meetsitaram/duck-droids/pi/README.md

# The duck's Pi code

Runs on the Raspberry Pi Zero 2 W in the head: reads 15 XL330 servos and the BNO085, runs a policy at 50 Hz, and writes the servos' targets.

**For the all-Dynamixel duck only.** The HD-1910 and all-Feetech ducks need Feetech's bus protocol, and the hybrid needs two buses.

**Status:** tested only against the simulator below. It has never run on a real Pi or real servos. There's no trained policy for this design yet, so `hold` and `wave` are stand-ins: `hold` sags and sits down, and neither walks.

## Try it in simulation

No Pi and no GPU needed. The simulator speaks the real Dynamixel bytes on a socket and answers as the IMU, so the Pi's code runs unchanged:

```bash
pip install -r pi/requirements.txt mujoco
```

```bash
cd pi && python sim/test_sim.py
```

To drive it yourself, run the simulator in one terminal:

```bash
cd pi && python sim/server.py --pinned
```

and the Pi's code in another:

```bash
cd pi && python run.py --port socket://127.0.0.1:9000 --imu 127.0.0.1:9001 --policy wave --no-fall
```

`--pinned` holds the body in the air. Leave it off to stand on the floor. A trained policy goes in the same way: `--policy models/walk.onnx --vx 0.2`.

**What this doesn't tell you:** the Pi Zero's own speed. On a PC a tick takes about 2 ms of the 20 ms budget, with a stand-in network that's far smaller than a real policy. Time a real policy on the Pi itself: `run.py` prints the ticks that ran late.

## Set up the Pi

Raspberry Pi OS Lite, 64-bit. Copy `pi/` to `/home/pi/duck`, then:

```bash
bash setup_pi.sh
```

## First run on the robot

Lift the duck on a stand, away from its joint limits, before any of this. Nothing has been tried on real servos.

1. **Set each servo's id and speed, one servo at a time:** with ROBOTIS's Dynamixel Wizard, ids as in the table below, baud rate 1 Mbps (a new XL330 comes at 57600), and the Waveshare board's jumpers at B.
2. **Measure the centres,** with the duck posed at zero by hand: legs straight, head level, beak shut:

```bash
python -m duck.calibrate --port /dev/serial0
```

3. **Check the directions on the stand.** Every joint starts at `direction: 1` in `config/dynamixel.json`, and some will be wrong. Flip those that move the wrong way:

```bash
python run.py --policy wave --no-fall --seconds 20
```

4. **Check the IMU.** Gravity should read about (0, 0, -1) with the body level. If it doesn't, fix `imu_to_robot` in the config.

| Servo ids | Joints |
|---|---|
| 1-5 | left hip yaw, hip roll, hip pitch, knee, ankle |
| 6-10 | right hip yaw, hip roll, hip pitch, knee, ankle |
| 11-15 | neck pitch, head pitch, head yaw, head roll, beak |

## What the policy sees

61 numbers at 50 Hz, in this order: angular velocity 3, gravity 3, joint positions minus home 14, joint velocities 14, last action 14, twist command 3, head command 4, body command 6. It returns 14 joint targets, as offsets from home. See `duck/policy.py`. A policy trained with foot switches has 63 inputs and is refused.

The loop stops the policy if the body tips past its limit, the battery falls under 6.6 V or a servo stops answering, and it turns the torque off on the way out.

Regenerate the config and the simulator's model after a design change:

```bash
MILLI_RECIPE=dynamixel python tools/make_pi_config.py
```
