meetsitaram/duck-droids/reports/dynamixel/mass.md

# Mass model

Bottom-up: every part from its material and shape (`tools/mass_model.py`, materials in `spec/robot.py`), a 3 % wiring allowance per link on its frames.

**Total 0.96 kg** (microduck: 0.8 kg).

| material | kg | share |
|---|---|---|
| pla | 0.42 | 43 % |
| actuator | 0.28 | 29 % |
| steel | 0.12 | 12 % |
| electronics | 0.07 | 7 % |
| tpu | 0.05 | 5 % |
| cells | 0.03 | 3 % |

| link | mass kg | budget kg (hand estimate) | CoM (m, world, zero pose) | principal inertia (kg m2) |
|---|---|---|---|---|
| trunk | 0.15 | 0.40 | -0.019 -0.001 +0.140 | 0.0001 0.0001 0.0001 |
| L_hip_yaw_link | 0.03 | 0.07 | +0.002 +0.015 +0.102 | 0.0000 0.0000 0.0000 |
| R_hip_yaw_link | 0.03 | 0.07 | +0.002 -0.015 +0.102 | 0.0000 0.0000 0.0000 |
| L_hip_roll_link | 0.02 | 0.07 | +0.002 +0.027 +0.100 | 0.0000 0.0000 0.0000 |
| R_hip_roll_link | 0.02 | 0.07 | +0.002 -0.027 +0.100 | 0.0000 0.0000 0.0000 |
| L_hip_pitch_link | 0.09 | 0.10 | -0.024 +0.055 +0.093 | 0.0000 0.0000 0.0000 |
| R_hip_pitch_link | 0.09 | 0.10 | -0.024 -0.055 +0.093 | 0.0000 0.0000 0.0000 |
| L_knee_link | 0.03 | 0.05 | -0.038 +0.043 +0.049 | 0.0000 0.0000 0.0000 |
| R_knee_link | 0.03 | 0.05 | -0.038 -0.043 +0.049 | 0.0000 0.0000 0.0000 |
| L_foot | 0.04 | 0.05 | -0.032 +0.045 +0.013 | 0.0000 0.0000 0.0000 |
| R_foot | 0.04 | 0.05 | -0.032 -0.045 +0.013 | 0.0000 0.0000 0.0000 |
| neck_link | 0.05 | 0.02 | +0.022 -0.001 +0.181 | 0.0000 0.0000 0.0000 |
| head_pitch_link | 0.04 | 0.03 | +0.017 -0.000 +0.231 | 0.0000 0.0000 0.0000 |
| head_yaw_link | 0.04 | 0.02 | +0.022 -0.007 +0.265 | 0.0000 0.0000 0.0000 |
| head | 0.24 | 0.12 | +0.046 +0.000 +0.268 | 0.0002 0.0004 0.0005 |
| beak_link | 0.03 | 0.03 | +0.063 +0.002 +0.245 | 0.0000 0.0000 0.0001 |
