meetsitaram/duck-droids/reports/hobby/mass.md

# Mass model

Bottom-up: every part from its material and shape (`tools/mass_model.py`, materials in `spec/robot.py`), a 3 % wiring allowance per link on its frames.

**Total 1.94 kg** (microduck: 0.8 kg).

| material | kg | share |
|---|---|---|
| pla | 0.78 | 40 % |
| actuator | 0.72 | 37 % |
| steel | 0.18 | 10 % |
| electronics | 0.09 | 5 % |
| tpu | 0.08 | 4 % |
| cells | 0.05 | 3 % |
| servo leads | 0.03 | 1 % |

| link | mass kg | budget kg (hand estimate) | CoM (m, world, zero pose) | principal inertia (kg m2) |
|---|---|---|---|---|
| trunk | 0.43 | 0.40 | -0.014 -0.001 +0.183 | 0.0003 0.0004 0.0005 |
| L_hip_yaw_link | 0.10 | 0.07 | +0.001 +0.019 +0.120 | 0.0000 0.0000 0.0000 |
| R_hip_yaw_link | 0.10 | 0.07 | +0.001 -0.019 +0.120 | 0.0000 0.0000 0.0000 |
| L_hip_roll_link | 0.02 | 0.07 | +0.014 +0.030 +0.124 | 0.0000 0.0000 0.0000 |
| R_hip_roll_link | 0.02 | 0.07 | +0.014 -0.030 +0.124 | 0.0000 0.0000 0.0000 |
| L_hip_pitch_link | 0.22 | 0.10 | -0.033 +0.067 +0.114 | 0.0001 0.0002 0.0002 |
| R_hip_pitch_link | 0.22 | 0.10 | -0.033 -0.067 +0.114 | 0.0001 0.0002 0.0002 |
| L_knee_link | 0.10 | 0.05 | -0.053 +0.053 +0.049 | 0.0000 0.0001 0.0001 |
| R_knee_link | 0.10 | 0.05 | -0.053 -0.053 +0.049 | 0.0000 0.0001 0.0001 |
| L_foot | 0.06 | 0.05 | -0.044 +0.063 +0.014 | 0.0000 0.0000 0.0000 |
| R_foot | 0.06 | 0.05 | -0.044 -0.063 +0.014 | 0.0000 0.0000 0.0000 |
| neck_link | 0.18 | 0.02 | +0.041 -0.001 +0.225 | 0.0000 0.0002 0.0002 |
| head_pitch_link | 0.05 | 0.03 | +0.041 +0.004 +0.285 | 0.0000 0.0000 0.0000 |
| head_yaw_link | 0.04 | 0.02 | +0.048 -0.006 +0.327 | 0.0000 0.0000 0.0000 |
| head | 0.22 | 0.12 | +0.072 +0.001 +0.332 | 0.0003 0.0005 0.0007 |
| beak_link | 0.04 | 0.03 | +0.093 +0.003 +0.307 | 0.0000 0.0001 0.0001 |
