meetsitaram/duck-droids/reports/hd1910/mass.md

# Mass model

Bottom-up: every part from its material and shape (`tools/mass_model.py`, materials in `spec/robot.py`), a 3 % wiring allowance per link on its frames.

**Total 1.03 kg** (microduck: 0.8 kg).

| material | kg | share |
|---|---|---|
| pla | 0.43 | 42 % |
| actuator | 0.32 | 32 % |
| steel | 0.12 | 11 % |
| electronics | 0.07 | 6 % |
| tpu | 0.05 | 5 % |
| cells | 0.03 | 3 % |

| link | mass kg | budget kg (hand estimate) | CoM (m, world, zero pose) | principal inertia (kg m2) |
|---|---|---|---|---|
| trunk | 0.16 | 0.40 | -0.012 -0.001 +0.139 | 0.0001 0.0001 0.0001 |
| L_hip_yaw_link | 0.04 | 0.07 | -0.000 +0.016 +0.098 | 0.0000 0.0000 0.0000 |
| R_hip_yaw_link | 0.04 | 0.07 | -0.000 -0.016 +0.098 | 0.0000 0.0000 0.0000 |
| L_hip_roll_link | 0.01 | 0.07 | +0.009 +0.027 +0.100 | 0.0000 0.0000 0.0000 |
| R_hip_roll_link | 0.01 | 0.07 | +0.009 -0.027 +0.100 | 0.0000 0.0000 0.0000 |
| L_hip_pitch_link | 0.09 | 0.10 | -0.024 +0.055 +0.093 | 0.0000 0.0000 0.0000 |
| R_hip_pitch_link | 0.09 | 0.10 | -0.024 -0.055 +0.093 | 0.0000 0.0000 0.0000 |
| L_knee_link | 0.04 | 0.05 | -0.038 +0.041 +0.046 | 0.0000 0.0000 0.0000 |
| R_knee_link | 0.04 | 0.05 | -0.038 -0.041 +0.046 | 0.0000 0.0000 0.0000 |
| L_foot | 0.04 | 0.05 | -0.032 +0.046 +0.013 | 0.0000 0.0000 0.0000 |
| R_foot | 0.04 | 0.05 | -0.032 -0.046 +0.013 | 0.0000 0.0000 0.0000 |
| neck_link | 0.06 | 0.02 | +0.027 -0.001 +0.172 | 0.0000 0.0000 0.0000 |
| head_pitch_link | 0.04 | 0.03 | +0.027 -0.000 +0.222 | 0.0000 0.0000 0.0000 |
| head_yaw_link | 0.04 | 0.02 | +0.035 -0.008 +0.256 | 0.0000 0.0000 0.0000 |
| head | 0.24 | 0.12 | +0.058 +0.000 +0.259 | 0.0002 0.0004 0.0005 |
| beak_link | 0.03 | 0.03 | +0.076 +0.002 +0.235 | 0.0000 0.0000 0.0001 |
