meetsitaram/duck-droids/reports/hd1910/real_fit.md

# The real HD-1910 against the printed parts, as exported

From `tools/real_fit.py`, at the zero pose, over 0.5 mm3. A case is checked against every part, its own pockets cut.

0 clashes.

| mm3 | Servo | Its piece | Printed part |
|---|---|---|---|
