meetsitaram/duck-droids/docs/big/CABLES.md

# Big duck: actuator cables

**NOT SAFE TO BUILD.** Generated by `tools/big_cables.py`: don't edit by hand.

Each harness is 310 mm to its XT30 and 40 more to its CAN plug. Each route below runs from where the cable leaves its actuator, past each joint it crosses near the joint's axis, to the nearest face of the computer and power board box on the deck, in straight lines, with slack at each joint for its range, wrapping at 73 mm (range x radius). It's a lower bound: a real route follows the plates and turns corners. Listed, not drawn: nothing here is in the model or checked for clashes.

Bend radius, assumed (RobStride's rating for its harness isn't read): 29 mm (4 x its 7.3 mm) where it's tied down, 73 mm (10 x) in a loop that moves.

| Actuator | Model | On | Crosses | Route, at least | Reaches with 350 mm? |
|---|---|---|---|---|---|
| beak actuator | RS00 | head | head_roll (0.76 rad), head_yaw (5.00 rad), head_pitch (3.20 rad), neck_pitch (1.75 rad) | 1821 mm | **no**: 1471 mm short |
| head_roll actuator | RS03 | head_yaw_link | head_yaw (5.00 rad), head_pitch (3.20 rad), neck_pitch (1.75 rad) | 1563 mm | **no**: 1213 mm short |
| L_ankle_pitch actuator | RS04 | L_knee_link | L_knee (1.22 rad), L_hip_pitch (2.00 rad), L_hip_roll (0.66 rad), L_hip_yaw (0.90 rad) | 1250 mm | **no**: 900 mm short |
| R_ankle_pitch actuator | RS04 | R_knee_link | R_knee (1.22 rad), R_hip_pitch (2.00 rad), R_hip_roll (0.66 rad), R_hip_yaw (0.90 rad) | 1250 mm | **no**: 900 mm short |
| head_yaw actuator | RS03 | head_pitch_link | head_pitch (3.20 rad), neck_pitch (1.75 rad) | 943 mm | **no**: 593 mm short |
| L_knee actuator O | RS04 | L_hip_pitch_link | L_hip_pitch (2.00 rad), L_hip_roll (0.66 rad), L_hip_yaw (0.90 rad) | 817 mm | **no**: 467 mm short |
| R_knee actuator O | RS04 | R_hip_pitch_link | R_hip_pitch (2.00 rad), R_hip_roll (0.66 rad), R_hip_yaw (0.90 rad) | 817 mm | **no**: 467 mm short |
| L_knee actuator I | RS04 | L_hip_pitch_link | L_hip_pitch (2.00 rad), L_hip_roll (0.66 rad), L_hip_yaw (0.90 rad) | 702 mm | **no**: 352 mm short |
| R_knee actuator I | RS04 | R_hip_pitch_link | R_hip_pitch (2.00 rad), R_hip_roll (0.66 rad), R_hip_yaw (0.90 rad) | 702 mm | **no**: 352 mm short |
| L_hip_pitch actuator O | RS04 | L_hip_roll_link | L_hip_roll (0.66 rad), L_hip_yaw (0.90 rad) | 568 mm | **no**: 218 mm short |
| R_hip_pitch actuator O | RS04 | R_hip_roll_link | R_hip_roll (0.66 rad), R_hip_yaw (0.90 rad) | 568 mm | **no**: 218 mm short |
| head_pitch actuator L | RS04 | neck_link | neck_pitch (1.75 rad) | 431 mm | **no**: 81 mm short |
| L_hip_pitch actuator I | RS04 | L_hip_roll_link | L_hip_roll (0.66 rad), L_hip_yaw (0.90 rad) | 420 mm | **no**: 70 mm short |
| R_hip_pitch actuator I | RS04 | R_hip_roll_link | R_hip_roll (0.66 rad), R_hip_yaw (0.90 rad) | 420 mm | **no**: 70 mm short |
| L_hip_roll actuator F | RS04 | L_hip_yaw_link | L_hip_yaw (0.90 rad) | 316 mm | yes |
| L_hip_roll actuator B | RS04 | L_hip_yaw_link | L_hip_yaw (0.90 rad) | 316 mm | yes |
| R_hip_roll actuator F | RS04 | R_hip_yaw_link | R_hip_yaw (0.90 rad) | 316 mm | yes |
| R_hip_roll actuator B | RS04 | R_hip_yaw_link | R_hip_yaw (0.90 rad) | 316 mm | yes |
| neck_pitch actuator L | RS04 | trunk | none: in the trunk | 97 mm | yes |
| neck_pitch actuator R | RS04 | trunk | none: in the trunk | 97 mm | yes |
| L_hip_yaw actuator | RS04 | trunk | none: in the trunk | 42 mm | yes |
| R_hip_yaw actuator | RS04 | trunk | none: in the trunk | 42 mm | yes |

**14 of 22 don't reach.** What that leaves to design: a CAN hub and a power distribution block on each leg (at the hip yaw's beam, say, where 8 cables meet), with one 12 AWG pair and one CAN pair across the yaw and up to the board; or extensions with their own connectors, which add a joint that can work loose in a robot that walks. Neither is in the model. The RS00's and RS03s' plug positions are from their files; the head's and neck's routes cross the neck pitch near its axis, inside the neck plates.

Not designed: strain relief at each actuator, cable guards past the cranks and rods, ties, and the slots and clips along the plates.
