meetsitaram/duck-droids/reports/big/mass.md

# Mass model

Bottom-up: every part from its material and shape (`tools/mass_model.py`, materials in `spec/robot.py`), a 3 % wiring allowance per link on its frames.

**Total 98.57 kg** (microduck: 0.8 kg).

| material | kg | share |
|---|---|---|
| al7075 | 30.56 | 31 % |
| actuator | 29.06 | 29 % |
| al6061 | 12.83 | 13 % |
| petg | 8.21 | 8 % |
| cells | 8.00 | 8 % |
| steel | 6.96 | 7 % |
| electronics | 1.82 | 2 % |
| tpu | 1.15 | 1 % |

| link | mass kg | budget kg (hand estimate) | CoM (m, world, zero pose) | principal inertia (kg m2) |
|---|---|---|---|---|
| trunk | 23.98 | 0.00 | -0.040 -0.000 +0.908 | 0.2869 0.4784 0.6043 |
| L_hip_yaw_link | 6.34 | 0.00 | +0.000 +0.110 +0.730 | 0.0352 0.0474 0.0677 |
| R_hip_yaw_link | 6.34 | 0.00 | +0.000 -0.110 +0.730 | 0.0352 0.0474 0.0677 |
| L_hip_roll_link | 4.79 | 0.00 | +0.003 +0.241 +0.678 | 0.0123 0.0340 0.0357 |
| R_hip_roll_link | 4.79 | 0.00 | +0.003 -0.241 +0.678 | 0.0123 0.0340 0.0357 |
| L_hip_pitch_link | 8.05 | 0.00 | -0.174 +0.273 +0.641 | 0.0401 0.0755 0.0824 |
| R_hip_pitch_link | 8.05 | 0.00 | -0.174 -0.273 +0.641 | 0.0401 0.0755 0.0824 |
| L_knee_link | 5.35 | 0.00 | -0.236 +0.264 +0.317 | 0.0096 0.1095 0.1118 |
| R_knee_link | 5.35 | 0.00 | -0.236 -0.264 +0.317 | 0.0096 0.1095 0.1118 |
| L_foot | 3.59 | 0.00 | -0.200 +0.265 +0.079 | 0.0211 0.0334 0.0363 |
| R_foot | 3.59 | 0.00 | -0.200 -0.265 +0.079 | 0.0211 0.0334 0.0363 |
| neck_link | 3.64 | 0.00 | +0.175 +0.037 +1.094 | 0.0075 0.0303 0.0322 |
| head_pitch_link | 3.20 | 0.00 | +0.175 +0.003 +1.334 | 0.0086 0.0129 0.0148 |
| head_yaw_link | 2.16 | 0.00 | +0.303 -0.000 +1.467 | 0.0041 0.0156 0.0161 |
| head | 7.43 | 0.00 | +0.503 +0.000 +1.571 | 0.2829 0.6846 0.8258 |
| beak_link | 1.94 | 0.00 | +0.659 +0.000 +1.391 | 0.0206 0.0574 0.0738 |
