meetsitaram/duck-droids/docs/images/dynamixel_switch_pc_port/back.png

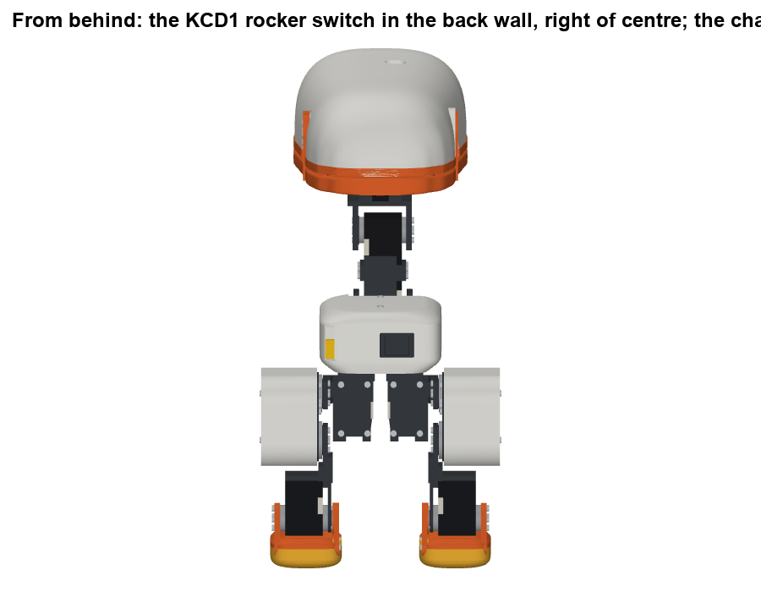
docs/images/dynamixel_switch_pc_port/back.png
