meetsitaram/duck-droids/docs/images/dynamixel_switch_pc_port/back_before_after.png

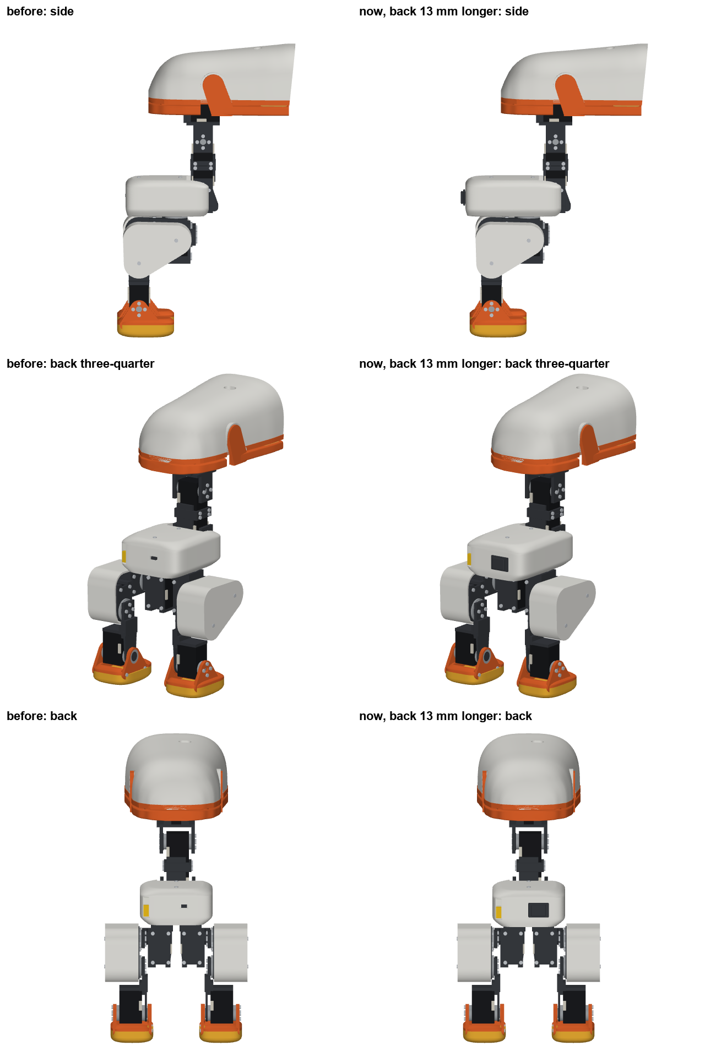
docs/images/dynamixel_switch_pc_port/back_before_after.png
