meetsitaram/duck-droids/docs/images/dynamixel_switch_pc_port/charge_port_inside.png

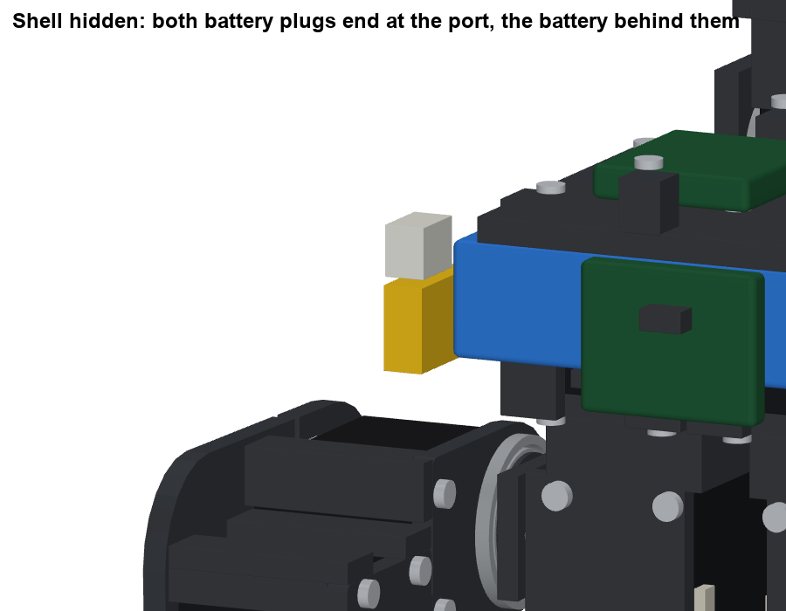
docs/images/dynamixel_switch_pc_port/charge_port_inside.png
