meetsitaram/duck-droids/docs/images/dynamixel_switch_pc_port/head_inside_34.png

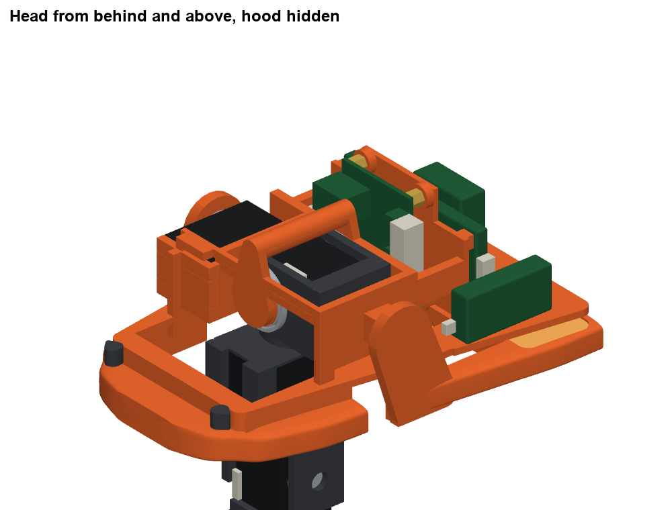
docs/images/dynamixel_switch_pc_port/head_inside_34.png
