meetsitaram/duck-droids/docs/images/dynamixel_switch_pc_port/head_inside_side.png

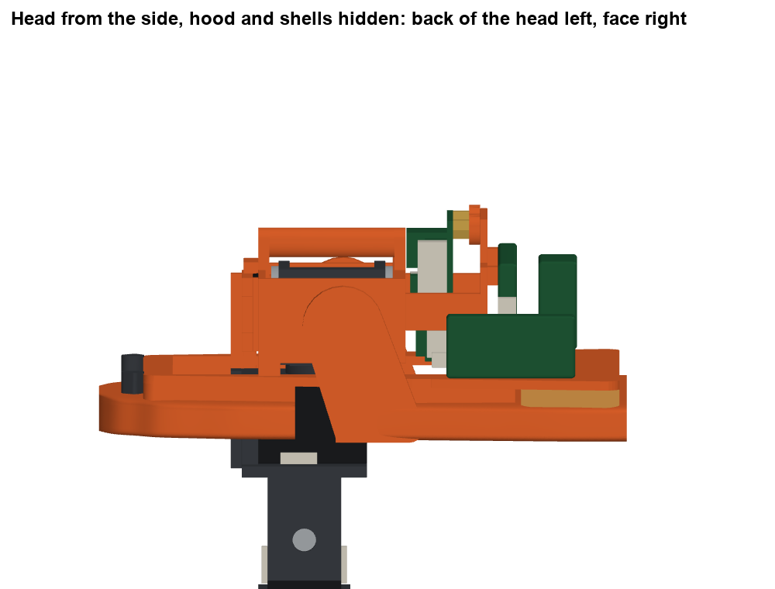
docs/images/dynamixel_switch_pc_port/head_inside_side.png
