meetsitaram/duck-droids/docs/images/dynamixel_switch_pc_port/pc_port_above.png

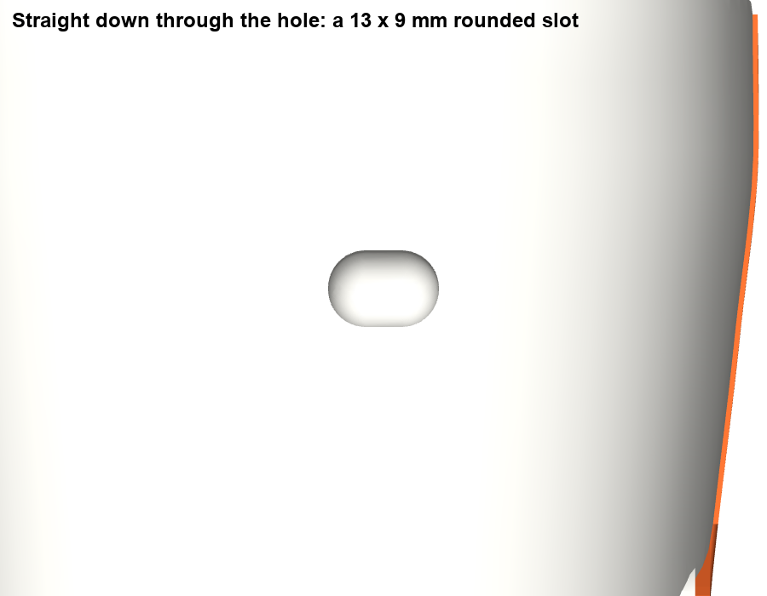
docs/images/dynamixel_switch_pc_port/pc_port_above.png
