meetsitaram/duck-droids/docs/images/dynamixel_switch_pc_port/pc_port_inside.png

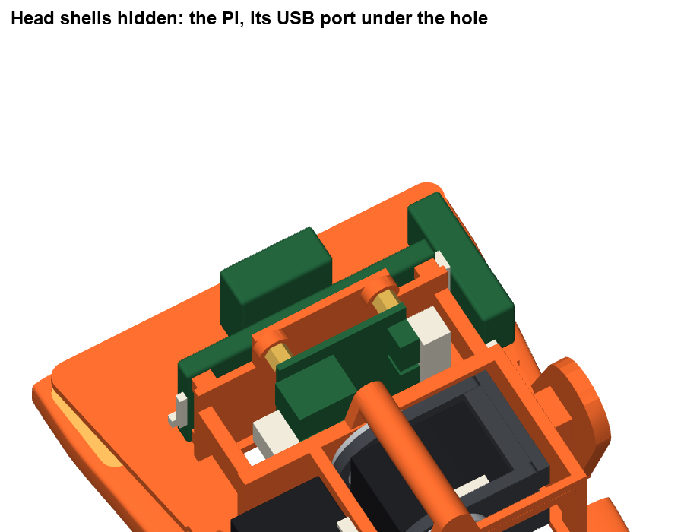
docs/images/dynamixel_switch_pc_port/pc_port_inside.png
