meetsitaram/duck-droids/docs/images/dynamixel_switch_pc_port/pc_port_top.png

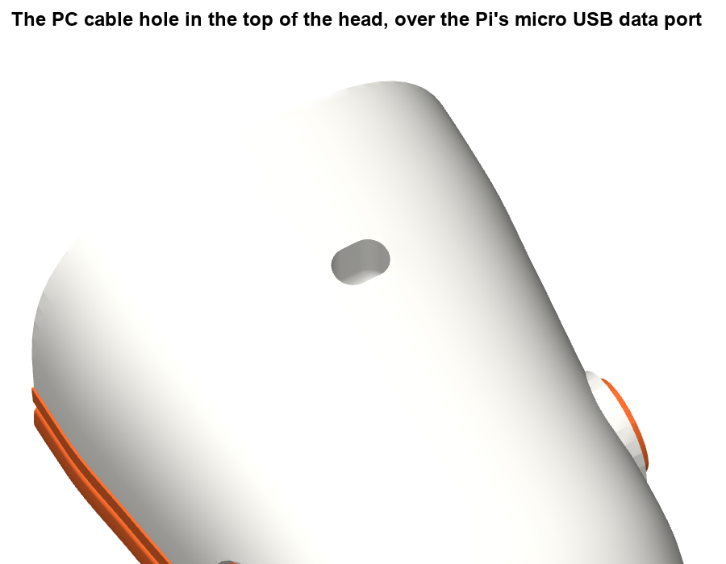
docs/images/dynamixel_switch_pc_port/pc_port_top.png
