meetsitaram/duck-droids/docs/images/dynamixel_switch_pc_port/switch_close.png

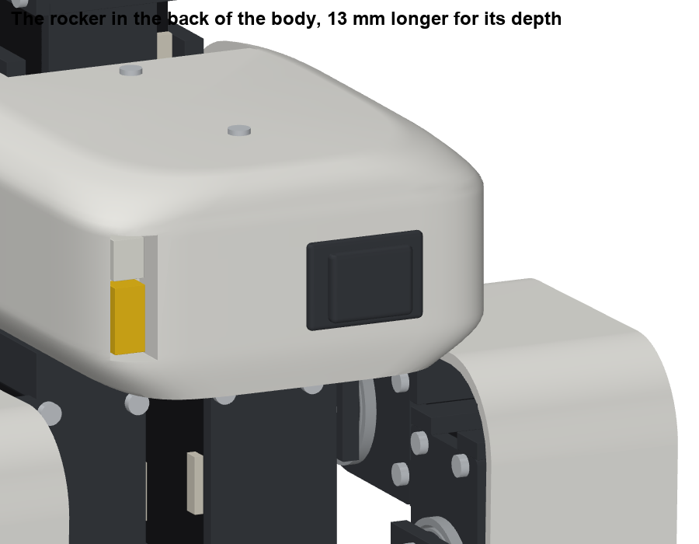
docs/images/dynamixel_switch_pc_port/switch_close.png
