meetsitaram/duck-droids/docs/images/dynamixel_switch_pc_port/switch_inside.png

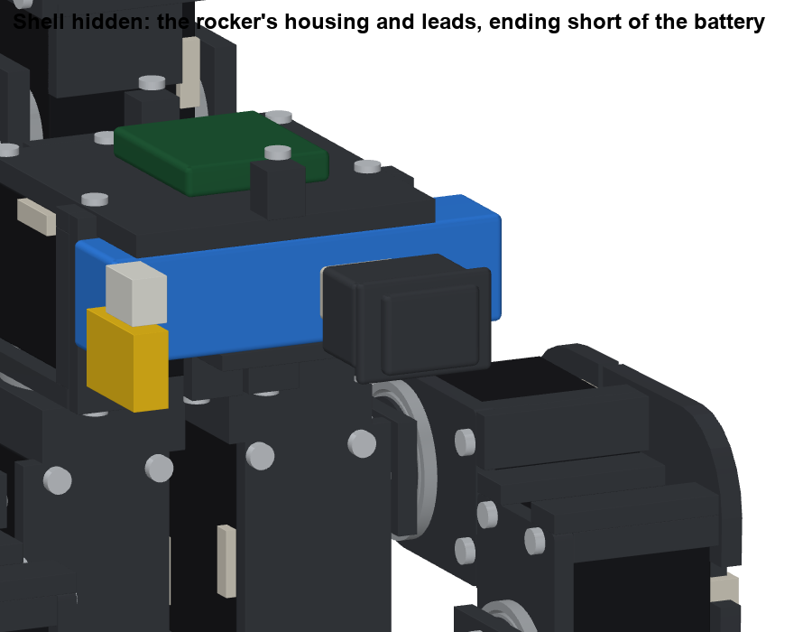
docs/images/dynamixel_switch_pc_port/switch_inside.png
