meetsitaram/duck-droids/docs/images/fusion/big/back.png

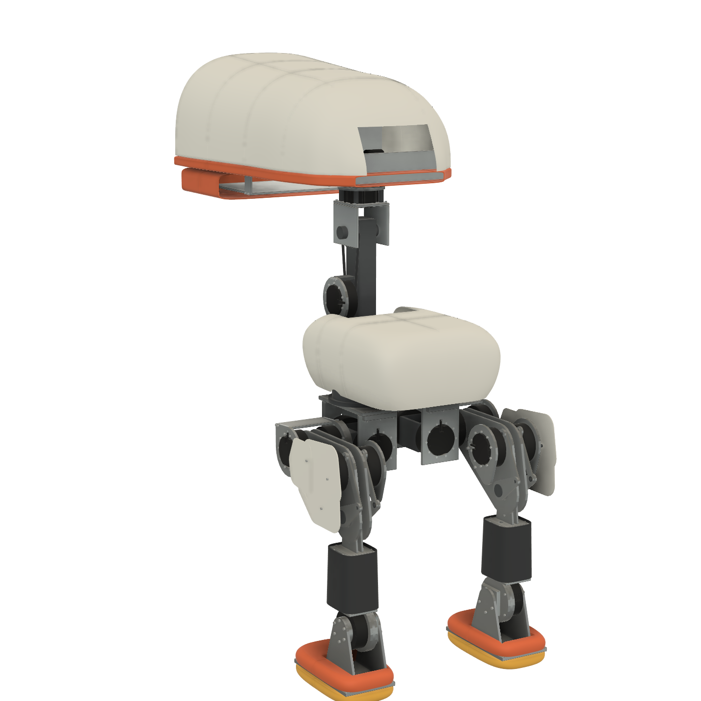
docs/images/fusion/big/back.png
