meetsitaram/duck-droids/docs/images/fusion/big/crops/ankle_back.png

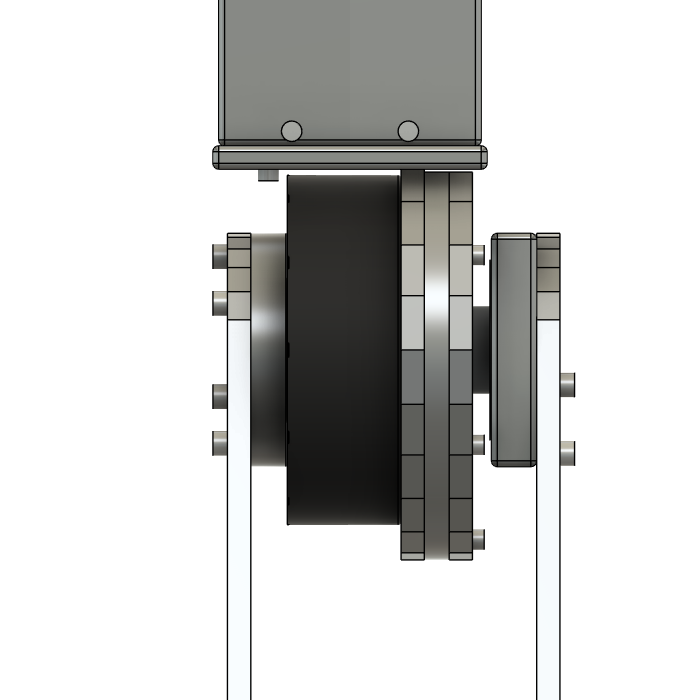
docs/images/fusion/big/crops/ankle_back.png
