meetsitaram/duck-droids/docs/images/fusion/big/crops/ankle_front.png

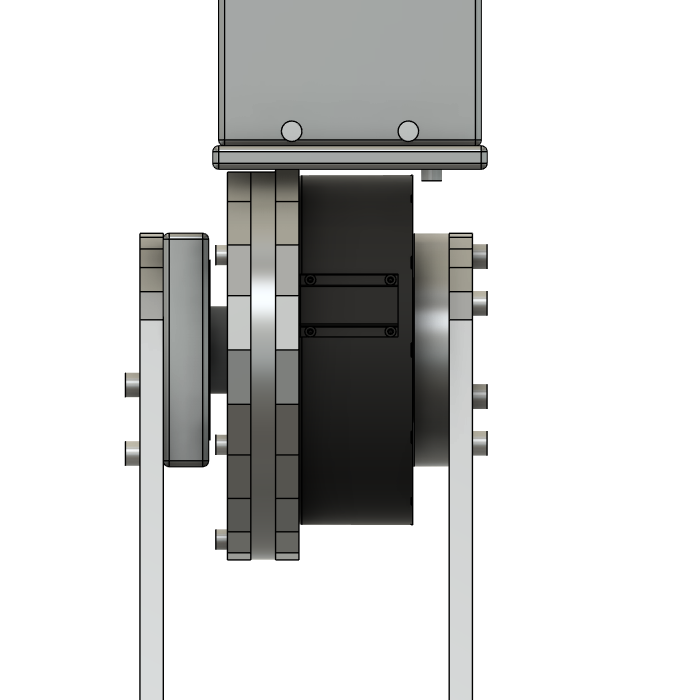
docs/images/fusion/big/crops/ankle_front.png
