meetsitaram/duck-droids/docs/images/fusion/big/crops/ankle_high.png

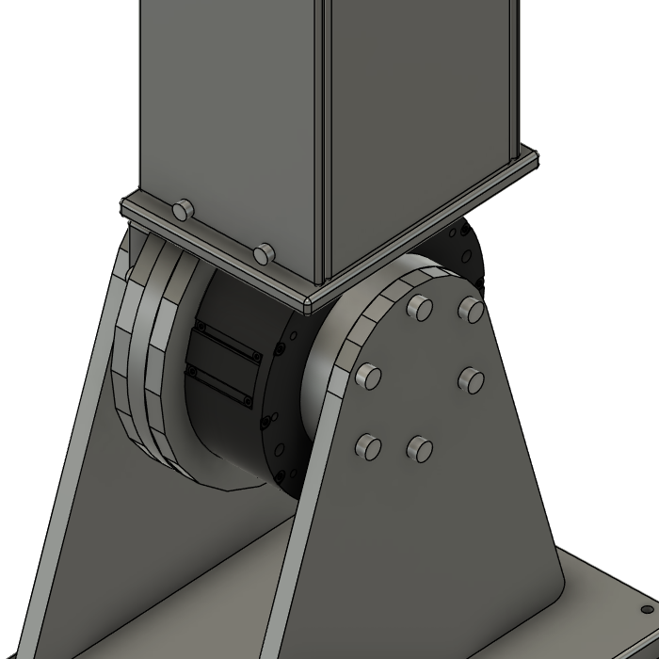
docs/images/fusion/big/crops/ankle_high.png
