meetsitaram/duck-droids/docs/images/fusion/big/crops/ankle_in.png

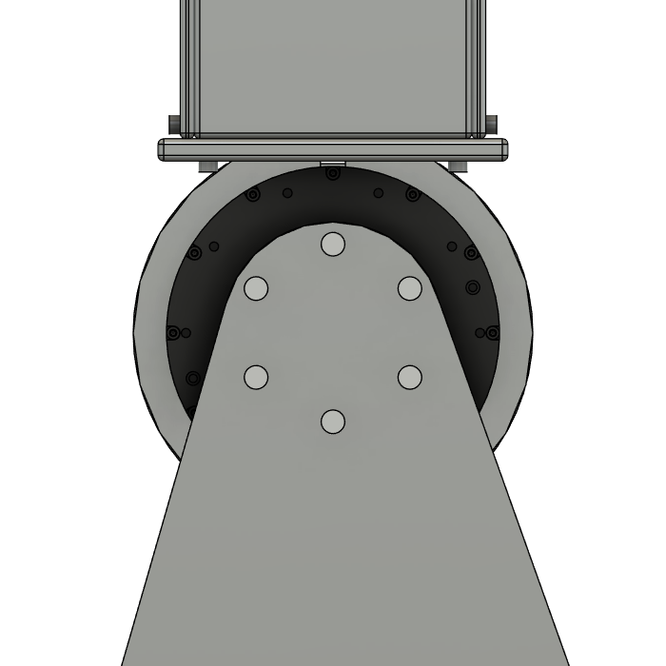
docs/images/fusion/big/crops/ankle_in.png
