meetsitaram/duck-droids/docs/images/fusion/big/crops/ankle_low.png

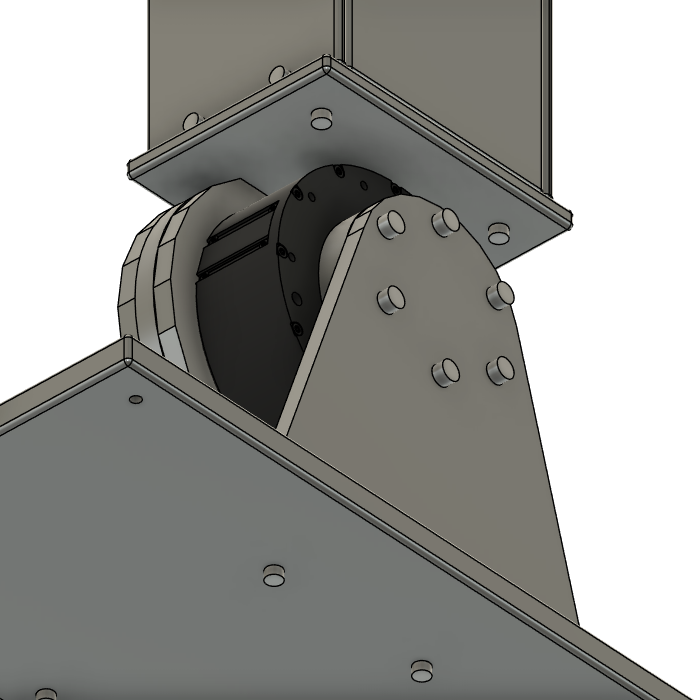
docs/images/fusion/big/crops/ankle_low.png
