meetsitaram/duck-droids/docs/images/fusion/big/crops/beak_back.png

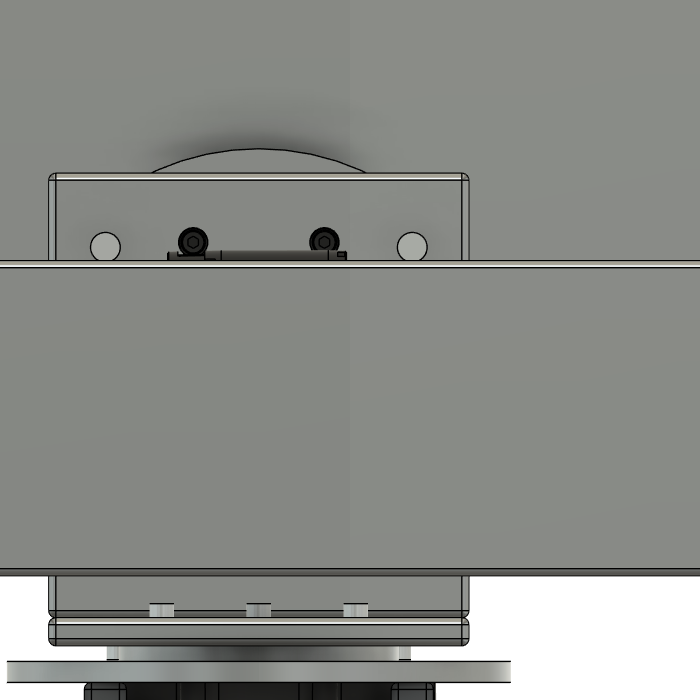
docs/images/fusion/big/crops/beak_back.png
