meetsitaram/duck-droids/docs/images/fusion/big/crops/beak_front.png

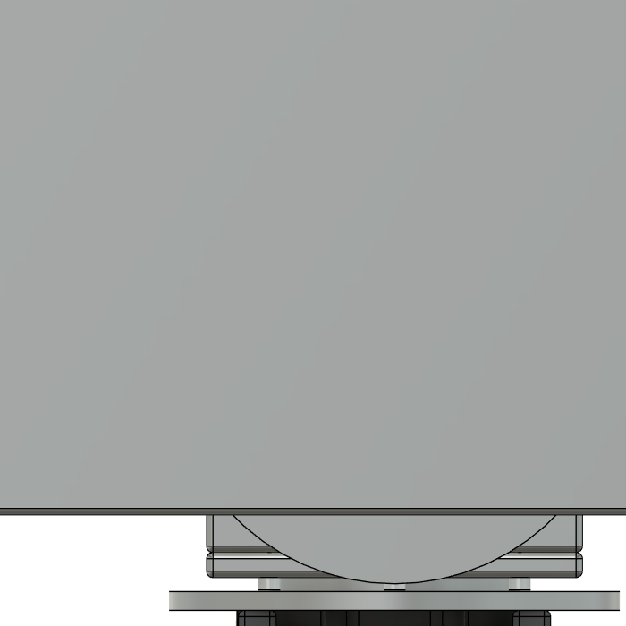
docs/images/fusion/big/crops/beak_front.png
