meetsitaram/duck-droids/docs/images/fusion/big/crops/beak_high.png

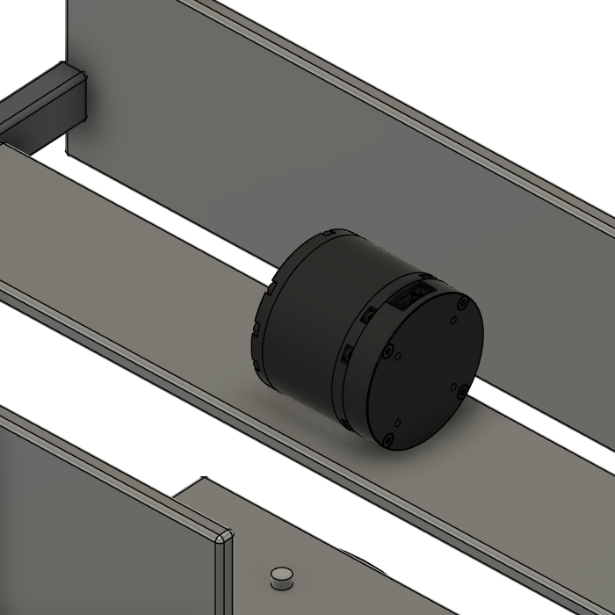
docs/images/fusion/big/crops/beak_high.png
