meetsitaram/duck-droids/docs/images/fusion/big/crops/beak_in.png

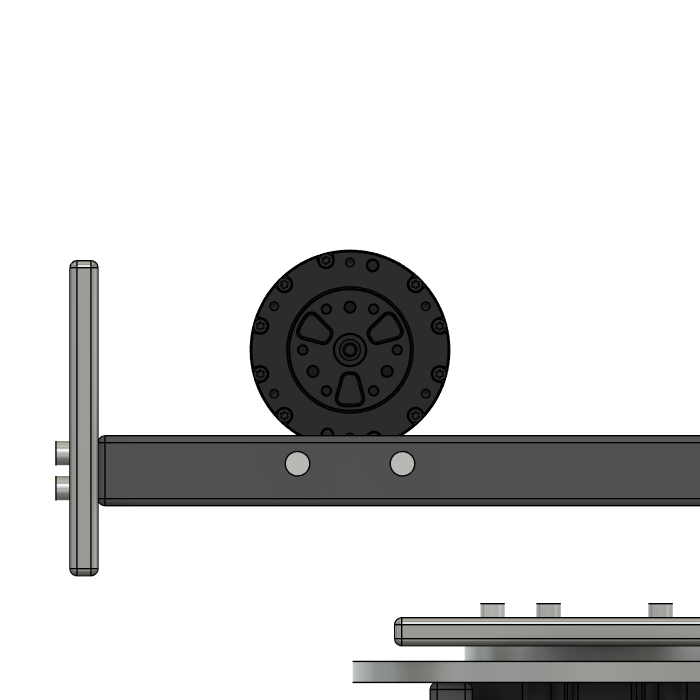
docs/images/fusion/big/crops/beak_in.png
