meetsitaram/duck-droids/docs/images/fusion/big/crops/beak_low.png

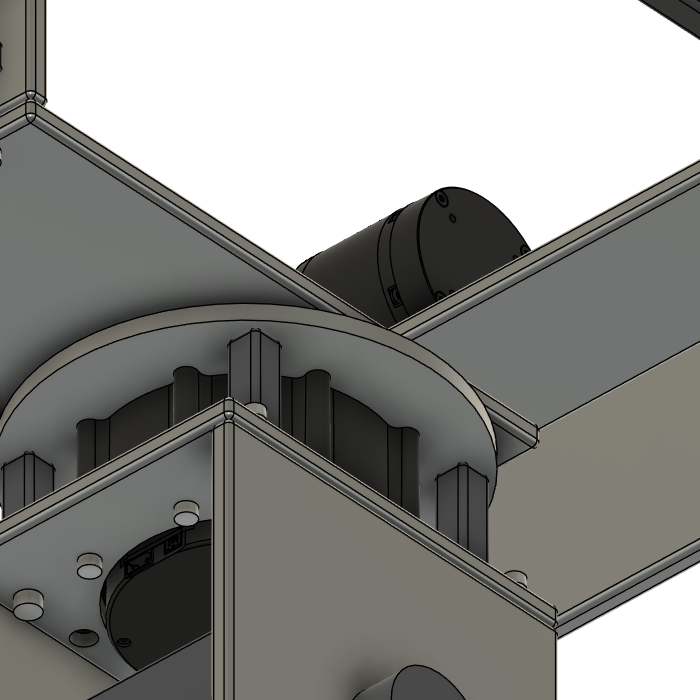
docs/images/fusion/big/crops/beak_low.png
