meetsitaram/duck-droids/docs/images/fusion/big/crops/beak_out.png

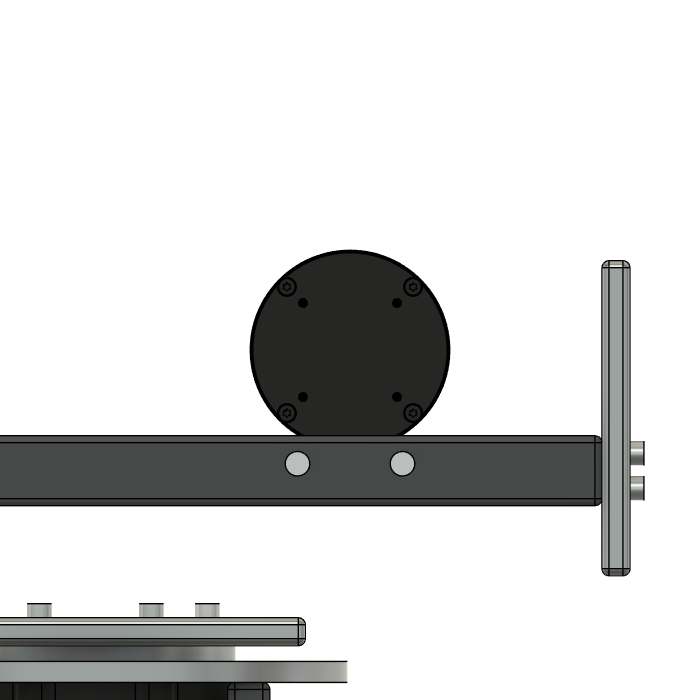
docs/images/fusion/big/crops/beak_out.png
