meetsitaram/duck-droids/docs/images/fusion/big/crops/head_pitch_back.png

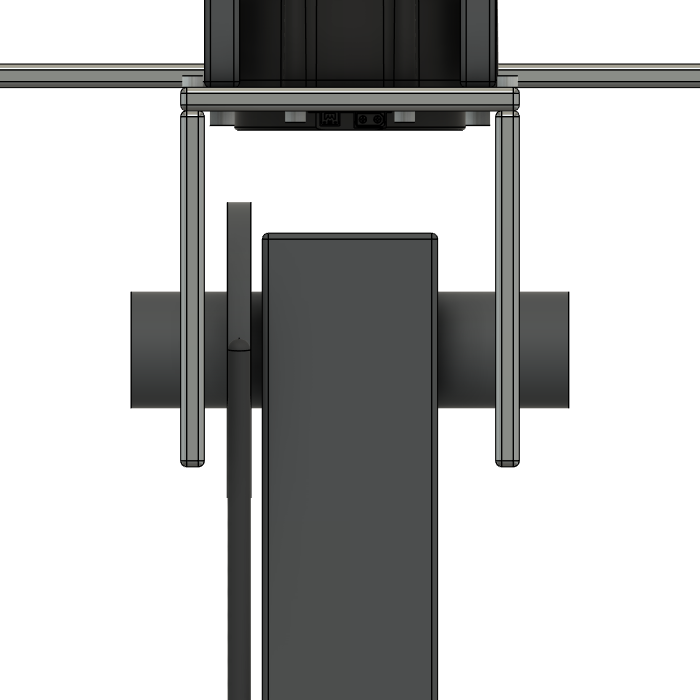
docs/images/fusion/big/crops/head_pitch_back.png
