meetsitaram/duck-droids/docs/images/fusion/big/crops/head_pitch_drive_back.png

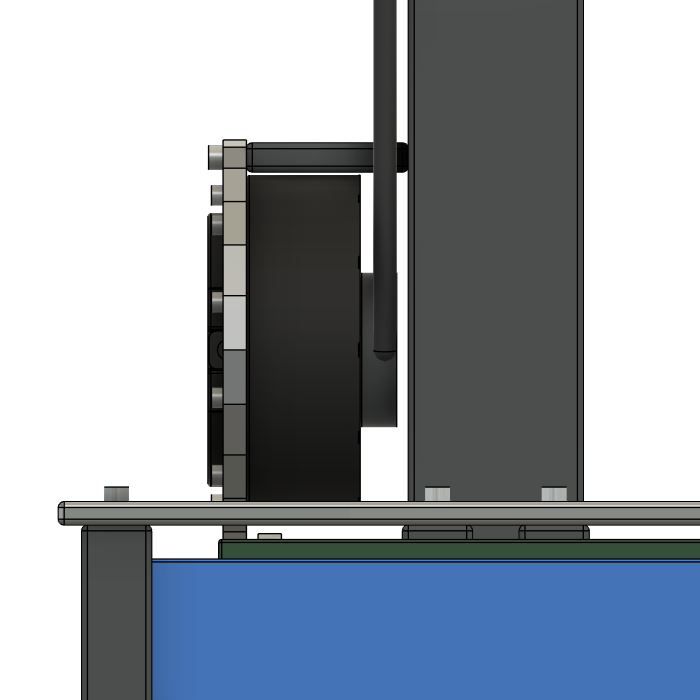
docs/images/fusion/big/crops/head_pitch_drive_back.png
