meetsitaram/duck-droids/docs/images/fusion/big/crops/head_pitch_drive_front.png

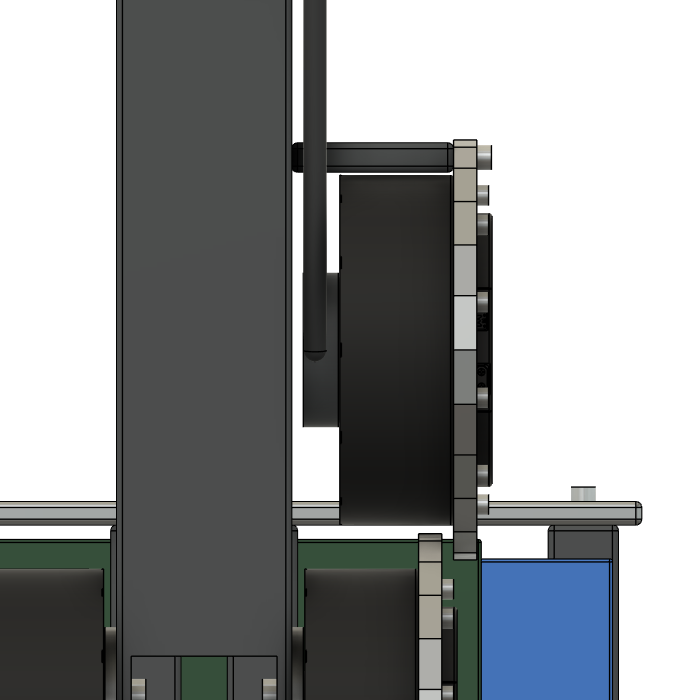
docs/images/fusion/big/crops/head_pitch_drive_front.png
