meetsitaram/duck-droids/docs/images/fusion/big/crops/head_pitch_drive_high.png

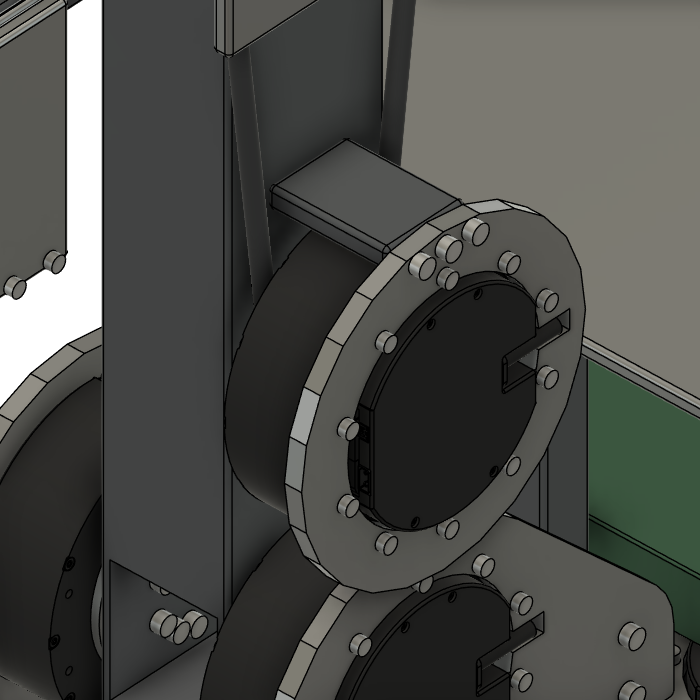
docs/images/fusion/big/crops/head_pitch_drive_high.png
