meetsitaram/duck-droids/docs/images/fusion/big/crops/head_pitch_drive_low.png

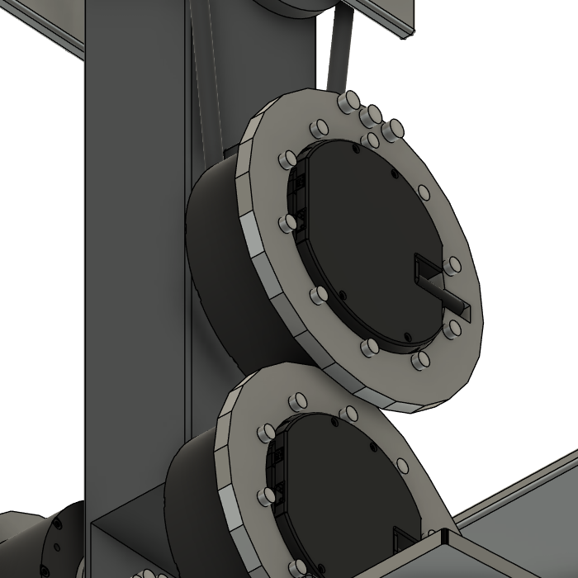
docs/images/fusion/big/crops/head_pitch_drive_low.png
