meetsitaram/duck-droids/docs/images/fusion/big/crops/head_pitch_high.png

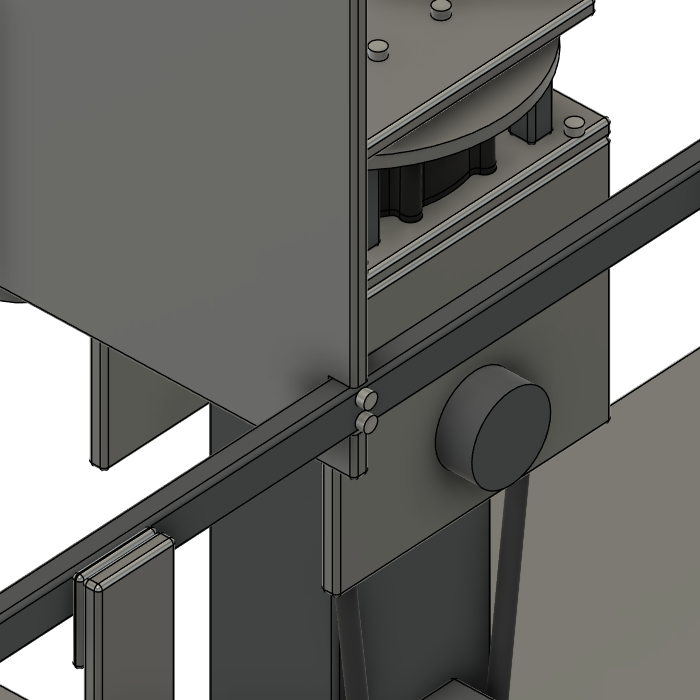
docs/images/fusion/big/crops/head_pitch_high.png
