meetsitaram/duck-droids/docs/images/fusion/big/crops/head_pitch_low.png

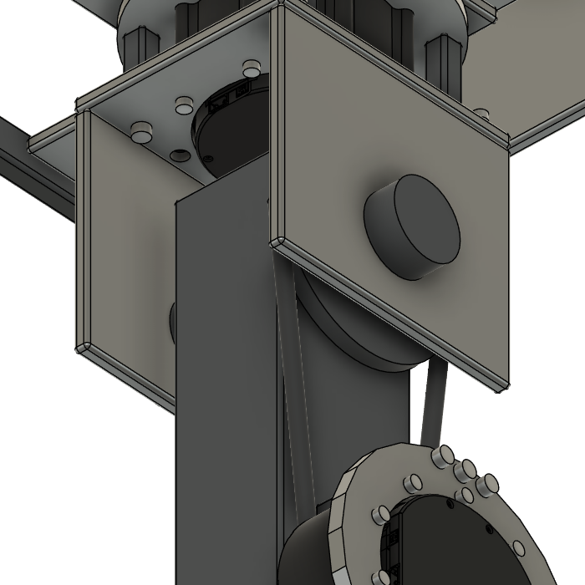
docs/images/fusion/big/crops/head_pitch_low.png
