meetsitaram/duck-droids/docs/images/fusion/big/crops/head_roll_back.png

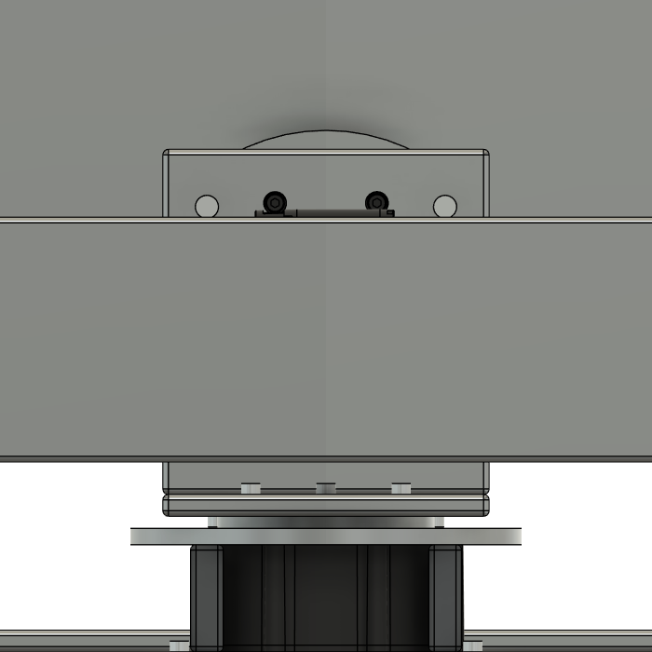
docs/images/fusion/big/crops/head_roll_back.png
