meetsitaram/duck-droids/docs/images/fusion/big/crops/head_roll_front.png

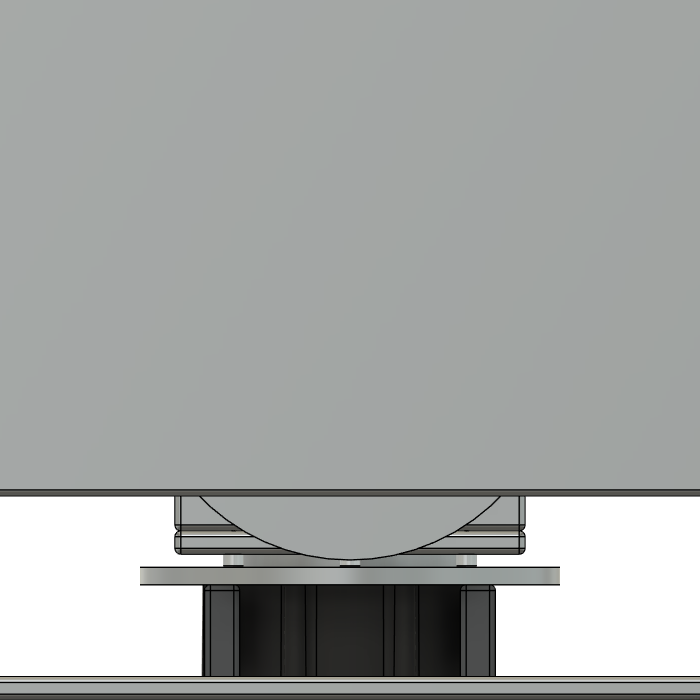
docs/images/fusion/big/crops/head_roll_front.png
