meetsitaram/duck-droids/docs/images/fusion/big/crops/head_roll_high.png

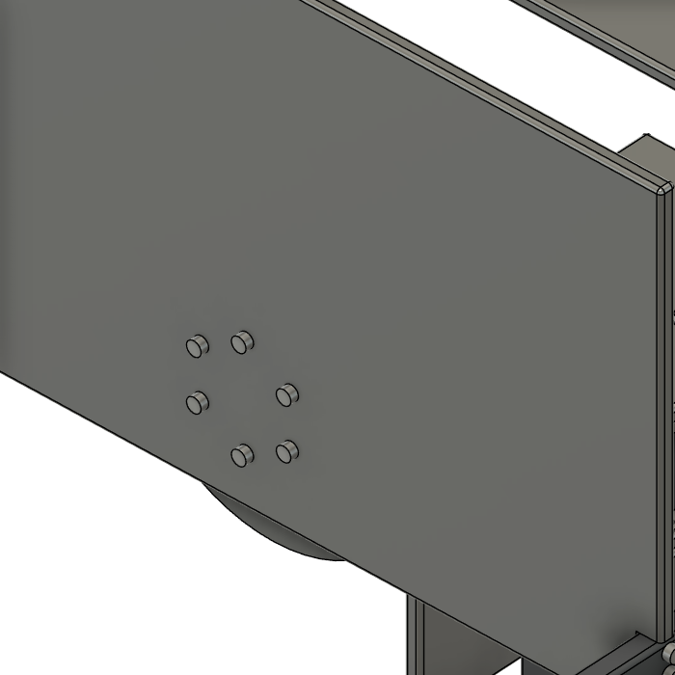
docs/images/fusion/big/crops/head_roll_high.png
