meetsitaram/duck-droids/docs/images/fusion/big/crops/head_roll_in.png

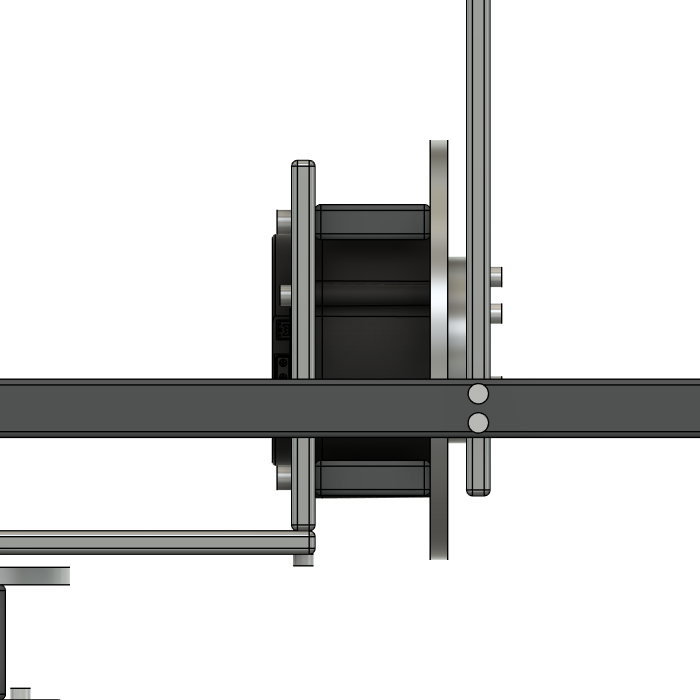
docs/images/fusion/big/crops/head_roll_in.png
