meetsitaram/duck-droids/docs/images/fusion/big/crops/head_roll_low.png

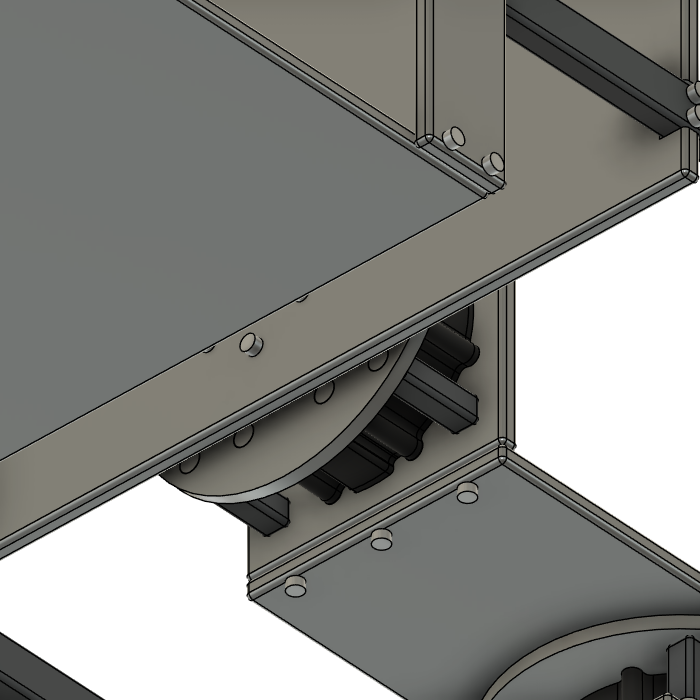
docs/images/fusion/big/crops/head_roll_low.png
