meetsitaram/duck-droids/docs/images/fusion/big/crops/head_roll_out.png

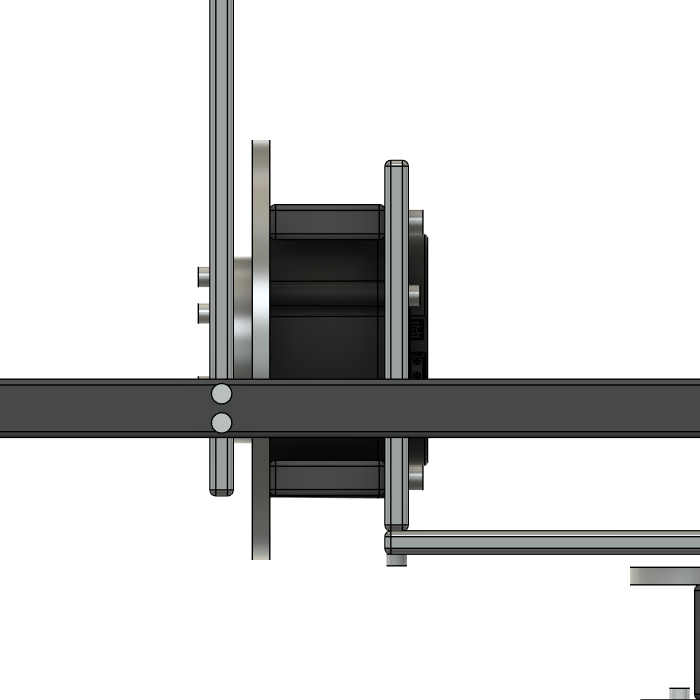
docs/images/fusion/big/crops/head_roll_out.png
