meetsitaram/duck-droids/docs/images/fusion/big/crops/head_yaw_back.png

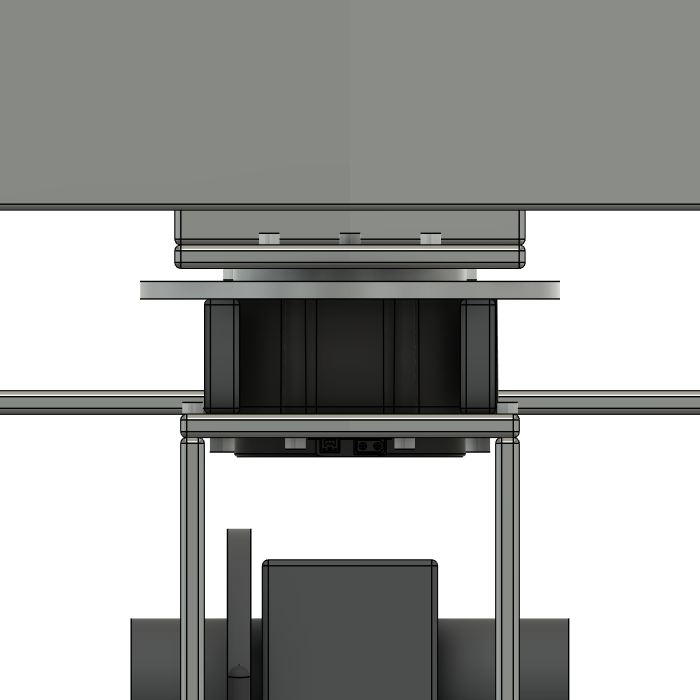
docs/images/fusion/big/crops/head_yaw_back.png
