meetsitaram/duck-droids/docs/images/fusion/big/crops/head_yaw_front.png

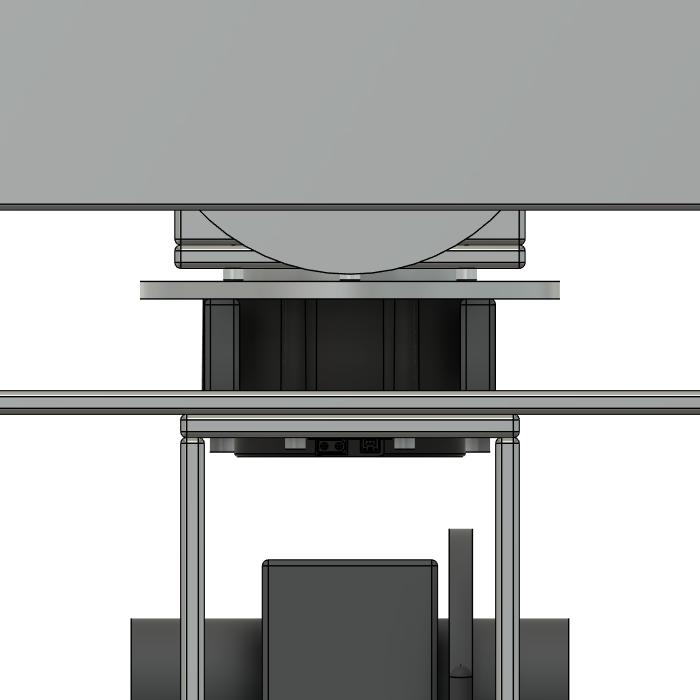
docs/images/fusion/big/crops/head_yaw_front.png
