meetsitaram/duck-droids/docs/images/fusion/big/crops/head_yaw_high.png

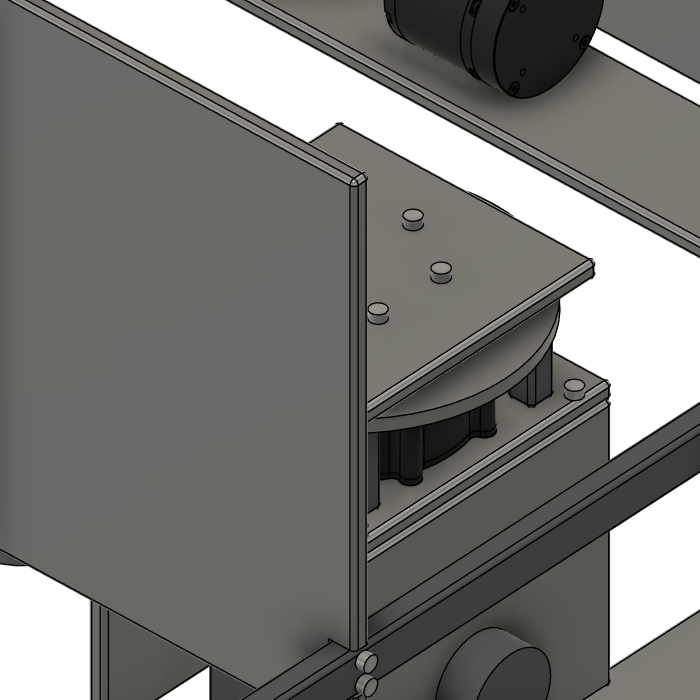
docs/images/fusion/big/crops/head_yaw_high.png
