meetsitaram/duck-droids/docs/images/fusion/big/crops/head_yaw_in.png

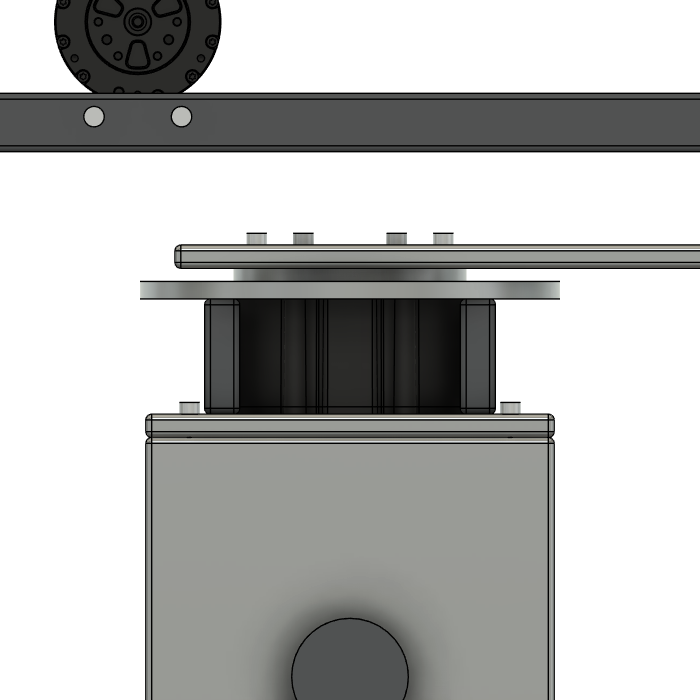
docs/images/fusion/big/crops/head_yaw_in.png
