meetsitaram/duck-droids/docs/images/fusion/big/crops/head_yaw_low.png

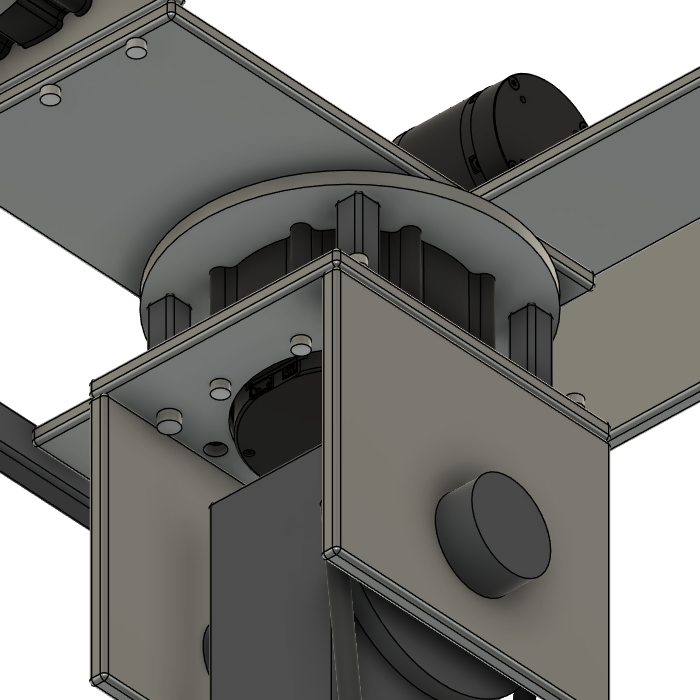
docs/images/fusion/big/crops/head_yaw_low.png
