meetsitaram/duck-droids/docs/images/fusion/big/crops/hip_pitch_back.png

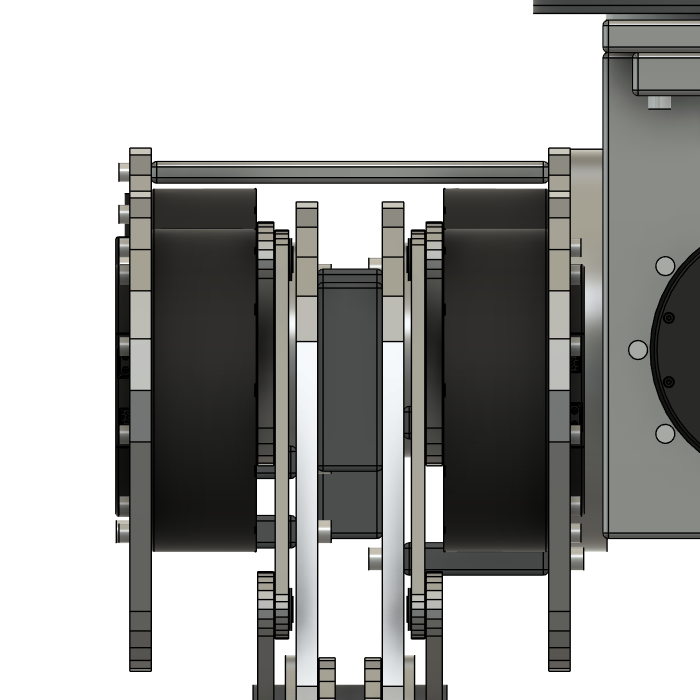
docs/images/fusion/big/crops/hip_pitch_back.png
