meetsitaram/duck-droids/docs/images/fusion/big/crops/hip_pitch_front.png

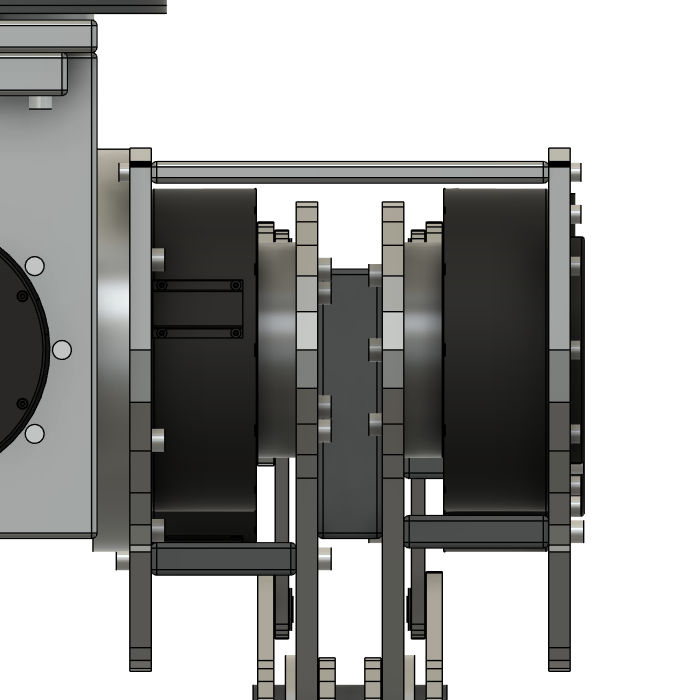
docs/images/fusion/big/crops/hip_pitch_front.png
