meetsitaram/duck-droids/docs/images/fusion/big/crops/hip_pitch_in.png

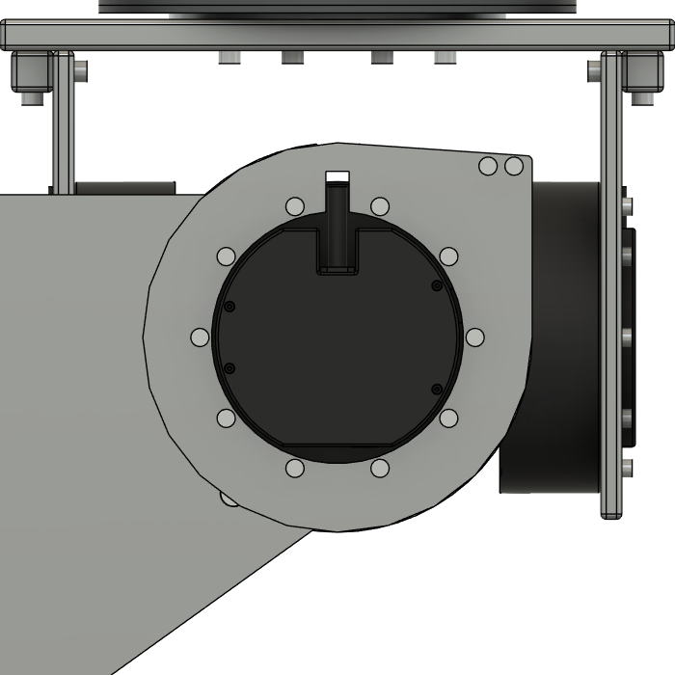
docs/images/fusion/big/crops/hip_pitch_in.png
