meetsitaram/duck-droids/docs/images/fusion/big/crops/hip_pitch_low.png

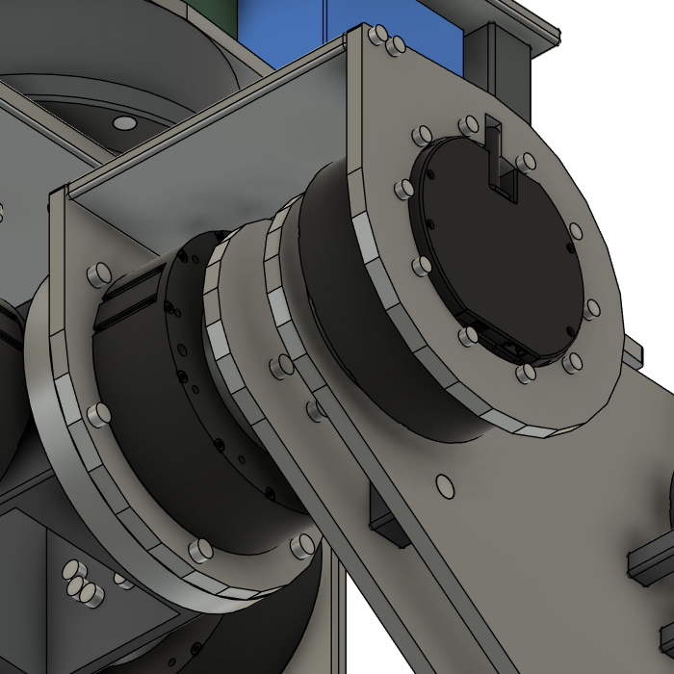
docs/images/fusion/big/crops/hip_pitch_low.png
