meetsitaram/duck-droids/docs/images/fusion/big/crops/hip_pitch_out.png

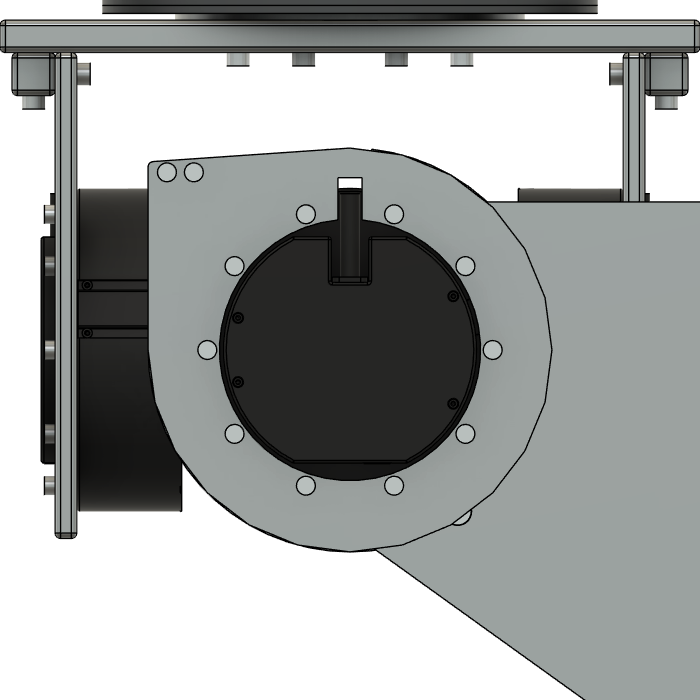
docs/images/fusion/big/crops/hip_pitch_out.png
