meetsitaram/duck-droids/docs/images/fusion/big/crops/hip_roll_front.png

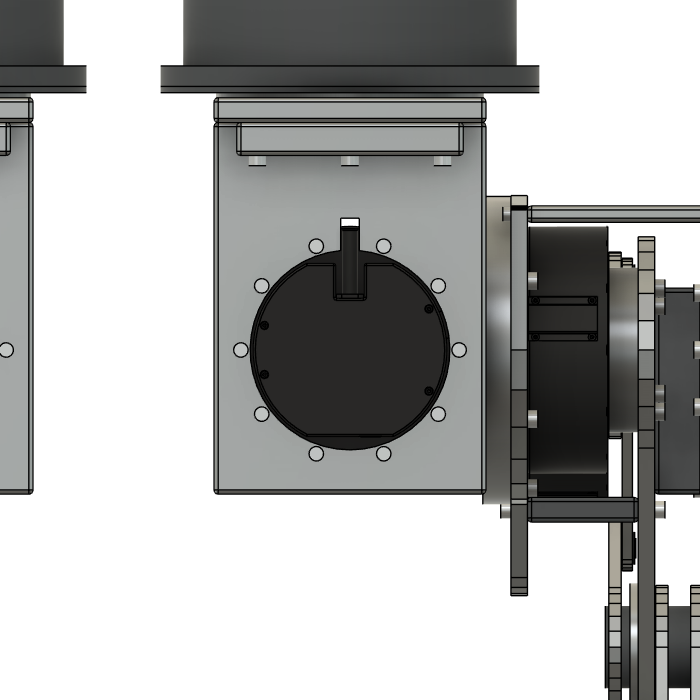
docs/images/fusion/big/crops/hip_roll_front.png
