meetsitaram/duck-droids/docs/images/fusion/big/crops/hip_roll_high.png

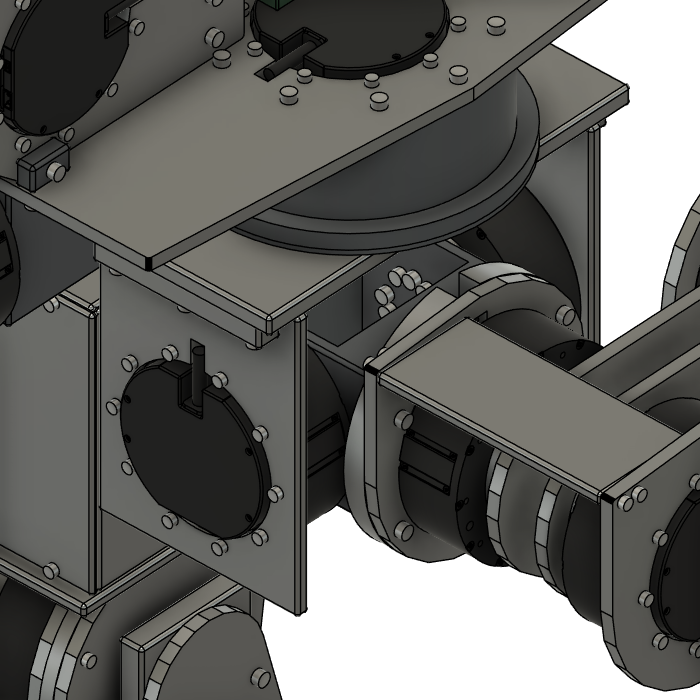
docs/images/fusion/big/crops/hip_roll_high.png
