meetsitaram/duck-droids/docs/images/fusion/big/crops/hip_roll_low.png

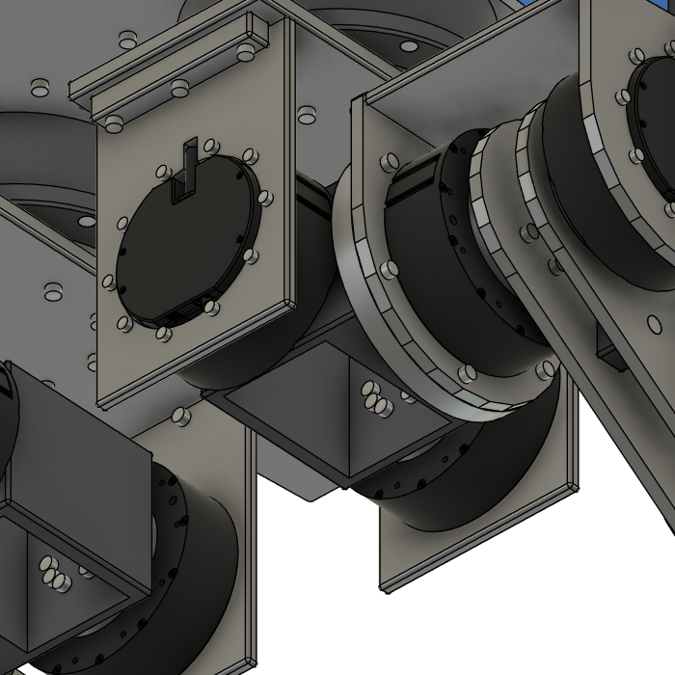
docs/images/fusion/big/crops/hip_roll_low.png
