meetsitaram/duck-droids/docs/images/fusion/big/crops/hip_yaw_back.png

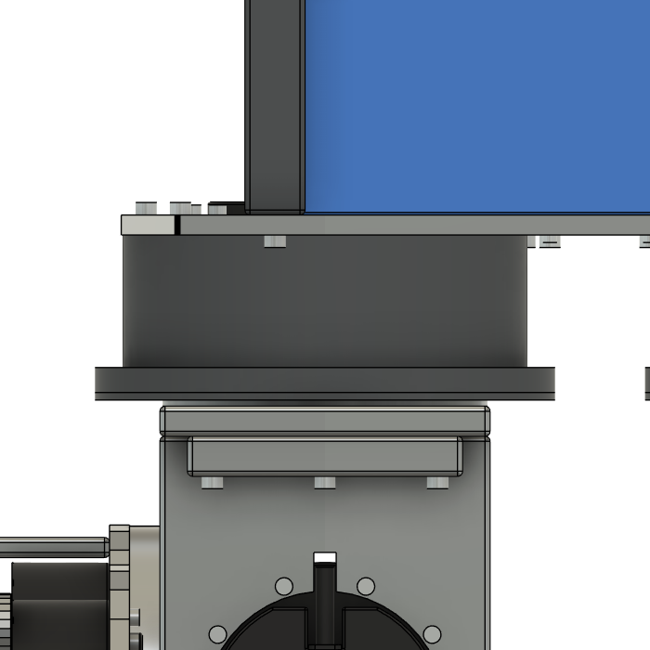
docs/images/fusion/big/crops/hip_yaw_back.png
