meetsitaram/duck-droids/docs/images/fusion/big/crops/hip_yaw_front.png

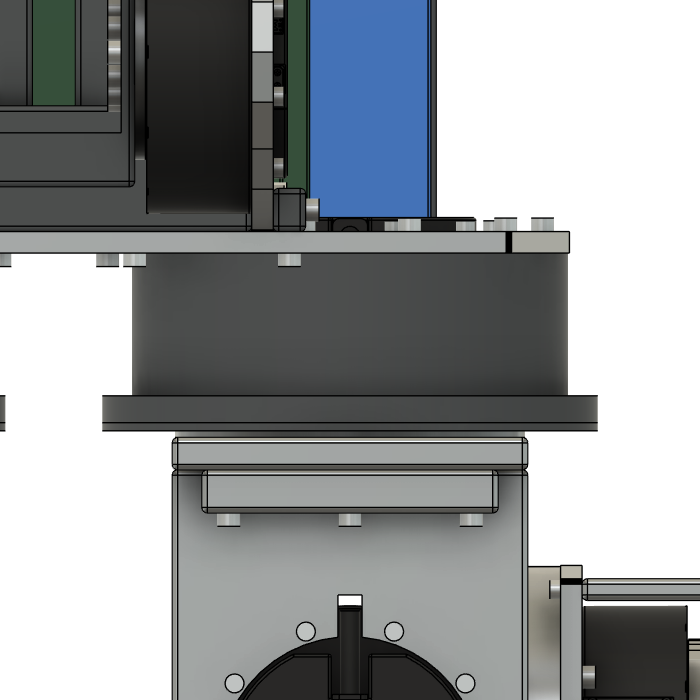
docs/images/fusion/big/crops/hip_yaw_front.png
