meetsitaram/duck-droids/docs/images/fusion/big/crops/hip_yaw_high.png

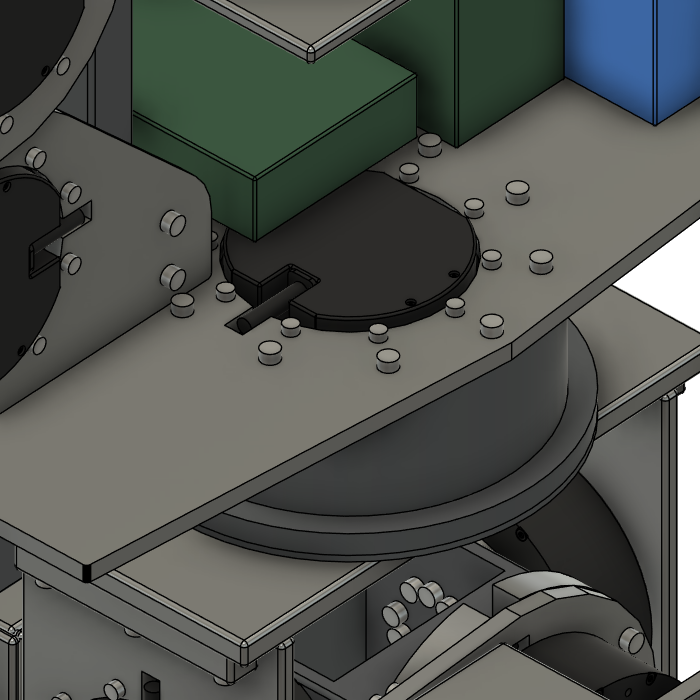
docs/images/fusion/big/crops/hip_yaw_high.png
