meetsitaram/duck-droids/docs/images/fusion/big/crops/hip_yaw_in.png

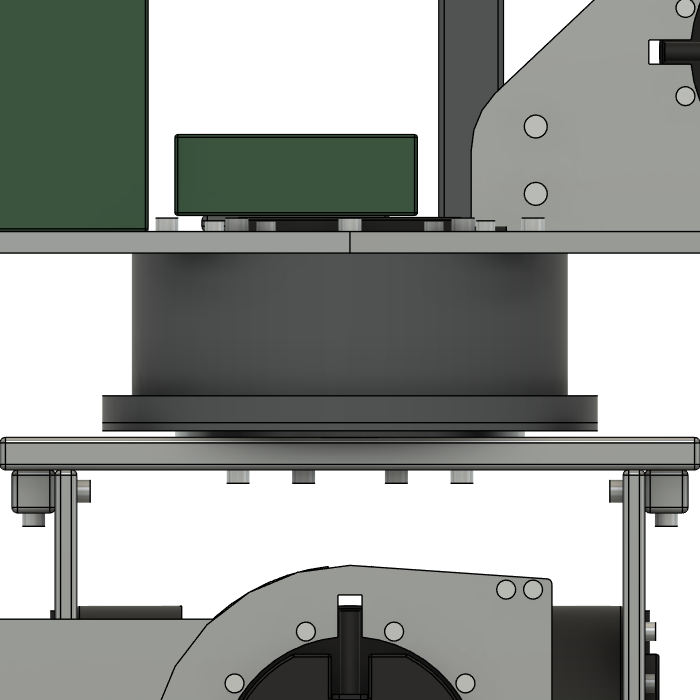
docs/images/fusion/big/crops/hip_yaw_in.png
