meetsitaram/duck-droids/docs/images/fusion/big/crops/hip_yaw_low.png

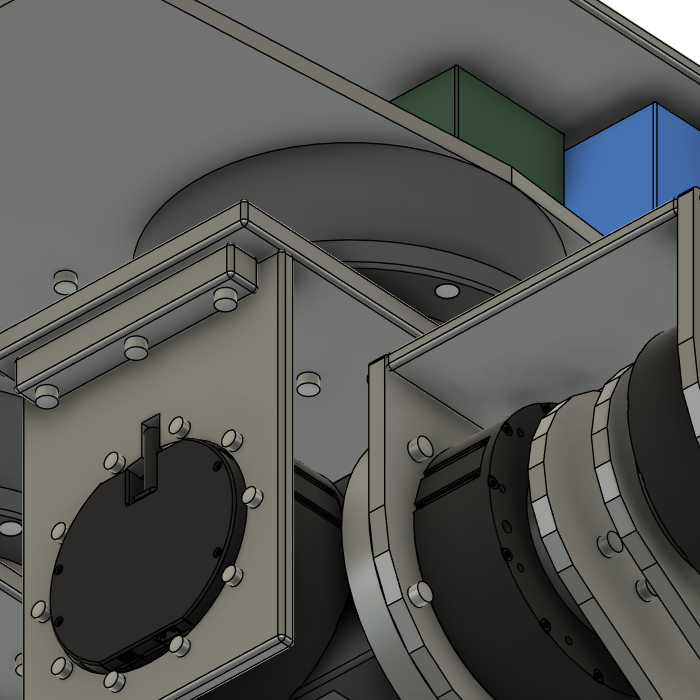
docs/images/fusion/big/crops/hip_yaw_low.png
