meetsitaram/duck-droids/docs/images/fusion/big/crops/hip_yaw_out.png

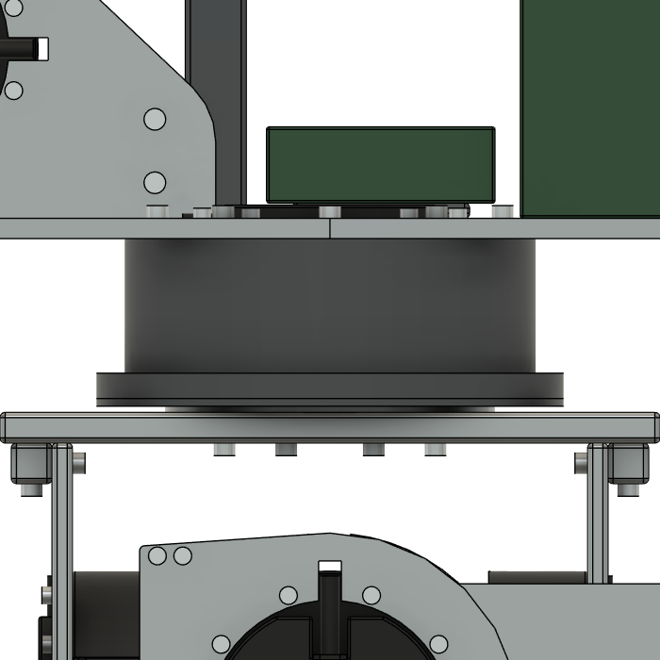
docs/images/fusion/big/crops/hip_yaw_out.png
