meetsitaram/duck-droids/docs/images/fusion/big/crops/knee_front.png

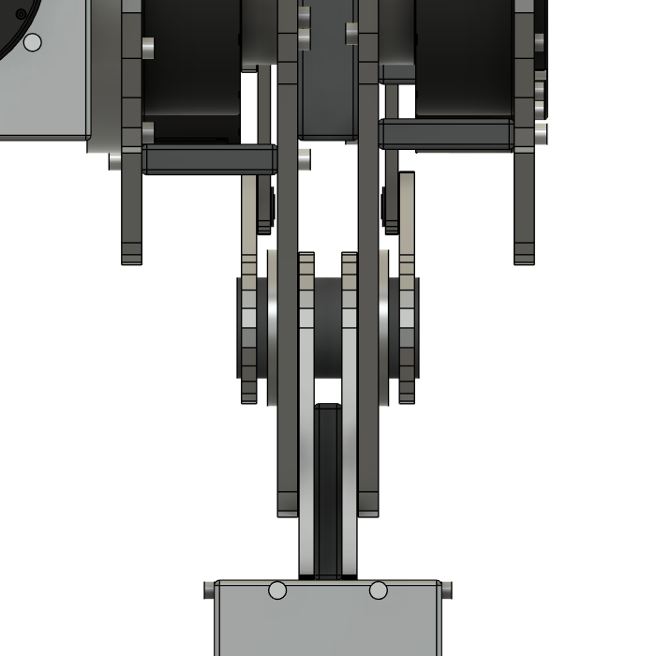
docs/images/fusion/big/crops/knee_front.png
