meetsitaram/duck-droids/docs/images/fusion/big/crops/knee_high.png

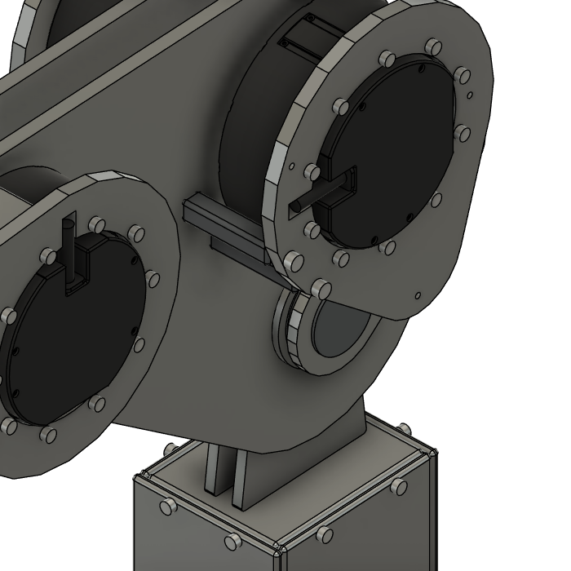
docs/images/fusion/big/crops/knee_high.png
