meetsitaram/duck-droids/docs/images/fusion/big/crops/knee_in.png

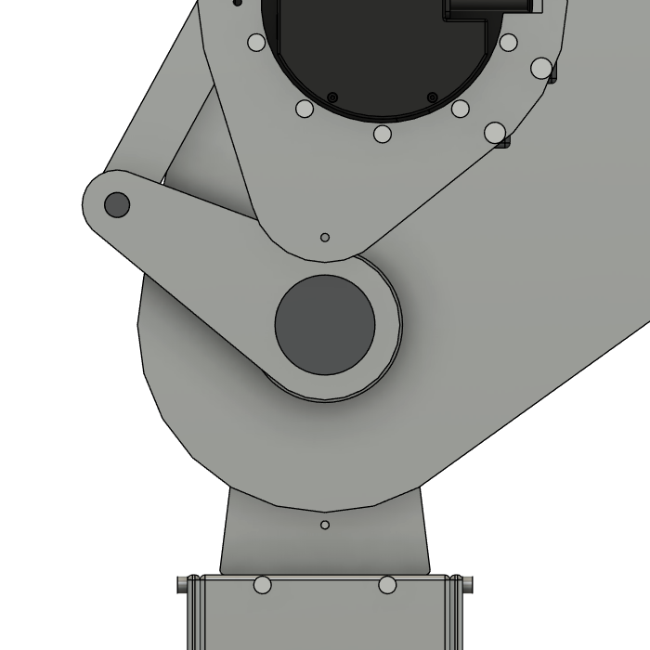
docs/images/fusion/big/crops/knee_in.png
