meetsitaram/duck-droids/docs/images/fusion/big/crops/knee_out.png

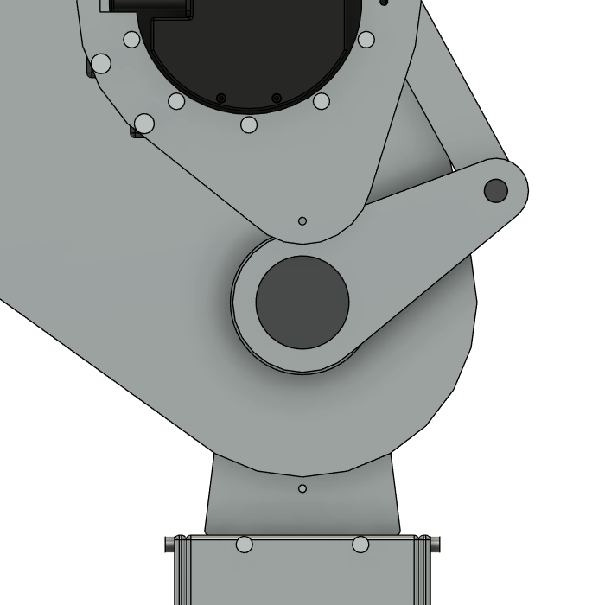
docs/images/fusion/big/crops/knee_out.png
