meetsitaram/duck-droids/docs/images/fusion/big/crops/knee_stators_back.png

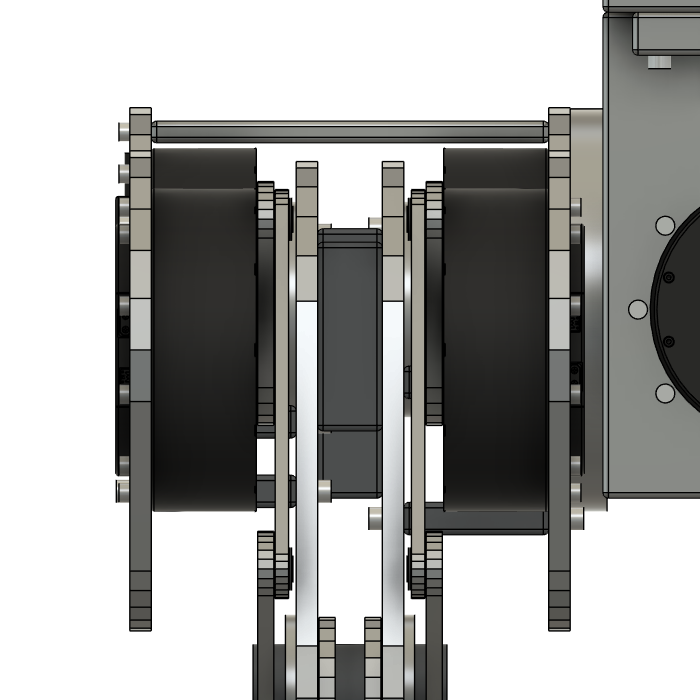
docs/images/fusion/big/crops/knee_stators_back.png
