meetsitaram/duck-droids/docs/images/fusion/big/crops/knee_stators_in.png

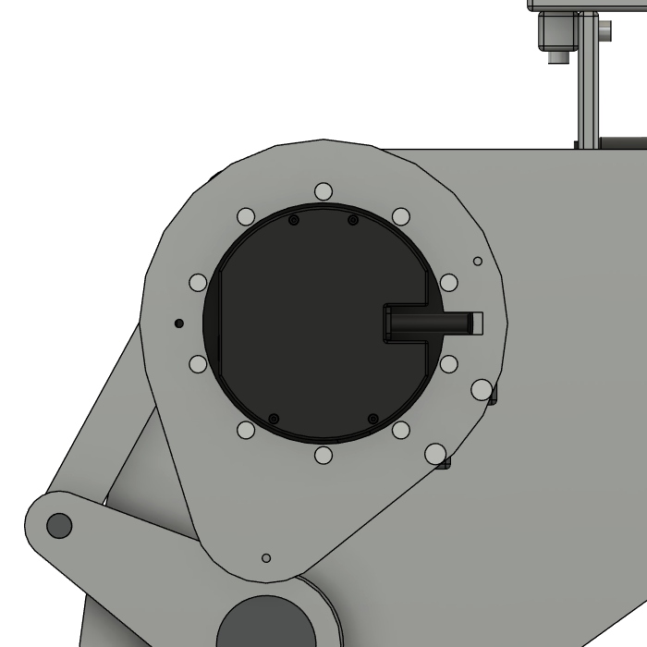
docs/images/fusion/big/crops/knee_stators_in.png
