meetsitaram/duck-droids/docs/images/fusion/big/crops/knee_stators_low.png

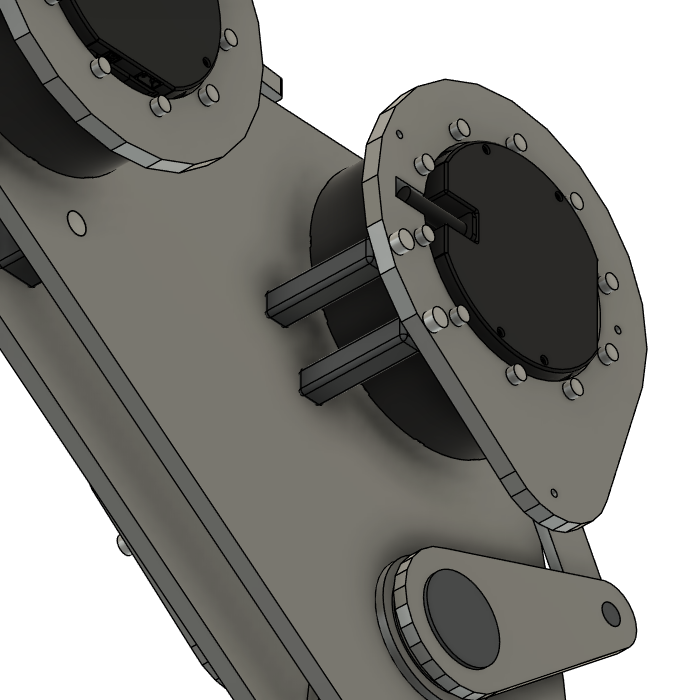
docs/images/fusion/big/crops/knee_stators_low.png
