meetsitaram/duck-droids/docs/images/fusion/big/crops/neck_back.png

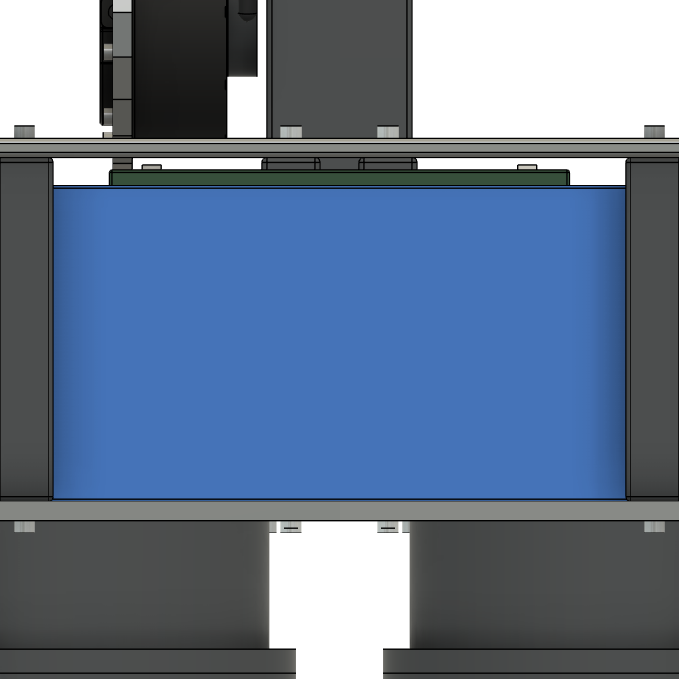
docs/images/fusion/big/crops/neck_back.png
