meetsitaram/duck-droids/docs/images/fusion/big/crops/neck_front.png

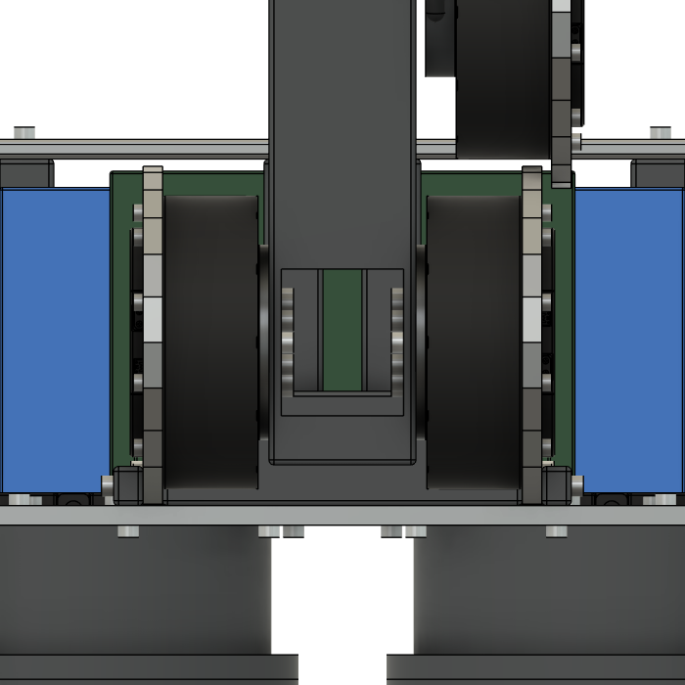
docs/images/fusion/big/crops/neck_front.png
