meetsitaram/duck-droids/docs/images/fusion/big/crops/neck_high.png

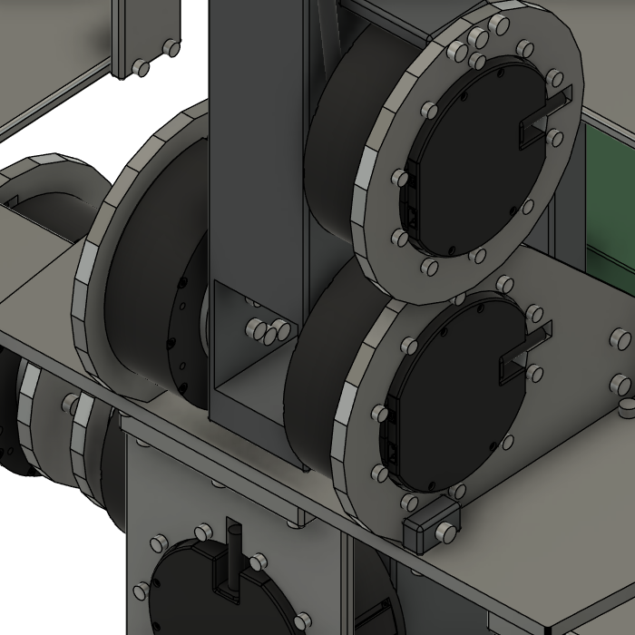
docs/images/fusion/big/crops/neck_high.png
