meetsitaram/duck-droids/docs/images/fusion/big/crops/neck_low.png

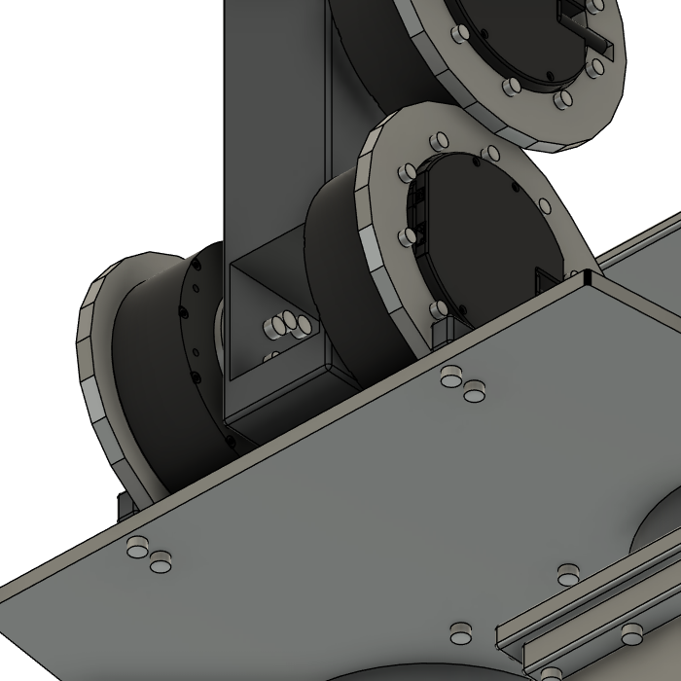
docs/images/fusion/big/crops/neck_low.png
