meetsitaram/duck-droids/docs/images/fusion/big/crops/neck_out.png

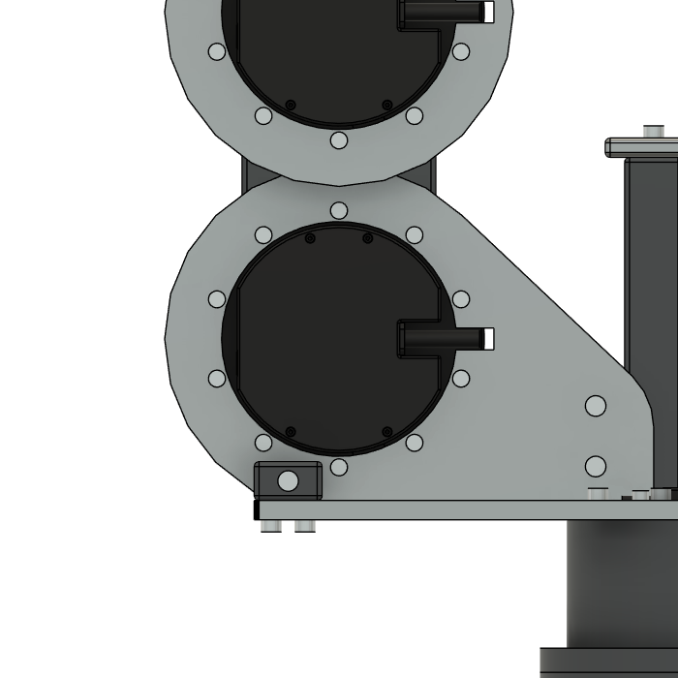
docs/images/fusion/big/crops/neck_out.png
