meetsitaram/duck-droids/docs/images/fusion/big/crops/r_ankle_back.png

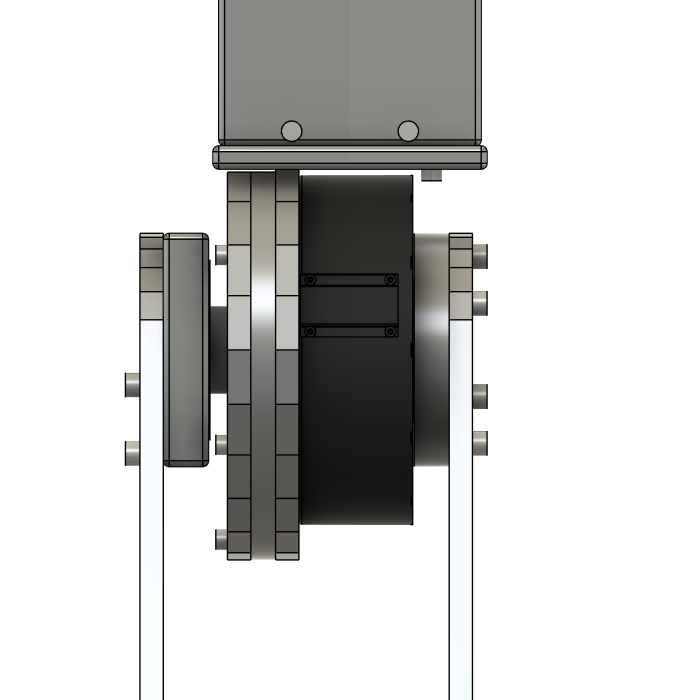
docs/images/fusion/big/crops/r_ankle_back.png
