meetsitaram/duck-droids/docs/images/fusion/big/crops/r_ankle_high.png

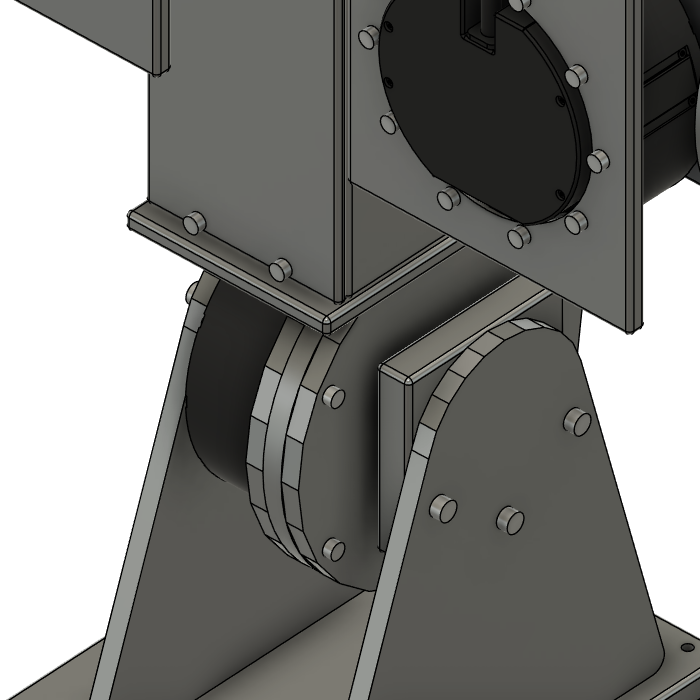
docs/images/fusion/big/crops/r_ankle_high.png
