meetsitaram/duck-droids/docs/images/fusion/big/crops/r_ankle_low.png

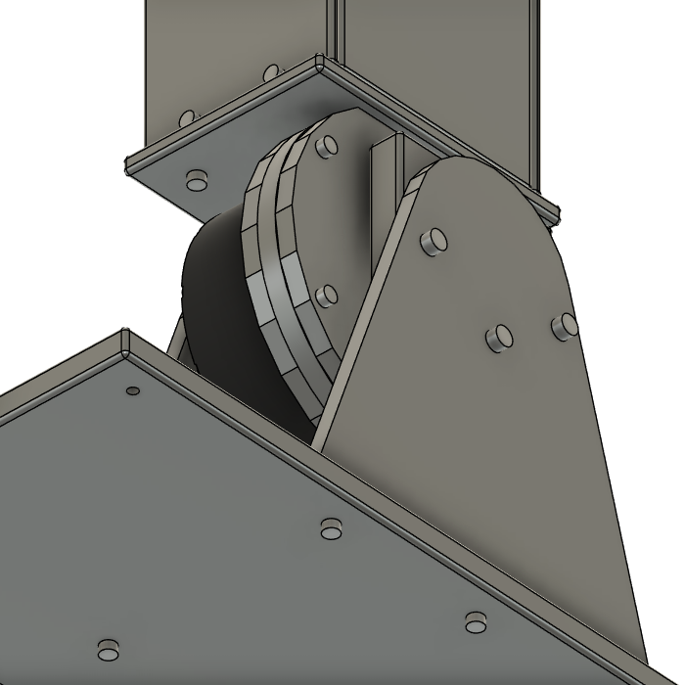
docs/images/fusion/big/crops/r_ankle_low.png
