meetsitaram/duck-droids/docs/images/fusion/big/crops/r_hip_pitch_front.png

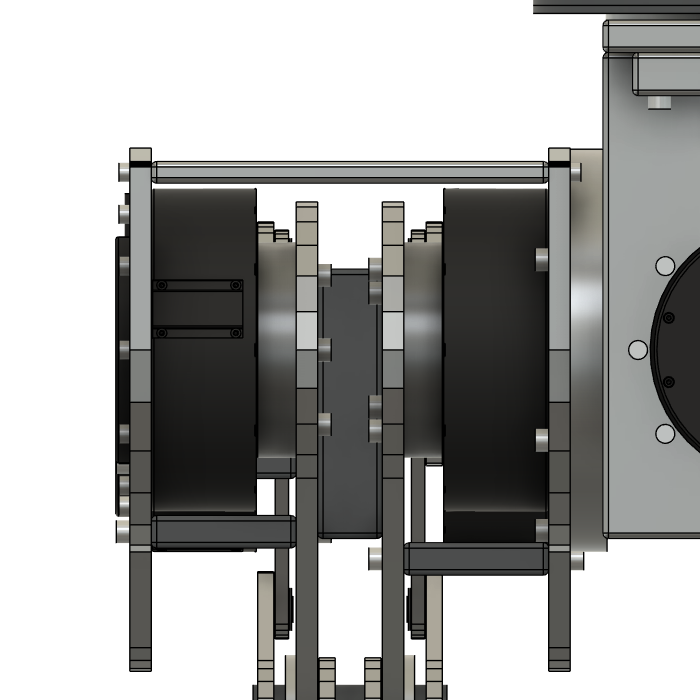
docs/images/fusion/big/crops/r_hip_pitch_front.png
