meetsitaram/duck-droids/docs/images/fusion/big/crops/r_hip_roll_back.png

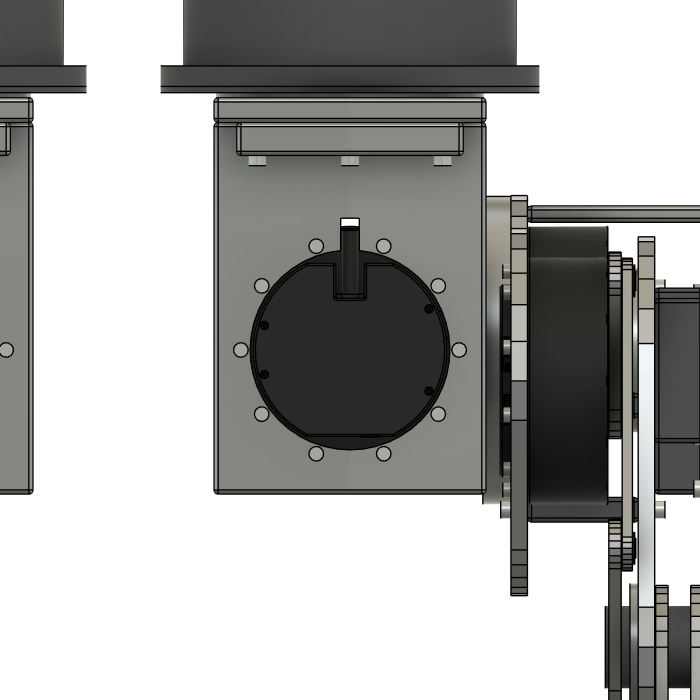
docs/images/fusion/big/crops/r_hip_roll_back.png
