meetsitaram/duck-droids/docs/images/fusion/big/crops/r_hip_roll_front.png

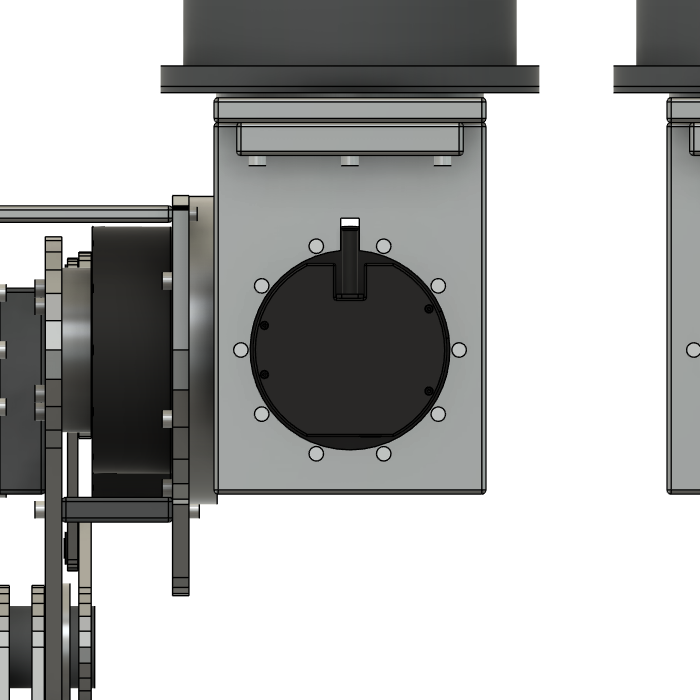
docs/images/fusion/big/crops/r_hip_roll_front.png
