meetsitaram/duck-droids/docs/images/fusion/big/crops/r_hip_roll_low.png

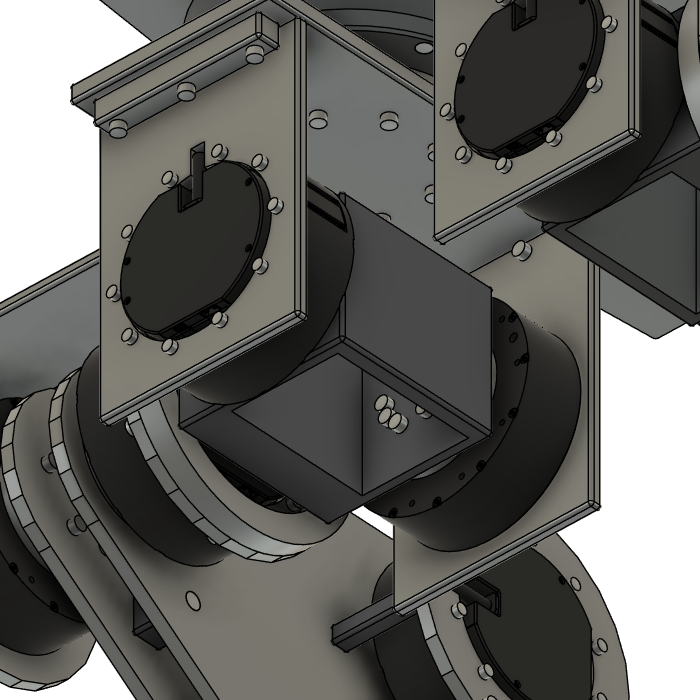
docs/images/fusion/big/crops/r_hip_roll_low.png
