meetsitaram/duck-droids/docs/images/fusion/big/crops/r_knee_high.png

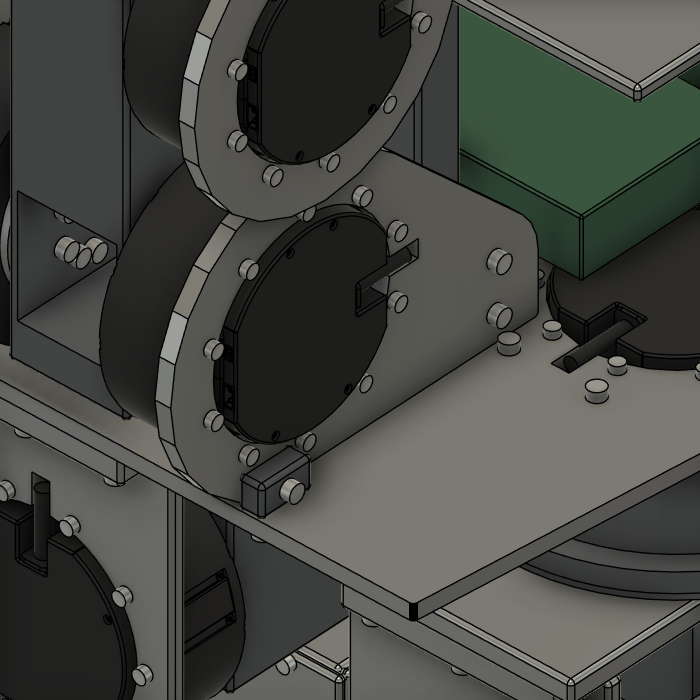
docs/images/fusion/big/crops/r_knee_high.png
