meetsitaram/duck-droids/docs/images/fusion/big/crops/r_knee_low.png

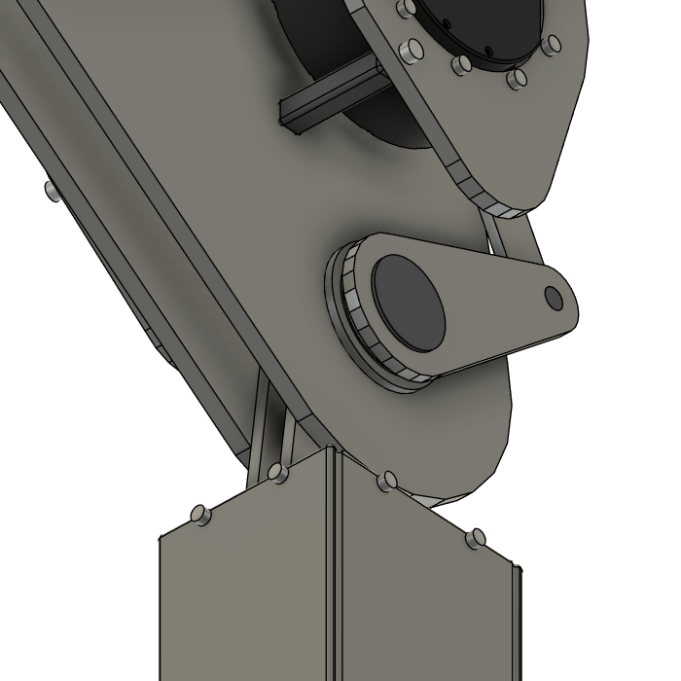
docs/images/fusion/big/crops/r_knee_low.png
