meetsitaram/duck-droids/docs/images/fusion/big/links/beak_link_a.png

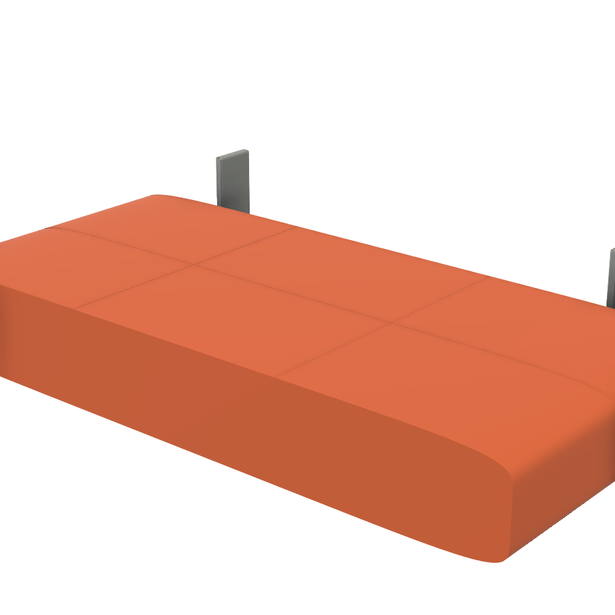
docs/images/fusion/big/links/beak_link_a.png
