meetsitaram/duck-droids/docs/images/fusion/big/links/beak_link_b.png

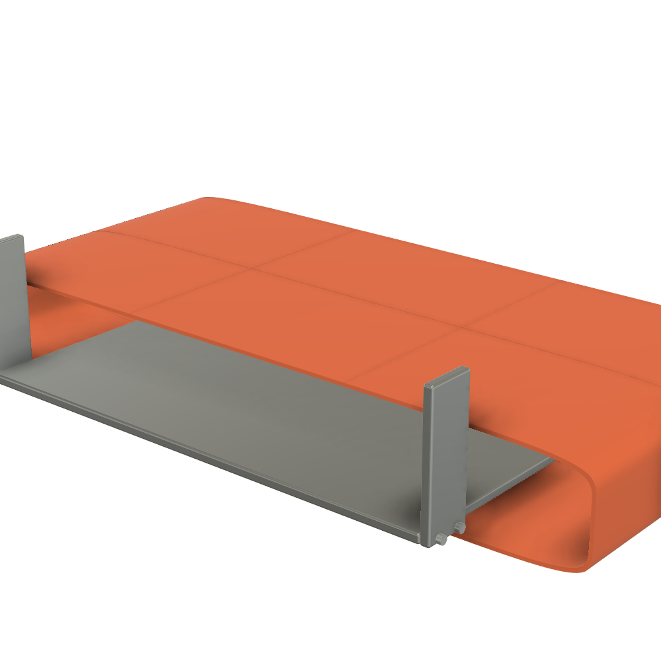
docs/images/fusion/big/links/beak_link_b.png
