meetsitaram/duck-droids/docs/images/fusion/big/links/beak_link_c.png

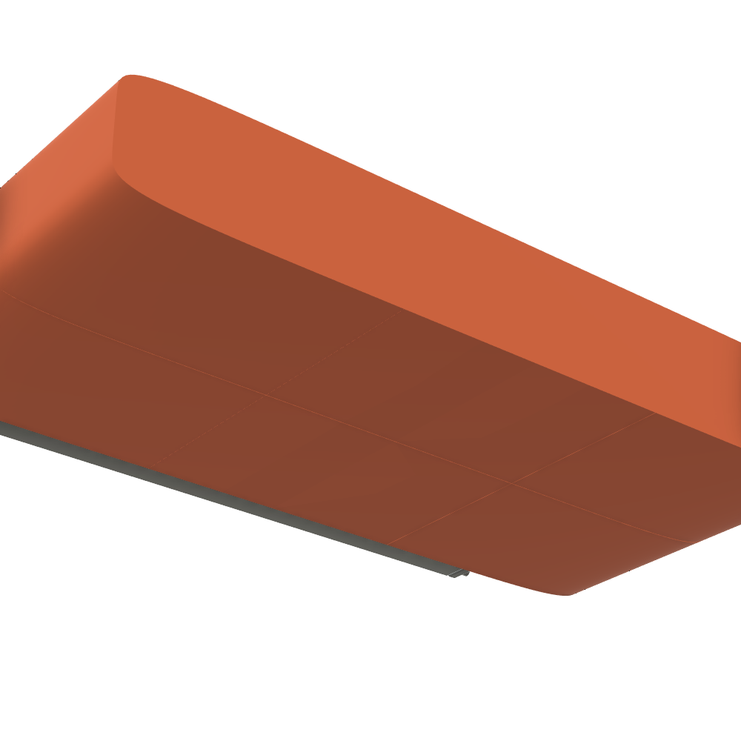
docs/images/fusion/big/links/beak_link_c.png
