meetsitaram/duck-droids/docs/images/fusion/big/links/head_a.png

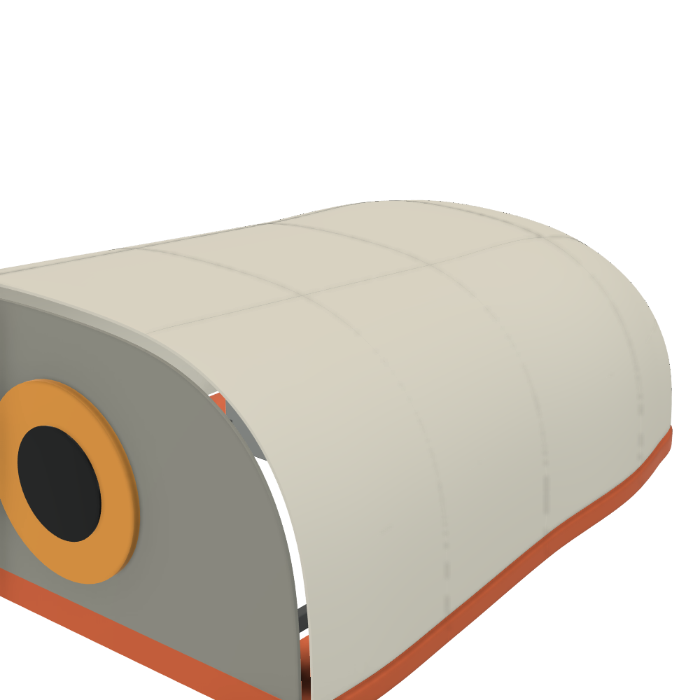
docs/images/fusion/big/links/head_a.png
