meetsitaram/duck-droids/docs/images/fusion/big/links/head_b.png

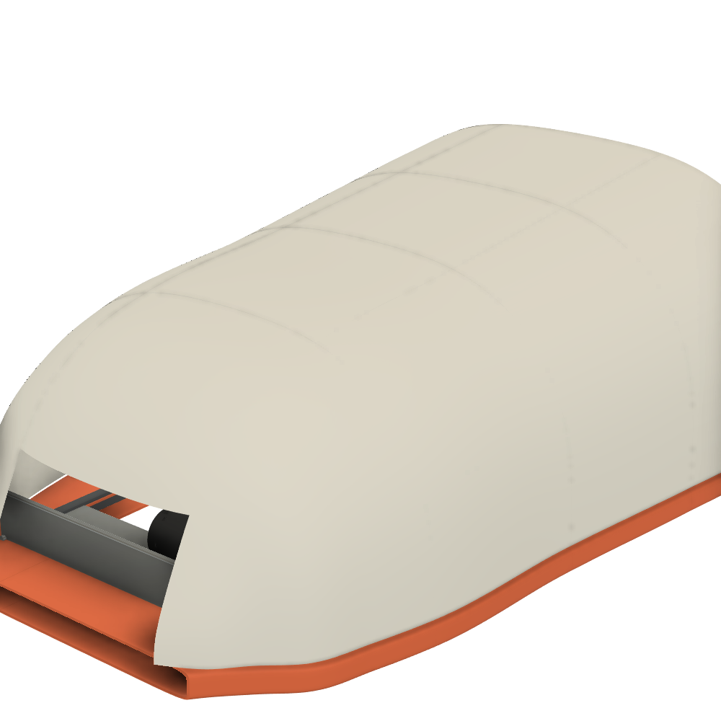
docs/images/fusion/big/links/head_b.png
