meetsitaram/duck-droids/docs/images/fusion/big/links/head_c.png

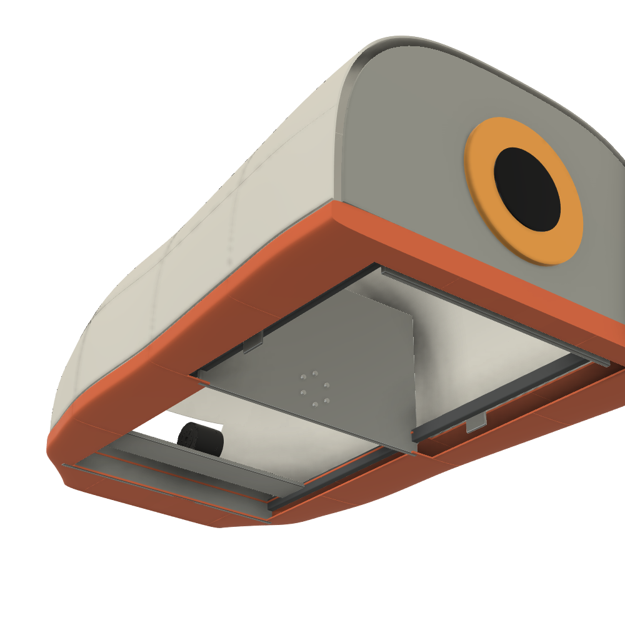
docs/images/fusion/big/links/head_c.png
