meetsitaram/duck-droids/docs/images/fusion/big/links/head_pitch_link_c.png

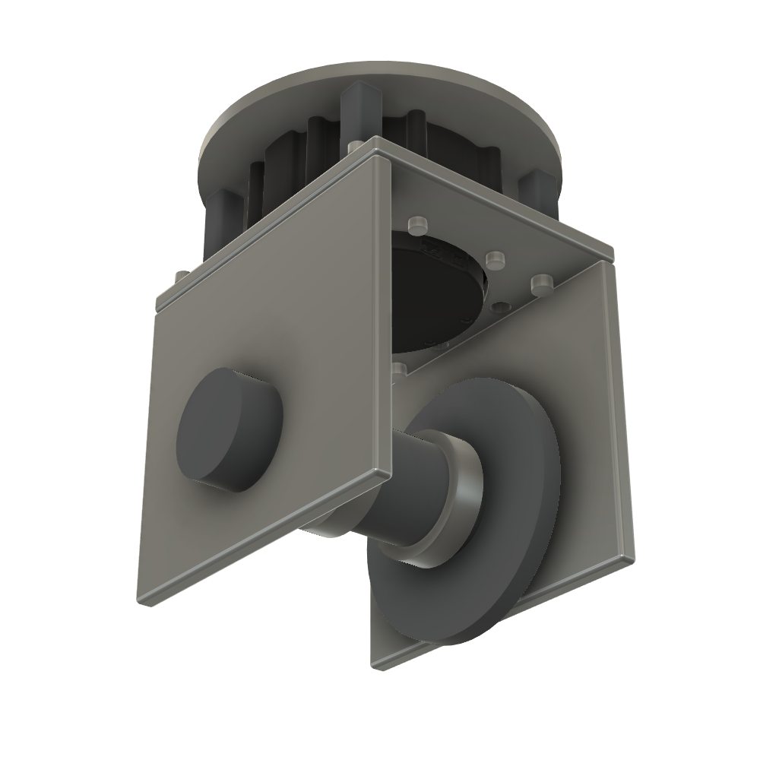
docs/images/fusion/big/links/head_pitch_link_c.png
