meetsitaram/duck-droids/docs/images/fusion/big/links/head_yaw_link_a.png

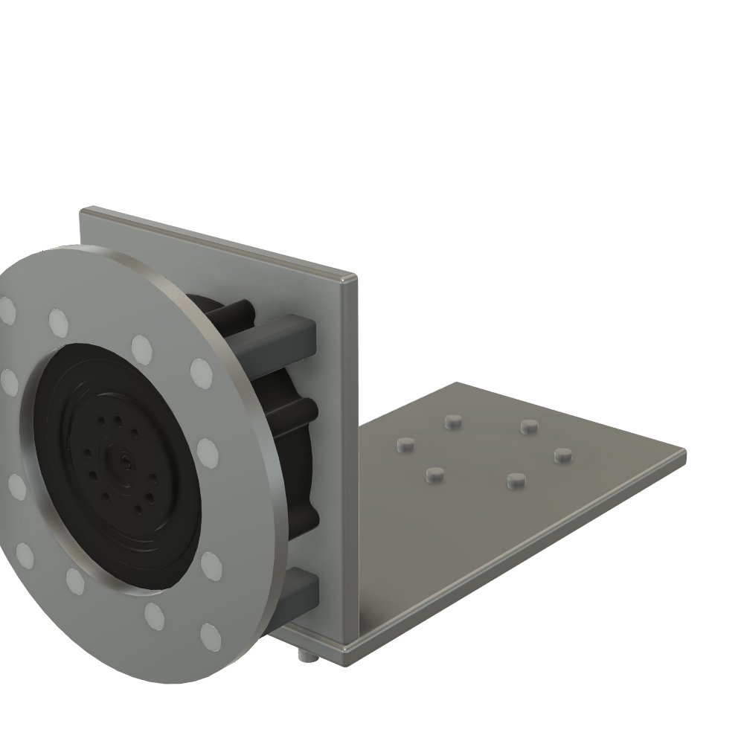
docs/images/fusion/big/links/head_yaw_link_a.png
