meetsitaram/duck-droids/docs/images/fusion/big/links/L_foot_a.png

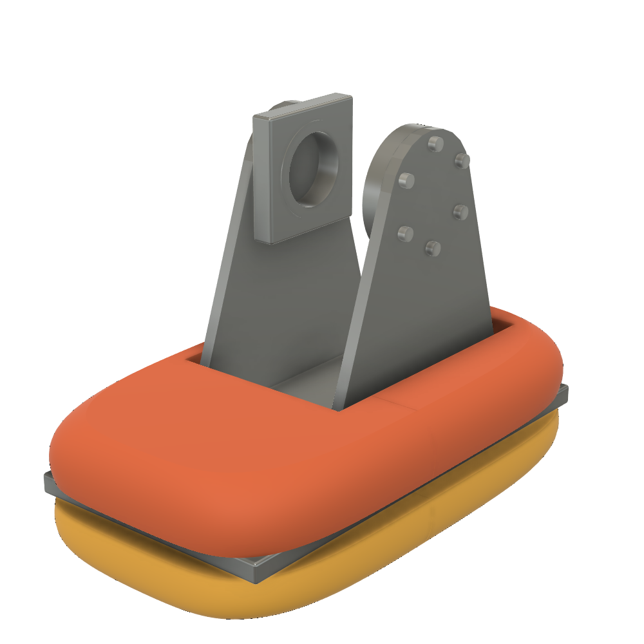
docs/images/fusion/big/links/L_foot_a.png
