meetsitaram/duck-droids/docs/images/fusion/big/links/L_foot_b.png

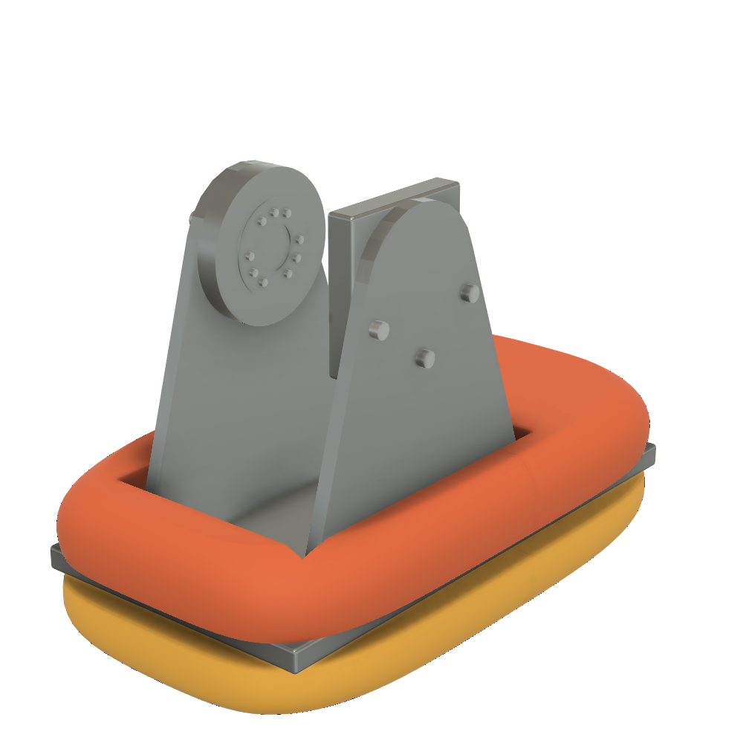
docs/images/fusion/big/links/L_foot_b.png
