meetsitaram/duck-droids/docs/images/fusion/big/links/L_foot_c.png

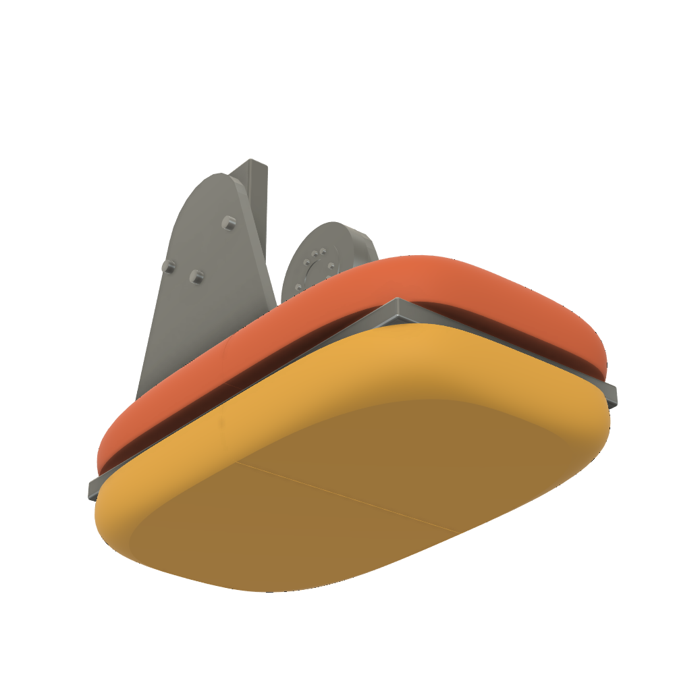
docs/images/fusion/big/links/L_foot_c.png
