meetsitaram/duck-droids/docs/images/fusion/big/links/L_hip_pitch_link_c.png

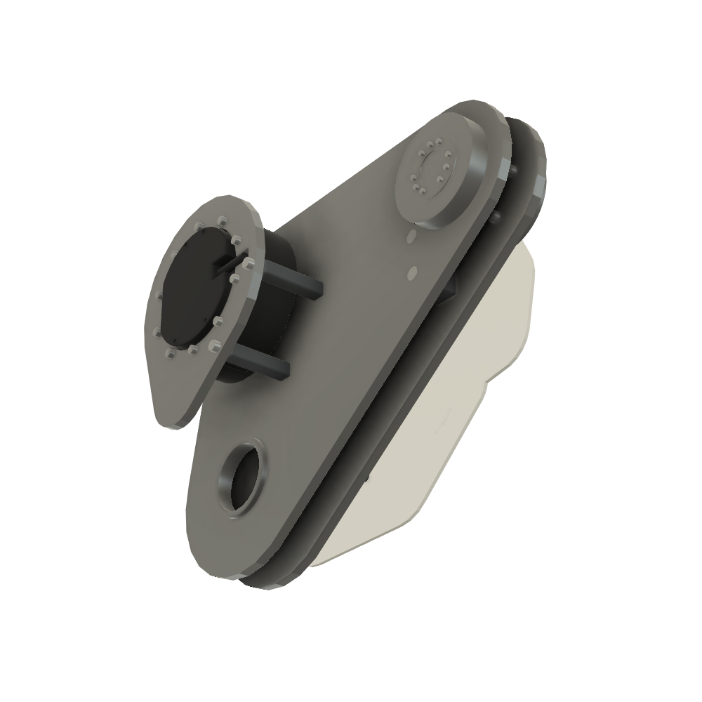
docs/images/fusion/big/links/L_hip_pitch_link_c.png
