meetsitaram/duck-droids/docs/images/fusion/big/links/L_hip_roll_link_a.png

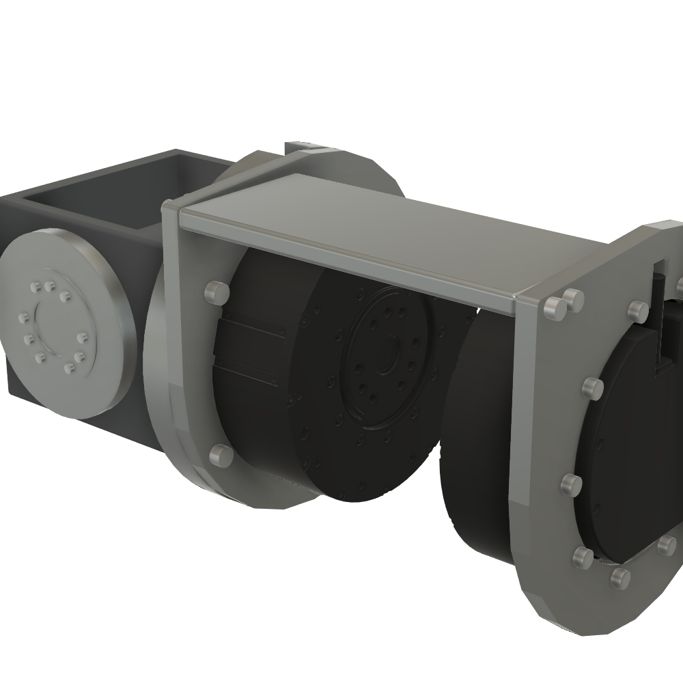
docs/images/fusion/big/links/L_hip_roll_link_a.png
