meetsitaram/duck-droids/docs/images/fusion/big/links/L_hip_yaw_link_c.png

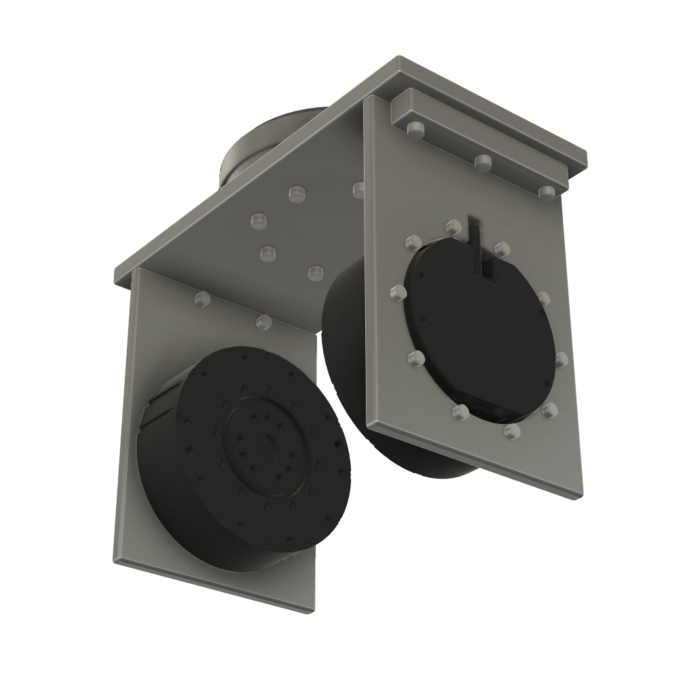
docs/images/fusion/big/links/L_hip_yaw_link_c.png
