meetsitaram/duck-droids/docs/images/fusion/big/links/L_knee_link_b.png

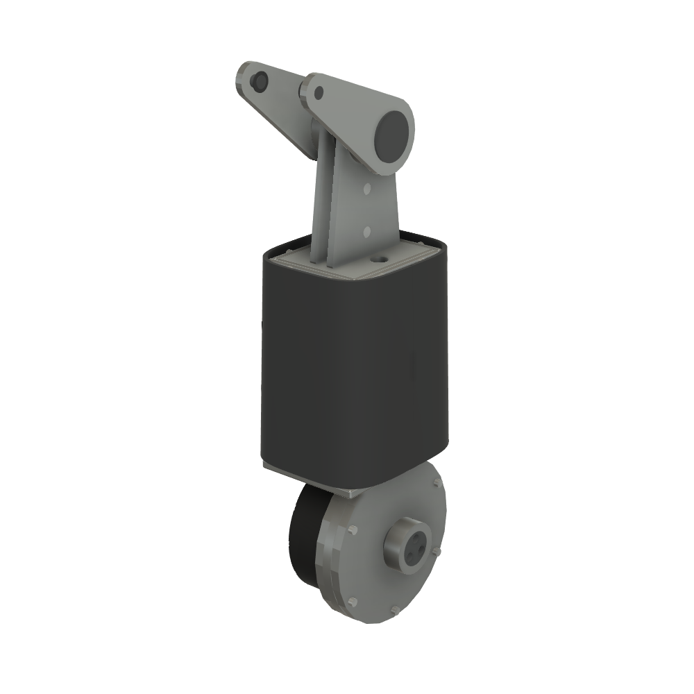
docs/images/fusion/big/links/L_knee_link_b.png
