meetsitaram/duck-droids/docs/images/fusion/big/links/neck_link_c.png

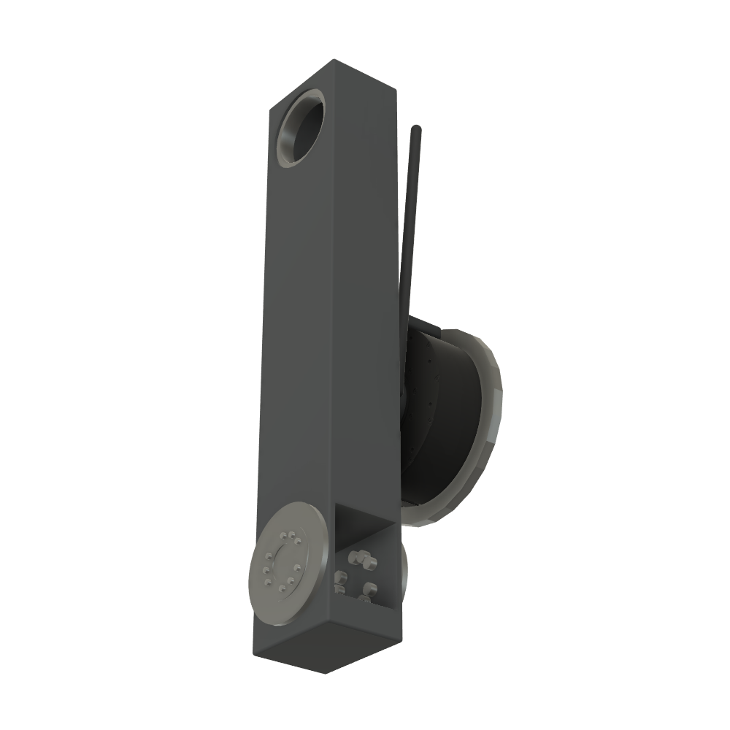
docs/images/fusion/big/links/neck_link_c.png
