meetsitaram/duck-droids/docs/images/fusion/big/links/trunk_a.png

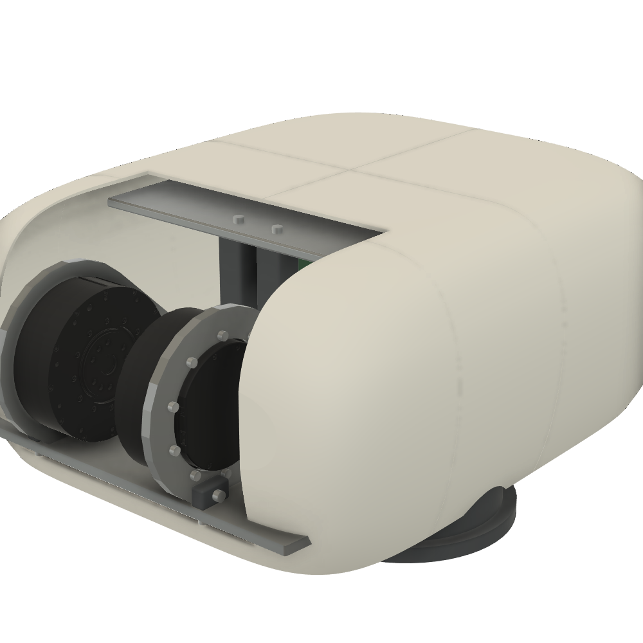
docs/images/fusion/big/links/trunk_a.png
