meetsitaram/duck-droids/docs/images/fusion/big/links/trunk_b.png

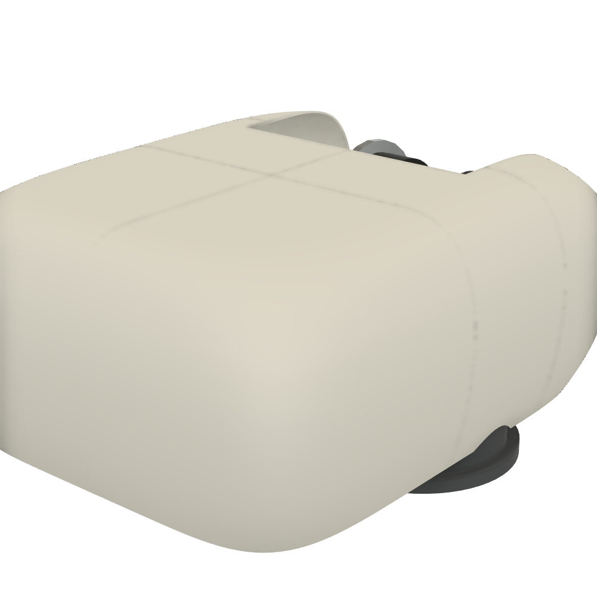
docs/images/fusion/big/links/trunk_b.png
