meetsitaram/duck-droids/docs/images/fusion/big/links/trunk_c.png

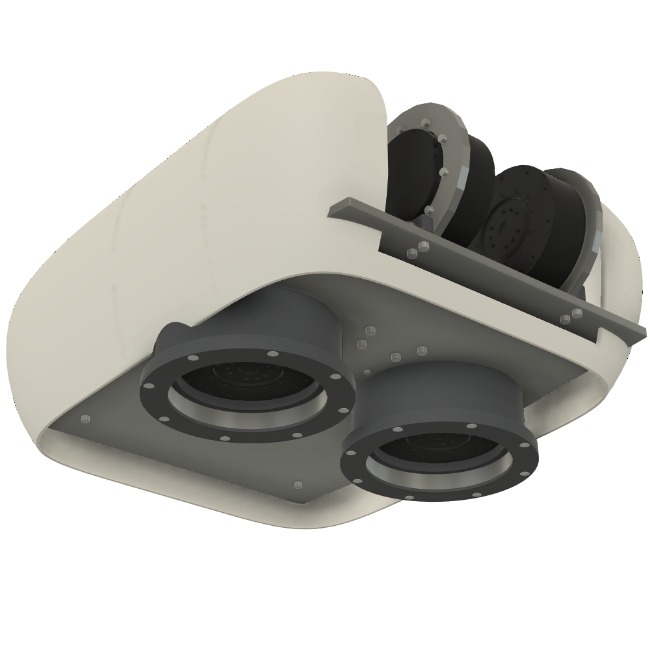
docs/images/fusion/big/links/trunk_c.png
