meetsitaram/duck-droids/docs/images/fusion/big/side.png

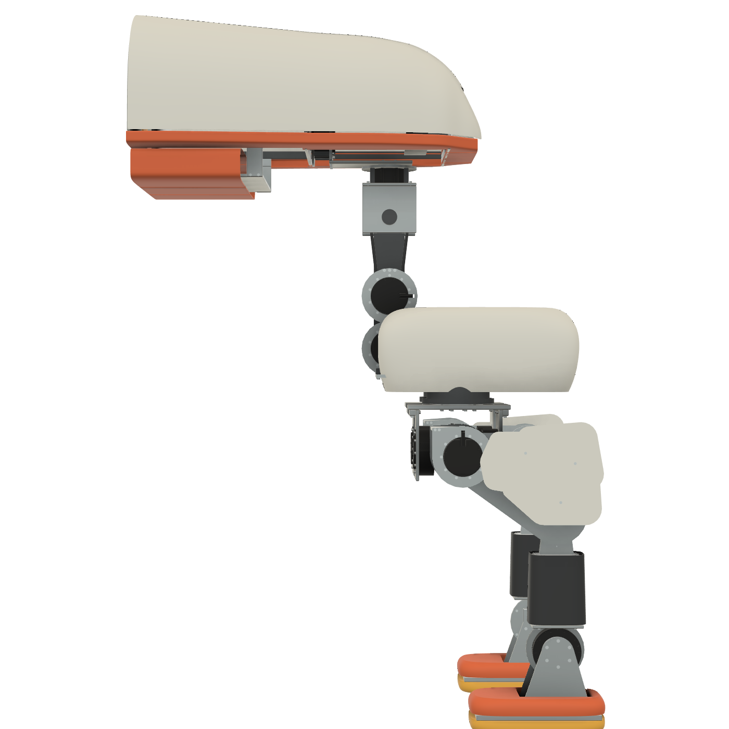
docs/images/fusion/big/side.png
