meetsitaram/duck-droids/docs/images/fusion/big/top.png

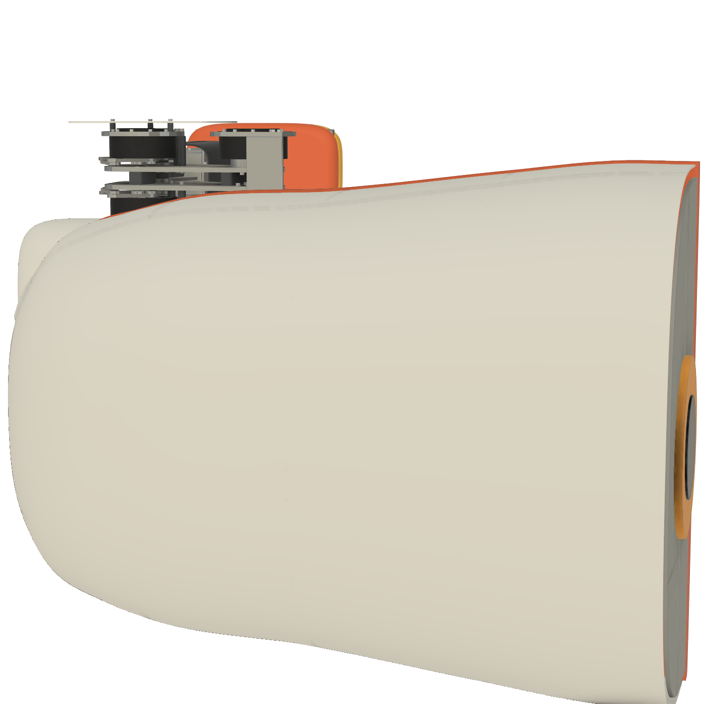
docs/images/fusion/big/top.png
