meetsitaram/duck-droids/docs/images/fusion/big/under.png

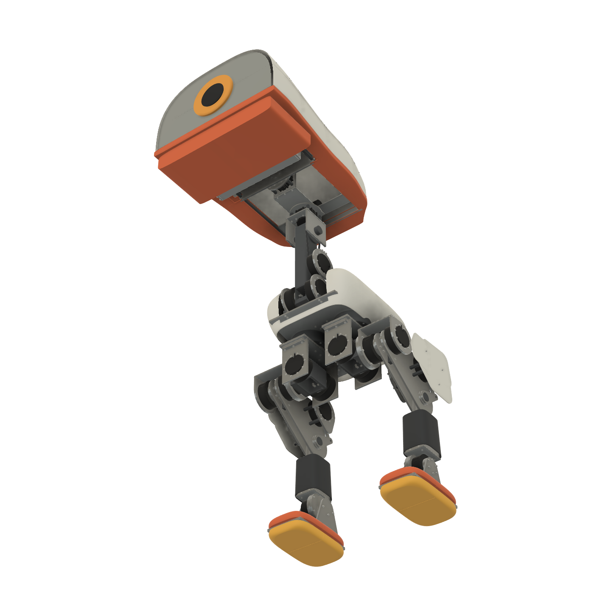
docs/images/fusion/big/under.png
