meetsitaram/duck-droids/docs/images/fusion/dynamixel/back.png

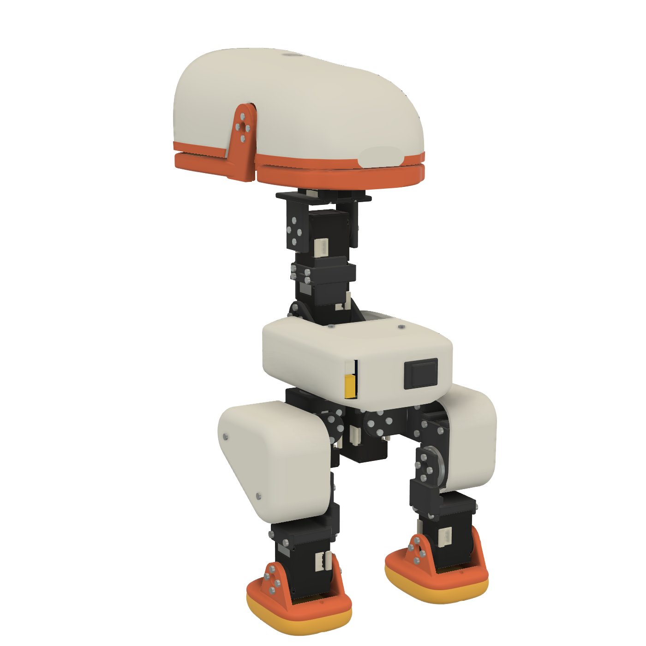
docs/images/fusion/dynamixel/back.png
