meetsitaram/duck-droids/docs/images/fusion/dynamixel/body_bat_back.png

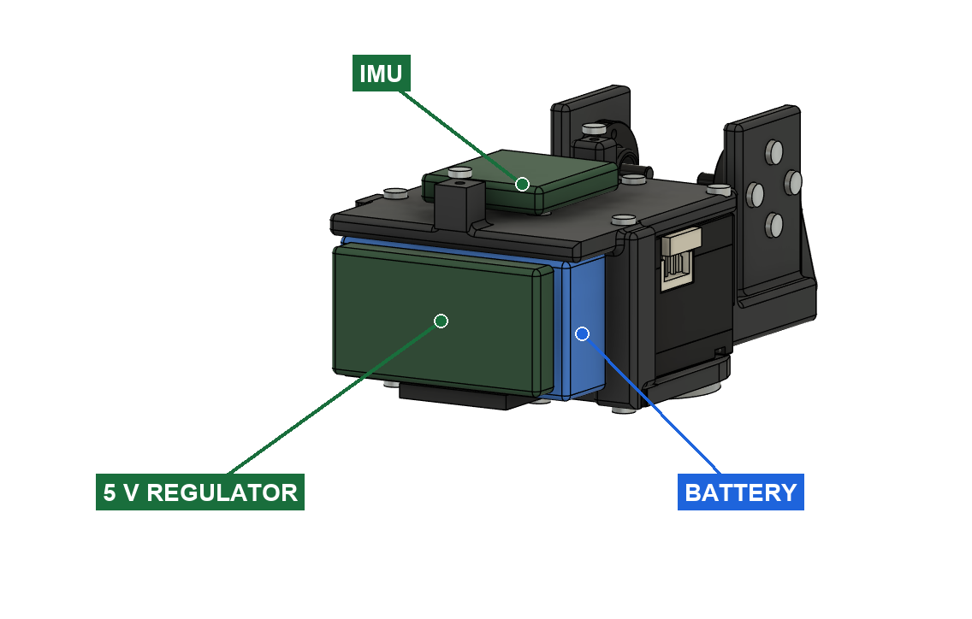
docs/images/fusion/dynamixel/body_bat_back.png
