meetsitaram/duck-droids/docs/images/fusion/dynamixel/body_bat_noreg.png

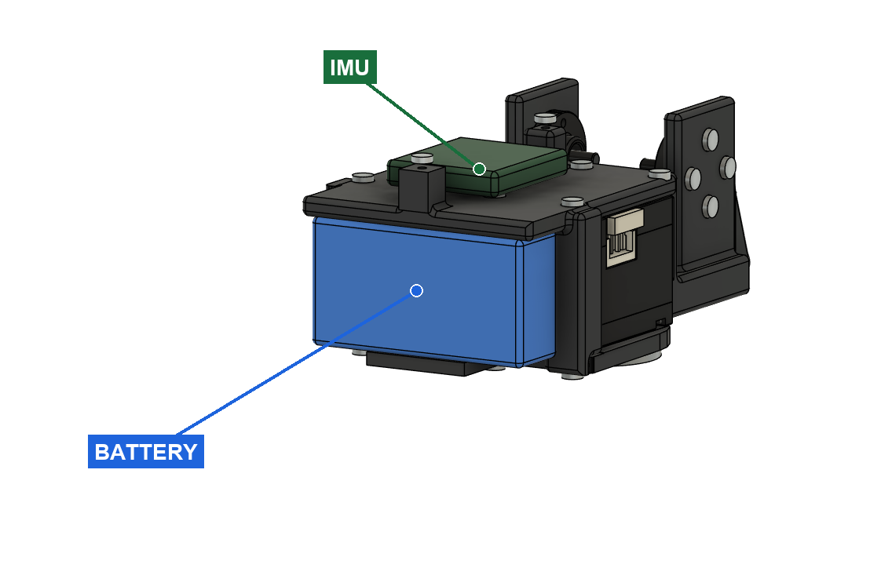
docs/images/fusion/dynamixel/body_bat_noreg.png
