meetsitaram/duck-droids/docs/images/fusion/dynamixel/body_bat_side.png

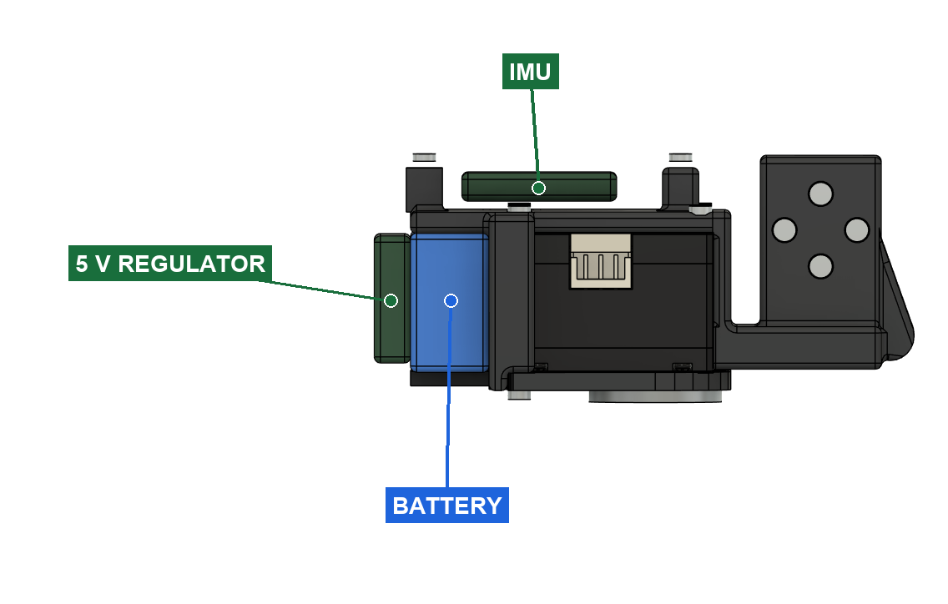
docs/images/fusion/dynamixel/body_bat_side.png
