meetsitaram/duck-droids/docs/images/fusion/dynamixel/close_body_electronics.png

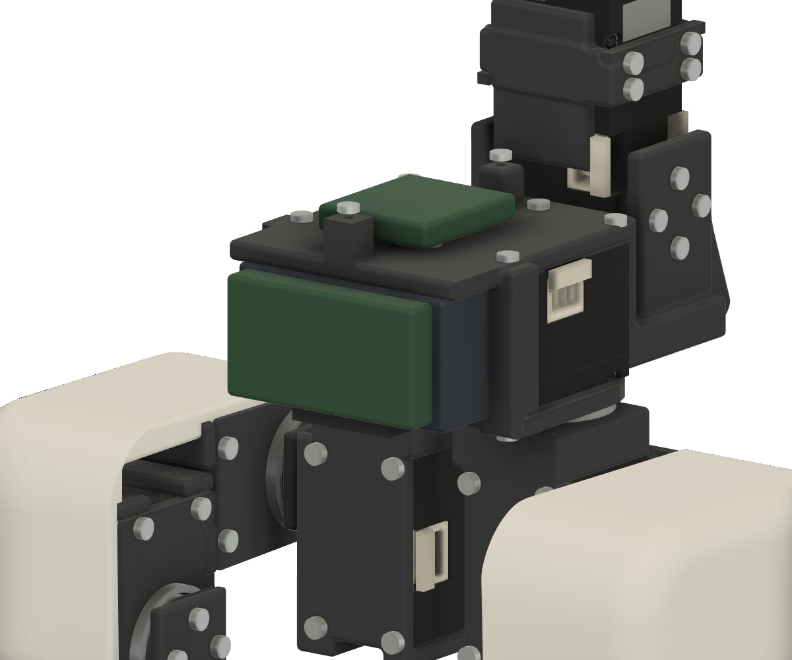
docs/images/fusion/dynamixel/close_body_electronics.png
