meetsitaram/duck-droids/docs/images/fusion/dynamixel/close_head_board.png

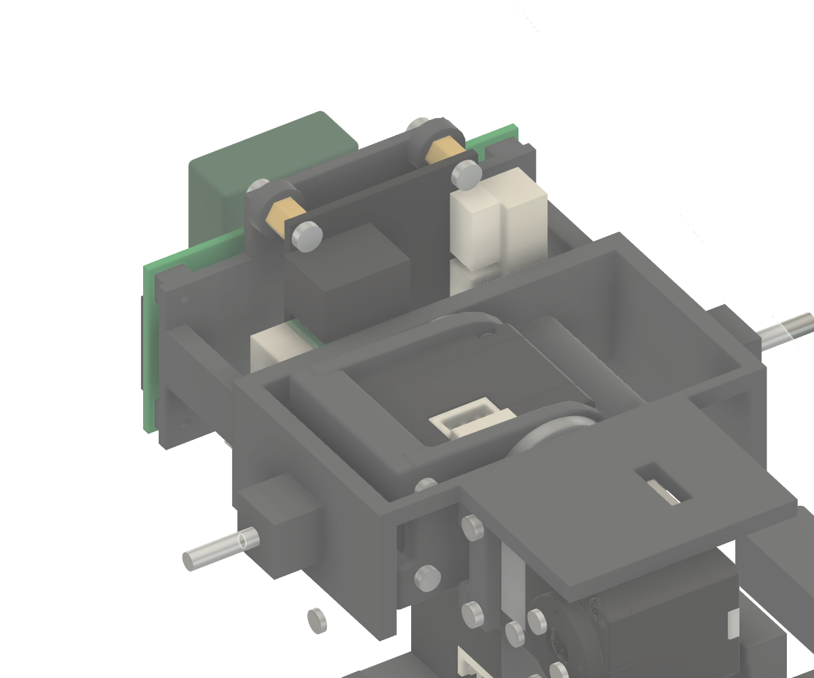
docs/images/fusion/dynamixel/close_head_board.png
