meetsitaram/duck-droids/docs/images/fusion/dynamixel/close_head_board_side.png

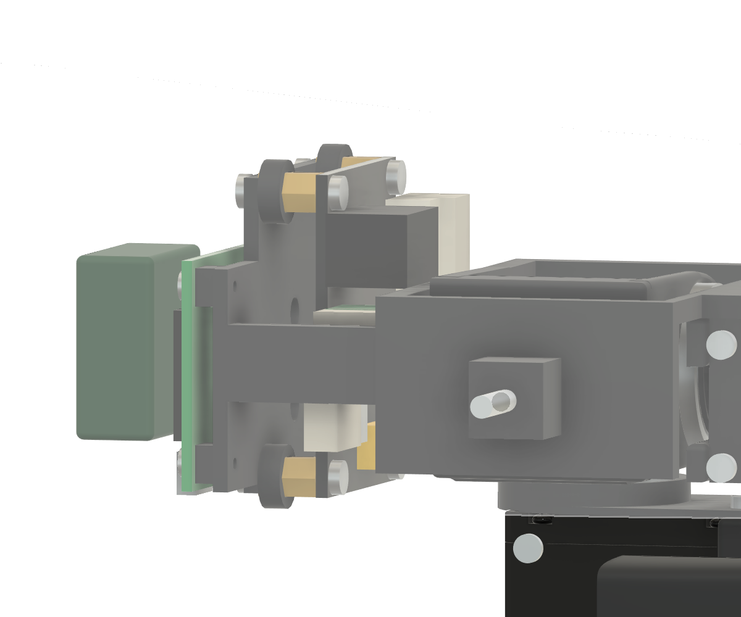
docs/images/fusion/dynamixel/close_head_board_side.png
