meetsitaram/duck-droids/docs/images/fusion/dynamixel/close_hip_joint.png

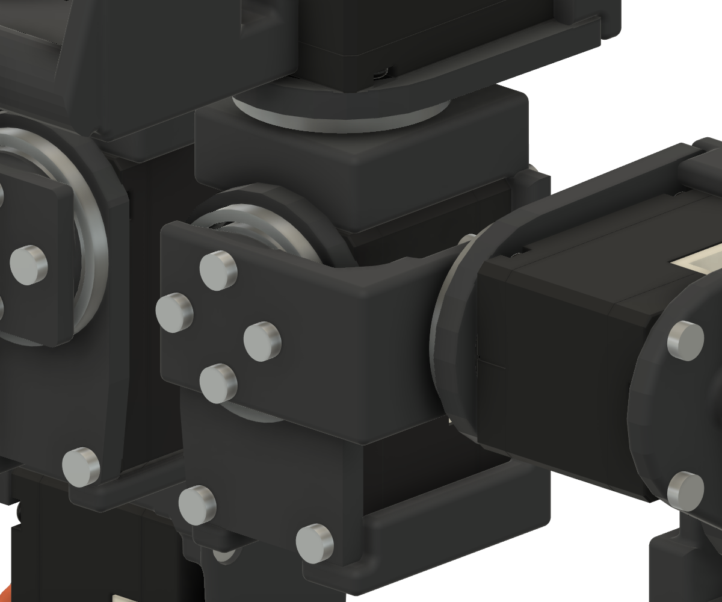
docs/images/fusion/dynamixel/close_hip_joint.png
