meetsitaram/duck-droids/docs/images/fusion/dynamixel/close_leg_covered.png

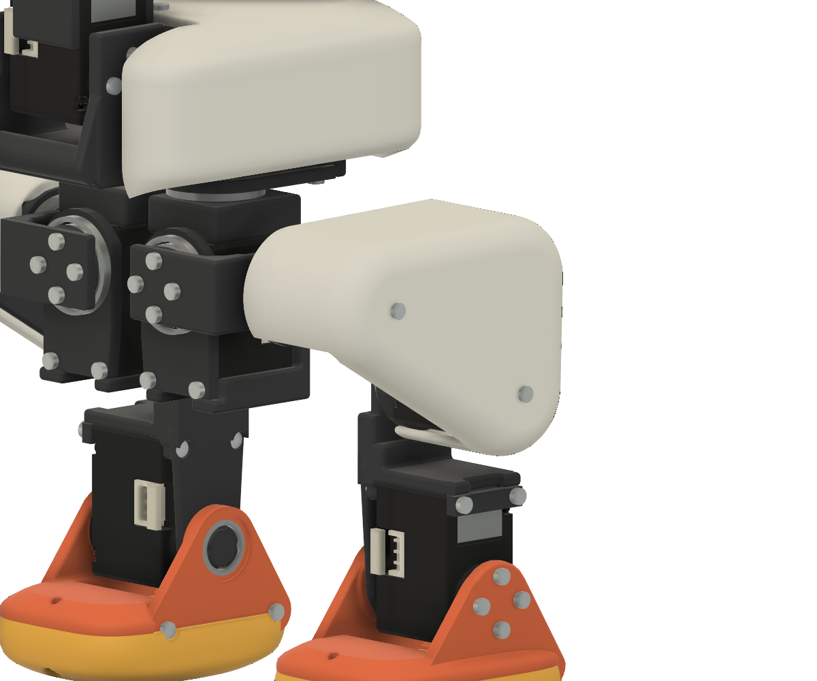
docs/images/fusion/dynamixel/close_leg_covered.png
