meetsitaram/duck-droids/docs/images/fusion/dynamixel/close_leg_open.png

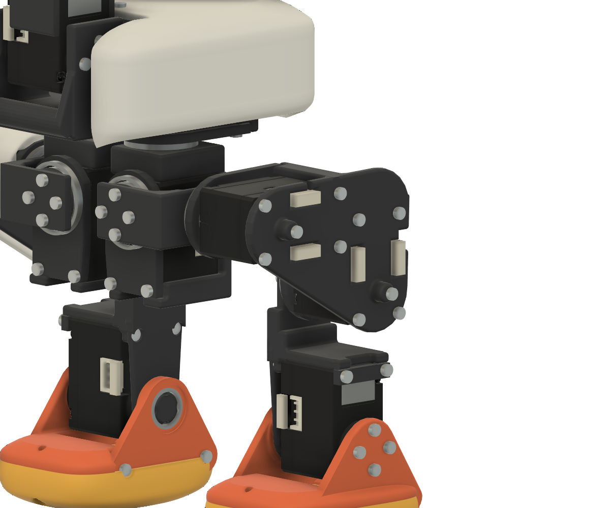
docs/images/fusion/dynamixel/close_leg_open.png
