meetsitaram/duck-droids/docs/images/fusion/dynamixel/close_thigh_outer_screws.png

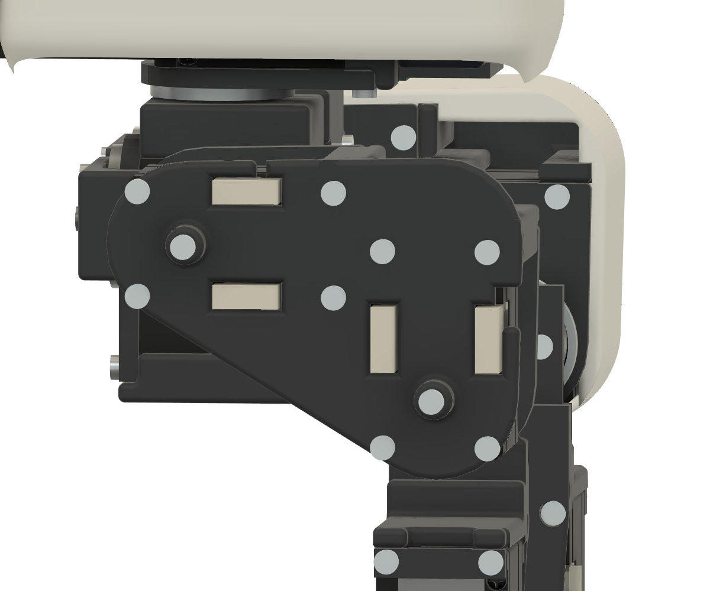
docs/images/fusion/dynamixel/close_thigh_outer_screws.png
