meetsitaram/duck-droids/docs/images/fusion/dynamixel/top.png

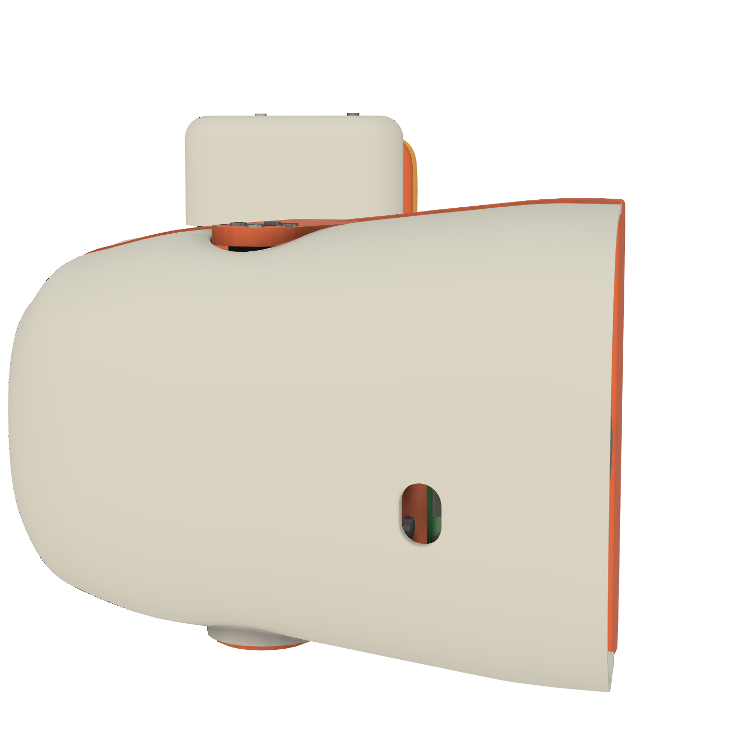
docs/images/fusion/dynamixel/top.png
