meetsitaram/duck-droids/docs/images/fusion/feetech/side.png

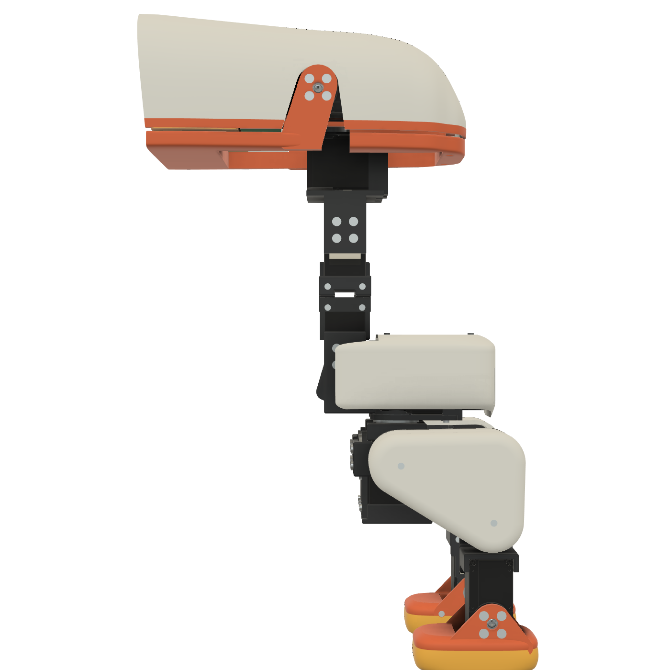
docs/images/fusion/feetech/side.png
