meetsitaram/duck-droids/docs/images/fusion/feetech/top.png

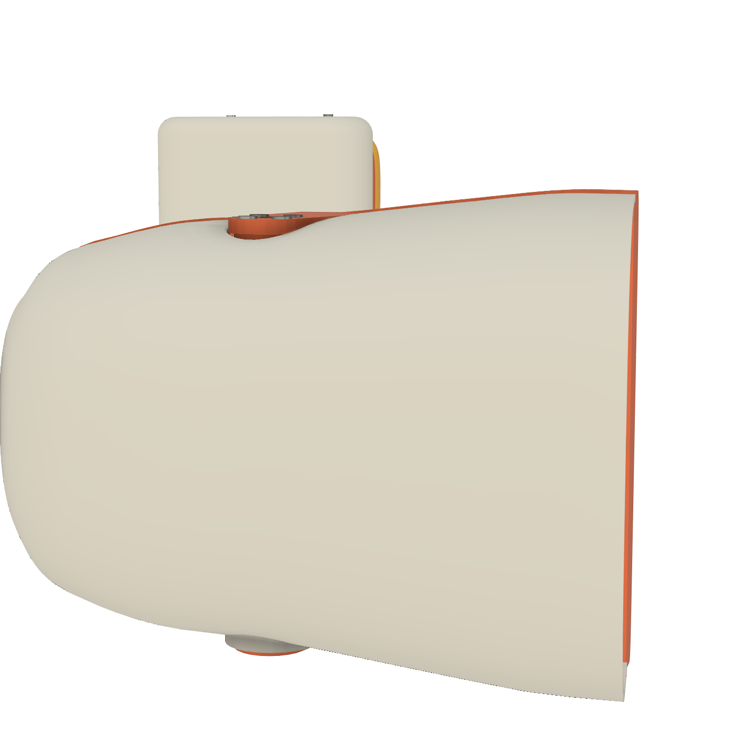
docs/images/fusion/feetech/top.png
