meetsitaram/duck-droids/docs/images/fusion/fusion_back.png

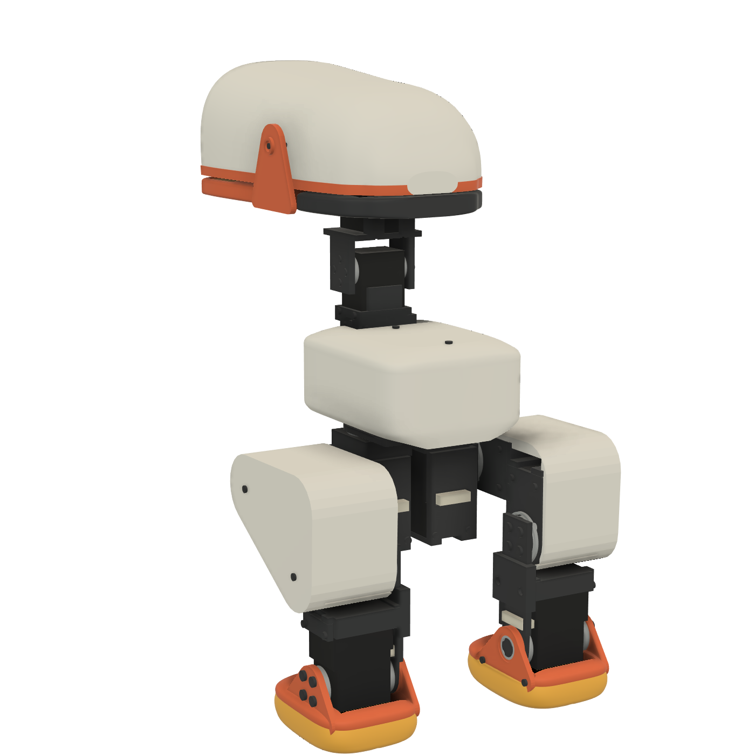
docs/images/fusion/fusion_back.png
