meetsitaram/duck-droids/docs/images/fusion/fusion_side.png

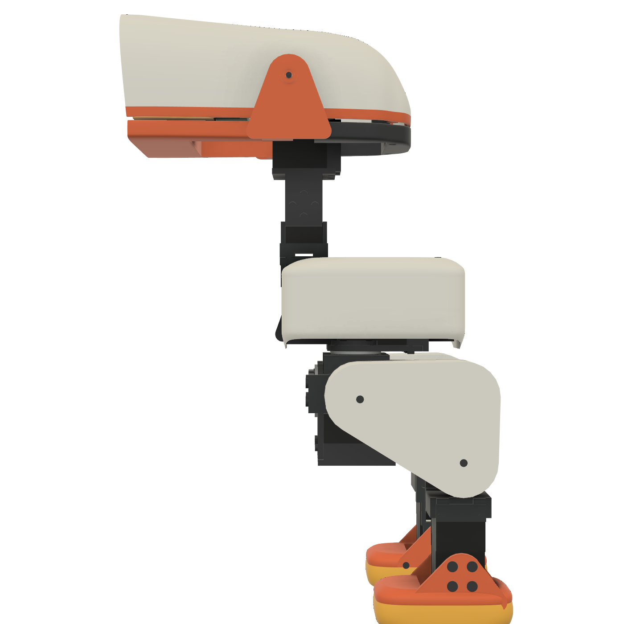
docs/images/fusion/fusion_side.png
