meetsitaram/duck-droids/docs/images/fusion/fusion_under.png

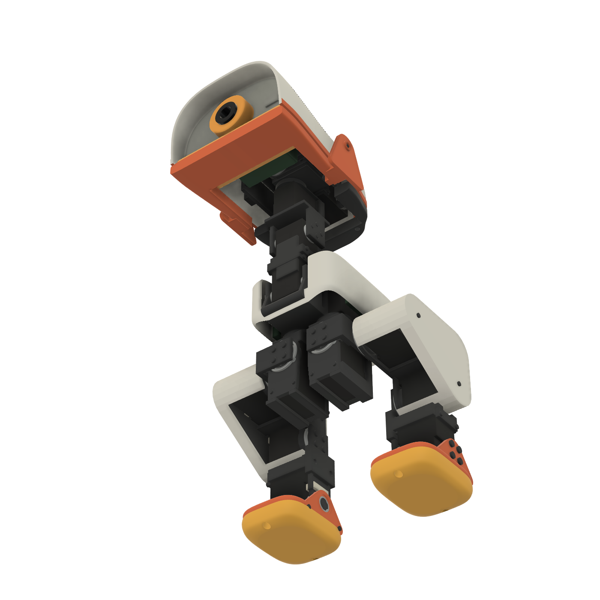
docs/images/fusion/fusion_under.png
