meetsitaram/duck-droids/docs/images/fusion/hd1910/close_ankle.png

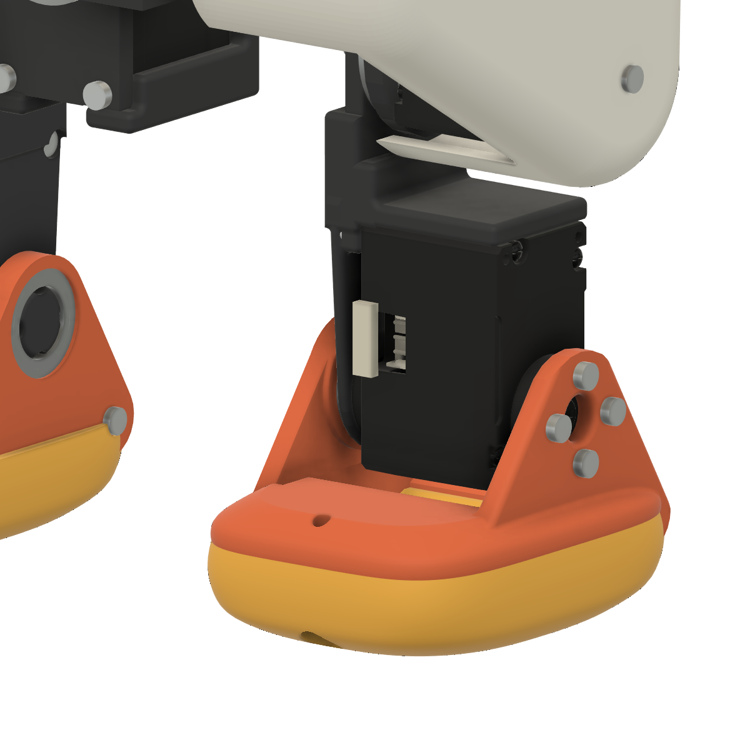
docs/images/fusion/hd1910/close_ankle.png
