meetsitaram/duck-droids/docs/images/fusion/hd1910/close_head_open.png

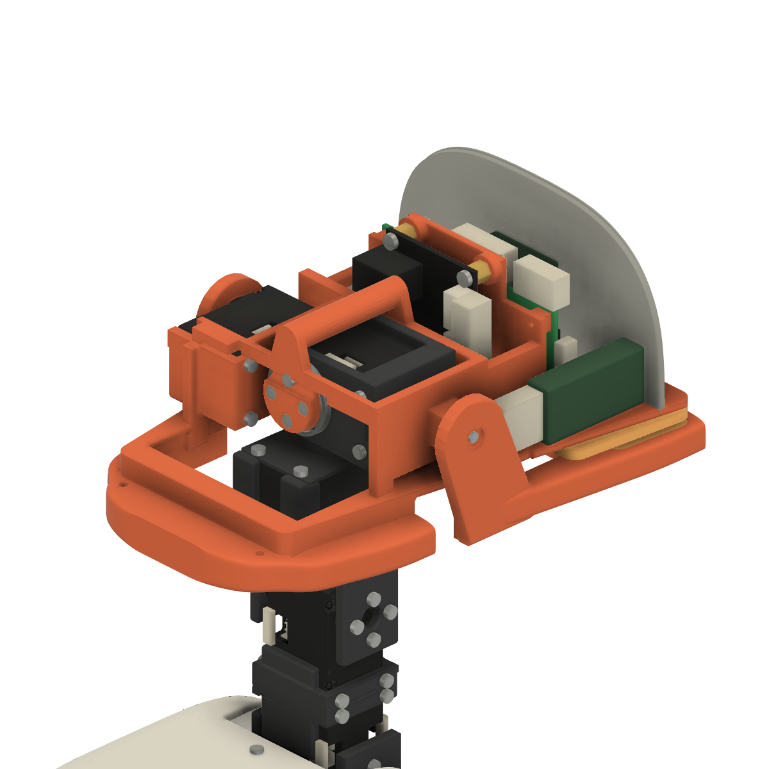
docs/images/fusion/hd1910/close_head_open.png
