meetsitaram/duck-droids/docs/images/fusion/hd1910/close_hip_under.png

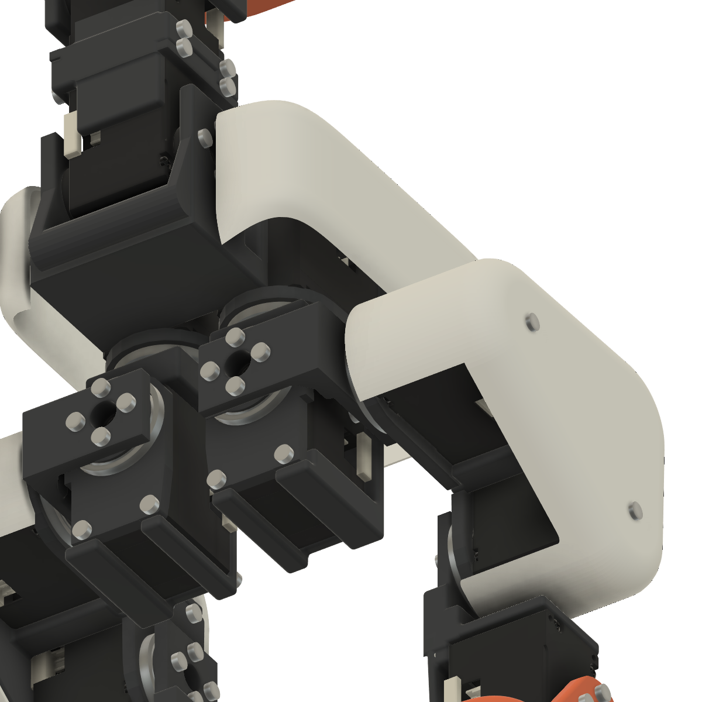
docs/images/fusion/hd1910/close_hip_under.png
