meetsitaram/duck-droids/docs/images/fusion/hd1910/close_leg_open.png

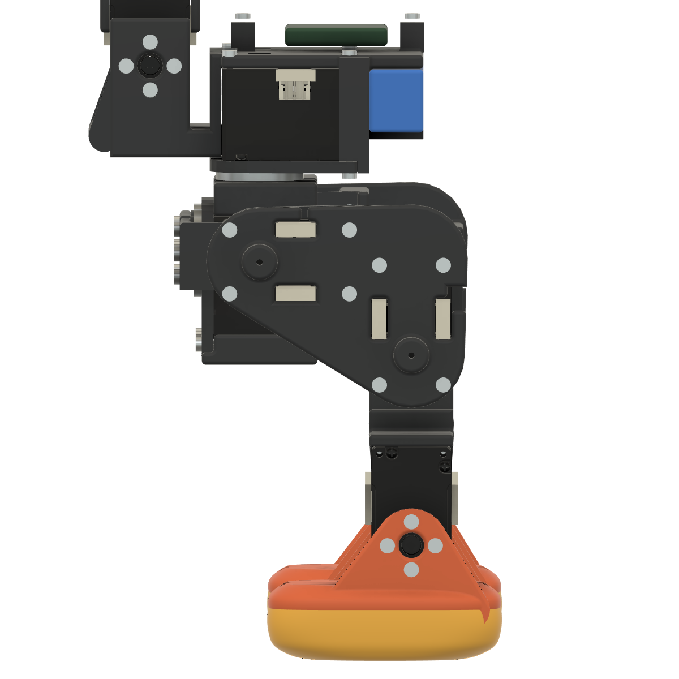
docs/images/fusion/hd1910/close_leg_open.png
