meetsitaram/duck-droids/docs/images/fusion/hd1910/close_neck.png

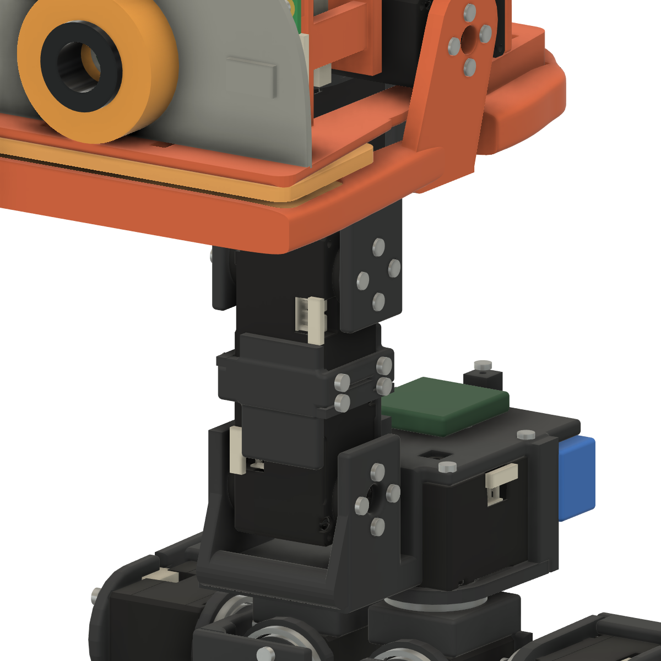
docs/images/fusion/hd1910/close_neck.png
