meetsitaram/duck-droids/docs/images/fusion/hd1910/close_neck_rear.png

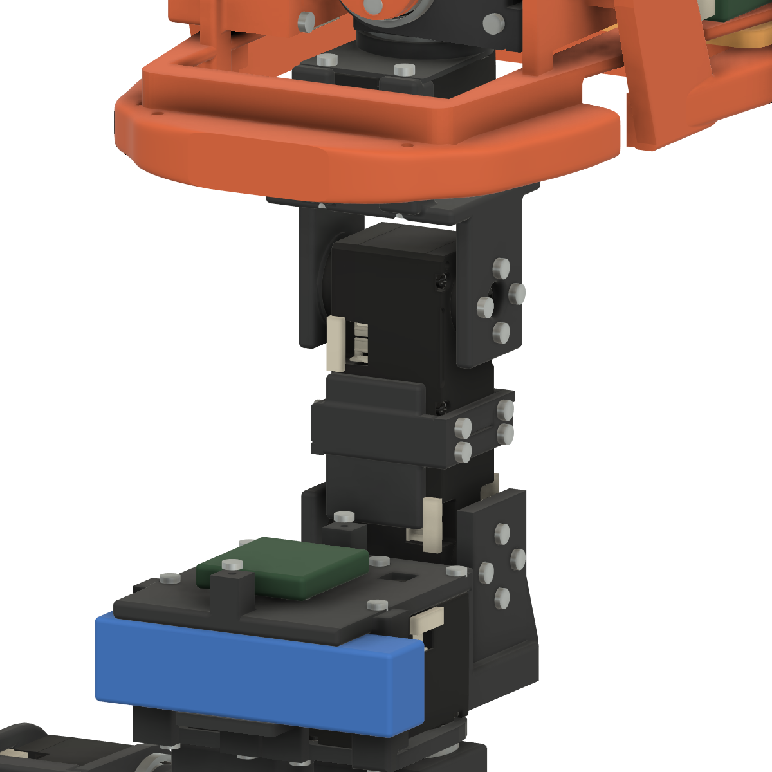
docs/images/fusion/hd1910/close_neck_rear.png
