meetsitaram/duck-droids/docs/images/fusion/hd1910/close_regulator.png

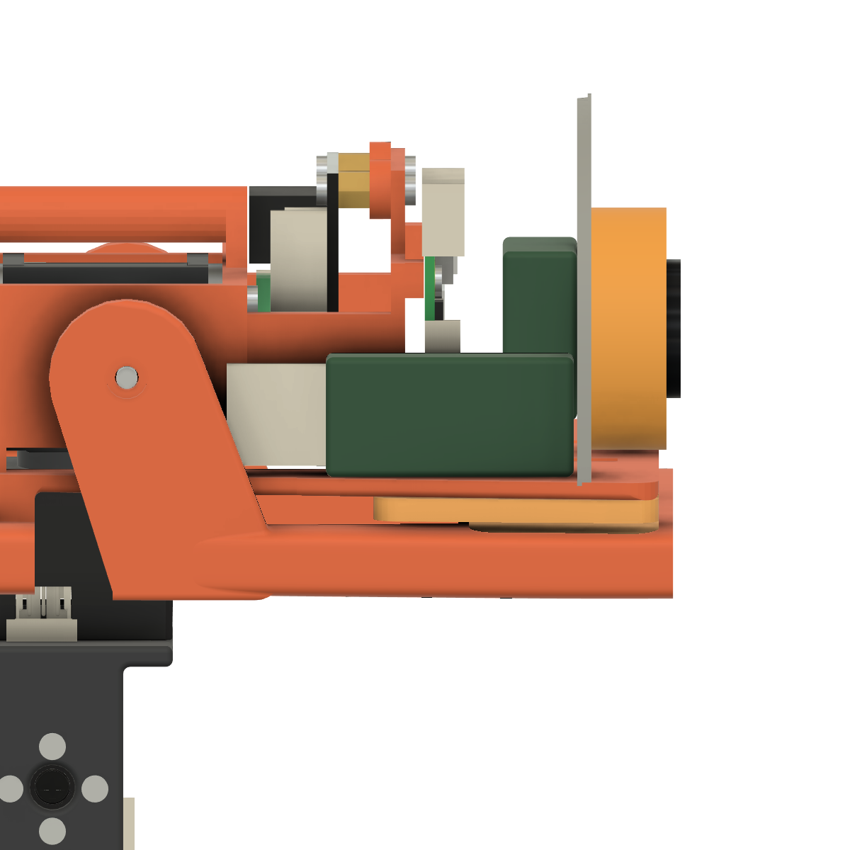
docs/images/fusion/hd1910/close_regulator.png
