meetsitaram/duck-droids/docs/images/fusion/hd1910/offline/ankle.png

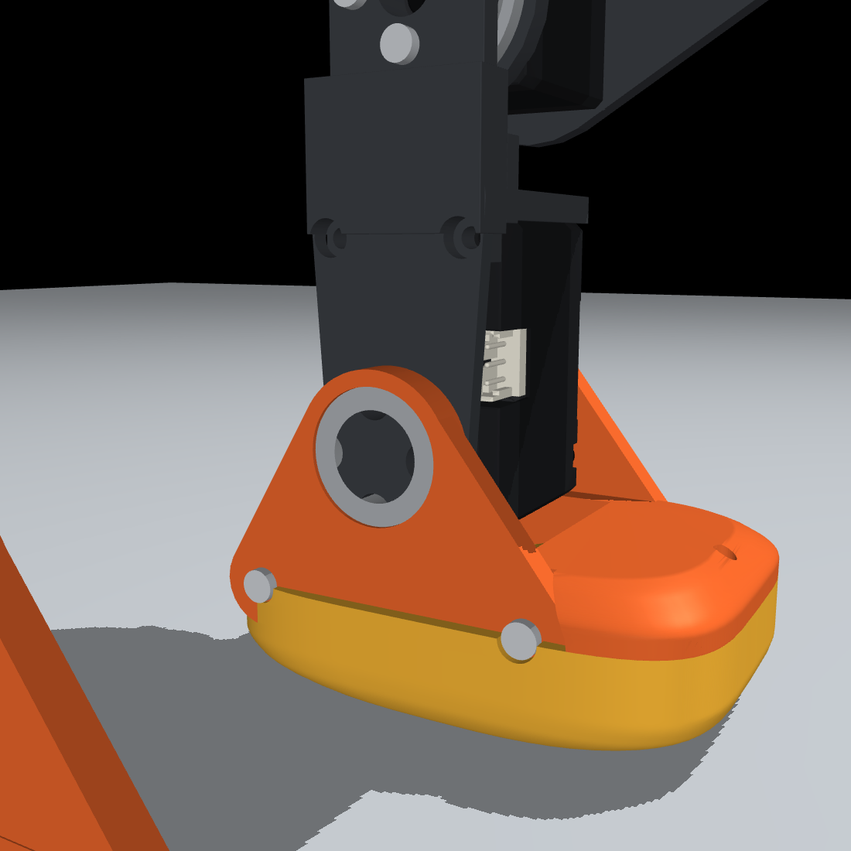
docs/images/fusion/hd1910/offline/ankle.png
