meetsitaram/duck-droids/docs/images/fusion/hd1910/offline/ankle_rear.png

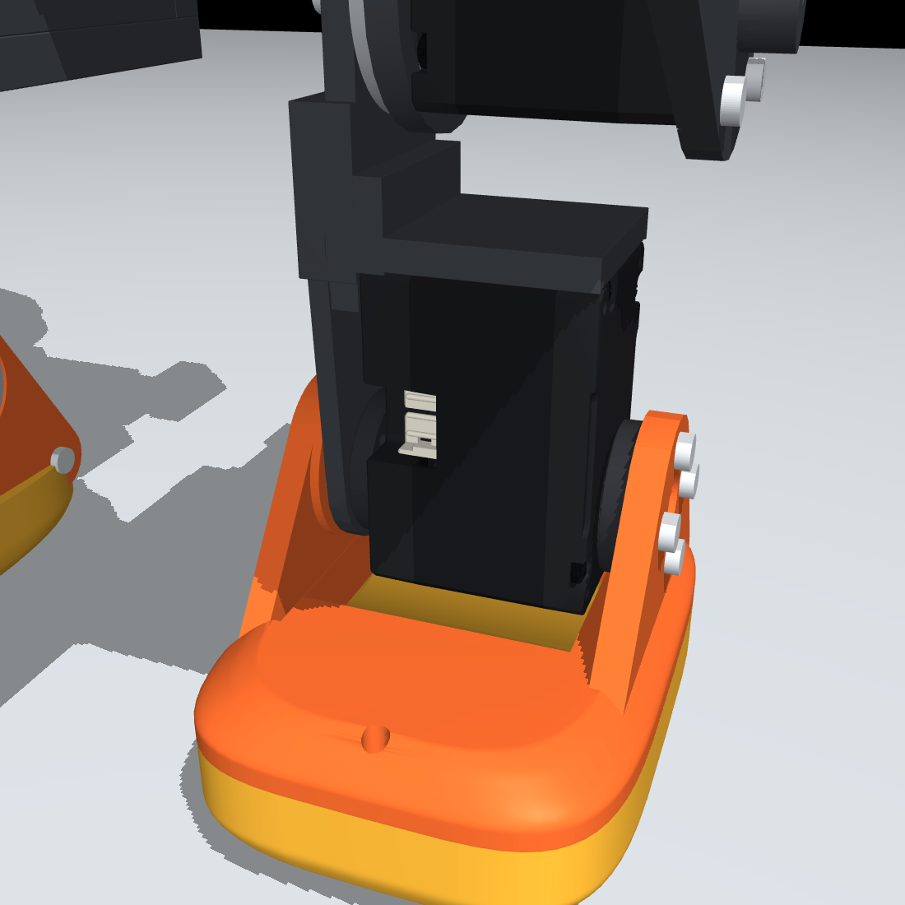
docs/images/fusion/hd1910/offline/ankle_rear.png
