meetsitaram/duck-droids/docs/images/fusion/hd1910/offline/back.png

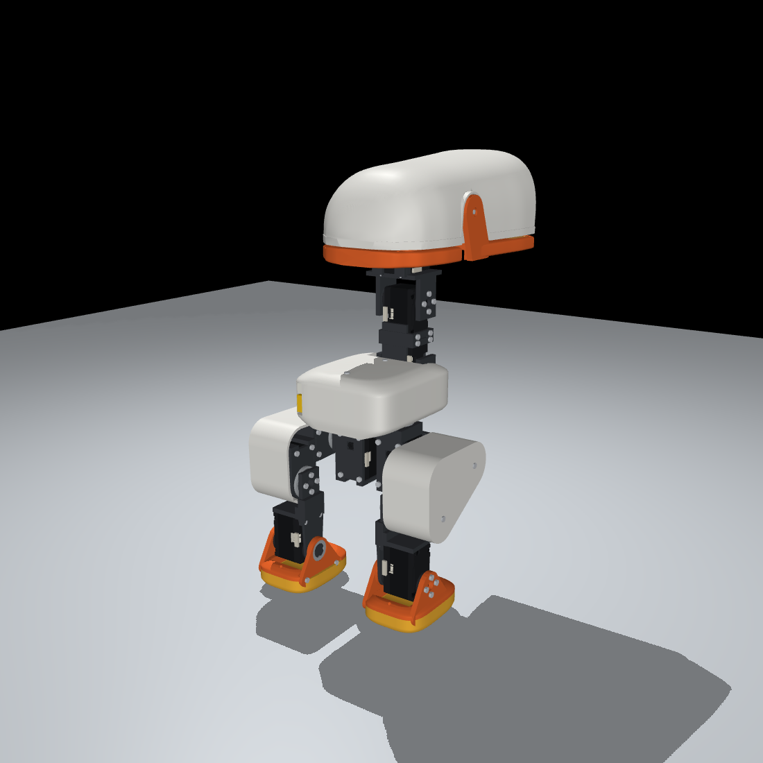
docs/images/fusion/hd1910/offline/back.png
