meetsitaram/duck-droids/docs/images/fusion/hd1910/offline/body_open.png

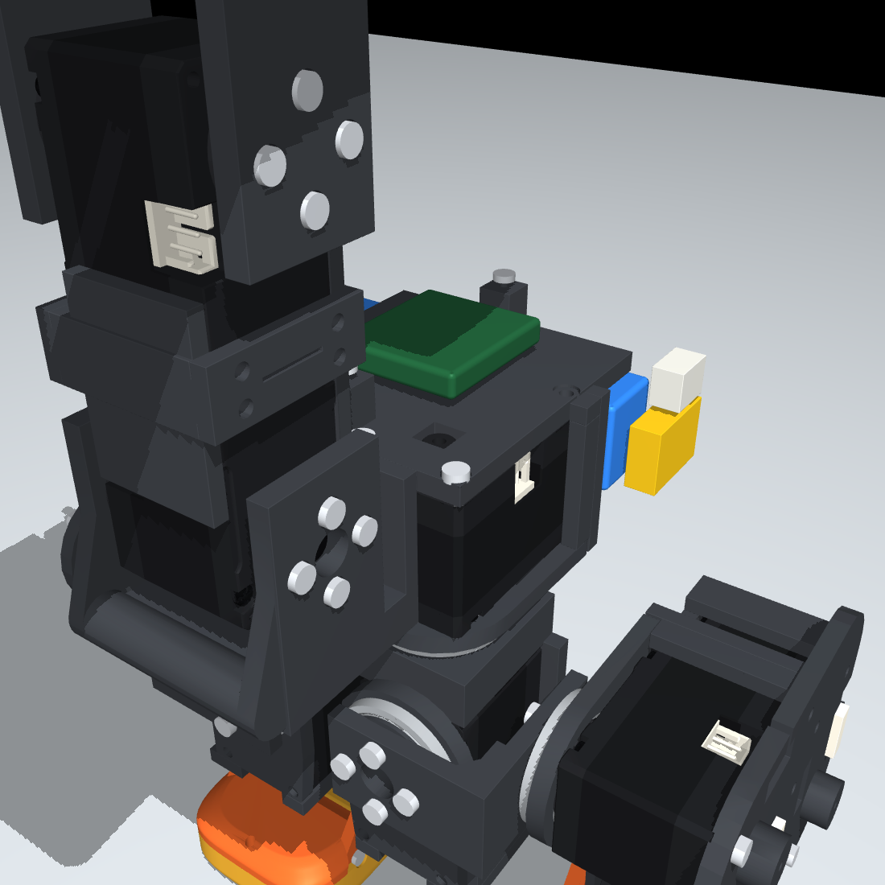
docs/images/fusion/hd1910/offline/body_open.png
