meetsitaram/duck-droids/docs/images/fusion/hd1910/offline/head_open_rear.png

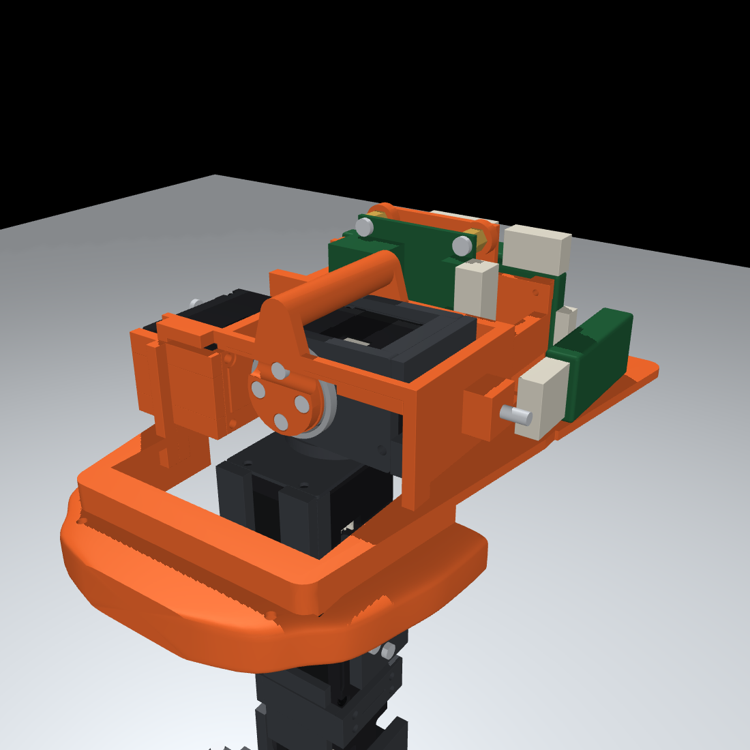
docs/images/fusion/hd1910/offline/head_open_rear.png
