meetsitaram/duck-droids/docs/images/fusion/hd1910/offline/head_open_top.png

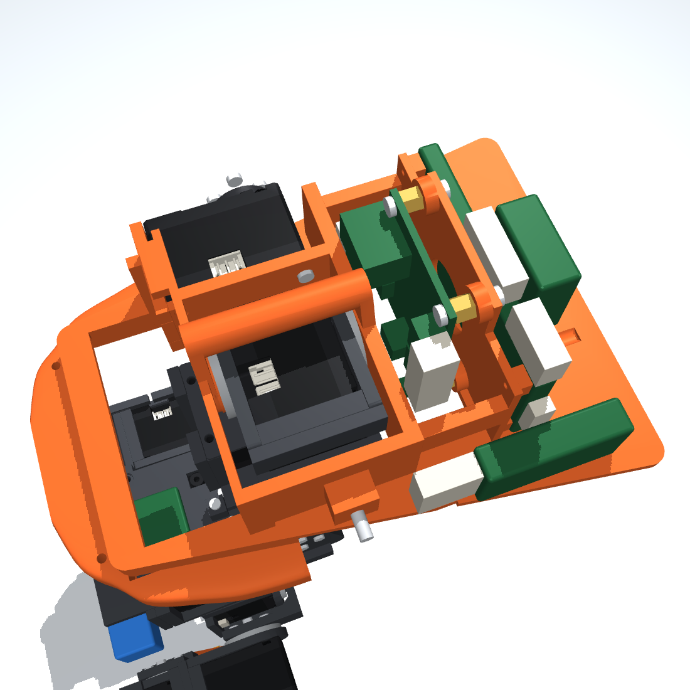
docs/images/fusion/hd1910/offline/head_open_top.png
