meetsitaram/duck-droids/docs/images/fusion/hd1910/offline/hip.png

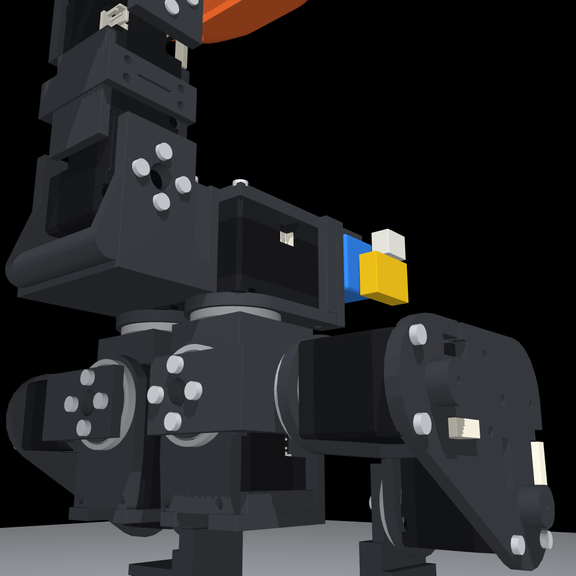
docs/images/fusion/hd1910/offline/hip.png
