meetsitaram/duck-droids/docs/images/fusion/hd1910/offline/leg_open_inner.png

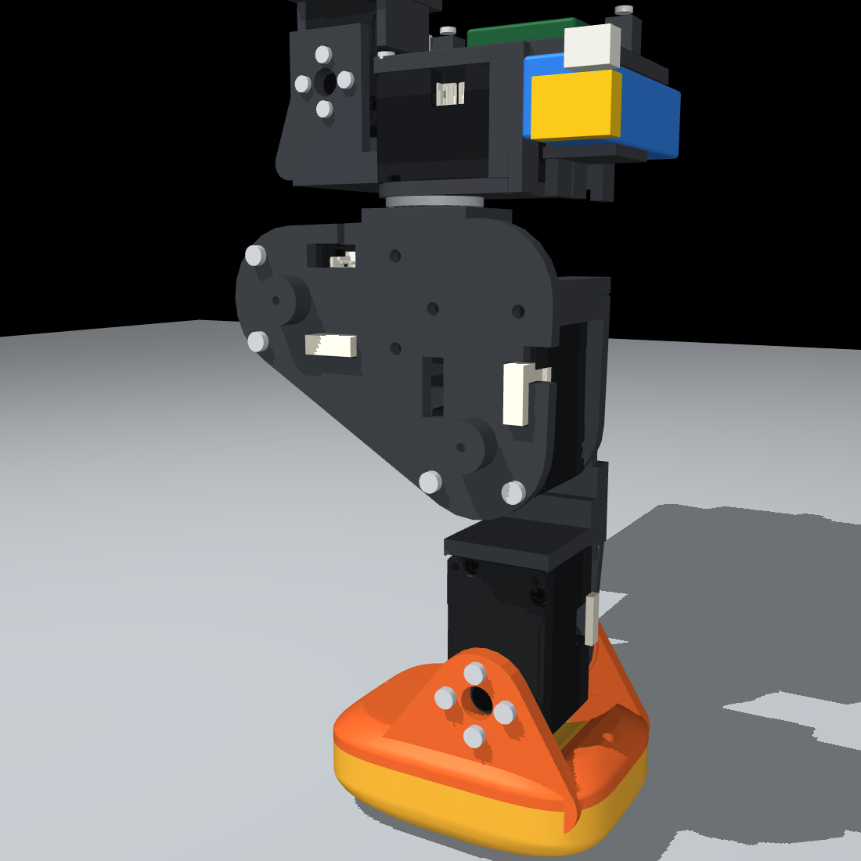
docs/images/fusion/hd1910/offline/leg_open_inner.png
