meetsitaram/duck-droids/docs/images/fusion/hd1910/offline/leg_outer.png

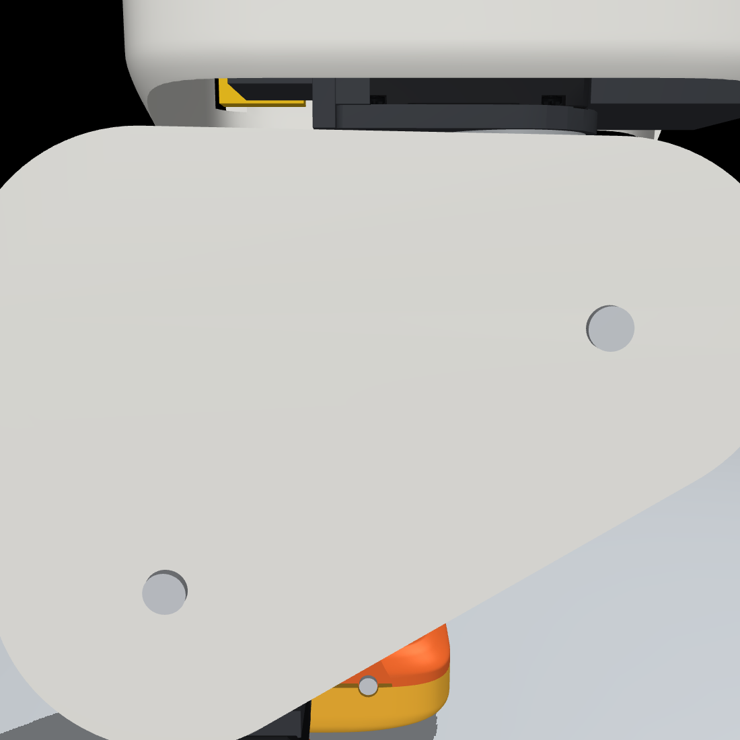
docs/images/fusion/hd1910/offline/leg_outer.png
