meetsitaram/duck-droids/docs/images/fusion/hd1910/offline/neck.png

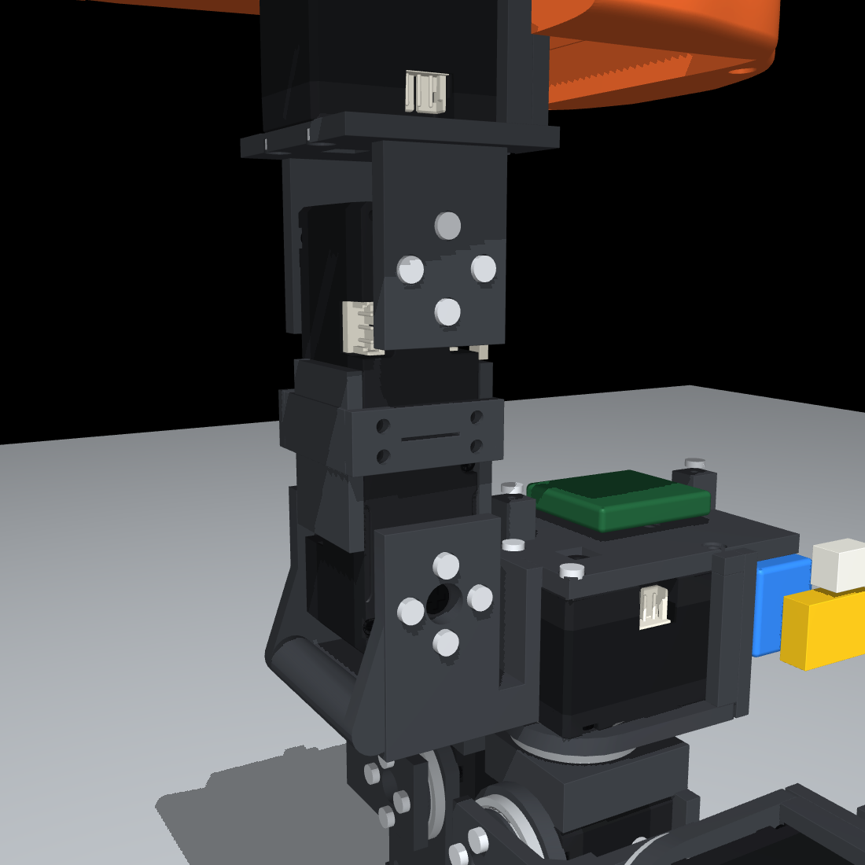
docs/images/fusion/hd1910/offline/neck.png
