meetsitaram/duck-droids/docs/images/fusion/hd1910/offline/neck_rear.png

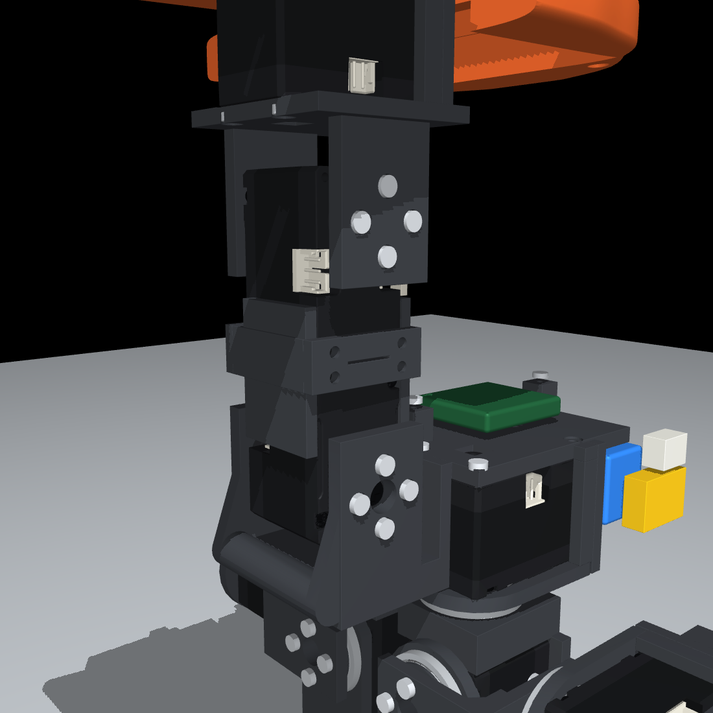
docs/images/fusion/hd1910/offline/neck_rear.png
