meetsitaram/duck-droids/docs/images/fusion/hd1910/offline/side.png

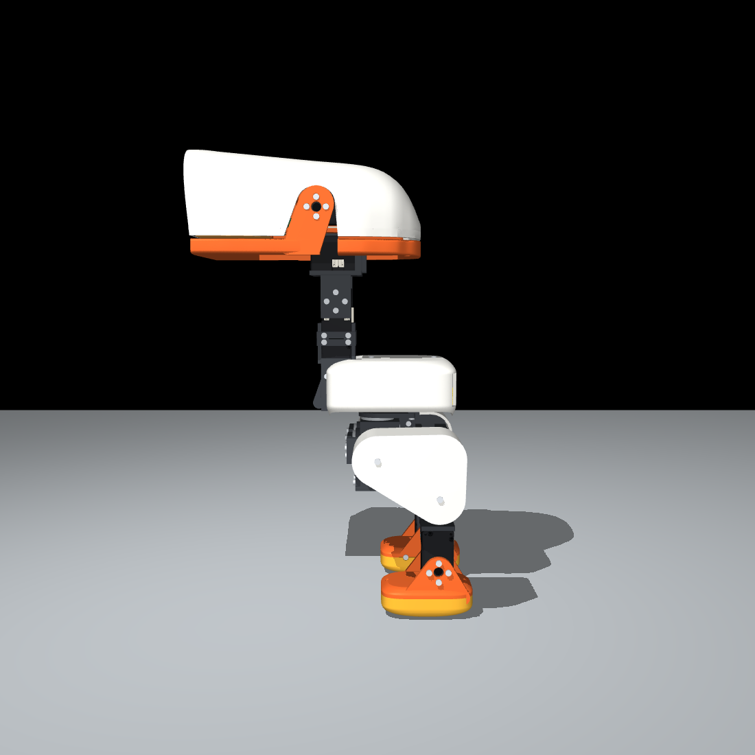
docs/images/fusion/hd1910/offline/side.png
