meetsitaram/duck-droids/docs/images/fusion/hd1910/offline/top.png

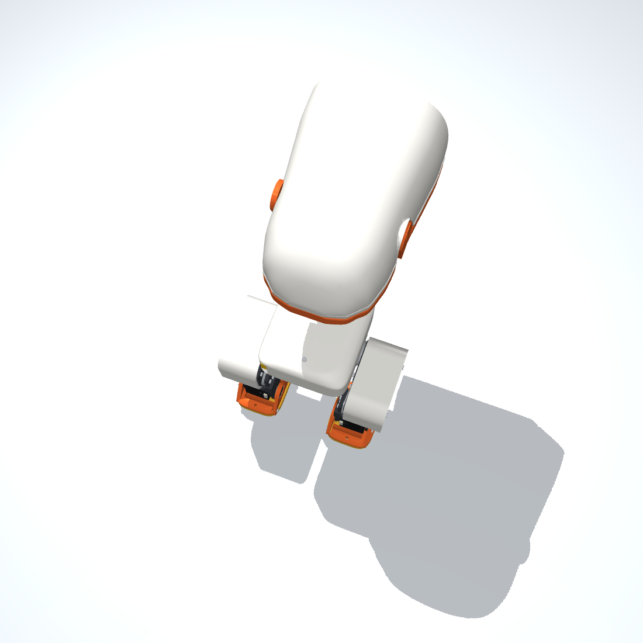
docs/images/fusion/hd1910/offline/top.png
