meetsitaram/duck-droids/docs/images/fusion/hd1910/offline/under.png

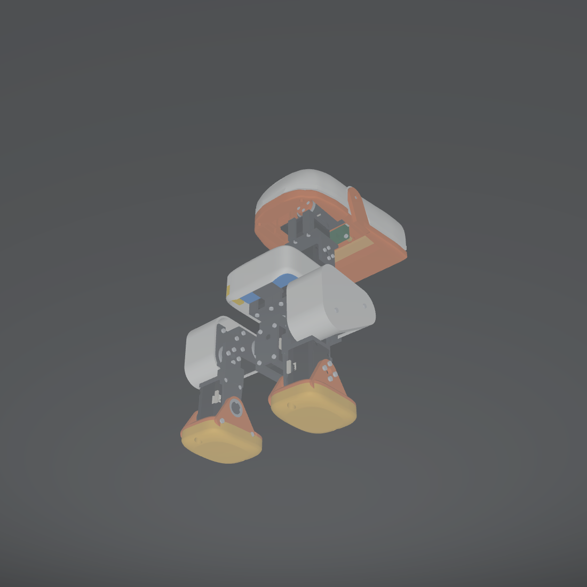
docs/images/fusion/hd1910/offline/under.png
