meetsitaram/duck-droids/docs/images/fusion/hd1910/top.png

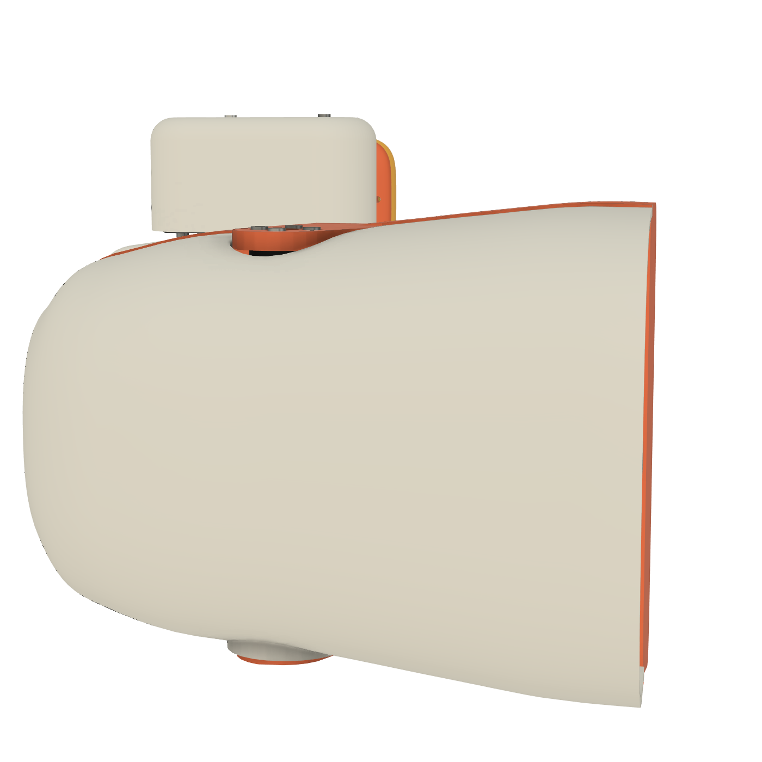
docs/images/fusion/hd1910/top.png
