meetsitaram/duck-droids/reports/dynamixel/pov_frames.png

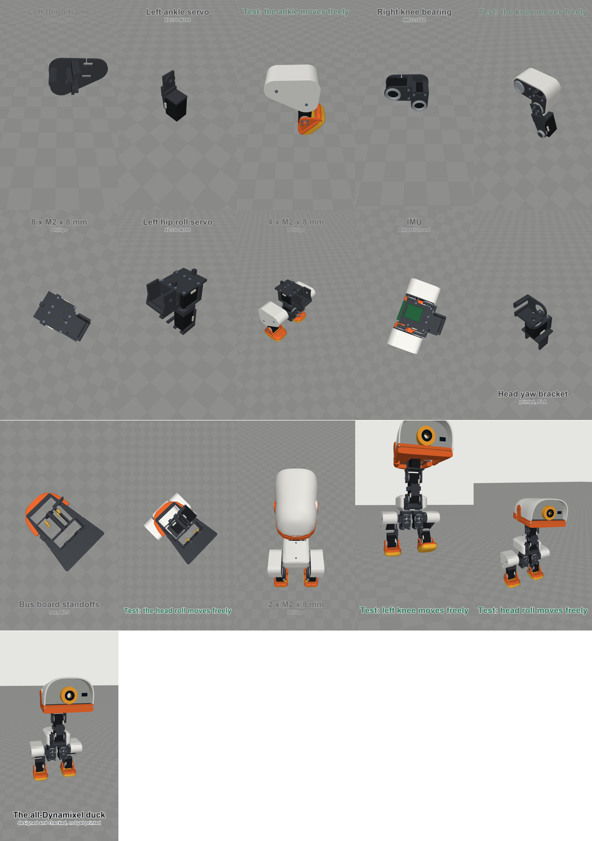
reports/dynamixel/pov_frames.png
