meetsitaram/duck-droids/reports/poses.png

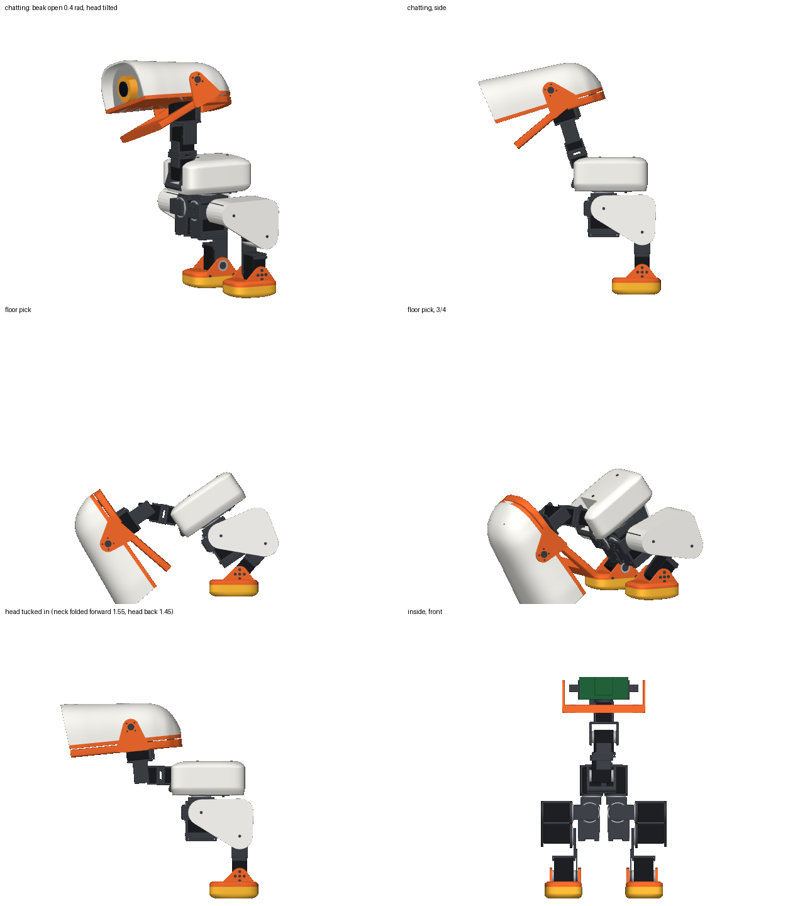
reports/poses.png
