meetsitaram/duck-droids/BOM.md

# Hybrid duck: bill of materials

| | |
|---|---|
| Product | Hybrid duck, biped, 15 servos: 10 Feetech STS3215 in the legs, 5 ROBOTIS Dynamixel at the neck and head |
| Height, mass | 0.318 m, 1.65 kg as modelled |
| Build quantity | Quantities are for 1 robot |
| Fabricated parts | 43 printed parts, 579 g PLA and 76 g TPU 95A |
| Status | Prototype: no unit built, no part test printed. Its walking policies were trained with foot switches, which this version doesn't have: it needs retraining before it walks |
| Prices | USD, as listed 2026-11-02 to 2026-11-06, before tax and shipping. Confirm before ordering |
| Related | [Print files](prints/README.md), [wiring](docs/WIRING.md), [assembly](docs/ASSEMBLY.md) |

Generated by `tools/make_docs.py` from the spec. Quantities match the model.

## Cost summary

| Group | Required parts, priced |
|---|---|
| Actuators | $421.33 |
| Bearings, horns and idlers | $83.77 |
| Fasteners | $47.23 |
| Electronics | $96.16 |
| Power and wiring | $54.87 |
| Consumables | $12.00 |
| Support equipment (not in the robot) | $9.49 |
| **Total of quoted lines** | **$724.85** |

5 required lines have no quote yet and are not in the total, nor is filament. Optional parts add $16.99 on the quoted lines.

## Purchased parts

Every line is required unless it starts with **OPTIONAL**. Optional lines show their quantities in brackets and are not in the total.

### Actuators

| Item | Part | Maker / part number | Specification | Qty per robot | Order unit | Order qty | Unit price | Line price | Source |
|---|---|---|---|---|---|---|---|---|---|
| 1 | Smart servo: hip roll, hip pitch, knee, ankle | Feetech STS3215-C044 (also sold as ST3215 C044) | 7.4 V, 1:191, TTL bus, 2 sockets. Listings give 16 and 27.4 kg.cm stall: see the notes | 8 | each | 8 | $20.00 | $160.00 | [Seeed](https://www.seeedstudio.com/Feetech-ST-3215-C044-Heavy-Duty-Servo-7-4V-1-191-Gear-Reduction-p-6460.html): in stock on 2026-11-05. Second sources [Amazon, MengJie](https://www.amazon.com/dp/B0H3THGR55), 7 left at $23.98 on 2026-11-02; [Amazon, RCmall, the 1-191 option](https://www.amazon.com/dp/B0G2L15ZG8), 6 left at $25.99<br>[Search Amazon](https://www.amazon.com/s?k=Feetech+STS3215+C044+1:191) |
| 2 | Smart servo: hip yaw | Feetech STS3215-C046 | 7.4 V, 1:147, TTL bus, 2 sockets. **Numbers scaled from the C001, not measured** | 2 | each | 2 | $23.99 | $47.98 | [OpenELAB](https://openelab.com/products/feetech-sts3215-c046-servo). Second source [Amazon, MengJie](https://www.amazon.com/dp/B0H3TNG1Z6), 6 left at $23.98 on 2026-11-02<br>[Search Amazon](https://www.amazon.com/s?k=Feetech+STS3215+C046+1:147) |
| 3 | Smart servo: neck | ROBOTIS XC330-M288-T | 0.93 N m stall at 5 V, 288.4:1, 23 g | 1 | each | 1 | $103.39 | $103.39 | [RobotShop](https://www.robotshop.com/products/robotis-dynamixel-xc330-m288-t-smart-servo-actuator): on backorder on 2026-11-05. [ROBOTIS US](https://robotis.us/products/dynamixel-xc330-m288-t): sold out, no date<br>[Search Amazon](https://www.amazon.com/s?k=Dynamixel+XC330-M288-T) |
| 4 | Smart servo: head pitch, yaw, roll, beak | ROBOTIS XL330-M288-T | 0.52 N m stall and 103 rev/min at 5 V, 288.4:1, 18 g | 4 | each | 4 | $27.49 | $109.96 | [ROBOTIS US](https://robotis.us/products/dynamixel-xl330-m288-t): sold out on 2026-11-05, lead time to end of November. Second source [Seeed](https://www.seeedstudio.com/Servo-Motor-1-5V-103RPM-Brush-mm-p-6783.html) at $31.40, limit 2 per account<br>[Search Amazon](https://www.amazon.com/s?k=Dynamixel+XL330-M288-T) |

### Bearings, horns and idlers

| Item | Part | Maker / part number | Specification | Qty per robot | Order unit | Order qty | Unit price | Line price | Source |
|---|---|---|---|---|---|---|---|---|---|
| 5 | Ball bearing, around each STS3215 horn | 6704ZZ | 20 x 27 x 4 mm | 8 | pack of 10 | 1 | $18.39 | $18.39 | [Amazon, uxcell](https://www.amazon.com/dp/B082PSB7NH)<br>[Search Amazon](https://www.amazon.com/s?k=6704ZZ+bearing+20x27x4mm) |
| 6 | Ball bearing, around the head yaw and roll horns | MR2216ZZ (ET2216ZZ) | 16 x 22 x 4 mm | 3 | pack of 10 | 1 | $42.72 | $42.72 | [Amazon](https://www.amazon.com/dp/B0C5ZCVGNP)<br>[Search Amazon](https://www.amazon.com/s?k=MR2216ZZ+bearing+16x22x4mm) |
| 7 | Ball bearing, shoe inner ear | 6700ZZ | 10 x 15 x 4 mm | 2 | pack of 10 | 1 | $6.79 | $6.79 | [Amazon](https://www.amazon.com/dp/B0FQ4VYXRP)<br>[Search Amazon](https://www.amazon.com/s?k=6700ZZ+bearing+10x15x4mm) |
| 8 | Horn, one on each Dynamixel | ROBOTIS HNX330-N102 | for XL330 and XC330 | 5 | pack of 5 | 1 | $4.60 | $4.60 | [ROBOTIS US](https://robotis.us/hnx330-n102-5pcs): sold out on 2026-11-05, lead time mid-November. ROBOTIS's box list for these servos names no horn<br>[Search Amazon](https://www.amazon.com/s?k=Dynamixel+HNX330-N102+horn) |
| 9 | Idler: neck, head pitch, head roll | ROBOTIS FPX330-H101 | set of 4 | 3 | set of 4 | 1 | $11.27 | $11.27 | [ROBOTIS US](https://robotis.us/fpx330-h101-4pcs-set/)<br>[Search Amazon](https://www.amazon.com/s?k=Dynamixel+FPX330-H101+idler) |

### Fasteners

| Item | Part | Maker / part number | Specification | Qty per robot | Order unit | Order qty | Unit price | Line price | Source |
|---|---|---|---|---|---|---|---|---|---|
| 10 | Screws, self-tapping pan head: M2 x 6, M2 x 8 | generic | 70 x M2 x 6, 52 x M2 x 8. Kit of 800, 100 of each | 122 | kit | 1 | $15.66 | $15.66 | [Amazon](https://www.amazon.com/dp/B0GV338JJK)<br>[Search Amazon](https://www.amazon.com/s?k=M2+self+tapping+pan+head+screw+kit) |
| 11 | Screw, the 2 bus boards, machine thread | generic | M2.5 x 5 mm, pan head, Phillips, black oxide 18-8 stainless, DIN 7985 | 12 | pack of 100 | 1 | $5.59 | $5.59 | [Zoro G816462679](https://www.zoro.com/zoro-select-m25x045-x-5-mm-phillips-pan-machine-screw-black-oxide-stainless-steel-100-pk-31-bpm-25-5/i/G816462679/): $5.59 by a search result; the page refuses automated reading, so confirm it<br>[Search Amazon](https://www.amazon.com/s?k=M2.5+x+5mm+pan+head+machine+screw+black+oxide) |
| 12 | **OPTIONAL:** Spare hex standoffs, bus board: 4 come with each Waveshare board | uxcell | brass, M2.5, female-female, 8 mm long, 5 mm across flats | - | pack of 50 | (1) | - | - | Amazon<br>[Search Amazon](https://www.amazon.com/s?k=uxcell+M2.5+x+8mm+female+female+hex+brass+standoff) |
| 13 | Screws, socket cap: 8 x M3 x 8, 33 x M3 x 10, 4 x M3 x 12 | generic | kit of 610 with nuts and washers. Its count per length is not listed: count them on arrival | 45 | kit | 1 | $19.99 | $19.99 | [Amazon](https://www.amazon.com/dp/B09NR8X2LV)<br>[Search Amazon](https://www.amazon.com/s?k=M3+socket+cap+screw+kit) |
| 14 | Screw, flat head socket: ankle rear horn, flush under the bearing | generic | M3 x 6 mm. Head 6 mm wide, 1.7 mm high | 8 | pack of 100 | 1 | $5.99 | $5.99 | [Amazon](https://www.amazon.com/dp/B01HBN0U76)<br>[Search Amazon](https://www.amazon.com/s?k=M3+x+6mm+flat+head+socket+screw) |
| 15 | Washer, far hinge tab to hood | uxcell | M3, 6 mm outside, 0.5 mm thick, stainless | 1 | pack of 100 | 1 | - | - | [Amazon](https://www.amazon.com/dp/B015A39NCC)<br>[Search Amazon](https://www.amazon.com/s?k=uxcell+M3+x+6mm+x+0.5mm+flat+washer) |

### Electronics

| Item | Part | Maker / part number | Specification | Qty per robot | Order unit | Order qty | Unit price | Line price | Source |
|---|---|---|---|---|---|---|---|---|---|
| 16 | Computer | Raspberry Pi Zero 2 W | without header | 1 | each | 1 | $17.25 | $17.25 | [PiShop](https://www.pishop.us/product/raspberry-pi-zero-2-w/): out of stock on 2026-11-03<br>[Search Amazon](https://www.amazon.com/s?k=Raspberry+Pi+Zero+2+W) |
| 17 | microSD card | SanDisk Ultra | 32 GB microSDHC, A1, Class 10, UHS-I | 1 | each | 1 | $21.49 | $21.49 | [Amazon](https://www.amazon.com/dp/B08L5HMJVW)<br>[Search Amazon](https://www.amazon.com/s?k=SanDisk+32GB+Ultra+microSDHC+A1) |
| 18 | Servo bus board, one per bus | Waveshare Bus Servo Adapter (A), SKU 25514 | USB-C and UART, 2 servo sockets, also sold as Serial Bus Servo Driver Board | 2 | each | 2 | $4.99 | $9.98 | [Waveshare](https://www.waveshare.com/bus-servo-adapter-a.htm), before its shipping. [Amazon](https://www.amazon.com/dp/B0CTMM4LWK). Second source [Abra](https://abra-electronics.com/electromechanical/motors/motor-controllers/wave-25514-serial-bus-servo-driver-board.html)<br>[Search Amazon](https://www.amazon.com/s?k=Waveshare+Serial+Bus+Servo+Driver+Board) |
| 19 | 5 V regulator, the Pi's | hiBCTR USB buck converter QC3.0 | 6-32 V in, 35 x 17 x 8.5 mm | 1 | pack of 2 | 1 | $7.97 | $7.97 | Amazon<br>[Search Amazon](https://www.amazon.com/s?k=hiBCTR+USB+buck+converter+QC3.0) |
| 20 | 5 V regulator, the Dynamixels' | FEICHAO UBEC | 8 A, 5 V or 6 V by jumper, 39 x 21 x 6 mm | 1 | each | 1 | $18.98 | $18.98 | [Amazon](https://www.amazon.com/dp/B07DD9L6P6)<br>[Search Amazon](https://www.amazon.com/s?k=FEICHAO+UBEC+5V+8A) |
| 21 | IMU | BNO085 module, EC Buying | modelled at 25.6 x 22.7 x 4.6 mm; I2C | 1 | each | 1 | $20.49 | $20.49 | [Amazon](https://www.amazon.com/dp/B0CDGZMLPP). Second source [Adafruit 4754](https://www.adafruit.com/product/4754) at $29.50, in stock on 2026-11-03<br>[Search Amazon](https://www.amazon.com/s?k=BNO085+IMU+module) |
| 22 | **OPTIONAL:** Camera | Arducam 8 MP IMX219 | board modelled at 24 x 24 mm | (1) | each | (1) | $16.99 | $16.99 | [Amazon](https://www.amazon.com/dp/B09V576TFN)<br>[Search Amazon](https://www.amazon.com/s?k=Arducam+8MP+IMX219+camera+module) |
| 23 | **OPTIONAL:** Camera ribbon, if the camera lacks one | GODIYMODULES | Pi Zero 22-pin to 15-pin, 15 cm | (1) | pack of 2 | (1) | - | - | [Amazon](https://www.amazon.com/dp/B0F9WJ62LV)<br>[Search Amazon](https://www.amazon.com/s?k=Raspberry+Pi+Zero+camera+cable+22+pin+to+15+pin+15cm) |

### Power and wiring

| Item | Part | Maker / part number | Specification | Qty per robot | Order unit | Order qty | Unit price | Line price | Source |
|---|---|---|---|---|---|---|---|---|---|
| 24 | Battery | Zeee 2S LiPo, 50C | 850 mAh, 54 x 30 x 15 mm, 52 g. Comes on a small JST plug, too small for 10 servos: its power lead is cut and an XT30 soldered on | 1 | pack of 2 | 1 | $23.39 | $23.39 | [Amazon, Zeee](https://www.amazon.com/dp/B0DGQ6DRLS)<br>[Search Amazon](https://www.amazon.com/s?k=Zeee+2S+850mAh+50C+LiPo) |
| 25 | Battery connector | Nuofany XT30 pigtail | 100 mm, 16 AWG | 1 | 5 pairs | 1 | $9.99 | $9.99 | [Amazon](https://www.amazon.com/dp/B0B4H4GKQL)<br>[Search Amazon](https://www.amazon.com/s?k=XT30+pigtail+16+AWG+100mm) |
| 26 | Power wire, red and black: 2S and 5 V up the neck | BNTECHGO silicone wire | 20 AWG, 2 pairs of about 400 mm | 1 | 10 ft each | 1 | - | - | [Amazon](https://www.amazon.com/dp/B01M12PSJM)<br>[Search Amazon](https://www.amazon.com/s?k=20+AWG+silicone+wire+red+black) |
| 27 | Signal wire: UART and IMU, the Pi's regulator | Fermerry silicone wire | 28 AWG stranded, 7 + 2 wires | 1 | 6 colours, 5 ft each | 1 | - | - | [Amazon](https://www.amazon.com/dp/B089CR4SDM)<br>[Search Amazon](https://www.amazon.com/s?k=28+AWG+silicone+stranded+wire) |
| 28 | Feetech lead: Feetech board to the legs' splice, up the neck | Waveshare 5264-3PIN Servo Cable | 300 mm, for ST, SC and CF servos. One plug is kept, its V wire taken out, and it is extended in item 27 to about 330 mm | 1 | pack of 6 | 1 | - | - | [Waveshare](https://www.waveshare.com/sr-cable-5264-3pin.htm): price not read. The 2 hip yaw leads to the splice are from the servos' own boxes<br>[Search Amazon](https://www.amazon.com/s?k=5264+3+pin+2.54mm+servo+cable+female+female+300mm) |
| 29 | Regulator to Pi power | LY tech flat ribbon USB | right-angle USB-A to right-angle micro USB, 10 cm | 1 | each | 1 | $13.50 | $13.50 | Amazon<br>[Search Amazon](https://www.amazon.com/s?k=LY+tech+flat+ribbon+micro+USB+90+degree) |
| 30 | Pi to Dynamixel board | Veeloon | right-angle micro USB OTG to right-angle USB-C, 0.6 ft | 1 | pack of 2 | 1 | $7.99 | $7.99 | [Amazon](https://www.amazon.com/dp/B0DKBQ7TD3)<br>[Search Amazon](https://www.amazon.com/s?k=micro+USB+to+USB+C+OTG+cable+90+degree) |

### Consumables

| Item | Part | Maker / part number | Specification | Qty per robot | Order unit | Order qty | Unit price | Line price | Source |
|---|---|---|---|---|---|---|---|---|---|
| 31 | Foam tape, hook-and-loop strap, small cable ties | generic |  | 1 | lot | 1 | $12.00 | $12.00 | any hardware shop; price estimated<br>[Search Amazon](https://www.amazon.com/s?k=foam+tape+hook+and+loop+strap+cable+ties) |
| 32 | Solder, heat-shrink tube, CA glue | generic |  | 1 | lot | 1 | - | - | any hardware shop<br>[Search Amazon](https://www.amazon.com/s?k=solder+heat+shrink+CA+glue) |

### Support equipment (not in the robot)

| Item | Part | Maker / part number | Specification | Qty per robot | Order unit | Order qty | Unit price | Line price | Source |
|---|---|---|---|---|---|---|---|---|---|
| 33 | Charger | as linked | 2S LiPo, to 8.4 V, must match the balance plug | 1 | each | 1 | $9.49 | $9.49 | [Amazon](https://www.amazon.com/dp/B0FDKX4V38)<br>[Search Amazon](https://www.amazon.com/s?k=2S+LiPo+balance+charger+JST-XH) |

## Fabricated parts

All 3D printed. Files are in [prints/](prints/README.md), already oriented for printing, in millimetres. Mass is each piece. The hood has an orange band, painted or split in the slicer.

| Item | Part | File | Material | Colour | Hex | Mass each | Qty per robot |
|---|---|---|---|---|---|---|---|
| P1 | Hip yaw lid, left and right | `L_hip_yaw_lid.stl`, `R_hip_yaw_lid.stl` | PLA | Dark grey | #3A3D42 | 3.6 g | 2 |
| P2 | Yaw bracket, left and right | `L_yaw_bracket.stl`, `R_yaw_bracket.stl` | PLA | Dark grey | #3A3D42 | 20.1 g | 2 |
| P3 | Hip roll lid, left and right | `L_hip_roll_lid.stl`, `R_hip_roll_lid.stl` | PLA | Dark grey | #3A3D42 | 3.0 g | 2 |
| P4 | Roll bracket, left and right | `L_roll_bracket.stl`, `R_roll_bracket.stl` | PLA | Dark grey | #3A3D42 | 6.9 g | 2 |
| P5 | Thigh frame, left and right | `L_thigh_frame.stl`, `R_thigh_frame.stl` | PLA | Dark grey | #3A3D42 | 22.3 g | 2 |
| P6 | Hip pitch lid, left and right | `L_hip_pitch_lid.stl`, `R_hip_pitch_lid.stl` | PLA | Dark grey | #3A3D42 | 3.6 g | 2 |
| P7 | Knee lid, left and right | `L_knee_lid.stl`, `R_knee_lid.stl` | PLA | Dark grey | #3A3D42 | 3.5 g | 2 |
| P8 | Thigh cover, left and right | `L_thigh_cover.stl`, `R_thigh_cover.stl` | PLA | White | #ECEBE6 | 31.4 g | 2 |
| P9 | Shin, left and right | `L_shin.stl`, `R_shin.stl` | PLA | Dark grey | #3A3D42 | 15.4 g | 2 |
| P10 | Shoe, left and right | `L_shoe.stl`, `R_shoe.stl` | PLA | Orange | #E8642A | 19.2 g | 2 |
| P11 | Sole, left and right | `L_sole.stl`, `R_sole.stl` | TPU 95A | Yellow | #F2B233 | 28.2 g | 2 |
| P12 | Inner ear, left and right | `L_inner_ear.stl`, `R_inner_ear.stl` | PLA | Orange | #E8642A | 3.1 g | 2 |
| P13 | Chassis | `chassis.stl` | PLA | Dark grey | #3A3D42 | 45.8 g | 1 |
| P14 | Body shell | `body_shell.stl` | PLA | White | #ECEBE6 | 39.2 g | 1 |
| P15 | Neck column | `neck_column.stl` | PLA | Dark grey | #3A3D42 | 5.3 g | 1 |
| P16 | Neck lid | `neck_lid.stl` | PLA | Dark grey | #3A3D42 | 0.3 g | 1 |
| P17 | Head pitch lid | `head_pitch_lid.stl` | PLA | Dark grey | #3A3D42 | 0.3 g | 1 |
| P18 | Head fork | `head_fork.stl` | PLA | Dark grey | #3A3D42 | 11.1 g | 1 |
| P19 | Head yaw sheet | `head_yaw_sheet.stl` | PLA | Dark grey | #3A3D42 | 1.0 g | 1 |
| P20 | Head yaw bracket | `head_yaw_bracket.stl` | PLA | Dark grey | #3A3D42 | 6.9 g | 1 |
| P21 | Head roll lid | `head_roll_lid.stl` | PLA | Dark grey | #3A3D42 | 1.8 g | 1 |
| P22 | Head roll spacer | `head_roll_spacer.stl` | PLA | Dark grey | #3A3D42 | 0.4 g | 1 |
| P23 | Head roll rear spacer | `head_roll_rear_spacer.stl` | PLA | Dark grey | #3A3D42 | 0.4 g | 1 |
| P24 | Head frame | `head_frame.stl` | PLA | Orange | #E8642A | 74.7 g | 1 |
| P25 | Hood | `hood.stl` | PLA | White | #ECEBE6 | 63.6 g | 1 |
| P26 | Jaw | `jaw.stl` | PLA | Orange | #E8642A | 40.1 g | 1 |
| P27 | Jaw soft insert | `jaw_soft_insert.stl` | TPU 95A | Pale orange | #F7AE55 | 9.9 g | 1 |
| P28 | Mouth roof | `mouth_roof.stl` | TPU 95A | Pale orange | #F7AE55 | 9.3 g | 1 |
| P29 | Face | `face.stl` | PLA | Mid grey | #9A9C98 | 10.9 g | 1 |
| P30 | Eye ring | `eye_ring.stl` | PLA | Amber | #F0A030 | 10.1 g | 1 |
| P31 | Eye iris | `eye_iris.stl` | PLA | Black | #0A1420 | 2.6 g | 1 |

### Filament

| Colour | Hex | Material | Model mass | With 15 % for supports and scrap |
|---|---|---|---|---|
| Dark grey | #3A3D42 | PLA | 231 g | 265 g |
| White | #ECEBE6 | PLA | 166 g | 190 g |
| Orange | #E8642A | PLA | 159 g | 183 g |
| Mid grey | #9A9C98 | PLA | 11 g | 13 g |
| Amber | #F0A030 | PLA | 10 g | 12 g |
| Black | #0A1420 | PLA | 3 g | 3 g |
| Yellow | #F2B233 | TPU 95A | 56 g | 65 g |
| Pale orange | #F7AE55 | TPU 95A | 19 g | 22 g |

Listings read on 2026-11-02: [ELEGOO PLA+](https://www.amazon.com/dp/B0D41ZDC47), $13.99 per kg, and [OVERTURE TPU 95A](https://www.amazon.com/dp/B0BGMP1MZ7), $23.99 per kg.

## Build notes that affect ordering

- **Items 1, 2, 24:** a full 2S pack is 8.4 V. Most sellers rate the 7.4 V STS3215 to 7.4 V; one gives 5-8.4 V. Try one servo on a charged pack first.
- **Item 1:** listings disagree on its torque: 16 kg.cm (1.57 N m) in one title, 27.4 (2.69 N m) on others, the number the walking training uses. Feetech publishes neither that we could find. Measure one before ordering 8.
- **Items 1, 2:** listings give each servo 2 horns, 18 screws and a lead, about 15 cm, on a 5264 plug. Sellers differ: check the first box. The ankle's rear horn is one of those 2.
- **Items 3, 4:** each comes with a 180 mm cable, 6 M2 x 6 and 10 M2 x 8 screws, per ROBOTIS. Seeed sells the XL330 as a numbered Reachy Mini part, with an arm and a preset ID: set each ID again.
- **Item 8:** ROBOTIS lists no horn in these servos' boxes, though it gives the screws for one. Check its size against the bore of item 6 before printing.
- **Item 18:** Feetech board: both jumpers at A, for UART. Dynamixel board: both at B, for USB. Silkscreen and shop page say DC 9-12.6 V; Waveshare's product page also says 5 V or 7.4 V can go in, and these boards get 7.4-8.4 V and 5 V: bench test one of each before fitting. The Dynamixel plugs may need its sockets eased.
- **Item 19:** feeds the Pi's PWR port only. It can output up to 12 V if a device asks for fast charging, so measure about 5 V before connecting.
- **Item 20:** set its jumper to 5 V **before** connecting anything: 6 V is at the Dynamixels' limit. Listing's price read as each on 2026-11-02.
- **Item 24:** a small plug on 10 servos that can pull 27 A between them won't do, hence item 25. Packs sold with an XT30 found: GNB 850 mAh 2S at 56 x 31 x 16 mm, CNHL 850 mAh 2S at 60 x 30 x 17 mm: neither fits the slot as modelled.
- **Item 29:** check the Pi's voltage under load, as the ribbon's wires are thin.
- **Item 28:** carries data and ground only, so the walking current stays out of the neck. Each STS3215's own lead covers every other link: [lengths](reports/wire_routes.md).

## Open before ordering

- **Servo supply:** items 3, 4, 8 are sold out at ROBOTIS US on 2026-11-05, and item 3 is on backorder at RobotShop. These decide when it can be built.
- **Item 28:** the listing doesn't say what its ends are: confirm they plug into both the servo and the board, and its price.
- **Measure on the first parts:** a horn in the bores of items 5, 6; the Waveshare board's standoffs against their printed hex sockets, 5 mm across flats (item 18); the camera board (item 22); servo lead lengths (item 28).
- **Walking:** the policies in this repo were trained with foot switches. This duck has none: retrain before trusting any walk.
- **Amazon listings** (items 1, 2, 5, 6, 7, 10, 13, 14, 15, 17, 18, 20, 21, 24, 25, 26, 27, 30, 22, 33, and those found by search) are as last read, or as read for the all-Dynamixel duck: confirm each page before ordering.
- **Not in this design:** power switch (the XT30 is the disconnect), speaker, microphone.
