meetsitaram/duck-droids/docs/dynamixel/BOM.md

# All-Dynamixel duck: bill of materials

> **This is the parts list for the all-Dynamixel duck only.** Each duck has its own parts, prints and BOM, and they don't mix. Other ducks: [HD-1910](../hd1910/BOM.md) · [all-Feetech](../feetech/BOM.md) · [hybrid](../hybrid/BOM.md) · [hobby-servo](../hobby/BOM.md) · [nano](../nano/BOM.md) · [big](../big/BOM.md). <!-- variant banner -->

| | |
|---|---|
| Product | All-Dynamixel duck, biped, 15 servos |
| Height, mass | 0.295 m, 0.96 kg as modelled |
| Build quantity | Quantities are for 1 robot |
| Fabricated parts | 39 printed parts, 418 g PLA and 52 g TPU 95A |
| Status | Prototype: no unit built, no part test printed |
| Prices | USD, as listed 2026-11-02 to 2026-11-06, before tax and shipping. Confirm before ordering |
| Related | [Print files](../../prints/dynamixel/README.md), [wiring](WIRING.md), [assembly](ASSEMBLY.md) |

Generated by `tools/make_docs.py` from the spec. Quantities match the model.

## Cost summary

| Group | Required parts, priced |
|---|---|
| Actuators | $412.35 |
| Bearings and idlers | $41.41 |
| Fasteners | $25.58 |
| Electronics | $63.42 |
| Power and wiring | $36.38 |
| Consumables | $12.00 |
| Support equipment (not in the robot) | - |
| **Total of quoted lines** | **$591.14** |

10 required lines have no quote yet and are not in the total, nor is filament. Optional parts add $16.99 on the quoted lines.

## Purchased parts

Every line is required unless it starts with **OPTIONAL**. Optional lines show their quantities in brackets and are not in the total.

### Actuators

| Item | Part | Maker / part number | Specification | Qty per robot | Order unit | Order qty | Unit price | Line price | Source |
|---|---|---|---|---|---|---|---|---|---|
| 1 | Smart servo | ROBOTIS XL330-M288-T | 0.52 N m stall and 103 rev/min at 5 V, 288.4:1, 18 g, model number 1200 | 15 | each | 15 | $27.49 | $412.35 | [ROBOTIS US](https://robotis.us/products/dynamixel-xl330-m288-t): sold out, lead time to end of November. Second source [Seeed](https://www.seeedstudio.com/Servo-Motor-1-5V-103RPM-Brush-mm-p-6783.html) at $31.40, limit 2 per account<br>[Search Amazon](https://www.amazon.com/s?k=Dynamixel+XL330-M288-T) |
| 2 | **OPTIONAL:** Jaw servo, softer alternate | ROBOTIS XL330-M077-T | 0.215 N m stall and 383 rev/min at 5 V, 77.5:1, 18 g, model number 1190. Same pocket, horn and screws. Replaces 1 of the M288s | (1) | each | (1) | - | - | ROBOTIS<br>[Search Amazon](https://www.amazon.com/s?k=Dynamixel+XL330-M077-T) |

### Bearings and idlers

| Item | Part | Maker / part number | Specification | Qty per robot | Order unit | Order qty | Unit price | Line price | Source |
|---|---|---|---|---|---|---|---|---|---|
| 3 | Ball bearing, around each horn | uxcell 6703ZZ | 17 x 23 x 4 mm, chrome steel, double shielded. Replaces the 16 x 22 x 4 mm MR2216ZZ, out of stock until the end of the month. Its bore is 1 mm over the horn, so its inner race sits on the printed boss alone: check the fit on the first joint | 9 | pack of 5 | 3 | $6.29 | $18.87 | [Amazon](https://www.amazon.com/dp/B082PSB4DZ)<br>[Search Amazon](https://www.amazon.com/s?k=6703ZZ+bearing+17x23x4mm) |
| 4 | Idler: neck, head pitch, head roll, both ankles | ROBOTIS FPX330-H101 | set of 4 | 5 | set of 4 | 2 | $11.27 | $22.54 | [ROBOTIS US](https://robotis.us/fpx330-h101-4pcs-set/)<br>[Search Amazon](https://www.amazon.com/s?k=Dynamixel+FPX330-H101+idler) |

### Fasteners

| Item | Part | Maker / part number | Specification | Qty per robot | Order unit | Order qty | Unit price | Line price | Source |
|---|---|---|---|---|---|---|---|---|---|
| 5 | Screw, servo mounting | generic | M2 x 6 mm | 70 | in the servo box | - | - | - | 90 come with the servos<br>[Search Amazon](https://www.amazon.com/s?k=M2+x+6mm+self+tapping+pan+head+screw) |
| 6 | Screw, servo mounting | generic | M2 x 8 mm | 104 | in the servo box | - | - | - | 150 come with the servos<br>[Search Amazon](https://www.amazon.com/s?k=M2+x+8mm+self+tapping+pan+head+screw) |
| 7 | Screw, bus board, machine thread | generic | M2.5 x 5 mm, pan head, Phillips, black oxide 18-8 stainless, DIN 7985 | 8 | pack of 100 | 1 | $5.59 | $5.59 | [Zoro G816462679](https://www.zoro.com/zoro-select-m25x045-x-5-mm-phillips-pan-machine-screw-black-oxide-stainless-steel-100-pk-31-bpm-25-5/i/G816462679/): $5.59 by a search result; the page refuses automated reading, so confirm it<br>[Search Amazon](https://www.amazon.com/s?k=M2.5+x+5mm+pan+head+machine+screw+black+oxide) |
| 8 | **OPTIONAL:** Spare hex standoffs, bus board: 4 come with the Waveshare board | uxcell | brass, M2.5, female-female, 8 mm long, 5 mm across flats | - | pack of 50 | (1) | - | - | Amazon<br>[Search Amazon](https://www.amazon.com/s?k=uxcell+M2.5+x+8mm+female+female+hex+brass+standoff) |
| 9 | Screws, socket cap: 1 x M3 x 10, 4 x M3 x 12 | generic | kit of 610 with nuts and washers | 5 | kit | 1 | $19.99 | $19.99 | [Amazon](https://www.amazon.com/dp/B09NR8X2LV)<br>[Search Amazon](https://www.amazon.com/s?k=M3+socket+cap+screw+kit) |
| 10 | Washer, far hinge tab to hood | uxcell | M3, 6 mm outside, 0.5 mm thick, stainless | 1 | pack of 100 | 1 | - | - | [Amazon](https://www.amazon.com/dp/B015A39NCC)<br>[Search Amazon](https://www.amazon.com/s?k=uxcell+M3+x+6mm+x+0.5mm+flat+washer) |
| 11 | **OPTIONAL:** Spare M2 screws | HELIFOUNER | M2 pan head Phillips machine screws, 304 stainless: 4, 6, 8, 10, 12, 16 and 20 mm, 20 of each, with nuts and washers (560 pieces). Machine thread, not self-tapping: the servo box screws go in the horns and cases | - | kit | (1) | - | - | [Amazon](https://www.amazon.com/dp/B0B6HVS3SJ)<br>[Search Amazon](https://www.amazon.com/s?k=HELIFOUNER+M2+pan+head+machine+screw+kit+560) |

### Electronics

| Item | Part | Maker / part number | Specification | Qty per robot | Order unit | Order qty | Unit price | Line price | Source |
|---|---|---|---|---|---|---|---|---|---|
| 12 | Computer | Raspberry Pi Zero 2 W | without header | 1 | each | 1 | - | - | [PiShop](https://www.pishop.us/product/raspberry-pi-zero-2-w/): out of stock on 2026-11-03<br>[Search Amazon](https://www.amazon.com/s?k=Raspberry+Pi+Zero+2+W) |
| 13 | microSD card | SanDisk Ultra | 32 GB microSDHC, A1, Class 10, UHS-I | 1 | each | 1 | $22.49 | $22.49 | [Amazon](https://www.amazon.com/dp/B08L5HMJVW)<br>[Search Amazon](https://www.amazon.com/s?k=SanDisk+32GB+Ultra+microSDHC+A1) |
| 14 | Servo bus board | Waveshare Bus Servo Adapter (A), SKU 25514 | USB-C, 2 servo sockets, also sold as Serial Bus Servo Driver Board | 1 | each | 1 | $12.47 | $12.47 | [Amazon](https://www.amazon.com/dp/B0CTMM4LWK). Second source [Abra](https://abra-electronics.com/electromechanical/motors/motor-controllers/wave-25514-serial-bus-servo-driver-board.html) at $9.05<br>[Search Amazon](https://www.amazon.com/s?k=Waveshare+Serial+Bus+Servo+Driver+Board) |
| 15 | 5 V regulator | hiBCTR USB buck converter QC3.0 | 6-32 V in, 35 x 17 x 8.5 mm | 1 | pack of 2 | 1 | $7.97 | $7.97 | Amazon<br>[Search Amazon](https://www.amazon.com/s?k=hiBCTR+USB+buck+converter+QC3.0) |
| 16 | IMU | BNO085 module, EC Buying | modelled at 25.6 x 22.7 x 4.6 mm; I2C | 1 | each | 1 | $20.49 | $20.49 | [Amazon](https://www.amazon.com/dp/B0CDGZMLPP). Second source [Adafruit 4754](https://www.adafruit.com/product/4754) at $29.50, in stock on 2026-11-03<br>[Search Amazon](https://www.amazon.com/s?k=BNO085+IMU+module) |
| 17 | **OPTIONAL:** Camera | Arducam 8 MP IMX219 | board modelled at 24 x 24 mm | (1) | each | (1) | $16.99 | $16.99 | [Amazon](https://www.amazon.com/dp/B09V576TFN)<br>[Search Amazon](https://www.amazon.com/s?k=Arducam+8MP+IMX219+camera+module) |
| 18 | **OPTIONAL:** Camera ribbon, if the camera lacks one | GODIYMODULES | Pi Zero 22-pin to 15-pin, 15 cm | (1) | pack of 2 | (1) | - | - | [Amazon](https://www.amazon.com/dp/B0F9WJ62LV)<br>[Search Amazon](https://www.amazon.com/s?k=Raspberry+Pi+Zero+camera+cable+22+pin+to+15+pin+15cm) |

### Power and wiring

| Item | Part | Maker / part number | Specification | Qty per robot | Order unit | Order qty | Unit price | Line price | Source |
|---|---|---|---|---|---|---|---|---|---|
| 19 | Battery | OVONIC 2S LiPo, 100C | 450 mAh, XT30, 61.5 x 15.8 x 13.5 mm, 31 g | 1 | pack of 4 | 1 | $26.39 | $26.39 | [Amazon](https://www.amazon.com/dp/B0D2KT723L)<br>[Search Amazon](https://www.amazon.com/s?k=OVONIC+2S+450mAh+100C+XT30) |
| 20 | Battery connector | Nuofany XT30 pigtail | 100 mm, 16 AWG | 1 | 5 pairs | 1 | $9.99 | $9.99 | [Amazon](https://www.amazon.com/dp/B0B4H4GKQL)<br>[Search Amazon](https://www.amazon.com/s?k=XT30+pigtail+16+AWG+100mm) |
| 21 | Power wire, red and black | BNTECHGO silicone wire | 20 AWG | 1 | 10 ft each | 1 | - | - | [Amazon](https://www.amazon.com/dp/B01M12PSJM)<br>[Search Amazon](https://www.amazon.com/s?k=20+AWG+silicone+wire+red+black) |
| 22 | Signal wire: IMU | Fermerry silicone wire | 28 AWG stranded, 4 wires, about 1 m in all | 1 | 6 colours, 5 ft each | 1 | - | - | [Amazon](https://www.amazon.com/dp/B089CR4SDM)<br>[Search Amazon](https://www.amazon.com/s?k=28+AWG+silicone+stranded+wire) |
| 23 | Servo cable: socket 2 to right leg, neck servo to left leg | made up: JST ASEHSEH22K305 leads in JST EHR-3 housings | JST EH 3-pin both ends, 305 mm: 3 leads, pre-crimped with SEH contacts at both ends, and 2 housings for each cable. No crimping, just push the contacts in, matching pin 1 to pin 1. ROBOTIS only sells X3P cables 180 mm long | 2 | set of 3 leads and 2 housings | 2 | - | - | [Digi-Key ASEHSEH22K305](https://www.digikey.com/en/products/detail/jst-sales-america-inc/ASEHSEH22K305/6009480) (about $0.70 a lead; price not confirmed) and [Digi-Key EHR-3](https://www.digikey.com/en/products/detail/jst-sales-america-inc/EHR-3/527225) (stock varies by region; Adam Tech 25CH-C-03 is its listed substitute)<br>[Search Amazon](https://www.amazon.com/s?k=JST+EH+2.5mm+3+pin+cable+double+ended+300mm) |
| 24 | Regulator to Pi power | from the 20 AWG wire above | soldered from the regulator's 5 V output to the Pi's 5 V and GND pins (2 and 6), about 10 cm. Replaces the right-angle USB ribbon, hard to find. Solder it to the 5 V and ground pins of the converter's USB socket | 1 | in the wire above | 1 | - | - | in the wire above<br>[Search Amazon](https://www.amazon.com/s?k=20+AWG+silicone+wire+red+black) |
| 25 | Pi to bus board, UART | female-female jumper wires | 3 wires, 10 cm, soldered: the Pi's GPIO 14 (pin 8) to the board's RX, GPIO 15 (pin 10) to its TX, pin 14 to its GND, both jumpers at A. Replaces the right-angle USB OTG cable, hard to find | 1 | pack | 1 | - | - | any electronics shop<br>[Search Amazon](https://www.amazon.com/s?k=female+female+dupont+jumper+wires+10cm) |
| 26 | Power switch | DaierTek KCD1 mini rocker, SPST, pre-wired | ON-OFF, 2 pins: snap-in, mounting hole 19.2 x 13.2 mm, bezel 21 x 15 mm, 13.2 mm of housing and 8.2 mm of #187 (4.8 x 0.5 mm) quick-connect terminals behind it, with leads fitted. Rated 20 A at 12 V DC as listed (6 A 250 V AC / 10 A 125 V AC on the part). In the battery's red lead, its 2 leads spliced in; the XT30 stays plugged. Feel it after a long walk | 1 | pack of 10 | 1 | - | - | [Amazon](https://www.amazon.com/dp/B07S2QJKTX)<br>[Search Amazon](https://www.amazon.com/s?k=KCD1+mini+rocker+switch+SPST+pre-wired+12V+20A) |

### Consumables

| Item | Part | Maker / part number | Specification | Qty per robot | Order unit | Order qty | Unit price | Line price | Source |
|---|---|---|---|---|---|---|---|---|---|
| 27 | Foam tape, hook-and-loop strap, small cable ties | generic |  | 1 | lot | 1 | $12.00 | $12.00 | any hardware shop; price estimated<br>[Search Amazon](https://www.amazon.com/s?k=foam+tape+hook+and+loop+strap+cable+ties) |
| 28 | Solder, heat-shrink tube, CA glue | generic |  | 1 | lot | 1 | - | - | any hardware shop<br>[Search Amazon](https://www.amazon.com/s?k=solder+heat+shrink+CA+glue) |

### Support equipment (not in the robot)

| Item | Part | Maker / part number | Specification | Qty per robot | Order unit | Order qty | Unit price | Line price | Source |
|---|---|---|---|---|---|---|---|---|---|
| 29 | Charger | as linked | 2S LiPo, to 8.4 V, must match the balance plug | 1 | each | 1 | - | - | [Amazon](https://www.amazon.com/dp/B0FDKX4V38)<br>[Search Amazon](https://www.amazon.com/s?k=2S+LiPo+balance+charger+JST-XH) |

## Fabricated parts

All 3D printed. Files are in [prints/dynamixel/](../../prints/dynamixel/README.md), already oriented for printing, in millimetres. Mass is each piece. The hood has an orange band, painted or split in the slicer.

| Item | Part | File | Material | Colour | Hex | Mass each | Qty per robot |
|---|---|---|---|---|---|---|---|
| P1 | Hip yaw lid, left and right | `L_hip_yaw_lid.stl`, `R_hip_yaw_lid.stl` | PLA | Dark grey | #3A3D42 | 1.8 g | 2 |
| P2 | Yaw bracket, left and right | `L_yaw_bracket.stl`, `R_yaw_bracket.stl` | PLA | Dark grey | #3A3D42 | 7.0 g | 2 |
| P3 | Roll bracket, left and right | `L_roll_bracket.stl`, `R_roll_bracket.stl` | PLA | Dark grey | #3A3D42 | 6.1 g | 2 |
| P4 | Thigh frame, left and right | `L_thigh_frame.stl`, `R_thigh_frame.stl` | PLA | Dark grey | #3A3D42 | 13.3 g | 2 |
| P5 | Hip pitch lid, left and right | `L_hip_pitch_lid.stl`, `R_hip_pitch_lid.stl` | PLA | Dark grey | #3A3D42 | 1.8 g | 2 |
| P6 | Knee lid, left and right | `L_knee_lid.stl`, `R_knee_lid.stl` | PLA | Dark grey | #3A3D42 | 1.8 g | 2 |
| P7 | Thigh cover, left and right | `L_thigh_cover.stl`, `R_thigh_cover.stl` | PLA | White | #ECEBE6 | 20.2 g | 2 |
| P8 | Shin, left and right | `L_shin.stl`, `R_shin.stl` | PLA | Dark grey | #3A3D42 | 7.5 g | 2 |
| P9 | Shoe, left and right | `L_shoe.stl`, `R_shoe.stl` | PLA | Orange | #E8642A | 16.6 g | 2 |
| P10 | Sole, left and right | `L_sole.stl`, `R_sole.stl` | TPU 95A | Yellow | #F2B233 | 17.1 g | 2 |
| P11 | Chassis | `chassis.stl` | PLA | Dark grey | #3A3D42 | 19.1 g | 1 |
| P12 | Body shell | `body_shell.stl` | PLA | White | #ECEBE6 | 28.3 g | 1 |
| P13 | Neck column | `neck_column.stl` | PLA | Dark grey | #3A3D42 | 4.5 g | 1 |
| P14 | Neck lid | `neck_lid.stl` | PLA | Dark grey | #3A3D42 | 0.2 g | 1 |
| P15 | Head pitch lid | `head_pitch_lid.stl` | PLA | Dark grey | #3A3D42 | 0.2 g | 1 |
| P16 | Head fork | `head_fork.stl` | PLA | Dark grey | #3A3D42 | 12.6 g | 1 |
| P17 | Head yaw sheet | `head_yaw_sheet.stl` | PLA | Dark grey | #3A3D42 | 0.9 g | 1 |
| P18 | Head yaw bracket | `head_yaw_bracket.stl` | PLA | Dark grey | #3A3D42 | 7.2 g | 1 |
| P19 | Head roll lid | `head_roll_lid.stl` | PLA | Dark grey | #3A3D42 | 1.8 g | 1 |
| P20 | Head roll spacer | `head_roll_spacer.stl` | PLA | Dark grey | #3A3D42 | 0.4 g | 1 |
| P21 | Head roll rear spacer | `head_roll_rear_spacer.stl` | PLA | Dark grey | #3A3D42 | 0.5 g | 1 |
| P22 | Head frame | `head_frame.stl` | PLA | Orange | #E8642A | 68.5 g | 1 |
| P23 | Hood | `hood.stl` | PLA | White | #ECEBE6 | 61.1 g | 1 |
| P24 | Jaw | `jaw.stl` | PLA | Orange | #E8642A | 37.4 g | 1 |
| P25 | Jaw soft insert | `jaw_soft_insert.stl` | TPU 95A | Pale orange | #F7AE55 | 8.9 g | 1 |
| P26 | Mouth roof | `mouth_roof.stl` | TPU 95A | Pale orange | #F7AE55 | 8.4 g | 1 |
| P27 | Face | `face.stl` | PLA | Mid grey | #9A9C98 | 10.5 g | 1 |
| P28 | Eye ring | `eye_ring.stl` | PLA | Amber | #F0A030 | 9.4 g | 1 |
| P29 | Eye iris | `eye_iris.stl` | PLA | Black | #0A1420 | 2.4 g | 1 |

### Filament

| Colour | Hex | Material | Model mass | With 15 % for supports and scrap |
|---|---|---|---|---|
| Orange | #E8642A | PLA | 139 g | 160 g |
| White | #ECEBE6 | PLA | 130 g | 149 g |
| Dark grey | #3A3D42 | PLA | 127 g | 145 g |
| Mid grey | #9A9C98 | PLA | 11 g | 12 g |
| Amber | #F0A030 | PLA | 9 g | 11 g |
| Black | #0A1420 | PLA | 2 g | 3 g |
| Yellow | #F2B233 | TPU 95A | 34 g | 39 g |
| Pale orange | #F7AE55 | TPU 95A | 17 g | 20 g |

Optional alternate to item 4: printed idlers, 5 wheels and 5 bushings in PETG or nylon, each held by an M2.5 x 8 mm self-tapping screw, from [prints/dynamixel/optional/](../../prints/dynamixel/optional/README.md). Untested.

## Build notes that affect ordering

- **Items 1, 19:** the servos run directly from 2S, 7.4-8.4 V, above ROBOTIS's 6 V maximum. Expect a shorter life than ROBOTIS rates. The walking policies were trained at this voltage.
- **Item 2:** with it, order 14 of item 1. It moves nearly 4 times faster, so limit its speed in software. Its gearing is lower, so check that the jaw holds when unpowered. The simulations use the M288.
- **Item 14:** set both jumpers to A, for UART. Its silkscreen says DC 9-12.6 V and the battery is 7.4-8.4 V: bench test before ordering in quantity. Before wiring it to the Pi, measure its TX pin against GND with the board powered: the Pi's pins take 3.3 V, not 5 V.
- **Item 25:** the Pi's full UART must drive GPIO 14 and 15: Bluetooth moved to the mini UART (`dtoverlay=miniuart-bt`, `core_freq=250`), so a gamepad still pairs, and the serial console off (`pi/setup_pi.sh` does both). If no servo answers, swap TX and RX: Waveshare's wiki couldn't be read to confirm which way its header is labelled.
- **Item 16:** its listing names both BNO080 and BNO085: confirm which chip arrives, its size, and that it starts in I2C mode. The model and fit come from Adafruit's board.
- **Item 15:** feeds the Pi's PWR port only. It can output up to 12 V if a device asks for fast charging, so measure about 5 V before connecting.
- **Item 19:** marked HV. Charge as a normal 2S, to 8.4 V.
- **Item 24:** check the Pi's voltage under load, at its 5 V pin.
- **Horns:** ROBOTIS's own photos and model show the horn on the servo, though its box list names only the servo, a cable and screws. If one comes without, it's the HNX330-N102. Check the first servo before ordering the rest.
- **Items 5, 6:** come in ROBOTIS's servo box. Seeed sells the servo as a numbered Reachy Mini part, with an arm and a preset ID: check it comes with M2 x 6 and M2 x 8 self-tapping pan head screws, and set each ID again if buying there.
- Each servo includes a 180 mm cable, which covers every link in the chains except the 2 long ones.

## Open before ordering

- **Servo supply:** item 1 is sold out at ROBOTIS US and limited at Seeed. 15 units is the longest lead time here.
- **Item 23:** made up from JST's pre-crimped leads, as ROBOTIS only sells 180 mm cables. Check the first one fits a servo socket before making the second.
- **Measure on the first parts:** a horn in the bore of item 3; the Waveshare board's standoffs against their printed hex sockets, 5 mm across flats (item 14); the camera board (item 17); servo cable lengths (item 23).
- **Amazon listings** (items 3, 10, 14, 16, 25, 19, 20, 21, 22, 17, and those found by search) are as last read: confirm each page before ordering.
- **Not in this design:** power switch (the XT30 is the disconnect), speaker, microphone.
