meetsitaram/duck-droids/docs/big/BOM.md

# Big duck: bill of materials

> **This is the parts list for the big duck only.** Each duck has its own parts, prints and BOM, and they don't mix. Other ducks: [all-Dynamixel](../dynamixel/BOM.md) · [HD-1910](../hd1910/BOM.md) · [all-Feetech](../feetech/BOM.md) · [hybrid](../hybrid/BOM.md) · [hobby-servo](../hobby/BOM.md) · [nano](../nano/BOM.md). <!-- variant banner -->

**NOT SAFE TO BUILD.** This is a design study. It would stand 1.8 m and weigh about 100 kg, with no stress analysis, metal frames nobody has checked, no real actuator measured, and no brakes: its joints let go when the power does. A failure could seriously hurt someone. Don't order parts for it, or build any of it, until everything under [Open before ordering](#open-before-ordering) is closed, by someone able to sign off a machine of this size.

| | |
|---|---|
| Product | Big duck, biped, 22 actuators on 15 joints |
| Height, mass | 1.797 m, 98.6 kg as modelled, leaning on pocketing nobody has drawn |
| Build quantity | Quantities are for 1 robot |
| Fabricated parts | 912 metal, 68 printed: 27.2 kg 7075, 10.2 kg 6061, 3.2 kg steel, 8.0 kg PETG, 1.1 kg TPU. No drawing or print file exists for any of them |
| Status | Design study: no part made, no actuator tested, not safe to build |
| Prices | USD, as listed or found 2026-11-05, before tax and shipping. Confirm before ordering |
| Related | [Wiring](WIRING.md), [its spec](../../spec/big_duck.py), [Fusion trial](FUSION.md) |

Generated by `tools/big_docs.py` from the spec. Quantities of actuators, bearings and fabricated parts match the model. Screws follow the holes in the actuators, as the model only shows some of them.

## Cost summary

| Group | Required parts, priced |
|---|---|
| Actuators | $6,280.00 |
| Bearings | - |
| Head pitch chain | $35.42 |
| Fasteners | - |
| Electronics | $91.25 |
| Power and wiring | $114.99 |
| Consumables | - |
| Support equipment (not in the robot) | - |
| **Total of quoted lines** | **$6,521.66** |

That is a floor, not a price: 33 required lines have no quote and are not in it, including the battery, its BMS, the metal, the machining and the hoist. Shipping isn't in it either. The optional line adds $295.00.

## Purchased parts

Every line is required unless it starts with **OPTIONAL**. Optional lines show their quantities in brackets and are not in the total. The Search Amazon links are searches only: nobody has checked what they find.

### Actuators

| Item | Part | Maker / part number | Specification | Qty per robot | Order unit | Order qty | Unit price | Line price | Source |
|---|---|---|---|---|---|---|---|---|---|
| 1 | Joint actuator | RobStride RS04, CAN 2.0 | 48 V (24-60 V), 40 N m rated on a 345 x 345 mm heat sink, 35 on 220 x 200, 120 N m peak for 3 s, 1.42 kg, 9:1. Hips, knees, ankles, neck, head pitch | 19 | each | 19 | $295.00 | $5,605.00 | [Robotics Center](https://www.roboticscenter.ai/store/product/robstride-04): backorder, 4-6 weeks. Shipping about $67 each by its estimate<br>[Search Amazon](https://www.amazon.com/s?k=RobStride+RS04+actuator) |
| 2 | Joint actuator | RobStride RS03, CAN 2.0 | 48 V (24-60 V), 20 N m rated, 60 peak, 0.88 kg, 9:1. Head yaw, head roll | 2 | each | 2 | $245.00 | $490.00 | [Robotics Center](https://www.roboticscenter.ai/store/product/robstride-03): backorder, 4-6 weeks. [OpenELAB](https://openelab.io/products/robstride03-qdd-60n-m-integrated-joint-motor-module) lists it at 226.75 EUR, sold out<br>[Search Amazon](https://www.amazon.com/s?k=RobStride+RS03+actuator) |
| 3 | Joint actuator | RobStride RS00, CAN 2.0 | 48 V (24-60 V), 5 N m rated, 14 peak, 0.31 kg, 10:1. Beak | 1 | each | 1 | $185.00 | $185.00 | [Robotics Center](https://www.roboticscenter.ai/store/product/robstride-00): backorder, 4-6 weeks<br>[Search Amazon](https://www.amazon.com/s?k=RobStride+RS00+actuator) |
| 4 | **OPTIONAL:** Spare RS04 | RobStride RS04, CAN 2.0 | one actuator to test on a bench first, and to measure | (1) | each | (1) | $295.00 | $295.00 | [Robotics Center](https://www.roboticscenter.ai/store/product/robstride-04)<br>[Search Amazon](https://www.amazon.com/s?k=RobStride+RS04+actuator) |

### Bearings

| Item | Part | Maker / part number | Specification | Qty per robot | Order unit | Order qty | Unit price | Line price | Source |
|---|---|---|---|---|---|---|---|---|---|
| 5 | Thin-section bearing, hip yaw | 61824 | 120 x 150 x 16 mm | 2 | each | 2 | - | - | [Quality Bearings Online](https://www.qualitybearingsonline.ca/61824-2rsr-fag-thin-section-120x150x16mm/) lists the sealed 2RSR, no price read. The only price found, $218.82, is a different grease version<br>[Search Amazon](https://www.amazon.com/s?k=61824+bearing+120x150x16mm) |
| 6 | Bearing, knee and head pitch | 6908 | 40 x 62 x 12 mm | 6 | each | 6 | - | - | [Quality Bearings Online](https://www.qualitybearingsonline.ca/6908-2rs-fbj-thin-section-bearing-40x62x12mm/): 6908-2RS at $22.17, Canadian shop, currency not confirmed<br>[Search Amazon](https://www.amazon.com/s?k=6908+2RS+bearing+40x62x12mm) |
| 7 | Bearing, ankle far side | 6206 | 30 x 62 x 16 mm | 2 | each | 2 | - | - | any bearing shop; no price read<br>[Search Amazon](https://www.amazon.com/s?k=6206+2RS+bearing+30x62x16mm) |

### Head pitch chain

| Item | Part | Maker / part number | Specification | Qty per robot | Order unit | Order qty | Unit price | Line price | Source |
|---|---|---|---|---|---|---|---|---|---|
| 8 | Sprocket, drive | B&B 40B13, or plain-bore equivalent | #40 chain, 13 teeth, 53.1 mm pitch circle. Needs a hub machined to the RS04 output: not designed | 1 | each | 1 | $13.99 | $13.99 | [Zoro](https://www.zoro.com/bb-manufacturing-40b13-roller-chain-sprocket-steel-40b13/i/G905366475/)<br>[Search Amazon](https://www.amazon.com/s?k=40B13+sprocket+13+tooth) |
| 9 | Sprocket, joint | B&B 40A25, or plate equivalent | #40 chain, 25 teeth, 101.3 mm pitch circle. Needs boring to the 40 mm shaft and a key or clamp: not designed | 1 | each | 1 | $21.43 | $21.43 | [Texas Belting](https://texasbelting.com/products/bb-40a25)<br>[Search Amazon](https://www.amazon.com/s?k=40A25+sprocket+25+tooth) |
| 10 | Roller chain | ANSI #40, single strand | 12.7 mm pitch, about 52 links for these centres, 205 mm. 52 links does not land exactly on 205, so it needs the tensioner that is still not designed | 1 | length | 1 | - | - | any power transmission shop<br>[Search Amazon](https://www.amazon.com/s?k=ANSI+40+roller+chain) |
| 11 | Connecting link | ANSI #40 |  | 1 | each | 1 | - | - | with the chain<br>[Search Amazon](https://www.amazon.com/s?k=ANSI+40+connecting+link) |

### Fasteners

| Item | Part | Maker / part number | Specification | Qty per robot | Order unit | Order qty | Unit price | Line price | Source |
|---|---|---|---|---|---|---|---|---|---|
| 12 | Socket cap and countersunk screws, M4: actuator mounts, RS03 outputs and front rings, frame joints | class 12.9 into actuators; 8.8 or A4-70 in the frame, to be decided | M4, 395 in the model. Lengths by joint: [the assembly's screw table](ASSEMBLY.md#screws) | 395 | box of 100 | 4 | - | - | any fastener shop<br>[Search Amazon](https://www.amazon.com/s?k=M4+socket+cap+screw+12.9) |
| 13 | Socket cap and countersunk screws, M5: RS04 outputs, frame joints | class 12.9 | M5, 344 in the model. RS04 outputs: 3 mm into a thread 3.5 deep in RobStride's file, 6.5 in its manual: see Open before ordering. Lengths: [the screw table](ASSEMBLY.md#screws) | 344 | box of 100 | 4 | - | - | any fastener shop<br>[Search Amazon](https://www.amazon.com/s?k=M5+socket+cap+screw+12.9) |
| 14 | Socket cap screw, M3: computer standoffs, and the RS00 (not modelled) | generic | M3, 4 in the model and 12 for the RS00's mount and output | 16 | box of 100 | 1 | - | - | any fastener shop<br>[Search Amazon](https://www.amazon.com/s?k=M3+socket+cap+screw) |
| 15 | E-clip, DIN 6799 size 8 | spring steel | holds each knee rod on its 10 mm pin, in an 8 mm groove: 2 per rod | 8 | pack of 50 | 1 | - | - | any fastener shop<br>[Search Amazon](https://www.amazon.com/s?k=DIN+6799+E-clip+8mm) |
| 16 | Circlip, DIN 471 for a 40 mm shaft | spring steel | each end of the knee shafts and the head pitch shaft | 6 | pack of 10 | 1 | - | - | any fastener shop<br>[Search Amazon](https://www.amazon.com/s?k=DIN+471+40mm+external+circlip) |
| 17 | Parallel key, DIN 6885 A 12 x 8 | steel | knee levers and hubs on the knee shaft (4 per knee), head pitch yokes and sprocket (3). Keyways not drawn | 11 | each | 11 | - | - | any fastener shop<br>[Search Amazon](https://www.amazon.com/s?k=DIN+6885+key+12x8) |
| 18 | Heat-set insert, M4 | brass | the shoes: 2 per piece | 8 | pack of 50 | 1 | - | - | any fastener shop<br>[Search Amazon](https://www.amazon.com/s?k=M4+heat+set+insert) |
| 19 | Panel screws and inserts | not chosen | 59 printed panels have no screws or bosses designed | - | - | - | - | - | not designed<br>[Search Amazon](https://www.amazon.com/s?k=M3+heat+set+insert) |

### Electronics

| Item | Part | Maker / part number | Specification | Qty per robot | Order unit | Order qty | Unit price | Line price | Source |
|---|---|---|---|---|---|---|---|---|---|
| 20 | Computer | Raspberry Pi 5, 4 GB | chosen for its 2 USB 3 ports and for running a walking policy on its CPU: not tested with this one. Fits the model's box beside the power board, 56 + 110 mm in its 170 | 1 | each | 1 | - | - | any Raspberry Pi reseller<br>[Search Amazon](https://www.amazon.com/s?k=Raspberry+Pi+5+4GB) |
| 21 | microSD card | SanDisk Ultra | 32 GB microSDHC, A1, Class 10, UHS-I | 1 | each | 1 | - | - | [Amazon](https://www.amazon.com/dp/B08L5HMJVW)<br>[Search Amazon](https://www.amazon.com/s?k=SanDisk+32GB+Ultra+microSDHC+A1) |
| 22 | USB to CAN adapter, 3 buses | RobStride USB-CAN HUB module | USB-C to 5 CAN channels, by its listing. Whether Linux sees it as SocketCAN is not known | 1 | each | 1 | $91.25 | $91.25 | [RCDrone](https://rcdrone.top/products/robstride-usb-can-hub-module), from a search result: the page would not open. [AiFitLab](https://aifitlab.com/products/robstride-usb-can-hub-module) $75, backorder, the same<br>[Search Amazon](https://www.amazon.com/s?k=USB+to+CAN+adapter+1Mbps) |
| 23 | USB to CAN adapter, for setting IDs and firmware | RobStride USB-CAN module (CH340) | the one RobStride's own tool needs. DIP 2 on is its 120 ohm terminator. DIP 1 stays off | 1 | each | 1 | - | - | RobStride resellers, e.g. Pakronics; OpenELAB sells it as "Debug Board" at 20.53 EUR<br>[Search Amazon](https://www.amazon.com/s?k=RobStride+USB+CAN+debug) |
| 24 | IMU | BNO085 module, EC Buying | as the small ducks, on I2C. Must sit near the pelvis, not on the power board | 1 | each | 1 | - | - | [Amazon](https://www.amazon.com/dp/B0CDGZMLPP). Second source [Adafruit 4754](https://www.adafruit.com/product/4754) at $29.50<br>[Search Amazon](https://www.amazon.com/s?k=BNO085+IMU+module) |
| 25 | 24 V to 5 V regulator for the Pi | not chosen | 5 V, 5 A for a Pi 5, from the board's 24 V rail. The board's own 5 V rail is 2 A rated, not enough | 1 | each | 1 | - | - | not chosen<br>[Search Amazon](https://www.amazon.com/s?k=24V+to+5V+5A+buck+converter+USB-C) |
| 26 | **OPTIONAL:** USB camera | not chosen | the head's far from the computer, about 1.2 m through 4 joints: a ribbon won't reach | (1) | each | (1) | - | - | not chosen<br>[Search Amazon](https://www.amazon.com/s?k=USB+camera+module) |

### Power and wiring

| Item | Part | Maker / part number | Specification | Qty per robot | Order unit | Order qty | Unit price | Line price | Source |
|---|---|---|---|---|---|---|---|---|---|
| 27 | Battery: **candidate to bench-test, not a choice** | Dan-Tech Li-ion soft pack 13S5P 48V 25Ah 100A | 13S5P Samsung INR21700-50S, 54.6 V full, 1200 Wh, 100 A continuous, 180 A peak, 50 A charge, 280 x 80 x 130 mm, 5.2 kg. **No BMS, no case, no connector** | 1 | each | 1 | - | - | [Dan-Tech](https://shop.danenergy.com/en-il/products/li-ion-battery-softpack-13s5p-48v-25ah-100a): out of stock when found. A snippet gives 814 EUR, not tied to this model. See Battery options<br>[Search Amazon](https://www.amazon.com/s?k=13S+48V+25Ah+lithium+battery+pack) |
| 28 | Battery BMS, for the pack above | not chosen | 13S, at least 100 A continuous, taking back up to 50 A of braking current, and able to warn before it cuts off. **The pack must not be connected without one.** The model allows 60 x 190 x 137 mm and 2.8 kg for it, the fuse and a case | 1 | each | 1 | - | - | not chosen<br>[Search Amazon](https://www.amazon.com/s?k=13S+BMS+100A) |
| 29 | Power board | RobStride Power Supply Board (POWER V1.3 manual), SKU ROBSTRIDE-Power | 20-65 V in. 4 XT30 branches, 20 A rated, 40 A peak each. 24 V 4 A, 12 V 2 A, 5 V 2 A. 90 x 110 x 16.5 mm, 4 x M3. Precharge, emergency stop input, CAN | 1 | each | 1 | $114.99 | $114.99 | [OpenELAB](https://openelab.io/products/robstride-power-supply-board): $114.99 by a search result, 103.95 EUR on its page; pre-order. RCDrone $177.50<br>[Search Amazon](https://www.amazon.com/s?k=RobStride+power+board) |
| 30 | Precharge and discharge resistor | aluminium-clad, not chosen | 10 ohm, 200 W: the board asks for 3-10 ohm and 50 W or more and won't start without one, and it also burns what braking returns. RobStride's discharge module manual gives 10 ohm, 200 W for a humanoid's limbs. Needs a metal plate to cool it, which the model doesn't have | 1 | each | 1 | - | - | not chosen<br>[Search Amazon](https://www.amazon.com/s?k=10+ohm+200W+aluminum+resistor) |
| 31 | Main fuse and disconnect | not chosen | 60 V DC or more, sized from measured current. The board has an internal one-time fuse too | 1 | each | 1 | - | - | not chosen<br>[Search Amazon](https://www.amazon.com/s?k=100A+DC+circuit+breaker+60V) |
| 32 | Emergency stop | not chosen | normally-open contact, as the board's EM_NO terminal wants. **It cuts the motor branches and the robot then falls**: use it with the hoist below. A normally-open stop doesn't trip on a broken wire | 1 | each | 1 | - | - | not chosen<br>[Search Amazon](https://www.amazon.com/s?k=emergency+stop+button+normally+open) |
| 33 | Actuator power plugs and sockets | AMASS XT30U-M and XT30UW-F | each RS04 and RS03's line end is an XT30UW-F by the manual; the RS00 has AMASS XT30PB(2+2)-M.G.B on the case and XT30(2+2)-F.G.B on the line, power and CAN together. 21 to mate with the actuators, 3 at the board | 24 | each | 24 | - | - | not chosen<br>[Search Amazon](https://www.amazon.com/s?k=AMASS+XT30+connector) |
| 34 | CAN plugs | JST GH 1.25 mm, 2-pin, and "Tany" per the manual | GH1.25-2PWT on the board, GH1.25 on the line. 21 to mate with the actuators, 3 at the adapter | 24 | each | 24 | - | - | not chosen<br>[Search Amazon](https://www.amazon.com/s?k=GH1.25+2+pin+connector) |
| 35 | Power distribution: one branch to 8 actuators, in each leg | custom, not designed | see [wiring](WIRING.md). Rated at 40 A at 60 V | 3 | each | 3 | - | - | not designed<br>[Search Amazon](https://www.amazon.com/s?k=XT30+parallel+harness) |
| 36 | Power wire | silicone, 8 AWG and 12 AWG | 8 AWG battery to board, 12 AWG for branches. Lengths in [wiring](WIRING.md). Gauge to be checked against measured current | 1 | lot | 1 | - | - | any hobby shop<br>[Search Amazon](https://www.amazon.com/s?k=12+AWG+silicone+wire) |
| 37 | CAN wire | twisted pair, 120 ohm | about 4 m in all | 1 | lot | 1 | - | - | not chosen<br>[Search Amazon](https://www.amazon.com/s?k=120+ohm+twisted+pair+CAN+cable) |
| 38 | CAN terminator | 120 ohm, 1/4 W | 1 per bus at the far end. The hub's own end to be measured | 3 | each | 3 | - | - | any<br>[Search Amazon](https://www.amazon.com/s?k=120+ohm+resistor+1/4W) |

### Consumables

| Item | Part | Maker / part number | Specification | Qty per robot | Order unit | Order qty | Unit price | Line price | Source |
|---|---|---|---|---|---|---|---|---|---|
| 39 | Thread locker | medium strength | every screw into an actuator, with care: confirm with RobStride it is allowed in its threads | 1 | bottle | 1 | - | - | any hardware shop<br>[Search Amazon](https://www.amazon.com/s?k=medium+strength+thread+locker) |
| 40 | Cable ties, spiral wrap, heat-shrink, solder | generic |  | 1 | lot | 1 | - | - | any hardware shop<br>[Search Amazon](https://www.amazon.com/s?k=cable+ties+spiral+wrap+heat+shrink) |

### Support equipment (not in the robot)

| Item | Part | Maker / part number | Specification | Qty per robot | Order unit | Order qty | Unit price | Line price | Source |
|---|---|---|---|---|---|---|---|---|---|
| 41 | Overhead hoist or gantry, and harness | not chosen | for every power-on. Rated for several times 100 kg, by someone qualified to say how many | 1 | each | 1 | - | - | not chosen<br>[Search Amazon](https://www.amazon.com/s?k=overhead+gantry+hoist) |
| 42 | Charger | not chosen | 13S, 54.6 V, matched to the pack and BMS | 1 | each | 1 | - | - | with the pack<br>[Search Amazon](https://www.amazon.com/s?k=54.6V+13S+lithium+charger) |

## Battery options

Read 2026-11-05. A candidate to test on a bench, with nothing bought. All are 13S, 54.6 V full, under the RS04's 60 V. The need: the power board trips at 80 A for 30 ms, and its 3 branches peak at 40 A each. Real current is unmeasured.

| Pack | Nominal | Wh | Continuous, peak | Mass | Size, mm | Price | What would rule it out |
|---|---|---|---|---|---|---|---|
| [Unitree G1 pack](https://www.roboticscenter.ai/store/product/unitree-g1-battery) | 46.8 V, 9 Ah | 421 | not published | 2.55 kg | 120 x 80 x 182, by resellers | $750-$1,150, backorder; charger about $165-$195 | no discharge rating, and a BMS interface nobody outside publishes. A third of the energy: 80 A would be about 9C. Its BMS may refuse to run without a Unitree robot |
| **[Dan-Tech 13S5P soft pack](https://shop.danenergy.com/en-il/products/li-ion-battery-softpack-13s5p-48v-25ah-100a): the candidate** | 48 V, 25 Ah | 1200 | 100 A, 180 A; ratings stated without a BMS | 5.2 kg | 280 x 80 x 130 | 814 EUR by a snippet, unconfirmed; out of stock | no BMS or case, so one has to be found that keeps up. Out of stock. Soft pack: no impact protection at all |
| [LiTech 13S5P](https://litechpower.com/?p=5177) | 48 V, 25 Ah | about 1200 | 50 A, 100 A for 3 s | about 6 kg | 300 x 125 x 95 | not read; page wouldn't open, from a search result | has a BMS, the fallback. But 50 A continuous is under the board's 80 A, so its BMS could cut out first and drop the robot |
| [CM Batteries 13S7P](https://cmbatteries.com/?p=23091) | 48.1 V, 21 Ah | about 1010 | 31.5 A, 63 A for 5 s | 4.4 kg | 259 x 70 x 149 | not listed | under one leg's 40 A peak twice over. Made for small inspection robots |
| [EM3ev King Shark 13S4P](https://em3ev.com/batteries-48v/), e-bike | 48 V, 19.6 Ah | about 917 | not listed | not listed | not listed | $379 | no rating, size or mass published. An e-bike pack's BMS isn't built to take back braking current from 19 actuators |

Why Dan-Tech to test: it is the only one here with a published rating above the board's 80 A limit, so the board should trip before the pack, and it fits the body across the posts with room for a BMS. It costs safety: without a BMS it has no protection at all, and a soft pack in a falling robot could catch fire. The LiTech is simpler if measured current stays well under 50 A. Measure one RS04 on a current-limited lab supply before any pack goes near one.

## Fabricated parts

No file for any of these exists yet: the sizes below are the spec's envelopes, not drawings. Left and right legs are the same parts mirrored.

### Metal

Sheet stock to cut, as outlines only, before nesting or scrap: 6061-T6 3 mm, 0.07 m2; 6061-T6 4 mm, 0.01 m2; 6061-T6 4.5 mm, 0.00 m2; 6061-T6 6 mm, 0.03 m2; 6061-T6 7.5 mm, 0.03 m2; 6061-T6 8 mm, 0.47 m2; 7075-T6 5 mm, 0.06 m2; 7075-T6 6 mm, 0.16 m2; 7075-T6 8 mm, 1.31 m2. The first idea in the spec, every metal part from one sheet thickness, does not hold: sheet thicknesses are 3, 4, 4.5, 5, 6, 7.5, 8 mm, and 19 parts are blocks standing in for machined parts.

| Item | Part | Material | Envelope | How | Pocketing | Mass each | Qty per robot |
|---|---|---|---|---|---|---|---|
| F1 | deck plate | 7075-T6 | 495 x 383 x 8.0 mm | cut from 8 mm sheet | 45 % of solid, assumed | 1646 g | 1 |
| F2 | upper plate | 6061-T6 | 325 x 300 x 8.0 mm | cut from 8 mm sheet | 40 % of solid, assumed | 839 g | 1 |
| F3 | body post 0 | 6061-T6 | 142 x 24 x 24.0 mm | milled from solid; pockets not designed | - | 218 g | 1 |
| F4 | body post 0 screw low 0 shank | steel | 16 x 4 x 4.1 mm | turned | - | 2 g | 1 |
| F5 | body post 0 screw high 0 shank | steel | 16 x 4 x 4.1 mm | turned | - | 2 g | 1 |
| F6 | body post 1 | 6061-T6 | 142 x 24 x 24.0 mm | milled from solid; pockets not designed | - | 218 g | 1 |
| F7 | body post 1 screw low 0 shank | steel | 16 x 4 x 4.1 mm | turned | - | 2 g | 1 |
| F8 | body post 1 screw high 0 shank | steel | 16 x 4 x 4.1 mm | turned | - | 2 g | 1 |
| F9 | body post 2 | 6061-T6 | 142 x 24 x 24.0 mm | milled from solid; pockets not designed | - | 218 g | 1 |
| F10 | body post 2 screw low 0 shank | steel | 16 x 4 x 4.1 mm | turned | - | 2 g | 1 |
| F11 | body post 2 screw high 0 shank | steel | 16 x 4 x 4.1 mm | turned | - | 2 g | 1 |
| F12 | body post 3 | 6061-T6 | 142 x 24 x 24.0 mm | milled from solid; pockets not designed | - | 218 g | 1 |
| F13 | body post 3 screw low 0 shank | steel | 16 x 4 x 4.1 mm | turned | - | 2 g | 1 |
| F14 | body post 3 screw high 0 shank | steel | 16 x 4 x 4.1 mm | turned | - | 2 g | 1 |
| F15 | neck tie | 6061-T6 | 147 x 47 x 12.0 mm | turned or milled | - | 218 g | 1 |
| F16 | neck tie deck screw 0 shank | steel | 16 x 4 x 4.1 mm | turned | - | 2 g | 1 |
| F17 | neck tie deck screw 1 shank | steel | 16 x 4 x 4.1 mm | turned | - | 2 g | 1 |
| F18 | neck plate L | 7075-T6 | 202 x 139 x 8.0 mm | cut from 8 mm sheet | 60 % of solid, assumed | 179 g | 1 |
| F19 | neck tie screw L 0 shank | steel | 16 x 4 x 4.1 mm | turned | - | 2 g | 1 |
| F20 | neck tie screw L 1 shank | steel | 16 x 4 x 4.1 mm | turned | - | 2 g | 1 |
| F21 | neck cleat L | 6061-T6 | 28 x 16 x 12.0 mm | turned or milled | - | 13 g | 1 |
| F22 | neck cleat screw L 0 shank | steel | 18 x 4 x 4.1 mm | turned | - | 2 g | 1 |
| F23 | neck cleat deck screw L 0 shank | steel | 16 x 4 x 4.1 mm | turned | - | 2 g | 1 |
| F24 | neck cleat deck screw L 1 shank | steel | 16 x 4 x 4.1 mm | turned | - | 2 g | 1 |
| F25 | neck plate R | 7075-T6 | 202 x 139 x 8.0 mm | cut from 8 mm sheet | 60 % of solid, assumed | 179 g | 1 |
| F26 | neck tie screw R 0 shank | steel | 16 x 4 x 4.1 mm | turned | - | 2 g | 1 |
| F27 | neck tie screw R 1 shank | steel | 16 x 4 x 4.1 mm | turned | - | 2 g | 1 |
| F28 | neck cleat R | 6061-T6 | 28 x 16 x 12.0 mm | turned or milled | - | 13 g | 1 |
| F29 | neck cleat screw R 0 shank | steel | 18 x 4 x 4.1 mm | turned | - | 2 g | 1 |
| F30 | neck cleat deck screw R 0 shank | steel | 16 x 4 x 4.1 mm | turned | - | 2 g | 1 |
| F31 | neck cleat deck screw R 1 shank | steel | 16 x 4 x 4.1 mm | turned | - | 2 g | 1 |
| F32 | computer standoff 0 | 6061-T6 | 70 x 10 x 6.0 mm | cut from 6 mm sheet | - | 10 g | 1 |
| F33 | computer standoff 0 screw 0 shank | steel | 12 x 2 x 2.4 mm | turned | - | 0 g | 1 |
| F34 | computer standoff 0 screw 1 shank | steel | 12 x 2 x 2.4 mm | turned | - | 0 g | 1 |
| F35 | computer standoff 1 | 6061-T6 | 70 x 10 x 6.0 mm | cut from 6 mm sheet | - | 10 g | 1 |
| F36 | computer standoff 1 screw 0 shank | steel | 12 x 2 x 2.4 mm | turned | - | 0 g | 1 |
| F37 | computer standoff 1 screw 1 shank | steel | 12 x 2 x 2.4 mm | turned | - | 0 g | 1 |
| F38 | L hip yaw housing | 6061-T6 | 162 x 162 x 63.0 mm | milled from solid; pockets not designed | - | 1205 g | 1 |
| F39 | L hip yaw retainer | 6061-T6 | 184 x 184 x 3.0 mm | cut from 3 mm sheet | - | 94 g | 1 |
| F40 | L hip yaw retainer screw 0 shank | steel | 7 x 3 x 3.2 mm | turned | - | 0 g | 1 |
| F41 | L hip yaw retainer screw 1 shank | steel | 7 x 3 x 3.2 mm | turned | - | 0 g | 1 |
| F42 | L hip yaw retainer screw 2 shank | steel | 7 x 3 x 3.2 mm | turned | - | 0 g | 1 |
| F43 | L hip yaw retainer screw 3 shank | steel | 7 x 3 x 3.2 mm | turned | - | 0 g | 1 |
| F44 | L hip yaw retainer screw 4 shank | steel | 7 x 3 x 3.2 mm | turned | - | 0 g | 1 |
| F45 | L hip yaw retainer screw 5 shank | steel | 7 x 3 x 3.2 mm | turned | - | 0 g | 1 |
| F46 | L hip yaw retainer screw 6 shank | steel | 7 x 3 x 3.2 mm | turned | - | 0 g | 1 |
| F47 | L hip yaw retainer screw 7 shank | steel | 7 x 3 x 3.2 mm | turned | - | 0 g | 1 |
| F48 | L hip yaw mount screw 0 shank | steel | 12 x 3 x 3.2 mm | turned | - | 1 g | 1 |
| F49 | L hip yaw mount screw 1 shank | steel | 12 x 3 x 3.2 mm | turned | - | 1 g | 1 |
| F50 | L hip yaw mount screw 2 shank | steel | 12 x 3 x 3.2 mm | turned | - | 1 g | 1 |
| F51 | L hip yaw mount screw 3 shank | steel | 12 x 3 x 3.2 mm | turned | - | 1 g | 1 |
| F52 | L hip yaw mount screw 4 shank | steel | 12 x 3 x 3.2 mm | turned | - | 1 g | 1 |
| F53 | L hip yaw mount screw 5 shank | steel | 12 x 3 x 3.2 mm | turned | - | 1 g | 1 |
| F54 | L hip yaw mount screw 6 shank | steel | 12 x 3 x 3.2 mm | turned | - | 1 g | 1 |
| F55 | L hip yaw mount screw 7 shank | steel | 12 x 3 x 3.2 mm | turned | - | 1 g | 1 |
| F56 | L hip yaw mount screw 8 shank | steel | 12 x 3 x 3.2 mm | turned | - | 1 g | 1 |
| F57 | L hip yaw mount screw 9 shank | steel | 12 x 3 x 3.2 mm | turned | - | 1 g | 1 |
| F58 | L hip yaw housing screw 0 shank | steel | 16 x 4 x 4.1 mm | turned | - | 2 g | 1 |
| F59 | L hip yaw housing screw 1 shank | steel | 16 x 4 x 4.1 mm | turned | - | 2 g | 1 |
| F60 | L hip yaw housing screw 2 shank | steel | 16 x 4 x 4.1 mm | turned | - | 2 g | 1 |
| F61 | L hip yaw housing screw 3 shank | steel | 16 x 4 x 4.1 mm | turned | - | 2 g | 1 |
| F62 | L hip yaw housing screw 4 shank | steel | 16 x 4 x 4.1 mm | turned | - | 2 g | 1 |
| F63 | L hip yaw housing screw 5 shank | steel | 16 x 4 x 4.1 mm | turned | - | 2 g | 1 |
| F64 | L hip yaw housing screw 6 shank | steel | 16 x 4 x 4.1 mm | turned | - | 2 g | 1 |
| F65 | L hip yaw housing screw 7 shank | steel | 16 x 4 x 4.1 mm | turned | - | 2 g | 1 |
| F66 | L hip yaw housing screw 8 shank | steel | 16 x 4 x 4.1 mm | turned | - | 2 g | 1 |
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
| F177 | hip roll B mount screw 7 shank | steel | 12 x 3 x 3.2 mm | turned | - | 1 g | 2 |
| F178 | hip roll B mount screw 8 shank | steel | 12 x 3 x 3.2 mm | turned | - | 1 g | 2 |
| F179 | hip roll B mount screw 9 shank | steel | 12 x 3 x 3.2 mm | turned | - | 1 g | 2 |
| F180 | hip roll output F | 6061-T6 | 80 x 80 x 7.5 mm | cut from 8 mm sheet | - | 96 g | 2 |
| F181 | hip roll output B | 6061-T6 | 80 x 80 x 7.5 mm | cut from 8 mm sheet | - | 96 g | 2 |
| F182 | hip roll yoke | 7075-T6 | 110 x 109 x 90.0 mm | milled from solid; pockets not designed | 35 % of solid, assumed | 470 g | 2 |
| F183 | hip roll F screw 0 shank | steel | 18 x 4 x 4.1 mm | turned | - | 2 g | 2 |
| F184 | hip roll F screw 1 shank | steel | 18 x 4 x 4.1 mm | turned | - | 2 g | 2 |
| F185 | hip roll F screw 2 shank | steel | 18 x 4 x 4.1 mm | turned | - | 2 g | 2 |
| F186 | hip roll F screw 3 shank | steel | 18 x 4 x 4.1 mm | turned | - | 2 g | 2 |
| F187 | hip roll F screw 4 shank | steel | 18 x 4 x 4.1 mm | turned | - | 2 g | 2 |
| F188 | hip roll F screw 5 shank | steel | 18 x 4 x 4.1 mm | turned | - | 2 g | 2 |
| F189 | hip roll F screw 6 shank | steel | 18 x 4 x 4.1 mm | turned | - | 2 g | 2 |
| F190 | hip roll F screw 7 shank | steel | 18 x 4 x 4.1 mm | turned | - | 2 g | 2 |
| F191 | hip roll F screw 8 shank | steel | 18 x 4 x 4.1 mm | turned | - | 2 g | 2 |
| F192 | hip roll B screw 0 shank | steel | 18 x 4 x 4.1 mm | turned | - | 2 g | 2 |
| F193 | hip roll B screw 1 shank | steel | 18 x 4 x 4.1 mm | turned | - | 2 g | 2 |
| F194 | hip roll B screw 2 shank | steel | 18 x 4 x 4.1 mm | turned | - | 2 g | 2 |
| F195 | hip roll B screw 3 shank | steel | 18 x 4 x 4.1 mm | turned | - | 2 g | 2 |
| F196 | hip roll B screw 4 shank | steel | 18 x 4 x 4.1 mm | turned | - | 2 g | 2 |
| F197 | hip roll B screw 5 shank | steel | 18 x 4 x 4.1 mm | turned | - | 2 g | 2 |
| F198 | hip roll B screw 6 shank | steel | 18 x 4 x 4.1 mm | turned | - | 2 g | 2 |
| F199 | hip roll B screw 7 shank | steel | 18 x 4 x 4.1 mm | turned | - | 2 g | 2 |
| F200 | hip roll B screw 8 shank | steel | 18 x 4 x 4.1 mm | turned | - | 2 g | 2 |
| F201 | hip pitch upright in | 7075-T6 | 150 x 150 x 8.0 mm | cut from 8 mm sheet | - | 241 g | 2 |
| F202 | hip pitch upright out | 7075-T6 | 150 x 150 x 8.0 mm | cut from 8 mm sheet | - | 243 g | 2 |
| F203 | hip pitch upright screw 0 shank | steel | 20 x 4 x 4.1 mm | turned | - | 2 g | 2 |
| F204 | hip pitch upright screw 1 shank | steel | 20 x 4 x 4.1 mm | turned | - | 2 g | 2 |
| F205 | hip pitch upright screw 2 shank | steel | 20 x 4 x 4.1 mm | turned | - | 2 g | 2 |
| F206 | hip pitch upright screw 3 shank | steel | 20 x 4 x 4.1 mm | turned | - | 2 g | 2 |
| F207 | hip pitch upright screw 4 shank | steel | 20 x 4 x 4.1 mm | turned | - | 2 g | 2 |
| F208 | hip pitch bridge | 7075-T6 | 148 x 65 x 8.0 mm | cut from 8 mm sheet | - | 213 g | 2 |
| F209 | hip pitch bridge screw in 0 shank | steel | 16 x 3 x 3.2 mm | turned | - | 1 g | 2 |
| F210 | hip pitch bridge screw in 1 shank | steel | 16 x 3 x 3.2 mm | turned | - | 1 g | 2 |
| F211 | hip pitch bridge screw out 0 shank | steel | 16 x 3 x 3.2 mm | turned | - | 1 g | 2 |
| F212 | hip pitch bridge screw out 1 shank | steel | 16 x 3 x 3.2 mm | turned | - | 1 g | 2 |
| F213 | hip pitch I mount screw 0 shank | steel | 12 x 3 x 3.2 mm | turned | - | 1 g | 2 |
| F214 | hip pitch I mount screw 1 shank | steel | 12 x 3 x 3.2 mm | turned | - | 1 g | 2 |
| F215 | hip pitch I mount screw 2 shank | steel | 12 x 3 x 3.2 mm | turned | - | 1 g | 2 |
| F216 | hip pitch I mount screw 3 shank | steel | 12 x 3 x 3.2 mm | turned | - | 1 g | 2 |
| F217 | hip pitch I mount screw 4 shank | steel | 12 x 3 x 3.2 mm | turned | - | 1 g | 2 |
| F218 | hip pitch I mount screw 5 shank | steel | 12 x 3 x 3.2 mm | turned | - | 1 g | 2 |
| F219 | hip pitch I mount screw 6 shank | steel | 12 x 3 x 3.2 mm | turned | - | 1 g | 2 |
| F220 | hip pitch I mount screw 7 shank | steel | 12 x 3 x 3.2 mm | turned | - | 1 g | 2 |
| F221 | hip pitch I mount screw 8 shank | steel | 12 x 3 x 3.2 mm | turned | - | 1 g | 2 |
| F222 | hip pitch I mount screw 9 shank | steel | 12 x 3 x 3.2 mm | turned | - | 1 g | 2 |
| F223 | hip pitch O mount screw 0 shank | steel | 12 x 3 x 3.2 mm | turned | - | 1 g | 2 |
| F224 | hip pitch O mount screw 1 shank | steel | 12 x 3 x 3.2 mm | turned | - | 1 g | 2 |
| F225 | hip pitch O mount screw 2 shank | steel | 12 x 3 x 3.2 mm | turned | - | 1 g | 2 |
| F226 | hip pitch O mount screw 3 shank | steel | 12 x 3 x 3.2 mm | turned | - | 1 g | 2 |
| F227 | hip pitch O mount screw 4 shank | steel | 12 x 3 x 3.2 mm | turned | - | 1 g | 2 |
| F228 | hip pitch O mount screw 5 shank | steel | 12 x 3 x 3.2 mm | turned | - | 1 g | 2 |
| F229 | hip pitch O mount screw 6 shank | steel | 12 x 3 x 3.2 mm | turned | - | 1 g | 2 |
| F230 | hip pitch O mount screw 7 shank | steel | 12 x 3 x 3.2 mm | turned | - | 1 g | 2 |
| F231 | hip pitch O mount screw 8 shank | steel | 12 x 3 x 3.2 mm | turned | - | 1 g | 2 |
| F232 | hip pitch O mount screw 9 shank | steel | 12 x 3 x 3.2 mm | turned | - | 1 g | 2 |
| F233 | thigh plate in | 7075-T6 | 365 x 274 x 8.0 mm | cut from 8 mm sheet | - | 1449 g | 2 |
| F234 | thigh plate out | 7075-T6 | 365 x 274 x 8.0 mm | cut from 8 mm sheet | - | 1449 g | 2 |
| F235 | thigh spacer hip | 6061-T6 | 100 x 24 x 20.0 mm | milled from solid; pockets not designed | - | 127 g | 2 |
| F236 | thigh spacer mid | 6061-T6 | 70 x 24 x 24.0 mm | milled from solid; pockets not designed | - | 106 g | 2 |
| F237 | thigh spacer hip screw in 0 shank | steel | 13 x 4 x 4.1 mm | turned | - | 1 g | 2 |
| F238 | thigh spacer hip screw in 1 shank | steel | 13 x 4 x 4.1 mm | turned | - | 1 g | 2 |
| F239 | thigh spacer hip screw out 0 shank | steel | 13 x 4 x 4.1 mm | turned | - | 1 g | 2 |
| F240 | thigh spacer hip screw out 1 shank | steel | 13 x 4 x 4.1 mm | turned | - | 1 g | 2 |
| F241 | thigh spacer mid screw in 0 shank | steel | 13 x 4 x 4.1 mm | turned | - | 1 g | 2 |
| F242 | thigh spacer mid screw in 1 shank | steel | 13 x 4 x 4.1 mm | turned | - | 1 g | 2 |
| F243 | thigh spacer mid screw out 0 shank | steel | 13 x 4 x 4.1 mm | turned | - | 1 g | 2 |
| F244 | thigh spacer mid screw out 1 shank | steel | 13 x 4 x 4.1 mm | turned | - | 1 g | 2 |
| F245 | hip pitch output I | 6061-T6 | 80 x 80 x 14.3 mm | milled from solid; pockets not designed | - | 174 g | 2 |
| F246 | hip pitch output O | 6061-T6 | 80 x 80 x 14.3 mm | milled from solid; pockets not designed | - | 175 g | 2 |
| F247 | hip pitch I screw 0 shank | steel | 10 x 4 x 4.1 mm | turned | - | 1 g | 2 |
| F248 | hip pitch I screw 1 shank | steel | 10 x 4 x 4.1 mm | turned | - | 1 g | 2 |
| F249 | hip pitch I screw 2 shank | steel | 10 x 4 x 4.1 mm | turned | - | 1 g | 2 |
| F250 | hip pitch I screw 3 shank | steel | 10 x 4 x 4.1 mm | turned | - | 1 g | 2 |
| F251 | hip pitch I screw 4 shank | steel | 10 x 4 x 4.1 mm | turned | - | 1 g | 2 |
| F252 | hip pitch I screw 5 shank | steel | 10 x 4 x 4.1 mm | turned | - | 1 g | 2 |
| F253 | hip pitch I screw 6 shank | steel | 10 x 4 x 4.1 mm | turned | - | 1 g | 2 |
| F254 | hip pitch I screw 7 shank | steel | 10 x 4 x 4.1 mm | turned | - | 1 g | 2 |
| F255 | hip pitch I screw 8 shank | steel | 10 x 4 x 4.1 mm | turned | - | 1 g | 2 |
| F256 | hip pitch O screw 0 shank | steel | 10 x 4 x 4.1 mm | turned | - | 1 g | 2 |
| F257 | hip pitch O screw 1 shank | steel | 10 x 4 x 4.1 mm | turned | - | 1 g | 2 |
| F258 | hip pitch O screw 2 shank | steel | 10 x 4 x 4.1 mm | turned | - | 1 g | 2 |
| F259 | hip pitch O screw 3 shank | steel | 10 x 4 x 4.1 mm | turned | - | 1 g | 2 |
| F260 | hip pitch O screw 4 shank | steel | 10 x 4 x 4.1 mm | turned | - | 1 g | 2 |
| F261 | hip pitch O screw 5 shank | steel | 10 x 4 x 4.1 mm | turned | - | 1 g | 2 |
| F262 | hip pitch O screw 6 shank | steel | 10 x 4 x 4.1 mm | turned | - | 1 g | 2 |
| F263 | hip pitch O screw 7 shank | steel | 10 x 4 x 4.1 mm | turned | - | 1 g | 2 |
| F264 | hip pitch O screw 8 shank | steel | 10 x 4 x 4.1 mm | turned | - | 1 g | 2 |
| F265 | thigh screw I 0 shank | steel | 16 x 4 x 4.1 mm | turned | - | 2 g | 2 |
| F266 | thigh screw I 1 shank | steel | 16 x 4 x 4.1 mm | turned | - | 2 g | 2 |
| F267 | thigh screw I 2 shank | steel | 16 x 4 x 4.1 mm | turned | - | 2 g | 2 |
| F268 | thigh screw I 3 shank | steel | 16 x 4 x 4.1 mm | turned | - | 2 g | 2 |
| F269 | thigh screw I 4 shank | steel | 16 x 4 x 4.1 mm | turned | - | 2 g | 2 |
| F270 | thigh screw I 5 shank | steel | 16 x 4 x 4.1 mm | turned | - | 2 g | 2 |
| F271 | thigh screw O 0 shank | steel | 16 x 4 x 4.1 mm | turned | - | 2 g | 2 |
| F272 | thigh screw O 1 shank | steel | 16 x 4 x 4.1 mm | turned | - | 2 g | 2 |
| F273 | thigh screw O 2 shank | steel | 16 x 4 x 4.1 mm | turned | - | 2 g | 2 |
| F274 | thigh screw O 3 shank | steel | 16 x 4 x 4.1 mm | turned | - | 2 g | 2 |
| F275 | thigh screw O 4 shank | steel | 16 x 4 x 4.1 mm | turned | - | 2 g | 2 |
| F276 | thigh rear plate in | 7075-T6 | 178 x 148 x 8.0 mm | cut from 8 mm sheet | - | 260 g | 2 |
| F277 | thigh rear plate out | 7075-T6 | 178 x 148 x 8.0 mm | cut from 8 mm sheet | - | 259 g | 2 |
| F278 | thigh tie 0i | 6061-T6 | 54 x 12 x 12.0 mm | turned or milled | - | 20 g | 2 |
| F279 | thigh tie 0i screw rear 0 shank | steel | 16 x 4 x 4.1 mm | turned | - | 2 g | 2 |
| F280 | thigh tie 0i screw front 0 shank | steel | 16 x 4 x 4.1 mm | turned | - | 2 g | 2 |
| F281 | thigh tie 1i | 6061-T6 | 54 x 12 x 12.0 mm | turned or milled | - | 20 g | 2 |
| F282 | thigh tie 1i screw rear 0 shank | steel | 16 x 4 x 4.1 mm | turned | - | 2 g | 2 |
| F283 | thigh tie 1i screw front 0 shank | steel | 16 x 4 x 4.1 mm | turned | - | 2 g | 2 |
| F284 | thigh tie 0o | 6061-T6 | 54 x 12 x 12.0 mm | turned or milled | - | 20 g | 2 |
| F285 | thigh tie 0o screw rear 0 shank | steel | 16 x 4 x 4.1 mm | turned | - | 2 g | 2 |
| F286 | thigh tie 0o screw front 0 shank | steel | 16 x 4 x 4.1 mm | turned | - | 2 g | 2 |
| F287 | thigh tie 1o | 6061-T6 | 54 x 12 x 12.0 mm | turned or milled | - | 20 g | 2 |
| F288 | thigh tie 1o screw rear 0 shank | steel | 16 x 4 x 4.1 mm | turned | - | 2 g | 2 |
| F289 | thigh tie 1o screw front 0 shank | steel | 16 x 4 x 4.1 mm | turned | - | 2 g | 2 |
| F290 | knee I mount screw 0 shank | steel | 12 x 3 x 3.2 mm | turned | - | 1 g | 2 |
| F291 | knee I mount screw 1 shank | steel | 12 x 3 x 3.2 mm | turned | - | 1 g | 2 |
| F292 | knee I mount screw 2 shank | steel | 12 x 3 x 3.2 mm | turned | - | 1 g | 2 |
| F293 | knee I mount screw 3 shank | steel | 12 x 3 x 3.2 mm | turned | - | 1 g | 2 |
| F294 | knee I mount screw 4 shank | steel | 12 x 3 x 3.2 mm | turned | - | 1 g | 2 |
| F295 | knee I mount screw 5 shank | steel | 12 x 3 x 3.2 mm | turned | - | 1 g | 2 |
| F296 | knee I mount screw 6 shank | steel | 12 x 3 x 3.2 mm | turned | - | 1 g | 2 |
| F297 | knee I mount screw 7 shank | steel | 12 x 3 x 3.2 mm | turned | - | 1 g | 2 |
| F298 | knee I mount screw 8 shank | steel | 12 x 3 x 3.2 mm | turned | - | 1 g | 2 |
| F299 | knee I mount screw 9 shank | steel | 12 x 3 x 3.2 mm | turned | - | 1 g | 2 |
| F300 | knee O mount screw 0 shank | steel | 12 x 3 x 3.2 mm | turned | - | 1 g | 2 |
| F301 | knee O mount screw 1 shank | steel | 12 x 3 x 3.2 mm | turned | - | 1 g | 2 |
| F302 | knee O mount screw 2 shank | steel | 12 x 3 x 3.2 mm | turned | - | 1 g | 2 |
| F303 | knee O mount screw 3 shank | steel | 12 x 3 x 3.2 mm | turned | - | 1 g | 2 |
| F304 | knee O mount screw 4 shank | steel | 12 x 3 x 3.2 mm | turned | - | 1 g | 2 |
| F305 | knee O mount screw 5 shank | steel | 12 x 3 x 3.2 mm | turned | - | 1 g | 2 |
| F306 | knee O mount screw 6 shank | steel | 12 x 3 x 3.2 mm | turned | - | 1 g | 2 |
| F307 | knee O mount screw 7 shank | steel | 12 x 3 x 3.2 mm | turned | - | 1 g | 2 |
| F308 | knee O mount screw 8 shank | steel | 12 x 3 x 3.2 mm | turned | - | 1 g | 2 |
| F309 | knee O mount screw 9 shank | steel | 12 x 3 x 3.2 mm | turned | - | 1 g | 2 |
| F310 | knee crank I | 7075-T6 | 91 x 77 x 6.0 mm | cut from 6 mm sheet | - | 61 g | 2 |
| F311 | knee crank O | 7075-T6 | 91 x 77 x 6.0 mm | cut from 6 mm sheet | - | 61 g | 2 |
| F312 | knee crank pin I | steel | 13 x 10 x 10.0 mm | turned | - | 8 g | 2 |
| F313 | knee crank pin O | steel | 13 x 10 x 10.0 mm | turned | - | 8 g | 2 |
| F314 | knee I screw 0 shank | steel | 8 x 4 x 4.1 mm | turned | - | 1 g | 2 |
| F315 | knee I screw 1 shank | steel | 8 x 4 x 4.1 mm | turned | - | 1 g | 2 |
| F316 | knee I screw 2 shank | steel | 8 x 4 x 4.1 mm | turned | - | 1 g | 2 |
| F317 | knee I screw 3 shank | steel | 8 x 4 x 4.1 mm | turned | - | 1 g | 2 |
| F318 | knee I screw 4 shank | steel | 8 x 4 x 4.1 mm | turned | - | 1 g | 2 |
| F319 | knee I screw 5 shank | steel | 8 x 4 x 4.1 mm | turned | - | 1 g | 2 |
| F320 | knee I screw 6 shank | steel | 8 x 4 x 4.1 mm | turned | - | 1 g | 2 |
| F321 | knee I screw 7 shank | steel | 8 x 4 x 4.1 mm | turned | - | 1 g | 2 |
| F322 | knee I screw 8 shank | steel | 8 x 4 x 4.1 mm | turned | - | 1 g | 2 |
| F323 | knee O screw 0 shank | steel | 8 x 4 x 4.1 mm | turned | - | 1 g | 2 |
| F324 | knee O screw 1 shank | steel | 8 x 4 x 4.1 mm | turned | - | 1 g | 2 |
| F325 | knee O screw 2 shank | steel | 8 x 4 x 4.1 mm | turned | - | 1 g | 2 |
| F326 | knee O screw 3 shank | steel | 8 x 4 x 4.1 mm | turned | - | 1 g | 2 |
| F327 | knee O screw 4 shank | steel | 8 x 4 x 4.1 mm | turned | - | 1 g | 2 |
| F328 | knee O screw 5 shank | steel | 8 x 4 x 4.1 mm | turned | - | 1 g | 2 |
| F329 | knee O screw 6 shank | steel | 8 x 4 x 4.1 mm | turned | - | 1 g | 2 |
| F330 | knee O screw 7 shank | steel | 8 x 4 x 4.1 mm | turned | - | 1 g | 2 |
| F331 | knee O screw 8 shank | steel | 8 x 4 x 4.1 mm | turned | - | 1 g | 2 |
| F332 | knee rod I | 7075-T6 | 152 x 93 x 5.0 mm | cut from 5 mm sheet | - | 47 g | 2 |
| F333 | knee rod I bush A | steel | 14 x 14 x 5.0 mm | turned | - | 3 g | 2 |
| F334 | knee rod I bush B | steel | 14 x 14 x 5.0 mm | turned | - | 3 g | 2 |
| F335 | knee rod O | 7075-T6 | 152 x 93 x 5.0 mm | cut from 5 mm sheet | - | 47 g | 2 |
| F336 | knee rod O bush A | steel | 14 x 14 x 5.0 mm | turned | - | 3 g | 2 |
| F337 | knee rod O bush B | steel | 14 x 14 x 5.0 mm | turned | - | 3 g | 2 |
| F338 | thigh cover post out hip | 6061-T6 | 15 x 10 x 10.0 mm | turned or milled | - | 3 g | 2 |
| F339 | thigh cover screw hip 0 shank | steel | 25 x 3 x 3.2 mm | turned | - | 2 g | 2 |
| F340 | thigh cover post out rear | 6061-T6 | 15 x 10 x 10.0 mm | turned or milled | - | 3 g | 2 |
| F341 | thigh cover screw rear 0 shank | steel | 25 x 3 x 3.2 mm | turned | - | 2 g | 2 |
| F342 | thigh cover post out knee | 6061-T6 | 15 x 10 x 10.0 mm | turned or milled | - | 3 g | 2 |
| F343 | thigh cover screw knee 0 shank | steel | 25 x 3 x 3.2 mm | turned | - | 2 g | 2 |
| F344 | knee shaft | steel | 72 x 40 x 40.0 mm | turned | - | 705 g | 2 |
| F345 | knee lever I | 7075-T6 | 127 x 92 x 6.0 mm | cut from 6 mm sheet | - | 78 g | 2 |
| F346 | knee lever O | 7075-T6 | 127 x 92 x 6.0 mm | cut from 6 mm sheet | - | 78 g | 2 |
| F347 | knee lever pin I | steel | 13 x 10 x 10.0 mm | turned | - | 8 g | 2 |
| F348 | knee lever pin O | steel | 13 x 10 x 10.0 mm | turned | - | 8 g | 2 |
| F349 | shin hub in | 7075-T6 | 130 x 84 x 6.0 mm | cut from 6 mm sheet | - | 123 g | 2 |
| F350 | shin hub out | 7075-T6 | 130 x 84 x 6.0 mm | cut from 6 mm sheet | - | 124 g | 2 |
| F351 | shin spacer | 6061-T6 | 70 x 30 x 11.0 mm | turned or milled | - | 59 g | 2 |
| F352 | shin hub screw 0 shank | steel | 19 x 3 x 3.2 mm | turned | - | 1 g | 2 |
| F353 | shin hub screw 1 shank | steel | 19 x 3 x 3.2 mm | turned | - | 1 g | 2 |
| F354 | shin spacer screw 0 shank | steel | 20 x 4 x 4.1 mm | turned | - | 2 g | 2 |
| F355 | shin spacer screw 1 shank | steel | 20 x 4 x 4.1 mm | turned | - | 2 g | 2 |
| F356 | shin top | 7075-T6 | 100 x 80 x 8.0 mm | cut from 8 mm sheet | - | 171 g | 2 |
| F357 | shin cap | 7075-T6 | 126 x 94 x 8.0 mm | cut from 8 mm sheet | - | 259 g | 2 |
| F358 | shin top screw front 0 shank | steel | 12 x 3 x 3.2 mm | turned | - | 1 g | 2 |
| F359 | shin top screw front 1 shank | steel | 12 x 3 x 3.2 mm | turned | - | 1 g | 2 |
| F360 | shin cleat front | 6061-T6 | 70 x 10 x 10.0 mm | turned or milled | - | 18 g | 2 |
| F361 | shin cleat front wall screw 0 shank | steel | 12 x 3 x 3.2 mm | turned | - | 1 g | 2 |
| F362 | shin cleat front wall screw 1 shank | steel | 12 x 3 x 3.2 mm | turned | - | 1 g | 2 |
| F363 | shin cleat front cap screw 0 shank | steel | 16 x 3 x 3.2 mm | turned | - | 1 g | 2 |
| F364 | shin top screw back 0 shank | steel | 12 x 3 x 3.2 mm | turned | - | 1 g | 2 |
| F365 | shin top screw back 1 shank | steel | 12 x 3 x 3.2 mm | turned | - | 1 g | 2 |
| F366 | shin cleat back | 6061-T6 | 70 x 10 x 10.0 mm | turned or milled | - | 18 g | 2 |
| F367 | shin cleat back wall screw 0 shank | steel | 12 x 3 x 3.2 mm | turned | - | 1 g | 2 |
| F368 | shin cleat back wall screw 1 shank | steel | 12 x 3 x 3.2 mm | turned | - | 1 g | 2 |
| F369 | shin cleat back cap screw 0 shank | steel | 16 x 3 x 3.2 mm | turned | - | 1 g | 2 |
| F370 | shin top screw in 0 shank | steel | 12 x 3 x 3.2 mm | turned | - | 1 g | 2 |
| F371 | shin top screw in 1 shank | steel | 12 x 3 x 3.2 mm | turned | - | 1 g | 2 |
| F372 | shin top screw out 0 shank | steel | 12 x 3 x 3.2 mm | turned | - | 1 g | 2 |
| F373 | shin top screw out 1 shank | steel | 12 x 3 x 3.2 mm | turned | - | 1 g | 2 |
| F374 | ankle plate in | 7075-T6 | 144 x 133 x 8.0 mm | cut from 8 mm sheet | - | 348 g | 2 |
| F375 | ankle spacer | 7075-T6 | 144 x 133 x 8.5 mm | milled from solid; pockets not designed | - | 117 g | 2 |
| F376 | ankle mount plate | 7075-T6 | 144 x 134 x 8.0 mm | cut from 8 mm sheet | - | 178 g | 2 |
| F377 | ankle stack screw 0 shank | steel | 22 x 3 x 3.2 mm | turned | - | 1 g | 2 |
| F378 | ankle stack screw 1 shank | steel | 22 x 3 x 3.2 mm | turned | - | 1 g | 2 |
| F379 | ankle stack screw 2 shank | steel | 22 x 3 x 3.2 mm | turned | - | 1 g | 2 |
| F380 | ankle stack screw 3 shank | steel | 22 x 3 x 3.2 mm | turned | - | 1 g | 2 |
| F381 | ankle stack screw 4 shank | steel | 22 x 3 x 3.2 mm | turned | - | 1 g | 2 |
| F382 | ankle cap screw 0 shank | steel | 16 x 3 x 3.2 mm | turned | - | 1 g | 2 |
| F383 | ankle cap screw 1 shank | steel | 16 x 3 x 3.2 mm | turned | - | 1 g | 2 |
| F384 | ankle mount screw 0 shank | steel | 12 x 3 x 3.2 mm | turned | - | 1 g | 2 |
| F385 | ankle mount screw 1 shank | steel | 12 x 3 x 3.2 mm | turned | - | 1 g | 2 |
| F386 | ankle mount screw 2 shank | steel | 12 x 3 x 3.2 mm | turned | - | 1 g | 2 |
| F387 | ankle mount screw 3 shank | steel | 12 x 3 x 3.2 mm | turned | - | 1 g | 2 |
| F388 | ankle mount screw 4 shank | steel | 12 x 3 x 3.2 mm | turned | - | 1 g | 2 |
| F389 | ankle mount screw 5 shank | steel | 12 x 3 x 3.2 mm | turned | - | 1 g | 2 |
| F390 | ankle mount screw 6 shank | steel | 12 x 3 x 3.2 mm | turned | - | 1 g | 2 |
| F391 | ankle mount screw 7 shank | steel | 12 x 3 x 3.2 mm | turned | - | 1 g | 2 |
| F392 | ankle mount screw 8 shank | steel | 12 x 3 x 3.2 mm | turned | - | 1 g | 2 |
| F393 | ankle mount screw 9 shank | steel | 12 x 3 x 3.2 mm | turned | - | 1 g | 2 |
| F394 | ankle stub | steel | 30 x 30 x 22.0 mm | turned | - | 101 g | 2 |
| F395 | ankle stub screw 0 shank | steel | 12 x 3 x 3.2 mm | turned | - | 1 g | 2 |
| F396 | ankle stub screw 1 shank | steel | 12 x 3 x 3.2 mm | turned | - | 1 g | 2 |
| F397 | ankle stub screw 2 shank | steel | 12 x 3 x 3.2 mm | turned | - | 1 g | 2 |
| F398 | foot plate | 7075-T6 | 306 x 166 x 13.0 mm | milled from solid; pockets not designed | 60 % of solid, assumed | 1107 g | 2 |
| F399 | ankle ear out | 7075-T6 | 184 x 172 x 8.0 mm | cut from 8 mm sheet | - | 472 g | 2 |
| F400 | ankle ear in | 7075-T6 | 184 x 172 x 8.0 mm | cut from 8 mm sheet | - | 473 g | 2 |
| F401 | ankle ear out foot screw 0 shank | steel | 20 x 3 x 3.2 mm | turned | - | 1 g | 2 |
| F402 | ankle ear out foot screw 1 shank | steel | 20 x 3 x 3.2 mm | turned | - | 1 g | 2 |
| F403 | ankle ear out foot screw 2 shank | steel | 20 x 3 x 3.2 mm | turned | - | 1 g | 2 |
| F404 | ankle ear in foot screw 0 shank | steel | 20 x 3 x 3.2 mm | turned | - | 1 g | 2 |
| F405 | ankle ear in foot screw 1 shank | steel | 20 x 3 x 3.2 mm | turned | - | 1 g | 2 |
| F406 | ankle ear in foot screw 2 shank | steel | 20 x 3 x 3.2 mm | turned | - | 1 g | 2 |
| F407 | ankle output | 6061-T6 | 80 x 80 x 12.0 mm | turned or milled | - | 147 g | 2 |
| F408 | ankle screw 0 shank | steel | 10 x 4 x 4.1 mm | turned | - | 1 g | 2 |
| F409 | ankle screw 1 shank | steel | 10 x 4 x 4.1 mm | turned | - | 1 g | 2 |
| F410 | ankle screw 2 shank | steel | 10 x 4 x 4.1 mm | turned | - | 1 g | 2 |
| F411 | ankle screw 3 shank | steel | 10 x 4 x 4.1 mm | turned | - | 1 g | 2 |
| F412 | ankle screw 4 shank | steel | 10 x 4 x 4.1 mm | turned | - | 1 g | 2 |
| F413 | ankle screw 5 shank | steel | 10 x 4 x 4.1 mm | turned | - | 1 g | 2 |
| F414 | ankle screw 6 shank | steel | 10 x 4 x 4.1 mm | turned | - | 1 g | 2 |
| F415 | ankle screw 7 shank | steel | 10 x 4 x 4.1 mm | turned | - | 1 g | 2 |
| F416 | ankle screw 8 shank | steel | 10 x 4 x 4.1 mm | turned | - | 1 g | 2 |
| F417 | ankle ear screw 0 shank | steel | 16 x 4 x 4.1 mm | turned | - | 2 g | 2 |
| F418 | ankle ear screw 1 shank | steel | 16 x 4 x 4.1 mm | turned | - | 2 g | 2 |
| F419 | ankle ear screw 2 shank | steel | 16 x 4 x 4.1 mm | turned | - | 2 g | 2 |
| F420 | ankle ear screw 3 shank | steel | 16 x 4 x 4.1 mm | turned | - | 2 g | 2 |
| F421 | ankle ear screw 4 shank | steel | 16 x 4 x 4.1 mm | turned | - | 2 g | 2 |
| F422 | ankle ear screw 5 shank | steel | 16 x 4 x 4.1 mm | turned | - | 2 g | 2 |
| F423 | ankle bearing housing | 7075-T6 | 80 x 80 x 15.5 mm | milled from solid; pockets not designed | 60 % of solid, assumed | 87 g | 2 |
| F424 | ankle housing screw 0 shank | steel | 16 x 4 x 4.1 mm | turned | - | 2 g | 2 |
| F425 | ankle housing screw 1 shank | steel | 16 x 4 x 4.1 mm | turned | - | 2 g | 2 |
| F426 | ankle housing screw 2 shank | steel | 16 x 4 x 4.1 mm | turned | - | 2 g | 2 |
| F427 | shoe rear screw 0 shank | steel | 20 x 3 x 3.2 mm | turned | - | 1 g | 2 |
| F428 | shoe rear screw 1 shank | steel | 20 x 3 x 3.2 mm | turned | - | 1 g | 2 |
| F429 | shoe front screw 0 shank | steel | 20 x 3 x 3.2 mm | turned | - | 1 g | 2 |
| F430 | shoe front screw 1 shank | steel | 20 x 3 x 3.2 mm | turned | - | 1 g | 2 |
| F431 | neck output L | 6061-T6 | 80 x 80 x 4.0 mm | cut from 4 mm sheet | - | 51 g | 1 |
| F432 | neck output R | 6061-T6 | 80 x 80 x 4.0 mm | cut from 4 mm sheet | - | 51 g | 1 |
| F433 | neck spine | 7075-T6 | 430 x 80 x 60.0 mm | milled from solid; pockets not designed | 25 % of solid, assumed | 1151 g | 1 |
| F434 | neck L screw 0 shank | steel | 12 x 4 x 4.1 mm | turned | - | 1 g | 1 |
| F435 | neck L screw 1 shank | steel | 12 x 4 x 4.1 mm | turned | - | 1 g | 1 |
| F436 | neck L screw 2 shank | steel | 12 x 4 x 4.1 mm | turned | - | 1 g | 1 |
| F437 | neck L screw 3 shank | steel | 12 x 4 x 4.1 mm | turned | - | 1 g | 1 |
| F438 | neck L screw 4 shank | steel | 12 x 4 x 4.1 mm | turned | - | 1 g | 1 |
| F439 | neck L screw 5 shank | steel | 12 x 4 x 4.1 mm | turned | - | 1 g | 1 |
| F440 | neck L screw 6 shank | steel | 12 x 4 x 4.1 mm | turned | - | 1 g | 1 |
| F441 | neck L screw 7 shank | steel | 12 x 4 x 4.1 mm | turned | - | 1 g | 1 |
| F442 | neck L screw 8 shank | steel | 12 x 4 x 4.1 mm | turned | - | 1 g | 1 |
| F443 | neck R screw 0 shank | steel | 12 x 4 x 4.1 mm | turned | - | 1 g | 1 |
| F444 | neck R screw 1 shank | steel | 12 x 4 x 4.1 mm | turned | - | 1 g | 1 |
| F445 | neck R screw 2 shank | steel | 12 x 4 x 4.1 mm | turned | - | 1 g | 1 |
| F446 | neck R screw 3 shank | steel | 12 x 4 x 4.1 mm | turned | - | 1 g | 1 |
| F447 | neck R screw 4 shank | steel | 12 x 4 x 4.1 mm | turned | - | 1 g | 1 |
| F448 | neck R screw 5 shank | steel | 12 x 4 x 4.1 mm | turned | - | 1 g | 1 |
| F449 | neck R screw 6 shank | steel | 12 x 4 x 4.1 mm | turned | - | 1 g | 1 |
| F450 | neck R screw 7 shank | steel | 12 x 4 x 4.1 mm | turned | - | 1 g | 1 |
| F451 | neck R screw 8 shank | steel | 12 x 4 x 4.1 mm | turned | - | 1 g | 1 |
| F452 | head pitch stator plate L | 7075-T6 | 144 x 144 x 8.0 mm | cut from 8 mm sheet | - | 188 g | 1 |
| F453 | head pitch L mount screw 0 shank | steel | 12 x 3 x 3.2 mm | turned | - | 1 g | 1 |
| F454 | head pitch L mount screw 1 shank | steel | 12 x 3 x 3.2 mm | turned | - | 1 g | 1 |
| F455 | head pitch L mount screw 2 shank | steel | 12 x 3 x 3.2 mm | turned | - | 1 g | 1 |
| F456 | head pitch L mount screw 3 shank | steel | 12 x 3 x 3.2 mm | turned | - | 1 g | 1 |
| F457 | head pitch L mount screw 4 shank | steel | 12 x 3 x 3.2 mm | turned | - | 1 g | 1 |
| F458 | head pitch L mount screw 5 shank | steel | 12 x 3 x 3.2 mm | turned | - | 1 g | 1 |
| F459 | head pitch L mount screw 6 shank | steel | 12 x 3 x 3.2 mm | turned | - | 1 g | 1 |
| F460 | head pitch L mount screw 7 shank | steel | 12 x 3 x 3.2 mm | turned | - | 1 g | 1 |
| F461 | head pitch L mount screw 8 shank | steel | 12 x 3 x 3.2 mm | turned | - | 1 g | 1 |
| F462 | head pitch L mount screw 9 shank | steel | 12 x 3 x 3.2 mm | turned | - | 1 g | 1 |
| F463 | head pitch screw 0 shank | steel | 10 x 4 x 4.1 mm | turned | - | 1 g | 1 |
| F464 | head pitch screw 1 shank | steel | 10 x 4 x 4.1 mm | turned | - | 1 g | 1 |
| F465 | head pitch screw 2 shank | steel | 10 x 4 x 4.1 mm | turned | - | 1 g | 1 |
| F466 | head pitch screw 3 shank | steel | 10 x 4 x 4.1 mm | turned | - | 1 g | 1 |
| F467 | head pitch screw 4 shank | steel | 10 x 4 x 4.1 mm | turned | - | 1 g | 1 |
| F468 | head pitch screw 5 shank | steel | 10 x 4 x 4.1 mm | turned | - | 1 g | 1 |
| F469 | head pitch screw 6 shank | steel | 10 x 4 x 4.1 mm | turned | - | 1 g | 1 |
| F470 | head pitch screw 7 shank | steel | 10 x 4 x 4.1 mm | turned | - | 1 g | 1 |
| F471 | head pitch screw 8 shank | steel | 10 x 4 x 4.1 mm | turned | - | 1 g | 1 |
| F472 | head pitch stator tie L | 6061-T6 | 56 x 40 x 10.0 mm | turned or milled | - | 48 g | 1 |
| F473 | head pitch stator tie L screw 0 shank | steel | 80 x 4 x 4.1 mm | turned | - | 8 g | 1 |
| F474 | head pitch stator tie L screw 1 shank | steel | 80 x 4 x 4.1 mm | turned | - | 8 g | 1 |
| F475 | head pitch stator tie L screw 2 shank | steel | 80 x 4 x 4.1 mm | turned | - | 8 g | 1 |
| F476 | head pitch shaft | steel | 150 x 40 x 40.0 mm | turned | 45 % of solid, assumed | 661 g | 1 |
| F477 | head pitch yoke | 7075-T6 | 140 x 122 x 8.0 mm | cut from 8 mm sheet | - | 353 g | 1 |
| F478 | head pitch yoke R | 7075-T6 | 140 x 122 x 8.0 mm | cut from 8 mm sheet | - | 353 g | 1 |
| F479 | head pitch bridge | 7075-T6 | 140 x 116 x 8.0 mm | cut from 8 mm sheet | - | 231 g | 1 |
| F480 | head pitch yoke screw 0 shank | steel | 16 x 3 x 3.2 mm | turned | - | 1 g | 1 |
| F481 | head pitch yoke screw 1 shank | steel | 16 x 3 x 3.2 mm | turned | - | 1 g | 1 |
| F482 | head pitch yoke R screw 0 shank | steel | 16 x 3 x 3.2 mm | turned | - | 1 g | 1 |
| F483 | head pitch yoke R screw 1 shank | steel | 16 x 3 x 3.2 mm | turned | - | 1 g | 1 |
| F484 | head yaw front ring | 7075-T6 | 144 x 144 x 6.0 mm | cut from 6 mm sheet | - | 173 g | 1 |
| F485 | head yaw front ring screw 0 shank | steel | 12 x 3 x 3.2 mm | turned | - | 1 g | 1 |
| F486 | head yaw front ring screw 1 shank | steel | 12 x 3 x 3.2 mm | turned | - | 1 g | 1 |
| F487 | head yaw front ring screw 2 shank | steel | 12 x 3 x 3.2 mm | turned | - | 1 g | 1 |
| F488 | head yaw front ring screw 3 shank | steel | 12 x 3 x 3.2 mm | turned | - | 1 g | 1 |
| F489 | head yaw front ring screw 4 shank | steel | 12 x 3 x 3.2 mm | turned | - | 1 g | 1 |
| F490 | head yaw front ring screw 5 shank | steel | 12 x 3 x 3.2 mm | turned | - | 1 g | 1 |
| F491 | head yaw front ring screw 6 shank | steel | 12 x 3 x 3.2 mm | turned | - | 1 g | 1 |
| F492 | head yaw front ring screw 7 shank | steel | 12 x 3 x 3.2 mm | turned | - | 1 g | 1 |
| F493 | head yaw front post 0 | 6061-T6 | 39 x 12 x 12.0 mm | turned or milled | - | 14 g | 1 |
| F494 | head yaw front post 0 screw top 0 shank | steel | 12 x 3 x 3.2 mm | turned | - | 1 g | 1 |
| F495 | head yaw front post 0 screw base 0 shank | steel | 20 x 4 x 4.1 mm | turned | - | 2 g | 1 |
| F496 | head yaw front post 1 | 6061-T6 | 39 x 12 x 12.0 mm | turned or milled | - | 14 g | 1 |
| F497 | head yaw front post 1 screw top 0 shank | steel | 12 x 3 x 3.2 mm | turned | - | 1 g | 1 |
| F498 | head yaw front post 1 screw base 0 shank | steel | 20 x 4 x 4.1 mm | turned | - | 2 g | 1 |
| F499 | head yaw front post 2 | 6061-T6 | 39 x 12 x 12.0 mm | turned or milled | - | 14 g | 1 |
| F500 | head yaw front post 2 screw top 0 shank | steel | 12 x 3 x 3.2 mm | turned | - | 1 g | 1 |
| F501 | head yaw front post 2 screw base 0 shank | steel | 20 x 4 x 4.1 mm | turned | - | 2 g | 1 |
| F502 | head yaw front post 3 | 6061-T6 | 39 x 12 x 12.0 mm | turned or milled | - | 14 g | 1 |
| F503 | head yaw front post 3 screw top 0 shank | steel | 12 x 3 x 3.2 mm | turned | - | 1 g | 1 |
| F504 | head yaw front post 3 screw base 0 shank | steel | 20 x 4 x 4.1 mm | turned | - | 2 g | 1 |
| F505 | head yaw mount screw 0 shank | steel | 16 x 3 x 3.2 mm | turned | - | 1 g | 1 |
| F506 | head yaw mount screw 1 shank | steel | 16 x 3 x 3.2 mm | turned | - | 1 g | 1 |
| F507 | head yaw mount screw 2 shank | steel | 16 x 3 x 3.2 mm | turned | - | 1 g | 1 |
| F508 | head yaw mount screw 3 shank | steel | 16 x 3 x 3.2 mm | turned | - | 1 g | 1 |
| F509 | head yaw output | 6061-T6 | 80 x 80 x 8.0 mm | cut from 8 mm sheet | - | 103 g | 1 |
| F510 | head yaw plate | 7075-T6 | 216 x 120 x 8.0 mm | cut from 8 mm sheet | - | 576 g | 1 |
| F511 | head yaw screw 0 shank | steel | 8 x 3 x 3.2 mm | turned | - | 1 g | 1 |
| F512 | head yaw screw 1 shank | steel | 8 x 3 x 3.2 mm | turned | - | 1 g | 1 |
| F513 | head yaw screw 2 shank | steel | 8 x 3 x 3.2 mm | turned | - | 1 g | 1 |
| F514 | head yaw screw 3 shank | steel | 8 x 3 x 3.2 mm | turned | - | 1 g | 1 |
| F515 | head yaw screw 4 shank | steel | 8 x 3 x 3.2 mm | turned | - | 1 g | 1 |
| F516 | head yaw screw 5 shank | steel | 8 x 3 x 3.2 mm | turned | - | 1 g | 1 |
| F517 | head yaw plate screw 0 shank | steel | 14 x 3 x 3.2 mm | turned | - | 1 g | 1 |
| F518 | head yaw plate screw 1 shank | steel | 14 x 3 x 3.2 mm | turned | - | 1 g | 1 |
| F519 | head yaw plate screw 2 shank | steel | 14 x 3 x 3.2 mm | turned | - | 1 g | 1 |
| F520 | head yaw plate screw 3 shank | steel | 14 x 3 x 3.2 mm | turned | - | 1 g | 1 |
| F521 | head yaw plate screw 4 shank | steel | 14 x 3 x 3.2 mm | turned | - | 1 g | 1 |
| F522 | head yaw plate screw 5 shank | steel | 14 x 3 x 3.2 mm | turned | - | 1 g | 1 |
| F523 | head roll cradle | 7075-T6 | 127 x 120 x 8.0 mm | cut from 8 mm sheet | - | 210 g | 1 |
| F524 | head roll cradle screw 0 shank | steel | 16 x 3 x 3.2 mm | turned | - | 1 g | 1 |
| F525 | head roll cradle screw 1 shank | steel | 16 x 3 x 3.2 mm | turned | - | 1 g | 1 |
| F526 | head roll cradle screw 2 shank | steel | 16 x 3 x 3.2 mm | turned | - | 1 g | 1 |
| F527 | head roll front ring | 7075-T6 | 144 x 144 x 6.0 mm | cut from 6 mm sheet | - | 173 g | 1 |
| F528 | head roll front ring screw 0 shank | steel | 12 x 3 x 3.2 mm | turned | - | 1 g | 1 |
| F529 | head roll front ring screw 1 shank | steel | 12 x 3 x 3.2 mm | turned | - | 1 g | 1 |
| F530 | head roll front ring screw 2 shank | steel | 12 x 3 x 3.2 mm | turned | - | 1 g | 1 |
| F531 | head roll front ring screw 3 shank | steel | 12 x 3 x 3.2 mm | turned | - | 1 g | 1 |
| F532 | head roll front ring screw 4 shank | steel | 12 x 3 x 3.2 mm | turned | - | 1 g | 1 |
| F533 | head roll front ring screw 5 shank | steel | 12 x 3 x 3.2 mm | turned | - | 1 g | 1 |
| F534 | head roll front ring screw 6 shank | steel | 12 x 3 x 3.2 mm | turned | - | 1 g | 1 |
| F535 | head roll front ring screw 7 shank | steel | 12 x 3 x 3.2 mm | turned | - | 1 g | 1 |
| F536 | head roll front post 0 | 6061-T6 | 39 x 12 x 12.0 mm | turned or milled | - | 14 g | 1 |
| F537 | head roll front post 0 screw top 0 shank | steel | 12 x 3 x 3.2 mm | turned | - | 1 g | 1 |
| F538 | head roll front post 0 screw base 0 shank | steel | 20 x 4 x 4.1 mm | turned | - | 2 g | 1 |
| F539 | head roll front post 1 | 6061-T6 | 39 x 12 x 12.0 mm | turned or milled | - | 14 g | 1 |
| F540 | head roll front post 1 screw top 0 shank | steel | 12 x 3 x 3.2 mm | turned | - | 1 g | 1 |
| F541 | head roll front post 1 screw base 0 shank | steel | 20 x 4 x 4.1 mm | turned | - | 2 g | 1 |
| F542 | head roll front post 2 | 6061-T6 | 39 x 12 x 12.0 mm | turned or milled | - | 14 g | 1 |
| F543 | head roll front post 2 screw top 0 shank | steel | 12 x 3 x 3.2 mm | turned | - | 1 g | 1 |
| F544 | head roll front post 2 screw base 0 shank | steel | 20 x 4 x 4.1 mm | turned | - | 2 g | 1 |
| F545 | head roll front post 3 | 6061-T6 | 39 x 12 x 12.0 mm | turned or milled | - | 14 g | 1 |
| F546 | head roll front post 3 screw top 0 shank | steel | 12 x 3 x 3.2 mm | turned | - | 1 g | 1 |
| F547 | head roll front post 3 screw base 0 shank | steel | 20 x 4 x 4.1 mm | turned | - | 2 g | 1 |
| F548 | head roll mount screw 0 shank | steel | 16 x 3 x 3.2 mm | turned | - | 1 g | 1 |
| F549 | head roll mount screw 1 shank | steel | 16 x 3 x 3.2 mm | turned | - | 1 g | 1 |
| F550 | head roll mount screw 2 shank | steel | 16 x 3 x 3.2 mm | turned | - | 1 g | 1 |
| F551 | head roll mount screw 3 shank | steel | 16 x 3 x 3.2 mm | turned | - | 1 g | 1 |
| F552 | head roll output | 6061-T6 | 64 x 64 x 10.0 mm | turned or milled | - | 79 g | 1 |
| F553 | head roll screw 0 shank | steel | 8 x 3 x 3.2 mm | turned | - | 1 g | 1 |
| F554 | head roll screw 1 shank | steel | 8 x 3 x 3.2 mm | turned | - | 1 g | 1 |
| F555 | head roll screw 2 shank | steel | 8 x 3 x 3.2 mm | turned | - | 1 g | 1 |
| F556 | head roll screw 3 shank | steel | 8 x 3 x 3.2 mm | turned | - | 1 g | 1 |
| F557 | head roll screw 4 shank | steel | 8 x 3 x 3.2 mm | turned | - | 1 g | 1 |
| F558 | head roll screw 5 shank | steel | 8 x 3 x 3.2 mm | turned | - | 1 g | 1 |
| F559 | head main frame | 6061-T6 | 400 x 240 x 8.0 mm | cut from 8 mm sheet | 25 % of solid, assumed | 514 g | 1 |
| F560 | head main frame screw 0 shank | steel | 16 x 3 x 3.2 mm | turned | - | 1 g | 1 |
| F561 | head main frame screw 1 shank | steel | 16 x 3 x 3.2 mm | turned | - | 1 g | 1 |
| F562 | head main frame screw 2 shank | steel | 16 x 3 x 3.2 mm | turned | - | 1 g | 1 |
| F563 | head main frame screw 3 shank | steel | 16 x 3 x 3.2 mm | turned | - | 1 g | 1 |
| F564 | head main frame screw 4 shank | steel | 16 x 3 x 3.2 mm | turned | - | 1 g | 1 |
| F565 | head main frame screw 5 shank | steel | 16 x 3 x 3.2 mm | turned | - | 1 g | 1 |
| F566 | head rail L | 6061-T6 | 737 x 20 x 12.0 mm | turned or milled | 30 % of solid, assumed | 140 g | 1 |
| F567 | head rail L screw main 0 shank | steel | 20 x 3 x 3.2 mm | turned | - | 1 g | 1 |
| F568 | head rail L screw main 1 shank | steel | 20 x 3 x 3.2 mm | turned | - | 1 g | 1 |
| F569 | head rail L screw rear 0 shank | steel | 16 x 3 x 3.2 mm | turned | - | 1 g | 1 |
| F570 | head rail L screw rear 1 shank | steel | 16 x 3 x 3.2 mm | turned | - | 1 g | 1 |
| F571 | head rail L screw front 0 shank | steel | 16 x 3 x 3.2 mm | turned | - | 1 g | 1 |
| F572 | head rail L screw front 1 shank | steel | 16 x 3 x 3.2 mm | turned | - | 1 g | 1 |
| F573 | head beak lug L | 6061-T6 | 40 x 40 x 4.5 mm | cut from 5 mm sheet | - | 18 g | 1 |
| F574 | head beak lug L screw 0 shank | steel | 10 x 3 x 3.2 mm | turned | - | 1 g | 1 |
| F575 | head beak lug L screw 1 shank | steel | 10 x 3 x 3.2 mm | turned | - | 1 g | 1 |
| F576 | head beak mount screw L 0 shank | steel | 20 x 3 x 3.2 mm | turned | - | 1 g | 1 |
| F577 | head beak mount screw L 1 shank | steel | 20 x 3 x 3.2 mm | turned | - | 1 g | 1 |
| F578 | head rail R | 6061-T6 | 737 x 20 x 12.0 mm | turned or milled | 30 % of solid, assumed | 140 g | 1 |
| F579 | head rail R screw main 0 shank | steel | 20 x 3 x 3.2 mm | turned | - | 1 g | 1 |
| F580 | head rail R screw main 1 shank | steel | 20 x 3 x 3.2 mm | turned | - | 1 g | 1 |
| F581 | head rail R screw rear 0 shank | steel | 16 x 3 x 3.2 mm | turned | - | 1 g | 1 |
| F582 | head rail R screw rear 1 shank | steel | 16 x 3 x 3.2 mm | turned | - | 1 g | 1 |
| F583 | head rail R screw front 0 shank | steel | 16 x 3 x 3.2 mm | turned | - | 1 g | 1 |
| F584 | head rail R screw front 1 shank | steel | 16 x 3 x 3.2 mm | turned | - | 1 g | 1 |
| F585 | head beak lug R | 6061-T6 | 40 x 40 x 4.5 mm | cut from 5 mm sheet | - | 18 g | 1 |
| F586 | head beak lug R screw 0 shank | steel | 10 x 3 x 3.2 mm | turned | - | 1 g | 1 |
| F587 | head beak lug R screw 1 shank | steel | 10 x 3 x 3.2 mm | turned | - | 1 g | 1 |
| F588 | head beak mount screw R 0 shank | steel | 20 x 3 x 3.2 mm | turned | - | 1 g | 1 |
| F589 | head beak mount screw R 1 shank | steel | 20 x 3 x 3.2 mm | turned | - | 1 g | 1 |
| F590 | head rear frame | 6061-T6 | 400 x 90 x 8.0 mm | cut from 8 mm sheet | 30 % of solid, assumed | 231 g | 1 |
| F591 | head front frame | 6061-T6 | 400 x 200 x 8.0 mm | cut from 8 mm sheet | 30 % of solid, assumed | 516 g | 1 |
| F592 | head beak mount | 6061-T6 | 376 x 60 x 8.0 mm | cut from 8 mm sheet | 45 % of solid, assumed | 217 g | 1 |
| F593 | beak hinge L | 6061-T6 | 110 x 40 x 8.0 mm | cut from 8 mm sheet | - | 93 g | 1 |
| F594 | beak hinge R | 6061-T6 | 110 x 40 x 8.0 mm | cut from 8 mm sheet | - | 93 g | 1 |
| F595 | beak tray frame | 6061-T6 | 410 x 300 x 8.0 mm | cut from 8 mm sheet | 25 % of solid, assumed | 662 g | 1 |
| F596 | beak hinge L screw 0 shank | steel | 16 x 3 x 3.2 mm | turned | - | 1 g | 1 |
| F597 | beak hinge L screw 1 shank | steel | 16 x 3 x 3.2 mm | turned | - | 1 g | 1 |
| F598 | beak hinge R screw 0 shank | steel | 16 x 3 x 3.2 mm | turned | - | 1 g | 1 |
| F599 | beak hinge R screw 1 shank | steel | 16 x 3 x 3.2 mm | turned | - | 1 g | 1 |

### Printed

Panels within a 256 mm bed by `tools/checks.py`. Masses are 3 mm walls in the shape; the panels carry no load, and have no bosses or fixings.

| Item | Part | Material | Envelope | Mass each | Qty per robot |
|---|---|---|---|---|---|
| P1 | body panel RR | PETG | 232 x 216 x 205 mm | 261 g | 1 |
| P2 | body panel RL | PETG | 232 x 216 x 205 mm | 261 g | 1 |
| P3 | body panel MR | PETG | 216 x 205 x 138 mm | 110 g | 1 |
| P4 | body panel ML | PETG | 216 x 205 x 138 mm | 110 g | 1 |
| P5 | body panel FR | PETG | 216 x 205 x 129 mm | 88 g | 1 |
| P6 | body panel FL | PETG | 216 x 205 x 129 mm | 88 g | 1 |
| P7 | thigh cover out hip | PETG | 154 x 132 x 3 mm | 67 g | 2 |
| P8 | thigh cover out rear | PETG | 206 x 190 x 3 mm | 106 g | 2 |
| P9 | thigh cover out knee | PETG | 240 x 100 x 3 mm | 54 g | 2 |
| P10 | shin cover front | PETG | 170 x 122 x 71 mm | 101 g | 2 |
| P11 | shin cover back | PETG | 170 x 122 x 71 mm | 101 g | 2 |
| P12 | sole rear | TPU | 190 x 180 x 34 mm | 315 g | 2 |
| P13 | sole front | TPU | 190 x 150 x 34 mm | 258 g | 2 |
| P14 | shoe rear | PETG | 190 x 180 x 40 mm | 162 g | 2 |
| P15 | shoe front | PETG | 190 x 150 x 40 mm | 276 g | 2 |
| P16 | hood panel 0Ru | PETG | 180 x 132 x 118 mm | 62 g | 1 |
| P17 | hood panel 0Rl | PETG | 233 x 150 x 135 mm | 80 g | 1 |
| P18 | hood panel 0c | PETG | 240 x 194 x 130 mm | 118 g | 1 |
| P19 | hood panel 0Lu | PETG | 180 x 132 x 118 mm | 62 g | 1 |
| P20 | hood panel 0Ll | PETG | 233 x 150 x 135 mm | 80 g | 1 |
| P21 | hood panel 1Ru | PETG | 220 x 150 x 140 mm | 121 g | 1 |
| P22 | hood panel 1Rl | PETG | 220 x 164 x 135 mm | 77 g | 1 |
| P23 | hood panel 1c | PETG | 240 x 220 x 150 mm | 136 g | 1 |
| P24 | hood panel 1Lu | PETG | 220 x 150 x 140 mm | 121 g | 1 |
| P25 | hood panel 1Ll | PETG | 220 x 164 x 135 mm | 77 g | 1 |
| P26 | hood panel 2Ru | PETG | 210 x 176 x 161 mm | 134 g | 1 |
| P27 | hood panel 2Rl | PETG | 210 x 187 x 135 mm | 73 g | 1 |
| P28 | hood panel 2c | PETG | 240 x 210 x 169 mm | 130 g | 1 |
| P29 | hood panel 2Lu | PETG | 210 x 176 x 161 mm | 134 g | 1 |
| P30 | hood panel 2Ll | PETG | 210 x 187 x 135 mm | 73 g | 1 |
| P31 | hood panel 3Ru | PETG | 215 x 190 x 181 mm | 160 g | 1 |
| P32 | hood panel 3Rl | PETG | 215 x 199 x 135 mm | 75 g | 1 |
| P33 | hood panel 3c | PETG | 240 x 215 x 187 mm | 132 g | 1 |
| P34 | hood panel 3Lu | PETG | 215 x 190 x 181 mm | 160 g | 1 |
| P35 | hood panel 3Ll | PETG | 215 x 199 x 135 mm | 75 g | 1 |
| P36 | face panel 0u | PETG | 174 x 166 x 4 mm | 107 g | 1 |
| P37 | face panel 0l | PETG | 183 x 135 x 4 mm | 124 g | 1 |
| P38 | face panel 1u | PETG | 240 x 172 x 4 mm | 208 g | 1 |
| P39 | face panel 1l | PETG | 240 x 135 x 4 mm | 165 g | 1 |
| P40 | face panel 2u | PETG | 174 x 166 x 4 mm | 107 g | 1 |
| P41 | face panel 2l | PETG | 183 x 135 x 4 mm | 124 g | 1 |
| P42 | bill panel 00 | PETG | 223 x 153 x 35 mm | 91 g | 1 |
| P43 | bill panel 01 | PETG | 240 x 80 x 35 mm | 97 g | 1 |
| P44 | bill panel 02 | PETG | 223 x 153 x 35 mm | 91 g | 1 |
| P45 | bill panel 10 | PETG | 220 x 101 x 35 mm | 115 g | 1 |
| P46 | bill panel 12 | PETG | 220 x 101 x 35 mm | 115 g | 1 |
| P47 | bill panel 20 | PETG | 210 x 86 x 35 mm | 88 g | 1 |
| P48 | bill panel 22 | PETG | 210 x 86 x 35 mm | 88 g | 1 |
| P49 | bill panel 30 | PETG | 218 x 202 x 35 mm | 149 g | 1 |
| P50 | bill panel 31 | PETG | 240 x 38 x 35 mm | 65 g | 1 |
| P51 | bill panel 32 | PETG | 218 x 202 x 35 mm | 149 g | 1 |
| P52 | eye ring | PETG | 210 x 210 x 16 mm | 300 g | 1 |
| P53 | eye lens | PETG | 120 x 120 x 12 mm | 100 g | 1 |
| P54 | beak panel 0 | PETG | 197 x 135 x 84 mm | 157 g | 1 |
| P55 | beak panel 1 | PETG | 207 x 135 x 84 mm | 142 g | 1 |
| P56 | beak panel 2 | PETG | 197 x 135 x 84 mm | 157 g | 1 |
| P57 | beak panel 3 | PETG | 197 x 135 x 84 mm | 195 g | 1 |
| P58 | beak panel 4 | PETG | 207 x 135 x 84 mm | 184 g | 1 |
| P59 | beak panel 5 | PETG | 197 x 135 x 84 mm | 195 g | 1 |

## Open before ordering

All of these stay open. Nothing here has been settled by a test or by anyone qualified to sign it off.

### Could hurt someone

- **No stress analysis.** Plates, shafts, pins, rods and screws have a hand estimate at most. Rods carry about 2 kN mid stroke and 3-4 kN at the ends on 10 mm pins, in 5 mm plate, on 14 x 10 bronze bushes held on by E-clips: none of it sized. The hip yaw beam, hip yoke and shin take the whole robot.
- **Metal frames unchecked.** No FEA, fatigue check, weld or joint design. Many frames are solid blocks with an assumed fill, so their real strength and mass are both unknown: pocketing them may take away what they need, and leaving them solid adds mass.
- **No real actuator has been measured.** RobStride's STEP files have now been read in Fusion (see below), and the hole circles and steps in the spec come from them. A file isn't a part: measure a real one before cutting metal.
- **No brakes.** RobStride's manual describes damping when back-driven with the power off, not a brake. Power loss, a tripped branch, the emergency stop or a BMS cut-off all drop 100 kg. A fault in a branch is one the board can't recover from without restarting. So a hoist for every power-on, and nobody under or beside it.
- **How it falls.** Not studied. Nothing protects the frames, the head, the battery or people nearby. A 1.2 kWh lithium pack in a falling robot needs its own case and impact design.
- **Battery.** A candidate only, and not tested. It has no BMS: one has to take back braking current and allow the peaks, and if it cuts out, the robot drops. Fire safety for 1.2 kWh of bare soft pack in a machine that falls isn't designed.
- **Pinch points.** Cranks, rods, the chain, and paired actuators can take a hand off. No guards are designed.
- **Paired actuators.** Hips and knees share one axis between two actuators. If one faults, or their zeros differ, they fight each other through the frame. No startup check or fault response is written.
- **Chain.** The tensioner, guards, fatigue and what happens if it breaks: the head and its yaw and roll, about 14 kg, drop. Not designed.

### The real actuators against the model

- **Shape: read from the STEP files, 2026-11-05.** The RS04 is 120 across for 39 mm and 94 across for its rear 13.2, as the manual's figure says; 55.7 long pin tip to tail, 52.7 from output face to tail; the output face stands 0.5 past the stator's. The RS03 isn't a cylinder: 92.8 across with 8 lobes to 106.6, a rear step 79.5 across and 14.6 long, 56.6 long. The RS00 is 57 x 52.1. So every stator now hangs by its shoulder, through a plate bored for the step. The plates on rear faces were an error: there's no flat rear face to bolt to. No file holds a mass, so the 1.42 kg stays the retailer's.
- **Cable.** Each RS04's leaves in a 7.3 mm sleeve, radially, 6.3 mm behind the shoulder, ending at r 58.1: each plate has a 9 mm window for it, closed at r 64, between two screws. The cable then lies on the plate's far side. Routes are sketched in [wiring](WIRING.md), not drawn: nobody has shown the 310 mm reaches, and the cable's real bend radius is unread. The RS03's plugs are on the sides of its rear step, past its plate. Not designed: strain relief, guards, and the moving loops across each joint.
- **Pins.** 3 x 6 mm on 35.86, standing 3.0 mm in the file, not the manual's 3.3. Every flange now has holes for them, 3.5 deep. The RS03 has 3 x 4 mm holes, 7 deep, not pins: its flanges want bought dowels, modelled as holes only. They may be what carries the torque: ask RobStride what the screws and pins are each rated for.
- **Screws: the thread is the problem.** The file's RS04 output holes are blind at 3.5 mm, where the manual says 6.5 (6.5 is the file's distance from that floor to the pin tips, so the figure may be read wrongly). Every output screw is now sized to engage 3 mm, so none bottoms. That's under 4 turns of M5, on 9 screws. **Measure a real one**: if 3.5 is right, the screws may hold little, and the pins everything. Lengths by joint are in the spec and [the Fusion notes](FUSION.md).
- **Frame joints: designed for fit, not strength (2026-11-05).** Every pair of metal parts that touch now shares a screw, or a named fit, key or strap (`HELD` in `spec/big_duck.py`), and an assembly order exists that `tools/big_assembly.py` checks: each part's way in, each screw's straight path and key, thread engagement at least 1.25 x the diameter, metal round every hole. See [ASSEMBLY.md](ASSEMBLY.md). What that leaves: many joints are M4 tapped into the edge of 8 mm plate (2.4 mm of wall each side), the head pitch stator plate hangs from one tie, the head roll cradle from 3 M4 into its edge, and the hip roll cheeks from 5 M5 each. Nobody has checked any of them carries its load. Fits (H7, N7, k6, r6) and keys are named, not drawn. The tools for printed parts still don't run on this duck: `buildable`, `export_prints`, `printable`, `beak_linkage`.
- **Panels have no fixings.** The body, hood, face, bill, beak and shin panels touch the frame, and some cut into it, with nothing designed to hold them: the assembly check lists them as warnings. Only the thigh covers and the shoes are screwed on.
- **Torque and heat.** The 40 N m rating needs the RS04 on a 345 x 345 mm aluminium plate; 35 on 220 x 200. These frames are neither, so true ratings are lower and unknown. The manual's overload table, on that large plate: 120 N m for 3 s, 100 for 15 s, 80 for 38 s, 60 for 108 s, 50 for 324 s. So the "240 N m" pair is a 3-second number. A crouch asks each knee RS04 for about 34 N m, and the first walk for about 55, RMS: minutes at best. The manual's winding limit is 145 C.
- **Numbers disagree.** RobStride's selection table says the RS04 runs on 15-60 V, its manual 24-60. The retailer gives 1.5 kg and 1420 g on one page.
- **The beak.** Its rod and crank aren't designed. Nor is the head's contents: 0.6 kg of "head boards and camera" is a placeholder. The RS00's real connector is on its side.

### Power and control

- **Current has never been measured or simulated.** Each leg gets one 20 A rated, 40 A peak branch, 1.9 kW at 48 V peak, for 8 RS04s of 700 W rated each. It may need more branches or a second board. Exceeding it stops the leg until a restart, and the robot falls.
- **Regenerated power.** Set the board's discharge point (parameter 0x8003) with care. Its manual has discharge start at this value plus 6 V, and the actuators' maximum is 60 V, so with a 54.6 V pack it should read 54, not its default 58. Nothing has tested this.
- **Layout.** The model's single box, 90 x 170 x 30 mm, stands for the computer and board and shows no connectors. On the real board the battery, resistor and rail connectors face one edge and the branches the opposite, and the gap to the battery is 10 mm. The boards have to be modelled, and it probably won't fit as it is.
- **CAN.** Stubs are 350 mm by the harness, over the 300 mm usually allowed at 1 Mbps: test for errors or cut them. Whether each actuator has its own terminator is unclear: RobStride's firmware notes mention one on an older RS03. Measure each bus between H and L with the power off.
- **Sources.** All actuators are on backorder at the shop read, and no second US source was confirmed. Items with "not chosen" have no source. The CAN hub's page wouldn't open.
- **Software.** The Pi code is for the small ducks' serial servos. RobStride has its own CAN protocol, unwritten here.
- **Amazon links.** Only the 2 parts shared with the all-Dynamixel duck have product links, as last read for it. Every other is a search nobody has followed. Confirm before ordering.
- **Not in this design:** the walk's own limits (it overloads its knee at 0.33 m/s; see [the notes](../DETAILS.md#a-big-duck)), speaker, microphone.
