meetsitaram/duck-droids/docs/feetech/BOM.md

# All-Feetech duck: bill of materials

> **This is the parts list for the all-Feetech duck only.** Each duck has its own parts, prints and BOM, and they don't mix. Other ducks: [all-Dynamixel](../dynamixel/BOM.md) · [HD-1910](../hd1910/BOM.md) · [hybrid](../hybrid/BOM.md) · [hobby-servo](../hobby/BOM.md) · [nano](../nano/BOM.md) · [big](../big/BOM.md). <!-- variant banner -->

| | |
|---|---|
| Product | All-Feetech duck, biped, 15 servos |
| Height, mass | 0.379 m, 1.94 kg as modelled |
| Build quantity | Quantities are for 1 robot |
| Fabricated parts | 42 printed parts, 688 g PLA and 86 g TPU 95A |
| Status | Prototype: no unit built, no part test printed |
| Prices | USD, as listed 2026-11-02 to 2026-11-06, before tax and shipping. Confirm before ordering |
| Related | [Print files](../../prints/feetech/README.md), [wiring](WIRING.md), [assembly](ASSEMBLY.md) |

Generated by `tools/make_docs.py` from the spec. Quantities match the model.

## Cost summary

| Group | Required parts, priced |
|---|---|
| Actuators | $264.95 |
| Bearings | $25.18 |
| Fasteners | $47.23 |
| Electronics | $80.67 |
| Power and wiring | $54.87 |
| Consumables | $12.00 |
| Support equipment (not in the robot) | $9.49 |
| **Total of quoted lines** | **$494.39** |

5 required lines have no quote yet and are not in the total, nor is filament. Optional parts add $16.99 on the quoted lines.

## Purchased parts

Every line is required unless it starts with **OPTIONAL**. Optional lines show their quantities in brackets and are not in the total.

### Actuators

| Item | Part | Maker / part number | Specification | Qty per robot | Order unit | Order qty | Unit price | Line price | Source |
|---|---|---|---|---|---|---|---|---|---|
| 1 | Smart servo: hip roll, hip pitch, knee, ankle, neck, head pitch | Feetech STS3215-C044 (also sold as ST3215 C044) | 7.4 V, 1:191. Sellers list 3.8 A stall, 1.2 A rated, and 16 to 27.4 kg cm of stall torque | 10 | each | 10 | $19.00 | $190.00 | [Seeed](https://www.seeedstudio.com/Feetech-ST-3215-C044-Heavy-Duty-Servo-7-4V-1-191-Gear-Reduction-p-6460.html): $20, $19 for 10 or more, in stock on 2026-11-05. Second source [Amazon, MengJie](https://www.amazon.com/dp/B0H3THGR55), 7 left on 2026-11-02<br>[Search Amazon](https://www.amazon.com/s?k=Feetech+STS3215+C044+7.4V+1%3A191) |
| 2 | Smart servo: hip yaw, head yaw, head roll, beak | Feetech STS3215-C046 | 7.4 V, 1:147, 14.4 kg cm listed. **Numbers scaled from the C001, not measured** | 5 | each | 5 | $14.99 | $74.95 | [WowRobo](https://shop.wowrobo.com/products/feetech-sts3215-c046-servo-7-4v-14-4kg-1-147-servo-for-so-arm101): $14.99 each for 5, from a search's copy of the page. Second source [OpenELAB](https://openelab.com/products/feetech-sts3215-c046-servo) at $23.99; [Amazon, MengJie](https://www.amazon.com/dp/B0H3TNG1Z6), 6 left on 2026-11-02<br>[Search Amazon](https://www.amazon.com/s?k=Feetech+STS3215+C046+7.4V+1%3A147) |

### Bearings

| Item | Part | Maker / part number | Specification | Qty per robot | Order unit | Order qty | Unit price | Line price | Source |
|---|---|---|---|---|---|---|---|---|---|
| 3 | Ball bearing, around each horn | 6704ZZ | 20 x 27 x 4 mm | 10 | pack of 10 | 1 | $18.39 | $18.39 | [Amazon, uxcell](https://www.amazon.com/dp/B082PSB7NH)<br>[Search Amazon](https://www.amazon.com/s?k=6704ZZ+bearing+20x27x4mm) |
| 4 | Ball bearing, shoe inner ear | 6700ZZ | 10 x 15 x 4 mm | 2 | pack of 10 | 1 | $6.79 | $6.79 | [Amazon](https://www.amazon.com/dp/B0FQ4VYXRP)<br>[Search Amazon](https://www.amazon.com/s?k=6700ZZ+bearing+10x15x4mm) |

### Fasteners

| Item | Part | Maker / part number | Specification | Qty per robot | Order unit | Order qty | Unit price | Line price | Source |
|---|---|---|---|---|---|---|---|---|---|
| 5 | Screws, self-tapping pan head: 54 x M2 x 6, 38 x M2 x 8 | generic | kit of 800, 100 of each of these lengths as listed | 92 | kit | 1 | $15.66 | $15.66 | [Amazon](https://www.amazon.com/dp/B0GV338JJK)<br>[Search Amazon](https://www.amazon.com/s?k=M2+self+tapping+pan+head+screw+kit) |
| 6 | Screws, socket cap: 20 x M3 x 8, 41 x M3 x 10, 16 x M3 x 12 | generic | kit of 610 with nuts and washers | 77 | kit | 1 | $19.99 | $19.99 | [Amazon](https://www.amazon.com/dp/B09NR8X2LV)<br>[Search Amazon](https://www.amazon.com/s?k=M3+socket+cap+screw+kit) |
| 7 | Screw, flat head socket, ankle rear horn | generic | M3 x 6 mm | 8 | pack of 100 | 1 | $5.99 | $5.99 | [Amazon](https://www.amazon.com/dp/B01HBN0U76)<br>[Search Amazon](https://www.amazon.com/s?k=M3+x+6mm+flat+head+socket+screw) |
| 8 | Screw, bus board, machine thread | generic | M2.5 x 5 mm, pan head, Phillips, black oxide 18-8 stainless, DIN 7985 | 8 | pack of 100 | 1 | $5.59 | $5.59 | [Zoro G816462679](https://www.zoro.com/zoro-select-m25x045-x-5-mm-phillips-pan-machine-screw-black-oxide-stainless-steel-100-pk-31-bpm-25-5/i/G816462679/): $5.59 by a search result; the page refuses automated reading, so confirm it<br>[Search Amazon](https://www.amazon.com/s?k=M2.5+x+5mm+pan+head+machine+screw+black+oxide) |
| 9 | **OPTIONAL:** Spare hex standoffs, bus board: 4 come with the Waveshare board | uxcell | brass, M2.5, female-female, 8 mm long, 5 mm across flats | - | pack of 50 | (1) | - | - | Amazon<br>[Search Amazon](https://www.amazon.com/s?k=uxcell+M2.5+x+8mm+female+female+hex+brass+standoff) |
| 10 | Washer, far hinge tab to hood | uxcell | M3, 6 mm outside, 0.5 mm thick, stainless | 1 | pack of 100 | 1 | - | - | [Amazon](https://www.amazon.com/dp/B015A39NCC)<br>[Search Amazon](https://www.amazon.com/s?k=uxcell+M3+x+6mm+x+0.5mm+flat+washer) |

### Electronics

| Item | Part | Maker / part number | Specification | Qty per robot | Order unit | Order qty | Unit price | Line price | Source |
|---|---|---|---|---|---|---|---|---|---|
| 11 | Computer | Raspberry Pi Zero 2 W | without header | 1 | each | 1 | $17.25 | $17.25 | [PiShop](https://www.pishop.us/product/raspberry-pi-zero-2-w/): out of stock on 2026-11-03<br>[Search Amazon](https://www.amazon.com/s?k=Raspberry+Pi+Zero+2+W) |
| 12 | microSD card | SanDisk Ultra | 32 GB microSDHC, A1, Class 10, UHS-I | 1 | each | 1 | $22.49 | $22.49 | [Amazon](https://www.amazon.com/dp/B08L5HMJVW)<br>[Search Amazon](https://www.amazon.com/s?k=SanDisk+32GB+Ultra+microSDHC+A1) |
| 13 | Servo bus board | Waveshare Bus Servo Adapter (A), SKU 25514 | USB-C, 2 servo sockets, 5264 compatible, also sold as Serial Bus Servo Driver Board | 1 | each | 1 | $12.47 | $12.47 | [Amazon](https://www.amazon.com/dp/B0CTMM4LWK). Second source [Abra](https://abra-electronics.com/electromechanical/motors/motor-controllers/wave-25514-serial-bus-servo-driver-board.html) at $9.05<br>[Search Amazon](https://www.amazon.com/s?k=Waveshare+Serial+Bus+Servo+Driver+Board) |
| 14 | 5 V regulator | hiBCTR USB buck converter QC3.0 | 6-32 V in, 35 x 17 x 8.5 mm | 1 | pack of 2 | 1 | $7.97 | $7.97 | Amazon<br>[Search Amazon](https://www.amazon.com/s?k=hiBCTR+USB+buck+converter+QC3.0) |
| 15 | IMU | BNO085 module, EC Buying | modelled at 25.6 x 22.7 x 4.6 mm; I2C | 1 | each | 1 | $20.49 | $20.49 | [Amazon](https://www.amazon.com/dp/B0CDGZMLPP). Second source [Adafruit 4754](https://www.adafruit.com/product/4754) at $29.50, in stock on 2026-11-03<br>[Search Amazon](https://www.amazon.com/s?k=BNO085+IMU+module) |
| 16 | **OPTIONAL:** Camera | Arducam 8 MP IMX219 | board modelled at 24 x 24 mm | (1) | each | (1) | $16.99 | $16.99 | [Amazon](https://www.amazon.com/dp/B09V576TFN)<br>[Search Amazon](https://www.amazon.com/s?k=Arducam+8MP+IMX219+camera+module) |
| 17 | **OPTIONAL:** Camera ribbon, if the camera lacks one | GODIYMODULES | Pi Zero 22-pin to 15-pin, 15 cm | (1) | pack of 2 | (1) | - | - | [Amazon](https://www.amazon.com/dp/B0F9WJ62LV)<br>[Search Amazon](https://www.amazon.com/s?k=Raspberry+Pi+Zero+camera+cable+22+pin+to+15+pin+15cm) |

### Power and wiring

| Item | Part | Maker / part number | Specification | Qty per robot | Order unit | Order qty | Unit price | Line price | Source |
|---|---|---|---|---|---|---|---|---|---|
| 18 | Battery | Zeee 2S LiPo, 50C | 850 mAh, 54 x 30 x 15 mm. Comes on a small JST plug: solder on item 19 | 1 | pack of 2 | 1 | $23.39 | $23.39 | [Amazon, Zeee](https://www.amazon.com/dp/B0DGQ6DRLS)<br>[Search Amazon](https://www.amazon.com/s?k=Zeee+2S+850mAh+50C+LiPo) |
| 19 | Battery connector | Nuofany XT30 pigtail | 100 mm, 16 AWG | 1 | 5 pairs | 1 | $9.99 | $9.99 | [Amazon](https://www.amazon.com/dp/B0B4H4GKQL)<br>[Search Amazon](https://www.amazon.com/s?k=XT30+pigtail+16+AWG+100mm) |
| 20 | Power wire: battery pair up the neck, leg hub | BNTECHGO silicone wire | 20 AWG | 1 | 10 ft each | 1 | - | - | [Amazon](https://www.amazon.com/dp/B01M12PSJM)<br>[Search Amazon](https://www.amazon.com/s?k=20+AWG+silicone+wire+red+black) |
| 21 | Signal wire: IMU | Fermerry silicone wire | 28 AWG stranded, 4 wires, about 1 m in all | 1 | 6 colours, 5 ft each | 1 | - | - | [Amazon](https://www.amazon.com/dp/B089CR4SDM)<br>[Search Amazon](https://www.amazon.com/s?k=28+AWG+silicone+stranded+wire) |
| 22 | Servo cable: socket 2 to the hub, hub to each leg, and spares | Waveshare 5264-3PIN Servo Cable | 300 mm, for ST, SC and CF servos | 3 | pack of 6 | 1 | - | - | [Waveshare](https://www.waveshare.com/sr-cable-5264-3pin.htm): price not read<br>[Search Amazon](https://www.amazon.com/s?k=5264+3+pin+servo+cable+300mm) |
| 23 | Regulator to Pi power | LY tech flat ribbon USB | right-angle USB-A to right-angle micro USB, 10 cm | 1 | each | 1 | $13.50 | $13.50 | Amazon<br>[Search Amazon](https://www.amazon.com/s?k=LY+tech+flat+ribbon+micro+USB+90+degree) |
| 24 | Pi to bus board | Veeloon | right-angle micro USB OTG to right-angle USB-C, 0.6 ft | 1 | pack of 2 | 1 | $7.99 | $7.99 | [Amazon](https://www.amazon.com/dp/B0DKBQ7TD3)<br>[Search Amazon](https://www.amazon.com/s?k=micro+USB+to+USB+C+OTG+cable+90+degree) |

### Consumables

| Item | Part | Maker / part number | Specification | Qty per robot | Order unit | Order qty | Unit price | Line price | Source |
|---|---|---|---|---|---|---|---|---|---|
| 25 | Foam tape, hook-and-loop strap, small cable ties | generic |  | 1 | lot | 1 | $12.00 | $12.00 | any hardware shop; price estimated<br>[Search Amazon](https://www.amazon.com/s?k=foam+tape+hook+and+loop+strap+cable+ties) |
| 26 | Solder, heat-shrink tube, CA glue | generic |  | 1 | lot | 1 | - | - | any hardware shop<br>[Search Amazon](https://www.amazon.com/s?k=solder+heat+shrink+CA+glue) |

### Support equipment (not in the robot)

| Item | Part | Maker / part number | Specification | Qty per robot | Order unit | Order qty | Unit price | Line price | Source |
|---|---|---|---|---|---|---|---|---|---|
| 27 | Charger | as linked | 2S LiPo, to 8.4 V, must match the balance plug | 1 | each | 1 | $9.49 | $9.49 | [Amazon](https://www.amazon.com/dp/B0FDKX4V38)<br>[Search Amazon](https://www.amazon.com/s?k=2S+LiPo+balance+charger+JST-XH) |

## Fabricated parts

All 3D printed. Files are in [prints/feetech/](../../prints/feetech/README.md), already oriented for printing, in millimetres. Mass is each piece. The hood has an orange band, painted or split in the slicer.

| Item | Part | File | Material | Colour | Hex | Mass each | Qty per robot |
|---|---|---|---|---|---|---|---|
| P1 | Hip yaw lid, left and right | `L_hip_yaw_lid.stl`, `R_hip_yaw_lid.stl` | PLA | Dark grey | #3A3D42 | 3.4 g | 2 |
| P2 | Yaw bracket, left and right | `L_yaw_bracket.stl`, `R_yaw_bracket.stl` | PLA | Dark grey | #3A3D42 | 19.4 g | 2 |
| P3 | Hip roll lid, left and right | `L_hip_roll_lid.stl`, `R_hip_roll_lid.stl` | PLA | Dark grey | #3A3D42 | 2.9 g | 2 |
| P4 | Roll bracket, left and right | `L_roll_bracket.stl`, `R_roll_bracket.stl` | PLA | Dark grey | #3A3D42 | 6.7 g | 2 |
| P5 | Thigh frame, left and right | `L_thigh_frame.stl`, `R_thigh_frame.stl` | PLA | Dark grey | #3A3D42 | 21.5 g | 2 |
| P6 | Hip pitch lid, left and right | `L_hip_pitch_lid.stl`, `R_hip_pitch_lid.stl` | PLA | Dark grey | #3A3D42 | 3.5 g | 2 |
| P7 | Knee lid, left and right | `L_knee_lid.stl`, `R_knee_lid.stl` | PLA | Dark grey | #3A3D42 | 3.4 g | 2 |
| P8 | Thigh cover, left and right | `L_thigh_cover.stl`, `R_thigh_cover.stl` | PLA | White | #ECEBE6 | 30.3 g | 2 |
| P9 | Shin, left and right | `L_shin.stl`, `R_shin.stl` | PLA | Dark grey | #3A3D42 | 15.1 g | 2 |
| P10 | Shoe, left and right | `L_shoe.stl`, `R_shoe.stl` | PLA | Orange | #E8642A | 18.5 g | 2 |
| P11 | Sole, left and right | `L_sole.stl`, `R_sole.stl` | TPU 95A | Yellow | #F2B233 | 28.3 g | 2 |
| P12 | Inner ear, left and right | `L_inner_ear.stl`, `R_inner_ear.stl` | PLA | Orange | #E8642A | 3.0 g | 2 |
| P13 | Chassis | `chassis.stl` | PLA | Dark grey | #3A3D42 | 65.3 g | 1 |
| P14 | Body shell | `body_shell.stl` | PLA | White | #ECEBE6 | 33.2 g | 1 |
| P15 | Neck column | `neck_column.stl` | PLA | Dark grey | #3A3D42 | 13.3 g | 1 |
| P16 | Neck lid | `neck_lid.stl` | PLA | Dark grey | #3A3D42 | 0.8 g | 1 |
| P17 | Head pitch lid | `head_pitch_lid.stl` | PLA | Dark grey | #3A3D42 | 0.9 g | 1 |
| P18 | Head fork | `head_fork.stl` | PLA | Dark grey | #3A3D42 | 22.1 g | 1 |
| P19 | Head yaw sheet | `head_yaw_sheet.stl` | PLA | Dark grey | #3A3D42 | 1.5 g | 1 |
| P20 | Head yaw bracket | `head_yaw_bracket.stl` | PLA | Dark grey | #3A3D42 | 16.1 g | 1 |
| P21 | Head roll lid | `head_roll_lid.stl` | PLA | Dark grey | #3A3D42 | 3.5 g | 1 |
| P22 | Head roll spacer | `head_roll_spacer.stl` | PLA | Dark grey | #3A3D42 | 0.9 g | 1 |
| P23 | Head frame | `head_frame.stl` | PLA | Orange | #E8642A | 99.5 g | 1 |
| P24 | Hood | `hood.stl` | PLA | White | #ECEBE6 | 93.3 g | 1 |
| P25 | Jaw | `jaw.stl` | PLA | Orange | #E8642A | 55.6 g | 1 |
| P26 | Jaw soft insert | `jaw_soft_insert.stl` | TPU 95A | Pale orange | #F7AE55 | 15.7 g | 1 |
| P27 | Mouth roof | `mouth_roof.stl` | TPU 95A | Pale orange | #F7AE55 | 13.8 g | 1 |
| P28 | Face | `face.stl` | PLA | Mid grey | #9A9C98 | 16.8 g | 1 |
| P29 | Eye ring | `eye_ring.stl` | PLA | Amber | #F0A030 | 7.7 g | 1 |
| P30 | Eye iris | `eye_iris.stl` | PLA | Black | #0A1420 | 2.6 g | 1 |

### Filament

| Colour | Hex | Material | Model mass | With 15 % for supports and scrap |
|---|---|---|---|---|
| Dark grey | #3A3D42 | PLA | 276 g | 318 g |
| Orange | #E8642A | PLA | 198 g | 228 g |
| White | #ECEBE6 | PLA | 187 g | 215 g |
| Mid grey | #9A9C98 | PLA | 17 g | 19 g |
| Amber | #F0A030 | PLA | 8 g | 9 g |
| Black | #0A1420 | PLA | 3 g | 3 g |
| Yellow | #F2B233 | TPU 95A | 57 g | 65 g |
| Pale orange | #F7AE55 | TPU 95A | 30 g | 34 g |

## Build notes that affect ordering

- **Items 1, 2:** order the 7.4 V models. The 12 V STS3215s look the same and aren't interchangeable on this pack.
- **Item 13:** set both jumpers to B. Waveshare's page says 5-8.4 V can also be input, against a 9-12.6 V silkscreen. Another shop lists a 7 V minimum.
- **Item 18:** solder on item 19: the JST it comes with is too small. The leg hub is soldered from items 19, 20 and 22: see [WIRING.md](WIRING.md).
- **Item 14:** feeds the Pi's PWR port only. It can output up to 12 V if a device asks for fast charging, so measure about 5 V before connecting.
- **Item 15:** its listing names both BNO080 and BNO085: confirm which chip arrives, its size, and that it starts in I2C mode.
- **Item 23:** check the Pi's voltage under load, as the ribbon's wires are thin.

## Open before ordering

- **What comes in a servo's box:** no listing read says. This design needs a horn on all 15 and a rear horn on 5, and the SO-101's guide fits both horns from its servo's kit. Buy one servo and look. Each servo's lead is listed at about 150 mm on other STS3215 listings: confirm, as the chains assume it.
- **Servo torque:** sellers list the C044 at 16 to 27.4 kg cm, and the training uses 27.4. The C046's numbers are scaled from the C001. Measure one of each.
- **Voltage:** a full pack is 8.4 V. OpenELAB lists the C044 to 8.4 V; others rate the 7.4 V STS3215 to 7.4 V.
- **Item 6:** its count per length isn't listed, and 41 of the 10 mm are needed.
- **Item 3:** a pack is exactly the 10 needed, with no spare. Check a horn fits the bore before printing.
- **Item 22:** the listing doesn't say what its ends are: confirm they plug into both the servo and the board, and its price.
- **Measure on the first parts:** the Waveshare board's standoffs against their printed hex sockets (item 13); the camera board (item 16); servo cable lengths.
- **Amazon listings** are as last read by a person, for the hybrid or all-Dynamixel duck: confirm each page before ordering. Item 18 was chosen for the hybrid's slot.
- **Not in this design:** power switch (the XT30 is the disconnect), fuse, speaker, microphone.
