meetsitaram/duck-droids/docs/hd1910/BOM.md

# Feetech HD-1910 duck: bill of materials

> **This is the parts list for the Feetech HD-1910 duck only.** Each duck has its own parts, prints and BOM, and they don't mix. Other ducks: [all-Dynamixel](../dynamixel/BOM.md) · [all-Feetech](../feetech/BOM.md) · [hybrid](../hybrid/BOM.md) · [hobby-servo](../hobby/BOM.md) · [nano](../nano/BOM.md) · [big](../big/BOM.md). <!-- variant banner -->

| | |
|---|---|
| Product | Feetech HD-1910 duck, biped, 15 servos |
| Height, mass | 0.295 m, 1.03 kg as modelled |
| Build quantity | Quantities are for 1 robot |
| Fabricated parts | 43 printed parts, 435 g PLA and 54 g TPU 95A |
| Status | Prototype: no unit built, no part test printed |
| Prices | USD, as listed 2026-11-02 to 2026-11-06, before tax and shipping. Confirm before ordering |
| Related | [Print files](../../prints/hd1910/README.md), [wiring](WIRING.md), [assembly](ASSEMBLY.md) |

Generated by `tools/make_docs.py` from the spec. Quantities match the model.

## Cost summary

| Group | Required parts, priced |
|---|---|
| Actuators | $510.00 |
| Bearings | $92.23 |
| Fasteners | $35.65 |
| Electronics | $55.94 |
| Power and wiring | $57.87 |
| Consumables | $12.00 |
| Support equipment (not in the robot) | - |
| **Total of quoted lines** | **$763.69** |

13 required lines have no quote yet and are not in the total, nor is filament. Optional parts add $16.99 on the quoted lines.

## Purchased parts

Every line is required unless it starts with **OPTIONAL**. Optional lines show their quantities in brackets and are not in the total.

### Actuators

| Item | Part | Maker / part number | Specification | Qty per robot | Order unit | Order qty | Unit price | Line price | Source |
|---|---|---|---|---|---|---|---|---|---|
| 1 | Smart servo, serial bus | Feetech HD-1910-C001 | 15 kg cm stall (+/- 10 %), 2 A and 113 rev/min at 7.4 V; 3.7 kg cm rated; 4-8.4 V; 1:320; 21 g; 34 x 20 x 23 mm, 29 mm across its 2 horns; 12-bit magnetic encoder; AMP2.0-3P sockets; 15 cm lead | 15 | each | 15 | $34.00 | $510.00 | [AiFitLab](https://aifitlab.com/products/feetech-hd1910-servo-motor): backordered on 2026-11-05. Second source [OpenELAB](https://openelab.io/products/feetech-hd1910-microduck-coreless-servo) at EUR 33.55, sold out on 2026-11-05<br>[Search Amazon](https://www.amazon.com/s?k=Feetech+HD-1910-C001+servo) |

### Bearings

| Item | Part | Maker / part number | Specification | Qty per robot | Order unit | Order qty | Unit price | Line price | Source |
|---|---|---|---|---|---|---|---|---|---|
| 2 | Ball bearing, around each horn | MR2216ZZ (ET2216ZZ) | 16 x 22 x 4 mm | 11 | pack of 10 | 2 | $42.72 | $85.44 | [Amazon](https://www.amazon.com/dp/B0C5ZCVGNP)<br>[Search Amazon](https://www.amazon.com/s?k=MR2216ZZ+bearing+16x22x4mm) |
| 3 | Ball bearing, shoe inner ear | 6700ZZ | 10 x 15 x 4 mm | 2 | pack of 10 | 1 | $6.79 | $6.79 | [Amazon](https://www.amazon.com/dp/B0FQ4VYXRP)<br>[Search Amazon](https://www.amazon.com/s?k=6700ZZ+bearing+10x15x4mm) |

### Fasteners

| Item | Part | Maker / part number | Specification | Qty per robot | Order unit | Order qty | Unit price | Line price | Source |
|---|---|---|---|---|---|---|---|---|---|
| 4 | Screw, into a horn, machine thread | generic | M2 x 5 mm, pan head, Phillips | 20 | pack of 50 | 1 | - | - | search<br>[Search Amazon](https://www.amazon.com/s?k=M2+x+5mm+pan+head+phillips+machine+screw) |
| 5 | Screw, into a horn, machine thread | generic | M2 x 6 mm, pan head, Phillips | 16 | pack of 50 | 1 | - | - | search<br>[Search Amazon](https://www.amazon.com/s?k=M2+x+6mm+pan+head+phillips+machine+screw) |
| 6 | Screw, into a horn, machine thread | generic | M2 x 8 mm, pan head, Phillips | 36 | pack of 50 | 1 | - | - | search<br>[Search Amazon](https://www.amazon.com/s?k=M2+x+8mm+pan+head+phillips+machine+screw) |
| 7 | Screw, into printed parts, self-tapping | generic | M2 x 6 mm, pan head | 10 | in item below | - | - | - | from the M2 kit below<br>[Search Amazon](https://www.amazon.com/s?k=M2+x+6mm+self+tapping+pan+head+screw) |
| 8 | Screw, servo frame holes and printed parts, self-tapping | generic | M2 x 8 mm, pan head | 80 | in item below | - | - | - | from the M2 kit below<br>[Search Amazon](https://www.amazon.com/s?k=M2+x+8mm+self+tapping+pan+head+screw) |
| 9 | Self-tapping M2 screws | generic | pan head kit, 800 pieces | 90 | kit | 1 | $15.66 | $15.66 | [Amazon](https://www.amazon.com/dp/B0GV338JJK)<br>[Search Amazon](https://www.amazon.com/s?k=M2+self+tapping+pan+head+screw+kit) |
| 10 | Screw, flat head, machine thread: ankle rear horns | generic | M2 x 4 mm, Phillips | 8 | pack of 50 | 1 | - | - | search<br>[Search Amazon](https://www.amazon.com/s?k=M2+x+4mm+flat+head+phillips+machine+screw) |
| 11 | Screw, bus board, machine thread | generic | M2.5 x 5 mm, pan head, Phillips, black oxide 304 stainless | 8 | pack of 50 | 1 | - | - | Amazon<br>[Search Amazon](https://www.amazon.com/s?k=M2.5+x+5mm+pan+head+machine+screw+black+oxide) |
| 12 | **OPTIONAL:** Spare hex standoffs, bus board: 4 come with the Waveshare board | uxcell | brass, M2.5, female-female, 8 mm long, 5 mm across flats | - | pack of 50 | (1) | - | - | Amazon<br>[Search Amazon](https://www.amazon.com/s?k=uxcell+M2.5+x+8mm+female+female+hex+brass+standoff) |
| 13 | Screws, socket cap: 1 x M3 x 10, 4 x M3 x 12 | generic | kit of 610 with nuts and washers | 5 | kit | 1 | $19.99 | $19.99 | [Amazon](https://www.amazon.com/dp/B09NR8X2LV)<br>[Search Amazon](https://www.amazon.com/s?k=M3+socket+cap+screw+kit) |
| 14 | Washer, far hinge tab to hood | uxcell | M3, 6 mm outside, 0.5 mm thick, stainless | 1 | pack of 100 | 1 | - | - | [Amazon](https://www.amazon.com/dp/B015A39NCC)<br>[Search Amazon](https://www.amazon.com/s?k=uxcell+M3+x+6mm+x+0.5mm+flat+washer) |

### Electronics

| Item | Part | Maker / part number | Specification | Qty per robot | Order unit | Order qty | Unit price | Line price | Source |
|---|---|---|---|---|---|---|---|---|---|
| 15 | Computer | Raspberry Pi Zero 2 W | without header | 1 | each | 1 | - | - | [PiShop](https://www.pishop.us/product/raspberry-pi-zero-2-w/): out of stock on 2026-11-03<br>[Search Amazon](https://www.amazon.com/s?k=Raspberry+Pi+Zero+2+W) |
| 16 | microSD card | SanDisk Ultra | 32 GB microSDHC, A1, Class 10, UHS-I | 1 | each | 1 | $22.49 | $22.49 | [Amazon](https://www.amazon.com/dp/B08L5HMJVW)<br>[Search Amazon](https://www.amazon.com/s?k=SanDisk+32GB+Ultra+microSDHC+A1) |
| 17 | Servo bus board | Waveshare Bus Servo Adapter (A), SKU 25514 | USB-C, 2 servo sockets at 2.5 mm pitch, 42 x 33 mm, also sold as Serial Bus Servo Driver Board | 1 | each | 1 | $4.99 | $4.99 | [Waveshare](https://www.waveshare.com/bus-servo-adapter-a.htm); [Amazon](https://www.amazon.com/dp/B0CTMM4LWK). Second source [Abra](https://abra-electronics.com/electromechanical/motors/motor-controllers/wave-25514-serial-bus-servo-driver-board.html) at $9.05<br>[Search Amazon](https://www.amazon.com/s?k=Waveshare+Serial+Bus+Servo+Driver+Board) |
| 18 | 5 V regulator | hiBCTR USB buck converter QC3.0 | 6-32 V in, 35 x 17 x 8.5 mm | 1 | pack of 2 | 1 | $7.97 | $7.97 | Amazon<br>[Search Amazon](https://www.amazon.com/s?k=hiBCTR+USB+buck+converter+QC3.0) |
| 19 | IMU | BNO085 module, EC Buying | modelled at 25.6 x 22.7 x 4.6 mm; I2C | 1 | each | 1 | $20.49 | $20.49 | [Amazon](https://www.amazon.com/dp/B0CDGZMLPP). Second source [Adafruit 4754](https://www.adafruit.com/product/4754) at $29.50, in stock on 2026-11-03<br>[Search Amazon](https://www.amazon.com/s?k=BNO085+IMU+module) |
| 20 | **OPTIONAL:** Camera | Arducam 8 MP IMX219 | board modelled at 24 x 24 mm | (1) | each | (1) | $16.99 | $16.99 | [Amazon](https://www.amazon.com/dp/B09V576TFN)<br>[Search Amazon](https://www.amazon.com/s?k=Arducam+8MP+IMX219+camera+module) |
| 21 | **OPTIONAL:** Camera ribbon, if the camera lacks one | GODIYMODULES | Pi Zero 22-pin to 15-pin, 15 cm | (1) | pack of 2 | (1) | - | - | [Amazon](https://www.amazon.com/dp/B0F9WJ62LV)<br>[Search Amazon](https://www.amazon.com/s?k=Raspberry+Pi+Zero+camera+cable+22+pin+to+15+pin+15cm) |

### Power and wiring

| Item | Part | Maker / part number | Specification | Qty per robot | Order unit | Order qty | Unit price | Line price | Source |
|---|---|---|---|---|---|---|---|---|---|
| 22 | Battery | OVONIC 2S LiPo, 100C | 450 mAh, XT30, 61.5 x 15.8 x 13.5 mm, 31 g | 1 | pack of 4 | 1 | $26.39 | $26.39 | [Amazon](https://www.amazon.com/dp/B0D2KT723L)<br>[Search Amazon](https://www.amazon.com/s?k=OVONIC+2S+450mAh+100C+XT30) |
| 23 | Battery connector | Nuofany XT30 pigtail | 100 mm, 16 AWG | 1 | 5 pairs | 1 | $9.99 | $9.99 | [Amazon](https://www.amazon.com/dp/B0B4H4GKQL)<br>[Search Amazon](https://www.amazon.com/s?k=XT30+pigtail+16+AWG+100mm) |
| 24 | Power wire, red and black | BNTECHGO silicone wire | 20 AWG | 1 | 10 ft each | 1 | - | - | [Amazon](https://www.amazon.com/dp/B01M12PSJM)<br>[Search Amazon](https://www.amazon.com/s?k=20+AWG+silicone+wire+red+black) |
| 25 | Signal wire: IMU | Fermerry silicone wire | 28 AWG stranded, 4 wires, about 1 m in all | 1 | 6 colours, 5 ft each | 1 | - | - | [Amazon](https://www.amazon.com/dp/B089CR4SDM)<br>[Search Amazon](https://www.amazon.com/s?k=28+AWG+silicone+stranded+wire) |
| 26 | Bus wire: 2 long servo leads, spliced | silicone wire | 22 AWG, 3 colours, about 1 m in all | 1 | lot | 1 | - | - | search<br>[Search Amazon](https://www.amazon.com/s?k=22+AWG+silicone+wire+3+colours) |
| 27 | Board plug, on a lead: into the bus board's 2 sockets | generic, as an STS3215 lead | 3-pin plug, 2.5 mm pitch, type 5264, one end cut off | 2 | each | 2 | - | - | search<br>[Search Amazon](https://www.amazon.com/s?k=5264+3+pin+connector+cable+2.5mm+pitch) |
| 28 | Regulator to Pi power | LY tech flat ribbon USB | right-angle USB-A to right-angle micro USB, 10 cm | 1 | each | 1 | $13.50 | $13.50 | Amazon<br>[Search Amazon](https://www.amazon.com/s?k=LY+tech+flat+ribbon+micro+USB+90+degree) |
| 29 | Pi to bus board | Veeloon | right-angle micro USB OTG to right-angle USB-C, 0.6 ft | 1 | pack of 2 | 1 | $7.99 | $7.99 | [Amazon](https://www.amazon.com/dp/B0DKBQ7TD3)<br>[Search Amazon](https://www.amazon.com/s?k=micro+USB+to+USB+C+OTG+cable+90+degree) |

### Consumables

| Item | Part | Maker / part number | Specification | Qty per robot | Order unit | Order qty | Unit price | Line price | Source |
|---|---|---|---|---|---|---|---|---|---|
| 30 | Foam tape, hook-and-loop strap, small cable ties | generic |  | 1 | lot | 1 | $12.00 | $12.00 | any hardware shop; price estimated<br>[Search Amazon](https://www.amazon.com/s?k=foam+tape+hook+and+loop+strap+cable+ties) |
| 31 | Solder, heat-shrink tube, CA glue | generic |  | 1 | lot | 1 | - | - | any hardware shop<br>[Search Amazon](https://www.amazon.com/s?k=solder+heat+shrink+CA+glue) |

### Support equipment (not in the robot)

| Item | Part | Maker / part number | Specification | Qty per robot | Order unit | Order qty | Unit price | Line price | Source |
|---|---|---|---|---|---|---|---|---|---|
| 32 | Charger | as linked | 2S LiPo, to 8.4 V, must match the balance plug | 1 | each | 1 | - | - | [Amazon](https://www.amazon.com/dp/B0FDKX4V38)<br>[Search Amazon](https://www.amazon.com/s?k=2S+LiPo+balance+charger+JST-XH) |

## Fabricated parts

All 3D printed. Files are in [prints/hd1910/](../../prints/hd1910/README.md), already oriented for printing, in millimetres. Mass is each piece. The hood has an orange band, painted or split in the slicer.

| Item | Part | File | Material | Colour | Hex | Mass each | Qty per robot |
|---|---|---|---|---|---|---|---|
| P1 | Hip yaw lid, left and right | `L_hip_yaw_lid.stl`, `R_hip_yaw_lid.stl` | PLA | Dark grey | #3A3D42 | 1.8 g | 2 |
| P2 | Yaw bracket, left and right | `L_yaw_bracket.stl`, `R_yaw_bracket.stl` | PLA | Dark grey | #3A3D42 | 10.1 g | 2 |
| P3 | Hip roll lid, left and right | `L_hip_roll_lid.stl`, `R_hip_roll_lid.stl` | PLA | Dark grey | #3A3D42 | 1.5 g | 2 |
| P4 | Roll bracket, left and right | `L_roll_bracket.stl`, `R_roll_bracket.stl` | PLA | Dark grey | #3A3D42 | 4.4 g | 2 |
| P5 | Thigh frame, left and right | `L_thigh_frame.stl`, `R_thigh_frame.stl` | PLA | Dark grey | #3A3D42 | 13.3 g | 2 |
| P6 | Hip pitch lid, left and right | `L_hip_pitch_lid.stl`, `R_hip_pitch_lid.stl` | PLA | Dark grey | #3A3D42 | 1.8 g | 2 |
| P7 | Knee lid, left and right | `L_knee_lid.stl`, `R_knee_lid.stl` | PLA | Dark grey | #3A3D42 | 1.8 g | 2 |
| P8 | Thigh cover, left and right | `L_thigh_cover.stl`, `R_thigh_cover.stl` | PLA | White | #ECEBE6 | 19.9 g | 2 |
| P9 | Shin, left and right | `L_shin.stl`, `R_shin.stl` | PLA | Dark grey | #3A3D42 | 8.1 g | 2 |
| P10 | Shoe, left and right | `L_shoe.stl`, `R_shoe.stl` | PLA | Orange | #E8642A | 14.3 g | 2 |
| P11 | Sole, left and right | `L_sole.stl`, `R_sole.stl` | TPU 95A | Yellow | #F2B233 | 17.7 g | 2 |
| P12 | Inner ear, left and right | `L_inner_ear.stl`, `R_inner_ear.stl` | PLA | Orange | #E8642A | 2.7 g | 2 |
| P13 | Chassis | `chassis.stl` | PLA | Dark grey | #3A3D42 | 34.3 g | 1 |
| P14 | Body shell | `body_shell.stl` | PLA | White | #ECEBE6 | 27.5 g | 1 |
| P15 | Neck column | `neck_column.stl` | PLA | Dark grey | #3A3D42 | 4.5 g | 1 |
| P16 | Neck lid | `neck_lid.stl` | PLA | Dark grey | #3A3D42 | 0.2 g | 1 |
| P17 | Head pitch lid | `head_pitch_lid.stl` | PLA | Dark grey | #3A3D42 | 0.2 g | 1 |
| P18 | Head fork | `head_fork.stl` | PLA | Dark grey | #3A3D42 | 11.2 g | 1 |
| P19 | Head yaw sheet | `head_yaw_sheet.stl` | PLA | Dark grey | #3A3D42 | 1.0 g | 1 |
| P20 | Head yaw bracket | `head_yaw_bracket.stl` | PLA | Dark grey | #3A3D42 | 7.1 g | 1 |
| P21 | Head roll lid | `head_roll_lid.stl` | PLA | Dark grey | #3A3D42 | 1.8 g | 1 |
| P22 | Head roll spacer | `head_roll_spacer.stl` | PLA | Dark grey | #3A3D42 | 0.4 g | 1 |
| P23 | Head roll rear spacer | `head_roll_rear_spacer.stl` | PLA | Dark grey | #3A3D42 | 0.4 g | 1 |
| P24 | Head frame | `head_frame.stl` | PLA | Orange | #E8642A | 67.4 g | 1 |
| P25 | Hood | `hood.stl` | PLA | White | #ECEBE6 | 60.5 g | 1 |
| P26 | Jaw | `jaw.stl` | PLA | Orange | #E8642A | 36.9 g | 1 |
| P27 | Jaw soft insert | `jaw_soft_insert.stl` | TPU 95A | Pale orange | #F7AE55 | 9.5 g | 1 |
| P28 | Mouth roof | `mouth_roof.stl` | TPU 95A | Pale orange | #F7AE55 | 9.0 g | 1 |
| P29 | Face | `face.stl` | PLA | Mid grey | #9A9C98 | 10.4 g | 1 |
| P30 | Eye ring | `eye_ring.stl` | PLA | Amber | #F0A030 | 9.3 g | 1 |
| P31 | Eye iris | `eye_iris.stl` | PLA | Black | #0A1420 | 2.3 g | 1 |

### Filament

| Colour | Hex | Material | Model mass | With 15 % for supports and scrap |
|---|---|---|---|---|
| Dark grey | #3A3D42 | PLA | 147 g | 169 g |
| Orange | #E8642A | PLA | 138 g | 159 g |
| White | #ECEBE6 | PLA | 128 g | 147 g |
| Mid grey | #9A9C98 | PLA | 10 g | 12 g |
| Amber | #F0A030 | PLA | 9 g | 11 g |
| Black | #0A1420 | PLA | 2 g | 3 g |
| Yellow | #F2B233 | TPU 95A | 35 g | 41 g |
| Pale orange | #F7AE55 | TPU 95A | 19 g | 21 g |

## Build notes that affect ordering

- **Item 1:** rated to 8.4 V, so a full 2S pack is inside Feetech's limits. Its factory settings: ID 1, 1 Mbps, position PD mode; over-current protection off. No idlers to buy: each servo has its own rear horn.
- **Items 4-6:** Feetech draws the horn's holes as 8-M2.0, so these are machine screws. They go right through the horn: a longer one than listed drags on the case.
- **Item 9:** check that it holds 10 M2 x 6 and 80 M2 x 8.
- **Item 17:** set both jumpers to B. Its silkscreen says DC 9-12.6 V and the battery is 7.4-8.4 V: bench test before ordering in quantity.
- **Items 27, 26:** the servos' plugs are 2.0 mm pitch and the board's sockets 2.5 mm, so no servo lead fits the board. Each servo's own lead covers its link in the chain. 2 of them are cut to make the 3 special ones: [WIRING.md](WIRING.md).
- **Item 19:** its listing names both BNO080 and BNO085: confirm which chip arrives, its size, and that it starts in I2C mode. The model and fit come from Adafruit's board.
- **Item 18:** feeds the Pi's PWR port only. It can output up to 12 V if a device asks for fast charging, so measure about 5 V before connecting.
- **Item 22:** marked HV. Charge as a normal 2S, to 8.4 V.
- **Item 28:** check the Pi's voltage under load, as the ribbon's wires are thin.

## Open before ordering

- **Servo supply:** item 1 is backordered at AiFitLab and sold out at OpenELAB on 2026-11-05, and neither gives a date. 15 units is the longest lead time here. Order 1 first.
- **What's in the servo's box:** Feetech's sheet says "No Accessories", and its packing photo shows a lead and 8 small screws. This list assumes the lead and buys every screw: read the first box. If there's no lead, you need 15 more, and a source.
- **Sources to choose:** items 4, 5, 6, 10, 26, 27: no listing has been read for them.
- **Measure on the first servo:** the plug's pitch and family against FEETECH spec sheet A/0, 2026-09-07's AMP2.0-3P; a horn in the bore of item 2; an M2 machine screw in a horn hole, as the threads are from the drawing; the rear horn coming off cleanly. Also the Waveshare board's socket pitch (2.5 mm is measured from Waveshare's photo) and its standoffs against their printed hex sockets, 5 mm across flats (item 17); the camera board (item 20).
- **Protocol:** Feetech's pages don't say which of its protocols the HD-1910 speaks, and the Waveshare board is sold for its ST and SC servos. Test one servo on the board before ordering 15.
- **Amazon listings** (items 2, 3, 9, 14, 17, 19, 29, 22, 23, 24, 25, 20, and those found by search) are as read for the all-Dynamixel duck, or not read at all: confirm each page before ordering.
- **Not in this design:** power switch (the XT30 is the disconnect), speaker, microphone.
