meetsitaram/duck-droids/docs/hobby/BOM.md

# Hobby-servo duck: bill of materials

> **This is the parts list for the hobby-servo duck only.** Each duck has its own parts, prints and BOM, and they don't mix. Other ducks: [all-Dynamixel](../dynamixel/BOM.md) · [HD-1910](../hd1910/BOM.md) · [all-Feetech](../feetech/BOM.md) · [hybrid](../hybrid/BOM.md) · [nano](../nano/BOM.md) · [big](../big/BOM.md). <!-- variant banner -->

| | |
|---|---|
| Product | Hobby-servo duck, biped, 15 one-way PWM servos on a PCA9685 |
| Height, mass | 0.373 m, 1.94 kg as modelled, of which servo leads 28 g |
| Servos | 9 x MG996R, 3 x DS3218, 3 x MG90S |
| Fabricated parts | 44 printed parts, 784 g PLA and 82 g TPU 95A |
| Status | A design: no unit built, no part test printed, no servo measured |
| Related | [Print files](../../prints/hobby/README.md), [wiring](WIRING.md), [assembly](ASSEMBLY.md) |

Generated by `tools/make_docs.py` from the spec. Quantities match the model. Prices are USD before tax and shipping: only Adafruit's was read for this list; the others are copied from the all-Feetech list for the same part, not re-read.

**Quoted lines: $108.28.** 24 required lines have no price yet, among them every servo, and are not in it.

### Actuators

| Item | Part | Maker / part | Specification | Qty | Unit price | Source |
|---|---|---|---|---|---|---|
| 1 | Servo, standard size, metal gear: ankle pitch, head pitch, hip pitch, hip roll, hip yaw | TowerPro MG996R | 6 V: 11 kg cm stall, 0.15 s/60 deg, 55 g ([TowerPro](https://www.towerpro.com.tw/product/mg996r/)) | 9 | - | [search](https://www.amazon.com/s?k=TowerPro+MG996R) |
| 2 | Servo, high torque: knee, neck pitch | DSSERVO DS3218 (MG) | 20.4 kg cm at 6 V, interpolated from 19 at 5 V and 21.5 at 6.8 V ([servodatabase](https://servodatabase.com/servo/dsservo/ds3218-mg), third party), 60 g | 3 | - | [search](https://www.amazon.com/s?k=DSSERVO+DS3218+20kg+servo) |
| 3 | Servo, micro, metal gear: head yaw, head roll, beak | TowerPro MG90S | 2.07 kg cm at 6 V, interpolated; 13.4 g ([TowerPro](https://www.towerpro.com.tw/product/mg90s-3/)) | 3 | - | [search](https://www.amazon.com/s?k=TowerPro+MG90S) |
| 4 | Horn, 25T aluminium disc | generic | 20 mm across or less, 4 M3 holes on a 13.9 mm circle (the model's): check against the bearing bore | 12 | - | [search](https://www.amazon.com/s?k=25T+aluminum+servo+disc+horn) |

### Bearings

| Item | Part | Maker / part | Specification | Qty | Unit price | Source |
|---|---|---|---|---|---|---|
| 5 | Ball bearing 6700ZZ | 6700ZZ | 10 x 15 x 4 mm, the shoe's inner ear | 2 | $6.79 | pack of 10, price from docs/feetech/BOM.md, not re-read |
| 6 | Ball bearing 6704ZZ | 6704ZZ | 20 x 27 x 4 mm, round each standard servo's horn and fork hub | 10 | $18.39 | pack of 10, price from docs/feetech/BOM.md, not re-read |
| 7 | Ball bearing MR2216ZZ | MR2216ZZ | 16 x 22 x 4 mm, round the micro servos' horns and the head roll's hub | 3 | - | [search](https://www.amazon.com/s?k=MR2216ZZ+bearing) |

### Fasteners

| Item | Part | Maker / part | Specification | Qty | Unit price | Source |
|---|---|---|---|---|---|---|
| 8 | Screw M2 x 4 mm | generic | self-tapping into printed parts, except the horn screws (machine, into the aluminium horns) | 10 | - | [search](https://www.amazon.com/s?k=M2+x+4mm+screw) |
| 9 | Screw M2 x 5 mm | generic | self-tapping into printed parts, except the horn screws (machine, into the aluminium horns) | 4 | - | [search](https://www.amazon.com/s?k=M2+x+5mm+screw) |
| 10 | Screw M2 x 6 mm | generic | self-tapping into printed parts, except the horn screws (machine, into the aluminium horns) | 14 | - | [search](https://www.amazon.com/s?k=M2+x+6mm+screw) |
| 11 | Screw M2 x 8 mm | generic | self-tapping into printed parts, except the horn screws (machine, into the aluminium horns) | 6 | - | [search](https://www.amazon.com/s?k=M2+x+8mm+screw) |
| 12 | Screw M2 x 10 mm | generic | self-tapping into printed parts, except the horn screws (machine, into the aluminium horns) | 2 | - | [search](https://www.amazon.com/s?k=M2+x+10mm+screw) |
| 13 | Screw M2 x 12 mm | generic | self-tapping into printed parts, except the horn screws (machine, into the aluminium horns) | 2 | - | [search](https://www.amazon.com/s?k=M2+x+12mm+screw) |
| 14 | Screw M2.5 x 6 mm | generic | self-tapping into printed parts, except the horn screws (machine, into the aluminium horns) | 4 | - | [search](https://www.amazon.com/s?k=M2.5+x+6mm+screw) |
| 15 | Screw M3 x 6 mm | generic | self-tapping into printed parts, except the horn screws (machine, into the aluminium horns) | 76 | - | [search](https://www.amazon.com/s?k=M3+x+6mm+screw) |
| 16 | Screw M3 x 10 mm | generic | self-tapping into printed parts, except the horn screws (machine, into the aluminium horns) | 1 | - | [search](https://www.amazon.com/s?k=M3+x+10mm+screw) |
| 17 | Screw M3 x 12 mm | generic | self-tapping into printed parts, except the horn screws (machine, into the aluminium horns) | 4 | - | [search](https://www.amazon.com/s?k=M3+x+12mm+screw) |
| 18 | Screw M3 x 16 mm | generic | self-tapping into printed parts, except the horn screws (machine, into the aluminium horns) | 20 | - | [search](https://www.amazon.com/s?k=M3+x+16mm+screw) |

### Electronics

| Item | Part | Maker / part | Specification | Qty | Unit price | Source |
|---|---|---|---|---|---|---|
| 19 | Computer | Raspberry Pi Zero 2 W | with a 2 x 20 header soldered (or the WH) | 1 | $17.25 | PiShop, price from docs/feetech/BOM.md |
| 20 | microSD card | 32 GB A1 |  | 1 | - | [search](https://www.amazon.com/s?k=SanDisk+32GB+Ultra+microSDHC+A1) |
| 21 | PWM board | Adafruit 16-Channel PWM / Servo Bonnet, product 3416 | PCA9685, 65 x 30.4 mm, on the Pi's GPIO header; solder its servo headers right-angle | 1 | $12.50 | [Adafruit](https://www.adafruit.com/product/3416), 2026-11-06 |
| 22 | Pi header | 2 x 20 male, 2.54 mm | for the bonnet to sit on, if the Pi came without one; modelled as an 8.5 mm stack | 1 | - | [search](https://www.amazon.com/s?k=2x20+male+header+raspberry+pi+zero) |
| 23 | IMU | BNO085 module | modelled at 25.6 x 22.7 x 4.6 mm, I2C | 1 | - | as docs/feetech/BOM.md |
| 24 | Pi 5 V converter | USB buck converter, 6-32 V in | 35 x 17 x 8.5 mm, as the other ducks'; its USB-A out to the Pi's GPIO 5 V and GND through a USB-A pigtail | 1 | $7.97 | price from docs/feetech/BOM.md (pack of 2) |
| 25 | Servo BEC, one a side | 6.0 V switching UBEC, 2S in | 15 A peak, 8 A continuous or more: see WIRING.md | 2 | - | [search](https://www.amazon.com/s?k=6V+UBEC+15A+2S) |
| 26 | **OPTIONAL:** Camera | Arducam 8 MP IMX219 | on the back of the face | 1 | $16.99 | price from docs/feetech/BOM.md |
| 27 | **OPTIONAL:** Camera ribbon | Pi Zero 22-pin to 15-pin, 500 mm or longer | down the neck, 4 joints | 1 | - | [search](https://www.amazon.com/s?k=raspberry+pi+zero+camera+cable+22+pin+15+pin+40cm) |

### Power and wiring

| Item | Part | Maker / part | Specification | Qty | Unit price | Source |
|---|---|---|---|---|---|---|
| 28 | Battery | Zeee 2S LiPo 50C, 850 mAh | 54 x 30 x 15 mm, an XT30 soldered on | 1 | $23.39 | pack of 2, price from docs/feetech/BOM.md |
| 29 | Battery connector | XT30 pigtail, 16 AWG |  | 1 | $9.99 | price from docs/feetech/BOM.md |
| 30 | Wire | silicone, 18 AWG and 28 AWG | BEC and converter feeds; IMU | 1 | - | [search](https://www.amazon.com/s?k=18+AWG+silicone+wire) |
| 31 | Servo extension leads, JR | 150 and 300 mm | 2 x 150 mm | 2 | - | [search](https://www.amazon.com/s?k=JR+servo+extension+lead+300mm) |
| 32 | Housings and crimp pins | 2.54 mm Dupont, 1-pin and 2-pin | signal to the bonnet; V+ and GND to the bus | 30 | - | [search](https://www.amazon.com/s?k=dupont+1+pin+2+pin+housing+crimp+kit) |
| 33 | Header strip | 2.54 mm, 2 rows | the two 6 V buses | 2 | - | [search](https://www.amazon.com/s?k=2.54mm+double+row+male+header) |

### Consumables

| Item | Part | Maker / part | Specification | Qty | Unit price | Source |
|---|---|---|---|---|---|---|
| 34 | Foam tape, hook-and-loop strap, small cable ties, heat-shrink, solder | generic |  | 1 | $12.00 | price estimated in docs/feetech/BOM.md |

### Support equipment (not in the robot)

| Item | Part | Maker / part | Specification | Qty | Unit price | Source |
|---|---|---|---|---|---|---|
| 35 | Charger, 2S LiPo balance | as docs/feetech/BOM.md |  | 1 | $9.49 | price from docs/feetech/BOM.md |

## Printed parts

Files in [prints/hobby/](../../prints/hobby/README.md), turned for printing, in millimetres.

| Part | File | Material | Volume |
|---|---|---|---|
| L hip yaw lid | `L_hip_yaw_lid.stl` | PLA | 3.9 cm3 |
| L yaw bracket | `L_yaw_bracket.stl` | PLA | 18.3 cm3 |
| L hip roll lid | `L_hip_roll_lid.stl` | PLA | 3.5 cm3 |
| L roll bracket | `L_roll_bracket.stl` | PLA | 4.7 cm3 |
| L thigh frame | `L_thigh_frame.stl` | PLA | 38.5 cm3 |
| L hip pitch lid | `L_hip_pitch_lid.stl` | PLA | 3.9 cm3 |
| L knee lid | `L_knee_lid.stl` | PLA | 4.0 cm3 |
| L thigh cover | `L_thigh_cover.stl` | PLA | 23.9 cm3 |
| L shin | `L_shin.stl` | PLA | 20.9 cm3 |
| L shoe | `L_shoe.stl` | PLA | 17.0 cm3 |
| L sole | `L_sole.stl` | TPU 95A | 44.7 cm3 |
| L inner ear | `L_inner_ear.stl` | PLA | 2.5 cm3 |
| R hip yaw lid | `R_hip_yaw_lid.stl` | PLA | 3.9 cm3 |
| R yaw bracket | `R_yaw_bracket.stl` | PLA | 18.3 cm3 |
| R hip roll lid | `R_hip_roll_lid.stl` | PLA | 3.5 cm3 |
| R roll bracket | `R_roll_bracket.stl` | PLA | 4.7 cm3 |
| R thigh frame | `R_thigh_frame.stl` | PLA | 38.5 cm3 |
| R hip pitch lid | `R_hip_pitch_lid.stl` | PLA | 3.9 cm3 |
| R knee lid | `R_knee_lid.stl` | PLA | 4.0 cm3 |
| R thigh cover | `R_thigh_cover.stl` | PLA | 23.9 cm3 |
| R shin | `R_shin.stl` | PLA | 20.9 cm3 |
| R shoe | `R_shoe.stl` | PLA | 17.0 cm3 |
| R sole | `R_sole.stl` | TPU 95A | 44.7 cm3 |
| R inner ear | `R_inner_ear.stl` | PLA | 2.5 cm3 |
| chassis | `chassis.stl` | PLA | 67.4 cm3 |
| body shell | `body_shell.stl` | PLA | 40.2 cm3 |
| neck column | `neck_column.stl` | PLA | 29.5 cm3 |
| neck lid | `neck_lid.stl` | PLA | 2.9 cm3 |
| neck pitch rear hub | `neck_pitch_rear_hub.stl` | PLA | 3.9 cm3 |
| head pitch rear hub | `head_pitch_rear_hub.stl` | PLA | 3.9 cm3 |
| head roll rear hub | `head_roll_rear_hub.stl` | PLA | 2.7 cm3 |
| head pitch lid | `head_pitch_lid.stl` | PLA | 2.7 cm3 |
| head fork | `head_fork.stl` | PLA | 15.6 cm3 |
| head yaw sheet | `head_yaw_sheet.stl` | PLA | 1.5 cm3 |
| head yaw bracket | `head_yaw_bracket.stl` | PLA | 8.6 cm3 |
| head roll lid | `head_roll_lid.stl` | PLA | 1.8 cm3 |
| head frame | `head_frame.stl` | PLA | 64.5 cm3 |
| hood | `hood.stl` | PLA | 58.5 cm3 |
| jaw | `jaw.stl` | PLA | 38.9 cm3 |
| jaw soft insert | `jaw_soft_insert.stl` | TPU 95A | 16.3 cm3 |
| mouth roof | `mouth_roof.stl` | TPU 95A | 15.0 cm3 |
| face | `face.stl` | PLA | 10.2 cm3 |
| eye ring | `eye_ring.stl` | PLA | 9.9 cm3 |
| eye iris | `eye_iris.stl` | PLA | 2.7 cm3 |

## Open before ordering

- **The servos' drawings.** The ears (span, thickness, hole spacing and height), the shaft offset and the case height under the spline are read from the usual drawing of these cases, not the makers': TowerPro's MG996R page gives the drawing's numbers without saying which is which, and the MG90S and DS3218 pages none. Measure one of each before printing.
- **Torque.** No hobby servo has a rated torque; the checks hold it to a third of stall. The DS3218's figures are a third party's, and at 6 V interpolated.
- **The horn.** A 25T aluminium disc horn of 20 mm or less, with 4 M3 holes on 13.9 mm, to fit inside the 6704ZZ: check one, or change `horn_r`, `horn_hole_r` and `horn_top`.
- **The BECs** are a specification, not a part: no listing was read. Measure the one you buy against the pocket.
- **Amazon:** no page was opened; each search link needs a person to choose and confirm a listing.
