meetsitaram/duck-droids/docs/nano/BOM.md

# The nano duck: parts

> **This is the parts list for the nano duck only.** Each duck has its own parts, prints and BOM, and they don't mix. Other ducks: [all-Dynamixel](../dynamixel/BOM.md) · [HD-1910](../hd1910/BOM.md) · [all-Feetech](../feetech/BOM.md) · [hybrid](../hybrid/BOM.md) · [hobby-servo](../hobby/BOM.md) · [big](../big/BOM.md). <!-- variant banner -->

Generated by `tools/nano_docs.py` (`MILLI_RECIPE=nano python -I tools/make_docs.py`) from `spec/nano_duck.py`: don't edit by hand. Wiring: [WIRING.md](WIRING.md). Build order: [ASSEMBLY.md](ASSEMBLY.md).

**13 joints, 370 g** from every part's material (`tools/mass_model.py`), pla 158 g, actuator 135 g, electronics 43 g, steel 17 g, tpu 6 g, and 3 % of each link for wires and tape. Nothing has been printed or weighed.

## Servos

| Qty | Servo | Joints | Stall at about 5 V (design figure) | Mass | Source |
|---|---|---|---|---|---|
| 9 | SG90 | L_ankle_pitch, R_ankle_pitch, L_hip_pitch, R_hip_pitch, L_hip_yaw, R_hip_yaw, neck_pitch, head_pitch, beak | 0.157 N m | 9.0 g | towerpro.com.tw/product/sg90-7/ (1.8 kg.cm at 4.8 V) and docs.m5stack.com/en/accessory/SG90_Servo (1.6 at 4.8 V): the lower |
| 4 | MG90S | L_knee, R_knee, L_hip_roll, R_hip_roll | 0.177 N m | 13.4 g | towerpro.com.tw/product/mg90s-3/ (1.8 kg.cm at 4.8 V, 2.2 at 6.6 V) |

The MG90S, metal geared, where a joint carries the duck in a step: knees and hip roll (`tools/nano_sweep.py`). At 4.8 V it is no stronger than an SG90 by TowerPro's own figures; it is less likely to strip a gear. Stall current: an SG90 360 mA measured (protosupplies.com/product/servo-motor-micro-sg90/), up to about 650 mA listed (pcboard.ca/sg90-servo); an MG90S 700 mA measured (protosupplies.com/product/servo-motor-micro-mg90s/).

## Electronics

| Qty | Part | Source | What for |
|---|---|---|---|
| 1 | Raspberry Pi Zero 2 W, with a microSD card | raspberrypi.com/products/raspberry-pi-zero-2-w/ (65 x 30 mm; no mass given there: 11 g is the repo's figure) | its 13 servo signals from its GPIO (docs/nano/WIRING.md) |
| 1 | 2S LiPo, 300 mAh, Tattu 75C (7.6 V, a high-voltage pack) | genstattu.com/ta-75c-300-2s1p-jst.html: 45 x 16 x 12 mm, 16 g, 75C, JST-PHR plug, JST-XHR balance lead | cut the PH plug off and fit an XT30: it carries up to 7.5 A |
| 2 | Pololu D24V50F5, 5 V 5 A step-down | pololu.com/product/2851: 6-38 V in, 17.8 x 20.3 x 8.8 mm, 3.0 g; at 5 A it wants 6.2 V in | one per side: the left leg, the neck servo and the Pi; the right leg, head pitch and beak |
| 1 | Adafruit MPU-6050 6-DoF, STEMMA QT (product 3886) | adafruit.com/product/3886: 26.0 x 17.8 x 4.6 mm, 1.8 g, I2C | on the Pi's I2C (GPIO 2, 3) |
| 1 | a 2.54 mm perfboard, 13 x 3-pin male headers, the + and - rows cut in two groups | none: 34 x 16 mm, 4 g estimated | each servo's own lead plugs in; 13 signal wires to the Pi |
| 1 | XT30 plug pair, 20 AWG silicone wire for the 5 V buses, 28-30 AWG for the 13 signals | not sourced | counted in the wiring allowance |

## Screws

| Qty | Screw |
|---|---|
| 26 | the servo's own ear screw (in its bag) |
| 13 | the servo's own horn screw (in its bag) |
| 20 | M2 x 8 pan head, self-tapping into PLA |
| 4 | M2 x 6 pan head, self-tapping into PLA |

The 2 ear screws and the horn screw of each servo come in its bag. Their sizes are not on the makers' pages: about M2 is an estimate. Check them against your servos.

## Printed parts

52 STLs in [prints/nano/](../../prints/nano/README.md), left and right, from the spec's shapes (no Fusion model: their corners are sharp). PLA unless marked; the soles TPU 95A.

| Part | Volume (cm3) | Material |
|---|---|---|
| L ankle pitch bushing | 0.2 | PLA |
| L ankle pitch ear clamp | 0.3 | PLA |
| L ankle pitch rear arm | 0.9 | PLA |
| L foot | 8.5 | PLA |
| L hip pitch bushing | 0.2 | PLA |
| L hip pitch ear clamp | 0.3 | PLA |
| L hip pitch rear arm | 0.4 | PLA |
| L hip roll bushing | 0.2 | PLA |
| L hip roll ear clamp | 0.3 | PLA |
| L hip roll rear arm | 0.4 | PLA |
| L hip yaw bushing | 0.2 | PLA |
| L hip yaw ear clamp | 0.3 | PLA |
| L hip yaw rear arm | 0.5 | PLA |
| L knee bushing | 0.2 | PLA |
| L knee ear clamp | 0.3 | PLA |
| L knee rear arm | 0.5 | PLA |
| L roll bracket | 4.3 | PLA |
| L shin | 5.9 | PLA |
| L sole | 2.6 | TPU 95A |
| L thigh | 5.7 | PLA |
| L yaw link | 4.9 | PLA |
| R ankle pitch bushing | 0.2 | PLA |
| R ankle pitch ear clamp | 0.3 | PLA |
| R ankle pitch rear arm | 0.9 | PLA |
| R foot | 8.5 | PLA |
| R hip pitch bushing | 0.2 | PLA |
| R hip pitch ear clamp | 0.3 | PLA |
| R hip pitch rear arm | 0.4 | PLA |
| R hip roll bushing | 0.2 | PLA |
| R hip roll ear clamp | 0.3 | PLA |
| R hip roll rear arm | 0.4 | PLA |
| R hip yaw bushing | 0.2 | PLA |
| R hip yaw ear clamp | 0.3 | PLA |
| R hip yaw rear arm | 0.5 | PLA |
| R knee bushing | 0.2 | PLA |
| R knee ear clamp | 0.3 | PLA |
| R knee rear arm | 0.5 | PLA |
| R roll bracket | 4.3 | PLA |
| R shin | 5.9 | PLA |
| R sole | 2.6 | TPU 95A |
| R thigh | 5.7 | PLA |
| R yaw link | 4.9 | PLA |
| beak ear clamp | 0.3 | PLA |
| body shell | 31.4 | PLA |
| chassis | 17.6 | PLA |
| head frame | 8.6 | PLA |
| head pitch ear clamp | 0.3 | PLA |
| hood | 24.7 | PLA |
| jaw | 3.4 | PLA |
| neck pitch ear clamp | 0.3 | PLA |
| neck plate | 1.7 | PLA |
| upper bill | 4.8 | PLA |

The body shell and hood print with 1.2 mm walls (3 lines of a 0.4 mm nozzle): their masses are from that wall; the collision checks give every shell 2 mm.

## Not verified

- **The SG90's shape:** case length, width, height to the tower and spline, across the ears and to their underside are TowerPro's; the case's top (22.5 mm), the ears' thickness, the ear holes (2.0 mm at +/-14.4 mm) and the shaft's offset (5.6 mm) are read off a drawing that is not to scale. The MG90S is taken as the same shape. Measure one before printing.
- **Torque:** the stall figures are the makers', at about 5 V. A real micro servo sags well before it stalls, and these are static estimates (`tools/checks.py`, `tools/nano_sweep.py`).
- **The 21T spline:** the teeth aren't modelled; see prints/nano/README.md.
- **Masses:** every printed part from its volume; the Pi's 11 g is the repo's figure, the header board 4 g a guess.
- **Strength:** LOAD in `tools/buildable.py` is a beam estimate, not FEA. Nothing has been printed, built or walked.
