meetsitaram/duck-droids/docs/dynamixel/parts/imu.png

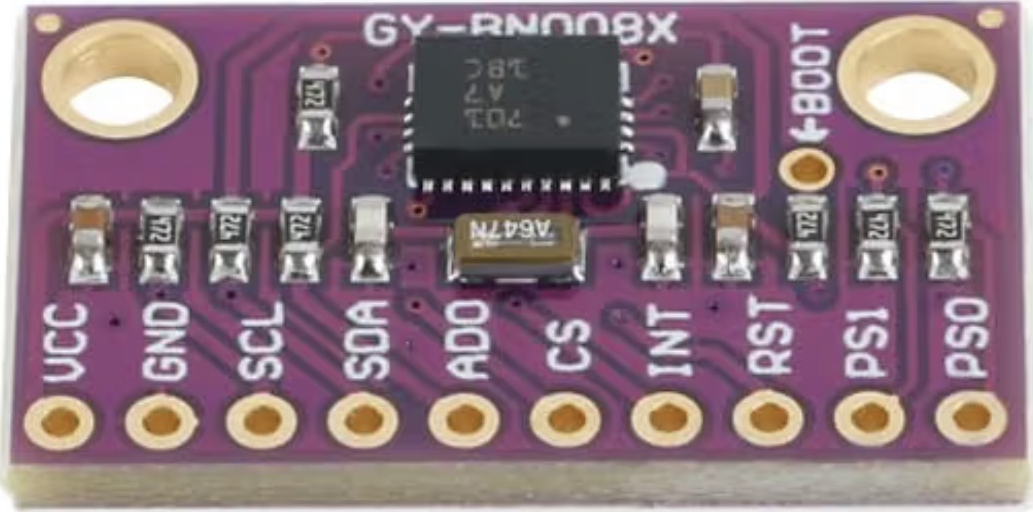
docs/dynamixel/parts/imu.png
