meetsitaram/duck-droids/docs/dynamixel/parts/switch.png

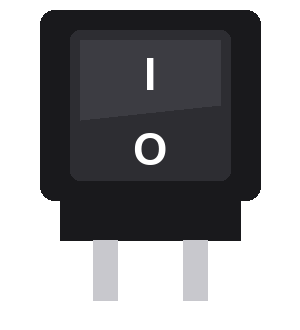
docs/dynamixel/parts/switch.png
