meetsitaram/duck-droids/docs/hd1910/parts/battery.png

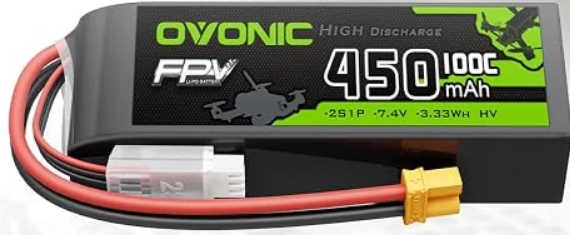
docs/hd1910/parts/battery.png
