meetsitaram/duck-droids/docs/hd1910/parts/pi_photo.png

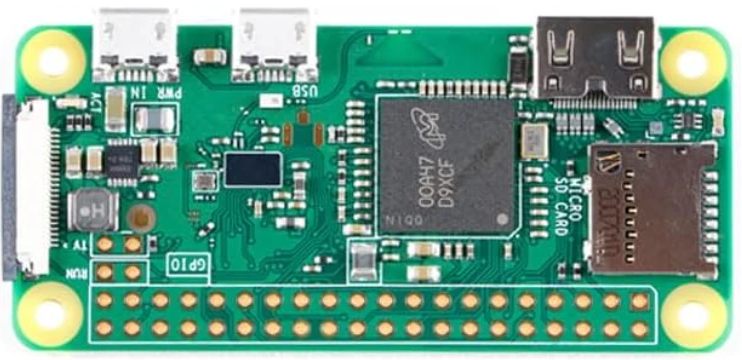
docs/hd1910/parts/pi_photo.png
