meetsitaram/duck-droids/docs/hd1910/parts/servo.png

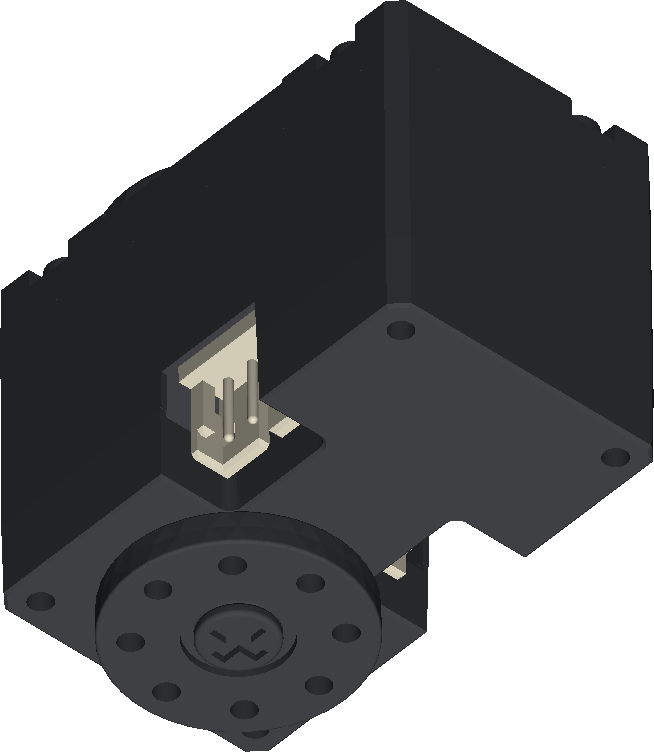
docs/hd1910/parts/servo.png
