meetsitaram/duck-droids/docs/hd1910/parts/usb_buck_r.png

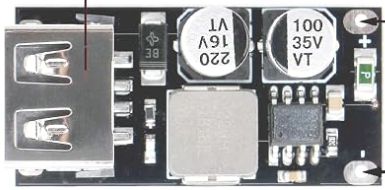
docs/hd1910/parts/usb_buck_r.png
