meetsitaram/duck-droids/docs/hd1910/parts/waveshare_r.png

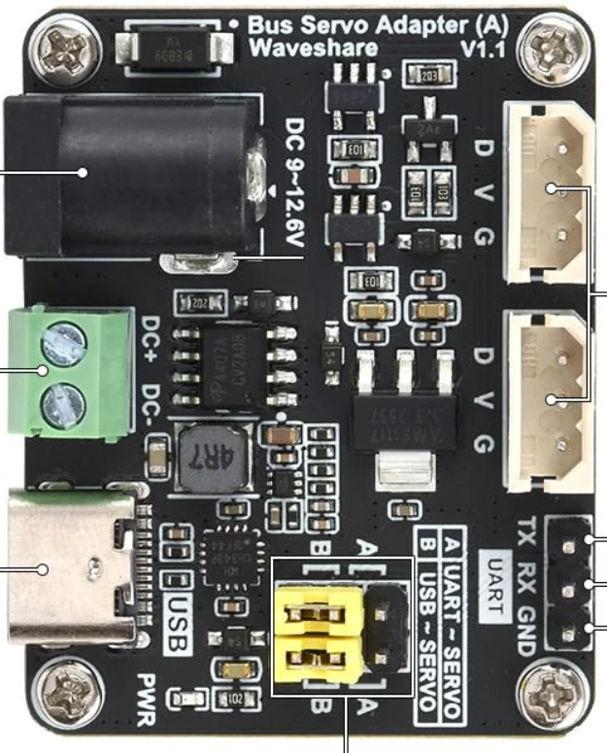
docs/hd1910/parts/waveshare_r.png
