meetsitaram/duck-droids/cad/duck-droids-dynamixel.step

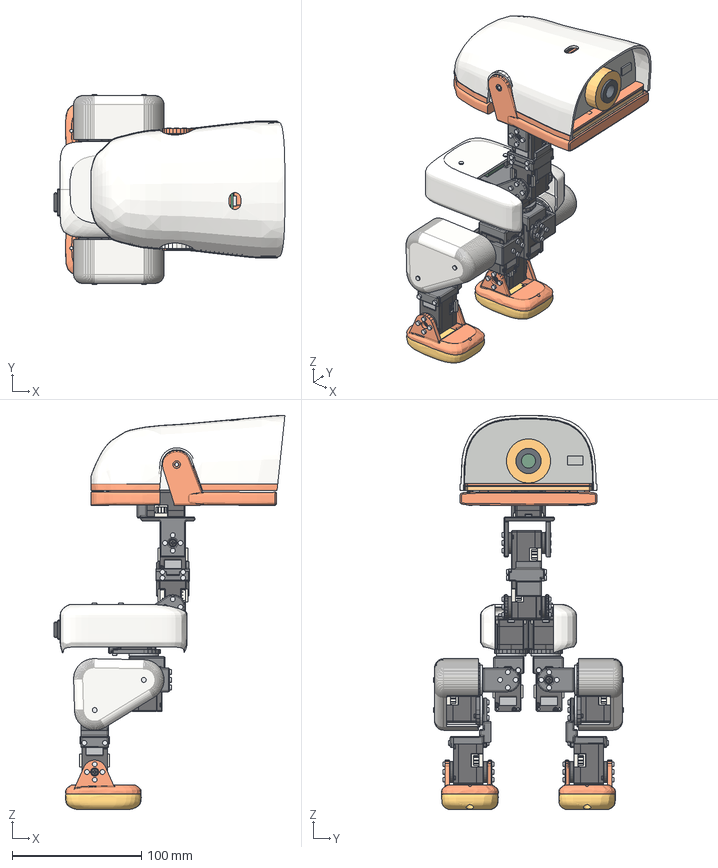
[picture p179: CAD file, 2026-11-10]
cad/duck-droids-dynamixel.step
178.5 x 147.1 x 304.7 mm
