meetsitaram/duck-droids/prints/dynamixel/jaw.stl

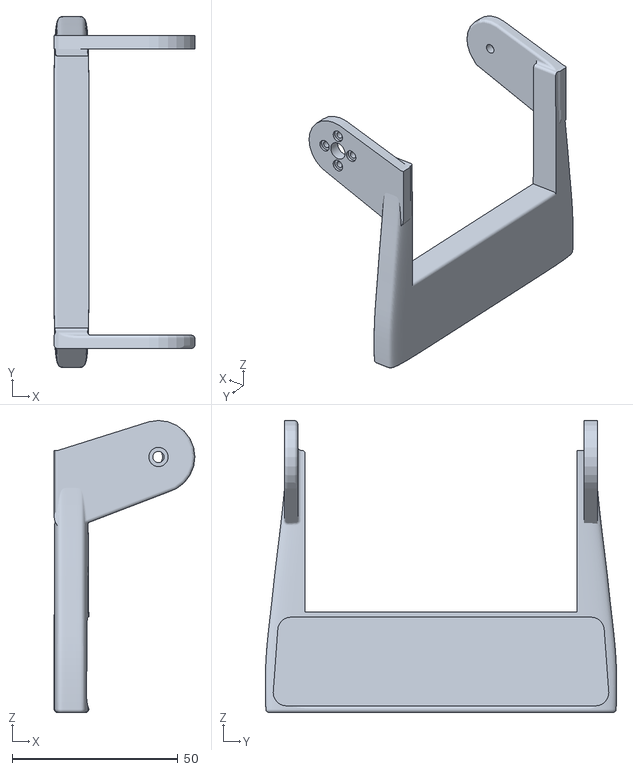
[picture p181: CAD file, 2026-11-10]
prints/dynamixel/jaw.stl
42.5 x 106.0 x 88.1
