meetsitaram/duck-droids/prints/dynamixel/optional/idler_wheel.stl

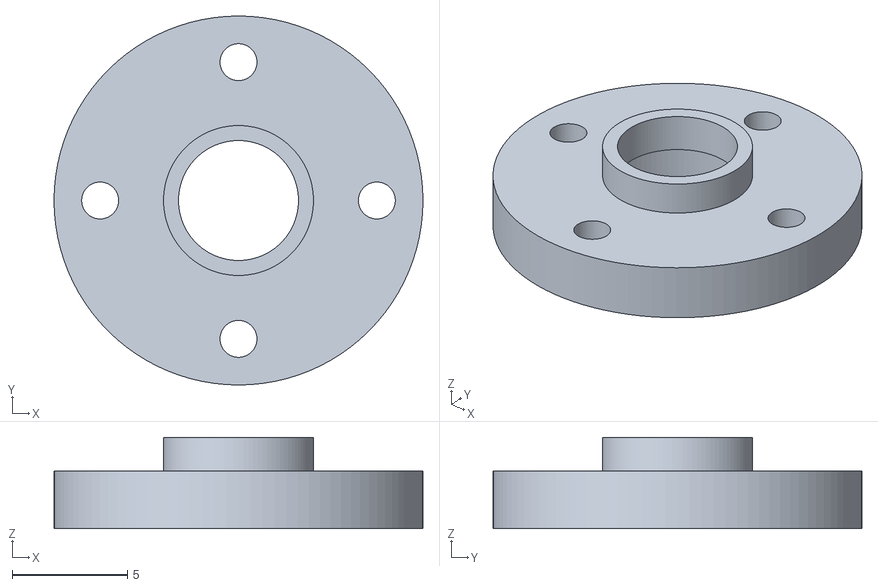
[picture p182: CAD file, 2026-11-05]
prints/dynamixel/optional/idler_wheel.stl
16.0 x 16.0 x 3.95
