meetsitaram/duck-droids/prints/hobby/R_sole.stl

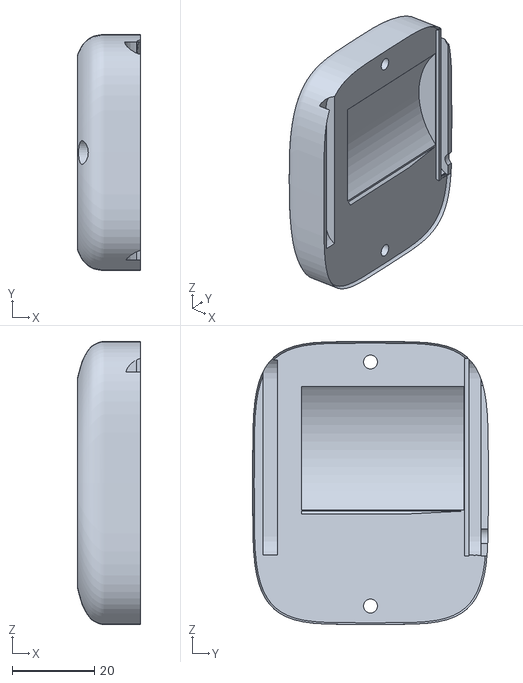
[picture p183: CAD file, 2026-11-06]
prints/hobby/R_sole.stl
15.4 x 57.5 x 69.0
