meetsitaram/duck-droids/prints/nano/L_hip_pitch_bushing.stl

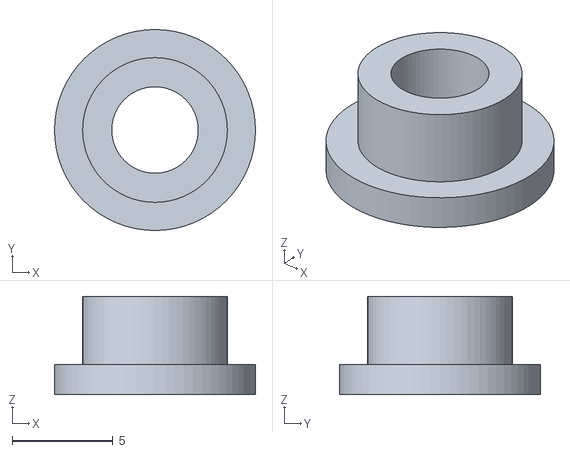
[picture p184: CAD file, 2026-11-06]
prints/nano/L_hip_pitch_bushing.stl
10.00 x 10.0 x 4.90
