meetsitaram/duck-droids/urdf/meshes/L_hip_pitch_link.stl

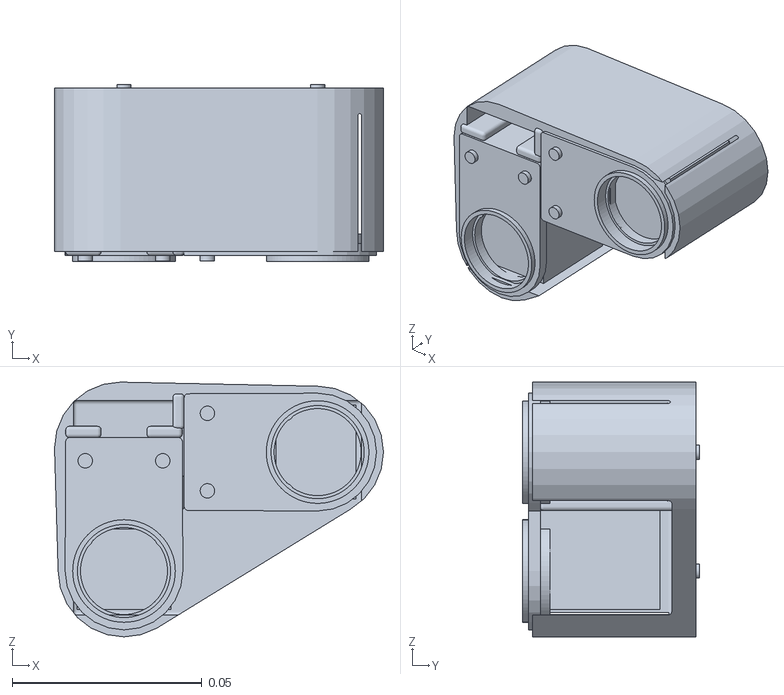
[picture p185: CAD file, 2026-11-04]
urdf/meshes/L_hip_pitch_link.stl
0.0866 x 0.0466 x 0.067
