meetsitaram/duck-droids/cad/duck-droids-hybrid.step

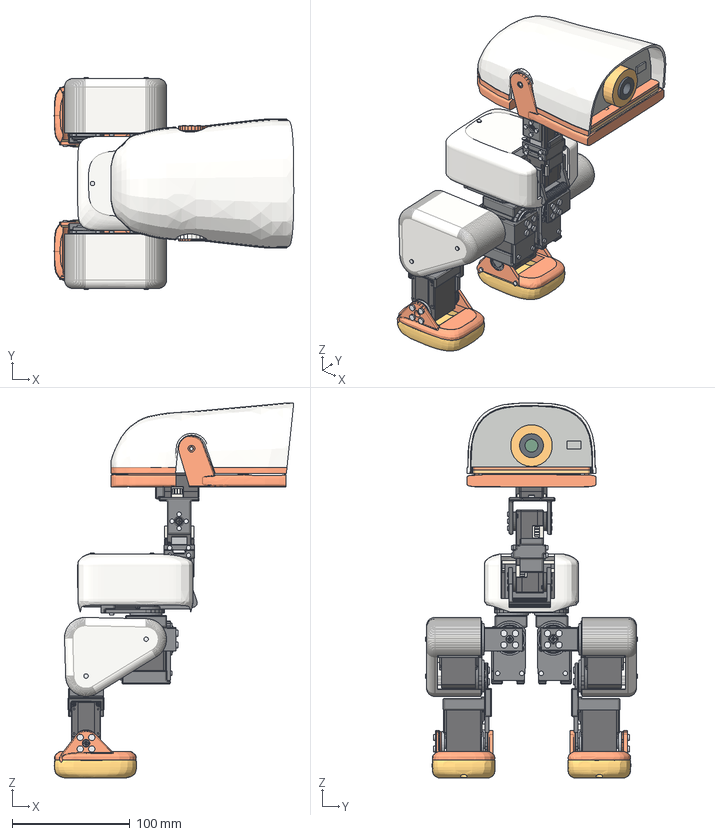
[picture p186: CAD file, 2026-11-06]
cad/duck-droids-hybrid.step
203.2 x 179.9 x 318.2 mm
