meetsitaram/duck-droids/pi/sim/model/meshes/trunk_base.stl

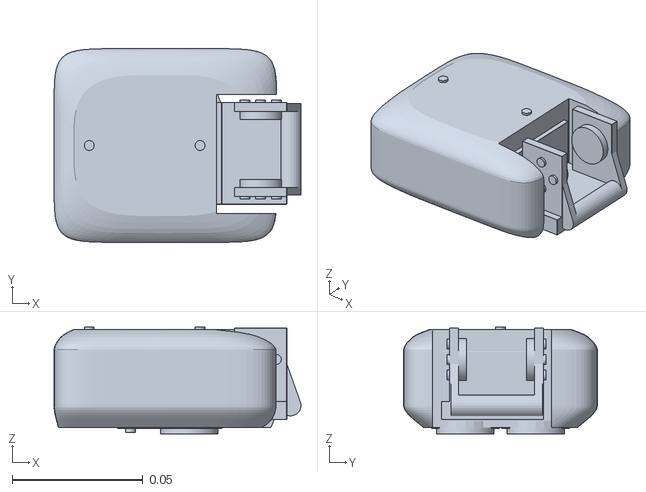
[picture p187: CAD file, 2026-11-05]
pi/sim/model/meshes/trunk_base.stl
0.0946 x 0.0742 x 0.0409
