meetsitaram/duck-droids/prints/dynamixel/head_yaw_sheet.stl

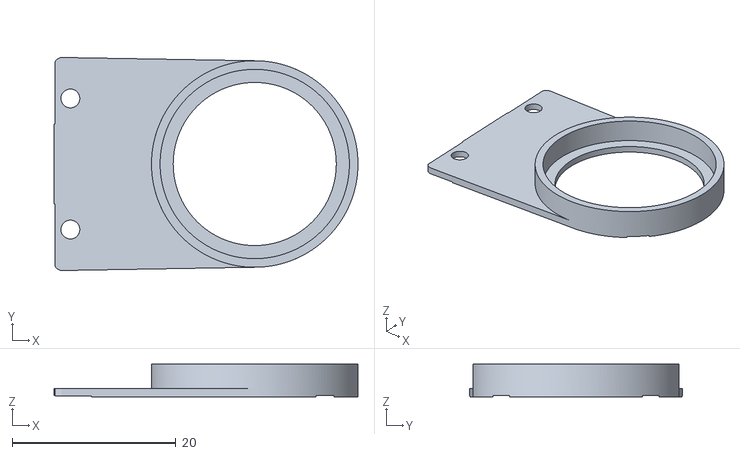
[picture p188: CAD file, 2026-11-10]
prints/dynamixel/head_yaw_sheet.stl
37.1 x 26.0 x 4.00
