meetsitaram/duck-droids/prints/dynamixel/optional/idler_bushing.stl

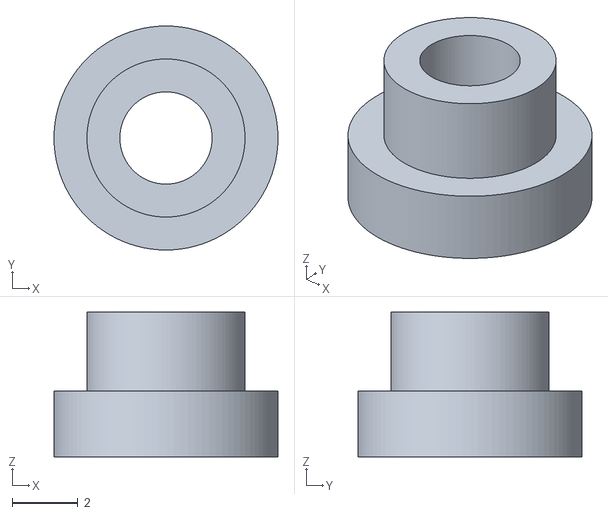
[picture p189: CAD file, 2026-11-05]
prints/dynamixel/optional/idler_bushing.stl
6.80 x 6.80 x 4.40
