meetsitaram/duck-droids/prints/hobby/jaw.stl

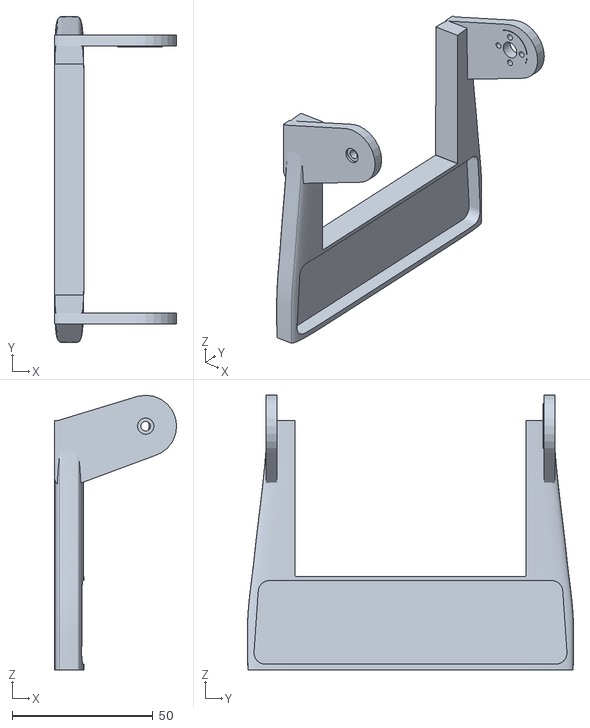
[picture p190: CAD file, 2026-11-06]
prints/hobby/jaw.stl
43.5 x 115.9 x 97.6
