meetsitaram/duck-droids/prints/nano/L_foot.stl

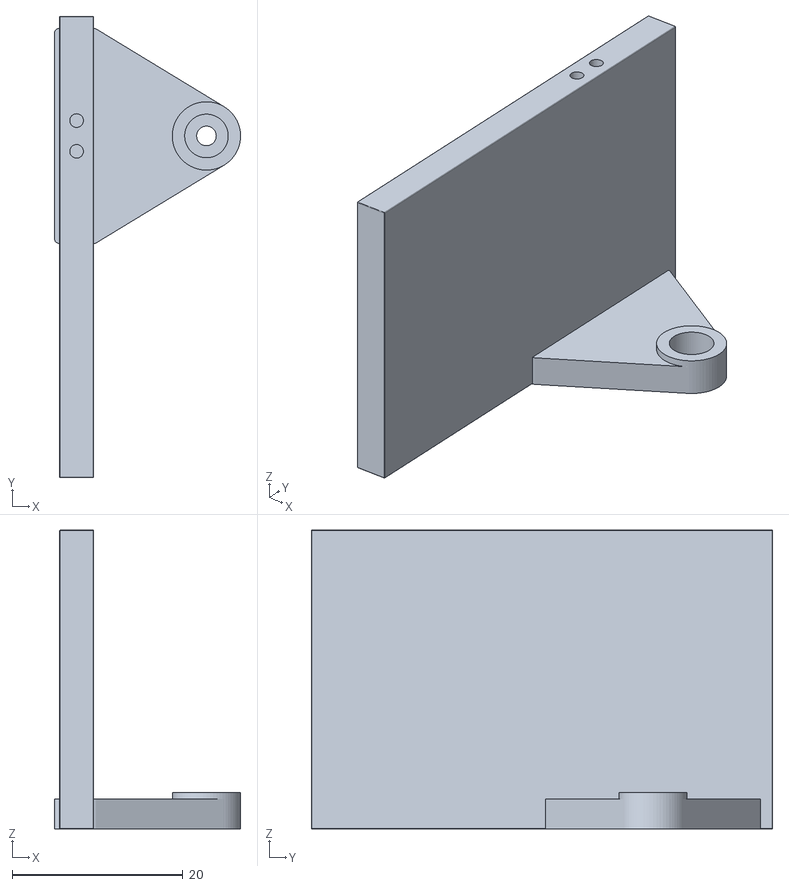
[picture p191: CAD file, 2026-11-06]
prints/nano/L_foot.stl
21.8 x 54.0 x 35.0
