meetsitaram/duck-droids/urdf/meshes/L_hip_roll_link.stl

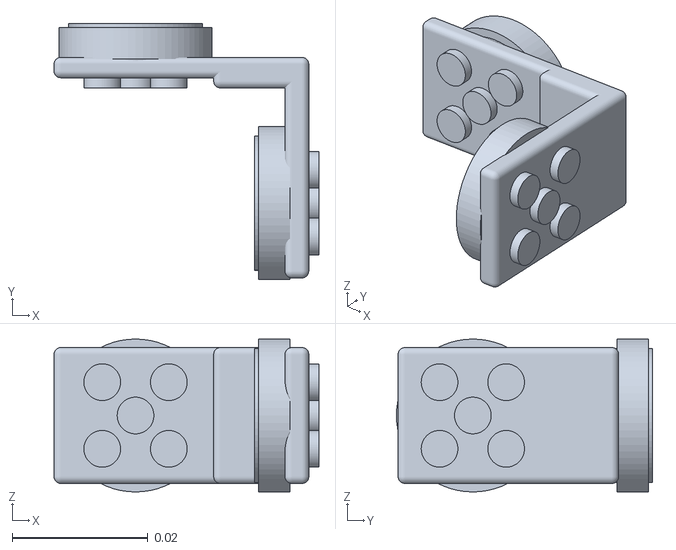
[picture p192: CAD file, 2026-11-04]
urdf/meshes/L_hip_roll_link.stl
0.039 x 0.0377 x 0.0225
