meetsitaram/duck-droids/cad/duck-droids-feetech.step

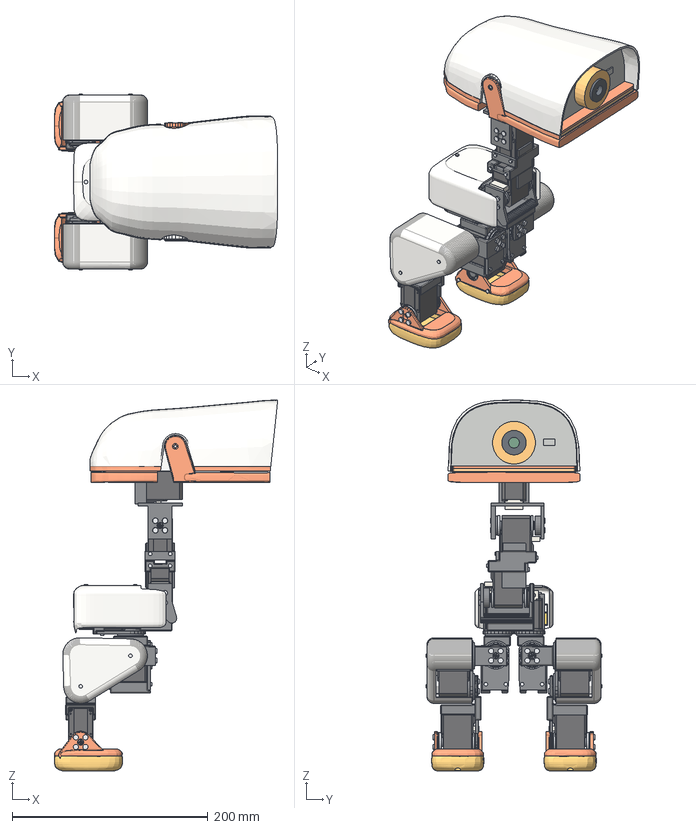
[picture p193: CAD file, 2026-11-06]
cad/duck-droids-feetech.step
228.5 x 179.9 x 379.3 mm
