meetsitaram/duck-droids/pi/sim/model/meshes/leg.stl

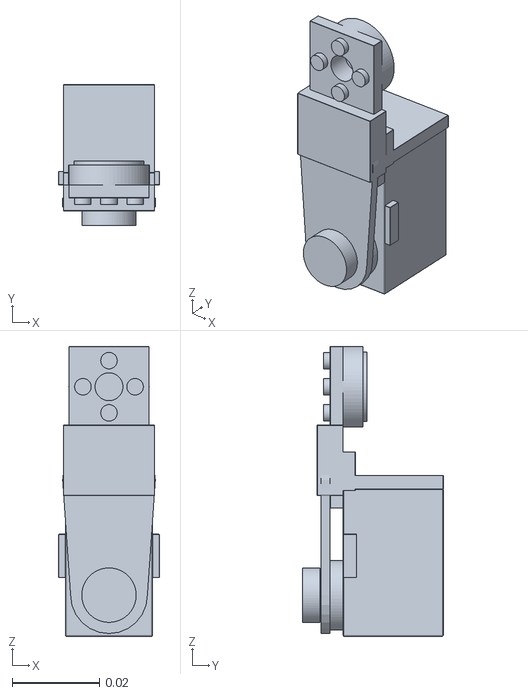
[picture p194: CAD file, 2026-11-05]
pi/sim/model/meshes/leg.stl
0.0232 x 0.0323 x 0.0666
