meetsitaram/duck-droids/prints/dynamixel/R_shin.stl

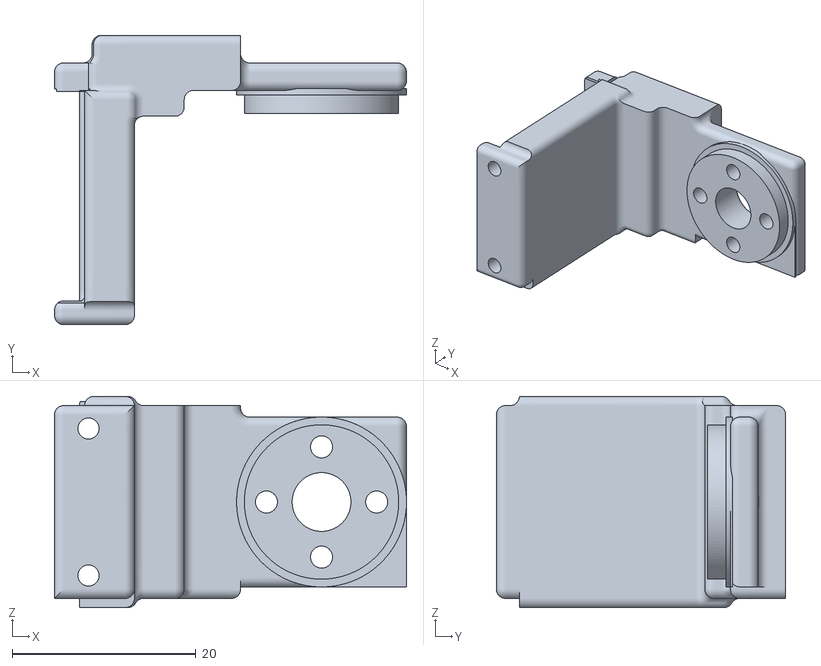
[picture p195: CAD file, 2026-11-10]
prints/dynamixel/R_shin.stl
38.3 x 31.5 x 23.0
