meetsitaram/duck-droids/prints/hobby/L_hip_yaw_lid.stl

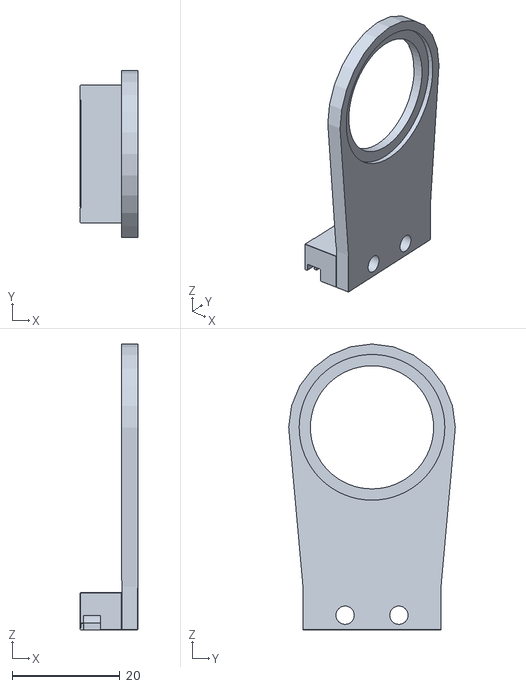
[picture p196: CAD file, 2026-11-06]
prints/hobby/L_hip_yaw_lid.stl
10.7 x 31.0 x 53.2
