meetsitaram/duck-droids/prints/nano/R_hip_yaw_ear_clamp.stl

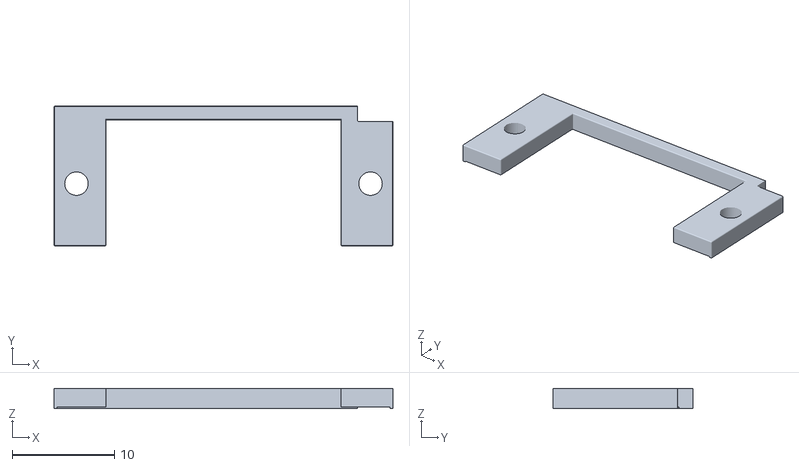
[picture p197: CAD file, 2026-11-06]
prints/nano/R_hip_yaw_ear_clamp.stl
33.2 x 13.7 x 2.00
