meetsitaram/duck-droids/urdf/meshes/L_foot.stl

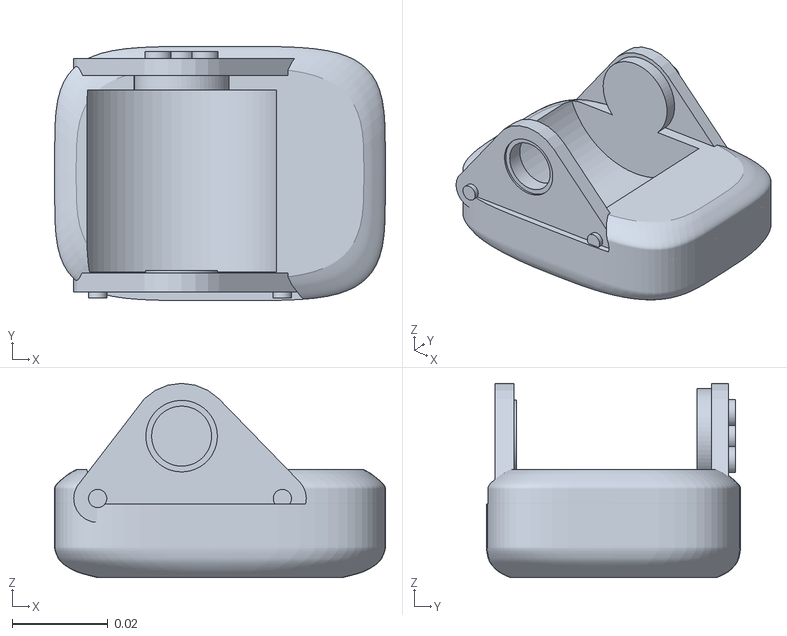
[picture p198: CAD file, 2026-11-04]
urdf/meshes/L_foot.stl
0.069 x 0.053 x 0.0405
