meetsitaram/duck-droids/prints/dynamixel/head_yaw_bracket.stl

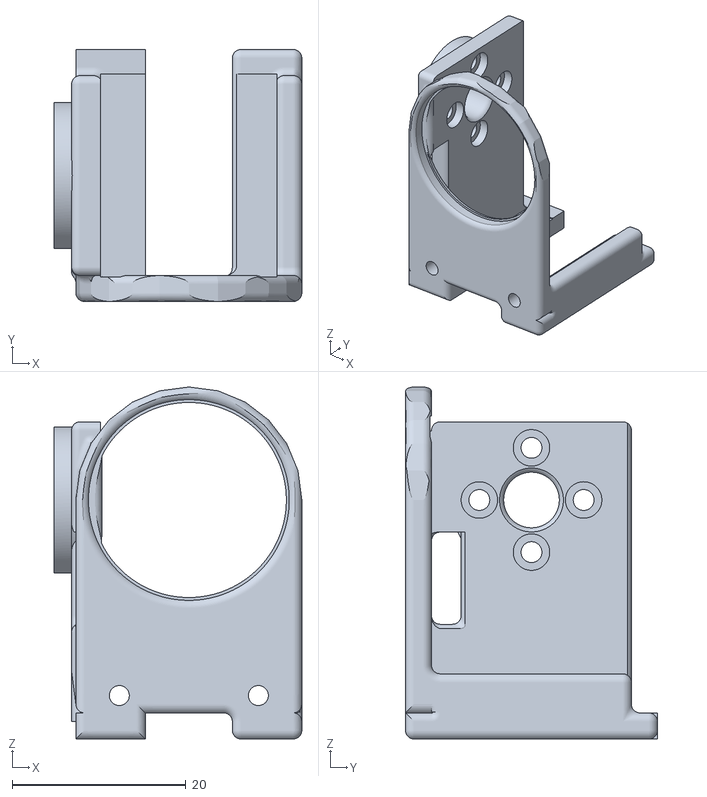
[picture p200: CAD file, 2026-11-10]
prints/dynamixel/head_yaw_bracket.stl
28.5 x 29.0 x 40.5
