meetsitaram/duck-droids/prints/hobby/body_shell.stl

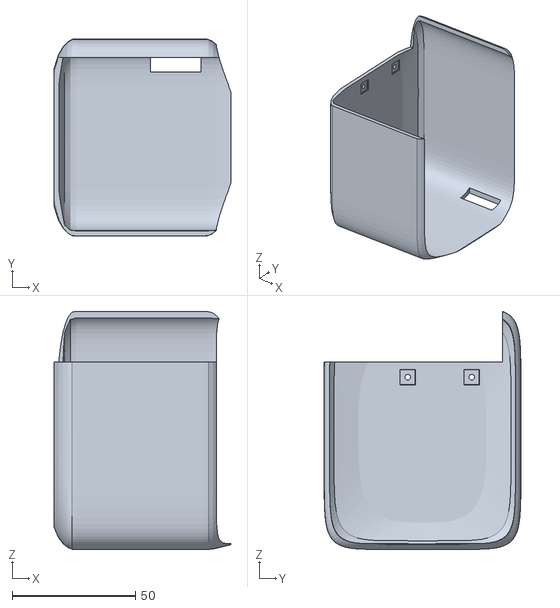
[picture p201: CAD file, 2026-11-06]
prints/hobby/body_shell.stl
71.9 x 80.0 x 96.7
