meetsitaram/duck-droids/prints/nano/L_hip_yaw_rear_arm.stl

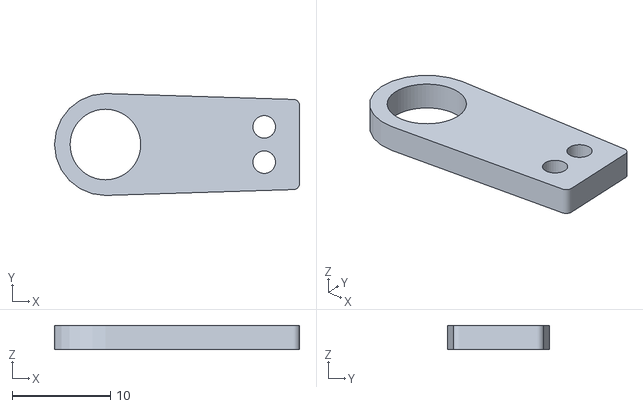
[picture p202: CAD file, 2026-11-06]
prints/nano/L_hip_yaw_rear_arm.stl
25.0 x 10.4 x 2.50
