meetsitaram/duck-droids/urdf/meshes/L_knee_link.stl

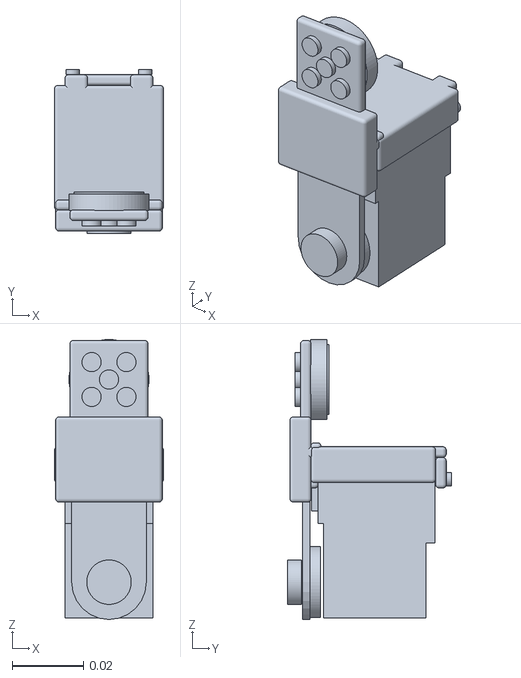
[picture p203: CAD file, 2026-11-04]
urdf/meshes/L_knee_link.stl
0.0307 x 0.0462 x 0.0788
