meetsitaram/duck-droids/prints/dynamixel/L_knee_lid.stl

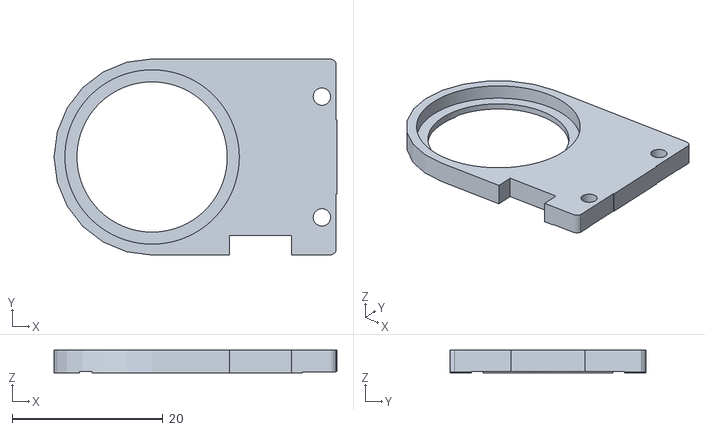
[picture p205: CAD file, 2026-11-10]
prints/dynamixel/L_knee_lid.stl
37.5 x 26.0 x 3.00
