meetsitaram/duck-droids/prints/hobby/head_yaw_bracket.stl

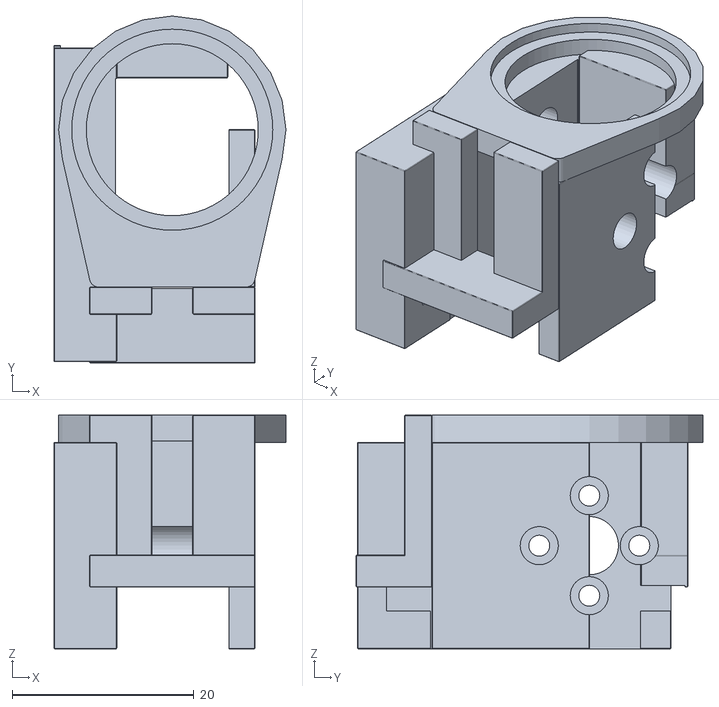
[picture p206: CAD file, 2026-11-06]
prints/hobby/head_yaw_bracket.stl
25.5 x 38.2 x 25.7
