meetsitaram/duck-droids/pi/sim/model/meshes/yaw2roll.stl

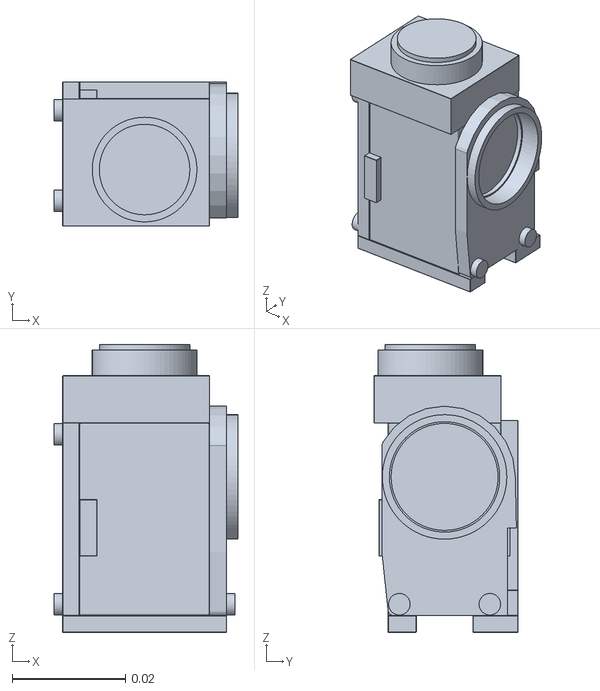
[picture p207: CAD file, 2026-11-05]
pi/sim/model/meshes/yaw2roll.stl
0.0325 x 0.0255 x 0.0509
