meetsitaram/duck-droids/prints/dynamixel/face.stl

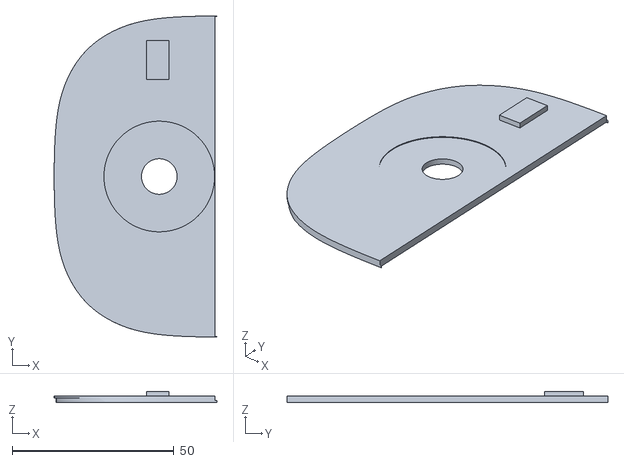
[picture p208: CAD file, 2026-11-10]
prints/dynamixel/face.stl
50.3 x 99.2 x 3.50
