meetsitaram/duck-droids/prints/hobby/eye_iris.stl

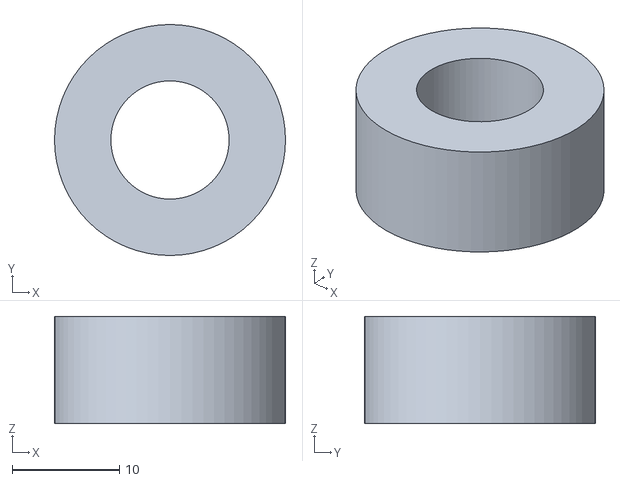
[picture p209: CAD file, 2026-11-06]
prints/hobby/eye_iris.stl
21.5 x 21.5 x 10.00
