meetsitaram/duck-droids/prints/nano/L_shin.stl

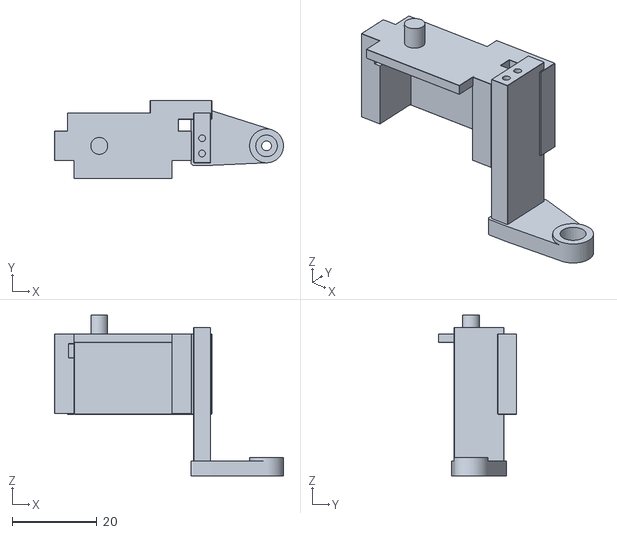
[picture p210: CAD file, 2026-11-06]
prints/nano/L_shin.stl
54.0 x 18.5 x 37.9
