meetsitaram/duck-droids/urdf/meshes/neck_link.stl

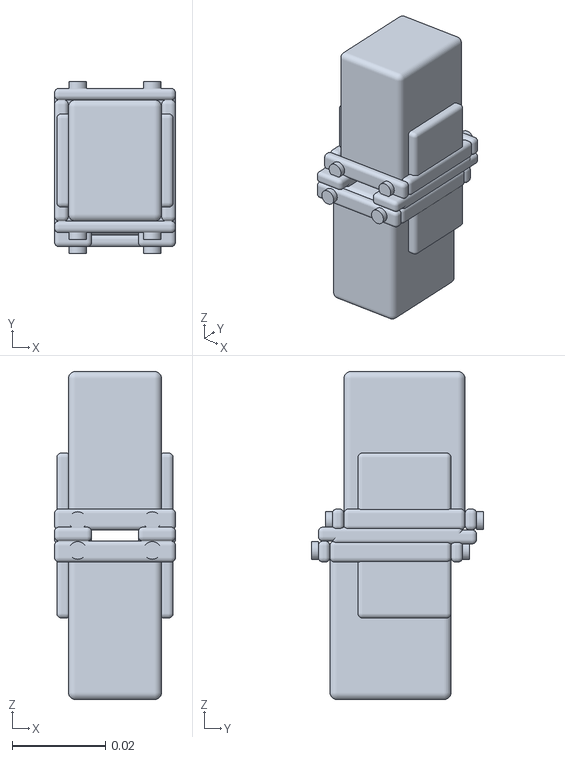
[picture p211: CAD file, 2026-11-04]
urdf/meshes/neck_link.stl
0.026 x 0.037 x 0.0704
