meetsitaram/duck-droids/pi/sim/model/meshes/jaw_hull.stl

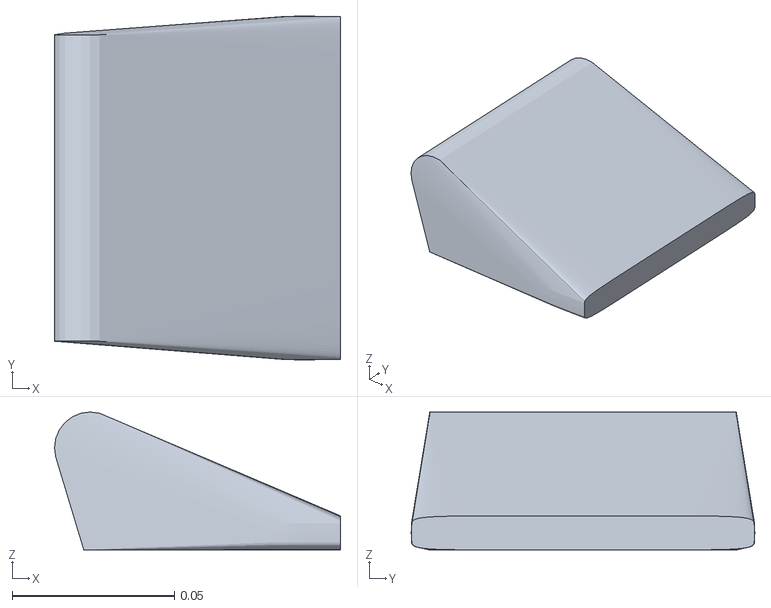
[picture p212: CAD file, 2026-11-05]
pi/sim/model/meshes/jaw_hull.stl
0.0881 x 0.106 x 0.0425
