meetsitaram/duck-droids/prints/dynamixel/L_thigh_cover.stl

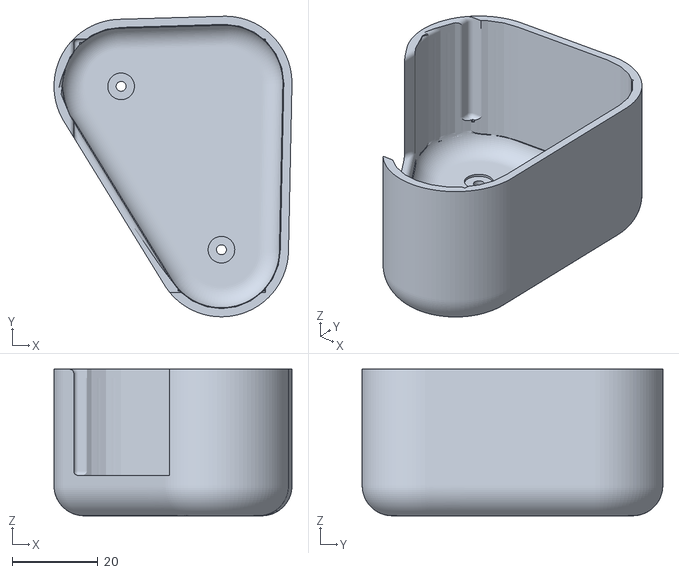
[picture p213: CAD file, 2026-11-10]
prints/dynamixel/L_thigh_cover.stl
55.4 x 69.9 x 34.1
