meetsitaram/duck-droids/prints/hobby/head_pitch_lid.stl

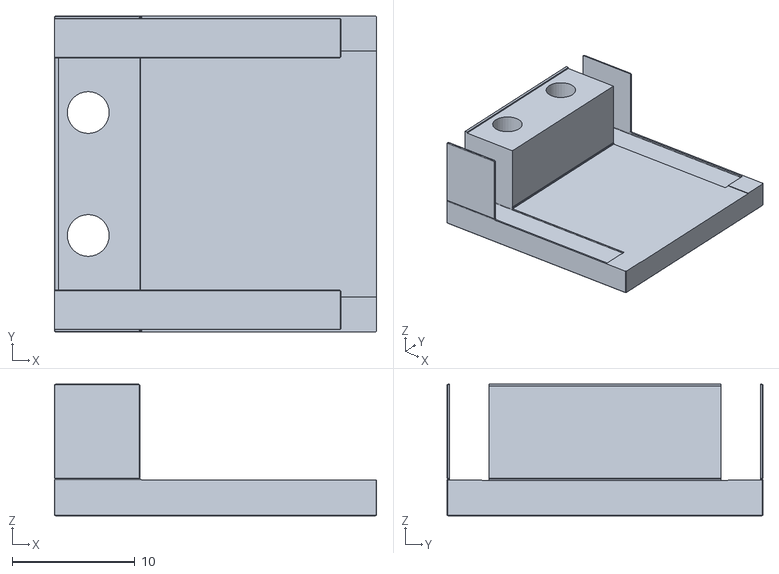
[picture p214: CAD file, 2026-11-06]
prints/hobby/head_pitch_lid.stl
26.2 x 25.7 x 10.7
