meetsitaram/duck-droids/prints/nano/hood.stl

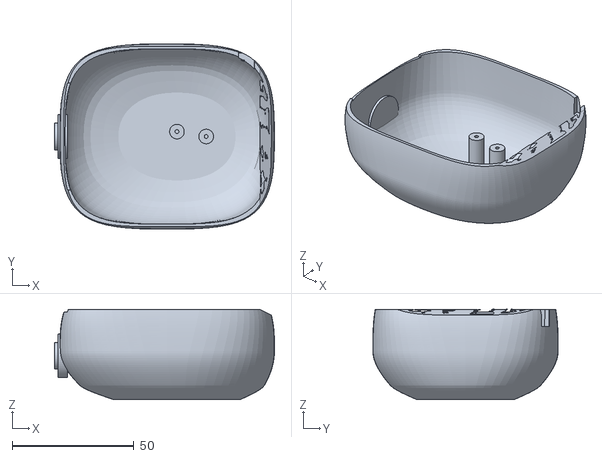
[picture p215: CAD file, 2026-11-06]
prints/nano/hood.stl
90.2 x 76.0 x 37.0
