meetsitaram/duck-droids/pi/sim/model/meshes/hip_l_2.stl

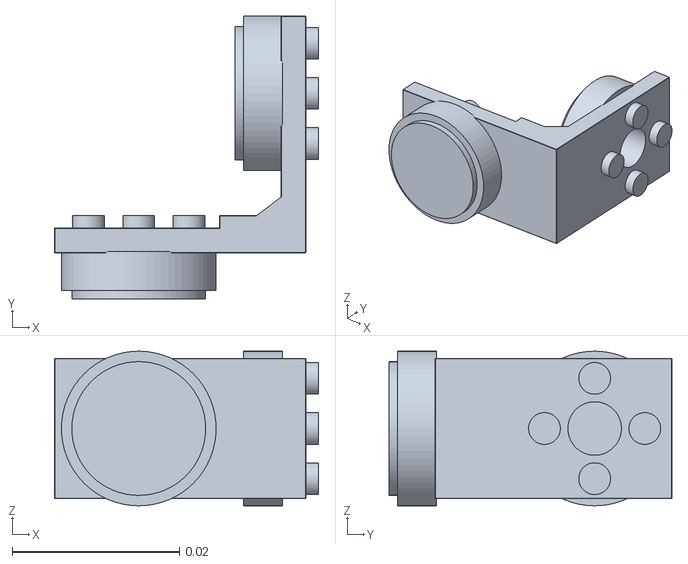
[picture p216: CAD file, 2026-11-05]
pi/sim/model/meshes/hip_l_2.stl
0.0316 x 0.0338 x 0.0185
