meetsitaram/duck-droids/prints/dynamixel/L_shoe.stl

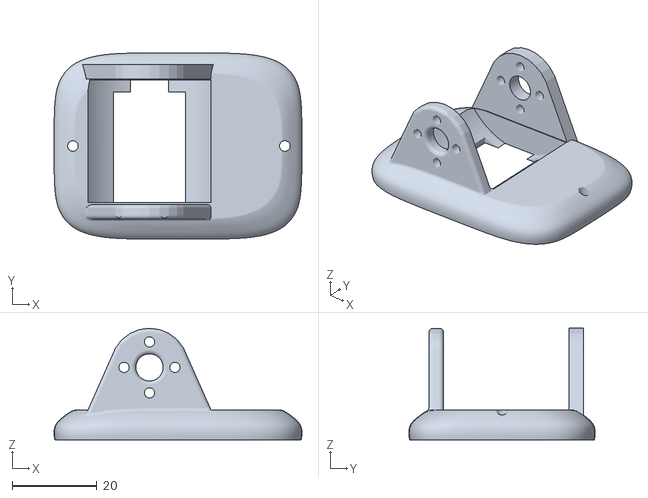
[picture p217: CAD file, 2026-11-10]
prints/dynamixel/L_shoe.stl
58.5 x 44.0 x 26.3
