meetsitaram/duck-droids/prints/hobby/head_roll_rear_hub.stl

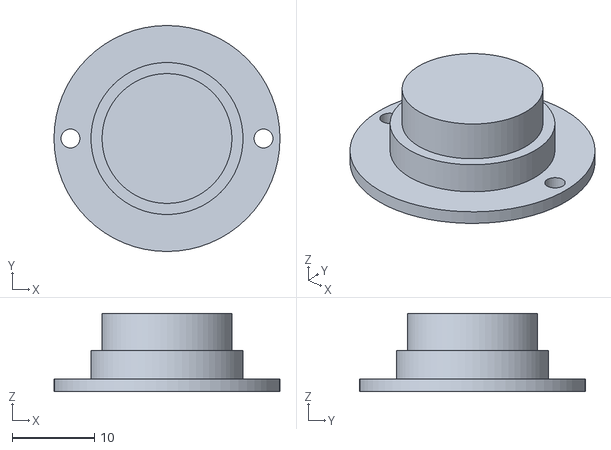
[picture p218: CAD file, 2026-11-06]
prints/hobby/head_roll_rear_hub.stl
27.5 x 27.5 x 9.50
