meetsitaram/duck-droids/prints/nano/L_hip_roll_rear_arm.stl

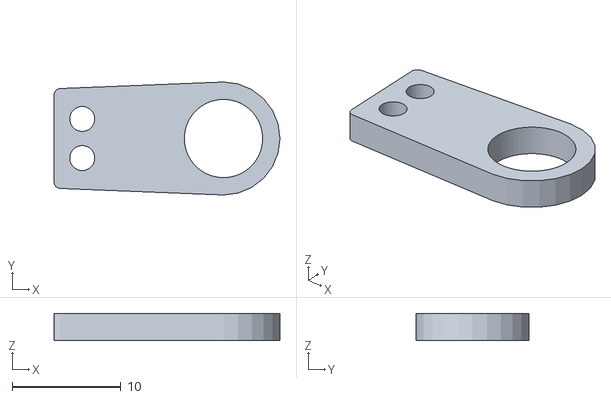
[picture p219: CAD file, 2026-11-06]
prints/nano/L_hip_roll_rear_arm.stl
20.8 x 10.4 x 2.50
