meetsitaram/duck-droids/urdf/meshes/head_pitch_link.stl

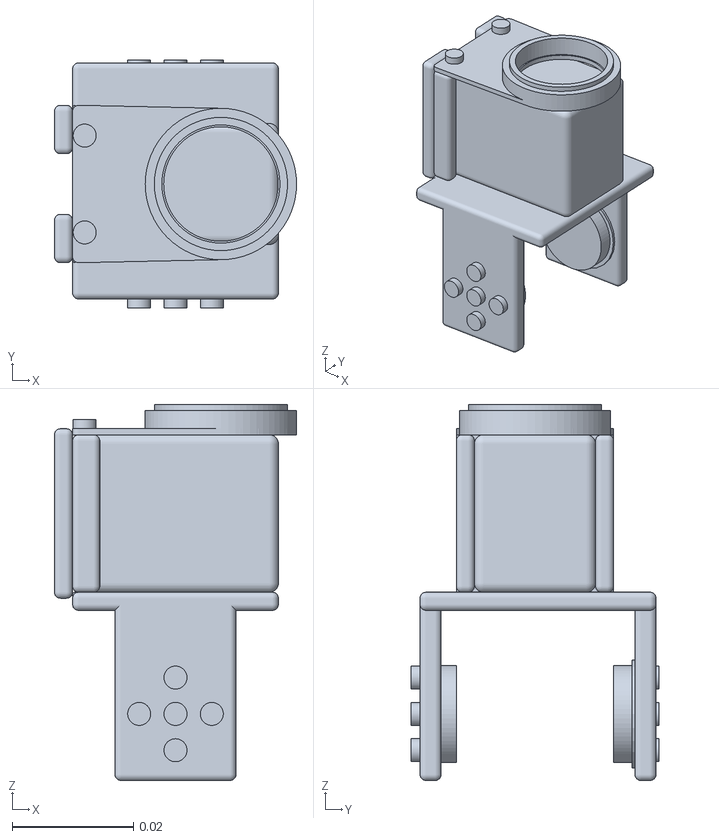
[picture p220: CAD file, 2026-11-04]
urdf/meshes/head_pitch_link.stl
0.04 x 0.041 x 0.0621
