meetsitaram/duck-droids/pi/sim/model/meshes/upper_leg_left.stl

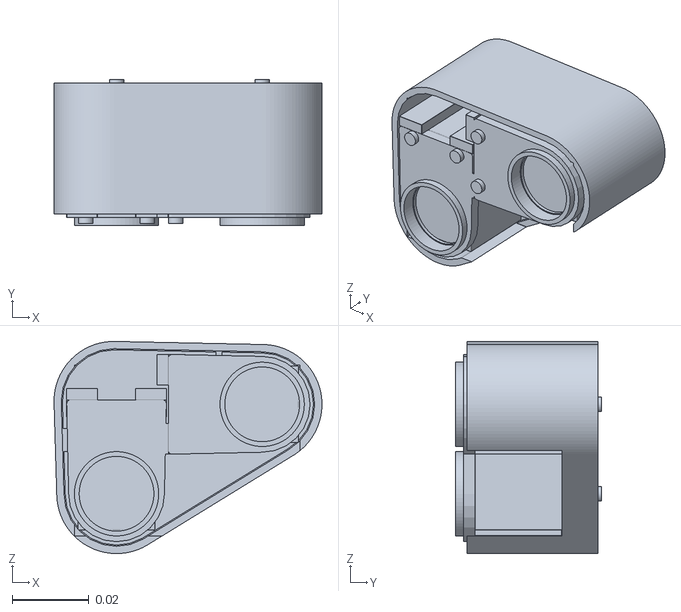
[picture p221: CAD file, 2026-11-05]
pi/sim/model/meshes/upper_leg_left.stl
0.0699 x 0.038 x 0.0554
