meetsitaram/duck-droids/prints/dynamixel/R_hip_pitch_lid.stl

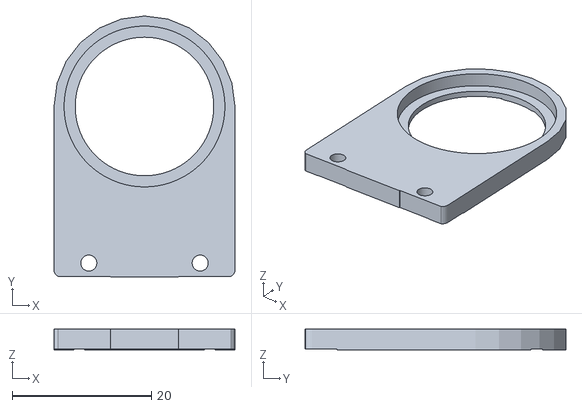
[picture p222: CAD file, 2026-11-10]
prints/dynamixel/R_hip_pitch_lid.stl
26.0 x 37.5 x 3.00
