meetsitaram/duck-droids/prints/hobby/head_roll_lid.stl

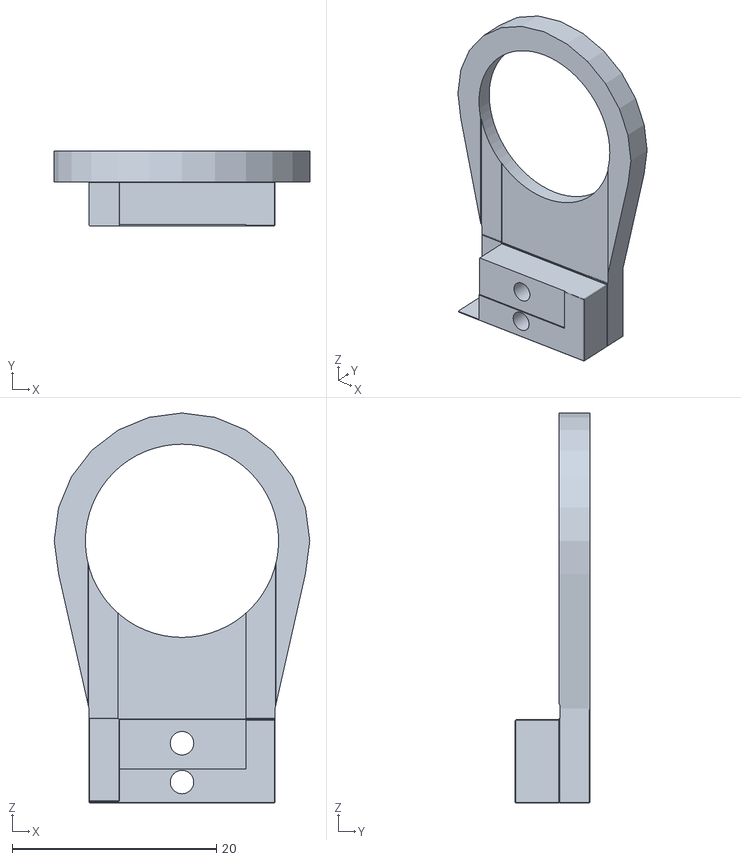
[picture p223: CAD file, 2026-11-06]
prints/hobby/head_roll_lid.stl
25.0 x 7.30 x 38.2
