meetsitaram/duck-droids/pi/sim/model/meshes/jaw_soft.stl

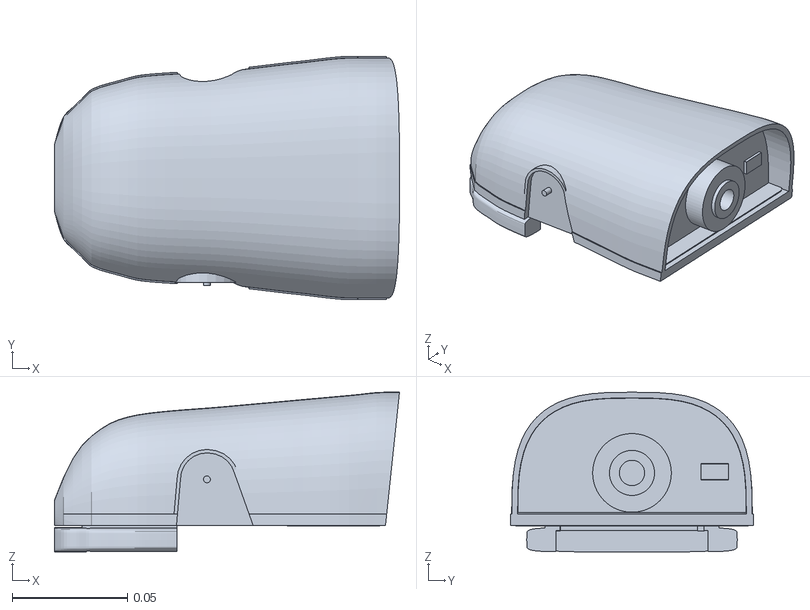
[picture p224: CAD file, 2026-11-05]
pi/sim/model/meshes/jaw_soft.stl
0.15 x 0.106 x 0.0694
