meetsitaram/duck-droids/prints/dynamixel/head_roll_rear_spacer.stl

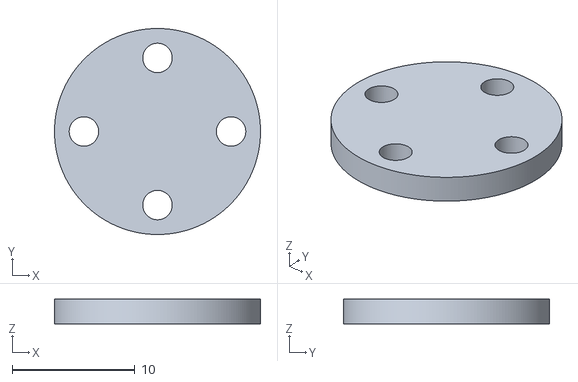
[picture p225: CAD file, 2026-11-10]
prints/dynamixel/head_roll_rear_spacer.stl
16.8 x 16.8 x 2.00
