meetsitaram/duck-droids/prints/hobby/neck_pitch_rear_hub.stl

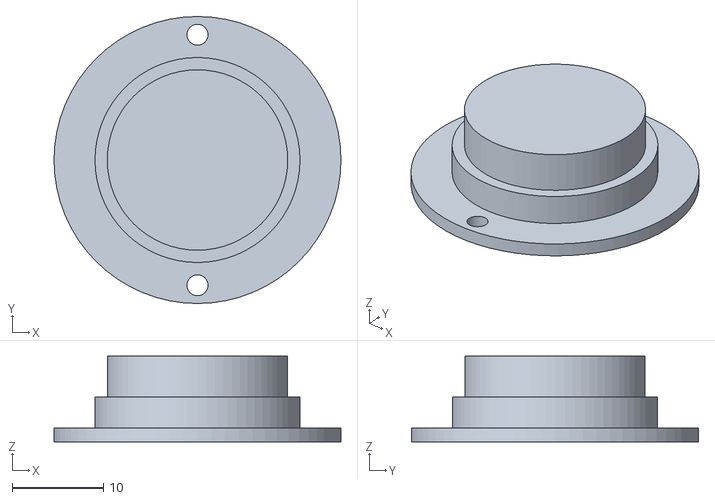
[picture p226: CAD file, 2026-11-06]
prints/hobby/neck_pitch_rear_hub.stl
31.5 x 31.5 x 9.40
