meetsitaram/duck-droids/urdf/meshes/trunk.stl

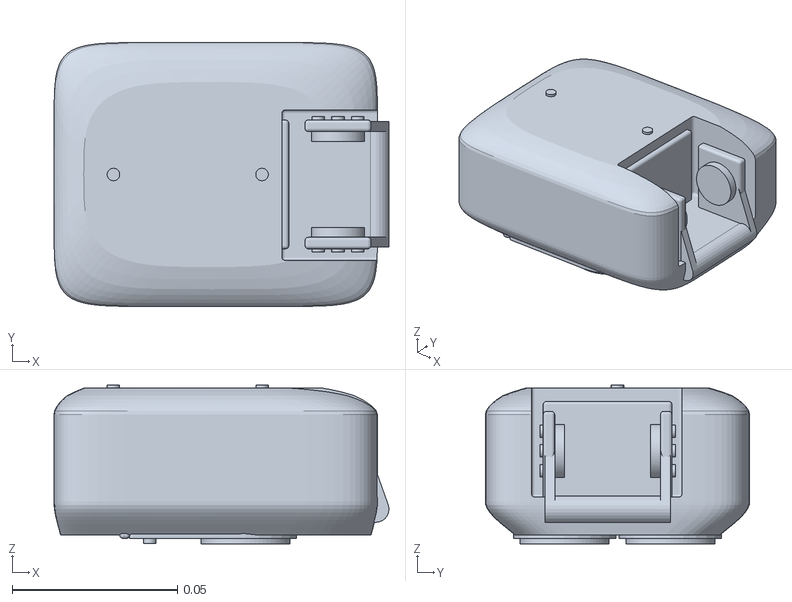
[picture p227: CAD file, 2026-11-04]
urdf/meshes/trunk.stl
0.101 x 0.08 x 0.048
