meetsitaram/duck-droids/prints/dynamixel/R_yaw_bracket.stl

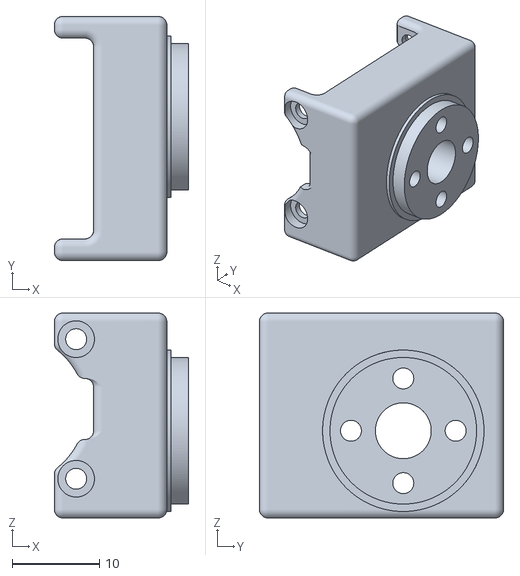
[picture p228: CAD file, 2026-11-10]
prints/dynamixel/R_yaw_bracket.stl
15.4 x 28.0 x 23.5
