meetsitaram/duck-droids/prints/nano/chassis.stl

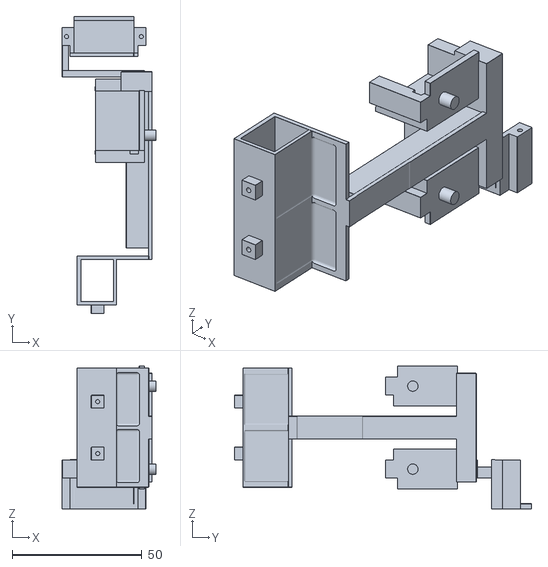
[picture p229: CAD file, 2026-11-06]
prints/nano/chassis.stl
36.2 x 114.5 x 55.1
