meetsitaram/duck-droids/urdf/meshes/L_hip_yaw_link.stl

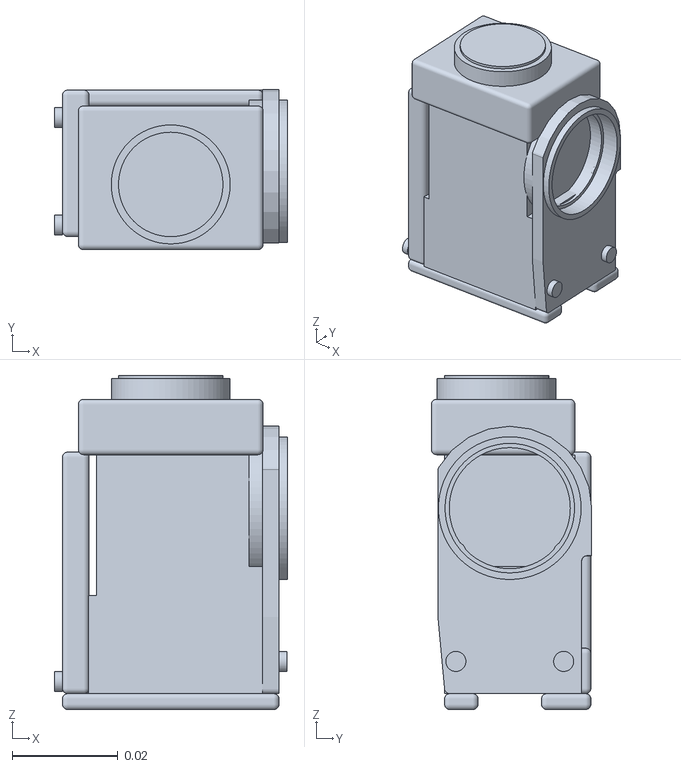
[picture p230: CAD file, 2026-11-04]
urdf/meshes/L_hip_yaw_link.stl
0.0441 x 0.0304 x 0.0632
