meetsitaram/duck-droids/pi/sim/model/meshes/neck_pitch_hull.stl

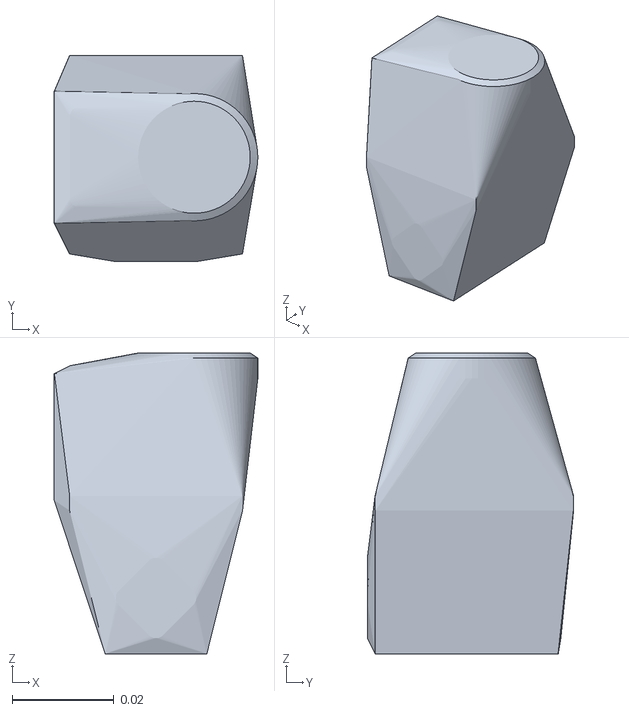
[picture p231: CAD file, 2026-11-05]
pi/sim/model/meshes/neck_pitch_hull.stl
0.04 x 0.0405 x 0.0591
