meetsitaram/duck-droids/prints/dynamixel/body_shell.stl

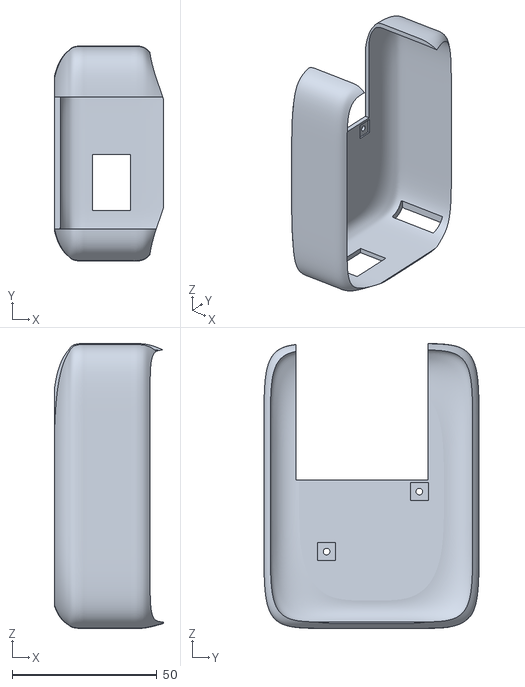
[picture p232: CAD file, 2026-11-10]
prints/dynamixel/body_shell.stl
37.5 x 74.3 x 98.3
