meetsitaram/duck-droids/prints/hobby/R_shoe.stl

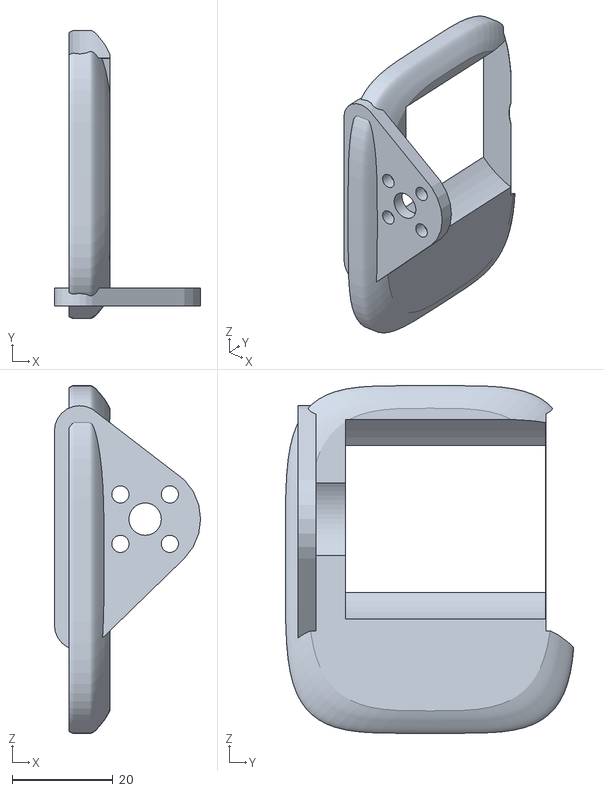
[picture p233: CAD file, 2026-11-06]
prints/hobby/R_shoe.stl
29.0 x 57.2 x 69.0
