meetsitaram/duck-droids/urdf/meshes/head.stl

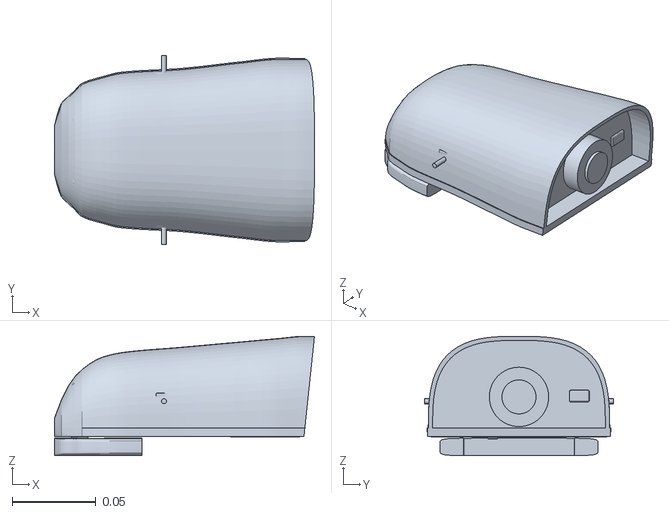
[picture p234: CAD file, 2026-11-04]
urdf/meshes/head.stl
0.155 x 0.113 x 0.0713
