meetsitaram/duck-droids/prints/dynamixel/L_roll_bracket.stl

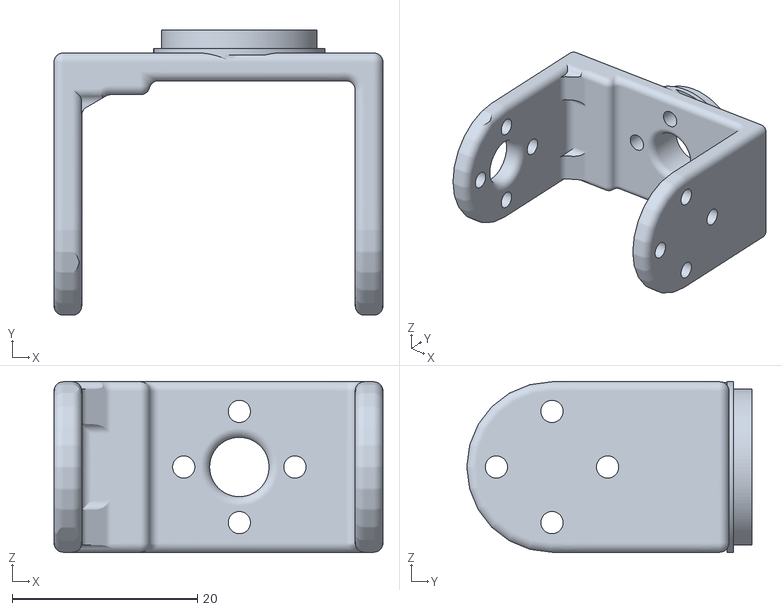
[picture p235: CAD file, 2026-11-10]
prints/dynamixel/L_roll_bracket.stl
35.5 x 30.8 x 18.5
