meetsitaram/duck-droids/urdf/meshes/beak_link.stl

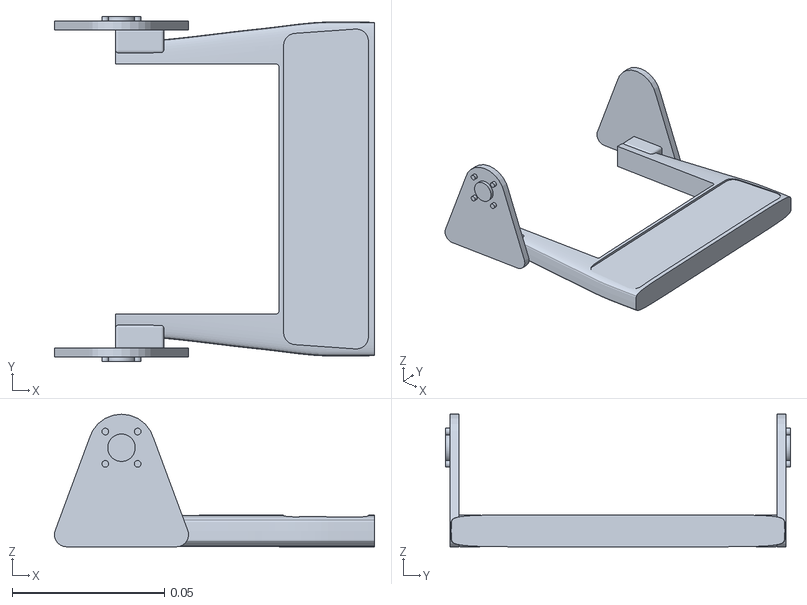
[picture p236: CAD file, 2026-11-04]
urdf/meshes/beak_link.stl
0.105 x 0.113 x 0.0435
