meetsitaram/duck-droids/pi/sim/model/meshes/yaw_roll_motion_hull.stl

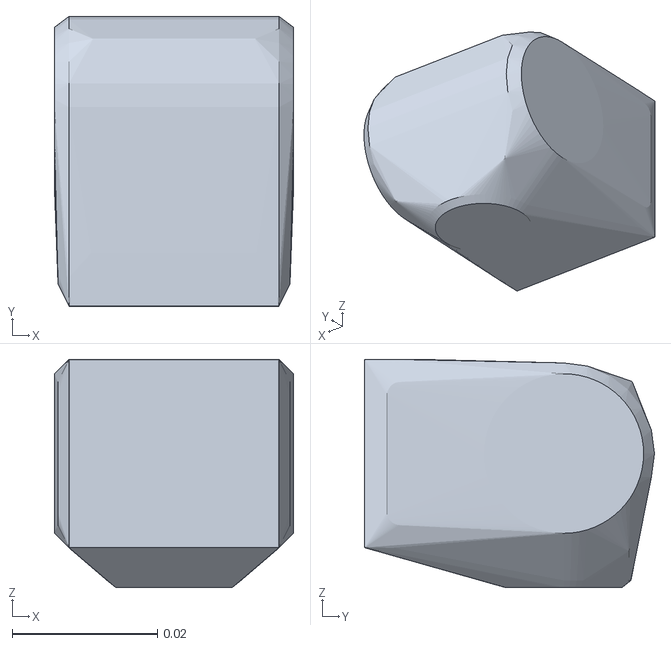
[picture p237: CAD file, 2026-11-05]
pi/sim/model/meshes/yaw_roll_motion_hull.stl
0.033 x 0.04 x 0.0315
