meetsitaram/duck-droids/prints/hobby/L_inner_ear.stl

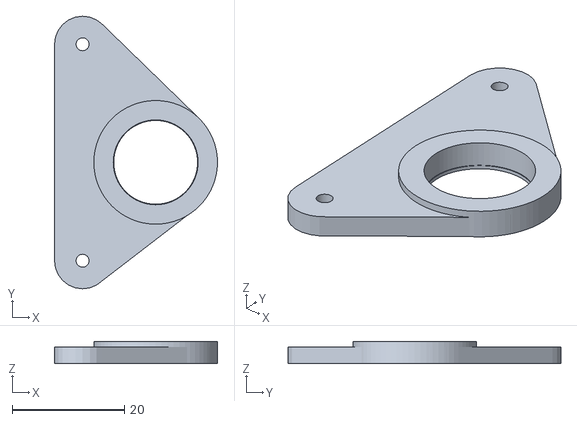
[picture p238: CAD file, 2026-11-06]
prints/hobby/L_inner_ear.stl
29.0 x 48.5 x 4.00
