meetsitaram/duck-droids/prints/nano/L_roll_bracket.stl

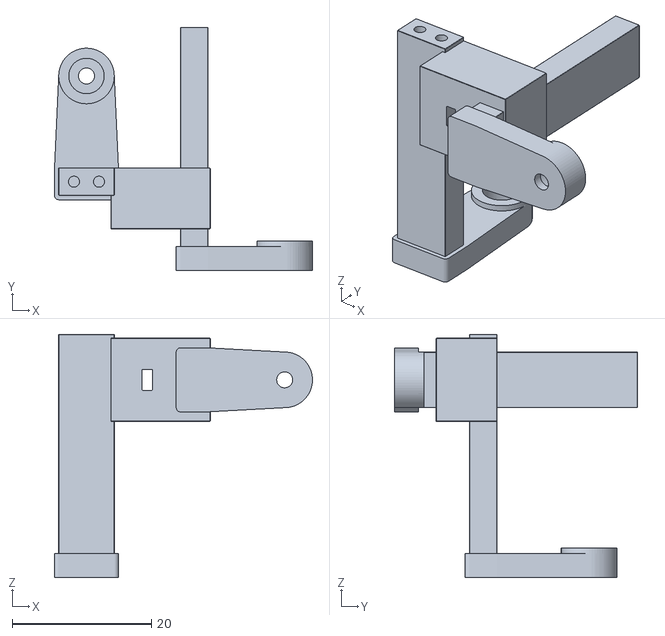
[picture p239: CAD file, 2026-11-06]
prints/nano/L_roll_bracket.stl
37.1 x 35.0 x 35.0
