meetsitaram/duck-droids/prints/dynamixel/eye_iris.stl

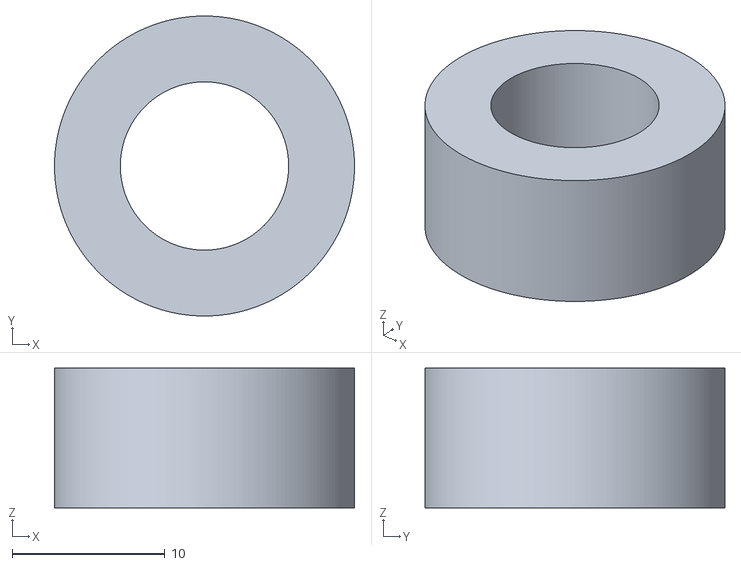
[picture p241: CAD file, 2026-11-10]
prints/dynamixel/eye_iris.stl
19.6 x 19.6 x 9.12
