meetsitaram/duck-droids/prints/hobby/R_thigh_cover.stl

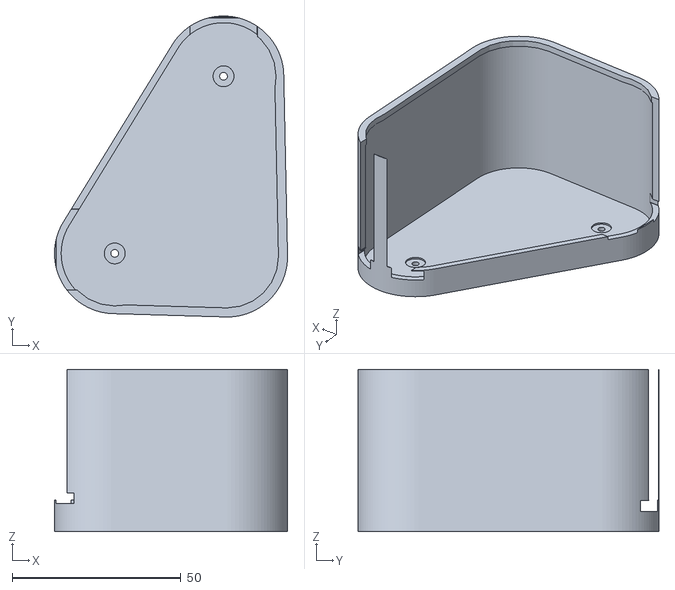
[picture p242: CAD file, 2026-11-06]
prints/hobby/R_thigh_cover.stl
69.2 x 89.3 x 48.1
