meetsitaram/duck-droids/prints/nano/L_knee_rear_arm.stl

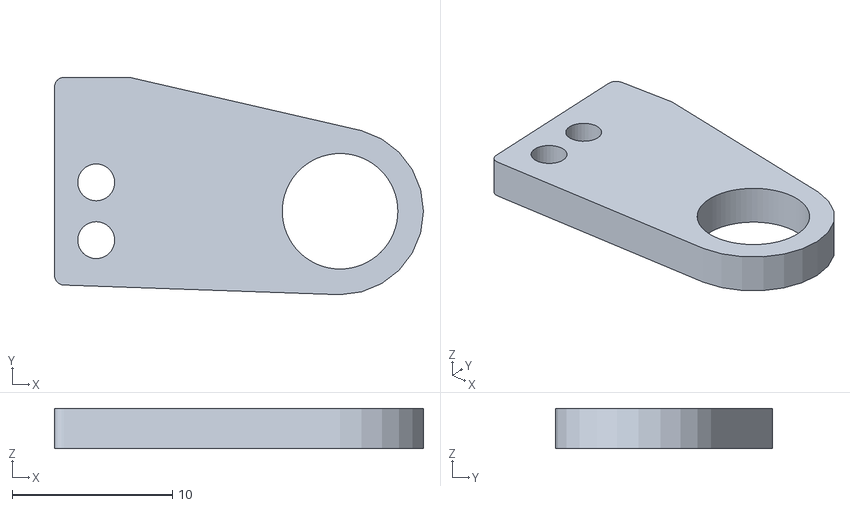
[picture p243: CAD file, 2026-11-06]
prints/nano/L_knee_rear_arm.stl
23.0 x 13.6 x 2.50
