meetsitaram/duck-droids/prints/hobby/R_thigh_frame.stl

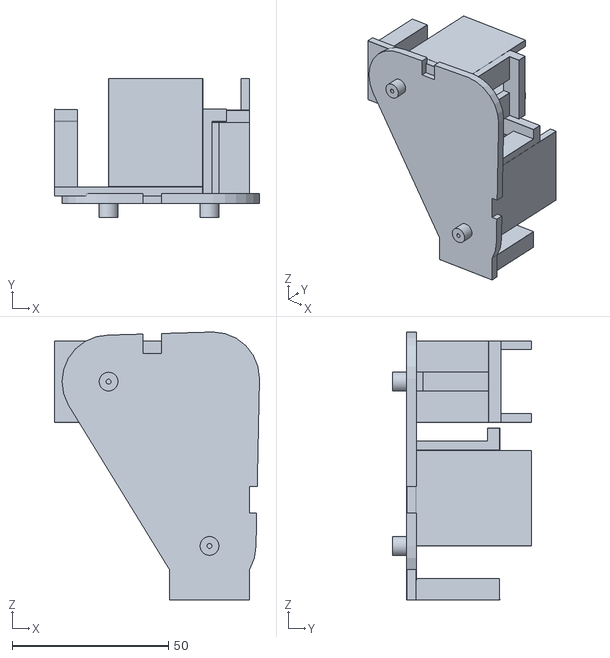
[picture p245: CAD file, 2026-11-06]
prints/hobby/R_thigh_frame.stl
65.6 x 44.6 x 85.7
