meetsitaram/duck-droids/prints/nano/L_hip_pitch_rear_arm.stl

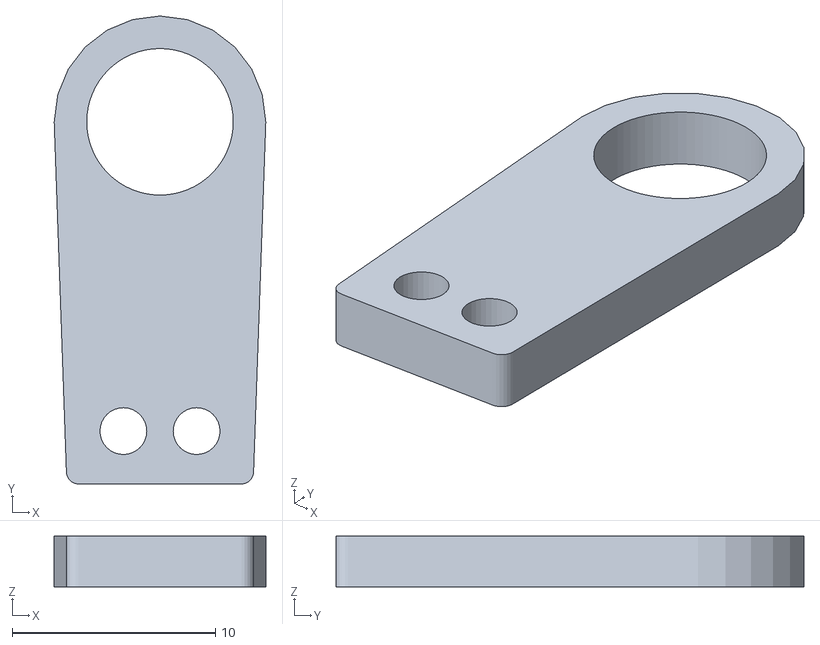
[picture p246: CAD file, 2026-11-06]
prints/nano/L_hip_pitch_rear_arm.stl
10.4 x 23.0 x 2.50
