meetsitaram/duck-droids/urdf/meshes/head_yaw_link.stl

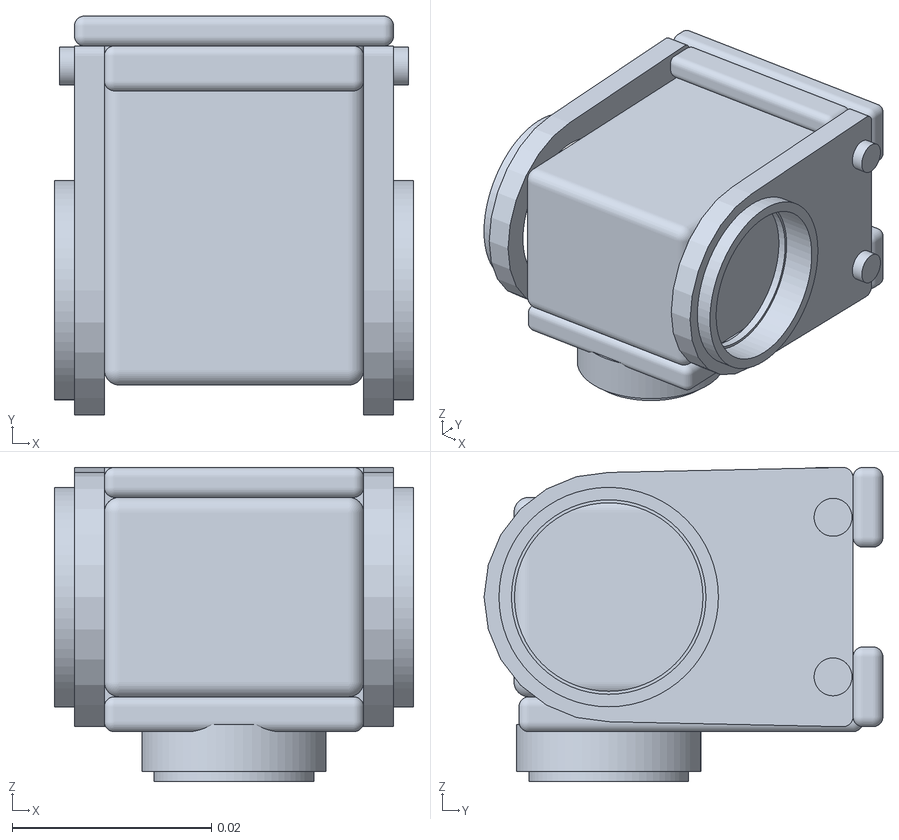
[picture p247: CAD file, 2026-11-04]
urdf/meshes/head_yaw_link.stl
0.036 x 0.04 x 0.0315
