meetsitaram/duck-droids/prints/nano/L_ankle_pitch_rear_arm.stl

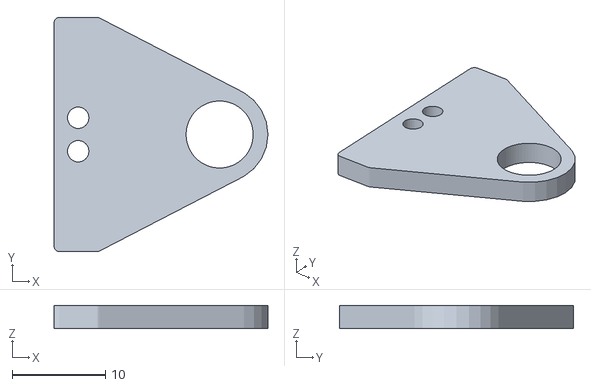
[picture p248: CAD file, 2026-11-06]
prints/nano/L_ankle_pitch_rear_arm.stl
23.0 x 25.2 x 2.50
