meetsitaram/duck-droids/prints/dynamixel/head_frame.stl

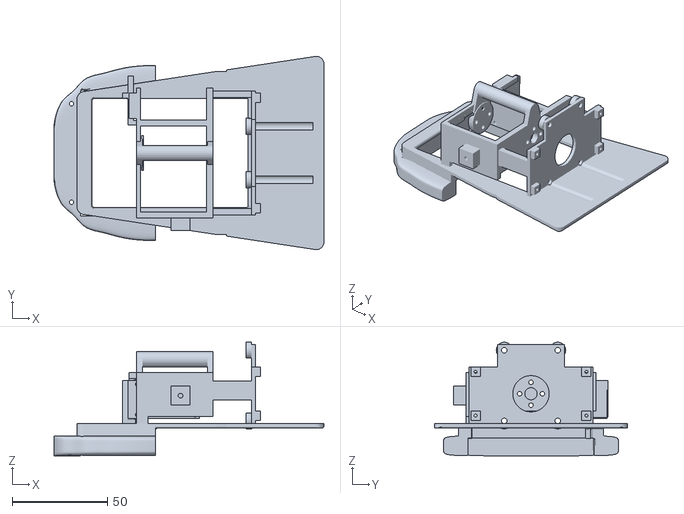
[picture p249: CAD file, 2026-11-10]
prints/dynamixel/head_frame.stl
141.4 x 101.3 x 59.5
