meetsitaram/duck-droids/prints/hobby/hood.stl

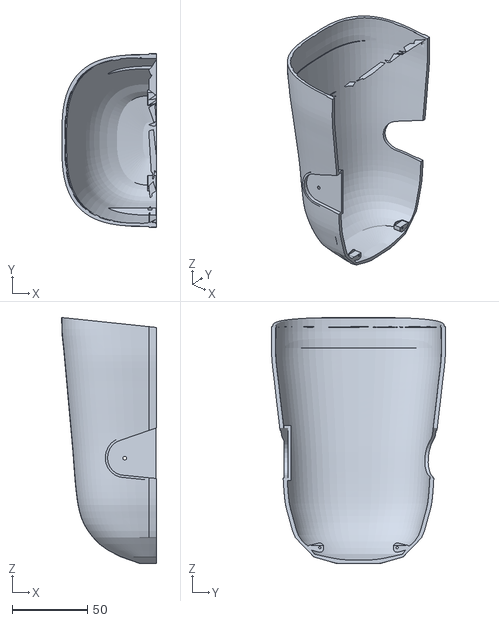
[picture p250: CAD file, 2026-11-06]
prints/hobby/hood.stl
63.0 x 115.9 x 164.0
