meetsitaram/duck-droids/prints/dynamixel/head_fork.stl

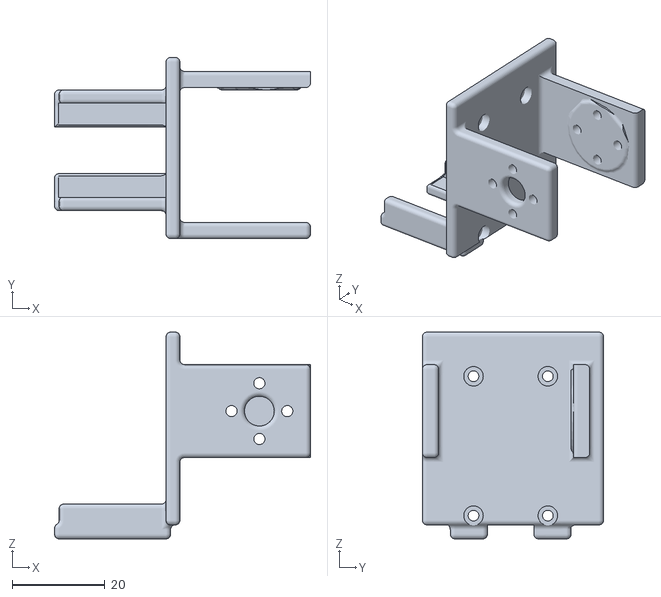
[picture p251: CAD file, 2026-11-10]
prints/dynamixel/head_fork.stl
55.1 x 39.0 x 44.5
