meetsitaram/duck-droids/prints/hobby/face.stl

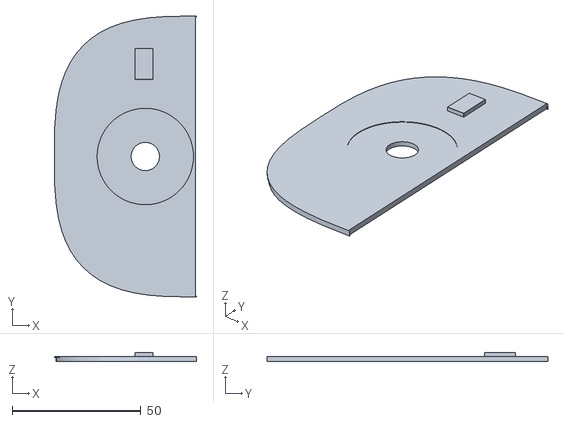
[picture p252: CAD file, 2026-11-06]
prints/hobby/face.stl
55.4 x 109.3 x 3.50
