meetsitaram/duck-droids/prints/hobby/L_knee_lid.stl

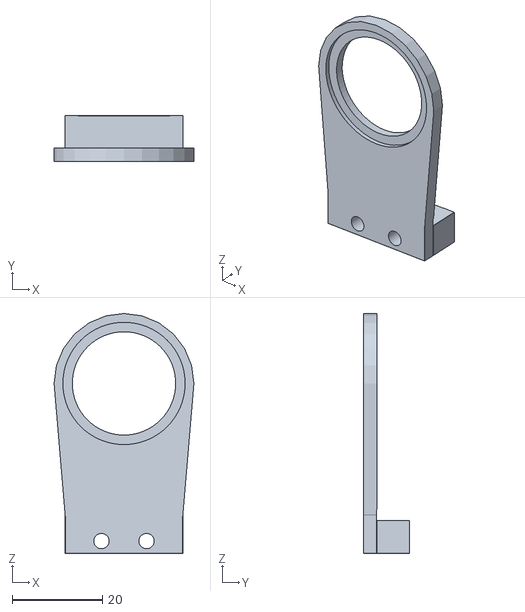
[picture p253: CAD file, 2026-11-06]
prints/hobby/L_knee_lid.stl
31.0 x 10.3 x 53.2
