meetsitaram/duck-droids/pi/sim/model/meshes/trunk_base_hull.stl

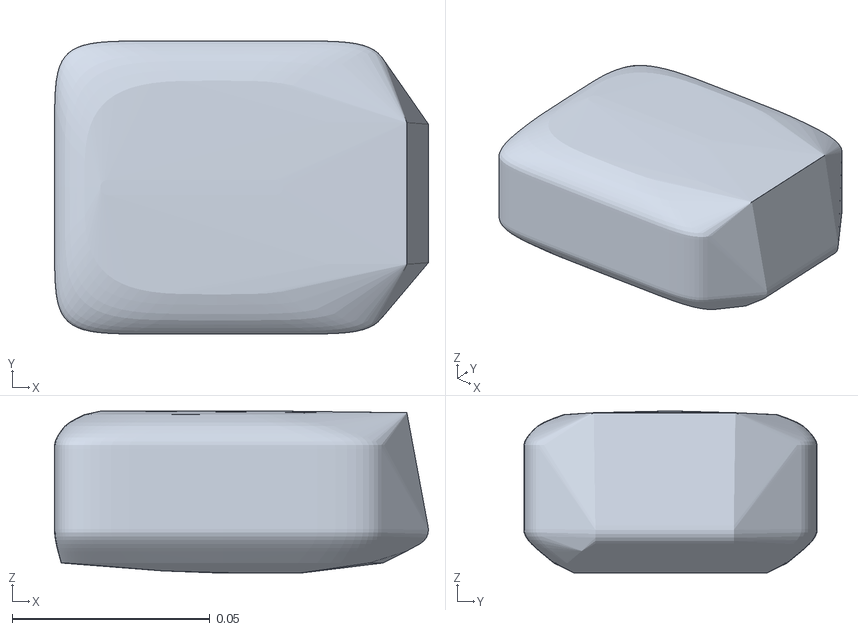
[picture p254: CAD file, 2026-11-05]
pi/sim/model/meshes/trunk_base_hull.stl
0.0946 x 0.0742 x 0.0409
