meetsitaram/duck-droids/prints/hobby/L_shin.stl

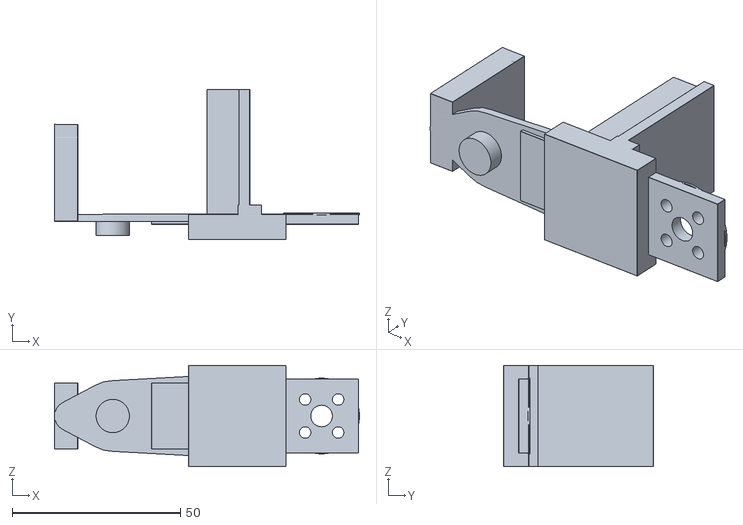
[picture p255: CAD file, 2026-11-06]
prints/hobby/L_shin.stl
90.6 x 44.5 x 30.0
