meetsitaram/duck-droids/prints/dynamixel/eye_ring.stl

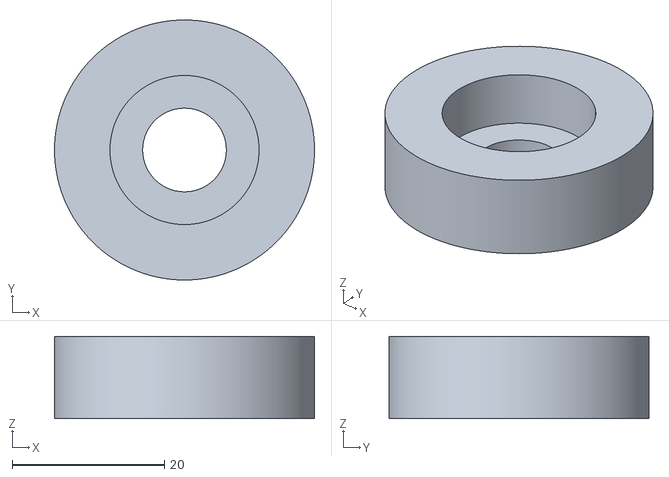
[picture p257: CAD file, 2026-11-10]
prints/dynamixel/eye_ring.stl
34.2 x 34.2 x 10.8
