meetsitaram/duck-droids/prints/hobby/L_hip_roll_lid.stl

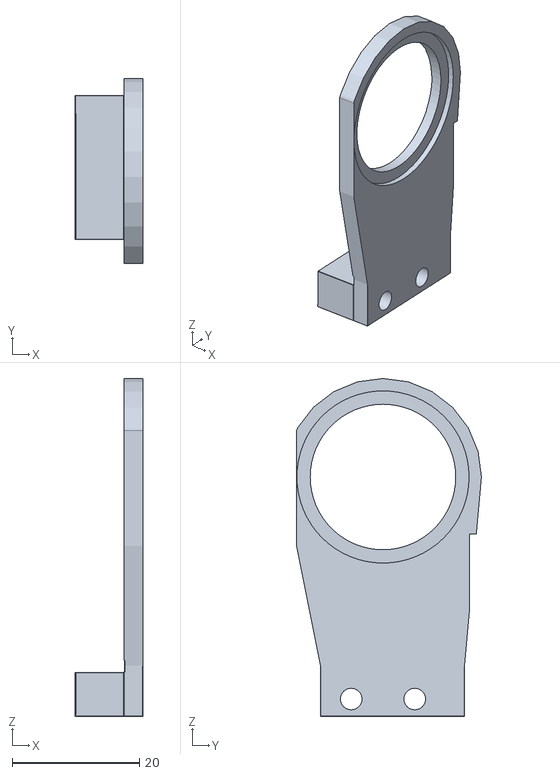
[picture p258: CAD file, 2026-11-06]
prints/hobby/L_hip_roll_lid.stl
10.7 x 29.1 x 53.2
