meetsitaram/duck-droids/prints/nano/body_shell.stl

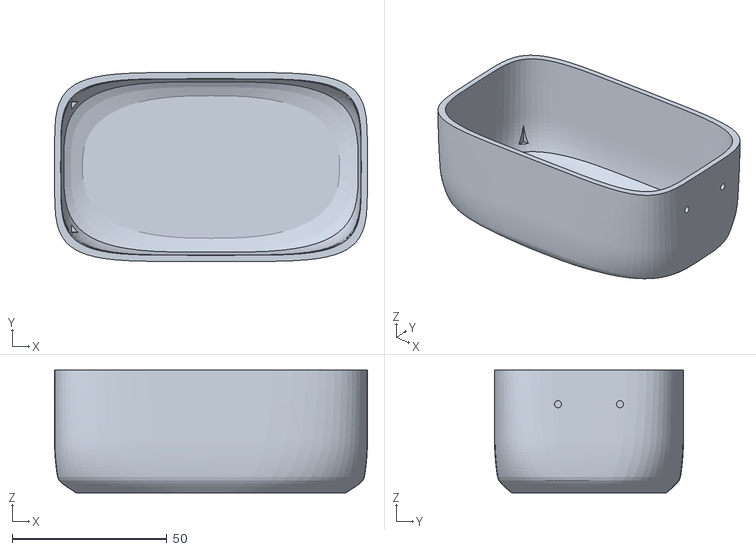
[picture p259: CAD file, 2026-11-06]
prints/nano/body_shell.stl
101.0 x 61.0 x 39.6
