meetsitaram/duck-droids/pi/sim/model/meshes/neck.stl

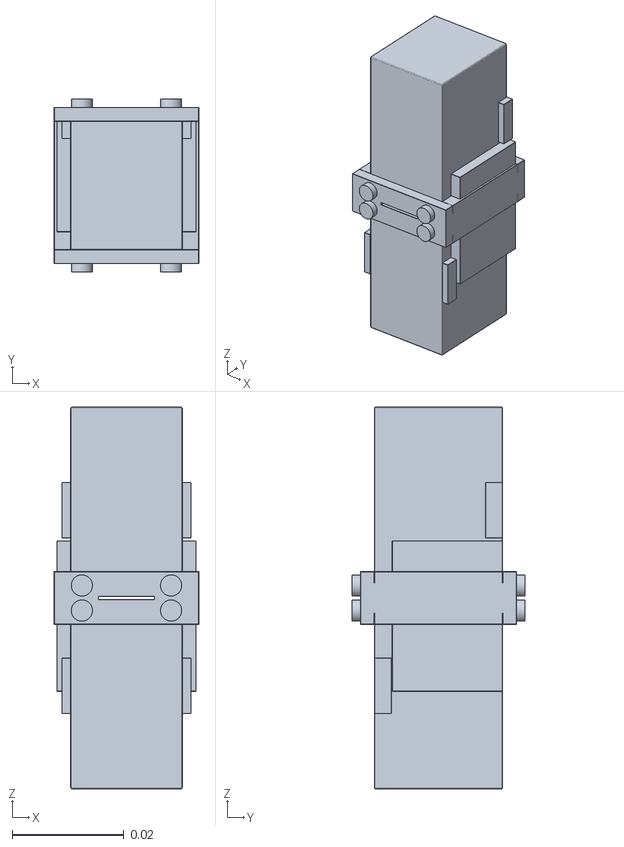
[picture p260: CAD file, 2026-11-05]
pi/sim/model/meshes/neck.stl
0.026 x 0.031 x 0.0685
