meetsitaram/duck-droids/prints/hobby/mouth_roof.stl

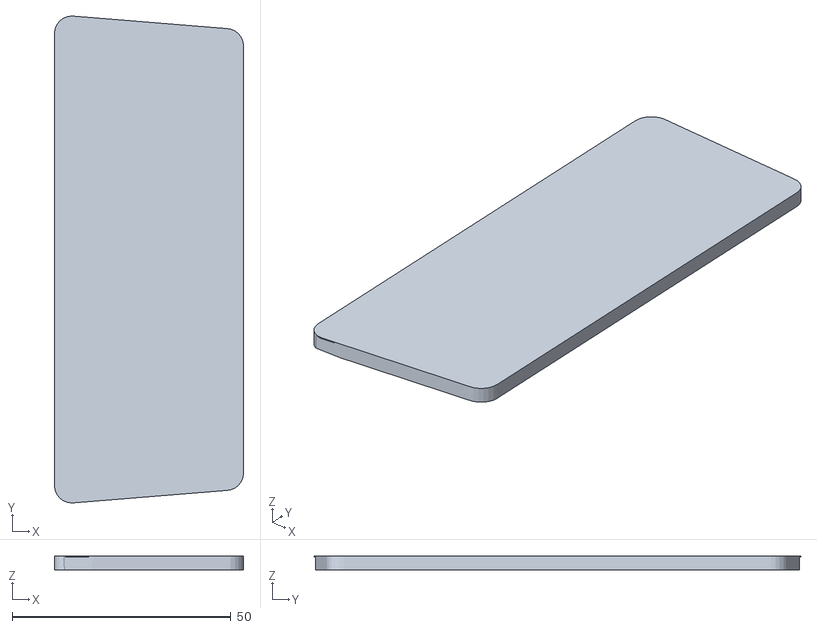
[picture p261: CAD file, 2026-11-06]
prints/hobby/mouth_roof.stl
43.3 x 111.3 x 3.20
