meetsitaram/duck-droids/pi/sim/model/meshes/leg_hull.stl

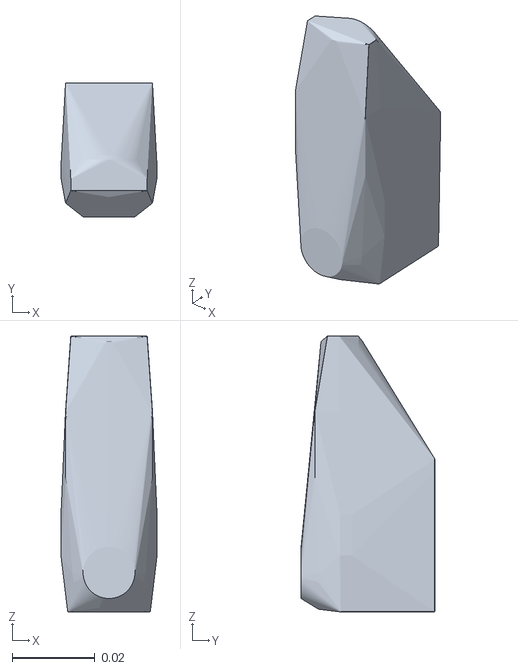
[picture p262: CAD file, 2026-11-05]
pi/sim/model/meshes/leg_hull.stl
0.0232 x 0.0323 x 0.0666
