meetsitaram/duck-droids/prints/hobby/L_roll_bracket.stl

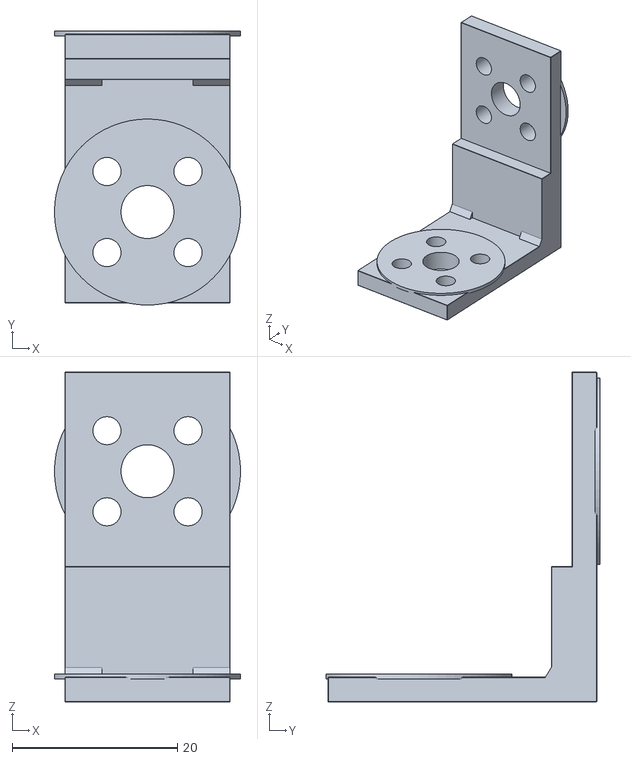
[picture p263: CAD file, 2026-11-06]
prints/hobby/L_roll_bracket.stl
22.5 x 33.1 x 39.9
