meetsitaram/duck-droids/prints/nano/jaw.stl

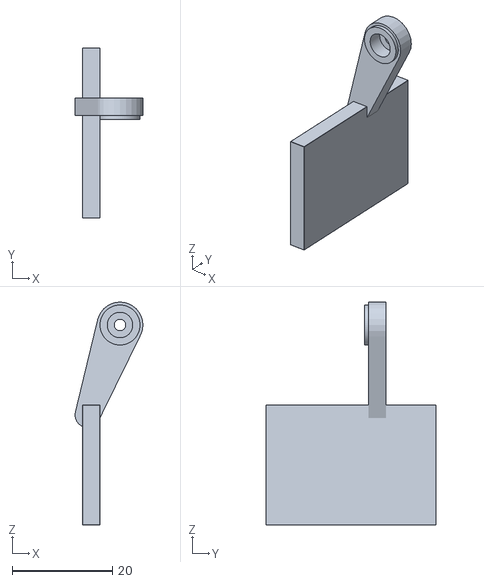
[picture p264: CAD file, 2026-11-06]
prints/nano/jaw.stl
13.6 x 34.0 x 44.6
