meetsitaram/duck-droids/prints/dynamixel/R_shoe.stl

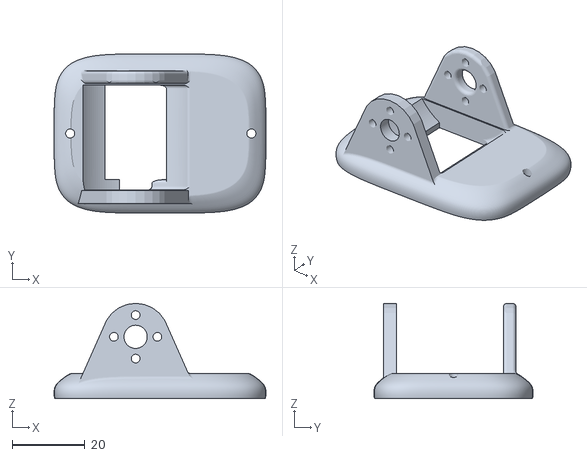
[picture p265: CAD file, 2026-11-10]
prints/dynamixel/R_shoe.stl
58.5 x 44.0 x 26.3
