meetsitaram/duck-droids/prints/hobby/neck_lid.stl

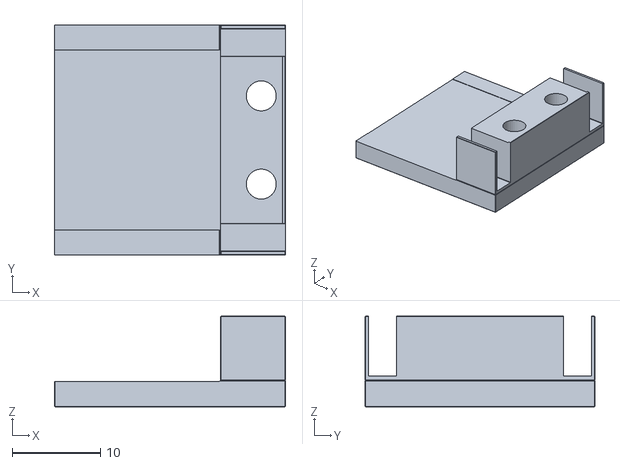
[picture p266: CAD file, 2026-11-06]
prints/hobby/neck_lid.stl
26.2 x 26.1 x 10.3
