meetsitaram/duck-droids/pi/sim/model/meshes/jaw.stl

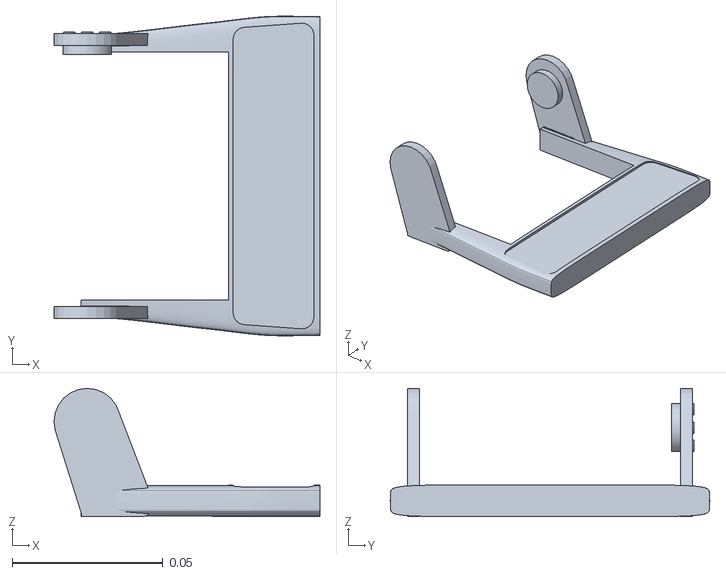
[picture p267: CAD file, 2026-11-05]
pi/sim/model/meshes/jaw.stl
0.0881 x 0.106 x 0.0425
