meetsitaram/duck-droids/prints/dynamixel/R_sole.stl

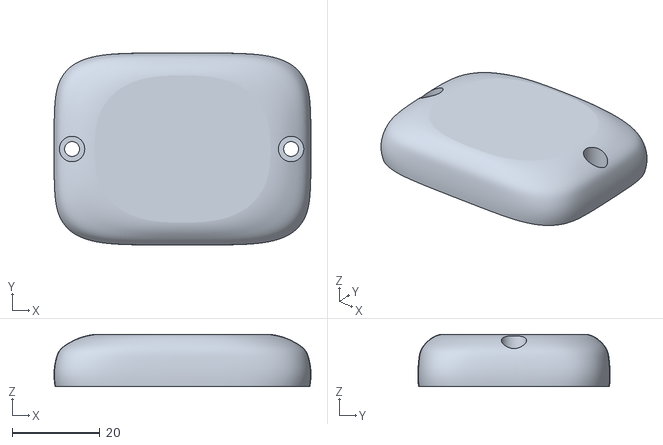
[picture p268: CAD file, 2026-11-10]
prints/dynamixel/R_sole.stl
58.6 x 43.9 x 11.9
