meetsitaram/duck-droids/prints/hobby/eye_ring.stl

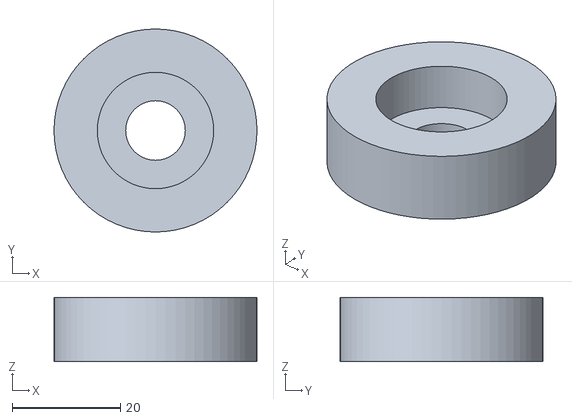
[picture p269: CAD file, 2026-11-06]
prints/hobby/eye_ring.stl
37.5 x 37.5 x 11.9
