meetsitaram/duck-droids/pi/sim/model/meshes/ankle_right_hull.stl

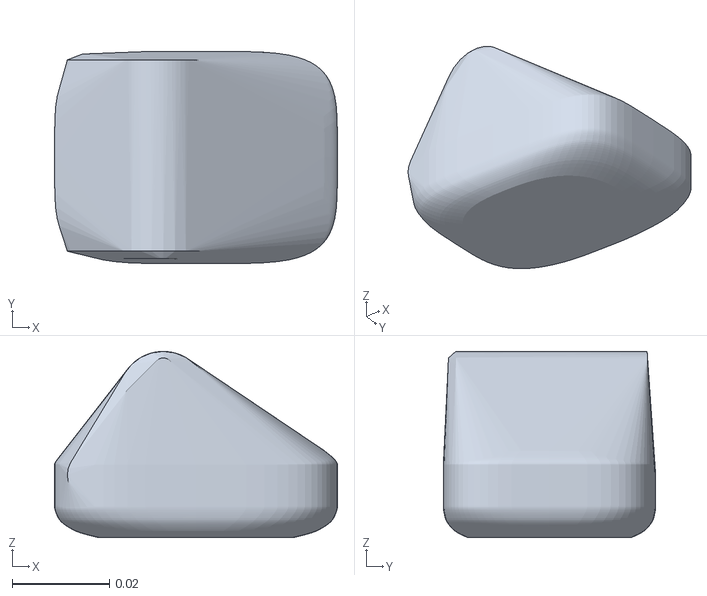
[picture p270: CAD file, 2026-11-05]
pi/sim/model/meshes/ankle_right_hull.stl
0.0581 x 0.0436 x 0.0382
