meetsitaram/duck-droids/pi/sim/model/meshes/yaw_roll_motion.stl

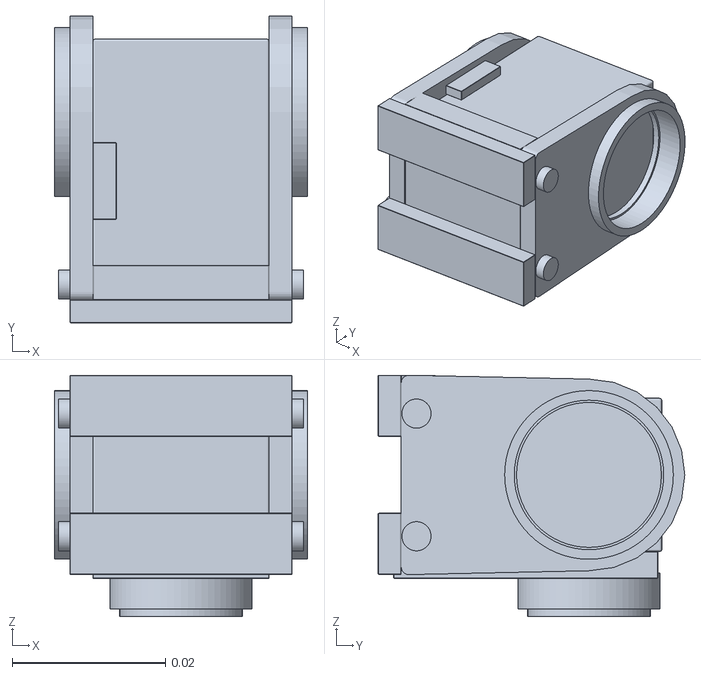
[picture p271: CAD file, 2026-11-05]
pi/sim/model/meshes/yaw_roll_motion.stl
0.033 x 0.04 x 0.0315
