meetsitaram/duck-droids/prints/dynamixel/neck_column.stl

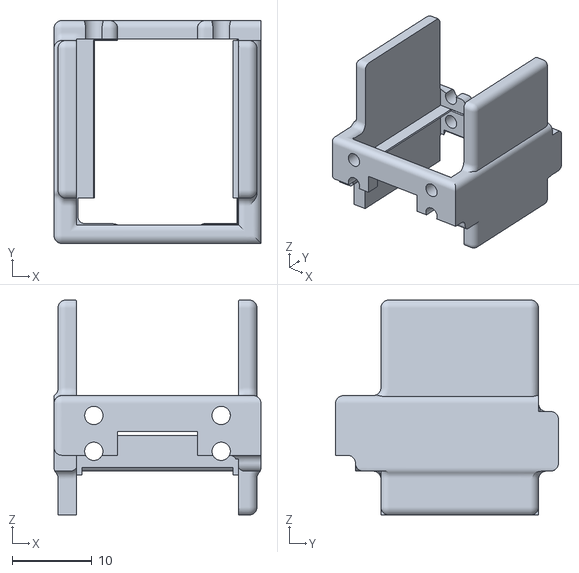
[picture p272: CAD file, 2026-11-10]
prints/dynamixel/neck_column.stl
26.0 x 28.0 x 27.0
