meetsitaram/duck-droids/prints/hobby/neck_column.stl

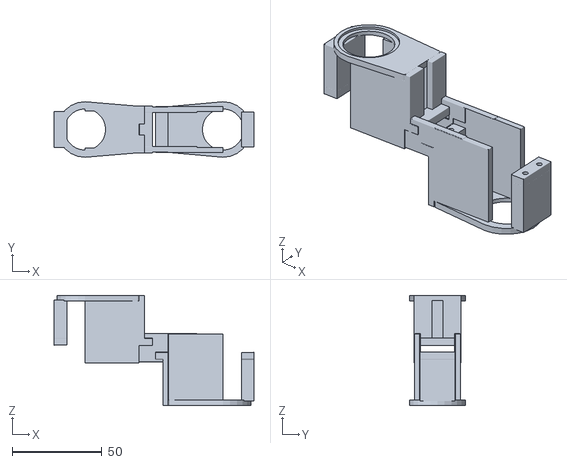
[picture p273: CAD file, 2026-11-06]
prints/hobby/neck_column.stl
111.6 x 31.0 x 61.5
