meetsitaram/duck-droids/prints/hybrid/head_roll_rear_spacer.stl

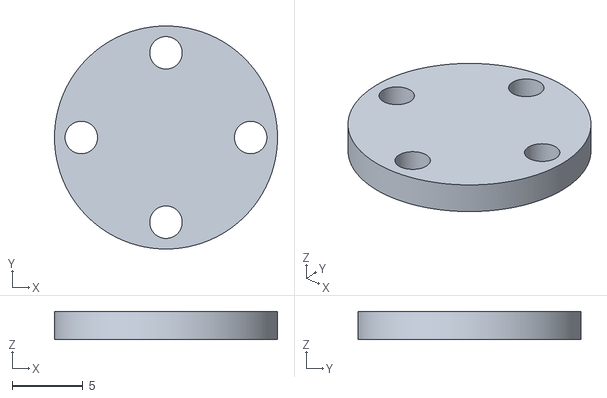
[picture p274: CAD file, 2026-11-05]
prints/hybrid/head_roll_rear_spacer.stl
15.8 x 15.8 x 2.00
