meetsitaram/duck-droids/prints/nano/L_thigh.stl

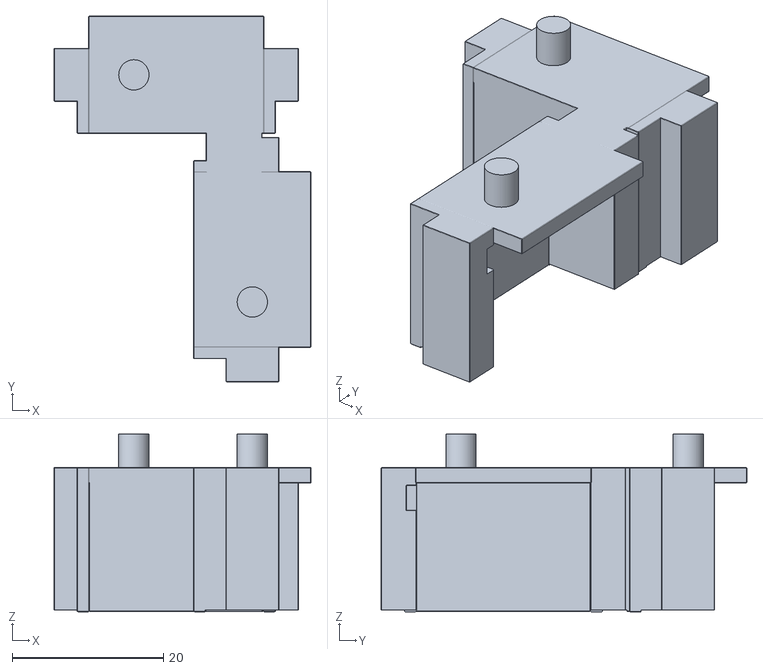
[picture p275: CAD file, 2026-11-06]
prints/nano/L_thigh.stl
34.0 x 48.3 x 23.4
