meetsitaram/duck-droids/prints/dynamixel/neck_lid.stl

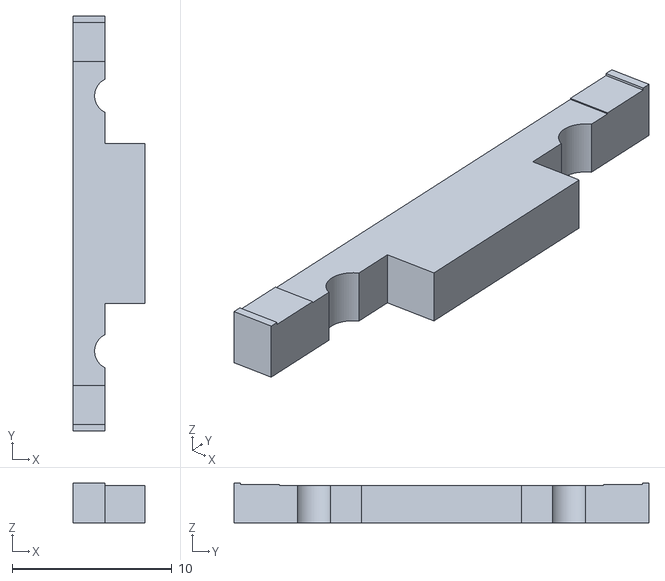
[picture p277: CAD file, 2026-11-10]
prints/dynamixel/neck_lid.stl
4.50 x 26.0 x 2.50
