meetsitaram/duck-droids/prints/nano/L_yaw_link.stl

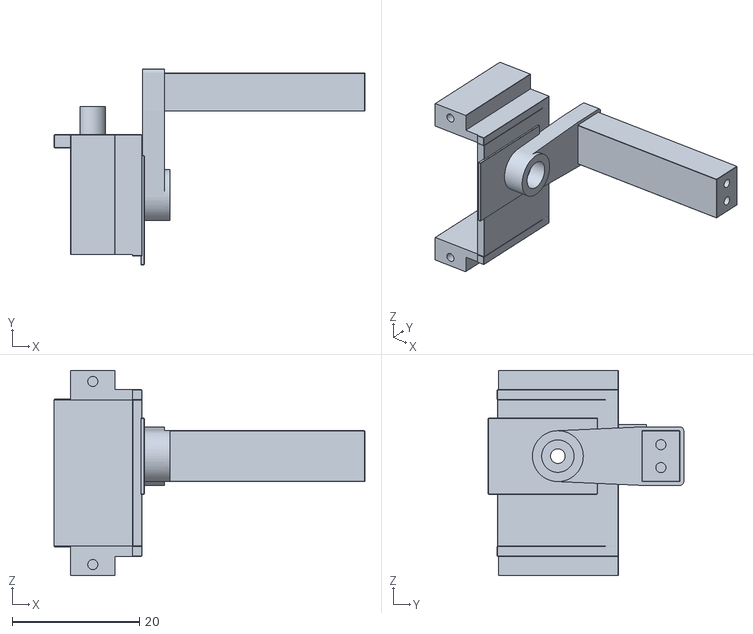
[picture p278: CAD file, 2026-11-06]
prints/nano/L_yaw_link.stl
48.9 x 30.7 x 32.3
