meetsitaram/duck-droids/prints/dynamixel/chassis.stl

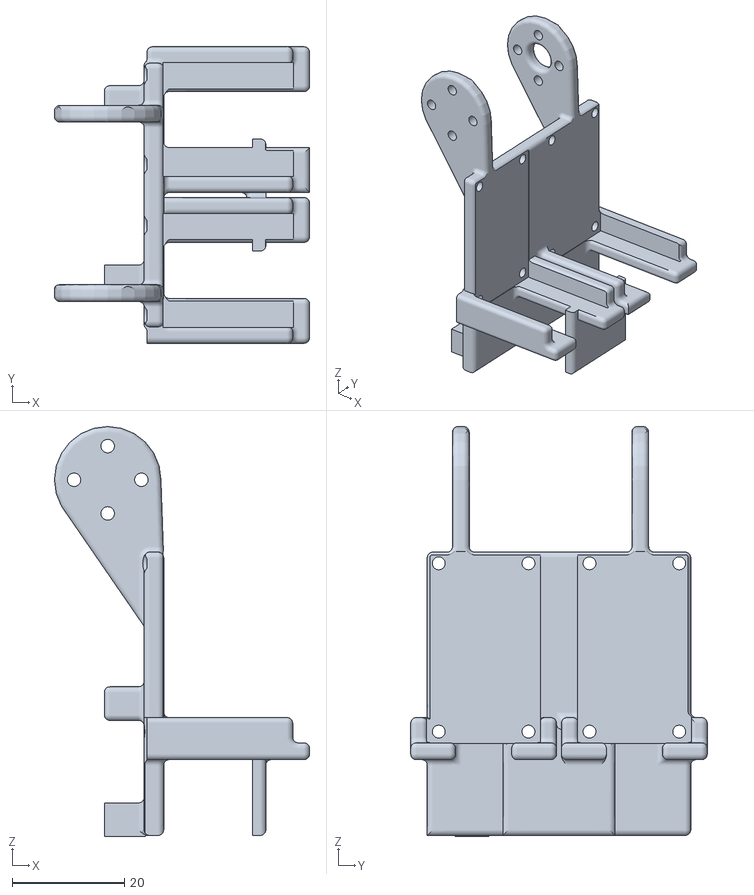
[picture p279: CAD file, 2026-11-10]
prints/dynamixel/chassis.stl
45.5 x 52.9 x 73.1
