meetsitaram/duck-droids/prints/hobby/head_fork.stl

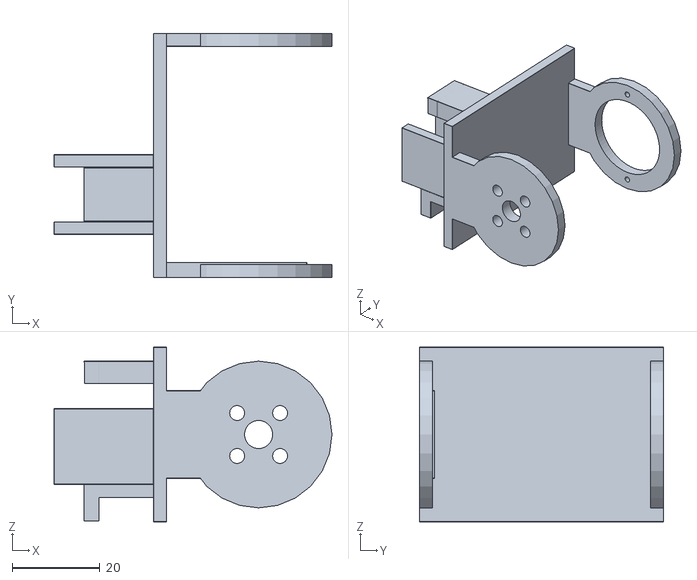
[picture p280: CAD file, 2026-11-06]
prints/hobby/head_fork.stl
63.5 x 55.8 x 39.9
