meetsitaram/duck-droids/prints/hobby/chassis.stl

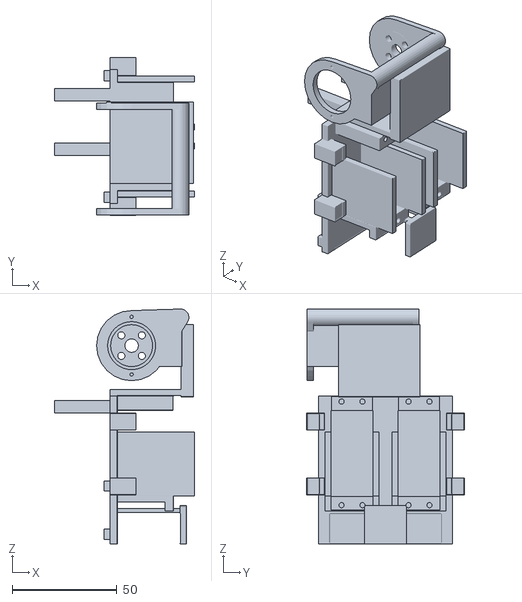
[picture p281: CAD file, 2026-11-06]
prints/hobby/chassis.stl
67.1 x 75.6 x 112.2
