meetsitaram/duck-droids/(list of files, cad)

Other CAD files:
cad/duck-droids-hd1910.step
prints/nano/L_knee_ear_clamp.stl
urdf/meshes/R_knee_link.stl
urdf/meshes/R_foot.stl
prints/nano/L_knee_bushing.stl
urdf/meshes/R_hip_pitch_link.stl
prints/nano/R_hip_yaw_rear_arm.stl
pi/sim/model/meshes/ankle_left.stl
prints/hobby/head_pitch_rear_hub.stl
prints/nano/R_foot.stl
pi/sim/model/meshes/upper_leg_right.stl
prints/hobby/R_hip_pitch_lid.stl
prints/nano/R_knee_bushing.stl
prints/dynamixel/R_hip_yaw_lid.stl
urdf/meshes/R_hip_roll_link.stl
urdf/meshes/R_hip_yaw_link.stl
prints/dynamixel/R_knee_lid.stl
pi/sim/model/meshes/leg_2.stl
prints/dynamixel/R_roll_bracket.stl
prints/hobby/R_inner_ear.stl
pi/sim/model/meshes/hip_l_2_hull.stl
prints/nano/R_ankle_pitch_ear_clamp.stl
pi/sim/model/meshes/bearing_roll.stl
prints/nano/L_hip_pitch_ear_clamp.stl
pi/sim/model/meshes/upper_leg_right_hull.stl
prints/dynamixel/head_roll_lid.stl
prints/nano/R_ankle_pitch_rear_arm.stl
prints/dynamixel/R_thigh_cover.stl
prints/nano/beak_ear_clamp.stl
prints/dynamixel/L_hip_pitch_lid.stl
prints/nano/L_hip_roll_ear_clamp.stl
prints/dynamixel/L_shin.stl
pi/sim/model/meshes/bearing_roll_hull.stl
prints/nano/R_hip_pitch_rear_arm.stl
prints/nano/R_hip_yaw_bushing.stl
prints/dynamixel/L_sole.stl
prints/hobby/L_thigh_frame.stl
prints/nano/neck_pitch_ear_clamp.stl
pi/sim/model/meshes/ankle_left_hull.stl
prints/dynamixel/L_yaw_bracket.stl
prints/hobby/L_sole.stl
prints/nano/R_hip_roll_ear_clamp.stl
prints/hobby/R_hip_roll_lid.stl
pi/sim/model/meshes/hip_l.stl
prints/nano/R_hip_pitch_ear_clamp.stl
pi/sim/model/meshes/leg_2_hull.stl
prints/dynamixel/head_pitch_lid.stl
cad/duck-droids-dynamixel.f3d
cad/duck-droids-feetech.f3d
cad/duck-droids-hd1910.f3d
cad/duck-droids-hybrid.f3d
prints/dynamixel/L_hip_yaw_lid.stl
prints/dynamixel/L_thigh_frame.stl
prints/dynamixel/R_thigh_frame.stl
prints/dynamixel/head_roll_spacer.stl
prints/dynamixel/hood.stl
prints/dynamixel/jaw_soft_insert.stl
prints/dynamixel/mouth_roof.stl
prints/feetech/L_hip_yaw_lid.stl
prints/feetech/L_roll_bracket.stl
prints/feetech/L_shin.stl
prints/feetech/L_shoe.stl
prints/feetech/L_thigh_frame.stl
prints/feetech/L_yaw_bracket.stl
prints/feetech/R_hip_yaw_lid.stl
prints/feetech/R_roll_bracket.stl
prints/feetech/R_shin.stl
prints/feetech/R_shoe.stl
prints/feetech/R_thigh_cover.stl
prints/feetech/R_thigh_frame.stl
prints/feetech/R_yaw_bracket.stl
prints/feetech/body_shell.stl
prints/feetech/chassis.stl
prints/feetech/eye_iris.stl
prints/feetech/eye_ring.stl
prints/feetech/face.stl
prints/feetech/head_fork.stl
prints/feetech/head_frame.stl
prints/feetech/head_pitch_lid.stl
prints/feetech/head_roll_lid.stl
prints/feetech/head_roll_spacer.stl
prints/feetech/head_yaw_bracket.stl
prints/feetech/head_yaw_sheet.stl
prints/feetech/hood.stl
prints/feetech/jaw.stl
prints/feetech/jaw_soft_insert.stl
prints/feetech/mouth_roof.stl
prints/feetech/neck_column.stl
prints/feetech/neck_lid.stl
prints/hd1910/L_hip_pitch_lid.stl
prints/hd1910/L_hip_roll_lid.stl
prints/hd1910/L_hip_yaw_lid.stl
prints/hd1910/L_inner_ear.stl
prints/hd1910/L_knee_lid.stl
prints/hd1910/L_roll_bracket.stl
prints/hd1910/L_shin.stl
prints/hd1910/L_shoe.stl
prints/hd1910/L_sole.stl
prints/hd1910/L_thigh_cover.stl
prints/hd1910/L_thigh_frame.stl
prints/hd1910/L_yaw_bracket.stl
prints/hd1910/R_hip_pitch_lid.stl
prints/hd1910/R_hip_roll_lid.stl
prints/hd1910/R_hip_yaw_lid.stl
prints/hd1910/R_inner_ear.stl
prints/hd1910/R_knee_lid.stl
prints/hd1910/R_roll_bracket.stl
prints/hd1910/R_shin.stl
prints/hd1910/R_shoe.stl
prints/hd1910/R_sole.stl
prints/hd1910/R_thigh_cover.stl
prints/hd1910/R_thigh_frame.stl
prints/hd1910/R_yaw_bracket.stl
prints/hd1910/body_shell.stl
prints/hd1910/chassis.stl
prints/hd1910/eye_iris.stl
prints/hd1910/eye_ring.stl
prints/hd1910/face.stl
prints/hd1910/head_fork.stl
prints/hd1910/head_frame.stl
prints/hd1910/head_pitch_lid.stl
prints/hd1910/head_roll_lid.stl
prints/hd1910/head_roll_rear_spacer.stl
prints/hd1910/head_roll_spacer.stl
prints/hd1910/head_yaw_bracket.stl
prints/hd1910/head_yaw_sheet.stl
prints/hd1910/hood.stl
prints/hd1910/jaw.stl
prints/hd1910/jaw_soft_insert.stl
prints/hd1910/mouth_roof.stl
prints/hd1910/neck_column.stl
prints/hd1910/neck_lid.stl
prints/hobby/L_hip_pitch_lid.stl
prints/hobby/L_shoe.stl
prints/hobby/L_thigh_cover.stl
prints/hobby/L_yaw_bracket.stl
prints/hobby/R_hip_yaw_lid.stl
prints/hobby/R_knee_lid.stl
prints/hobby/R_roll_bracket.stl
prints/hobby/R_shin.stl
prints/hobby/R_yaw_bracket.stl
prints/hobby/head_frame.stl
prints/hobby/head_yaw_sheet.stl
prints/hobby/jaw_soft_insert.stl
prints/hybrid/L_hip_pitch_lid.stl
prints/hybrid/L_hip_roll_lid.stl
prints/hybrid/L_hip_yaw_lid.stl
prints/hybrid/L_inner_ear.stl
prints/hybrid/L_knee_lid.stl
prints/hybrid/L_roll_bracket.stl
prints/hybrid/L_shin.stl
prints/hybrid/L_shoe.stl
prints/hybrid/L_sole.stl
prints/hybrid/L_thigh_cover.stl
prints/hybrid/L_thigh_frame.stl
prints/hybrid/L_yaw_bracket.stl
prints/hybrid/R_hip_pitch_lid.stl
prints/hybrid/R_hip_roll_lid.stl
prints/hybrid/R_hip_yaw_lid.stl
prints/hybrid/R_inner_ear.stl
prints/hybrid/R_knee_lid.stl
prints/hybrid/R_roll_bracket.stl
prints/hybrid/R_shin.stl
prints/hybrid/R_shoe.stl
prints/hybrid/R_sole.stl
prints/hybrid/R_thigh_cover.stl
prints/hybrid/R_thigh_frame.stl
prints/hybrid/R_yaw_bracket.stl
prints/hybrid/body_shell.stl
prints/hybrid/chassis.stl
prints/hybrid/eye_iris.stl
prints/hybrid/eye_ring.stl
prints/hybrid/face.stl
prints/hybrid/head_fork.stl
prints/hybrid/head_frame.stl
prints/hybrid/head_pitch_lid.stl
prints/hybrid/head_roll_lid.stl
prints/hybrid/head_roll_spacer.stl
prints/hybrid/head_yaw_bracket.stl
prints/hybrid/head_yaw_sheet.stl
prints/hybrid/hood.stl
prints/hybrid/jaw.stl
prints/hybrid/jaw_soft_insert.stl
prints/hybrid/mouth_roof.stl
prints/hybrid/neck_column.stl
prints/hybrid/neck_lid.stl
prints/nano/L_ankle_pitch_bushing.stl
prints/nano/L_ankle_pitch_ear_clamp.stl
prints/nano/L_hip_roll_bushing.stl
prints/nano/L_hip_yaw_bushing.stl
prints/nano/L_hip_yaw_ear_clamp.stl
prints/nano/L_sole.stl
prints/nano/R_ankle_pitch_bushing.stl
prints/nano/R_hip_pitch_bushing.stl
prints/nano/R_hip_roll_bushing.stl
prints/nano/R_hip_roll_rear_arm.stl
prints/nano/R_knee_ear_clamp.stl
prints/nano/R_knee_rear_arm.stl
prints/nano/R_roll_bracket.stl
prints/nano/R_shin.stl
prints/nano/R_sole.stl
prints/nano/R_thigh.stl
prints/nano/R_yaw_link.stl
prints/nano/head_frame.stl
prints/nano/head_pitch_ear_clamp.stl
prints/nano/neck_plate.stl
prints/nano/upper_bill.stl
