meetsitaram/duck-droids/prints/nano/README.md

# Printed parts

> **These are the print files for the nano duck only.** Each duck has its own parts, prints and BOM, and they don't mix. Other ducks: [all-Dynamixel](../dynamixel/README.md) · [HD-1910](../hd1910/README.md) · [all-Feetech](../feetech/README.md) · [hybrid](../hybrid/README.md) · [hobby-servo](../hobby/README.md). <!-- variant banner -->

From `python -I tools/export_prints.py`, in millimetres: every part, left and right, already turned the way it should print, its long overhangs down
(tools/printable.py chooses). Pockets are cut 0.3 mm over each bought part and bearing seats 0.1 mm over. None has been test printed: print one joint first.

| Part | File | Size on the bed (mm) | Volume (cm3) | Material | Overhang to support (mm2) |
|---|---|---|---|---|---|
| L ankle pitch ear clamp | L_ankle_pitch_ear_clamp.stl | 33 x 14 x 2 | 0.3 | PLA | 0 (none) |
| R ankle pitch ear clamp | R_ankle_pitch_ear_clamp.stl | 33 x 14 x 2 | 0.3 | PLA | 0 (none) |
| L shin | L_shin.stl | 54 x 19 x 38 | 5.9 | PLA | 495 |
| R shin | R_shin.stl | 54 x 19 x 38 | 5.9 | PLA | 495 |
| L foot | L_foot.stl | 22 x 54 x 35 | 8.5 | PLA | 0 (none) |
| R foot | R_foot.stl | 22 x 54 x 35 | 8.5 | PLA | 0 (none) |
| L ankle pitch rear arm | L_ankle_pitch_rear_arm.stl | 23 x 25 x 2 | 0.9 | PLA | 0 (none) |
| R ankle pitch rear arm | R_ankle_pitch_rear_arm.stl | 23 x 25 x 2 | 0.9 | PLA | 0 (none) |
| L ankle pitch bushing | L_ankle_pitch_bushing.stl | 10 x 10 x 5 | 0.2 | PLA | 0 (none) |
| R ankle pitch bushing | R_ankle_pitch_bushing.stl | 10 x 10 x 5 | 0.2 | PLA | 0 (none) |
| L knee ear clamp | L_knee_ear_clamp.stl | 33 x 14 x 2 | 0.3 | PLA | 0 (none) |
| R knee ear clamp | R_knee_ear_clamp.stl | 33 x 14 x 2 | 0.3 | PLA | 0 (none) |
| L thigh | L_thigh.stl | 34 x 48 x 23 | 5.7 | PLA | 672 |
| R thigh | R_thigh.stl | 34 x 48 x 23 | 5.7 | PLA | 672 |
| L knee rear arm | L_knee_rear_arm.stl | 23 x 14 x 2 | 0.5 | PLA | 0 (none) |
| R knee rear arm | R_knee_rear_arm.stl | 23 x 14 x 2 | 0.5 | PLA | 0 (none) |
| L knee bushing | L_knee_bushing.stl | 10 x 10 x 5 | 0.2 | PLA | 0 (none) |
| R knee bushing | R_knee_bushing.stl | 10 x 10 x 5 | 0.2 | PLA | 0 (none) |
| L hip pitch ear clamp | L_hip_pitch_ear_clamp.stl | 14 x 33 x 2 | 0.3 | PLA | 0 (none) |
| R hip pitch ear clamp | R_hip_pitch_ear_clamp.stl | 14 x 33 x 2 | 0.3 | PLA | 0 (none) |
| L roll bracket | L_roll_bracket.stl | 37 x 35 x 35 | 4.3 | PLA | 325 |
| R roll bracket | R_roll_bracket.stl | 37 x 35 x 35 | 4.3 | PLA | 325 |
| L hip pitch rear arm | L_hip_pitch_rear_arm.stl | 10 x 23 x 2 | 0.4 | PLA | 0 (none) |
| R hip pitch rear arm | R_hip_pitch_rear_arm.stl | 10 x 23 x 2 | 0.4 | PLA | 0 (none) |
| L hip pitch bushing | L_hip_pitch_bushing.stl | 10 x 10 x 5 | 0.2 | PLA | 0 (none) |
| R hip pitch bushing | R_hip_pitch_bushing.stl | 10 x 10 x 5 | 0.2 | PLA | 0 (none) |
| L hip roll ear clamp | L_hip_roll_ear_clamp.stl | 14 x 33 x 2 | 0.3 | PLA | 0 (none) |
| R hip roll ear clamp | R_hip_roll_ear_clamp.stl | 14 x 33 x 2 | 0.3 | PLA | 0 (none) |
| L yaw link | L_yaw_link.stl | 49 x 31 x 32 | 4.9 | PLA | 590 |
| R yaw link | R_yaw_link.stl | 49 x 31 x 32 | 4.9 | PLA | 591 |
| L hip roll rear arm | L_hip_roll_rear_arm.stl | 21 x 10 x 2 | 0.4 | PLA | 0 (none) |
| R hip roll rear arm | R_hip_roll_rear_arm.stl | 21 x 10 x 2 | 0.4 | PLA | 0 (none) |
| L hip roll bushing | L_hip_roll_bushing.stl | 10 x 10 x 5 | 0.2 | PLA | 0 (none) |
| R hip roll bushing | R_hip_roll_bushing.stl | 10 x 10 x 5 | 0.2 | PLA | 0 (none) |
| L hip yaw ear clamp | L_hip_yaw_ear_clamp.stl | 33 x 14 x 2 | 0.3 | PLA | 0 (none) |
| R hip yaw ear clamp | R_hip_yaw_ear_clamp.stl | 33 x 14 x 2 | 0.3 | PLA | 0 (none) |
| chassis | chassis.stl | 36 x 115 x 55 | 17.6 | PLA | 2208 |
| L hip yaw rear arm | L_hip_yaw_rear_arm.stl | 25 x 10 x 2 | 0.5 | PLA | 0 (none) |
| R hip yaw rear arm | R_hip_yaw_rear_arm.stl | 25 x 10 x 2 | 0.5 | PLA | 0 (none) |
| L hip yaw bushing | L_hip_yaw_bushing.stl | 10 x 10 x 5 | 0.2 | PLA | 0 (none) |
| R hip yaw bushing | R_hip_yaw_bushing.stl | 10 x 10 x 5 | 0.2 | PLA | 0 (none) |
| L sole | L_sole.stl | 54 x 35 x 1 | 2.6 | TPU 95A | 0 (none) |
| R sole | R_sole.stl | 54 x 35 x 1 | 2.6 | TPU 95A | 0 (none) |
| neck pitch ear clamp | neck_pitch_ear_clamp.stl | 33 x 14 x 2 | 0.3 | PLA | 0 (none) |
| neck plate | neck_plate.stl | 47 x 15 x 4 | 1.7 | PLA | 16 |
| head pitch ear clamp | head_pitch_ear_clamp.stl | 14 x 33 x 2 | 0.3 | PLA | 0 (none) |
| head frame | head_frame.stl | 58 x 49 x 27 | 8.6 | PLA | 493 |
| beak ear clamp | beak_ear_clamp.stl | 14 x 33 x 2 | 0.3 | PLA | 0 (none) |
| jaw | jaw.stl | 14 x 34 x 45 | 3.4 | PLA | 23 |
| upper bill | upper_bill.stl | 11 x 44 x 26 | 4.8 | PLA | 0 (none) |
| body shell | body_shell.stl | 101 x 61 x 40 | 31.4 | PLA | 1633 |
| hood | hood.stl | 90 x 76 x 37 | 24.7 | PLA | 2925 |

A part with an overhang figure needs support or a bridge there; tools/printable.py counts faces, not a slicer, so it overstates short bridges. Check each in your slicer.

## Splines and bushings

Each hub is drawn with a plain 4.9 mm bore over the SG90's 21-tooth, 4.8 mm spline (spec/actuators.json): the teeth aren't in the STL. Either print the bore 0.1 mm under the spline and press the shaft in warm,
so it cuts its own teeth in the PLA, or glue the hub of the servo's own plastic horn into the bore. Test which holds on one joint first. The bushings print upright, 0.15 mm over their stubs: ream them if tight.

## Print one joint first

Before buying the rest, print `L_thigh`, `L_knee_ear_clamp`, `L_shin`, `L_knee_rear_arm` and `L_knee_bushing`, with 1 MG90S and its own ear and horn screws and 2 M2 x 8. It tests: does the servo slide into its cradle and its ears onto their blocks
(the ear holes are read off a drawing that is not to scale); does the hub grip the spline; does the bushing turn freely on its stub; how much the shin flexes with about 350 g hung from the foot. Change the spec, not the STL.
