meetsitaram/duck-droids/docs/images/assembly/dynamixel/README.md

# All-Dynamixel videos

- `reveal_30s.mp4` and `build_5min.mp4` are the current ones.
- `first_person_30s.mp4` and `first_person_5min.mp4` show the same build through a pair of hands. They were rendered on 2026-11-04, so they show the duck as it was then, before later changes such as the turned regulator.
- `first_person_5min.mp4` is re-encoded at about 1,150 kb/s to fit under GitHub's limits. The picture is the same size, 1280 x 720.
