meetsitaram/duck-droids/reports/printable.md

# Physical checks

From tools/printable.py. Overhang from faces, not a slicer: none of this has been printed.

381 checks: 365 pass, 16 warn, **0 fail**

## ORIENT

| status | item | detail |
|---|---|---|
| PASS | L hip yaw lid | 122 mm2 overhang, 88 mm2 on the bed, 51 mm tall |
| PASS | L yaw bracket | 579 mm2 overhang, 1165 mm2 on the bed, 41 mm tall |
| PASS | L hip roll lid | 113 mm2 overhang, 75 mm2 on the bed, 51 mm tall |
| PASS | L roll bracket | 174 mm2 overhang, 572 mm2 on the bed, 37 mm tall |
| PASS | L thigh frame | 1375 mm2 overhang, 478 mm2 on the bed, 61 mm tall |
| PASS | L hip pitch lid | 167 mm2 overhang, 858 mm2 on the bed, 6 mm tall |
| PASS | L knee lid | 167 mm2 overhang, 833 mm2 on the bed, 6 mm tall |
| PASS | L thigh cover | 44 mm2 overhang, 4273 mm2 on the bed, 46 mm tall |
| PASS | L shin | 823 mm2 overhang, 347 mm2 on the bed, 31 mm tall |
| PASS | L shoe | 708 mm2 overhang, 84 mm2 on the bed, 69 mm tall |
| PASS | L sole | 478 mm2 overhang, 238 mm2 on the bed, 69 mm tall |
| PASS | L inner ear | 0 mm2 overhang, 779 mm2 on the bed, 4 mm tall |
| PASS | R hip yaw lid | 108 mm2 overhang, 88 mm2 on the bed, 51 mm tall |
| PASS | R yaw bracket | 579 mm2 overhang, 1165 mm2 on the bed, 41 mm tall |
| PASS | R hip roll lid | 113 mm2 overhang, 75 mm2 on the bed, 51 mm tall |
| PASS | R roll bracket | 174 mm2 overhang, 572 mm2 on the bed, 37 mm tall |
| PASS | R thigh frame | 1375 mm2 overhang, 478 mm2 on the bed, 61 mm tall |
| PASS | R hip pitch lid | 167 mm2 overhang, 858 mm2 on the bed, 6 mm tall |
| PASS | R knee lid | 167 mm2 overhang, 833 mm2 on the bed, 6 mm tall |
| PASS | R thigh cover | 44 mm2 overhang, 4273 mm2 on the bed, 46 mm tall |
| PASS | R shin | 823 mm2 overhang, 347 mm2 on the bed, 31 mm tall |
| PASS | R shoe | 708 mm2 overhang, 84 mm2 on the bed, 69 mm tall |
| PASS | R sole | 477 mm2 overhang, 238 mm2 on the bed, 69 mm tall |
| PASS | R inner ear | 0 mm2 overhang, 779 mm2 on the bed, 4 mm tall |
| PASS | chassis | 3076 mm2 overhang, 434 mm2 on the bed, 69 mm tall |
| PASS | body shell | 2399 mm2 overhang, 1795 mm2 on the bed, 98 mm tall |
| PASS | neck column | 198 mm2 overhang, 150 mm2 on the bed, 28 mm tall |
| PASS | neck lid | 0 mm2 overhang, 94 mm2 on the bed, 2 mm tall |
| PASS | head pitch lid | 0 mm2 overhang, 95 mm2 on the bed, 2 mm tall |
| PASS | head fork | 408 mm2 overhang, 389 mm2 on the bed, 37 mm tall |
| PASS | head yaw sheet | 0 mm2 overhang, 562 mm2 on the bed, 4 mm tall |
| PASS | head yaw bracket | 218 mm2 overhang, 451 mm2 on the bed, 40 mm tall |
| PASS | head roll lid | 0 mm2 overhang, 560 mm2 on the bed, 3 mm tall |
| PASS | head roll spacer | 0 mm2 overhang, 147 mm2 on the bed, 2 mm tall |
| PASS | head roll rear spacer | 0 mm2 overhang, 179 mm2 on the bed, 2 mm tall |
| PASS | head frame | 6605 mm2 overhang, 300 mm2 on the bed, 146 mm tall |
| PASS | hood | 3176 mm2 overhang, 276 mm2 on the bed, 155 mm tall |
| PASS | jaw | 928 mm2 overhang, 1122 mm2 on the bed, 91 mm tall |
| PASS | jaw soft insert | 0 mm2 overhang, 2870 mm2 on the bed, 5 mm tall |
| PASS | mouth roof | 14 mm2 overhang, 4193 mm2 on the bed, 3 mm tall |
| PASS | face | 45 mm2 overhang, 4491 mm2 on the bed, 3 mm tall |
| PASS | eye ring | 0 mm2 overhang, 888 mm2 on the bed, 11 mm tall |
| PASS | eye iris | 0 mm2 overhang, 228 mm2 on the bed, 9 mm tall |

## PIECES

| status | item | detail |
|---|---|---|
| PASS | L hip yaw lid |  |
| PASS | L yaw bracket |  |
| PASS | L hip roll lid |  |
| PASS | L roll bracket |  |
| PASS | L thigh frame |  |
| PASS | L hip pitch lid |  |
| PASS | L knee lid |  |
| PASS | L thigh cover |  |
| PASS | L shin |  |
| PASS | L shoe |  |
| PASS | L sole |  |
| PASS | L inner ear |  |
| PASS | R hip yaw lid |  |
| PASS | R yaw bracket |  |
| PASS | R hip roll lid |  |
| PASS | R roll bracket |  |
| PASS | R thigh frame |  |
| PASS | R hip pitch lid |  |
| PASS | R knee lid |  |
| PASS | R thigh cover |  |
| PASS | R shin |  |
| PASS | R shoe |  |
| PASS | R sole |  |
| PASS | R inner ear |  |
| PASS | chassis |  |
| PASS | body shell |  |
| PASS | neck column |  |
| PASS | neck lid |  |
| PASS | head pitch lid |  |
| PASS | head fork |  |
| PASS | head yaw sheet |  |
| PASS | head yaw bracket |  |
| PASS | head roll lid |  |
| PASS | head roll spacer |  |
| PASS | head roll rear spacer |  |
| PASS | head frame |  |
| PASS | hood |  |
| PASS | jaw |  |
| PASS | jaw soft insert |  |
| PASS | mouth roof |  |
| PASS | face |  |
| PASS | eye ring |  |
| PASS | eye iris |  |

## BED

| status | item | detail |
|---|---|---|
| PASS | L hip yaw lid | 6 x 31 x 51 mm, 88 mm2 on the bed |
| PASS | L yaw bracket | 62 x 30 x 41 mm, 1165 mm2 on the bed |
| PASS | L hip roll lid | 6 x 29 x 51 mm, 75 mm2 on the bed |
| PASS | L roll bracket | 23 x 36 x 37 mm, 572 mm2 on the bed |
| PASS | L thigh frame | 81 x 46 x 61 mm, 478 mm2 on the bed |
| PASS | L hip pitch lid | 31 x 51 x 6 mm, 858 mm2 on the bed |
| PASS | L knee lid | 51 x 31 x 6 mm, 833 mm2 on the bed |
| PASS | L thigh cover | 67 x 87 x 46 mm, 4273 mm2 on the bed |
| PASS | L shin | 79 x 42 x 31 mm, 347 mm2 on the bed |
| PASS | L shoe | 29 x 53 x 69 mm, 84 mm2 on the bed |
| PASS | L sole | 15 x 53 x 69 mm, 238 mm2 on the bed |
| PASS | L inner ear | 29 x 48 x 4 mm, 779 mm2 on the bed |
| PASS | R hip yaw lid | 6 x 31 x 51 mm, 88 mm2 on the bed |
| PASS | R yaw bracket | 62 x 30 x 41 mm, 1165 mm2 on the bed |
| PASS | R hip roll lid | 6 x 29 x 51 mm, 75 mm2 on the bed |
| PASS | R roll bracket | 23 x 36 x 37 mm, 572 mm2 on the bed |
| PASS | R thigh frame | 81 x 46 x 61 mm, 478 mm2 on the bed |
| PASS | R hip pitch lid | 31 x 51 x 6 mm, 858 mm2 on the bed |
| PASS | R knee lid | 51 x 31 x 6 mm, 833 mm2 on the bed |
| PASS | R thigh cover | 67 x 87 x 46 mm, 4273 mm2 on the bed |
| PASS | R shin | 79 x 42 x 31 mm, 347 mm2 on the bed |
| PASS | R shoe | 29 x 53 x 69 mm, 84 mm2 on the bed |
| PASS | R sole | 15 x 53 x 69 mm, 238 mm2 on the bed |
| PASS | R inner ear | 29 x 48 x 4 mm, 779 mm2 on the bed |
| PASS | chassis | 49 x 97 x 69 mm, 434 mm2 on the bed |
| PASS | body shell | 49 x 80 x 98 mm, 1795 mm2 on the bed |
| PASS | neck column | 29 x 26 x 28 mm, 150 mm2 on the bed |
| PASS | neck lid | 5 x 26 x 2 mm, 94 mm2 on the bed |
| PASS | head pitch lid | 5 x 26 x 2 mm, 95 mm2 on the bed |
| PASS | head fork | 55 x 39 x 37 mm, 389 mm2 on the bed |
| PASS | head yaw sheet | 37 x 26 x 4 mm, 562 mm2 on the bed |
| PASS | head yaw bracket | 28 x 29 x 40 mm, 451 mm2 on the bed |
| PASS | head roll lid | 26 x 37 x 3 mm, 560 mm2 on the bed |
| PASS | head roll spacer | 16 x 16 x 2 mm, 147 mm2 on the bed |
| PASS | head roll rear spacer | 16 x 16 x 2 mm, 179 mm2 on the bed |
| PASS | head frame | 60 x 105 x 146 mm, 300 mm2 on the bed |
| PASS | hood | 60 x 110 x 155 mm, 276 mm2 on the bed |
| PASS | jaw | 44 x 110 x 91 mm, 1122 mm2 on the bed |
| PASS | jaw soft insert | 28 x 105 x 5 mm, 2870 mm2 on the bed |
| PASS | mouth roof | 41 x 105 x 3 mm, 4193 mm2 on the bed |
| PASS | face | 52 x 103 x 3 mm, 4491 mm2 on the bed |
| PASS | eye ring | 35 x 35 x 11 mm, 888 mm2 on the bed |
| PASS | eye iris | 20 x 20 x 9 mm, 228 mm2 on the bed |

## HOLES

| status | item | detail |
|---|---|---|
| PASS | L hip yaw lid |  |
| PASS | L yaw bracket |  |
| PASS | L hip roll lid |  |
| PASS | L roll bracket |  |
| PASS | L thigh frame |  |
| PASS | L hip pitch lid |  |
| PASS | L knee lid |  |
| PASS | L thigh cover |  |
| PASS | L shin |  |
| PASS | L shoe |  |
| PASS | L sole |  |
| PASS | L inner ear |  |
| PASS | R hip yaw lid |  |
| PASS | R yaw bracket |  |
| PASS | R hip roll lid |  |
| PASS | R roll bracket |  |
| PASS | R thigh frame |  |
| PASS | R hip pitch lid |  |
| PASS | R knee lid |  |
| PASS | R thigh cover |  |
| PASS | R shin |  |
| PASS | R shoe |  |
| PASS | R sole |  |
| PASS | R inner ear |  |
| PASS | chassis |  |
| PASS | body shell |  |
| PASS | neck column |  |
| PASS | neck lid |  |
| PASS | head pitch lid |  |
| PASS | head fork |  |
| PASS | head yaw sheet |  |
| PASS | head yaw bracket |  |
| PASS | head roll lid |  |
| PASS | head roll spacer |  |
| PASS | head roll rear spacer |  |
| PASS | head frame |  |
| PASS | hood |  |
| PASS | jaw |  |
| PASS | jaw soft insert |  |
| PASS | mouth roof |  |
| PASS | face |  |
| PASS | eye ring |  |
| PASS | eye iris |  |

## SUPPORT

| status | item | detail |
|---|---|---|
| WARN | L yaw bracket | 579 mm2 needs support or a bridge: check it in the slicer |
| WARN | L thigh frame | 1375 mm2 needs support or a bridge: check it in the slicer |
| WARN | L shin | 823 mm2 needs support or a bridge: check it in the slicer |
| WARN | L shoe | 708 mm2 needs support or a bridge: check it in the slicer |
| WARN | L sole | 478 mm2 needs support or a bridge: check it in the slicer |
| WARN | R yaw bracket | 579 mm2 needs support or a bridge: check it in the slicer |
| WARN | R thigh frame | 1375 mm2 needs support or a bridge: check it in the slicer |
| WARN | R shin | 823 mm2 needs support or a bridge: check it in the slicer |
| WARN | R shoe | 708 mm2 needs support or a bridge: check it in the slicer |
| WARN | R sole | 477 mm2 needs support or a bridge: check it in the slicer |
| WARN | chassis | 3076 mm2 needs support or a bridge: check it in the slicer |
| WARN | body shell | 2399 mm2 needs support or a bridge: check it in the slicer |
| WARN | head fork | 408 mm2 needs support or a bridge: check it in the slicer |
| WARN | head frame | 6605 mm2 needs support or a bridge: check it in the slicer |
| WARN | hood | 3176 mm2 needs support or a bridge: check it in the slicer |
| WARN | jaw | 928 mm2 needs support or a bridge: check it in the slicer |

## SKIN

| status | item | detail |
|---|---|---|
| PASS | L thigh cover | 2 screws drill it: ['L thigh cover screw hip', 'L thigh cover screw knee'] |
| PASS | R thigh cover | 2 screws drill it: ['R thigh cover screw hip', 'R thigh cover screw knee'] |
| PASS | body shell | 2 screws drill it: ['body screw 0', 'body screw 1'] |
| PASS | hood | 3 screws drill it: ['R hinge screw', 'hood rear screw 0', 'hood rear screw 1'] |
| PASS | mouth roof | 0 screws drill it: [] |

## MATE

| status | item | detail |
|---|---|---|
| PASS | parts that share a link | 43 parts: 0 clashes |

## HEADS

| status | item | detail |
|---|---|---|
| PASS | body screw 0 |  |
| PASS | body screw 1 |  |
| PASS | L hip yaw cradle screw near 0 |  |
| PASS | L hip yaw cradle screw near 1 |  |
| PASS | L hip yaw cradle screw horn face 0 |  |
| PASS | L hip yaw cradle screw horn face 1 |  |
| PASS | L hip yaw cradle screw rear face 0 |  |
| PASS | L hip yaw cradle screw rear face 1 |  |
| PASS | R hip yaw cradle screw near 0 |  |
| PASS | R hip yaw cradle screw near 1 |  |
| PASS | R hip yaw cradle screw horn face 0 |  |
| PASS | R hip yaw cradle screw horn face 1 |  |
| PASS | R hip yaw cradle screw rear face 0 |  |
| PASS | R hip yaw cradle screw rear face 1 |  |
| PASS | neck pitch fork screw horn 0 |  |
| PASS | neck pitch fork screw horn 1 |  |
| PASS | neck pitch fork screw horn 2 |  |
| PASS | neck pitch fork screw horn 3 |  |
| PASS | neck pitch fork screw rear 0 |  |
| PASS | neck pitch fork screw rear 1 |  |
| PASS | neck pitch fork screw rear 2 |  |
| PASS | neck pitch fork screw rear 3 |  |
| PASS | L hip yaw fork screw horn 0 |  |
| PASS | L hip yaw fork screw horn 1 |  |
| PASS | L hip yaw fork screw horn 2 |  |
| PASS | L hip yaw fork screw horn 3 |  |
| PASS | L hip roll cradle screw near 0 |  |
| PASS | L hip roll cradle screw near 1 |  |
| PASS | L hip roll cradle screw horn face 0 |  |
| PASS | L hip roll cradle screw horn face 1 |  |
| PASS | L hip roll cradle screw rear face 0 |  |
| PASS | L hip roll cradle screw rear face 1 |  |
| PASS | R hip yaw fork screw horn 0 |  |
| PASS | R hip yaw fork screw horn 1 |  |
| PASS | R hip yaw fork screw horn 2 |  |
| PASS | R hip yaw fork screw horn 3 |  |
| PASS | R hip roll cradle screw near 0 |  |
| PASS | R hip roll cradle screw near 1 |  |
| PASS | R hip roll cradle screw horn face 0 |  |
| PASS | R hip roll cradle screw horn face 1 |  |
| PASS | R hip roll cradle screw rear face 0 |  |
| PASS | R hip roll cradle screw rear face 1 |  |
| PASS | L hip roll fork screw horn 0 |  |
| PASS | L hip roll fork screw horn 1 |  |
| PASS | L hip roll fork screw horn 2 |  |
| PASS | L hip roll fork screw horn 3 |  |
| PASS | L hip pitch fork screw horn 0 |  |
| PASS | L hip pitch fork screw horn 1 |  |
| PASS | L hip pitch fork screw horn 2 |  |
| PASS | L hip pitch fork screw horn 3 |  |
| PASS | R hip roll fork screw horn 0 |  |
| PASS | R hip roll fork screw horn 1 |  |
| PASS | R hip roll fork screw horn 2 |  |
| PASS | R hip roll fork screw horn 3 |  |
| PASS | R hip pitch fork screw horn 0 |  |
| PASS | R hip pitch fork screw horn 1 |  |
| PASS | R hip pitch fork screw horn 2 |  |
| PASS | R hip pitch fork screw horn 3 |  |
| PASS | L thigh cover screw hip |  |
| PASS | L thigh cover screw knee |  |
| PASS | L hip pitch cradle screw near 0 |  |
| PASS | L hip pitch cradle screw near 1 |  |
| PASS | L hip pitch cradle screw horn face 0 |  |
| PASS | L hip pitch cradle screw horn face 1 |  |
| PASS | L hip pitch cradle screw rear face 0 |  |
| PASS | L hip pitch cradle screw rear face 1 |  |
| PASS | L knee cradle screw near 0 |  |
| PASS | L knee cradle screw near 1 |  |
| PASS | L knee cradle screw horn face 0 |  |
| PASS | L knee cradle screw horn face 1 |  |
| PASS | L knee cradle screw rear face 0 |  |
| PASS | L knee cradle screw rear face 1 |  |
| PASS | R thigh cover screw hip |  |
| PASS | R thigh cover screw knee |  |
| PASS | R hip pitch cradle screw near 0 |  |
| PASS | R hip pitch cradle screw near 1 |  |
| PASS | R hip pitch cradle screw horn face 0 |  |
| PASS | R hip pitch cradle screw horn face 1 |  |
| PASS | R hip pitch cradle screw rear face 0 |  |
| PASS | R hip pitch cradle screw rear face 1 |  |
| PASS | R knee cradle screw near 0 |  |
| PASS | R knee cradle screw near 1 |  |
| PASS | R knee cradle screw horn face 0 |  |
| PASS | R knee cradle screw horn face 1 |  |
| PASS | R knee cradle screw rear face 0 |  |
| PASS | R knee cradle screw rear face 1 |  |
| PASS | L ankle boss screw 0 |  |
| PASS | L ankle boss screw 1 |  |
| PASS | L ankle boss screw 2 |  |
| PASS | L ankle boss screw 3 |  |
| PASS | L knee fork screw horn 0 |  |
| PASS | L knee fork screw horn 1 |  |
| PASS | L knee fork screw horn 2 |  |
| PASS | L knee fork screw horn 3 |  |
| PASS | L ankle pitch cradle screw rear face 0 |  |
| PASS | L ankle pitch cradle screw rear face 1 |  |
| PASS | R ankle boss screw 0 |  |
| PASS | R ankle boss screw 1 |  |
| PASS | R ankle boss screw 2 |  |
| PASS | R ankle boss screw 3 |  |
| PASS | R knee fork screw horn 0 |  |
| PASS | R knee fork screw horn 1 |  |
| PASS | R knee fork screw horn 2 |  |
| PASS | R knee fork screw horn 3 |  |
| PASS | R ankle pitch cradle screw rear face 0 |  |
| PASS | R ankle pitch cradle screw rear face 1 |  |
| PASS | L ankle ear screw 0 |  |
| PASS | L ankle ear screw 1 |  |
| PASS | L shoe bottom screw 0 |  |
| PASS | L shoe bottom screw 1 |  |
| PASS | L ankle pitch fork screw horn 0 |  |
| PASS | L ankle pitch fork screw horn 1 |  |
| PASS | L ankle pitch fork screw horn 2 |  |
| PASS | L ankle pitch fork screw horn 3 |  |
| PASS | R ankle ear screw 0 |  |
| PASS | R ankle ear screw 1 |  |
| PASS | R shoe bottom screw 0 |  |
| PASS | R shoe bottom screw 1 |  |
| PASS | R ankle pitch fork screw horn 0 |  |
| PASS | R ankle pitch fork screw horn 1 |  |
| PASS | R ankle pitch fork screw horn 2 |  |
| PASS | R ankle pitch fork screw horn 3 |  |
| PASS | neck pitch cradle screw horn face 0 |  |
| PASS | neck pitch cradle screw horn face 1 |  |
| PASS | neck pitch cradle screw rear face 0 |  |
| PASS | neck pitch cradle screw rear face 1 |  |
| PASS | head pitch cradle screw horn face 0 |  |
| PASS | head pitch cradle screw horn face 1 |  |
| PASS | head pitch cradle screw rear face 0 |  |
| PASS | head pitch cradle screw rear face 1 |  |
| PASS | head pitch fork screw horn 0 |  |
| PASS | head pitch fork screw horn 1 |  |
| PASS | head pitch fork screw horn 2 |  |
| PASS | head pitch fork screw horn 3 |  |
| PASS | head pitch fork screw rear 0 |  |
| PASS | head pitch fork screw rear 1 |  |
| PASS | head pitch fork screw rear 2 |  |
| PASS | head pitch fork screw rear 3 |  |
| PASS | head yaw cradle screw horn face 0 |  |
| PASS | head yaw cradle screw horn face 1 |  |
| PASS | head yaw cradle screw rear face 0 |  |
| PASS | head yaw cradle screw rear face 1 |  |
| PASS | head yaw cradle screw rear near 0 |  |
| PASS | head yaw cradle screw rear near 1 |  |
| PASS | head yaw fork screw horn 0 |  |
| PASS | head yaw fork screw horn 1 |  |
| PASS | head yaw fork screw horn 2 |  |
| PASS | head yaw fork screw horn 3 |  |
| PASS | head roll cradle screw horn face 0 |  |
| PASS | head roll cradle screw horn face 1 |  |
| PASS | head roll cradle screw rear face 0 |  |
| PASS | head roll cradle screw rear face 1 |  |
| PASS | R hinge screw |  |
| PASS | Pi screw 0 |  |
| PASS | Pi screw 1 |  |
| PASS | Pi screw 2 |  |
| PASS | Pi screw 3 |  |
| PASS | bus board top screw 0 |  |
| PASS | bus board rear screw 0 |  |
| PASS | bus board top screw 1 |  |
| PASS | bus board rear screw 1 |  |
| PASS | bus board top screw 2 |  |
| PASS | bus board rear screw 2 |  |
| PASS | bus board top screw 3 |  |
| PASS | bus board rear screw 3 |  |
| PASS | leg bus board screw 0 |  |
| PASS | leg bus board screw 1 |  |
| PASS | leg bus board screw 2 |  |
| PASS | leg bus board screw 3 |  |
| PASS | hood rear screw 0 |  |
| PASS | hood rear screw 1 |  |
| PASS | head roll fork screw horn 0 |  |
| PASS | head roll fork screw horn 1 |  |
| PASS | head roll fork screw horn 2 |  |
| PASS | head roll fork screw horn 3 |  |
| PASS | head roll fork screw rear 0 |  |
| PASS | head roll fork screw rear 1 |  |
| PASS | head roll fork screw rear 2 |  |
| PASS | head roll fork screw rear 3 |  |
| PASS | beak cradle screw rear face 0 |  |
| PASS | beak cradle screw rear face 1 |  |
| PASS | beak cradle screw rear near 0 |  |
| PASS | beak cradle screw rear near 1 |  |
| PASS | beak fork screw horn 0 |  |
| PASS | beak fork screw horn 1 |  |
| PASS | beak fork screw horn 2 |  |
| PASS | beak fork screw horn 3 |  |
