meetsitaram/duck-droids/reports/assembly.md

# Physical checks

From tools/assembly.py

1102 checks: 1102 pass, 0 warn, **0 fail**

## PATH

| status | item | detail |
|---|---|---|
| PASS | thigh_L: L hip pitch servo |  |
| PASS | thigh_L: L knee servo |  |
| PASS | thigh_L: L hip pitch lid |  |
| PASS | thigh_L: L knee lid |  |
| PASS | thigh_L: L hip pitch bearing |  |
| PASS | thigh_L: L knee bearing |  |
| PASS | thigh_L: L hip pitch horn |  |
| PASS | thigh_L: L knee horn |  |
| PASS | thigh_L: L thigh cover |  |
| PASS | shin_L: L ankle servo |  |
| PASS | shin_L: L ankle bearing inner |  |
| PASS | shin_L: L ankle horn |  |
| PASS | shoe_L: L sole |  |
| PASS | leg_L: @shin_L |  |
| PASS | leg_L: @shoe_L |  |
| PASS | leg_L: L inner ear |  |
| PASS | leg_L: L roll bracket |  |
| PASS | thigh_R: R hip pitch servo |  |
| PASS | thigh_R: R knee servo |  |
| PASS | thigh_R: R hip pitch lid |  |
| PASS | thigh_R: R knee lid |  |
| PASS | thigh_R: R hip pitch bearing |  |
| PASS | thigh_R: R knee bearing |  |
| PASS | thigh_R: R hip pitch horn |  |
| PASS | thigh_R: R knee horn |  |
| PASS | thigh_R: R thigh cover |  |
| PASS | shin_R: R ankle servo |  |
| PASS | shin_R: R ankle bearing inner |  |
| PASS | shin_R: R ankle horn |  |
| PASS | shoe_R: R sole |  |
| PASS | leg_R: @shin_R |  |
| PASS | leg_R: @shoe_R |  |
| PASS | leg_R: R inner ear |  |
| PASS | leg_R: R roll bracket |  |
| PASS | body: L hip yaw servo |  |
| PASS | body: R hip yaw servo |  |
| PASS | body: L hip yaw lid |  |
| PASS | body: R hip yaw lid |  |
| PASS | body: L hip yaw bearing |  |
| PASS | body: R hip yaw bearing |  |
| PASS | body: L hip yaw horn |  |
| PASS | body: R hip yaw horn |  |
| PASS | body: L yaw bracket |  |
| PASS | body: R yaw bracket |  |
| PASS | body: L hip roll servo |  |
| PASS | body: R hip roll servo |  |
| PASS | body: L hip roll lid |  |
| PASS | body: R hip roll lid |  |
| PASS | body: L hip roll bearing |  |
| PASS | body: R hip roll bearing |  |
| PASS | body: L hip roll horn |  |
| PASS | body: R hip roll horn |  |
| PASS | legs: @leg_L |  |
| PASS | legs: @leg_R |  |
| PASS | column: neck servo |  |
| PASS | column: neck lid |  |
| PASS | column: head pitch servo |  |
| PASS | column: head pitch lid |  |
| PASS | torso: battery |  |
| PASS | torso: L 5 V regulator |  |
| PASS | torso: leg bus splice |  |
| PASS | torso: IMU |  |
| PASS | torso: @column |  |
| PASS | torso: body shell |  |
| PASS | headbench: head yaw servo |  |
| PASS | headbench: head yaw sheet |  |
| PASS | headbench: head yaw bearing |  |
| PASS | headbench: head yaw horn |  |
| PASS | headbench: head yaw bracket |  |
| PASS | headbench: head roll servo |  |
| PASS | headbench: head roll rear bearing |  |
| PASS | headbench: head roll rear horn |  |
| PASS | headbench: head roll rear spacer |  |
| PASS | headbench: head roll lid |  |
| PASS | headbench: head roll bearing |  |
| PASS | headbench: head roll horn |  |
| PASS | headbench: head roll spacer |  |
| PASS | framebench: bus board standoffs |  |
| PASS | framebench: beak servo |  |
| PASS | jawbench: jaw soft insert |  |
| PASS | head: @headbench |  |
| PASS | head: @framebench |  |
| PASS | head: Waveshare bus board |  |
| PASS | head: Pi Zero 2 W |  |
| PASS | head: head 5 V regulator |  |
| PASS | head: leg bus board |  |
| PASS | head: @jawbench |  |
| PASS | head: hood |  |
| PASS | head: mouth roof |  |
| PASS | head: camera |  |
| PASS | head: face |  |
| PASS | head: eye ring |  |
| PASS | head: eye iris |  |

## HELD

| status | item | detail |
|---|---|---|
| PASS | L hip pitch cradle screw rear face 0 |  |
| PASS | L hip pitch cradle screw rear face 1 |  |
| PASS | L knee cradle screw rear face 0 |  |
| PASS | L knee cradle screw rear face 1 |  |
| PASS | L hip pitch cradle screw near 0 |  |
| PASS | L hip pitch cradle screw near 1 |  |
| PASS | L hip pitch cradle screw horn face 0 |  |
| PASS | L hip pitch cradle screw horn face 1 |  |
| PASS | L knee cradle screw near 0 |  |
| PASS | L knee cradle screw near 1 |  |
| PASS | L knee cradle screw horn face 0 |  |
| PASS | L knee cradle screw horn face 1 |  |
| PASS | L thigh cover screw hip |  |
| PASS | L thigh cover screw knee |  |
| PASS | L ankle boss screw 0 |  |
| PASS | L ankle boss screw 1 |  |
| PASS | L ankle boss screw 2 |  |
| PASS | L ankle boss screw 3 |  |
| PASS | L ankle pitch cradle screw rear face 0 |  |
| PASS | L ankle pitch cradle screw rear face 1 |  |
| PASS | L shoe bottom screw 0 |  |
| PASS | L shoe bottom screw 1 |  |
| PASS | L knee fork screw horn 0 |  |
| PASS | L knee fork screw horn 1 |  |
| PASS | L knee fork screw horn 2 |  |
| PASS | L knee fork screw horn 3 |  |
| PASS | L ankle pitch fork screw horn 0 |  |
| PASS | L ankle pitch fork screw horn 1 |  |
| PASS | L ankle pitch fork screw horn 2 |  |
| PASS | L ankle pitch fork screw horn 3 |  |
| PASS | L ankle ear screw 0 |  |
| PASS | L ankle ear screw 1 |  |
| PASS | L hip pitch fork screw horn 0 |  |
| PASS | L hip pitch fork screw horn 1 |  |
| PASS | L hip pitch fork screw horn 2 |  |
| PASS | L hip pitch fork screw horn 3 |  |
| PASS | R hip pitch cradle screw rear face 0 |  |
| PASS | R hip pitch cradle screw rear face 1 |  |
| PASS | R knee cradle screw rear face 0 |  |
| PASS | R knee cradle screw rear face 1 |  |
| PASS | R hip pitch cradle screw near 0 |  |
| PASS | R hip pitch cradle screw near 1 |  |
| PASS | R hip pitch cradle screw horn face 0 |  |
| PASS | R hip pitch cradle screw horn face 1 |  |
| PASS | R knee cradle screw near 0 |  |
| PASS | R knee cradle screw near 1 |  |
| PASS | R knee cradle screw horn face 0 |  |
| PASS | R knee cradle screw horn face 1 |  |
| PASS | R thigh cover screw hip |  |
| PASS | R thigh cover screw knee |  |
| PASS | R ankle boss screw 0 |  |
| PASS | R ankle boss screw 1 |  |
| PASS | R ankle boss screw 2 |  |
| PASS | R ankle boss screw 3 |  |
| PASS | R ankle pitch cradle screw rear face 0 |  |
| PASS | R ankle pitch cradle screw rear face 1 |  |
| PASS | R shoe bottom screw 0 |  |
| PASS | R shoe bottom screw 1 |  |
| PASS | R knee fork screw horn 0 |  |
| PASS | R knee fork screw horn 1 |  |
| PASS | R knee fork screw horn 2 |  |
| PASS | R knee fork screw horn 3 |  |
| PASS | R ankle pitch fork screw horn 0 |  |
| PASS | R ankle pitch fork screw horn 1 |  |
| PASS | R ankle pitch fork screw horn 2 |  |
| PASS | R ankle pitch fork screw horn 3 |  |
| PASS | R ankle ear screw 0 |  |
| PASS | R ankle ear screw 1 |  |
| PASS | R hip pitch fork screw horn 0 |  |
| PASS | R hip pitch fork screw horn 1 |  |
| PASS | R hip pitch fork screw horn 2 |  |
| PASS | R hip pitch fork screw horn 3 |  |
| PASS | L hip yaw cradle screw rear face 0 |  |
| PASS | L hip yaw cradle screw rear face 1 |  |
| PASS | R hip yaw cradle screw rear face 0 |  |
| PASS | R hip yaw cradle screw rear face 1 |  |
| PASS | L hip yaw cradle screw near 0 |  |
| PASS | L hip yaw cradle screw near 1 |  |
| PASS | L hip yaw cradle screw horn face 0 |  |
| PASS | L hip yaw cradle screw horn face 1 |  |
| PASS | R hip yaw cradle screw near 0 |  |
| PASS | R hip yaw cradle screw near 1 |  |
| PASS | R hip yaw cradle screw horn face 0 |  |
| PASS | R hip yaw cradle screw horn face 1 |  |
| PASS | L hip yaw fork screw horn 0 |  |
| PASS | L hip yaw fork screw horn 1 |  |
| PASS | L hip yaw fork screw horn 2 |  |
| PASS | L hip yaw fork screw horn 3 |  |
| PASS | R hip yaw fork screw horn 0 |  |
| PASS | R hip yaw fork screw horn 1 |  |
| PASS | R hip yaw fork screw horn 2 |  |
| PASS | R hip yaw fork screw horn 3 |  |
| PASS | L hip roll cradle screw rear face 0 |  |
| PASS | L hip roll cradle screw rear face 1 |  |
| PASS | R hip roll cradle screw rear face 0 |  |
| PASS | R hip roll cradle screw rear face 1 |  |
| PASS | L hip roll cradle screw near 0 |  |
| PASS | L hip roll cradle screw near 1 |  |
| PASS | L hip roll cradle screw horn face 0 |  |
| PASS | L hip roll cradle screw horn face 1 |  |
| PASS | R hip roll cradle screw near 0 |  |
| PASS | R hip roll cradle screw near 1 |  |
| PASS | R hip roll cradle screw horn face 0 |  |
| PASS | R hip roll cradle screw horn face 1 |  |
| PASS | L hip roll fork screw horn 0 |  |
| PASS | L hip roll fork screw horn 1 |  |
| PASS | L hip roll fork screw horn 2 |  |
| PASS | L hip roll fork screw horn 3 |  |
| PASS | R hip roll fork screw horn 0 |  |
| PASS | R hip roll fork screw horn 1 |  |
| PASS | R hip roll fork screw horn 2 |  |
| PASS | R hip roll fork screw horn 3 |  |
| PASS | neck pitch cradle screw rear face 0 |  |
| PASS | neck pitch cradle screw rear face 1 |  |
| PASS | neck pitch cradle screw horn face 0 |  |
| PASS | neck pitch cradle screw horn face 1 |  |
| PASS | head pitch cradle screw rear face 0 |  |
| PASS | head pitch cradle screw rear face 1 |  |
| PASS | head pitch cradle screw horn face 0 |  |
| PASS | head pitch cradle screw horn face 1 |  |
| PASS | neck pitch fork screw horn 0 |  |
| PASS | neck pitch fork screw horn 1 |  |
| PASS | neck pitch fork screw horn 2 |  |
| PASS | neck pitch fork screw horn 3 |  |
| PASS | neck pitch fork screw rear 0 |  |
| PASS | neck pitch fork screw rear 1 |  |
| PASS | neck pitch fork screw rear 2 |  |
| PASS | neck pitch fork screw rear 3 |  |
| PASS | body screw 0 |  |
| PASS | body screw 1 |  |
| PASS | head yaw cradle screw rear face 0 |  |
| PASS | head yaw cradle screw rear face 1 |  |
| PASS | head yaw cradle screw rear near 0 |  |
| PASS | head yaw cradle screw rear near 1 |  |
| PASS | head yaw cradle screw horn face 0 |  |
| PASS | head yaw cradle screw horn face 1 |  |
| PASS | head yaw fork screw horn 0 |  |
| PASS | head yaw fork screw horn 1 |  |
| PASS | head yaw fork screw horn 2 |  |
| PASS | head yaw fork screw horn 3 |  |
| PASS | head roll cradle screw rear face 0 |  |
| PASS | head roll cradle screw rear face 1 |  |
| PASS | head roll cradle screw horn face 0 |  |
| PASS | head roll cradle screw horn face 1 |  |
| PASS | bus board rear screw 0 |  |
| PASS | bus board rear screw 1 |  |
| PASS | bus board rear screw 2 |  |
| PASS | bus board rear screw 3 |  |
| PASS | beak cradle screw rear face 0 |  |
| PASS | beak cradle screw rear face 1 |  |
| PASS | beak cradle screw rear near 0 |  |
| PASS | beak cradle screw rear near 1 |  |
| PASS | head pitch fork screw horn 0 |  |
| PASS | head pitch fork screw horn 1 |  |
| PASS | head pitch fork screw horn 2 |  |
| PASS | head pitch fork screw horn 3 |  |
| PASS | head pitch fork screw rear 0 |  |
| PASS | head pitch fork screw rear 1 |  |
| PASS | head pitch fork screw rear 2 |  |
| PASS | head pitch fork screw rear 3 |  |
| PASS | head roll fork screw horn 0 |  |
| PASS | head roll fork screw horn 1 |  |
| PASS | head roll fork screw horn 2 |  |
| PASS | head roll fork screw horn 3 |  |
| PASS | head roll fork screw rear 0 |  |
| PASS | head roll fork screw rear 1 |  |
| PASS | head roll fork screw rear 2 |  |
| PASS | head roll fork screw rear 3 |  |
| PASS | bus board top screw 0 |  |
| PASS | bus board top screw 1 |  |
| PASS | bus board top screw 2 |  |
| PASS | bus board top screw 3 |  |
| PASS | Pi screw 0 |  |
| PASS | Pi screw 1 |  |
| PASS | Pi screw 2 |  |
| PASS | Pi screw 3 |  |
| PASS | leg bus board screw 0 |  |
| PASS | leg bus board screw 1 |  |
| PASS | leg bus board screw 2 |  |
| PASS | leg bus board screw 3 |  |
| PASS | beak fork screw horn 0 |  |
| PASS | beak fork screw horn 1 |  |
| PASS | beak fork screw horn 2 |  |
| PASS | beak fork screw horn 3 |  |
| PASS | hood rear screw 0 |  |
| PASS | hood rear screw 1 |  |

## THREAD

| status | item | detail |
|---|---|---|
| PASS | L hip pitch cradle screw rear face 0 | M2 x 8: bites 3.0 mm |
| PASS | L hip pitch cradle screw rear face 1 | M2 x 8: bites 3.0 mm |
| PASS | L knee cradle screw rear face 0 | M2 x 8: bites 3.0 mm |
| PASS | L knee cradle screw rear face 1 | M2 x 8: bites 3.0 mm |
| PASS | L hip pitch cradle screw near 0 | M2 x 6: bites 3.0 mm |
| PASS | L hip pitch cradle screw near 1 | M2 x 6: bites 3.0 mm |
| PASS | L hip pitch cradle screw horn face 0 | M2 x 6: bites 2.9 mm |
| PASS | L hip pitch cradle screw horn face 1 | M2 x 6: bites 2.9 mm |
| PASS | L knee cradle screw near 0 | M2 x 6: bites 3.0 mm |
| PASS | L knee cradle screw near 1 | M2 x 6: bites 3.0 mm |
| PASS | L knee cradle screw horn face 0 | M2 x 6: bites 2.9 mm |
| PASS | L knee cradle screw horn face 1 | M2 x 6: bites 2.9 mm |
| PASS | L thigh cover screw hip | M2 x 6: bites 3.0 mm |
| PASS | L thigh cover screw knee | M2 x 6: bites 3.0 mm |
| PASS | L ankle boss screw 0 | M3 flat x 6: bites 2.3 mm |
| PASS | L ankle boss screw 1 | M3 flat x 6: bites 2.3 mm |
| PASS | L ankle boss screw 2 | M3 flat x 6: bites 2.3 mm |
| PASS | L ankle boss screw 3 | M3 flat x 6: bites 2.3 mm |
| PASS | L ankle pitch cradle screw rear face 0 | M2 x 8: bites 3.0 mm |
| PASS | L ankle pitch cradle screw rear face 1 | M2 x 8: bites 3.0 mm |
| PASS | L shoe bottom screw 0 | M3 x 12: bites 5.4 mm |
| PASS | L shoe bottom screw 1 | M3 x 12: bites 5.4 mm |
| PASS | L knee fork screw horn 0 | M3 x 10: bites 3.6 mm |
| PASS | L knee fork screw horn 1 | M3 x 10: bites 3.6 mm |
| PASS | L knee fork screw horn 2 | M3 x 10: bites 3.6 mm |
| PASS | L knee fork screw horn 3 | M3 x 10: bites 3.6 mm |
| PASS | L ankle pitch fork screw horn 0 | M3 x 8: bites 3.0 mm |
| PASS | L ankle pitch fork screw horn 1 | M3 x 8: bites 3.0 mm |
| PASS | L ankle pitch fork screw horn 2 | M3 x 8: bites 3.0 mm |
| PASS | L ankle pitch fork screw horn 3 | M3 x 8: bites 3.0 mm |
| PASS | L ankle ear screw 0 | M2 x 8: bites 3.8 mm |
| PASS | L ankle ear screw 1 | M2 x 8: bites 3.8 mm |
| PASS | L hip pitch fork screw horn 0 | M3 x 10: bites 3.6 mm |
| PASS | L hip pitch fork screw horn 1 | M3 x 10: bites 3.6 mm |
| PASS | L hip pitch fork screw horn 2 | M3 x 10: bites 3.6 mm |
| PASS | L hip pitch fork screw horn 3 | M3 x 10: bites 3.6 mm |
| PASS | R hip pitch cradle screw rear face 0 | M2 x 8: bites 3.0 mm |
| PASS | R hip pitch cradle screw rear face 1 | M2 x 8: bites 3.0 mm |
| PASS | R knee cradle screw rear face 0 | M2 x 8: bites 3.0 mm |
| PASS | R knee cradle screw rear face 1 | M2 x 8: bites 3.0 mm |
| PASS | R hip pitch cradle screw near 0 | M2 x 6: bites 3.0 mm |
| PASS | R hip pitch cradle screw near 1 | M2 x 6: bites 3.0 mm |
| PASS | R hip pitch cradle screw horn face 0 | M2 x 6: bites 2.9 mm |
| PASS | R hip pitch cradle screw horn face 1 | M2 x 6: bites 2.9 mm |
| PASS | R knee cradle screw near 0 | M2 x 6: bites 3.0 mm |
| PASS | R knee cradle screw near 1 | M2 x 6: bites 3.0 mm |
| PASS | R knee cradle screw horn face 0 | M2 x 6: bites 2.9 mm |
| PASS | R knee cradle screw horn face 1 | M2 x 6: bites 2.9 mm |
| PASS | R thigh cover screw hip | M2 x 6: bites 3.0 mm |
| PASS | R thigh cover screw knee | M2 x 6: bites 3.0 mm |
| PASS | R ankle boss screw 0 | M3 flat x 6: bites 2.3 mm |
| PASS | R ankle boss screw 1 | M3 flat x 6: bites 2.3 mm |
| PASS | R ankle boss screw 2 | M3 flat x 6: bites 2.3 mm |
| PASS | R ankle boss screw 3 | M3 flat x 6: bites 2.3 mm |
| PASS | R ankle pitch cradle screw rear face 0 | M2 x 8: bites 3.0 mm |
| PASS | R ankle pitch cradle screw rear face 1 | M2 x 8: bites 3.0 mm |
| PASS | R shoe bottom screw 0 | M3 x 12: bites 5.4 mm |
| PASS | R shoe bottom screw 1 | M3 x 12: bites 5.4 mm |
| PASS | R knee fork screw horn 0 | M3 x 10: bites 3.6 mm |
| PASS | R knee fork screw horn 1 | M3 x 10: bites 3.6 mm |
| PASS | R knee fork screw horn 2 | M3 x 10: bites 3.6 mm |
| PASS | R knee fork screw horn 3 | M3 x 10: bites 3.6 mm |
| PASS | R ankle pitch fork screw horn 0 | M3 x 8: bites 3.0 mm |
| PASS | R ankle pitch fork screw horn 1 | M3 x 8: bites 3.0 mm |
| PASS | R ankle pitch fork screw horn 2 | M3 x 8: bites 3.0 mm |
| PASS | R ankle pitch fork screw horn 3 | M3 x 8: bites 3.0 mm |
| PASS | R ankle ear screw 0 | M2 x 8: bites 3.8 mm |
| PASS | R ankle ear screw 1 | M2 x 8: bites 3.8 mm |
| PASS | R hip pitch fork screw horn 0 | M3 x 10: bites 3.6 mm |
| PASS | R hip pitch fork screw horn 1 | M3 x 10: bites 3.6 mm |
| PASS | R hip pitch fork screw horn 2 | M3 x 10: bites 3.6 mm |
| PASS | R hip pitch fork screw horn 3 | M3 x 10: bites 3.6 mm |
| PASS | L hip yaw cradle screw rear face 0 | M2 x 8: bites 3.0 mm |
| PASS | L hip yaw cradle screw rear face 1 | M2 x 8: bites 3.0 mm |
| PASS | R hip yaw cradle screw rear face 0 | M2 x 8: bites 3.0 mm |
| PASS | R hip yaw cradle screw rear face 1 | M2 x 8: bites 3.0 mm |
| PASS | L hip yaw cradle screw near 0 | M2 x 6: bites 3.0 mm |
| PASS | L hip yaw cradle screw near 1 | M2 x 6: bites 3.0 mm |
| PASS | L hip yaw cradle screw horn face 0 | M2 x 6: bites 2.9 mm |
| PASS | L hip yaw cradle screw horn face 1 | M2 x 6: bites 2.9 mm |
| PASS | R hip yaw cradle screw near 0 | M2 x 6: bites 3.0 mm |
| PASS | R hip yaw cradle screw near 1 | M2 x 6: bites 3.0 mm |
| PASS | R hip yaw cradle screw horn face 0 | M2 x 6: bites 2.9 mm |
| PASS | R hip yaw cradle screw horn face 1 | M2 x 6: bites 2.9 mm |
| PASS | L hip yaw fork screw horn 0 | M3 x 10: bites 3.6 mm |
| PASS | L hip yaw fork screw horn 1 | M3 x 10: bites 3.6 mm |
| PASS | L hip yaw fork screw horn 2 | M3 x 10: bites 3.6 mm |
| PASS | L hip yaw fork screw horn 3 | M3 x 10: bites 3.6 mm |
| PASS | R hip yaw fork screw horn 0 | M3 x 10: bites 3.6 mm |
| PASS | R hip yaw fork screw horn 1 | M3 x 10: bites 3.6 mm |
| PASS | R hip yaw fork screw horn 2 | M3 x 10: bites 3.6 mm |
| PASS | R hip yaw fork screw horn 3 | M3 x 10: bites 3.6 mm |
| PASS | L hip roll cradle screw rear face 0 | M2 x 8: bites 3.0 mm |
| PASS | L hip roll cradle screw rear face 1 | M2 x 8: bites 3.0 mm |
| PASS | R hip roll cradle screw rear face 0 | M2 x 8: bites 3.0 mm |
| PASS | R hip roll cradle screw rear face 1 | M2 x 8: bites 3.0 mm |
| PASS | L hip roll cradle screw near 0 | M2 x 6: bites 3.0 mm |
| PASS | L hip roll cradle screw near 1 | M2 x 6: bites 3.0 mm |
| PASS | L hip roll cradle screw horn face 0 | M2 x 6: bites 2.9 mm |
| PASS | L hip roll cradle screw horn face 1 | M2 x 6: bites 2.9 mm |
| PASS | R hip roll cradle screw near 0 | M2 x 6: bites 3.0 mm |
| PASS | R hip roll cradle screw near 1 | M2 x 6: bites 3.0 mm |
| PASS | R hip roll cradle screw horn face 0 | M2 x 6: bites 2.9 mm |
| PASS | R hip roll cradle screw horn face 1 | M2 x 6: bites 2.9 mm |
| PASS | L hip roll fork screw horn 0 | M3 x 10: bites 3.6 mm |
| PASS | L hip roll fork screw horn 1 | M3 x 10: bites 3.6 mm |
| PASS | L hip roll fork screw horn 2 | M3 x 10: bites 3.6 mm |
| PASS | L hip roll fork screw horn 3 | M3 x 10: bites 3.6 mm |
| PASS | R hip roll fork screw horn 0 | M3 x 10: bites 3.6 mm |
| PASS | R hip roll fork screw horn 1 | M3 x 10: bites 3.6 mm |
| PASS | R hip roll fork screw horn 2 | M3 x 10: bites 3.6 mm |
| PASS | R hip roll fork screw horn 3 | M3 x 10: bites 3.6 mm |
| PASS | neck pitch cradle screw rear face 0 | M2 x 8: bites 4.0 mm |
| PASS | neck pitch cradle screw rear face 1 | M2 x 8: bites 4.0 mm |
| PASS | neck pitch cradle screw horn face 0 | M2 x 8: bites 4.0 mm |
| PASS | neck pitch cradle screw horn face 1 | M2 x 8: bites 4.0 mm |
| PASS | head pitch cradle screw rear face 0 | M2 x 8: bites 4.0 mm |
| PASS | head pitch cradle screw rear face 1 | M2 x 8: bites 4.0 mm |
| PASS | head pitch cradle screw horn face 0 | M2 x 8: bites 4.0 mm |
| PASS | head pitch cradle screw horn face 1 | M2 x 8: bites 4.0 mm |
| PASS | neck pitch fork screw horn 0 | M2 x 6: bites 2.9 mm |
| PASS | neck pitch fork screw horn 1 | M2 x 6: bites 2.9 mm |
| PASS | neck pitch fork screw horn 2 | M2 x 6: bites 2.9 mm |
| PASS | neck pitch fork screw horn 3 | M2 x 6: bites 2.9 mm |
| PASS | neck pitch fork screw rear 0 | M2 x 6: bites 2.9 mm |
| PASS | neck pitch fork screw rear 1 | M2 x 6: bites 2.9 mm |
| PASS | neck pitch fork screw rear 2 | M2 x 6: bites 2.9 mm |
| PASS | neck pitch fork screw rear 3 | M2 x 6: bites 2.9 mm |
| PASS | body screw 0 | M2 x 6: bites 3.0 mm |
| PASS | body screw 1 | M2 x 6: bites 3.0 mm |
| PASS | head yaw cradle screw rear face 0 | M2 x 8: bites 4.0 mm |
| PASS | head yaw cradle screw rear face 1 | M2 x 8: bites 4.0 mm |
| PASS | head yaw cradle screw rear near 0 | M2 x 8: bites 4.0 mm |
| PASS | head yaw cradle screw rear near 1 | M2 x 8: bites 4.0 mm |
| PASS | head yaw cradle screw horn face 0 | M2 x 8: bites 4.0 mm |
| PASS | head yaw cradle screw horn face 1 | M2 x 8: bites 4.0 mm |
| PASS | head yaw fork screw horn 0 | M2 x 6: bites 2.1 mm |
| PASS | head yaw fork screw horn 1 | M2 x 6: bites 2.1 mm |
| PASS | head yaw fork screw horn 2 | M2 x 6: bites 2.1 mm |
| PASS | head yaw fork screw horn 3 | M2 x 6: bites 2.1 mm |
| PASS | head roll cradle screw rear face 0 | M2 x 8: bites 4.0 mm |
| PASS | head roll cradle screw rear face 1 | M2 x 8: bites 4.0 mm |
| PASS | head roll cradle screw horn face 0 | M2 x 8: bites 4.0 mm |
| PASS | head roll cradle screw horn face 1 | M2 x 8: bites 4.0 mm |
| PASS | bus board rear screw 0 | M2.5 x 5: bites 2.5 mm |
| PASS | bus board rear screw 1 | M2.5 x 5: bites 2.5 mm |
| PASS | bus board rear screw 2 | M2.5 x 5: bites 2.5 mm |
| PASS | bus board rear screw 3 | M2.5 x 5: bites 2.5 mm |
| PASS | beak cradle screw rear face 0 | M2 x 8: bites 4.0 mm |
| PASS | beak cradle screw rear face 1 | M2 x 8: bites 4.0 mm |
| PASS | beak cradle screw rear near 0 | M2 x 8: bites 4.0 mm |
| PASS | beak cradle screw rear near 1 | M2 x 8: bites 4.0 mm |
| PASS | head pitch fork screw horn 0 | M2 x 6: bites 2.9 mm |
| PASS | head pitch fork screw horn 1 | M2 x 6: bites 2.9 mm |
| PASS | head pitch fork screw horn 2 | M2 x 6: bites 2.9 mm |
| PASS | head pitch fork screw horn 3 | M2 x 6: bites 2.9 mm |
| PASS | head pitch fork screw rear 0 | M2 x 6: bites 2.9 mm |
| PASS | head pitch fork screw rear 1 | M2 x 6: bites 2.9 mm |
| PASS | head pitch fork screw rear 2 | M2 x 6: bites 2.9 mm |
| PASS | head pitch fork screw rear 3 | M2 x 6: bites 2.9 mm |
| PASS | head roll fork screw horn 0 | M2 x 8: bites 4.0 mm |
| PASS | head roll fork screw horn 1 | M2 x 8: bites 4.0 mm |
| PASS | head roll fork screw horn 2 | M2 x 8: bites 4.0 mm |
| PASS | head roll fork screw horn 3 | M2 x 8: bites 4.0 mm |
| PASS | head roll fork screw rear 0 | M2 x 6: bites 3.0 mm |
| PASS | head roll fork screw rear 1 | M2 x 6: bites 3.0 mm |
| PASS | head roll fork screw rear 2 | M2 x 6: bites 3.0 mm |
| PASS | head roll fork screw rear 3 | M2 x 6: bites 3.0 mm |
| PASS | bus board top screw 0 | M2.5 x 5: bites 2.5 mm |
| PASS | bus board top screw 1 | M2.5 x 5: bites 2.5 mm |
| PASS | bus board top screw 2 | M2.5 x 5: bites 2.5 mm |
| PASS | bus board top screw 3 | M2.5 x 5: bites 2.5 mm |
| PASS | Pi screw 0 | M2 x 6: bites 3.0 mm |
| PASS | Pi screw 1 | M2 x 6: bites 3.0 mm |
| PASS | Pi screw 2 | M2 x 6: bites 3.0 mm |
| PASS | Pi screw 3 | M2 x 6: bites 3.0 mm |
| PASS | leg bus board screw 0 | M2.5 x 5: bites 2.5 mm |
| PASS | leg bus board screw 1 | M2.5 x 5: bites 2.5 mm |
| PASS | leg bus board screw 2 | M2.5 x 5: bites 2.5 mm |
| PASS | leg bus board screw 3 | M2.5 x 5: bites 2.5 mm |
| PASS | beak fork screw horn 0 | M2 x 6: bites 3.0 mm |
| PASS | beak fork screw horn 1 | M2 x 6: bites 3.0 mm |
| PASS | beak fork screw horn 2 | M2 x 6: bites 3.0 mm |
| PASS | beak fork screw horn 3 | M2 x 6: bites 3.0 mm |
| PASS | hood rear screw 0 | M2 x 8: bites 4.0 mm |
| PASS | hood rear screw 1 | M2 x 8: bites 4.0 mm |
| PASS | R hinge screw | M3 x 10: bites 4.3 mm |

## ACCESS

| status | item | detail |
|---|---|---|
| PASS | L hip pitch cradle screw rear face 0 |  |
| PASS | L hip pitch cradle screw rear face 1 |  |
| PASS | L knee cradle screw rear face 0 |  |
| PASS | L knee cradle screw rear face 1 |  |
| PASS | L hip pitch cradle screw near 0 |  |
| PASS | L hip pitch cradle screw near 1 |  |
| PASS | L hip pitch cradle screw horn face 0 |  |
| PASS | L hip pitch cradle screw horn face 1 |  |
| PASS | L knee cradle screw near 0 |  |
| PASS | L knee cradle screw near 1 |  |
| PASS | L knee cradle screw horn face 0 |  |
| PASS | L knee cradle screw horn face 1 |  |
| PASS | L thigh cover screw hip |  |
| PASS | L thigh cover screw knee |  |
| PASS | L ankle boss screw 0 |  |
| PASS | L ankle boss screw 1 |  |
| PASS | L ankle boss screw 2 |  |
| PASS | L ankle boss screw 3 |  |
| PASS | L ankle pitch cradle screw rear face 0 |  |
| PASS | L ankle pitch cradle screw rear face 1 |  |
| PASS | L shoe bottom screw 0 |  |
| PASS | L shoe bottom screw 1 |  |
| PASS | L knee fork screw horn 0 |  |
| PASS | L knee fork screw horn 1 |  |
| PASS | L knee fork screw horn 2 |  |
| PASS | L knee fork screw horn 3 |  |
| PASS | L ankle pitch fork screw horn 0 |  |
| PASS | L ankle pitch fork screw horn 1 |  |
| PASS | L ankle pitch fork screw horn 2 |  |
| PASS | L ankle pitch fork screw horn 3 |  |
| PASS | L ankle ear screw 0 |  |
| PASS | L ankle ear screw 1 |  |
| PASS | L hip pitch fork screw horn 0 |  |
| PASS | L hip pitch fork screw horn 1 |  |
| PASS | L hip pitch fork screw horn 2 |  |
| PASS | L hip pitch fork screw horn 3 |  |
| PASS | R hip pitch cradle screw rear face 0 |  |
| PASS | R hip pitch cradle screw rear face 1 |  |
| PASS | R knee cradle screw rear face 0 |  |
| PASS | R knee cradle screw rear face 1 |  |
| PASS | R hip pitch cradle screw near 0 |  |
| PASS | R hip pitch cradle screw near 1 |  |
| PASS | R hip pitch cradle screw horn face 0 |  |
| PASS | R hip pitch cradle screw horn face 1 |  |
| PASS | R knee cradle screw near 0 |  |
| PASS | R knee cradle screw near 1 |  |
| PASS | R knee cradle screw horn face 0 |  |
| PASS | R knee cradle screw horn face 1 |  |
| PASS | R thigh cover screw hip |  |
| PASS | R thigh cover screw knee |  |
| PASS | R ankle boss screw 0 |  |
| PASS | R ankle boss screw 1 |  |
| PASS | R ankle boss screw 2 |  |
| PASS | R ankle boss screw 3 |  |
| PASS | R ankle pitch cradle screw rear face 0 |  |
| PASS | R ankle pitch cradle screw rear face 1 |  |
| PASS | R shoe bottom screw 0 |  |
| PASS | R shoe bottom screw 1 |  |
| PASS | R knee fork screw horn 0 |  |
| PASS | R knee fork screw horn 1 |  |
| PASS | R knee fork screw horn 2 |  |
| PASS | R knee fork screw horn 3 |  |
| PASS | R ankle pitch fork screw horn 0 |  |
| PASS | R ankle pitch fork screw horn 1 |  |
| PASS | R ankle pitch fork screw horn 2 |  |
| PASS | R ankle pitch fork screw horn 3 |  |
| PASS | R ankle ear screw 0 |  |
| PASS | R ankle ear screw 1 |  |
| PASS | R hip pitch fork screw horn 0 |  |
| PASS | R hip pitch fork screw horn 1 |  |
| PASS | R hip pitch fork screw horn 2 |  |
| PASS | R hip pitch fork screw horn 3 |  |
| PASS | L hip yaw cradle screw rear face 0 |  |
| PASS | L hip yaw cradle screw rear face 1 |  |
| PASS | R hip yaw cradle screw rear face 0 |  |
| PASS | R hip yaw cradle screw rear face 1 |  |
| PASS | L hip yaw cradle screw near 0 |  |
| PASS | L hip yaw cradle screw near 1 |  |
| PASS | L hip yaw cradle screw horn face 0 |  |
| PASS | L hip yaw cradle screw horn face 1 |  |
| PASS | R hip yaw cradle screw near 0 |  |
| PASS | R hip yaw cradle screw near 1 |  |
| PASS | R hip yaw cradle screw horn face 0 |  |
| PASS | R hip yaw cradle screw horn face 1 |  |
| PASS | L hip yaw fork screw horn 0 |  |
| PASS | L hip yaw fork screw horn 1 |  |
| PASS | L hip yaw fork screw horn 2 |  |
| PASS | L hip yaw fork screw horn 3 |  |
| PASS | R hip yaw fork screw horn 0 |  |
| PASS | R hip yaw fork screw horn 1 |  |
| PASS | R hip yaw fork screw horn 2 |  |
| PASS | R hip yaw fork screw horn 3 |  |
| PASS | L hip roll cradle screw rear face 0 |  |
| PASS | L hip roll cradle screw rear face 1 |  |
| PASS | R hip roll cradle screw rear face 0 |  |
| PASS | R hip roll cradle screw rear face 1 |  |
| PASS | L hip roll cradle screw near 0 |  |
| PASS | L hip roll cradle screw near 1 |  |
| PASS | L hip roll cradle screw horn face 0 |  |
| PASS | L hip roll cradle screw horn face 1 |  |
| PASS | R hip roll cradle screw near 0 |  |
| PASS | R hip roll cradle screw near 1 |  |
| PASS | R hip roll cradle screw horn face 0 |  |
| PASS | R hip roll cradle screw horn face 1 |  |
| PASS | L hip roll fork screw horn 0 |  |
| PASS | L hip roll fork screw horn 1 |  |
| PASS | L hip roll fork screw horn 2 |  |
| PASS | L hip roll fork screw horn 3 |  |
| PASS | R hip roll fork screw horn 0 |  |
| PASS | R hip roll fork screw horn 1 |  |
| PASS | R hip roll fork screw horn 2 |  |
| PASS | R hip roll fork screw horn 3 |  |
| PASS | neck pitch cradle screw rear face 0 |  |
| PASS | neck pitch cradle screw rear face 1 |  |
| PASS | neck pitch cradle screw horn face 0 |  |
| PASS | neck pitch cradle screw horn face 1 |  |
| PASS | head pitch cradle screw rear face 0 |  |
| PASS | head pitch cradle screw rear face 1 |  |
| PASS | head pitch cradle screw horn face 0 |  |
| PASS | head pitch cradle screw horn face 1 |  |
| PASS | neck pitch fork screw horn 0 |  |
| PASS | neck pitch fork screw horn 1 |  |
| PASS | neck pitch fork screw horn 2 |  |
| PASS | neck pitch fork screw horn 3 |  |
| PASS | neck pitch fork screw rear 0 |  |
| PASS | neck pitch fork screw rear 1 |  |
| PASS | neck pitch fork screw rear 2 |  |
| PASS | neck pitch fork screw rear 3 |  |
| PASS | body screw 0 |  |
| PASS | body screw 1 |  |
| PASS | head yaw cradle screw rear face 0 |  |
| PASS | head yaw cradle screw rear face 1 |  |
| PASS | head yaw cradle screw rear near 0 |  |
| PASS | head yaw cradle screw rear near 1 |  |
| PASS | head yaw cradle screw horn face 0 |  |
| PASS | head yaw cradle screw horn face 1 |  |
| PASS | head yaw fork screw horn 0 |  |
| PASS | head yaw fork screw horn 1 |  |
| PASS | head yaw fork screw horn 2 |  |
| PASS | head yaw fork screw horn 3 |  |
| PASS | head roll cradle screw rear face 0 |  |
| PASS | head roll cradle screw rear face 1 |  |
| PASS | head roll cradle screw horn face 0 |  |
| PASS | head roll cradle screw horn face 1 |  |
| PASS | bus board rear screw 0 |  |
| PASS | bus board rear screw 1 |  |
| PASS | bus board rear screw 2 |  |
| PASS | bus board rear screw 3 |  |
| PASS | beak cradle screw rear face 0 |  |
| PASS | beak cradle screw rear face 1 |  |
| PASS | beak cradle screw rear near 0 |  |
| PASS | beak cradle screw rear near 1 |  |
| PASS | head pitch fork screw horn 0 |  |
| PASS | head pitch fork screw horn 1 |  |
| PASS | head pitch fork screw horn 2 |  |
| PASS | head pitch fork screw horn 3 |  |
| PASS | head pitch fork screw rear 0 |  |
| PASS | head pitch fork screw rear 1 |  |
| PASS | head pitch fork screw rear 2 |  |
| PASS | head pitch fork screw rear 3 |  |
| PASS | head roll fork screw horn 0 |  |
| PASS | head roll fork screw horn 1 |  |
| PASS | head roll fork screw horn 2 |  |
| PASS | head roll fork screw horn 3 |  |
| PASS | head roll fork screw rear 0 |  |
| PASS | head roll fork screw rear 1 |  |
| PASS | head roll fork screw rear 2 |  |
| PASS | head roll fork screw rear 3 |  |
| PASS | bus board top screw 0 |  |
| PASS | bus board top screw 1 |  |
| PASS | bus board top screw 2 |  |
| PASS | bus board top screw 3 |  |
| PASS | Pi screw 0 |  |
| PASS | Pi screw 1 |  |
| PASS | Pi screw 2 |  |
| PASS | Pi screw 3 |  |
| PASS | leg bus board screw 0 |  |
| PASS | leg bus board screw 1 |  |
| PASS | leg bus board screw 2 |  |
| PASS | leg bus board screw 3 |  |
| PASS | beak fork screw horn 0 |  |
| PASS | beak fork screw horn 1 |  |
| PASS | beak fork screw horn 2 |  |
| PASS | beak fork screw horn 3 |  |
| PASS | hood rear screw 0 |  |
| PASS | hood rear screw 1 |  |
| PASS | R hinge screw |  |

## HOLD

| status | item | detail |
|---|---|---|
| PASS | L hip yaw lid | 4 screws |
| PASS | L yaw bracket | 6 screws |
| PASS | L hip roll lid | 4 screws |
| PASS | L roll bracket | 8 screws |
| PASS | L thigh frame | 6 screws |
| PASS | L hip pitch lid | 4 screws |
| PASS | L knee lid | 4 screws |
| PASS | L thigh cover | 2 screws |
| PASS | L shin | 10 screws |
| PASS | L shoe | 8 screws |
| PASS | L sole | 2 screws |
| PASS | L inner ear | 2 screws |
| PASS | R hip yaw lid | 4 screws |
| PASS | R yaw bracket | 6 screws |
| PASS | R hip roll lid | 4 screws |
| PASS | R roll bracket | 8 screws |
| PASS | R thigh frame | 6 screws |
| PASS | R hip pitch lid | 4 screws |
| PASS | R knee lid | 4 screws |
| PASS | R thigh cover | 2 screws |
| PASS | R shin | 10 screws |
| PASS | R shoe | 8 screws |
| PASS | R sole | 2 screws |
| PASS | R inner ear | 2 screws |
| PASS | chassis | 14 screws |
| PASS | body shell | 2 screws |
| PASS | neck column | 4 screws |
| PASS | neck lid | 2 screws |
| PASS | head pitch lid | 2 screws |
| PASS | head fork | 12 screws |
| PASS | head yaw sheet | 2 screws |
| PASS | head yaw bracket | 6 screws |
| PASS | head roll lid | 2 screws |
| PASS | head roll spacer | 4 screws |
| PASS | head roll rear spacer | 4 screws |
| PASS | head frame | 27 screws |
| PASS | hood | 3 screws |
| PASS | jaw | turns on its screws |
| PASS | jaw soft insert | glued |
| PASS | mouth roof | glued |
| PASS | face | glued |
| PASS | eye ring | glued |
| PASS | eye iris | glued |

## APART

| status | item | detail |
|---|---|---|
| PASS | bought parts |  |
| PASS | L hip yaw cable plugs |  |
| PASS | R hip yaw cable plugs |  |
| PASS | L hip roll cable plugs |  |
| PASS | R hip roll cable plugs |  |
| PASS | L hip pitch cable plugs |  |
| PASS | L knee cable plugs |  |
| PASS | R hip pitch cable plugs |  |
| PASS | R knee cable plugs |  |
| PASS | L ankle pitch cable plugs |  |
| PASS | R ankle pitch cable plugs |  |
| PASS | neck pitch cable plugs + |  |
| PASS | neck pitch cable plugs - |  |
| PASS | head pitch cable plugs + |  |
| PASS | head pitch cable plugs - |  |
| PASS | head yaw cable plugs + |  |
| PASS | head yaw cable plugs - |  |
| PASS | head roll cable plugs + |  |
| PASS | head roll cable plugs - |  |
| PASS | bus board cable plugs servo |  |
| PASS | bus board cable plugs power |  |
| PASS | bus board cable plugs usb |  |
| PASS | beak cable plugs + |  |
| PASS | beak cable plugs - |  |

## ENDS

| status | item | detail |
|---|---|---|
| PASS | L hip yaw | 2 of 6 screws at the near end |
| PASS | R hip yaw | 2 of 6 screws at the near end |
| PASS | L hip roll | 2 of 6 screws at the near end |
| PASS | R hip roll | 2 of 6 screws at the near end |
| PASS | L hip pitch | 2 of 6 screws at the near end |
| PASS | R hip pitch | 2 of 6 screws at the near end |
| PASS | L knee | 2 of 6 screws at the near end |
| PASS | R knee | 2 of 6 screws at the near end |
| PASS | L ankle pitch | far end only: the rear idler is screwed to the same plate, so that end is held by it |
| PASS | R ankle pitch | far end only: the rear idler is screwed to the same plate, so that end is held by it |
| PASS | neck pitch | far end only: the fork turns over the near end, both faces |
| PASS | head pitch | far end only: the fork turns over the near end, both faces |
| PASS | head yaw | 2 of 6 screws at the near end |
| PASS | head roll | far end only: a bearing on both faces, and the fork round them |
| PASS | beak | 2 of 4 screws at the near end |

## BOUGHT

| status | item | detail |
|---|---|---|
| PASS | L hip yaw lid |  |
| PASS | L yaw bracket |  |
| PASS | L hip roll lid |  |
| PASS | L roll bracket |  |
| PASS | L thigh frame |  |
| PASS | L hip pitch lid |  |
| PASS | L knee lid |  |
| PASS | L thigh cover |  |
| PASS | L shin |  |
| PASS | L shoe |  |
| PASS | L sole |  |
| PASS | L inner ear |  |
| PASS | R hip yaw lid |  |
| PASS | R yaw bracket |  |
| PASS | R hip roll lid |  |
| PASS | R roll bracket |  |
| PASS | R thigh frame |  |
| PASS | R hip pitch lid |  |
| PASS | R knee lid |  |
| PASS | R thigh cover |  |
| PASS | R shin |  |
| PASS | R shoe |  |
| PASS | R sole |  |
| PASS | R inner ear |  |
| PASS | chassis |  |
| PASS | body shell |  |
| PASS | neck column |  |
| PASS | neck lid |  |
| PASS | head pitch lid |  |
| PASS | head fork |  |
| PASS | head yaw sheet |  |
| PASS | head yaw bracket |  |
| PASS | head roll lid |  |
| PASS | head roll spacer |  |
| PASS | head roll rear spacer |  |
| PASS | head frame |  |
| PASS | hood |  |
| PASS | jaw |  |
| PASS | jaw soft insert |  |
| PASS | mouth roof |  |
| PASS | face |  |
| PASS | eye ring |  |
| PASS | eye iris |  |

## COLOUR

| status | item | detail |
|---|---|---|
| PASS | L hip yaw lid |  |
| PASS | L yaw bracket |  |
| PASS | L hip roll lid |  |
| PASS | L roll bracket |  |
| PASS | L thigh frame |  |
| PASS | L hip pitch lid |  |
| PASS | L knee lid |  |
| PASS | L thigh cover |  |
| PASS | L shin |  |
| PASS | L shoe |  |
| PASS | L sole |  |
| PASS | L inner ear |  |
| PASS | R hip yaw lid |  |
| PASS | R yaw bracket |  |
| PASS | R hip roll lid |  |
| PASS | R roll bracket |  |
| PASS | R thigh frame |  |
| PASS | R hip pitch lid |  |
| PASS | R knee lid |  |
| PASS | R thigh cover |  |
| PASS | R shin |  |
| PASS | R shoe |  |
| PASS | R sole |  |
| PASS | R inner ear |  |
| PASS | chassis |  |
| PASS | body shell |  |
| PASS | neck column |  |
| PASS | neck lid |  |
| PASS | head pitch lid |  |
| PASS | head fork |  |
| PASS | head yaw sheet |  |
| PASS | head yaw bracket |  |
| PASS | head roll lid |  |
| PASS | head roll spacer |  |
| PASS | head roll rear spacer |  |
| PASS | head frame |  |
| PASS | hood |  |
| PASS | jaw |  |
| PASS | jaw soft insert |  |
| PASS | mouth roof |  |
| PASS | face |  |
| PASS | eye ring |  |
| PASS | eye iris |  |

## EDGE

| status | item | detail |
|---|---|---|
| PASS | body screw 0 |  |
| PASS | body screw 1 |  |
| PASS | L hip yaw cradle screw near 0 | 17 % of the ring runs into the bearing bore: under the race, watch it on the first print |
| PASS | L hip yaw cradle screw near 1 | 17 % of the ring runs into the bearing bore: under the race, watch it on the first print |
| PASS | L hip yaw cradle screw horn face 0 |  |
| PASS | L hip yaw cradle screw horn face 1 |  |
| PASS | L hip yaw cradle screw rear face 0 |  |
| PASS | L hip yaw cradle screw rear face 1 |  |
| PASS | R hip yaw cradle screw near 0 | 17 % of the ring runs into the bearing bore: under the race, watch it on the first print |
| PASS | R hip yaw cradle screw near 1 | 17 % of the ring runs into the bearing bore: under the race, watch it on the first print |
| PASS | R hip yaw cradle screw horn face 0 |  |
| PASS | R hip yaw cradle screw horn face 1 |  |
| PASS | R hip yaw cradle screw rear face 0 |  |
| PASS | R hip yaw cradle screw rear face 1 |  |
| PASS | neck pitch fork screw horn 0 |  |
| PASS | neck pitch fork screw horn 1 |  |
| PASS | neck pitch fork screw horn 2 |  |
| PASS | neck pitch fork screw horn 3 |  |
| PASS | neck pitch fork screw rear 0 |  |
| PASS | neck pitch fork screw rear 1 |  |
| PASS | neck pitch fork screw rear 2 |  |
| PASS | neck pitch fork screw rear 3 |  |
| PASS | L hip yaw fork screw horn 0 |  |
| PASS | L hip yaw fork screw horn 1 |  |
| PASS | L hip yaw fork screw horn 2 |  |
| PASS | L hip yaw fork screw horn 3 |  |
| PASS | L hip roll cradle screw near 0 | 17 % of the ring runs into the bearing bore: under the race, watch it on the first print |
| PASS | L hip roll cradle screw near 1 | 17 % of the ring runs into the bearing bore: under the race, watch it on the first print |
| PASS | L hip roll cradle screw horn face 0 |  |
| PASS | L hip roll cradle screw horn face 1 |  |
| PASS | L hip roll cradle screw rear face 0 |  |
| PASS | L hip roll cradle screw rear face 1 |  |
| PASS | R hip yaw fork screw horn 0 |  |
| PASS | R hip yaw fork screw horn 1 |  |
| PASS | R hip yaw fork screw horn 2 |  |
| PASS | R hip yaw fork screw horn 3 |  |
| PASS | R hip roll cradle screw near 0 | 17 % of the ring runs into the bearing bore: under the race, watch it on the first print |
| PASS | R hip roll cradle screw near 1 | 17 % of the ring runs into the bearing bore: under the race, watch it on the first print |
| PASS | R hip roll cradle screw horn face 0 |  |
| PASS | R hip roll cradle screw horn face 1 |  |
| PASS | R hip roll cradle screw rear face 0 |  |
| PASS | R hip roll cradle screw rear face 1 |  |
| PASS | L hip roll fork screw horn 0 |  |
| PASS | L hip roll fork screw horn 1 |  |
| PASS | L hip roll fork screw horn 2 |  |
| PASS | L hip roll fork screw horn 3 |  |
| PASS | L hip pitch fork screw horn 0 |  |
| PASS | L hip pitch fork screw horn 1 |  |
| PASS | L hip pitch fork screw horn 2 |  |
| PASS | L hip pitch fork screw horn 3 |  |
| PASS | R hip roll fork screw horn 0 |  |
| PASS | R hip roll fork screw horn 1 |  |
| PASS | R hip roll fork screw horn 2 |  |
| PASS | R hip roll fork screw horn 3 |  |
| PASS | R hip pitch fork screw horn 0 |  |
| PASS | R hip pitch fork screw horn 1 |  |
| PASS | R hip pitch fork screw horn 2 |  |
| PASS | R hip pitch fork screw horn 3 |  |
| PASS | L thigh cover screw hip |  |
| PASS | L thigh cover screw knee |  |
| PASS | L hip pitch cradle screw near 0 | 17 % of the ring runs into the bearing bore: under the race, watch it on the first print |
| PASS | L hip pitch cradle screw near 1 | 17 % of the ring runs into the bearing bore: under the race, watch it on the first print |
| PASS | L hip pitch cradle screw horn face 0 |  |
| PASS | L hip pitch cradle screw horn face 1 |  |
| PASS | L hip pitch cradle screw rear face 0 |  |
| PASS | L hip pitch cradle screw rear face 1 |  |
| PASS | L knee cradle screw near 0 | 17 % of the ring runs into the bearing bore: under the race, watch it on the first print |
| PASS | L knee cradle screw near 1 | 17 % of the ring runs into the bearing bore: under the race, watch it on the first print |
| PASS | L knee cradle screw horn face 0 |  |
| PASS | L knee cradle screw horn face 1 |  |
| PASS | L knee cradle screw rear face 0 |  |
| PASS | L knee cradle screw rear face 1 |  |
| PASS | R thigh cover screw hip |  |
| PASS | R thigh cover screw knee |  |
| PASS | R hip pitch cradle screw near 0 | 17 % of the ring runs into the bearing bore: under the race, watch it on the first print |
| PASS | R hip pitch cradle screw near 1 | 17 % of the ring runs into the bearing bore: under the race, watch it on the first print |
| PASS | R hip pitch cradle screw horn face 0 |  |
| PASS | R hip pitch cradle screw horn face 1 |  |
| PASS | R hip pitch cradle screw rear face 0 |  |
| PASS | R hip pitch cradle screw rear face 1 |  |
| PASS | R knee cradle screw near 0 | 17 % of the ring runs into the bearing bore: under the race, watch it on the first print |
| PASS | R knee cradle screw near 1 | 17 % of the ring runs into the bearing bore: under the race, watch it on the first print |
| PASS | R knee cradle screw horn face 0 |  |
| PASS | R knee cradle screw horn face 1 |  |
| PASS | R knee cradle screw rear face 0 |  |
| PASS | R knee cradle screw rear face 1 |  |
| PASS | L ankle boss screw 0 |  |
| PASS | L ankle boss screw 1 |  |
| PASS | L ankle boss screw 2 |  |
| PASS | L ankle boss screw 3 |  |
| PASS | L knee fork screw horn 0 |  |
| PASS | L knee fork screw horn 1 |  |
| PASS | L knee fork screw horn 2 |  |
| PASS | L knee fork screw horn 3 |  |
| PASS | L ankle pitch cradle screw rear face 0 |  |
| PASS | L ankle pitch cradle screw rear face 1 |  |
| PASS | R ankle boss screw 0 |  |
| PASS | R ankle boss screw 1 |  |
| PASS | R ankle boss screw 2 |  |
| PASS | R ankle boss screw 3 |  |
| PASS | R knee fork screw horn 0 |  |
| PASS | R knee fork screw horn 1 |  |
| PASS | R knee fork screw horn 2 |  |
| PASS | R knee fork screw horn 3 |  |
| PASS | R ankle pitch cradle screw rear face 0 |  |
| PASS | R ankle pitch cradle screw rear face 1 |  |
| PASS | L ankle ear screw 0 |  |
| PASS | L ankle ear screw 1 |  |
| PASS | L shoe bottom screw 0 |  |
| PASS | L shoe bottom screw 1 |  |
| PASS | L ankle pitch fork screw horn 0 |  |
| PASS | L ankle pitch fork screw horn 1 |  |
| PASS | L ankle pitch fork screw horn 2 |  |
| PASS | L ankle pitch fork screw horn 3 |  |
| PASS | R ankle ear screw 0 |  |
| PASS | R ankle ear screw 1 |  |
| PASS | R shoe bottom screw 0 |  |
| PASS | R shoe bottom screw 1 |  |
| PASS | R ankle pitch fork screw horn 0 |  |
| PASS | R ankle pitch fork screw horn 1 |  |
| PASS | R ankle pitch fork screw horn 2 |  |
| PASS | R ankle pitch fork screw horn 3 |  |
| PASS | neck pitch cradle screw horn face 0 |  |
| PASS | neck pitch cradle screw horn face 1 |  |
| PASS | neck pitch cradle screw rear face 0 |  |
| PASS | neck pitch cradle screw rear face 1 |  |
| PASS | head pitch cradle screw horn face 0 |  |
| PASS | head pitch cradle screw horn face 1 |  |
| PASS | head pitch cradle screw rear face 0 |  |
| PASS | head pitch cradle screw rear face 1 |  |
| PASS | head pitch fork screw horn 0 |  |
| PASS | head pitch fork screw horn 1 |  |
| PASS | head pitch fork screw horn 2 |  |
| PASS | head pitch fork screw horn 3 |  |
| PASS | head pitch fork screw rear 0 |  |
| PASS | head pitch fork screw rear 1 |  |
| PASS | head pitch fork screw rear 2 |  |
| PASS | head pitch fork screw rear 3 |  |
| PASS | head yaw cradle screw horn face 0 |  |
| PASS | head yaw cradle screw horn face 1 |  |
| PASS | head yaw cradle screw rear face 0 |  |
| PASS | head yaw cradle screw rear face 1 |  |
| PASS | head yaw cradle screw rear near 0 |  |
| PASS | head yaw cradle screw rear near 1 |  |
| PASS | head yaw fork screw horn 0 |  |
| PASS | head yaw fork screw horn 1 |  |
| PASS | head yaw fork screw horn 2 |  |
| PASS | head yaw fork screw horn 3 |  |
| PASS | head roll cradle screw horn face 0 |  |
| PASS | head roll cradle screw horn face 1 |  |
| PASS | head roll cradle screw rear face 0 |  |
| PASS | head roll cradle screw rear face 1 |  |
| PASS | bus board rear screw 0 |  |
| PASS | bus board rear screw 1 |  |
| PASS | bus board rear screw 2 |  |
| PASS | bus board rear screw 3 |  |
| PASS | hood rear screw 0 |  |
| PASS | hood rear screw 1 |  |
| PASS | head roll fork screw horn 0 |  |
| PASS | head roll fork screw horn 1 |  |
| PASS | head roll fork screw horn 2 |  |
| PASS | head roll fork screw horn 3 |  |
| PASS | head roll fork screw rear 0 |  |
| PASS | head roll fork screw rear 1 |  |
| PASS | head roll fork screw rear 2 |  |
| PASS | head roll fork screw rear 3 |  |
| PASS | beak cradle screw rear face 0 |  |
| PASS | beak cradle screw rear face 1 |  |
| PASS | beak cradle screw rear near 0 |  |
| PASS | beak cradle screw rear near 1 |  |
| PASS | beak fork screw horn 0 |  |
| PASS | beak fork screw horn 1 |  |
| PASS | beak fork screw horn 2 |  |
| PASS | beak fork screw horn 3 |  |

## PIERCE

| status | item | detail |
|---|---|---|
| PASS | servo pockets |  |

## SEAT

| status | item | detail |
|---|---|---|
| PASS | L hip yaw |  |
| PASS | R hip yaw |  |
| PASS | L hip roll |  |
| PASS | R hip roll |  |
| PASS | L hip pitch |  |
| PASS | R hip pitch |  |
| PASS | L knee |  |
| PASS | R knee |  |
| PASS | L ankle pitch |  |
| PASS | R ankle pitch |  |
| PASS | head yaw |  |
| PASS | head roll |  |

## ALL

| status | item | detail |
|---|---|---|
| PASS | part L hip yaw servo |  |
| PASS | part L hip yaw lid |  |
| PASS | part L hip yaw bearing |  |
| PASS | part L hip yaw horn |  |
| PASS | part L yaw bracket |  |
| PASS | part L hip roll servo |  |
| PASS | part L hip roll lid |  |
| PASS | part L hip roll bearing |  |
| PASS | part L hip roll horn |  |
| PASS | part L roll bracket |  |
| PASS | part L thigh frame |  |
| PASS | part L hip pitch servo |  |
| PASS | part L knee servo |  |
| PASS | part L hip pitch lid |  |
| PASS | part L knee lid |  |
| PASS | part L hip pitch bearing |  |
| PASS | part L knee bearing |  |
| PASS | part L hip pitch horn |  |
| PASS | part L knee horn |  |
| PASS | part L thigh cover |  |
| PASS | part L shin |  |
| PASS | part L ankle servo |  |
| PASS | part L ankle horn |  |
| PASS | part L ankle bearing inner |  |
| PASS | part L shoe |  |
| PASS | part L sole |  |
| PASS | part L inner ear |  |
| PASS | part R hip yaw servo |  |
| PASS | part R hip yaw lid |  |
| PASS | part R hip yaw bearing |  |
| PASS | part R hip yaw horn |  |
| PASS | part R yaw bracket |  |
| PASS | part R hip roll servo |  |
| PASS | part R hip roll lid |  |
| PASS | part R hip roll bearing |  |
| PASS | part R hip roll horn |  |
| PASS | part R roll bracket |  |
| PASS | part R thigh frame |  |
| PASS | part R hip pitch servo |  |
| PASS | part R knee servo |  |
| PASS | part R hip pitch lid |  |
| PASS | part R knee lid |  |
| PASS | part R hip pitch bearing |  |
| PASS | part R knee bearing |  |
| PASS | part R hip pitch horn |  |
| PASS | part R knee horn |  |
| PASS | part R thigh cover |  |
| PASS | part R shin |  |
| PASS | part R ankle servo |  |
| PASS | part R ankle horn |  |
| PASS | part R ankle bearing inner |  |
| PASS | part R shoe |  |
| PASS | part R sole |  |
| PASS | part R inner ear |  |
| PASS | part chassis |  |
| PASS | part battery |  |
| PASS | part L 5 V regulator |  |
| PASS | part head 5 V regulator |  |
| PASS | part IMU |  |
| PASS | part body shell |  |
| PASS | part neck servo |  |
| PASS | part neck column |  |
| PASS | part neck lid |  |
| PASS | part head pitch servo |  |
| PASS | part head pitch lid |  |
| PASS | part head fork |  |
| PASS | part head yaw servo |  |
| PASS | part head yaw sheet |  |
| PASS | part head yaw bearing |  |
| PASS | part head yaw horn |  |
| PASS | part head yaw bracket |  |
| PASS | part head roll servo |  |
| PASS | part head roll rear bearing |  |
| PASS | part head roll rear horn |  |
| PASS | part head roll lid |  |
| PASS | part head roll bearing |  |
| PASS | part head roll horn |  |
| PASS | part head roll spacer |  |
| PASS | part head roll rear spacer |  |
| PASS | part head frame |  |
| PASS | part beak servo |  |
| PASS | part Pi Zero 2 W |  |
| PASS | part camera |  |
| PASS | part Waveshare bus board |  |
| PASS | part bus board standoffs |  |
| PASS | part leg bus board |  |
| PASS | part leg bus splice |  |
| PASS | part hood |  |
| PASS | part jaw |  |
| PASS | part jaw soft insert |  |
| PASS | part mouth roof |  |
| PASS | part face |  |
| PASS | part eye ring |  |
| PASS | part eye iris |  |
