meetsitaram/duck-droids/reports/buildable.md

# Physical checks

From tools/buildable.py. LOAD is a beam estimate, not FEA: test prints decide.

84 checks: 84 pass, 0 warn, **0 fail**

## LOAD

| status | item | detail |
|---|---|---|
| PASS | shin, under the knee horn | 12.9 MPa (allowed 15): 47 N, section 180 mm2 |
| PASS | shin, at the cap | 0.4 MPa (allowed 15): 47 N, section 1255 mm2 |
| PASS | thigh, hip to knee | 0.5 MPa (allowed 15): 47 N, section 808 mm2 |
| PASS | roll bracket, side arm | 12.6 MPa (allowed 15): 47 N, section 90 mm2 |
| PASS | roll bracket, front plate | 11.4 MPa (allowed 15): 47 N, section 60 mm2 |
| PASS | yaw bracket | 1.3 MPa (allowed 15): 47 N, section 920 mm2 |

## ONE

| status | item | detail |
|---|---|---|
| PASS | L hip yaw lid |  |
| PASS | L yaw bracket |  |
| PASS | L hip roll lid |  |
| PASS | L roll bracket |  |
| PASS | L thigh frame |  |
| PASS | L hip pitch lid |  |
| PASS | L knee lid |  |
| PASS | L shin |  |
| PASS | L shoe |  |
| PASS | L sole |  |
| PASS | L inner ear |  |
| PASS | chassis |  |
| PASS | neck column |  |
| PASS | neck lid |  |
| PASS | head pitch lid |  |
| PASS | head fork |  |
| PASS | head yaw bracket |  |
| PASS | head roll lid |  |
| PASS | head roll spacer |  |
| PASS | head roll rear spacer |  |
| PASS | head frame |  |
| PASS | jaw |  |
| PASS | jaw soft insert |  |
| PASS | face |  |
| PASS | eye ring |  |
| PASS | eye iris |  |

## WALL

| status | item | detail |
|---|---|---|
| PASS | L hip yaw lid |  |
| PASS | L yaw bracket |  |
| PASS | L hip roll lid |  |
| PASS | L roll bracket |  |
| PASS | L thigh frame |  |
| PASS | L hip pitch lid |  |
| PASS | L knee lid |  |
| PASS | L shin |  |
| PASS | L shoe |  |
| PASS | L sole |  |
| PASS | L inner ear |  |
| PASS | chassis |  |
| PASS | neck column |  |
| PASS | neck lid |  |
| PASS | head pitch lid |  |
| PASS | head fork |  |
| PASS | head yaw bracket |  |
| PASS | head roll lid |  |
| PASS | head roll spacer |  |
| PASS | head roll rear spacer |  |
| PASS | head frame |  |
| PASS | jaw |  |
| PASS | jaw soft insert |  |
| PASS | face |  |
| PASS | eye ring |  |
| PASS | eye iris |  |

## FIT

| status | item | detail |
|---|---|---|
| PASS | L hip yaw lid | 52 x 32 x 4 mm |
| PASS | L yaw bracket | 42 x 31 x 63 mm |
| PASS | L hip roll lid | 4 x 32 x 52 mm |
| PASS | L roll bracket | 39 x 37 x 24 mm |
| PASS | L thigh frame | 82 x 47 x 62 mm |
| PASS | L hip pitch lid | 52 x 4 x 32 mm |
| PASS | L knee lid | 32 x 4 x 52 mm |
| PASS | L shin | 32 x 43 x 80 mm |
| PASS | L shoe | 70 x 54 x 30 mm |
| PASS | L sole | 70 x 54 x 16 mm |
| PASS | L inner ear | 50 x 5 x 30 mm |
| PASS | chassis | 98 x 70 x 50 mm |
| PASS | neck column | 27 x 29 x 30 mm |
| PASS | neck lid | 27 x 4 x 6 mm |
| PASS | head pitch lid | 27 x 4 x 6 mm |
| PASS | head fork | 38 x 40 x 56 mm |
| PASS | head yaw bracket | 30 x 41 x 30 mm |
| PASS | head roll lid | 4 x 38 x 27 mm |
| PASS | head roll spacer | 3 x 17 x 17 mm |
| PASS | head roll rear spacer | 3 x 17 x 17 mm |
| PASS | head frame | 148 x 106 x 61 mm |
| PASS | jaw | 92 x 111 x 45 mm |
| PASS | jaw soft insert | 29 x 106 x 6 mm |
| PASS | face | 5 x 104 x 53 mm |
| PASS | eye ring | 12 x 36 x 36 mm |
| PASS | eye iris | 10 x 22 x 22 mm |
