meetsitaram/duck-droids/reports/dynamixel/printable.md

# Physical checks

From tools/printable.py. Overhang from faces, not a slicer: none of this has been printed.

359 checks: 349 pass, 10 warn, **0 fail**

## ORIENT

| status | item | detail |
|---|---|---|
| PASS | L hip yaw lid | 0 mm2 overhang, 561 mm2 on the bed, 3 mm tall |
| PASS | L yaw bracket | 241 mm2 overhang, 250 mm2 on the bed, 23 mm tall |
| PASS | L roll bracket | 209 mm2 overhang, 209 mm2 on the bed, 19 mm tall |
| PASS | L thigh frame | 2118 mm2 overhang, 89 mm2 on the bed, 34 mm tall |
| PASS | L hip pitch lid | 0 mm2 overhang, 561 mm2 on the bed, 3 mm tall |
| PASS | L knee lid | 0 mm2 overhang, 540 mm2 on the bed, 3 mm tall |
| PASS | L thigh cover | 0 mm2 overhang, 2900 mm2 on the bed, 34 mm tall |
| PASS | L shin | 399 mm2 overhang, 133 mm2 on the bed, 23 mm tall |
| PASS | L shoe | 89 mm2 overhang, 1902 mm2 on the bed, 26 mm tall |
| PASS | L sole | 0 mm2 overhang, 2362 mm2 on the bed, 12 mm tall |
| PASS | R hip yaw lid | 0 mm2 overhang, 561 mm2 on the bed, 3 mm tall |
| PASS | R yaw bracket | 241 mm2 overhang, 250 mm2 on the bed, 23 mm tall |
| PASS | R roll bracket | 194 mm2 overhang, 209 mm2 on the bed, 19 mm tall |
| PASS | R thigh frame | 2118 mm2 overhang, 89 mm2 on the bed, 34 mm tall |
| PASS | R hip pitch lid | 0 mm2 overhang, 561 mm2 on the bed, 3 mm tall |
| PASS | R knee lid | 0 mm2 overhang, 540 mm2 on the bed, 3 mm tall |
| PASS | R thigh cover | 0 mm2 overhang, 2900 mm2 on the bed, 34 mm tall |
| PASS | R shin | 399 mm2 overhang, 133 mm2 on the bed, 23 mm tall |
| PASS | R shoe | 89 mm2 overhang, 1902 mm2 on the bed, 26 mm tall |
| PASS | R sole | 0 mm2 overhang, 2362 mm2 on the bed, 12 mm tall |
| PASS | chassis | 983 mm2 overhang, 241 mm2 on the bed, 73 mm tall |
| PASS | body shell | 1460 mm2 overhang, 879 mm2 on the bed, 98 mm tall |
| PASS | neck column | 198 mm2 overhang, 89 mm2 on the bed, 27 mm tall |
| PASS | neck lid | 0 mm2 overhang, 73 mm2 on the bed, 3 mm tall |
| PASS | head pitch lid | 1 mm2 overhang, 73 mm2 on the bed, 2 mm tall |
| PASS | head fork | 416 mm2 overhang, 389 mm2 on the bed, 45 mm tall |
| PASS | head yaw sheet | 0 mm2 overhang, 539 mm2 on the bed, 4 mm tall |
| PASS | head yaw bracket | 223 mm2 overhang, 451 mm2 on the bed, 41 mm tall |
| PASS | head roll lid | 0 mm2 overhang, 561 mm2 on the bed, 3 mm tall |
| PASS | head roll spacer | 0 mm2 overhang, 171 mm2 on the bed, 2 mm tall |
| PASS | head roll rear spacer | 0 mm2 overhang, 203 mm2 on the bed, 2 mm tall |
| PASS | head frame | 5467 mm2 overhang, 300 mm2 on the bed, 141 mm tall |
| PASS | hood | 3059 mm2 overhang, 276 mm2 on the bed, 150 mm tall |
| PASS | jaw | 900 mm2 overhang, 1084 mm2 on the bed, 88 mm tall |
| PASS | jaw soft insert | 0 mm2 overhang, 2661 mm2 on the bed, 5 mm tall |
| PASS | mouth roof | 15 mm2 overhang, 3935 mm2 on the bed, 3 mm tall |
| PASS | face | 40 mm2 overhang, 4167 mm2 on the bed, 3 mm tall |
| PASS | eye ring | 0 mm2 overhang, 822 mm2 on the bed, 11 mm tall |
| PASS | eye iris | 0 mm2 overhang, 207 mm2 on the bed, 9 mm tall |

## PIECES

| status | item | detail |
|---|---|---|
| PASS | L hip yaw lid |  |
| PASS | L yaw bracket |  |
| PASS | L roll bracket |  |
| PASS | L thigh frame |  |
| PASS | L hip pitch lid |  |
| PASS | L knee lid |  |
| PASS | L thigh cover |  |
| PASS | L shin |  |
| PASS | L shoe |  |
| PASS | L sole |  |
| PASS | R hip yaw lid |  |
| PASS | R yaw bracket |  |
| PASS | R roll bracket |  |
| PASS | R thigh frame |  |
| PASS | R hip pitch lid |  |
| PASS | R knee lid |  |
| PASS | R thigh cover |  |
| PASS | R shin |  |
| PASS | R shoe |  |
| PASS | R sole |  |
| PASS | chassis |  |
| PASS | body shell |  |
| PASS | neck column |  |
| PASS | neck lid |  |
| PASS | head pitch lid |  |
| PASS | head fork |  |
| PASS | head yaw sheet |  |
| PASS | head yaw bracket |  |
| PASS | head roll lid |  |
| PASS | head roll spacer |  |
| PASS | head roll rear spacer |  |
| PASS | head frame |  |
| PASS | hood |  |
| PASS | jaw |  |
| PASS | jaw soft insert |  |
| PASS | mouth roof |  |
| PASS | face |  |
| PASS | eye ring |  |
| PASS | eye iris |  |

## BED

| status | item | detail |
|---|---|---|
| PASS | L hip yaw lid | 37 x 26 x 3 mm, 561 mm2 on the bed |
| PASS | L yaw bracket | 15 x 28 x 23 mm, 250 mm2 on the bed |
| PASS | L roll bracket | 35 x 31 x 19 mm, 209 mm2 on the bed |
| PASS | L thigh frame | 51 x 66 x 34 mm, 89 mm2 on the bed |
| PASS | L hip pitch lid | 26 x 37 x 3 mm, 561 mm2 on the bed |
| PASS | L knee lid | 38 x 26 x 3 mm, 540 mm2 on the bed |
| PASS | L thigh cover | 55 x 70 x 34 mm, 2900 mm2 on the bed |
| PASS | L shin | 38 x 32 x 23 mm, 133 mm2 on the bed |
| PASS | L shoe | 58 x 44 x 26 mm, 1902 mm2 on the bed |
| PASS | L sole | 58 x 44 x 12 mm, 2362 mm2 on the bed |
| PASS | R hip yaw lid | 37 x 26 x 3 mm, 561 mm2 on the bed |
| PASS | R yaw bracket | 15 x 28 x 23 mm, 250 mm2 on the bed |
| PASS | R roll bracket | 35 x 31 x 19 mm, 209 mm2 on the bed |
| PASS | R thigh frame | 51 x 66 x 34 mm, 89 mm2 on the bed |
| PASS | R hip pitch lid | 26 x 37 x 3 mm, 561 mm2 on the bed |
| PASS | R knee lid | 38 x 26 x 3 mm, 540 mm2 on the bed |
| PASS | R thigh cover | 55 x 70 x 34 mm, 2900 mm2 on the bed |
| PASS | R shin | 38 x 32 x 23 mm, 133 mm2 on the bed |
| PASS | R shoe | 58 x 44 x 26 mm, 1902 mm2 on the bed |
| PASS | R sole | 58 x 44 x 12 mm, 2362 mm2 on the bed |
| PASS | chassis | 45 x 53 x 73 mm, 241 mm2 on the bed |
| PASS | body shell | 38 x 74 x 98 mm, 879 mm2 on the bed |
| PASS | neck column | 26 x 28 x 27 mm, 89 mm2 on the bed |
| PASS | neck lid | 5 x 26 x 3 mm, 73 mm2 on the bed |
| PASS | head pitch lid | 5 x 26 x 2 mm, 73 mm2 on the bed |
| PASS | head fork | 55 x 39 x 45 mm, 389 mm2 on the bed |
| PASS | head yaw sheet | 37 x 26 x 4 mm, 539 mm2 on the bed |
| PASS | head yaw bracket | 29 x 29 x 41 mm, 451 mm2 on the bed |
| PASS | head roll lid | 26 x 37 x 3 mm, 561 mm2 on the bed |
| PASS | head roll spacer | 17 x 17 x 2 mm, 171 mm2 on the bed |
| PASS | head roll rear spacer | 17 x 17 x 2 mm, 203 mm2 on the bed |
| PASS | head frame | 60 x 101 x 141 mm, 300 mm2 on the bed |
| PASS | hood | 58 x 106 x 150 mm, 276 mm2 on the bed |
| PASS | jaw | 42 x 106 x 88 mm, 1084 mm2 on the bed |
| PASS | jaw soft insert | 27 x 101 x 5 mm, 2661 mm2 on the bed |
| PASS | mouth roof | 40 x 101 x 3 mm, 3935 mm2 on the bed |
| PASS | face | 50 x 99 x 3 mm, 4167 mm2 on the bed |
| PASS | eye ring | 34 x 34 x 11 mm, 822 mm2 on the bed |
| PASS | eye iris | 20 x 20 x 9 mm, 207 mm2 on the bed |

## HOLES

| status | item | detail |
|---|---|---|
| PASS | L hip yaw lid |  |
| PASS | L yaw bracket |  |
| PASS | L roll bracket |  |
| PASS | L thigh frame |  |
| PASS | L hip pitch lid |  |
| PASS | L knee lid |  |
| PASS | L thigh cover |  |
| PASS | L shin |  |
| PASS | L shoe |  |
| PASS | L sole |  |
| PASS | R hip yaw lid |  |
| PASS | R yaw bracket |  |
| PASS | R roll bracket |  |
| PASS | R thigh frame |  |
| PASS | R hip pitch lid |  |
| PASS | R knee lid |  |
| PASS | R thigh cover |  |
| PASS | R shin |  |
| PASS | R shoe |  |
| PASS | R sole |  |
| PASS | chassis |  |
| PASS | body shell |  |
| PASS | neck column |  |
| PASS | neck lid |  |
| PASS | head pitch lid |  |
| PASS | head fork |  |
| PASS | head yaw sheet |  |
| PASS | head yaw bracket |  |
| PASS | head roll lid |  |
| PASS | head roll spacer |  |
| PASS | head roll rear spacer |  |
| PASS | head frame |  |
| PASS | hood |  |
| PASS | jaw |  |
| PASS | jaw soft insert |  |
| PASS | mouth roof |  |
| PASS | face |  |
| PASS | eye ring |  |
| PASS | eye iris |  |

## SUPPORT

| status | item | detail |
|---|---|---|
| WARN | L thigh frame | 2118 mm2 needs support or a bridge: check it in the slicer |
| WARN | L shin | 399 mm2 needs support or a bridge: check it in the slicer |
| WARN | R thigh frame | 2118 mm2 needs support or a bridge: check it in the slicer |
| WARN | R shin | 399 mm2 needs support or a bridge: check it in the slicer |
| WARN | chassis | 983 mm2 needs support or a bridge: check it in the slicer |
| WARN | body shell | 1460 mm2 needs support or a bridge: check it in the slicer |
| WARN | head fork | 416 mm2 needs support or a bridge: check it in the slicer |
| WARN | head frame | 5467 mm2 needs support or a bridge: check it in the slicer |
| WARN | hood | 3059 mm2 needs support or a bridge: check it in the slicer |
| WARN | jaw | 900 mm2 needs support or a bridge: check it in the slicer |

## SKIN

| status | item | detail |
|---|---|---|
| PASS | L thigh cover | 2 screws drill it: ['L thigh cover screw hip', 'L thigh cover screw knee'] |
| PASS | R thigh cover | 2 screws drill it: ['R thigh cover screw hip', 'R thigh cover screw knee'] |
| PASS | body shell | 2 screws drill it: ['body screw 0', 'body screw 1'] |
| PASS | hood | 3 screws drill it: ['R hinge screw', 'hood rear screw 0', 'hood rear screw 1'] |
| PASS | mouth roof | 0 screws drill it: [] |

## MATE

| status | item | detail |
|---|---|---|
| PASS | parts that share a link | 39 parts: 0 clashes |

## HEADS

| status | item | detail |
|---|---|---|
| PASS | body screw 0 |  |
| PASS | body screw 1 |  |
| PASS | L hip yaw cradle screw horn face 0 |  |
| PASS | L hip yaw cradle screw horn face 1 |  |
| PASS | L hip yaw cradle screw rear face 0 |  |
| PASS | L hip yaw cradle screw rear face 1 |  |
| PASS | L hip yaw cradle screw rear near 0 |  |
| PASS | L hip yaw cradle screw rear near 1 |  |
| PASS | R hip yaw cradle screw horn face 0 |  |
| PASS | R hip yaw cradle screw horn face 1 |  |
| PASS | R hip yaw cradle screw rear face 0 |  |
| PASS | R hip yaw cradle screw rear face 1 |  |
| PASS | R hip yaw cradle screw rear near 0 |  |
| PASS | R hip yaw cradle screw rear near 1 |  |
| PASS | neck pitch fork screw horn 0 |  |
| PASS | neck pitch fork screw horn 1 |  |
| PASS | neck pitch fork screw horn 2 |  |
| PASS | neck pitch fork screw horn 3 |  |
| PASS | neck pitch fork screw rear 0 |  |
| PASS | neck pitch fork screw rear 1 |  |
| PASS | neck pitch fork screw rear 2 |  |
| PASS | neck pitch fork screw rear 3 |  |
| PASS | L hip roll cradle screw near h0 |  |
| PASS | L hip roll cradle screw near h1 |  |
| PASS | L hip roll cradle screw near r0 |  |
| PASS | L hip roll cradle screw near r1 |  |
| PASS | L hip yaw fork screw horn 0 |  |
| PASS | L hip yaw fork screw horn 1 |  |
| PASS | L hip yaw fork screw horn 2 |  |
| PASS | L hip yaw fork screw horn 3 |  |
| PASS | R hip roll cradle screw near h0 |  |
| PASS | R hip roll cradle screw near h1 |  |
| PASS | R hip roll cradle screw near r0 |  |
| PASS | R hip roll cradle screw near r1 |  |
| PASS | R hip yaw fork screw horn 0 |  |
| PASS | R hip yaw fork screw horn 1 |  |
| PASS | R hip yaw fork screw horn 2 |  |
| PASS | R hip yaw fork screw horn 3 |  |
| PASS | L hip roll fork screw horn 0 |  |
| PASS | L hip roll fork screw horn 1 |  |
| PASS | L hip roll fork screw horn 2 |  |
| PASS | L hip roll fork screw horn 3 |  |
| PASS | L hip roll fork screw rear 0 |  |
| PASS | L hip roll fork screw rear 1 |  |
| PASS | L hip roll fork screw rear 2 |  |
| PASS | L hip roll fork screw rear 3 |  |
| PASS | L hip pitch fork screw horn 0 |  |
| PASS | L hip pitch fork screw horn 1 |  |
| PASS | L hip pitch fork screw horn 2 |  |
| PASS | L hip pitch fork screw horn 3 |  |
| PASS | R hip roll fork screw horn 0 |  |
| PASS | R hip roll fork screw horn 1 |  |
| PASS | R hip roll fork screw horn 2 |  |
| PASS | R hip roll fork screw horn 3 |  |
| PASS | R hip roll fork screw rear 0 |  |
| PASS | R hip roll fork screw rear 1 |  |
| PASS | R hip roll fork screw rear 2 |  |
| PASS | R hip roll fork screw rear 3 |  |
| PASS | R hip pitch fork screw horn 0 |  |
| PASS | R hip pitch fork screw horn 1 |  |
| PASS | R hip pitch fork screw horn 2 |  |
| PASS | R hip pitch fork screw horn 3 |  |
| PASS | L thigh cover screw hip |  |
| PASS | L thigh cover screw knee |  |
| PASS | L hip pitch cradle screw horn face 0 |  |
| PASS | L hip pitch cradle screw horn face 1 |  |
| PASS | L hip pitch cradle screw rear face 0 |  |
| PASS | L hip pitch cradle screw rear face 1 |  |
| PASS | L hip pitch cradle screw rear near 0 |  |
| PASS | L hip pitch cradle screw rear near 1 |  |
| PASS | L knee cradle screw horn face 0 |  |
| PASS | L knee cradle screw horn face 1 |  |
| PASS | L knee cradle screw rear face 0 |  |
| PASS | L knee cradle screw rear face 1 |  |
| PASS | L knee cradle screw rear near 0 |  |
| PASS | L knee cradle screw rear near 1 |  |
| PASS | R thigh cover screw hip |  |
| PASS | R thigh cover screw knee |  |
| PASS | R hip pitch cradle screw horn face 0 |  |
| PASS | R hip pitch cradle screw horn face 1 |  |
| PASS | R hip pitch cradle screw rear face 0 |  |
| PASS | R hip pitch cradle screw rear face 1 |  |
| PASS | R hip pitch cradle screw rear near 0 |  |
| PASS | R hip pitch cradle screw rear near 1 |  |
| PASS | R knee cradle screw horn face 0 |  |
| PASS | R knee cradle screw horn face 1 |  |
| PASS | R knee cradle screw rear face 0 |  |
| PASS | R knee cradle screw rear face 1 |  |
| PASS | R knee cradle screw rear near 0 |  |
| PASS | R knee cradle screw rear near 1 |  |
| PASS | L shin arm screw 0 |  |
| PASS | L shin arm screw 1 |  |
| PASS | L knee fork screw horn 0 |  |
| PASS | L knee fork screw horn 1 |  |
| PASS | L knee fork screw horn 2 |  |
| PASS | L knee fork screw horn 3 |  |
| PASS | L ankle pitch cradle screw rear face 0 |  |
| PASS | L ankle pitch cradle screw rear face 1 |  |
| PASS | R shin arm screw 0 |  |
| PASS | R shin arm screw 1 |  |
| PASS | R knee fork screw horn 0 |  |
| PASS | R knee fork screw horn 1 |  |
| PASS | R knee fork screw horn 2 |  |
| PASS | R knee fork screw horn 3 |  |
| PASS | R ankle pitch cradle screw rear face 0 |  |
| PASS | R ankle pitch cradle screw rear face 1 |  |
| PASS | L ankle ear screw 0 |  |
| PASS | L ankle ear screw 1 |  |
| PASS | L ankle ear screw 2 |  |
| PASS | L ankle ear screw 3 |  |
| PASS | L shoe bottom screw 0 |  |
| PASS | L shoe bottom screw 1 |  |
| PASS | L ankle pitch fork screw horn 0 |  |
| PASS | L ankle pitch fork screw horn 1 |  |
| PASS | L ankle pitch fork screw horn 2 |  |
| PASS | L ankle pitch fork screw horn 3 |  |
| PASS | R ankle ear screw 0 |  |
| PASS | R ankle ear screw 1 |  |
| PASS | R ankle ear screw 2 |  |
| PASS | R ankle ear screw 3 |  |
| PASS | R shoe bottom screw 0 |  |
| PASS | R shoe bottom screw 1 |  |
| PASS | R ankle pitch fork screw horn 0 |  |
| PASS | R ankle pitch fork screw horn 1 |  |
| PASS | R ankle pitch fork screw horn 2 |  |
| PASS | R ankle pitch fork screw horn 3 |  |
| PASS | neck pitch cradle screw horn face 0 |  |
| PASS | neck pitch cradle screw horn face 1 |  |
| PASS | neck pitch cradle screw rear face 0 |  |
| PASS | neck pitch cradle screw rear face 1 |  |
| PASS | head pitch cradle screw horn face 0 |  |
| PASS | head pitch cradle screw horn face 1 |  |
| PASS | head pitch cradle screw rear face 0 |  |
| PASS | head pitch cradle screw rear face 1 |  |
| PASS | head pitch fork screw horn 0 |  |
| PASS | head pitch fork screw horn 1 |  |
| PASS | head pitch fork screw horn 2 |  |
| PASS | head pitch fork screw horn 3 |  |
| PASS | head pitch fork screw rear 0 |  |
| PASS | head pitch fork screw rear 1 |  |
| PASS | head pitch fork screw rear 2 |  |
| PASS | head pitch fork screw rear 3 |  |
| PASS | head yaw cradle screw horn face 0 |  |
| PASS | head yaw cradle screw horn face 1 |  |
| PASS | head yaw cradle screw rear face 0 |  |
| PASS | head yaw cradle screw rear face 1 |  |
| PASS | head yaw cradle screw rear near 0 |  |
| PASS | head yaw cradle screw rear near 1 |  |
| PASS | head yaw fork screw horn 0 |  |
| PASS | head yaw fork screw horn 1 |  |
| PASS | head yaw fork screw horn 2 |  |
| PASS | head yaw fork screw horn 3 |  |
| PASS | head roll cradle screw horn face 0 |  |
| PASS | head roll cradle screw horn face 1 |  |
| PASS | head roll cradle screw rear face 0 |  |
| PASS | head roll cradle screw rear face 1 |  |
| PASS | R hinge screw |  |
| PASS | Pi screw 0 |  |
| PASS | Pi screw 1 |  |
| PASS | Pi screw 2 |  |
| PASS | Pi screw 3 |  |
| PASS | bus board top screw 0 |  |
| PASS | bus board rear screw 0 |  |
| PASS | bus board top screw 1 |  |
| PASS | bus board rear screw 1 |  |
| PASS | bus board top screw 2 |  |
| PASS | bus board rear screw 2 |  |
| PASS | bus board top screw 3 |  |
| PASS | bus board rear screw 3 |  |
| PASS | hood rear screw 0 |  |
| PASS | hood rear screw 1 |  |
| PASS | head roll fork screw horn 0 |  |
| PASS | head roll fork screw horn 1 |  |
| PASS | head roll fork screw horn 2 |  |
| PASS | head roll fork screw horn 3 |  |
| PASS | head roll fork screw rear 0 |  |
| PASS | head roll fork screw rear 1 |  |
| PASS | head roll fork screw rear 2 |  |
| PASS | head roll fork screw rear 3 |  |
| PASS | beak cradle screw rear face 0 |  |
| PASS | beak cradle screw rear face 1 |  |
| PASS | beak cradle screw rear near 0 |  |
| PASS | beak cradle screw rear near 1 |  |
| PASS | beak fork screw horn 0 |  |
| PASS | beak fork screw horn 1 |  |
| PASS | beak fork screw horn 2 |  |
| PASS | beak fork screw horn 3 |  |
