meetsitaram/duck-droids/docs/nano/ASSEMBLY.md

# How to build the nano duck

Generated by `tools/nano_docs.py` from the order in `spec/nano_duck.py`, which `tools/assembly.py` checks: every part has a straight way in, every screw a key's reach and a bite. The right leg is the left's mirror. Set each servo to mid-range (1500 us) before its horn goes on. Parts: [BOM.md](BOM.md); wiring: [WIRING.md](WIRING.md).

## The left thigh

1. The thigh (L thigh)
2. Hip pitch servo in from its open side, its lead out along the slot (L hip pitch servo)
3. Its ear clamp on the ears, the 2 screws from its bag (L hip pitch ear clamp)
4. Knee servo in from its open side, its lead out along the slot (L knee servo)
5. Its ear clamp on the ears, the 2 screws from its bag (L knee ear clamp)

## The left shin

1. The shin (L shin)
2. Ankle servo in from its open side, its lead out along the slot (L ankle pitch servo)
3. Its ear clamp on the ears, the 2 screws from its bag (L ankle pitch ear clamp)

## The left leg

On: thigh_L.

1. The shin onto the knee spline, servo at mid-range; the horn screw (shin_L (built above))
2. The rear arm over the stub, the bushing pressed in through it from outside; 2 screws into the bar (L knee rear arm, L knee bushing)
3. The foot onto the ankle spline; the horn screw (L foot)
4. The rear arm over the stub, the bushing pressed in through it from outside; 2 screws into the bar (L ankle pitch rear arm, L ankle pitch bushing)
5. The TPU sole, glued under the foot (L sole)
6. The roll bracket onto the hip pitch spline; the horn screw (L roll bracket)
7. The rear arm over the stub, the bushing pressed in through it from outside; 2 screws into the bar (L hip pitch rear arm, L hip pitch bushing)

## The right thigh

1. The thigh (R thigh)
2. Hip pitch servo in from its open side, its lead out along the slot (R hip pitch servo)
3. Its ear clamp on the ears, the 2 screws from its bag (R hip pitch ear clamp)
4. Knee servo in from its open side, its lead out along the slot (R knee servo)
5. Its ear clamp on the ears, the 2 screws from its bag (R knee ear clamp)

## The right shin

1. The shin (R shin)
2. Ankle servo in from its open side, its lead out along the slot (R ankle pitch servo)
3. Its ear clamp on the ears, the 2 screws from its bag (R ankle pitch ear clamp)

## The right leg

On: thigh_R.

1. The shin onto the knee spline, servo at mid-range; the horn screw (shin_R (built above))
2. The rear arm over the stub, the bushing pressed in through it from outside; 2 screws into the bar (R knee rear arm, R knee bushing)
3. The foot onto the ankle spline; the horn screw (R foot)
4. The rear arm over the stub, the bushing pressed in through it from outside; 2 screws into the bar (R ankle pitch rear arm, R ankle pitch bushing)
5. The TPU sole, glued under the foot (R sole)
6. The roll bracket onto the hip pitch spline; the horn screw (R roll bracket)
7. The rear arm over the stub, the bushing pressed in through it from outside; 2 screws into the bar (R hip pitch rear arm, R hip pitch bushing)

## The chassis, its servos and electronics

1. The chassis (chassis)
2. Left hip yaw servo in from its open side, its lead out along the slot (L hip yaw servo)
3. Its ear clamp on the ears, the 2 screws from its bag (L hip yaw ear clamp)
4. Right hip yaw servo in from its open side, its lead out along the slot (R hip yaw servo)
5. Its ear clamp on the ears, the 2 screws from its bag (R hip yaw ear clamp)
6. Neck servo in from its open side, its lead out along the slot (neck pitch servo)
7. Its ear clamp on the ears, the 2 screws from its bag (neck pitch ear clamp)
8. The Pi up between the yaw servos, taped to its rail along its top edge, its 13 signal wires and power soldered first (Pi Zero 2 W)
9. The battery into its tray from the side, a strap round both (battery)
10. The 5 V regulators onto the shelf from the sides, foam tape (L 5 V regulator, R 5 V regulator)
11. The servo header board on them, foam tape (servo header board)
12. The IMU on the spine, foam tape (IMU)

## The hip yaw links and roll servos

On: body.

1. The yaw link up onto the yaw spline, servo at mid-range; the horn screw from below (L yaw link)
2. The rear arm over the stub, the bushing pressed in through it from outside; 2 screws into the bar (L hip yaw rear arm, L hip yaw bushing)
3. Hip roll servo in from its open side, its lead out along the slot (L hip roll servo)
4. Its ear clamp on the ears, the 2 screws from its bag (L hip roll ear clamp)
5. The yaw link up onto the yaw spline, servo at mid-range; the horn screw from below (R yaw link)
6. The rear arm over the stub, the bushing pressed in through it from outside; 2 screws into the bar (R hip yaw rear arm, R hip yaw bushing)
7. Hip roll servo in from its open side, its lead out along the slot (R hip roll servo)
8. Its ear clamp on the ears, the 2 screws from its bag (R hip roll ear clamp)

## The legs onto the hips

On: hips.

1. The leg onto the roll spline, servo at mid-range; the horn screw (leg_L (built above))
2. The rear arm over the stub, the bushing pressed in through it from outside; 2 screws into the bar (L hip roll rear arm, L hip roll bushing)
3. The leg onto the roll spline, servo at mid-range; the horn screw (leg_R (built above))
4. The rear arm over the stub, the bushing pressed in through it from outside; 2 screws into the bar (R hip roll rear arm, R hip roll bushing)

## The body shell

On: legs.

1. The body shell down over the chassis, 2 screws from behind (body shell)

## The head

1. The head frame (head frame)
2. Head pitch servo in from its open side, its lead out along the slot (head pitch servo)
3. Its ear clamp on the ears, the 2 screws from its bag (head pitch ear clamp)
4. Beak servo in from its open side, its lead out along the slot (beak servo)
5. Its ear clamp on the ears, the 2 screws from its bag (beak ear clamp)
6. The jaw onto the beak spline, shut; the horn screw (jaw)

## Neck and head

On: shell.

1. The neck plate onto the neck spline, servo at mid-range; the horn screw (neck plate)
2. The head onto the head pitch spline, from the side; the horn screw (headbench (built above))
3. The hood down onto the head plate, 2 screws up into its posts (hood)
4. The upper bill, glued to the hood (upper bill)
