meetsitaram/duck-droids/reports/nano/assembly.md

# Physical checks

From tools/assembly.py

564 checks: 564 pass, 0 warn, **0 fail**

## PATH

| status | item | detail |
|---|---|---|
| PASS | thigh_L: L hip pitch servo |  |
| PASS | thigh_L: L hip pitch ear clamp |  |
| PASS | thigh_L: L knee servo |  |
| PASS | thigh_L: L knee ear clamp |  |
| PASS | shin_L: L ankle pitch servo |  |
| PASS | shin_L: L ankle pitch ear clamp |  |
| PASS | leg_L: @shin_L |  |
| PASS | leg_L: L knee rear arm |  |
| PASS | leg_L: L knee bushing |  |
| PASS | leg_L: L foot |  |
| PASS | leg_L: L ankle pitch rear arm |  |
| PASS | leg_L: L ankle pitch bushing |  |
| PASS | leg_L: L sole |  |
| PASS | leg_L: L roll bracket |  |
| PASS | leg_L: L hip pitch rear arm |  |
| PASS | leg_L: L hip pitch bushing |  |
| PASS | thigh_R: R hip pitch servo |  |
| PASS | thigh_R: R hip pitch ear clamp |  |
| PASS | thigh_R: R knee servo |  |
| PASS | thigh_R: R knee ear clamp |  |
| PASS | shin_R: R ankle pitch servo |  |
| PASS | shin_R: R ankle pitch ear clamp |  |
| PASS | leg_R: @shin_R |  |
| PASS | leg_R: R knee rear arm |  |
| PASS | leg_R: R knee bushing |  |
| PASS | leg_R: R foot |  |
| PASS | leg_R: R ankle pitch rear arm |  |
| PASS | leg_R: R ankle pitch bushing |  |
| PASS | leg_R: R sole |  |
| PASS | leg_R: R roll bracket |  |
| PASS | leg_R: R hip pitch rear arm |  |
| PASS | leg_R: R hip pitch bushing |  |
| PASS | body: L hip yaw servo |  |
| PASS | body: L hip yaw ear clamp |  |
| PASS | body: R hip yaw servo |  |
| PASS | body: R hip yaw ear clamp |  |
| PASS | body: neck pitch servo |  |
| PASS | body: neck pitch ear clamp |  |
| PASS | body: Pi Zero 2 W |  |
| PASS | body: battery |  |
| PASS | body: L 5 V regulator |  |
| PASS | body: R 5 V regulator |  |
| PASS | body: servo header board |  |
| PASS | body: IMU |  |
| PASS | hips: L yaw link |  |
| PASS | hips: L hip yaw rear arm |  |
| PASS | hips: L hip yaw bushing |  |
| PASS | hips: L hip roll servo |  |
| PASS | hips: L hip roll ear clamp |  |
| PASS | hips: R yaw link |  |
| PASS | hips: R hip yaw rear arm |  |
| PASS | hips: R hip yaw bushing |  |
| PASS | hips: R hip roll servo |  |
| PASS | hips: R hip roll ear clamp |  |
| PASS | legs: @leg_L |  |
| PASS | legs: L hip roll rear arm |  |
| PASS | legs: L hip roll bushing |  |
| PASS | legs: @leg_R |  |
| PASS | legs: R hip roll rear arm |  |
| PASS | legs: R hip roll bushing |  |
| PASS | shell: body shell |  |
| PASS | headbench: head pitch servo |  |
| PASS | headbench: head pitch ear clamp |  |
| PASS | headbench: beak servo |  |
| PASS | headbench: beak ear clamp |  |
| PASS | headbench: jaw |  |
| PASS | neckhead: neck plate |  |
| PASS | neckhead: @headbench |  |
| PASS | neckhead: hood |  |
| PASS | neckhead: upper bill |  |

## HELD

| status | item | detail |
|---|---|---|
| PASS | L hip pitch cradle screw near |  |
| PASS | L hip pitch cradle screw far |  |
| PASS | L knee cradle screw near |  |
| PASS | L knee cradle screw far |  |
| PASS | L ankle pitch cradle screw near |  |
| PASS | L ankle pitch cradle screw far |  |
| PASS | L knee horn screw |  |
| PASS | L knee rear screw 0 |  |
| PASS | L knee rear screw 1 |  |
| PASS | L ankle pitch horn screw |  |
| PASS | L ankle pitch rear screw 0 |  |
| PASS | L ankle pitch rear screw 1 |  |
| PASS | L hip pitch horn screw |  |
| PASS | L hip pitch rear screw 0 |  |
| PASS | L hip pitch rear screw 1 |  |
| PASS | R hip pitch cradle screw near |  |
| PASS | R hip pitch cradle screw far |  |
| PASS | R knee cradle screw near |  |
| PASS | R knee cradle screw far |  |
| PASS | R ankle pitch cradle screw near |  |
| PASS | R ankle pitch cradle screw far |  |
| PASS | R knee horn screw |  |
| PASS | R knee rear screw 0 |  |
| PASS | R knee rear screw 1 |  |
| PASS | R ankle pitch horn screw |  |
| PASS | R ankle pitch rear screw 0 |  |
| PASS | R ankle pitch rear screw 1 |  |
| PASS | R hip pitch horn screw |  |
| PASS | R hip pitch rear screw 0 |  |
| PASS | R hip pitch rear screw 1 |  |
| PASS | L hip yaw cradle screw near |  |
| PASS | L hip yaw cradle screw far |  |
| PASS | R hip yaw cradle screw near |  |
| PASS | R hip yaw cradle screw far |  |
| PASS | neck pitch cradle screw near |  |
| PASS | neck pitch cradle screw far |  |
| PASS | L hip yaw horn screw |  |
| PASS | L hip yaw rear screw 0 |  |
| PASS | L hip yaw rear screw 1 |  |
| PASS | L hip roll cradle screw near |  |
| PASS | L hip roll cradle screw far |  |
| PASS | R hip yaw horn screw |  |
| PASS | R hip yaw rear screw 0 |  |
| PASS | R hip yaw rear screw 1 |  |
| PASS | R hip roll cradle screw near |  |
| PASS | R hip roll cradle screw far |  |
| PASS | L hip roll horn screw |  |
| PASS | L hip roll rear screw 0 |  |
| PASS | L hip roll rear screw 1 |  |
| PASS | R hip roll horn screw |  |
| PASS | R hip roll rear screw 0 |  |
| PASS | R hip roll rear screw 1 |  |
| PASS | body screw 0 |  |
| PASS | body screw 1 |  |
| PASS | head pitch cradle screw near |  |
| PASS | head pitch cradle screw far |  |
| PASS | beak cradle screw near |  |
| PASS | beak cradle screw far |  |
| PASS | beak horn screw |  |
| PASS | neck pitch horn screw |  |
| PASS | head pitch horn screw |  |
| PASS | hood screw 0 |  |
| PASS | hood screw 1 |  |

## THREAD

| status | item | detail |
|---|---|---|
| PASS | L hip pitch cradle screw near | M2 x 8: bites 4.0 mm |
| PASS | L hip pitch cradle screw far | M2 x 8: bites 4.0 mm |
| PASS | L knee cradle screw near | M2 x 8: bites 4.0 mm |
| PASS | L knee cradle screw far | M2 x 8: bites 4.0 mm |
| PASS | L ankle pitch cradle screw near | M2 x 8: bites 4.0 mm |
| PASS | L ankle pitch cradle screw far | M2 x 8: bites 4.0 mm |
| PASS | L knee horn screw | M2 x 5: bites 2.5 mm |
| PASS | L knee rear screw 0 | M2 x 8: bites 4.0 mm |
| PASS | L knee rear screw 1 | M2 x 8: bites 4.0 mm |
| PASS | L ankle pitch horn screw | M2 x 5: bites 2.5 mm |
| PASS | L ankle pitch rear screw 0 | M2 x 8: bites 4.0 mm |
| PASS | L ankle pitch rear screw 1 | M2 x 8: bites 4.0 mm |
| PASS | L hip pitch horn screw | M2 x 5: bites 2.5 mm |
| PASS | L hip pitch rear screw 0 | M2 x 8: bites 4.0 mm |
| PASS | L hip pitch rear screw 1 | M2 x 8: bites 4.0 mm |
| PASS | R hip pitch cradle screw near | M2 x 8: bites 4.0 mm |
| PASS | R hip pitch cradle screw far | M2 x 8: bites 4.0 mm |
| PASS | R knee cradle screw near | M2 x 8: bites 4.0 mm |
| PASS | R knee cradle screw far | M2 x 8: bites 4.0 mm |
| PASS | R ankle pitch cradle screw near | M2 x 8: bites 4.0 mm |
| PASS | R ankle pitch cradle screw far | M2 x 8: bites 4.0 mm |
| PASS | R knee horn screw | M2 x 5: bites 2.5 mm |
| PASS | R knee rear screw 0 | M2 x 8: bites 4.0 mm |
| PASS | R knee rear screw 1 | M2 x 8: bites 4.0 mm |
| PASS | R ankle pitch horn screw | M2 x 5: bites 2.5 mm |
| PASS | R ankle pitch rear screw 0 | M2 x 8: bites 4.0 mm |
| PASS | R ankle pitch rear screw 1 | M2 x 8: bites 4.0 mm |
| PASS | R hip pitch horn screw | M2 x 5: bites 2.5 mm |
| PASS | R hip pitch rear screw 0 | M2 x 8: bites 4.0 mm |
| PASS | R hip pitch rear screw 1 | M2 x 8: bites 4.0 mm |
| PASS | L hip yaw cradle screw near | M2 x 8: bites 4.0 mm |
| PASS | L hip yaw cradle screw far | M2 x 8: bites 4.0 mm |
| PASS | R hip yaw cradle screw near | M2 x 8: bites 4.0 mm |
| PASS | R hip yaw cradle screw far | M2 x 8: bites 4.0 mm |
| PASS | neck pitch cradle screw near | M2 x 8: bites 4.0 mm |
| PASS | neck pitch cradle screw far | M2 x 8: bites 4.0 mm |
| PASS | L hip yaw horn screw | M2 x 5: bites 2.5 mm |
| PASS | L hip yaw rear screw 0 | M2 x 8: bites 4.0 mm |
| PASS | L hip yaw rear screw 1 | M2 x 8: bites 4.0 mm |
| PASS | L hip roll cradle screw near | M2 x 8: bites 4.0 mm |
| PASS | L hip roll cradle screw far | M2 x 8: bites 4.0 mm |
| PASS | R hip yaw horn screw | M2 x 5: bites 2.5 mm |
| PASS | R hip yaw rear screw 0 | M2 x 8: bites 4.0 mm |
| PASS | R hip yaw rear screw 1 | M2 x 8: bites 4.0 mm |
| PASS | R hip roll cradle screw near | M2 x 8: bites 4.0 mm |
| PASS | R hip roll cradle screw far | M2 x 8: bites 4.0 mm |
| PASS | L hip roll horn screw | M2 x 5: bites 2.5 mm |
| PASS | L hip roll rear screw 0 | M2 x 8: bites 4.0 mm |
| PASS | L hip roll rear screw 1 | M2 x 8: bites 4.0 mm |
| PASS | R hip roll horn screw | M2 x 5: bites 2.5 mm |
| PASS | R hip roll rear screw 0 | M2 x 8: bites 4.0 mm |
| PASS | R hip roll rear screw 1 | M2 x 8: bites 4.0 mm |
| PASS | body screw 0 | M2 x 6: bites 3.0 mm |
| PASS | body screw 1 | M2 x 6: bites 3.0 mm |
| PASS | head pitch cradle screw near | M2 x 8: bites 4.0 mm |
| PASS | head pitch cradle screw far | M2 x 8: bites 4.0 mm |
| PASS | beak cradle screw near | M2 x 8: bites 4.0 mm |
| PASS | beak cradle screw far | M2 x 8: bites 4.0 mm |
| PASS | beak horn screw | M2 x 5: bites 2.5 mm |
| PASS | neck pitch horn screw | M2 x 5: bites 2.5 mm |
| PASS | head pitch horn screw | M2 x 5: bites 2.5 mm |
| PASS | hood screw 0 | M2 x 6: bites 3.0 mm |
| PASS | hood screw 1 | M2 x 6: bites 3.0 mm |

## ACCESS

| status | item | detail |
|---|---|---|
| PASS | L hip pitch cradle screw near |  |
| PASS | L hip pitch cradle screw far |  |
| PASS | L knee cradle screw near |  |
| PASS | L knee cradle screw far |  |
| PASS | L ankle pitch cradle screw near |  |
| PASS | L ankle pitch cradle screw far |  |
| PASS | L knee horn screw |  |
| PASS | L knee rear screw 0 |  |
| PASS | L knee rear screw 1 |  |
| PASS | L ankle pitch horn screw |  |
| PASS | L ankle pitch rear screw 0 |  |
| PASS | L ankle pitch rear screw 1 |  |
| PASS | L hip pitch horn screw |  |
| PASS | L hip pitch rear screw 0 |  |
| PASS | L hip pitch rear screw 1 |  |
| PASS | R hip pitch cradle screw near |  |
| PASS | R hip pitch cradle screw far |  |
| PASS | R knee cradle screw near |  |
| PASS | R knee cradle screw far |  |
| PASS | R ankle pitch cradle screw near |  |
| PASS | R ankle pitch cradle screw far |  |
| PASS | R knee horn screw |  |
| PASS | R knee rear screw 0 |  |
| PASS | R knee rear screw 1 |  |
| PASS | R ankle pitch horn screw |  |
| PASS | R ankle pitch rear screw 0 |  |
| PASS | R ankle pitch rear screw 1 |  |
| PASS | R hip pitch horn screw |  |
| PASS | R hip pitch rear screw 0 |  |
| PASS | R hip pitch rear screw 1 |  |
| PASS | L hip yaw cradle screw near |  |
| PASS | L hip yaw cradle screw far |  |
| PASS | R hip yaw cradle screw near |  |
| PASS | R hip yaw cradle screw far |  |
| PASS | neck pitch cradle screw near |  |
| PASS | neck pitch cradle screw far |  |
| PASS | L hip yaw horn screw |  |
| PASS | L hip yaw rear screw 0 |  |
| PASS | L hip yaw rear screw 1 |  |
| PASS | L hip roll cradle screw near |  |
| PASS | L hip roll cradle screw far |  |
| PASS | R hip yaw horn screw |  |
| PASS | R hip yaw rear screw 0 |  |
| PASS | R hip yaw rear screw 1 |  |
| PASS | R hip roll cradle screw near |  |
| PASS | R hip roll cradle screw far |  |
| PASS | L hip roll horn screw |  |
| PASS | L hip roll rear screw 0 |  |
| PASS | L hip roll rear screw 1 |  |
| PASS | R hip roll horn screw |  |
| PASS | R hip roll rear screw 0 |  |
| PASS | R hip roll rear screw 1 |  |
| PASS | body screw 0 |  |
| PASS | body screw 1 |  |
| PASS | head pitch cradle screw near |  |
| PASS | head pitch cradle screw far |  |
| PASS | beak cradle screw near |  |
| PASS | beak cradle screw far |  |
| PASS | beak horn screw |  |
| PASS | neck pitch horn screw |  |
| PASS | head pitch horn screw |  |
| PASS | hood screw 0 |  |
| PASS | hood screw 1 |  |

## HOLD

| status | item | detail |
|---|---|---|
| PASS | L ankle pitch ear clamp | 2 screws |
| PASS | R ankle pitch ear clamp | 2 screws |
| PASS | L shin | 5 screws |
| PASS | R shin | 5 screws |
| PASS | L foot | 3 screws |
| PASS | R foot | 3 screws |
| PASS | L ankle pitch rear arm | 2 screws |
| PASS | R ankle pitch rear arm | 2 screws |
| PASS | L ankle pitch bushing | glued |
| PASS | R ankle pitch bushing | glued |
| PASS | L knee ear clamp | 2 screws |
| PASS | R knee ear clamp | 2 screws |
| PASS | L thigh | 4 screws |
| PASS | R thigh | 4 screws |
| PASS | L knee rear arm | 2 screws |
| PASS | R knee rear arm | 2 screws |
| PASS | L knee bushing | glued |
| PASS | R knee bushing | glued |
| PASS | L hip pitch ear clamp | 2 screws |
| PASS | R hip pitch ear clamp | 2 screws |
| PASS | L roll bracket | 6 screws |
| PASS | R roll bracket | 6 screws |
| PASS | L hip pitch rear arm | 2 screws |
| PASS | R hip pitch rear arm | 2 screws |
| PASS | L hip pitch bushing | glued |
| PASS | R hip pitch bushing | glued |
| PASS | L hip roll ear clamp | 2 screws |
| PASS | R hip roll ear clamp | 2 screws |
| PASS | L yaw link | 5 screws |
| PASS | R yaw link | 5 screws |
| PASS | L hip roll rear arm | 2 screws |
| PASS | R hip roll rear arm | 2 screws |
| PASS | L hip roll bushing | glued |
| PASS | R hip roll bushing | glued |
| PASS | L hip yaw ear clamp | 2 screws |
| PASS | R hip yaw ear clamp | 2 screws |
| PASS | chassis | 8 screws |
| PASS | L hip yaw rear arm | 2 screws |
| PASS | R hip yaw rear arm | 2 screws |
| PASS | L hip yaw bushing | glued |
| PASS | R hip yaw bushing | glued |
| PASS | L sole | glued |
| PASS | R sole | glued |
| PASS | neck pitch ear clamp | 2 screws |
| PASS | neck plate | 2 screws |
| PASS | head pitch ear clamp | 2 screws |
| PASS | head frame | 6 screws |
| PASS | beak ear clamp | 2 screws |
| PASS | jaw | turns on its screws |
| PASS | upper bill | glued |
| PASS | body shell | 2 screws |
| PASS | hood | 2 screws |

## APART

| status | item | detail |
|---|---|---|
| PASS | bought parts |  |

## ENDS

| status | item | detail |
|---|---|---|
| PASS | L ankle pitch | 1 of 2 screws at the near end |
| PASS | R ankle pitch | 1 of 2 screws at the near end |
| PASS | L knee | 1 of 2 screws at the near end |
| PASS | R knee | 1 of 2 screws at the near end |
| PASS | L hip pitch | 1 of 2 screws at the near end |
| PASS | R hip pitch | 1 of 2 screws at the near end |
| PASS | L hip roll | 1 of 2 screws at the near end |
| PASS | R hip roll | 1 of 2 screws at the near end |
| PASS | L hip yaw | 1 of 2 screws at the near end |
| PASS | R hip yaw | 1 of 2 screws at the near end |
| PASS | neck pitch | 1 of 2 screws at the near end |
| PASS | head pitch | 1 of 2 screws at the near end |
| PASS | beak | 1 of 2 screws at the near end |

## BOUGHT

| status | item | detail |
|---|---|---|
| PASS | L ankle pitch ear clamp |  |
| PASS | R ankle pitch ear clamp |  |
| PASS | L shin |  |
| PASS | R shin |  |
| PASS | L foot |  |
| PASS | R foot |  |
| PASS | L ankle pitch rear arm |  |
| PASS | R ankle pitch rear arm |  |
| PASS | L ankle pitch bushing |  |
| PASS | R ankle pitch bushing |  |
| PASS | L knee ear clamp |  |
| PASS | R knee ear clamp |  |
| PASS | L thigh |  |
| PASS | R thigh |  |
| PASS | L knee rear arm |  |
| PASS | R knee rear arm |  |
| PASS | L knee bushing |  |
| PASS | R knee bushing |  |
| PASS | L hip pitch ear clamp |  |
| PASS | R hip pitch ear clamp |  |
| PASS | L roll bracket |  |
| PASS | R roll bracket |  |
| PASS | L hip pitch rear arm |  |
| PASS | R hip pitch rear arm |  |
| PASS | L hip pitch bushing |  |
| PASS | R hip pitch bushing |  |
| PASS | L hip roll ear clamp |  |
| PASS | R hip roll ear clamp |  |
| PASS | L yaw link |  |
| PASS | R yaw link |  |
| PASS | L hip roll rear arm |  |
| PASS | R hip roll rear arm |  |
| PASS | L hip roll bushing |  |
| PASS | R hip roll bushing |  |
| PASS | L hip yaw ear clamp |  |
| PASS | R hip yaw ear clamp |  |
| PASS | chassis |  |
| PASS | L hip yaw rear arm |  |
| PASS | R hip yaw rear arm |  |
| PASS | L hip yaw bushing |  |
| PASS | R hip yaw bushing |  |
| PASS | L sole |  |
| PASS | R sole |  |
| PASS | neck pitch ear clamp |  |
| PASS | neck plate |  |
| PASS | head pitch ear clamp |  |
| PASS | head frame |  |
| PASS | beak ear clamp |  |
| PASS | jaw |  |
| PASS | upper bill |  |
| PASS | body shell |  |
| PASS | hood |  |

## COLOUR

| status | item | detail |
|---|---|---|
| PASS | L ankle pitch ear clamp |  |
| PASS | R ankle pitch ear clamp |  |
| PASS | L shin |  |
| PASS | R shin |  |
| PASS | L foot |  |
| PASS | R foot |  |
| PASS | L ankle pitch rear arm |  |
| PASS | R ankle pitch rear arm |  |
| PASS | L ankle pitch bushing |  |
| PASS | R ankle pitch bushing |  |
| PASS | L knee ear clamp |  |
| PASS | R knee ear clamp |  |
| PASS | L thigh |  |
| PASS | R thigh |  |
| PASS | L knee rear arm |  |
| PASS | R knee rear arm |  |
| PASS | L knee bushing |  |
| PASS | R knee bushing |  |
| PASS | L hip pitch ear clamp |  |
| PASS | R hip pitch ear clamp |  |
| PASS | L roll bracket |  |
| PASS | R roll bracket |  |
| PASS | L hip pitch rear arm |  |
| PASS | R hip pitch rear arm |  |
| PASS | L hip pitch bushing |  |
| PASS | R hip pitch bushing |  |
| PASS | L hip roll ear clamp |  |
| PASS | R hip roll ear clamp |  |
| PASS | L yaw link |  |
| PASS | R yaw link |  |
| PASS | L hip roll rear arm |  |
| PASS | R hip roll rear arm |  |
| PASS | L hip roll bushing |  |
| PASS | R hip roll bushing |  |
| PASS | L hip yaw ear clamp |  |
| PASS | R hip yaw ear clamp |  |
| PASS | chassis |  |
| PASS | L hip yaw rear arm |  |
| PASS | R hip yaw rear arm |  |
| PASS | L hip yaw bushing |  |
| PASS | R hip yaw bushing |  |
| PASS | L sole |  |
| PASS | R sole |  |
| PASS | neck pitch ear clamp |  |
| PASS | neck plate |  |
| PASS | head pitch ear clamp |  |
| PASS | head frame |  |
| PASS | beak ear clamp |  |
| PASS | jaw |  |
| PASS | upper bill |  |
| PASS | body shell |  |
| PASS | hood |  |

## EDGE

| status | item | detail |
|---|---|---|
| PASS | L ankle pitch cradle screw near |  |
| PASS | L ankle pitch cradle screw far |  |
| PASS | L knee horn screw |  |
| PASS | L knee rear screw 0 |  |
| PASS | L knee rear screw 1 |  |
| PASS | R ankle pitch cradle screw near |  |
| PASS | R ankle pitch cradle screw far |  |
| PASS | R knee horn screw |  |
| PASS | R knee rear screw 0 |  |
| PASS | R knee rear screw 1 |  |
| PASS | L ankle pitch horn screw |  |
| PASS | L ankle pitch rear screw 0 |  |
| PASS | L ankle pitch rear screw 1 |  |
| PASS | R ankle pitch horn screw |  |
| PASS | R ankle pitch rear screw 0 |  |
| PASS | R ankle pitch rear screw 1 |  |
| PASS | L knee cradle screw near |  |
| PASS | L knee cradle screw far |  |
| PASS | L hip pitch cradle screw near |  |
| PASS | L hip pitch cradle screw far |  |
| PASS | R knee cradle screw near |  |
| PASS | R knee cradle screw far |  |
| PASS | R hip pitch cradle screw near |  |
| PASS | R hip pitch cradle screw far |  |
| PASS | L hip pitch horn screw |  |
| PASS | L hip pitch rear screw 0 |  |
| PASS | L hip pitch rear screw 1 |  |
| PASS | L hip roll horn screw |  |
| PASS | L hip roll rear screw 0 |  |
| PASS | L hip roll rear screw 1 |  |
| PASS | R hip pitch horn screw |  |
| PASS | R hip pitch rear screw 0 |  |
| PASS | R hip pitch rear screw 1 |  |
| PASS | R hip roll horn screw |  |
| PASS | R hip roll rear screw 0 |  |
| PASS | R hip roll rear screw 1 |  |
| PASS | L hip roll cradle screw near |  |
| PASS | L hip roll cradle screw far |  |
| PASS | L hip yaw horn screw |  |
| PASS | L hip yaw rear screw 0 |  |
| PASS | L hip yaw rear screw 1 |  |
| PASS | R hip roll cradle screw near |  |
| PASS | R hip roll cradle screw far |  |
| PASS | R hip yaw horn screw |  |
| PASS | R hip yaw rear screw 0 |  |
| PASS | R hip yaw rear screw 1 |  |
| PASS | L hip yaw cradle screw near |  |
| PASS | L hip yaw cradle screw far |  |
| PASS | neck pitch cradle screw near |  |
| PASS | neck pitch cradle screw far |  |
| PASS | body screw 0 |  |
| PASS | body screw 1 |  |
| PASS | R hip yaw cradle screw near |  |
| PASS | R hip yaw cradle screw far |  |
| PASS | neck pitch horn screw |  |
| PASS | head pitch horn screw |  |
| PASS | head pitch cradle screw near |  |
| PASS | head pitch cradle screw far |  |
| PASS | beak cradle screw near |  |
| PASS | beak cradle screw far |  |
| PASS | hood screw 0 |  |
| PASS | hood screw 1 |  |
| PASS | beak horn screw |  |

## PIERCE

| status | item | detail |
|---|---|---|
| PASS | servo pockets |  |

## ALL

| status | item | detail |
|---|---|---|
| PASS | part L ankle pitch servo |  |
| PASS | part R ankle pitch servo |  |
| PASS | part L ankle pitch ear clamp |  |
| PASS | part R ankle pitch ear clamp |  |
| PASS | part L shin |  |
| PASS | part R shin |  |
| PASS | part L foot |  |
| PASS | part R foot |  |
| PASS | part L ankle pitch rear arm |  |
| PASS | part R ankle pitch rear arm |  |
| PASS | part L ankle pitch bushing |  |
| PASS | part R ankle pitch bushing |  |
| PASS | part L knee servo |  |
| PASS | part R knee servo |  |
| PASS | part L knee ear clamp |  |
| PASS | part R knee ear clamp |  |
| PASS | part L thigh |  |
| PASS | part R thigh |  |
| PASS | part L knee rear arm |  |
| PASS | part R knee rear arm |  |
| PASS | part L knee bushing |  |
| PASS | part R knee bushing |  |
| PASS | part L hip pitch servo |  |
| PASS | part R hip pitch servo |  |
| PASS | part L hip pitch ear clamp |  |
| PASS | part R hip pitch ear clamp |  |
| PASS | part L roll bracket |  |
| PASS | part R roll bracket |  |
| PASS | part L hip pitch rear arm |  |
| PASS | part R hip pitch rear arm |  |
| PASS | part L hip pitch bushing |  |
| PASS | part R hip pitch bushing |  |
| PASS | part L hip roll servo |  |
| PASS | part R hip roll servo |  |
| PASS | part L hip roll ear clamp |  |
| PASS | part R hip roll ear clamp |  |
| PASS | part L yaw link |  |
| PASS | part R yaw link |  |
| PASS | part L hip roll rear arm |  |
| PASS | part R hip roll rear arm |  |
| PASS | part L hip roll bushing |  |
| PASS | part R hip roll bushing |  |
| PASS | part L hip yaw servo |  |
| PASS | part R hip yaw servo |  |
| PASS | part L hip yaw ear clamp |  |
| PASS | part R hip yaw ear clamp |  |
| PASS | part chassis |  |
| PASS | part L hip yaw rear arm |  |
| PASS | part R hip yaw rear arm |  |
| PASS | part L hip yaw bushing |  |
| PASS | part R hip yaw bushing |  |
| PASS | part L sole |  |
| PASS | part R sole |  |
| PASS | part neck pitch servo |  |
| PASS | part neck pitch ear clamp |  |
| PASS | part neck plate |  |
| PASS | part head pitch servo |  |
| PASS | part head pitch ear clamp |  |
| PASS | part head frame |  |
| PASS | part beak servo |  |
| PASS | part beak ear clamp |  |
| PASS | part jaw |  |
| PASS | part Pi Zero 2 W |  |
| PASS | part battery |  |
| PASS | part L 5 V regulator |  |
| PASS | part R 5 V regulator |  |
| PASS | part servo header board |  |
| PASS | part IMU |  |
| PASS | part upper bill |  |
| PASS | part body shell |  |
| PASS | part hood |  |
