meetsitaram/duck-droids/reports/nano/buildable.md

# Physical checks

From tools/buildable.py. LOAD is a beam estimate, not FEA: test prints decide.

94 checks: 94 pass, 0 warn, **0 fail**

## LOAD

| status | item | detail |
|---|---|---|
| PASS | shin spine | 2.8 MPa (allowed 15): 10 N, section 130 mm2 |
| PASS | shin, the knee bar | 0.1 MPa (allowed 15): 10 N, section 423 mm2 |
| PASS | foot, the hub arm | 11.0 MPa (allowed 15): 10 N, section 67 mm2 |
| PASS | thigh web | 1.2 MPa (allowed 15): 10 N, section 175 mm2 |
| PASS | roll bracket, the hip bar | 6.7 MPa (allowed 15): 10 N, section 32 mm2 |
| PASS | roll bracket, the post | 5.7 MPa (allowed 15): 10 N, section 106 mm2 |
| PASS | yaw link, the bar | 11.3 MPa (allowed 15): 10 N, section 48 mm2 |

## ONE

| status | item | detail |
|---|---|---|
| PASS | L ankle pitch ear clamp |  |
| PASS | L shin |  |
| PASS | L foot |  |
| PASS | L ankle pitch rear arm |  |
| PASS | L ankle pitch bushing |  |
| PASS | L knee ear clamp |  |
| PASS | L thigh |  |
| PASS | L knee rear arm |  |
| PASS | L knee bushing |  |
| PASS | L hip pitch ear clamp |  |
| PASS | L roll bracket |  |
| PASS | L hip pitch rear arm |  |
| PASS | L hip pitch bushing |  |
| PASS | L hip roll ear clamp |  |
| PASS | L yaw link |  |
| PASS | L hip roll rear arm |  |
| PASS | L hip roll bushing |  |
| PASS | L hip yaw ear clamp |  |
| PASS | chassis |  |
| PASS | L hip yaw rear arm |  |
| PASS | L hip yaw bushing |  |
| PASS | L sole |  |
| PASS | neck pitch ear clamp |  |
| PASS | neck plate |  |
| PASS | head pitch ear clamp |  |
| PASS | head frame |  |
| PASS | beak ear clamp |  |
| PASS | jaw |  |
| PASS | upper bill |  |

## WALL

| status | item | detail |
|---|---|---|
| PASS | L ankle pitch ear clamp |  |
| PASS | L shin |  |
| PASS | L foot |  |
| PASS | L ankle pitch rear arm |  |
| PASS | L ankle pitch bushing |  |
| PASS | L knee ear clamp |  |
| PASS | L thigh |  |
| PASS | L knee rear arm |  |
| PASS | L knee bushing |  |
| PASS | L hip pitch ear clamp |  |
| PASS | L roll bracket |  |
| PASS | L hip pitch rear arm |  |
| PASS | L hip pitch bushing |  |
| PASS | L hip roll ear clamp |  |
| PASS | L yaw link |  |
| PASS | L hip roll rear arm |  |
| PASS | L hip roll bushing |  |
| PASS | L hip yaw ear clamp |  |
| PASS | chassis |  |
| PASS | L hip yaw rear arm |  |
| PASS | L hip yaw bushing |  |
| PASS | L sole |  |
| PASS | neck pitch ear clamp |  |
| PASS | neck plate |  |
| PASS | head pitch ear clamp |  |
| PASS | head frame |  |
| PASS | beak ear clamp |  |
| PASS | jaw |  |
| PASS | upper bill |  |

## FIT

| status | item | detail |
|---|---|---|
| PASS | L ankle pitch ear clamp | 15 x 3 x 34 mm |
| PASS | L shin | 20 x 39 x 55 mm |
| PASS | L foot | 55 x 36 x 23 mm |
| PASS | L ankle pitch rear arm | 26 x 4 x 24 mm |
| PASS | L ankle pitch bushing | 11 x 6 x 11 mm |
| PASS | L knee ear clamp | 15 x 3 x 34 mm |
| PASS | L thigh | 50 x 24 x 35 mm |
| PASS | L knee rear arm | 15 x 4 x 24 mm |
| PASS | L knee bushing | 11 x 6 x 11 mm |
| PASS | L hip pitch ear clamp | 34 x 3 x 15 mm |
| PASS | L roll bracket | 36 x 36 x 38 mm |
| PASS | L hip pitch rear arm | 24 x 4 x 12 mm |
| PASS | L hip pitch bushing | 11 x 6 x 11 mm |
| PASS | L hip roll ear clamp | 3 x 34 x 15 mm |
| PASS | L yaw link | 32 x 34 x 50 mm |
| PASS | L hip roll rear arm | 4 x 12 x 22 mm |
| PASS | L hip roll bushing | 6 x 11 x 11 mm |
| PASS | L hip yaw ear clamp | 34 x 15 x 3 mm |
| PASS | chassis | 116 x 56 x 37 mm |
| PASS | L hip yaw rear arm | 26 x 12 x 4 mm |
| PASS | L hip yaw bushing | 11 x 11 x 6 mm |
| PASS | L sole | 55 x 36 x 3 mm |
| PASS | neck pitch ear clamp | 15 x 3 x 34 mm |
| PASS | neck plate | 16 x 6 x 48 mm |
| PASS | head pitch ear clamp | 34 x 3 x 15 mm |
| PASS | head frame | 50 x 59 x 28 mm |
| PASS | beak ear clamp | 34 x 3 x 15 mm |
| PASS | jaw | 46 x 35 x 15 mm |
| PASS | upper bill | 27 x 45 x 12 mm |
