meetsitaram/duck-droids/reports/nano/printable.md

# Physical checks

From tools/printable.py. Overhang from faces, not a slicer: none of this has been printed.

286 checks: 274 pass, 12 warn, **0 fail**

## ORIENT

| status | item | detail |
|---|---|---|
| PASS | L ankle pitch ear clamp | 0 mm2 overhang, 148 mm2 on the bed, 2 mm tall |
| PASS | R ankle pitch ear clamp | 0 mm2 overhang, 150 mm2 on the bed, 2 mm tall |
| PASS | L shin | 495 mm2 overhang, 220 mm2 on the bed, 38 mm tall |
| PASS | R shin | 495 mm2 overhang, 220 mm2 on the bed, 38 mm tall |
| PASS | L foot | 0 mm2 overhang, 477 mm2 on the bed, 35 mm tall |
| PASS | R foot | 0 mm2 overhang, 477 mm2 on the bed, 35 mm tall |
| PASS | L ankle pitch rear arm | 0 mm2 overhang, 355 mm2 on the bed, 2 mm tall |
| PASS | R ankle pitch rear arm | 0 mm2 overhang, 355 mm2 on the bed, 2 mm tall |
| PASS | L ankle pitch bushing | 0 mm2 overhang, 64 mm2 on the bed, 5 mm tall |
| PASS | R ankle pitch bushing | 0 mm2 overhang, 64 mm2 on the bed, 5 mm tall |
| PASS | L knee ear clamp | 0 mm2 overhang, 148 mm2 on the bed, 2 mm tall |
| PASS | R knee ear clamp | 0 mm2 overhang, 150 mm2 on the bed, 2 mm tall |
| PASS | L thigh | 672 mm2 overhang, 221 mm2 on the bed, 23 mm tall |
| PASS | R thigh | 672 mm2 overhang, 221 mm2 on the bed, 23 mm tall |
| PASS | L knee rear arm | 0 mm2 overhang, 209 mm2 on the bed, 2 mm tall |
| PASS | R knee rear arm | 0 mm2 overhang, 209 mm2 on the bed, 2 mm tall |
| PASS | L knee bushing | 0 mm2 overhang, 64 mm2 on the bed, 5 mm tall |
| PASS | R knee bushing | 0 mm2 overhang, 64 mm2 on the bed, 5 mm tall |
| PASS | L hip pitch ear clamp | 0 mm2 overhang, 147 mm2 on the bed, 2 mm tall |
| PASS | R hip pitch ear clamp | 0 mm2 overhang, 150 mm2 on the bed, 2 mm tall |
| PASS | L roll bracket | 325 mm2 overhang, 177 mm2 on the bed, 35 mm tall |
| PASS | R roll bracket | 325 mm2 overhang, 177 mm2 on the bed, 35 mm tall |
| PASS | L hip pitch rear arm | 0 mm2 overhang, 167 mm2 on the bed, 2 mm tall |
| PASS | R hip pitch rear arm | 0 mm2 overhang, 167 mm2 on the bed, 2 mm tall |
| PASS | L hip pitch bushing | 0 mm2 overhang, 64 mm2 on the bed, 5 mm tall |
| PASS | R hip pitch bushing | 0 mm2 overhang, 64 mm2 on the bed, 5 mm tall |
| PASS | L hip roll ear clamp | 0 mm2 overhang, 148 mm2 on the bed, 2 mm tall |
| PASS | R hip roll ear clamp | 0 mm2 overhang, 148 mm2 on the bed, 2 mm tall |
| PASS | L yaw link | 590 mm2 overhang, 128 mm2 on the bed, 32 mm tall |
| PASS | R yaw link | 591 mm2 overhang, 128 mm2 on the bed, 32 mm tall |
| PASS | L hip roll rear arm | 0 mm2 overhang, 145 mm2 on the bed, 2 mm tall |
| PASS | R hip roll rear arm | 0 mm2 overhang, 145 mm2 on the bed, 2 mm tall |
| PASS | L hip roll bushing | 0 mm2 overhang, 64 mm2 on the bed, 5 mm tall |
| PASS | R hip roll bushing | 0 mm2 overhang, 64 mm2 on the bed, 5 mm tall |
| PASS | L hip yaw ear clamp | 0 mm2 overhang, 150 mm2 on the bed, 2 mm tall |
| PASS | R hip yaw ear clamp | 0 mm2 overhang, 150 mm2 on the bed, 2 mm tall |
| PASS | chassis | 2208 mm2 overhang, 426 mm2 on the bed, 55 mm tall |
| PASS | L hip yaw rear arm | 0 mm2 overhang, 187 mm2 on the bed, 2 mm tall |
| PASS | R hip yaw rear arm | 0 mm2 overhang, 187 mm2 on the bed, 2 mm tall |
| PASS | L hip yaw bushing | 0 mm2 overhang, 64 mm2 on the bed, 5 mm tall |
| PASS | R hip yaw bushing | 0 mm2 overhang, 64 mm2 on the bed, 5 mm tall |
| PASS | L sole | 0 mm2 overhang, 1784 mm2 on the bed, 1 mm tall |
| PASS | R sole | 0 mm2 overhang, 1784 mm2 on the bed, 1 mm tall |
| PASS | neck pitch ear clamp | 0 mm2 overhang, 148 mm2 on the bed, 2 mm tall |
| PASS | neck plate | 16 mm2 overhang, 393 mm2 on the bed, 4 mm tall |
| PASS | head pitch ear clamp | 0 mm2 overhang, 150 mm2 on the bed, 2 mm tall |
| PASS | head frame | 493 mm2 overhang, 487 mm2 on the bed, 58 mm tall |
| PASS | beak ear clamp | 0 mm2 overhang, 147 mm2 on the bed, 2 mm tall |
| PASS | jaw | 23 mm2 overhang, 113 mm2 on the bed, 45 mm tall |
| PASS | upper bill | 0 mm2 overhang, 479 mm2 on the bed, 26 mm tall |
| PASS | body shell | 1633 mm2 overhang, 3710 mm2 on the bed, 40 mm tall |
| PASS | hood | 2925 mm2 overhang, 1688 mm2 on the bed, 37 mm tall |

## PIECES

| status | item | detail |
|---|---|---|
| PASS | L ankle pitch ear clamp |  |
| PASS | R ankle pitch ear clamp |  |
| PASS | L shin |  |
| PASS | R shin |  |
| PASS | L foot |  |
| PASS | R foot |  |
| PASS | L ankle pitch rear arm |  |
| PASS | R ankle pitch rear arm |  |
| PASS | L ankle pitch bushing |  |
| PASS | R ankle pitch bushing |  |
| PASS | L knee ear clamp |  |
| PASS | R knee ear clamp |  |
| PASS | L thigh |  |
| PASS | R thigh |  |
| PASS | L knee rear arm |  |
| PASS | R knee rear arm |  |
| PASS | L knee bushing |  |
| PASS | R knee bushing |  |
| PASS | L hip pitch ear clamp |  |
| PASS | R hip pitch ear clamp |  |
| PASS | L roll bracket |  |
| PASS | R roll bracket |  |
| PASS | L hip pitch rear arm |  |
| PASS | R hip pitch rear arm |  |
| PASS | L hip pitch bushing |  |
| PASS | R hip pitch bushing |  |
| PASS | L hip roll ear clamp |  |
| PASS | R hip roll ear clamp |  |
| PASS | L yaw link |  |
| PASS | R yaw link |  |
| PASS | L hip roll rear arm |  |
| PASS | R hip roll rear arm |  |
| PASS | L hip roll bushing |  |
| PASS | R hip roll bushing |  |
| PASS | L hip yaw ear clamp |  |
| PASS | R hip yaw ear clamp |  |
| PASS | chassis |  |
| PASS | L hip yaw rear arm |  |
| PASS | R hip yaw rear arm |  |
| PASS | L hip yaw bushing |  |
| PASS | R hip yaw bushing |  |
| PASS | L sole |  |
| PASS | R sole |  |
| PASS | neck pitch ear clamp |  |
| PASS | neck plate |  |
| PASS | head pitch ear clamp |  |
| PASS | head frame |  |
| PASS | beak ear clamp |  |
| PASS | jaw |  |
| PASS | upper bill |  |
| PASS | body shell |  |
| PASS | hood |  |

## BED

| status | item | detail |
|---|---|---|
| PASS | L ankle pitch ear clamp | 33 x 14 x 2 mm, 148 mm2 on the bed |
| PASS | R ankle pitch ear clamp | 33 x 14 x 2 mm, 150 mm2 on the bed |
| PASS | L shin | 54 x 19 x 38 mm, 220 mm2 on the bed |
| PASS | R shin | 54 x 19 x 38 mm, 220 mm2 on the bed |
| PASS | L foot | 22 x 54 x 35 mm, 477 mm2 on the bed |
| PASS | R foot | 22 x 54 x 35 mm, 477 mm2 on the bed |
| PASS | L ankle pitch rear arm | 23 x 25 x 2 mm, 355 mm2 on the bed |
| PASS | R ankle pitch rear arm | 23 x 25 x 2 mm, 355 mm2 on the bed |
| PASS | L ankle pitch bushing | 10 x 10 x 5 mm, 64 mm2 on the bed |
| PASS | R ankle pitch bushing | 10 x 10 x 5 mm, 64 mm2 on the bed |
| PASS | L knee ear clamp | 33 x 14 x 2 mm, 148 mm2 on the bed |
| PASS | R knee ear clamp | 33 x 14 x 2 mm, 150 mm2 on the bed |
| PASS | L thigh | 34 x 48 x 23 mm, 221 mm2 on the bed |
| PASS | R thigh | 34 x 48 x 23 mm, 221 mm2 on the bed |
| PASS | L knee rear arm | 23 x 14 x 2 mm, 209 mm2 on the bed |
| PASS | R knee rear arm | 23 x 14 x 2 mm, 209 mm2 on the bed |
| PASS | L knee bushing | 10 x 10 x 5 mm, 64 mm2 on the bed |
| PASS | R knee bushing | 10 x 10 x 5 mm, 64 mm2 on the bed |
| PASS | L hip pitch ear clamp | 14 x 33 x 2 mm, 147 mm2 on the bed |
| PASS | R hip pitch ear clamp | 14 x 33 x 2 mm, 150 mm2 on the bed |
| PASS | L roll bracket | 37 x 35 x 35 mm, 177 mm2 on the bed |
| PASS | R roll bracket | 37 x 35 x 35 mm, 177 mm2 on the bed |
| PASS | L hip pitch rear arm | 10 x 23 x 2 mm, 167 mm2 on the bed |
| PASS | R hip pitch rear arm | 10 x 23 x 2 mm, 167 mm2 on the bed |
| PASS | L hip pitch bushing | 10 x 10 x 5 mm, 64 mm2 on the bed |
| PASS | R hip pitch bushing | 10 x 10 x 5 mm, 64 mm2 on the bed |
| PASS | L hip roll ear clamp | 14 x 33 x 2 mm, 148 mm2 on the bed |
| PASS | R hip roll ear clamp | 14 x 33 x 2 mm, 148 mm2 on the bed |
| PASS | L yaw link | 49 x 31 x 32 mm, 128 mm2 on the bed |
| PASS | R yaw link | 49 x 31 x 32 mm, 128 mm2 on the bed |
| PASS | L hip roll rear arm | 21 x 10 x 2 mm, 145 mm2 on the bed |
| PASS | R hip roll rear arm | 21 x 10 x 2 mm, 145 mm2 on the bed |
| PASS | L hip roll bushing | 10 x 10 x 5 mm, 64 mm2 on the bed |
| PASS | R hip roll bushing | 10 x 10 x 5 mm, 64 mm2 on the bed |
| PASS | L hip yaw ear clamp | 33 x 14 x 2 mm, 150 mm2 on the bed |
| PASS | R hip yaw ear clamp | 33 x 14 x 2 mm, 150 mm2 on the bed |
| PASS | chassis | 36 x 115 x 55 mm, 426 mm2 on the bed |
| PASS | L hip yaw rear arm | 25 x 10 x 2 mm, 187 mm2 on the bed |
| PASS | R hip yaw rear arm | 25 x 10 x 2 mm, 187 mm2 on the bed |
| PASS | L hip yaw bushing | 10 x 10 x 5 mm, 64 mm2 on the bed |
| PASS | R hip yaw bushing | 10 x 10 x 5 mm, 64 mm2 on the bed |
| PASS | L sole | 54 x 35 x 1 mm, 1784 mm2 on the bed |
| PASS | R sole | 54 x 35 x 1 mm, 1784 mm2 on the bed |
| PASS | neck pitch ear clamp | 33 x 14 x 2 mm, 148 mm2 on the bed |
| PASS | neck plate | 47 x 15 x 4 mm, 393 mm2 on the bed |
| PASS | head pitch ear clamp | 14 x 33 x 2 mm, 150 mm2 on the bed |
| PASS | head frame | 27 x 49 x 58 mm, 487 mm2 on the bed |
| PASS | beak ear clamp | 14 x 33 x 2 mm, 147 mm2 on the bed |
| PASS | jaw | 14 x 34 x 45 mm, 113 mm2 on the bed |
| PASS | upper bill | 11 x 44 x 26 mm, 479 mm2 on the bed |
| PASS | body shell | 101 x 61 x 40 mm, 3710 mm2 on the bed |
| PASS | hood | 90 x 76 x 37 mm, 1688 mm2 on the bed |

## HOLES

| status | item | detail |
|---|---|---|
| PASS | L ankle pitch ear clamp |  |
| PASS | R ankle pitch ear clamp |  |
| PASS | L shin |  |
| PASS | R shin |  |
| PASS | L foot |  |
| PASS | R foot |  |
| PASS | L ankle pitch rear arm |  |
| PASS | R ankle pitch rear arm |  |
| PASS | L ankle pitch bushing |  |
| PASS | R ankle pitch bushing |  |
| PASS | L knee ear clamp |  |
| PASS | R knee ear clamp |  |
| PASS | L thigh |  |
| PASS | R thigh |  |
| PASS | L knee rear arm |  |
| PASS | R knee rear arm |  |
| PASS | L knee bushing |  |
| PASS | R knee bushing |  |
| PASS | L hip pitch ear clamp |  |
| PASS | R hip pitch ear clamp |  |
| PASS | L roll bracket |  |
| PASS | R roll bracket |  |
| PASS | L hip pitch rear arm |  |
| PASS | R hip pitch rear arm |  |
| PASS | L hip pitch bushing |  |
| PASS | R hip pitch bushing |  |
| PASS | L hip roll ear clamp |  |
| PASS | R hip roll ear clamp |  |
| PASS | L yaw link |  |
| PASS | R yaw link |  |
| PASS | L hip roll rear arm |  |
| PASS | R hip roll rear arm |  |
| PASS | L hip roll bushing |  |
| PASS | R hip roll bushing |  |
| PASS | L hip yaw ear clamp |  |
| PASS | R hip yaw ear clamp |  |
| PASS | chassis |  |
| PASS | L hip yaw rear arm |  |
| PASS | R hip yaw rear arm |  |
| PASS | L hip yaw bushing |  |
| PASS | R hip yaw bushing |  |
| PASS | L sole |  |
| PASS | R sole |  |
| PASS | neck pitch ear clamp |  |
| PASS | neck plate |  |
| PASS | head pitch ear clamp |  |
| PASS | head frame |  |
| PASS | beak ear clamp |  |
| PASS | jaw |  |
| PASS | upper bill |  |
| PASS | body shell |  |
| PASS | hood |  |

## SUPPORT

| status | item | detail |
|---|---|---|
| WARN | L shin | 495 mm2 needs support or a bridge: check it in the slicer |
| WARN | R shin | 495 mm2 needs support or a bridge: check it in the slicer |
| WARN | L thigh | 672 mm2 needs support or a bridge: check it in the slicer |
| WARN | R thigh | 672 mm2 needs support or a bridge: check it in the slicer |
| WARN | L roll bracket | 325 mm2 needs support or a bridge: check it in the slicer |
| WARN | R roll bracket | 325 mm2 needs support or a bridge: check it in the slicer |
| WARN | L yaw link | 590 mm2 needs support or a bridge: check it in the slicer |
| WARN | R yaw link | 591 mm2 needs support or a bridge: check it in the slicer |
| WARN | chassis | 2208 mm2 needs support or a bridge: check it in the slicer |
| WARN | head frame | 493 mm2 needs support or a bridge: check it in the slicer |
| WARN | body shell | 1633 mm2 needs support or a bridge: check it in the slicer |
| WARN | hood | 2925 mm2 needs support or a bridge: check it in the slicer |

## SKIN

| status | item | detail |
|---|---|---|
| PASS | body shell | 2 screws drill it: ['body screw 0', 'body screw 1'] |
| PASS | hood | 2 screws drill it: ['hood screw 0', 'hood screw 1'] |

## MATE

| status | item | detail |
|---|---|---|
| PASS | parts that share a link | 52 parts: 0 clashes |

## HEADS

| status | item | detail |
|---|---|---|
| PASS | L ankle pitch cradle screw near |  |
| PASS | L ankle pitch cradle screw far |  |
| PASS | L knee horn screw |  |
| PASS | L knee rear screw 0 |  |
| PASS | L knee rear screw 1 |  |
| PASS | R ankle pitch cradle screw near |  |
| PASS | R ankle pitch cradle screw far |  |
| PASS | R knee horn screw |  |
| PASS | R knee rear screw 0 |  |
| PASS | R knee rear screw 1 |  |
| PASS | L ankle pitch horn screw |  |
| PASS | L ankle pitch rear screw 0 |  |
| PASS | L ankle pitch rear screw 1 |  |
| PASS | R ankle pitch horn screw |  |
| PASS | R ankle pitch rear screw 0 |  |
| PASS | R ankle pitch rear screw 1 |  |
| PASS | L knee cradle screw near |  |
| PASS | L knee cradle screw far |  |
| PASS | L hip pitch cradle screw near |  |
| PASS | L hip pitch cradle screw far |  |
| PASS | R knee cradle screw near |  |
| PASS | R knee cradle screw far |  |
| PASS | R hip pitch cradle screw near |  |
| PASS | R hip pitch cradle screw far |  |
| PASS | L hip pitch horn screw |  |
| PASS | L hip pitch rear screw 0 |  |
| PASS | L hip pitch rear screw 1 |  |
| PASS | L hip roll horn screw |  |
| PASS | L hip roll rear screw 0 |  |
| PASS | L hip roll rear screw 1 |  |
| PASS | R hip pitch horn screw |  |
| PASS | R hip pitch rear screw 0 |  |
| PASS | R hip pitch rear screw 1 |  |
| PASS | R hip roll horn screw |  |
| PASS | R hip roll rear screw 0 |  |
| PASS | R hip roll rear screw 1 |  |
| PASS | L hip roll cradle screw near |  |
| PASS | L hip roll cradle screw far |  |
| PASS | L hip yaw horn screw |  |
| PASS | L hip yaw rear screw 0 |  |
| PASS | L hip yaw rear screw 1 |  |
| PASS | R hip roll cradle screw near |  |
| PASS | R hip roll cradle screw far |  |
| PASS | R hip yaw horn screw |  |
| PASS | R hip yaw rear screw 0 |  |
| PASS | R hip yaw rear screw 1 |  |
| PASS | L hip yaw cradle screw near |  |
| PASS | L hip yaw cradle screw far |  |
| PASS | neck pitch cradle screw near |  |
| PASS | neck pitch cradle screw far |  |
| PASS | body screw 0 |  |
| PASS | body screw 1 |  |
| PASS | R hip yaw cradle screw near |  |
| PASS | R hip yaw cradle screw far |  |
| PASS | neck pitch horn screw |  |
| PASS | head pitch horn screw |  |
| PASS | head pitch cradle screw near |  |
| PASS | head pitch cradle screw far |  |
| PASS | beak cradle screw near |  |
| PASS | beak cradle screw far |  |
| PASS | hood screw 0 |  |
| PASS | hood screw 1 |  |
| PASS | beak horn screw |  |
