meetsitaram/duck-droids/reports/hobby/assembly.md

# Physical checks

From tools/assembly.py

887 checks: 887 pass, 0 warn, **0 fail**

## PATH

| status | item | detail |
|---|---|---|
| PASS | thigh_L: L hip pitch servo |  |
| PASS | thigh_L: L knee servo |  |
| PASS | thigh_L: L hip pitch lid |  |
| PASS | thigh_L: L knee lid |  |
| PASS | thigh_L: L hip pitch bearing |  |
| PASS | thigh_L: L knee bearing |  |
| PASS | thigh_L: L hip pitch horn |  |
| PASS | thigh_L: L knee horn |  |
| PASS | thigh_L: L thigh cover |  |
| PASS | shin_L: L ankle servo |  |
| PASS | shin_L: L ankle bearing inner |  |
| PASS | shin_L: L ankle horn |  |
| PASS | shoe_L: L sole |  |
| PASS | leg_L: @shin_L |  |
| PASS | leg_L: @shoe_L |  |
| PASS | leg_L: L inner ear |  |
| PASS | leg_L: L roll bracket |  |
| PASS | thigh_R: R hip pitch servo |  |
| PASS | thigh_R: R knee servo |  |
| PASS | thigh_R: R hip pitch lid |  |
| PASS | thigh_R: R knee lid |  |
| PASS | thigh_R: R hip pitch bearing |  |
| PASS | thigh_R: R knee bearing |  |
| PASS | thigh_R: R hip pitch horn |  |
| PASS | thigh_R: R knee horn |  |
| PASS | thigh_R: R thigh cover |  |
| PASS | shin_R: R ankle servo |  |
| PASS | shin_R: R ankle bearing inner |  |
| PASS | shin_R: R ankle horn |  |
| PASS | shoe_R: R sole |  |
| PASS | leg_R: @shin_R |  |
| PASS | leg_R: @shoe_R |  |
| PASS | leg_R: R inner ear |  |
| PASS | leg_R: R roll bracket |  |
| PASS | body: L hip yaw servo |  |
| PASS | body: R hip yaw servo |  |
| PASS | body: L hip yaw lid |  |
| PASS | body: R hip yaw lid |  |
| PASS | body: L hip yaw bearing |  |
| PASS | body: R hip yaw bearing |  |
| PASS | body: L hip yaw horn |  |
| PASS | body: R hip yaw horn |  |
| PASS | body: L yaw bracket |  |
| PASS | body: R yaw bracket |  |
| PASS | body: L hip roll servo |  |
| PASS | body: R hip roll servo |  |
| PASS | body: L hip roll lid |  |
| PASS | body: R hip roll lid |  |
| PASS | body: L hip roll bearing |  |
| PASS | body: R hip roll bearing |  |
| PASS | body: L hip roll horn |  |
| PASS | body: R hip roll horn |  |
| PASS | body: L 6 V BEC |  |
| PASS | body: R 6 V BEC |  |
| PASS | legs: @leg_L |  |
| PASS | legs: @leg_R |  |
| PASS | column: neck servo |  |
| PASS | column: neck lid |  |
| PASS | column: head pitch servo |  |
| PASS | column: head pitch lid |  |
| PASS | column: neck pitch rear bearing |  |
| PASS | column: head pitch rear bearing |  |
| PASS | torso: battery |  |
| PASS | torso: IMU |  |
| PASS | torso: Pi 5 V converter |  |
| PASS | torso: Pi Zero 2 W |  |
| PASS | torso: PWM bonnet |  |
| PASS | torso: body shell |  |
| PASS | torso: battery plugs |  |
| PASS | torso: @column |  |
| PASS | torso: neck pitch rear hub |  |
| PASS | headbench: head yaw servo |  |
| PASS | headbench: head yaw sheet |  |
| PASS | headbench: head yaw bearing |  |
| PASS | headbench: head yaw horn |  |
| PASS | headbench: head yaw bracket |  |
| PASS | headbench: head roll servo |  |
| PASS | headbench: head roll rear bearing |  |
| PASS | headbench: head roll lid |  |
| PASS | headbench: head roll bearing |  |
| PASS | headbench: head roll horn |  |
| PASS | framebench: beak servo |  |
| PASS | jawbench: jaw soft insert |  |
| PASS | head: @headbench |  |
| PASS | head: head pitch rear hub |  |
| PASS | head: @framebench |  |
| PASS | head: head roll rear hub |  |
| PASS | head: @jawbench |  |
| PASS | head: hood |  |
| PASS | head: mouth roof |  |
| PASS | head: camera |  |
| PASS | head: face |  |
| PASS | head: eye ring |  |
| PASS | head: eye iris |  |

## HELD

| status | item | detail |
|---|---|---|
| PASS | L hip pitch cradle screw rear near ear 2 |  |
| PASS | L hip pitch cradle screw rear near ear 3 |  |
| PASS | L knee cradle screw rear near ear 2 |  |
| PASS | L knee cradle screw rear near ear 3 |  |
| PASS | L hip pitch cradle screw horn face 0 |  |
| PASS | L hip pitch cradle screw horn face 1 |  |
| PASS | L knee cradle screw horn face 0 |  |
| PASS | L knee cradle screw horn face 1 |  |
| PASS | L thigh cover screw hip |  |
| PASS | L thigh cover screw knee |  |
| PASS | L ankle pitch cradle screw rear far ear 0 |  |
| PASS | L ankle pitch cradle screw rear far ear 1 |  |
| PASS | L ankle pitch cradle screw rear near ear 2 |  |
| PASS | L ankle pitch cradle screw rear near ear 3 |  |
| PASS | L shoe bottom screw 0 |  |
| PASS | L shoe bottom screw 1 |  |
| PASS | L knee fork screw horn 0 |  |
| PASS | L knee fork screw horn 1 |  |
| PASS | L knee fork screw horn 2 |  |
| PASS | L knee fork screw horn 3 |  |
| PASS | L ankle pitch fork screw horn 0 |  |
| PASS | L ankle pitch fork screw horn 1 |  |
| PASS | L ankle pitch fork screw horn 2 |  |
| PASS | L ankle pitch fork screw horn 3 |  |
| PASS | L ankle ear screw 0 |  |
| PASS | L ankle ear screw 1 |  |
| PASS | L hip pitch fork screw horn 0 |  |
| PASS | L hip pitch fork screw horn 1 |  |
| PASS | L hip pitch fork screw horn 2 |  |
| PASS | L hip pitch fork screw horn 3 |  |
| PASS | R hip pitch cradle screw rear near ear 2 |  |
| PASS | R hip pitch cradle screw rear near ear 3 |  |
| PASS | R knee cradle screw rear near ear 2 |  |
| PASS | R knee cradle screw rear near ear 3 |  |
| PASS | R hip pitch cradle screw horn face 0 |  |
| PASS | R hip pitch cradle screw horn face 1 |  |
| PASS | R knee cradle screw horn face 0 |  |
| PASS | R knee cradle screw horn face 1 |  |
| PASS | R thigh cover screw hip |  |
| PASS | R thigh cover screw knee |  |
| PASS | R ankle pitch cradle screw rear far ear 0 |  |
| PASS | R ankle pitch cradle screw rear far ear 1 |  |
| PASS | R ankle pitch cradle screw rear near ear 2 |  |
| PASS | R ankle pitch cradle screw rear near ear 3 |  |
| PASS | R shoe bottom screw 0 |  |
| PASS | R shoe bottom screw 1 |  |
| PASS | R knee fork screw horn 0 |  |
| PASS | R knee fork screw horn 1 |  |
| PASS | R knee fork screw horn 2 |  |
| PASS | R knee fork screw horn 3 |  |
| PASS | R ankle pitch fork screw horn 0 |  |
| PASS | R ankle pitch fork screw horn 1 |  |
| PASS | R ankle pitch fork screw horn 2 |  |
| PASS | R ankle pitch fork screw horn 3 |  |
| PASS | R ankle ear screw 0 |  |
| PASS | R ankle ear screw 1 |  |
| PASS | R hip pitch fork screw horn 0 |  |
| PASS | R hip pitch fork screw horn 1 |  |
| PASS | R hip pitch fork screw horn 2 |  |
| PASS | R hip pitch fork screw horn 3 |  |
| PASS | L hip yaw cradle screw rear near ear 2 |  |
| PASS | L hip yaw cradle screw rear near ear 3 |  |
| PASS | R hip yaw cradle screw rear near ear 2 |  |
| PASS | R hip yaw cradle screw rear near ear 3 |  |
| PASS | L hip yaw cradle screw horn face 0 |  |
| PASS | L hip yaw cradle screw horn face 1 |  |
| PASS | R hip yaw cradle screw horn face 0 |  |
| PASS | R hip yaw cradle screw horn face 1 |  |
| PASS | L hip yaw fork screw horn 0 |  |
| PASS | L hip yaw fork screw horn 1 |  |
| PASS | L hip yaw fork screw horn 2 |  |
| PASS | L hip yaw fork screw horn 3 |  |
| PASS | R hip yaw fork screw horn 0 |  |
| PASS | R hip yaw fork screw horn 1 |  |
| PASS | R hip yaw fork screw horn 2 |  |
| PASS | R hip yaw fork screw horn 3 |  |
| PASS | L hip roll cradle screw rear near ear 2 |  |
| PASS | L hip roll cradle screw rear near ear 3 |  |
| PASS | R hip roll cradle screw rear near ear 2 |  |
| PASS | R hip roll cradle screw rear near ear 3 |  |
| PASS | L hip roll cradle screw horn face 0 |  |
| PASS | L hip roll cradle screw horn face 1 |  |
| PASS | R hip roll cradle screw horn face 0 |  |
| PASS | R hip roll cradle screw horn face 1 |  |
| PASS | L hip roll fork screw horn 0 |  |
| PASS | L hip roll fork screw horn 1 |  |
| PASS | L hip roll fork screw horn 2 |  |
| PASS | L hip roll fork screw horn 3 |  |
| PASS | R hip roll fork screw horn 0 |  |
| PASS | R hip roll fork screw horn 1 |  |
| PASS | R hip roll fork screw horn 2 |  |
| PASS | R hip roll fork screw horn 3 |  |
| PASS | neck pitch cradle screw rear near ear 2 |  |
| PASS | neck pitch cradle screw rear near ear 3 |  |
| PASS | neck pitch cradle screw horn face 0 |  |
| PASS | neck pitch cradle screw horn face 1 |  |
| PASS | head pitch cradle screw rear near ear 2 |  |
| PASS | head pitch cradle screw rear near ear 3 |  |
| PASS | head pitch cradle screw horn face 0 |  |
| PASS | head pitch cradle screw horn face 1 |  |
| PASS | Pi screw 0 |  |
| PASS | Pi screw 1 |  |
| PASS | Pi screw 2 |  |
| PASS | Pi screw 3 |  |
| PASS | body screw 0 |  |
| PASS | body screw 1 |  |
| PASS | neck pitch fork screw horn 0 |  |
| PASS | neck pitch fork screw horn 1 |  |
| PASS | neck pitch fork screw horn 2 |  |
| PASS | neck pitch fork screw horn 3 |  |
| PASS | neck pitch hub screw 0 |  |
| PASS | neck pitch hub screw 1 |  |
| PASS | head yaw cradle screw rear near ear 1 |  |
| PASS | head yaw cradle screw horn face 0 |  |
| PASS | head yaw cradle screw horn face 2 |  |
| PASS | head yaw fork screw horn 0 |  |
| PASS | head yaw fork screw horn 1 |  |
| PASS | head yaw fork screw horn 2 |  |
| PASS | head yaw fork screw horn 3 |  |
| PASS | head roll cradle screw rear near ear 1 |  |
| PASS | head roll cradle screw horn face 0 |  |
| PASS | head roll cradle screw horn face 2 |  |
| PASS | beak cradle screw rear far ear 0 |  |
| PASS | beak cradle screw rear near ear 1 |  |
| PASS | head pitch fork screw horn 0 |  |
| PASS | head pitch fork screw horn 1 |  |
| PASS | head pitch fork screw horn 2 |  |
| PASS | head pitch fork screw horn 3 |  |
| PASS | head pitch hub screw 0 |  |
| PASS | head pitch hub screw 1 |  |
| PASS | head roll fork screw horn 0 |  |
| PASS | head roll fork screw horn 1 |  |
| PASS | head roll fork screw horn 2 |  |
| PASS | head roll fork screw horn 3 |  |
| PASS | head roll hub screw 0 |  |
| PASS | head roll hub screw 1 |  |
| PASS | beak fork screw horn 0 |  |
| PASS | beak fork screw horn 1 |  |
| PASS | beak fork screw horn 2 |  |
| PASS | beak fork screw horn 3 |  |
| PASS | hood rear screw 0 |  |
| PASS | hood rear screw 1 |  |

## THREAD

| status | item | detail |
|---|---|---|
| PASS | L hip pitch cradle screw rear near ear 2 | M3 x 6: bites 3.0 mm |
| PASS | L hip pitch cradle screw rear near ear 3 | M3 x 6: bites 3.0 mm |
| PASS | L knee cradle screw rear near ear 2 | M3 x 6: bites 3.0 mm |
| PASS | L knee cradle screw rear near ear 3 | M3 x 6: bites 3.0 mm |
| PASS | L hip pitch cradle screw horn face 0 | M3 x 16: bites 5.3 mm |
| PASS | L hip pitch cradle screw horn face 1 | M3 x 16: bites 5.3 mm |
| PASS | L knee cradle screw horn face 0 | M3 x 16: bites 5.7 mm |
| PASS | L knee cradle screw horn face 1 | M3 x 16: bites 5.7 mm |
| PASS | L thigh cover screw hip | M2 x 6: bites 3.0 mm |
| PASS | L thigh cover screw knee | M2 x 6: bites 3.0 mm |
| PASS | L ankle pitch cradle screw rear far ear 0 | M3 x 6: bites 3.0 mm |
| PASS | L ankle pitch cradle screw rear far ear 1 | M3 x 6: bites 3.0 mm |
| PASS | L ankle pitch cradle screw rear near ear 2 | M3 x 6: bites 3.0 mm |
| PASS | L ankle pitch cradle screw rear near ear 3 | M3 x 6: bites 3.0 mm |
| PASS | L shoe bottom screw 0 | M3 x 12: bites 5.4 mm |
| PASS | L shoe bottom screw 1 | M3 x 12: bites 5.4 mm |
| PASS | L knee fork screw horn 0 | M3 x 6: bites 2.7 mm |
| PASS | L knee fork screw horn 1 | M3 x 6: bites 2.7 mm |
| PASS | L knee fork screw horn 2 | M3 x 6: bites 2.7 mm |
| PASS | L knee fork screw horn 3 | M3 x 6: bites 2.7 mm |
| PASS | L ankle pitch fork screw horn 0 | M3 x 6: bites 2.7 mm |
| PASS | L ankle pitch fork screw horn 1 | M3 x 6: bites 2.7 mm |
| PASS | L ankle pitch fork screw horn 2 | M3 x 6: bites 2.7 mm |
| PASS | L ankle pitch fork screw horn 3 | M3 x 6: bites 2.7 mm |
| PASS | L ankle ear screw 0 | M2 x 8: bites 3.8 mm |
| PASS | L ankle ear screw 1 | M2 x 8: bites 3.8 mm |
| PASS | L hip pitch fork screw horn 0 | M3 x 6: bites 2.7 mm |
| PASS | L hip pitch fork screw horn 1 | M3 x 6: bites 2.7 mm |
| PASS | L hip pitch fork screw horn 2 | M3 x 6: bites 2.7 mm |
| PASS | L hip pitch fork screw horn 3 | M3 x 6: bites 2.7 mm |
| PASS | R hip pitch cradle screw rear near ear 2 | M3 x 6: bites 3.0 mm |
| PASS | R hip pitch cradle screw rear near ear 3 | M3 x 6: bites 3.0 mm |
| PASS | R knee cradle screw rear near ear 2 | M3 x 6: bites 3.0 mm |
| PASS | R knee cradle screw rear near ear 3 | M3 x 6: bites 3.0 mm |
| PASS | R hip pitch cradle screw horn face 0 | M3 x 16: bites 5.3 mm |
| PASS | R hip pitch cradle screw horn face 1 | M3 x 16: bites 5.3 mm |
| PASS | R knee cradle screw horn face 0 | M3 x 16: bites 5.7 mm |
| PASS | R knee cradle screw horn face 1 | M3 x 16: bites 5.7 mm |
| PASS | R thigh cover screw hip | M2 x 6: bites 3.0 mm |
| PASS | R thigh cover screw knee | M2 x 6: bites 3.0 mm |
| PASS | R ankle pitch cradle screw rear far ear 0 | M3 x 6: bites 3.0 mm |
| PASS | R ankle pitch cradle screw rear far ear 1 | M3 x 6: bites 3.0 mm |
| PASS | R ankle pitch cradle screw rear near ear 2 | M3 x 6: bites 3.0 mm |
| PASS | R ankle pitch cradle screw rear near ear 3 | M3 x 6: bites 3.0 mm |
| PASS | R shoe bottom screw 0 | M3 x 12: bites 5.4 mm |
| PASS | R shoe bottom screw 1 | M3 x 12: bites 5.4 mm |
| PASS | R knee fork screw horn 0 | M3 x 6: bites 2.7 mm |
| PASS | R knee fork screw horn 1 | M3 x 6: bites 2.7 mm |
| PASS | R knee fork screw horn 2 | M3 x 6: bites 2.7 mm |
| PASS | R knee fork screw horn 3 | M3 x 6: bites 2.7 mm |
| PASS | R ankle pitch fork screw horn 0 | M3 x 6: bites 2.7 mm |
| PASS | R ankle pitch fork screw horn 1 | M3 x 6: bites 2.7 mm |
| PASS | R ankle pitch fork screw horn 2 | M3 x 6: bites 2.7 mm |
| PASS | R ankle pitch fork screw horn 3 | M3 x 6: bites 2.7 mm |
| PASS | R ankle ear screw 0 | M2 x 8: bites 3.8 mm |
| PASS | R ankle ear screw 1 | M2 x 8: bites 3.8 mm |
| PASS | R hip pitch fork screw horn 0 | M3 x 6: bites 2.7 mm |
| PASS | R hip pitch fork screw horn 1 | M3 x 6: bites 2.7 mm |
| PASS | R hip pitch fork screw horn 2 | M3 x 6: bites 2.7 mm |
| PASS | R hip pitch fork screw horn 3 | M3 x 6: bites 2.7 mm |
| PASS | L hip yaw cradle screw rear near ear 2 | M3 x 6: bites 3.0 mm |
| PASS | L hip yaw cradle screw rear near ear 3 | M3 x 6: bites 3.0 mm |
| PASS | R hip yaw cradle screw rear near ear 2 | M3 x 6: bites 3.0 mm |
| PASS | R hip yaw cradle screw rear near ear 3 | M3 x 6: bites 3.0 mm |
| PASS | L hip yaw cradle screw horn face 0 | M3 x 16: bites 5.3 mm |
| PASS | L hip yaw cradle screw horn face 1 | M3 x 16: bites 5.3 mm |
| PASS | R hip yaw cradle screw horn face 0 | M3 x 16: bites 5.3 mm |
| PASS | R hip yaw cradle screw horn face 1 | M3 x 16: bites 5.3 mm |
| PASS | L hip yaw fork screw horn 0 | M3 x 6: bites 2.7 mm |
| PASS | L hip yaw fork screw horn 1 | M3 x 6: bites 2.7 mm |
| PASS | L hip yaw fork screw horn 2 | M3 x 6: bites 2.7 mm |
| PASS | L hip yaw fork screw horn 3 | M3 x 6: bites 2.7 mm |
| PASS | R hip yaw fork screw horn 0 | M3 x 6: bites 2.7 mm |
| PASS | R hip yaw fork screw horn 1 | M3 x 6: bites 2.7 mm |
| PASS | R hip yaw fork screw horn 2 | M3 x 6: bites 2.7 mm |
| PASS | R hip yaw fork screw horn 3 | M3 x 6: bites 2.7 mm |
| PASS | L hip roll cradle screw rear near ear 2 | M3 x 6: bites 3.0 mm |
| PASS | L hip roll cradle screw rear near ear 3 | M3 x 6: bites 3.0 mm |
| PASS | R hip roll cradle screw rear near ear 2 | M3 x 6: bites 3.0 mm |
| PASS | R hip roll cradle screw rear near ear 3 | M3 x 6: bites 3.0 mm |
| PASS | L hip roll cradle screw horn face 0 | M3 x 16: bites 5.3 mm |
| PASS | L hip roll cradle screw horn face 1 | M3 x 16: bites 5.3 mm |
| PASS | R hip roll cradle screw horn face 0 | M3 x 16: bites 5.3 mm |
| PASS | R hip roll cradle screw horn face 1 | M3 x 16: bites 5.3 mm |
| PASS | L hip roll fork screw horn 0 | M3 x 6: bites 2.7 mm |
| PASS | L hip roll fork screw horn 1 | M3 x 6: bites 2.7 mm |
| PASS | L hip roll fork screw horn 2 | M3 x 6: bites 2.7 mm |
| PASS | L hip roll fork screw horn 3 | M3 x 6: bites 2.7 mm |
| PASS | R hip roll fork screw horn 0 | M3 x 6: bites 2.7 mm |
| PASS | R hip roll fork screw horn 1 | M3 x 6: bites 2.7 mm |
| PASS | R hip roll fork screw horn 2 | M3 x 6: bites 2.7 mm |
| PASS | R hip roll fork screw horn 3 | M3 x 6: bites 2.7 mm |
| PASS | neck pitch cradle screw rear near ear 2 | M3 x 6: bites 3.0 mm |
| PASS | neck pitch cradle screw rear near ear 3 | M3 x 6: bites 3.0 mm |
| PASS | neck pitch cradle screw horn face 0 | M3 x 16: bites 5.7 mm |
| PASS | neck pitch cradle screw horn face 1 | M3 x 16: bites 5.7 mm |
| PASS | head pitch cradle screw rear near ear 2 | M3 x 6: bites 3.0 mm |
| PASS | head pitch cradle screw rear near ear 3 | M3 x 6: bites 3.0 mm |
| PASS | head pitch cradle screw horn face 0 | M3 x 16: bites 5.3 mm |
| PASS | head pitch cradle screw horn face 1 | M3 x 16: bites 5.3 mm |
| PASS | Pi screw 0 | M2.5 x 6: bites 3.0 mm |
| PASS | Pi screw 1 | M2.5 x 6: bites 3.0 mm |
| PASS | Pi screw 2 | M2.5 x 6: bites 3.0 mm |
| PASS | Pi screw 3 | M2.5 x 6: bites 3.0 mm |
| PASS | body screw 0 | M2 x 6: bites 3.0 mm |
| PASS | body screw 1 | M2 x 6: bites 3.0 mm |
| PASS | neck pitch fork screw horn 0 | M3 x 6: bites 2.7 mm |
| PASS | neck pitch fork screw horn 1 | M3 x 6: bites 2.7 mm |
| PASS | neck pitch fork screw horn 2 | M3 x 6: bites 2.7 mm |
| PASS | neck pitch fork screw horn 3 | M3 x 6: bites 2.7 mm |
| PASS | neck pitch hub screw 0 | M2 x 4: bites 2.0 mm |
| PASS | neck pitch hub screw 1 | M2 x 4: bites 2.0 mm |
| PASS | head yaw cradle screw rear near ear 1 | M2 x 5: bites 2.4 mm |
| PASS | head yaw cradle screw horn face 0 | M2 x 10: bites 4.5 mm |
| PASS | head yaw cradle screw horn face 2 | M2 x 10: bites 2.1 mm |
| PASS | head yaw fork screw horn 0 | M2 x 4: bites 2.0 mm |
| PASS | head yaw fork screw horn 1 | M2 x 4: bites 2.0 mm |
| PASS | head yaw fork screw horn 2 | M2 x 4: bites 2.0 mm |
| PASS | head yaw fork screw horn 3 | M2 x 4: bites 2.0 mm |
| PASS | head roll cradle screw rear near ear 1 | M2 x 5: bites 2.4 mm |
| PASS | head roll cradle screw horn face 0 | M2 x 12: bites 4.6 mm |
| PASS | head roll cradle screw horn face 2 | M2 x 12: bites 2.3 mm |
| PASS | beak cradle screw rear far ear 0 | M2 x 5: bites 2.4 mm |
| PASS | beak cradle screw rear near ear 1 | M2 x 5: bites 2.4 mm |
| PASS | head pitch fork screw horn 0 | M3 x 6: bites 2.7 mm |
| PASS | head pitch fork screw horn 1 | M3 x 6: bites 2.7 mm |
| PASS | head pitch fork screw horn 2 | M3 x 6: bites 2.7 mm |
| PASS | head pitch fork screw horn 3 | M3 x 6: bites 2.7 mm |
| PASS | head pitch hub screw 0 | M2 x 4: bites 2.0 mm |
| PASS | head pitch hub screw 1 | M2 x 4: bites 2.0 mm |
| PASS | head roll fork screw horn 0 | M2 x 6: bites 2.4 mm |
| PASS | head roll fork screw horn 1 | M2 x 6: bites 2.4 mm |
| PASS | head roll fork screw horn 2 | M2 x 6: bites 2.4 mm |
| PASS | head roll fork screw horn 3 | M2 x 6: bites 2.4 mm |
| PASS | head roll hub screw 0 | M2 x 4: bites 2.0 mm |
| PASS | head roll hub screw 1 | M2 x 4: bites 2.0 mm |
| PASS | beak fork screw horn 0 | M2 x 6: bites 2.4 mm |
| PASS | beak fork screw horn 1 | M2 x 6: bites 2.4 mm |
| PASS | beak fork screw horn 2 | M2 x 6: bites 2.4 mm |
| PASS | beak fork screw horn 3 | M2 x 6: bites 2.4 mm |
| PASS | hood rear screw 0 | M2 x 8: bites 4.0 mm |
| PASS | hood rear screw 1 | M2 x 8: bites 4.0 mm |
| PASS | R hinge screw | M3 x 10: bites 4.3 mm |

## ACCESS

| status | item | detail |
|---|---|---|
| PASS | L hip pitch cradle screw rear near ear 2 |  |
| PASS | L hip pitch cradle screw rear near ear 3 |  |
| PASS | L knee cradle screw rear near ear 2 |  |
| PASS | L knee cradle screw rear near ear 3 |  |
| PASS | L hip pitch cradle screw horn face 0 |  |
| PASS | L hip pitch cradle screw horn face 1 |  |
| PASS | L knee cradle screw horn face 0 |  |
| PASS | L knee cradle screw horn face 1 |  |
| PASS | L thigh cover screw hip |  |
| PASS | L thigh cover screw knee |  |
| PASS | L ankle pitch cradle screw rear far ear 0 |  |
| PASS | L ankle pitch cradle screw rear far ear 1 |  |
| PASS | L ankle pitch cradle screw rear near ear 2 |  |
| PASS | L ankle pitch cradle screw rear near ear 3 |  |
| PASS | L shoe bottom screw 0 |  |
| PASS | L shoe bottom screw 1 |  |
| PASS | L knee fork screw horn 0 |  |
| PASS | L knee fork screw horn 1 |  |
| PASS | L knee fork screw horn 2 |  |
| PASS | L knee fork screw horn 3 |  |
| PASS | L ankle pitch fork screw horn 0 |  |
| PASS | L ankle pitch fork screw horn 1 |  |
| PASS | L ankle pitch fork screw horn 2 |  |
| PASS | L ankle pitch fork screw horn 3 |  |
| PASS | L ankle ear screw 0 |  |
| PASS | L ankle ear screw 1 |  |
| PASS | L hip pitch fork screw horn 0 |  |
| PASS | L hip pitch fork screw horn 1 |  |
| PASS | L hip pitch fork screw horn 2 |  |
| PASS | L hip pitch fork screw horn 3 |  |
| PASS | R hip pitch cradle screw rear near ear 2 |  |
| PASS | R hip pitch cradle screw rear near ear 3 |  |
| PASS | R knee cradle screw rear near ear 2 |  |
| PASS | R knee cradle screw rear near ear 3 |  |
| PASS | R hip pitch cradle screw horn face 0 |  |
| PASS | R hip pitch cradle screw horn face 1 |  |
| PASS | R knee cradle screw horn face 0 |  |
| PASS | R knee cradle screw horn face 1 |  |
| PASS | R thigh cover screw hip |  |
| PASS | R thigh cover screw knee |  |
| PASS | R ankle pitch cradle screw rear far ear 0 |  |
| PASS | R ankle pitch cradle screw rear far ear 1 |  |
| PASS | R ankle pitch cradle screw rear near ear 2 |  |
| PASS | R ankle pitch cradle screw rear near ear 3 |  |
| PASS | R shoe bottom screw 0 |  |
| PASS | R shoe bottom screw 1 |  |
| PASS | R knee fork screw horn 0 |  |
| PASS | R knee fork screw horn 1 |  |
| PASS | R knee fork screw horn 2 |  |
| PASS | R knee fork screw horn 3 |  |
| PASS | R ankle pitch fork screw horn 0 |  |
| PASS | R ankle pitch fork screw horn 1 |  |
| PASS | R ankle pitch fork screw horn 2 |  |
| PASS | R ankle pitch fork screw horn 3 |  |
| PASS | R ankle ear screw 0 |  |
| PASS | R ankle ear screw 1 |  |
| PASS | R hip pitch fork screw horn 0 |  |
| PASS | R hip pitch fork screw horn 1 |  |
| PASS | R hip pitch fork screw horn 2 |  |
| PASS | R hip pitch fork screw horn 3 |  |
| PASS | L hip yaw cradle screw rear near ear 2 |  |
| PASS | L hip yaw cradle screw rear near ear 3 |  |
| PASS | R hip yaw cradle screw rear near ear 2 |  |
| PASS | R hip yaw cradle screw rear near ear 3 |  |
| PASS | L hip yaw cradle screw horn face 0 |  |
| PASS | L hip yaw cradle screw horn face 1 |  |
| PASS | R hip yaw cradle screw horn face 0 |  |
| PASS | R hip yaw cradle screw horn face 1 |  |
| PASS | L hip yaw fork screw horn 0 |  |
| PASS | L hip yaw fork screw horn 1 |  |
| PASS | L hip yaw fork screw horn 2 |  |
| PASS | L hip yaw fork screw horn 3 |  |
| PASS | R hip yaw fork screw horn 0 |  |
| PASS | R hip yaw fork screw horn 1 |  |
| PASS | R hip yaw fork screw horn 2 |  |
| PASS | R hip yaw fork screw horn 3 |  |
| PASS | L hip roll cradle screw rear near ear 2 |  |
| PASS | L hip roll cradle screw rear near ear 3 |  |
| PASS | R hip roll cradle screw rear near ear 2 |  |
| PASS | R hip roll cradle screw rear near ear 3 |  |
| PASS | L hip roll cradle screw horn face 0 |  |
| PASS | L hip roll cradle screw horn face 1 |  |
| PASS | R hip roll cradle screw horn face 0 |  |
| PASS | R hip roll cradle screw horn face 1 |  |
| PASS | L hip roll fork screw horn 0 |  |
| PASS | L hip roll fork screw horn 1 |  |
| PASS | L hip roll fork screw horn 2 |  |
| PASS | L hip roll fork screw horn 3 |  |
| PASS | R hip roll fork screw horn 0 |  |
| PASS | R hip roll fork screw horn 1 |  |
| PASS | R hip roll fork screw horn 2 |  |
| PASS | R hip roll fork screw horn 3 |  |
| PASS | neck pitch cradle screw rear near ear 2 |  |
| PASS | neck pitch cradle screw rear near ear 3 |  |
| PASS | neck pitch cradle screw horn face 0 |  |
| PASS | neck pitch cradle screw horn face 1 |  |
| PASS | head pitch cradle screw rear near ear 2 |  |
| PASS | head pitch cradle screw rear near ear 3 |  |
| PASS | head pitch cradle screw horn face 0 |  |
| PASS | head pitch cradle screw horn face 1 |  |
| PASS | Pi screw 0 |  |
| PASS | Pi screw 1 |  |
| PASS | Pi screw 2 |  |
| PASS | Pi screw 3 |  |
| PASS | body screw 0 |  |
| PASS | body screw 1 |  |
| PASS | neck pitch fork screw horn 0 |  |
| PASS | neck pitch fork screw horn 1 |  |
| PASS | neck pitch fork screw horn 2 |  |
| PASS | neck pitch fork screw horn 3 |  |
| PASS | neck pitch hub screw 0 |  |
| PASS | neck pitch hub screw 1 |  |
| PASS | head yaw cradle screw rear near ear 1 |  |
| PASS | head yaw cradle screw horn face 0 |  |
| PASS | head yaw cradle screw horn face 2 |  |
| PASS | head yaw fork screw horn 0 |  |
| PASS | head yaw fork screw horn 1 |  |
| PASS | head yaw fork screw horn 2 |  |
| PASS | head yaw fork screw horn 3 |  |
| PASS | head roll cradle screw rear near ear 1 |  |
| PASS | head roll cradle screw horn face 0 |  |
| PASS | head roll cradle screw horn face 2 |  |
| PASS | beak cradle screw rear far ear 0 |  |
| PASS | beak cradle screw rear near ear 1 |  |
| PASS | head pitch fork screw horn 0 |  |
| PASS | head pitch fork screw horn 1 |  |
| PASS | head pitch fork screw horn 2 |  |
| PASS | head pitch fork screw horn 3 |  |
| PASS | head pitch hub screw 0 |  |
| PASS | head pitch hub screw 1 |  |
| PASS | head roll fork screw horn 0 |  |
| PASS | head roll fork screw horn 1 |  |
| PASS | head roll fork screw horn 2 |  |
| PASS | head roll fork screw horn 3 |  |
| PASS | head roll hub screw 0 |  |
| PASS | head roll hub screw 1 |  |
| PASS | beak fork screw horn 0 |  |
| PASS | beak fork screw horn 1 |  |
| PASS | beak fork screw horn 2 |  |
| PASS | beak fork screw horn 3 |  |
| PASS | hood rear screw 0 |  |
| PASS | hood rear screw 1 |  |
| PASS | R hinge screw |  |

## HOLD

| status | item | detail |
|---|---|---|
| PASS | L hip yaw lid | 2 screws |
| PASS | L yaw bracket | 8 screws |
| PASS | L hip roll lid | 2 screws |
| PASS | L roll bracket | 8 screws |
| PASS | L thigh frame | 10 screws |
| PASS | L hip pitch lid | 2 screws |
| PASS | L knee lid | 2 screws |
| PASS | L thigh cover | 2 screws |
| PASS | L shin | 8 screws |
| PASS | L shoe | 8 screws |
| PASS | L sole | 2 screws |
| PASS | L inner ear | 2 screws |
| PASS | R hip yaw lid | 2 screws |
| PASS | R yaw bracket | 8 screws |
| PASS | R hip roll lid | 2 screws |
| PASS | R roll bracket | 8 screws |
| PASS | R thigh frame | 10 screws |
| PASS | R hip pitch lid | 2 screws |
| PASS | R knee lid | 2 screws |
| PASS | R thigh cover | 2 screws |
| PASS | R shin | 8 screws |
| PASS | R shoe | 8 screws |
| PASS | R sole | 2 screws |
| PASS | R inner ear | 2 screws |
| PASS | chassis | 20 screws |
| PASS | body shell | 2 screws |
| PASS | neck column | 8 screws |
| PASS | neck lid | 2 screws |
| PASS | neck pitch rear hub | 2 screws |
| PASS | head pitch rear hub | 2 screws |
| PASS | head roll rear hub | 2 screws |
| PASS | head pitch lid | 2 screws |
| PASS | head fork | 9 screws |
| PASS | head yaw sheet | 2 screws |
| PASS | head yaw bracket | 7 screws |
| PASS | head roll lid | 2 screws |
| PASS | head frame | 11 screws |
| PASS | hood | 3 screws |
| PASS | jaw | turns on its screws |
| PASS | jaw soft insert | glued |
| PASS | mouth roof | glued |
| PASS | face | glued |
| PASS | eye ring | glued |
| PASS | eye iris | glued |

## APART

| status | item | detail |
|---|---|---|
| PASS | bought parts |  |

## ENDS

| status | item | detail |
|---|---|---|
| PASS | L hip yaw | 2 of 4 screws at the near end |
| PASS | R hip yaw | 2 of 4 screws at the near end |
| PASS | L hip roll | 2 of 4 screws at the near end |
| PASS | R hip roll | 2 of 4 screws at the near end |
| PASS | L hip pitch | 2 of 4 screws at the near end |
| PASS | R hip pitch | 2 of 4 screws at the near end |
| PASS | L knee | 2 of 4 screws at the near end |
| PASS | R knee | 2 of 4 screws at the near end |
| PASS | L ankle pitch | 2 of 4 screws at the near end |
| PASS | R ankle pitch | 2 of 4 screws at the near end |
| PASS | neck pitch | 2 of 4 screws at the near end |
| PASS | head pitch | 2 of 4 screws at the near end |
| PASS | head yaw | 1 of 3 screws at the near end |
| PASS | head roll | 1 of 3 screws at the near end |
| PASS | beak | 1 of 2 screws at the near end |

## BOUGHT

| status | item | detail |
|---|---|---|
| PASS | L hip yaw lid |  |
| PASS | L yaw bracket |  |
| PASS | L hip roll lid |  |
| PASS | L roll bracket |  |
| PASS | L thigh frame |  |
| PASS | L hip pitch lid |  |
| PASS | L knee lid |  |
| PASS | L thigh cover |  |
| PASS | L shin |  |
| PASS | L shoe |  |
| PASS | L sole |  |
| PASS | L inner ear |  |
| PASS | R hip yaw lid |  |
| PASS | R yaw bracket |  |
| PASS | R hip roll lid |  |
| PASS | R roll bracket |  |
| PASS | R thigh frame |  |
| PASS | R hip pitch lid |  |
| PASS | R knee lid |  |
| PASS | R thigh cover |  |
| PASS | R shin |  |
| PASS | R shoe |  |
| PASS | R sole |  |
| PASS | R inner ear |  |
| PASS | chassis |  |
| PASS | body shell |  |
| PASS | neck column |  |
| PASS | neck lid |  |
| PASS | neck pitch rear hub |  |
| PASS | head pitch rear hub |  |
| PASS | head roll rear hub |  |
| PASS | head pitch lid |  |
| PASS | head fork |  |
| PASS | head yaw sheet |  |
| PASS | head yaw bracket |  |
| PASS | head roll lid |  |
| PASS | head frame |  |
| PASS | hood |  |
| PASS | jaw |  |
| PASS | jaw soft insert |  |
| PASS | mouth roof |  |
| PASS | face |  |
| PASS | eye ring |  |
| PASS | eye iris |  |

## COLOUR

| status | item | detail |
|---|---|---|
| PASS | L hip yaw lid |  |
| PASS | L yaw bracket |  |
| PASS | L hip roll lid |  |
| PASS | L roll bracket |  |
| PASS | L thigh frame |  |
| PASS | L hip pitch lid |  |
| PASS | L knee lid |  |
| PASS | L thigh cover |  |
| PASS | L shin |  |
| PASS | L shoe |  |
| PASS | L sole |  |
| PASS | L inner ear |  |
| PASS | R hip yaw lid |  |
| PASS | R yaw bracket |  |
| PASS | R hip roll lid |  |
| PASS | R roll bracket |  |
| PASS | R thigh frame |  |
| PASS | R hip pitch lid |  |
| PASS | R knee lid |  |
| PASS | R thigh cover |  |
| PASS | R shin |  |
| PASS | R shoe |  |
| PASS | R sole |  |
| PASS | R inner ear |  |
| PASS | chassis |  |
| PASS | body shell |  |
| PASS | neck column |  |
| PASS | neck lid |  |
| PASS | neck pitch rear hub |  |
| PASS | head pitch rear hub |  |
| PASS | head roll rear hub |  |
| PASS | head pitch lid |  |
| PASS | head fork |  |
| PASS | head yaw sheet |  |
| PASS | head yaw bracket |  |
| PASS | head roll lid |  |
| PASS | head frame |  |
| PASS | hood |  |
| PASS | jaw |  |
| PASS | jaw soft insert |  |
| PASS | mouth roof |  |
| PASS | face |  |
| PASS | eye ring |  |
| PASS | eye iris |  |

## EDGE

| status | item | detail |
|---|---|---|
| PASS | body screw 0 |  |
| PASS | body screw 1 |  |
| PASS | L hip yaw cradle screw horn face 0 |  |
| PASS | L hip yaw cradle screw horn face 1 |  |
| PASS | R hip yaw cradle screw horn face 0 |  |
| PASS | R hip yaw cradle screw horn face 1 |  |
| PASS | neck pitch hub screw 0 |  |
| PASS | neck pitch hub screw 1 |  |
| PASS | neck pitch fork screw horn 0 |  |
| PASS | neck pitch fork screw horn 1 |  |
| PASS | neck pitch fork screw horn 2 |  |
| PASS | neck pitch fork screw horn 3 |  |
| PASS | L hip yaw fork screw horn 0 |  |
| PASS | L hip yaw fork screw horn 1 |  |
| PASS | L hip yaw fork screw horn 2 |  |
| PASS | L hip yaw fork screw horn 3 |  |
| PASS | L hip roll cradle screw horn face 0 |  |
| PASS | L hip roll cradle screw horn face 1 |  |
| PASS | R hip yaw fork screw horn 0 |  |
| PASS | R hip yaw fork screw horn 1 |  |
| PASS | R hip yaw fork screw horn 2 |  |
| PASS | R hip yaw fork screw horn 3 |  |
| PASS | R hip roll cradle screw horn face 0 |  |
| PASS | R hip roll cradle screw horn face 1 |  |
| PASS | L hip roll fork screw horn 0 |  |
| PASS | L hip roll fork screw horn 1 |  |
| PASS | L hip roll fork screw horn 2 |  |
| PASS | L hip roll fork screw horn 3 |  |
| PASS | L hip pitch fork screw horn 0 |  |
| PASS | L hip pitch fork screw horn 1 |  |
| PASS | L hip pitch fork screw horn 2 |  |
| PASS | L hip pitch fork screw horn 3 |  |
| PASS | R hip roll fork screw horn 0 |  |
| PASS | R hip roll fork screw horn 1 |  |
| PASS | R hip roll fork screw horn 2 |  |
| PASS | R hip roll fork screw horn 3 |  |
| PASS | R hip pitch fork screw horn 0 |  |
| PASS | R hip pitch fork screw horn 1 |  |
| PASS | R hip pitch fork screw horn 2 |  |
| PASS | R hip pitch fork screw horn 3 |  |
| PASS | L thigh cover screw hip |  |
| PASS | L thigh cover screw knee |  |
| PASS | L hip pitch cradle screw horn face 0 |  |
| PASS | L hip pitch cradle screw horn face 1 |  |
| PASS | L knee cradle screw horn face 0 |  |
| PASS | L knee cradle screw horn face 1 |  |
| PASS | R thigh cover screw hip |  |
| PASS | R thigh cover screw knee |  |
| PASS | R hip pitch cradle screw horn face 0 |  |
| PASS | R hip pitch cradle screw horn face 1 |  |
| PASS | R knee cradle screw horn face 0 |  |
| PASS | R knee cradle screw horn face 1 |  |
| PASS | L knee fork screw horn 0 |  |
| PASS | L knee fork screw horn 1 |  |
| PASS | L knee fork screw horn 2 |  |
| PASS | L knee fork screw horn 3 |  |
| PASS | R knee fork screw horn 0 |  |
| PASS | R knee fork screw horn 1 |  |
| PASS | R knee fork screw horn 2 |  |
| PASS | R knee fork screw horn 3 |  |
| PASS | L ankle ear screw 0 |  |
| PASS | L ankle ear screw 1 |  |
| PASS | L shoe bottom screw 0 |  |
| PASS | L shoe bottom screw 1 |  |
| PASS | L ankle pitch fork screw horn 0 |  |
| PASS | L ankle pitch fork screw horn 1 |  |
| PASS | L ankle pitch fork screw horn 2 |  |
| PASS | L ankle pitch fork screw horn 3 |  |
| PASS | R ankle ear screw 0 |  |
| PASS | R ankle ear screw 1 |  |
| PASS | R shoe bottom screw 0 |  |
| PASS | R shoe bottom screw 1 |  |
| PASS | R ankle pitch fork screw horn 0 |  |
| PASS | R ankle pitch fork screw horn 1 |  |
| PASS | R ankle pitch fork screw horn 2 |  |
| PASS | R ankle pitch fork screw horn 3 |  |
| PASS | neck pitch cradle screw horn face 0 |  |
| PASS | neck pitch cradle screw horn face 1 |  |
| PASS | head pitch cradle screw horn face 0 |  |
| PASS | head pitch cradle screw horn face 1 |  |
| PASS | head pitch hub screw 0 |  |
| PASS | head pitch hub screw 1 |  |
| PASS | head pitch fork screw horn 0 |  |
| PASS | head pitch fork screw horn 1 |  |
| PASS | head pitch fork screw horn 2 |  |
| PASS | head pitch fork screw horn 3 |  |
| PASS | head yaw cradle screw horn face 0 |  |
| PASS | head yaw cradle screw horn face 2 |  |
| PASS | head yaw fork screw horn 0 |  |
| PASS | head yaw fork screw horn 1 |  |
| PASS | head yaw fork screw horn 2 |  |
| PASS | head yaw fork screw horn 3 |  |
| PASS | head roll cradle screw horn face 0 |  |
| PASS | head roll cradle screw horn face 2 |  |
| PASS | hood rear screw 0 |  |
| PASS | hood rear screw 1 |  |
| PASS | head roll hub screw 0 |  |
| PASS | head roll hub screw 1 |  |
| PASS | head roll fork screw horn 0 |  |
| PASS | head roll fork screw horn 1 |  |
| PASS | head roll fork screw horn 2 |  |
| PASS | head roll fork screw horn 3 |  |
| PASS | beak fork screw horn 0 |  |
| PASS | beak fork screw horn 1 |  |
| PASS | beak fork screw horn 2 |  |
| PASS | beak fork screw horn 3 |  |

## PIERCE

| status | item | detail |
|---|---|---|
| PASS | servo pockets |  |

## SEAT

| status | item | detail |
|---|---|---|
| PASS | L hip yaw |  |
| PASS | R hip yaw |  |
| PASS | L hip roll |  |
| PASS | R hip roll |  |
| PASS | L hip pitch |  |
| PASS | R hip pitch |  |
| PASS | L knee |  |
| PASS | R knee |  |
| PASS | L ankle pitch |  |
| PASS | R ankle pitch |  |
| PASS | neck pitch |  |
| PASS | head pitch |  |
| PASS | head yaw |  |
| PASS | head roll |  |
| PASS | beak |  |

## ALL

| status | item | detail |
|---|---|---|
| PASS | part L hip yaw servo |  |
| PASS | part L hip yaw lid |  |
| PASS | part L hip yaw bearing |  |
| PASS | part L hip yaw horn |  |
| PASS | part L yaw bracket |  |
| PASS | part L hip roll servo |  |
| PASS | part L hip roll lid |  |
| PASS | part L hip roll bearing |  |
| PASS | part L hip roll horn |  |
| PASS | part L roll bracket |  |
| PASS | part L thigh frame |  |
| PASS | part L hip pitch servo |  |
| PASS | part L knee servo |  |
| PASS | part L hip pitch lid |  |
| PASS | part L knee lid |  |
| PASS | part L hip pitch bearing |  |
| PASS | part L knee bearing |  |
| PASS | part L hip pitch horn |  |
| PASS | part L knee horn |  |
| PASS | part L thigh cover |  |
| PASS | part L shin |  |
| PASS | part L ankle servo |  |
| PASS | part L ankle horn |  |
| PASS | part L ankle bearing inner |  |
| PASS | part L shoe |  |
| PASS | part L sole |  |
| PASS | part L inner ear |  |
| PASS | part R hip yaw servo |  |
| PASS | part R hip yaw lid |  |
| PASS | part R hip yaw bearing |  |
| PASS | part R hip yaw horn |  |
| PASS | part R yaw bracket |  |
| PASS | part R hip roll servo |  |
| PASS | part R hip roll lid |  |
| PASS | part R hip roll bearing |  |
| PASS | part R hip roll horn |  |
| PASS | part R roll bracket |  |
| PASS | part R thigh frame |  |
| PASS | part R hip pitch servo |  |
| PASS | part R knee servo |  |
| PASS | part R hip pitch lid |  |
| PASS | part R knee lid |  |
| PASS | part R hip pitch bearing |  |
| PASS | part R knee bearing |  |
| PASS | part R hip pitch horn |  |
| PASS | part R knee horn |  |
| PASS | part R thigh cover |  |
| PASS | part R shin |  |
| PASS | part R ankle servo |  |
| PASS | part R ankle horn |  |
| PASS | part R ankle bearing inner |  |
| PASS | part R shoe |  |
| PASS | part R sole |  |
| PASS | part R inner ear |  |
| PASS | part chassis |  |
| PASS | part battery |  |
| PASS | part battery plugs |  |
| PASS | part IMU |  |
| PASS | part body shell |  |
| PASS | part neck servo |  |
| PASS | part neck column |  |
| PASS | part neck lid |  |
| PASS | part neck pitch rear bearing |  |
| PASS | part head pitch rear bearing |  |
| PASS | part neck pitch rear hub |  |
| PASS | part head pitch rear hub |  |
| PASS | part head roll rear hub |  |
| PASS | part L 6 V BEC |  |
| PASS | part R 6 V BEC |  |
| PASS | part Pi 5 V converter |  |
| PASS | part PWM bonnet |  |
| PASS | part head pitch servo |  |
| PASS | part head pitch lid |  |
| PASS | part head fork |  |
| PASS | part head yaw servo |  |
| PASS | part head yaw sheet |  |
| PASS | part head yaw bearing |  |
| PASS | part head yaw horn |  |
| PASS | part head yaw bracket |  |
| PASS | part head roll servo |  |
| PASS | part head roll rear bearing |  |
| PASS | part head roll lid |  |
| PASS | part head roll bearing |  |
| PASS | part head roll horn |  |
| PASS | part head frame |  |
| PASS | part beak servo |  |
| PASS | part Pi Zero 2 W |  |
| PASS | part camera |  |
| PASS | part hood |  |
| PASS | part jaw |  |
| PASS | part jaw soft insert |  |
| PASS | part mouth roof |  |
| PASS | part face |  |
| PASS | part eye ring |  |
| PASS | part eye iris |  |
