meetsitaram/duck-droids/reports/hobby/buildable.md

# Physical checks

From tools/buildable.py. LOAD is a beam estimate, not FEA: test prints decide.

87 checks: 87 pass, 0 warn, **0 fail**

## LOAD

| status | item | detail |
|---|---|---|
| PASS | shin, under the knee horn | 11.2 MPa (allowed 15): 55 N, section 225 mm2 |
| PASS | shin, at the cap | 6.2 MPa (allowed 15): 55 N, section 309 mm2 |
| PASS | thigh, hip to knee | 0.8 MPa (allowed 15): 55 N, section 575 mm2 |
| PASS | roll bracket, side arm | 12.4 MPa (allowed 15): 55 N, section 110 mm2 |
| PASS | roll bracket, front plate | 14.8 MPa (allowed 15): 55 N, section 60 mm2 |
| PASS | yaw bracket | 3.5 MPa (allowed 15): 55 N, section 596 mm2 |

## ONE

| status | item | detail |
|---|---|---|
| PASS | L hip yaw lid |  |
| PASS | L yaw bracket |  |
| PASS | L hip roll lid |  |
| PASS | L roll bracket |  |
| PASS | L thigh frame |  |
| PASS | L hip pitch lid |  |
| PASS | L knee lid |  |
| PASS | L shin |  |
| PASS | L shoe |  |
| PASS | L sole |  |
| PASS | L inner ear |  |
| PASS | chassis |  |
| PASS | neck column |  |
| PASS | neck lid |  |
| PASS | neck pitch rear hub |  |
| PASS | head pitch rear hub |  |
| PASS | head roll rear hub |  |
| PASS | head pitch lid |  |
| PASS | head fork |  |
| PASS | head yaw bracket |  |
| PASS | head roll lid |  |
| PASS | head frame |  |
| PASS | jaw |  |
| PASS | jaw soft insert |  |
| PASS | face |  |
| PASS | eye ring |  |
| PASS | eye iris |  |

## WALL

| status | item | detail |
|---|---|---|
| PASS | L hip yaw lid |  |
| PASS | L yaw bracket |  |
| PASS | L hip roll lid |  |
| PASS | L roll bracket |  |
| PASS | L thigh frame |  |
| PASS | L hip pitch lid |  |
| PASS | L knee lid |  |
| PASS | L shin |  |
| PASS | L shoe |  |
| PASS | L sole |  |
| PASS | L inner ear |  |
| PASS | chassis |  |
| PASS | neck column |  |
| PASS | neck lid |  |
| PASS | neck pitch rear hub |  |
| PASS | head pitch rear hub |  |
| PASS | head roll rear hub |  |
| PASS | head pitch lid |  |
| PASS | head fork |  |
| PASS | head yaw bracket |  |
| PASS | head roll lid |  |
| PASS | head frame |  |
| PASS | jaw |  |
| PASS | jaw soft insert |  |
| PASS | face |  |
| PASS | eye ring |  |
| PASS | eye iris |  |

## FIT

| status | item | detail |
|---|---|---|
| PASS | L hip yaw lid | 54 x 32 x 12 mm |
| PASS | L yaw bracket | 41 x 28 x 66 mm |
| PASS | L hip roll lid | 12 x 32 x 54 mm |
| PASS | L roll bracket | 41 x 34 x 24 mm |
| PASS | L thigh frame | 87 x 46 x 67 mm |
| PASS | L hip pitch lid | 54 x 12 x 32 mm |
| PASS | L knee lid | 32 x 12 x 54 mm |
| PASS | L shin | 31 x 46 x 92 mm |
| PASS | L shoe | 70 x 58 x 30 mm |
| PASS | L sole | 70 x 58 x 16 mm |
| PASS | L inner ear | 50 x 5 x 30 mm |
| PASS | chassis | 114 x 77 x 68 mm |
| PASS | neck column | 32 x 62 x 113 mm |
| PASS | neck lid | 27 x 12 x 27 mm |
| PASS | neck pitch rear hub | 32 x 10 x 32 mm |
| PASS | head pitch rear hub | 32 x 10 x 32 mm |
| PASS | head roll rear hub | 11 x 28 x 28 mm |
| PASS | head pitch lid | 27 x 12 x 27 mm |
| PASS | head fork | 41 x 57 x 64 mm |
| PASS | head yaw bracket | 27 x 39 x 27 mm |
| PASS | head roll lid | 8 x 39 x 26 mm |
| PASS | head frame | 156 x 112 x 54 mm |
| PASS | jaw | 99 x 117 x 45 mm |
| PASS | jaw soft insert | 31 x 112 x 6 mm |
| PASS | face | 5 x 110 x 56 mm |
| PASS | eye ring | 13 x 38 x 38 mm |
| PASS | eye iris | 11 x 22 x 22 mm |
