meetsitaram/duck-droids/reports/hobby/printable.md

# Physical checks

From tools/printable.py. Overhang from faces, not a slicer: none of this has been printed.

343 checks: 325 pass, 18 warn, **0 fail**

## ORIENT

| status | item | detail |
|---|---|---|
| PASS | L hip yaw lid | 135 mm2 overhang, 241 mm2 on the bed, 53 mm tall |
| PASS | L yaw bracket | 680 mm2 overhang, 1120 mm2 on the bed, 40 mm tall |
| PASS | L hip roll lid | 117 mm2 overhang, 233 mm2 on the bed, 53 mm tall |
| PASS | L roll bracket | 78 mm2 overhang, 573 mm2 on the bed, 40 mm tall |
| PASS | L thigh frame | 3286 mm2 overhang, 594 mm2 on the bed, 86 mm tall |
| PASS | L hip pitch lid | 114 mm2 overhang, 264 mm2 on the bed, 53 mm tall |
| PASS | L knee lid | 112 mm2 overhang, 258 mm2 on the bed, 53 mm tall |
| PASS | L thigh cover | 111 mm2 overhang, 4546 mm2 on the bed, 48 mm tall |
| PASS | L shin | 1148 mm2 overhang, 334 mm2 on the bed, 30 mm tall |
| PASS | L shoe | 688 mm2 overhang, 91 mm2 on the bed, 69 mm tall |
| PASS | L sole | 507 mm2 overhang, 259 mm2 on the bed, 69 mm tall |
| PASS | L inner ear | 0 mm2 overhang, 779 mm2 on the bed, 4 mm tall |
| PASS | R hip yaw lid | 135 mm2 overhang, 241 mm2 on the bed, 53 mm tall |
| PASS | R yaw bracket | 680 mm2 overhang, 1120 mm2 on the bed, 40 mm tall |
| PASS | R hip roll lid | 117 mm2 overhang, 233 mm2 on the bed, 53 mm tall |
| PASS | R roll bracket | 78 mm2 overhang, 573 mm2 on the bed, 40 mm tall |
| PASS | R thigh frame | 3286 mm2 overhang, 594 mm2 on the bed, 86 mm tall |
| PASS | R hip pitch lid | 114 mm2 overhang, 264 mm2 on the bed, 53 mm tall |
| PASS | R knee lid | 112 mm2 overhang, 258 mm2 on the bed, 53 mm tall |
| PASS | R thigh cover | 111 mm2 overhang, 4546 mm2 on the bed, 48 mm tall |
| PASS | R shin | 1148 mm2 overhang, 334 mm2 on the bed, 30 mm tall |
| PASS | R shoe | 688 mm2 overhang, 91 mm2 on the bed, 69 mm tall |
| PASS | R sole | 539 mm2 overhang, 259 mm2 on the bed, 69 mm tall |
| PASS | R inner ear | 0 mm2 overhang, 779 mm2 on the bed, 4 mm tall |
| PASS | chassis | 5324 mm2 overhang, 268 mm2 on the bed, 112 mm tall |
| PASS | body shell | 1756 mm2 overhang, 3014 mm2 on the bed, 97 mm tall |
| PASS | neck column | 1509 mm2 overhang, 715 mm2 on the bed, 61 mm tall |
| PASS | neck lid | 5 mm2 overhang, 657 mm2 on the bed, 10 mm tall |
| PASS | neck pitch rear hub | 0 mm2 overhang, 770 mm2 on the bed, 9 mm tall |
| PASS | head pitch rear hub | 0 mm2 overhang, 770 mm2 on the bed, 9 mm tall |
| PASS | head roll rear hub | 0 mm2 overhang, 585 mm2 on the bed, 10 mm tall |
| PASS | head pitch lid | 4 mm2 overhang, 646 mm2 on the bed, 11 mm tall |
| PASS | head fork | 751 mm2 overhang, 217 mm2 on the bed, 40 mm tall |
| PASS | head yaw sheet | 178 mm2 overhang, 89 mm2 on the bed, 38 mm tall |
| PASS | head yaw bracket | 517 mm2 overhang, 277 mm2 on the bed, 26 mm tall |
| PASS | head roll lid | 73 mm2 overhang, 125 mm2 on the bed, 38 mm tall |
| PASS | head frame | 5237 mm2 overhang, 300 mm2 on the bed, 155 mm tall |
| PASS | hood | 3392 mm2 overhang, 276 mm2 on the bed, 164 mm tall |
| PASS | jaw | 969 mm2 overhang, 1188 mm2 on the bed, 98 mm tall |
| PASS | jaw soft insert | 0 mm2 overhang, 3253 mm2 on the bed, 5 mm tall |
| PASS | mouth roof | 3 mm2 overhang, 4675 mm2 on the bed, 3 mm tall |
| PASS | face | 54 mm2 overhang, 5085 mm2 on the bed, 3 mm tall |
| PASS | eye ring | 0 mm2 overhang, 1008 mm2 on the bed, 12 mm tall |
| PASS | eye iris | 0 mm2 overhang, 268 mm2 on the bed, 10 mm tall |

## PIECES

| status | item | detail |
|---|---|---|
| PASS | L hip yaw lid |  |
| PASS | L yaw bracket |  |
| PASS | L hip roll lid |  |
| PASS | L roll bracket |  |
| PASS | L thigh frame |  |
| PASS | L hip pitch lid |  |
| PASS | L knee lid |  |
| PASS | L thigh cover |  |
| PASS | L shin |  |
| PASS | L shoe |  |
| PASS | L sole |  |
| PASS | L inner ear |  |
| PASS | R hip yaw lid |  |
| PASS | R yaw bracket |  |
| PASS | R hip roll lid |  |
| PASS | R roll bracket |  |
| PASS | R thigh frame |  |
| PASS | R hip pitch lid |  |
| PASS | R knee lid |  |
| PASS | R thigh cover |  |
| PASS | R shin |  |
| PASS | R shoe |  |
| PASS | R sole |  |
| PASS | R inner ear |  |
| PASS | chassis |  |
| PASS | body shell |  |
| PASS | neck column |  |
| PASS | neck lid |  |
| PASS | neck pitch rear hub |  |
| PASS | head pitch rear hub |  |
| PASS | head roll rear hub |  |
| PASS | head pitch lid |  |
| PASS | head fork |  |
| PASS | head yaw sheet |  |
| PASS | head yaw bracket |  |
| PASS | head roll lid |  |
| PASS | head frame |  |
| PASS | hood |  |
| PASS | jaw |  |
| PASS | jaw soft insert |  |
| PASS | mouth roof |  |
| PASS | face |  |
| PASS | eye ring |  |
| PASS | eye iris |  |

## BED

| status | item | detail |
|---|---|---|
| PASS | L hip yaw lid | 11 x 31 x 53 mm, 241 mm2 on the bed |
| PASS | L yaw bracket | 65 x 27 x 40 mm, 1120 mm2 on the bed |
| PASS | L hip roll lid | 11 x 29 x 53 mm, 233 mm2 on the bed |
| PASS | L roll bracket | 23 x 33 x 40 mm, 573 mm2 on the bed |
| PASS | L thigh frame | 66 x 45 x 86 mm, 594 mm2 on the bed |
| PASS | L hip pitch lid | 31 x 11 x 53 mm, 264 mm2 on the bed |
| PASS | L knee lid | 31 x 10 x 53 mm, 258 mm2 on the bed |
| PASS | L thigh cover | 69 x 89 x 48 mm, 4546 mm2 on the bed |
| PASS | L shin | 91 x 45 x 30 mm, 334 mm2 on the bed |
| PASS | L shoe | 29 x 57 x 69 mm, 91 mm2 on the bed |
| PASS | L sole | 15 x 58 x 69 mm, 259 mm2 on the bed |
| PASS | L inner ear | 29 x 48 x 4 mm, 779 mm2 on the bed |
| PASS | R hip yaw lid | 11 x 31 x 53 mm, 241 mm2 on the bed |
| PASS | R yaw bracket | 65 x 27 x 40 mm, 1120 mm2 on the bed |
| PASS | R hip roll lid | 11 x 29 x 53 mm, 233 mm2 on the bed |
| PASS | R roll bracket | 23 x 33 x 40 mm, 573 mm2 on the bed |
| PASS | R thigh frame | 66 x 45 x 86 mm, 594 mm2 on the bed |
| PASS | R hip pitch lid | 31 x 11 x 53 mm, 264 mm2 on the bed |
| PASS | R knee lid | 31 x 10 x 53 mm, 258 mm2 on the bed |
| PASS | R thigh cover | 69 x 89 x 48 mm, 4546 mm2 on the bed |
| PASS | R shin | 91 x 45 x 30 mm, 334 mm2 on the bed |
| PASS | R shoe | 29 x 57 x 69 mm, 91 mm2 on the bed |
| PASS | R sole | 15 x 58 x 69 mm, 259 mm2 on the bed |
| PASS | R inner ear | 29 x 48 x 4 mm, 779 mm2 on the bed |
| PASS | chassis | 67 x 76 x 112 mm, 268 mm2 on the bed |
| PASS | body shell | 72 x 80 x 97 mm, 3014 mm2 on the bed |
| PASS | neck column | 112 x 31 x 61 mm, 715 mm2 on the bed |
| PASS | neck lid | 26 x 26 x 10 mm, 657 mm2 on the bed |
| PASS | neck pitch rear hub | 31 x 32 x 9 mm, 770 mm2 on the bed |
| PASS | head pitch rear hub | 31 x 32 x 9 mm, 770 mm2 on the bed |
| PASS | head roll rear hub | 28 x 27 x 10 mm, 585 mm2 on the bed |
| PASS | head pitch lid | 26 x 26 x 11 mm, 646 mm2 on the bed |
| PASS | head fork | 63 x 56 x 40 mm, 217 mm2 on the bed |
| PASS | head yaw sheet | 9 x 25 x 38 mm, 89 mm2 on the bed |
| PASS | head yaw bracket | 25 x 38 x 26 mm, 277 mm2 on the bed |
| PASS | head roll lid | 25 x 7 x 38 mm, 125 mm2 on the bed |
| PASS | head frame | 53 x 111 x 155 mm, 300 mm2 on the bed |
| PASS | hood | 63 x 116 x 164 mm, 276 mm2 on the bed |
| PASS | jaw | 43 x 116 x 98 mm, 1188 mm2 on the bed |
| PASS | jaw soft insert | 30 x 111 x 5 mm, 3253 mm2 on the bed |
| PASS | mouth roof | 43 x 111 x 3 mm, 4675 mm2 on the bed |
| PASS | face | 55 x 109 x 3 mm, 5085 mm2 on the bed |
| PASS | eye ring | 37 x 38 x 12 mm, 1008 mm2 on the bed |
| PASS | eye iris | 21 x 22 x 10 mm, 268 mm2 on the bed |

## HOLES

| status | item | detail |
|---|---|---|
| PASS | L hip yaw lid |  |
| PASS | L yaw bracket |  |
| PASS | L hip roll lid |  |
| PASS | L roll bracket |  |
| PASS | L thigh frame |  |
| PASS | L hip pitch lid |  |
| PASS | L knee lid |  |
| PASS | L thigh cover |  |
| PASS | L shin |  |
| PASS | L shoe |  |
| PASS | L sole |  |
| PASS | L inner ear |  |
| PASS | R hip yaw lid |  |
| PASS | R yaw bracket |  |
| PASS | R hip roll lid |  |
| PASS | R roll bracket |  |
| PASS | R thigh frame |  |
| PASS | R hip pitch lid |  |
| PASS | R knee lid |  |
| PASS | R thigh cover |  |
| PASS | R shin |  |
| PASS | R shoe |  |
| PASS | R sole |  |
| PASS | R inner ear |  |
| PASS | chassis |  |
| PASS | body shell |  |
| PASS | neck column |  |
| PASS | neck lid |  |
| PASS | neck pitch rear hub |  |
| PASS | head pitch rear hub |  |
| PASS | head roll rear hub |  |
| PASS | head pitch lid |  |
| PASS | head fork |  |
| PASS | head yaw sheet |  |
| PASS | head yaw bracket |  |
| PASS | head roll lid |  |
| PASS | head frame |  |
| PASS | hood |  |
| PASS | jaw |  |
| PASS | jaw soft insert |  |
| PASS | mouth roof |  |
| PASS | face |  |
| PASS | eye ring |  |
| PASS | eye iris |  |

## SUPPORT

| status | item | detail |
|---|---|---|
| WARN | L yaw bracket | 680 mm2 needs support or a bridge: check it in the slicer |
| WARN | L thigh frame | 3286 mm2 needs support or a bridge: check it in the slicer |
| WARN | L shin | 1148 mm2 needs support or a bridge: check it in the slicer |
| WARN | L shoe | 688 mm2 needs support or a bridge: check it in the slicer |
| WARN | L sole | 507 mm2 needs support or a bridge: check it in the slicer |
| WARN | R yaw bracket | 680 mm2 needs support or a bridge: check it in the slicer |
| WARN | R thigh frame | 3286 mm2 needs support or a bridge: check it in the slicer |
| WARN | R shin | 1148 mm2 needs support or a bridge: check it in the slicer |
| WARN | R shoe | 688 mm2 needs support or a bridge: check it in the slicer |
| WARN | R sole | 539 mm2 needs support or a bridge: check it in the slicer |
| WARN | chassis | 5324 mm2 needs support or a bridge: check it in the slicer |
| WARN | body shell | 1756 mm2 needs support or a bridge: check it in the slicer |
| WARN | neck column | 1509 mm2 needs support or a bridge: check it in the slicer |
| WARN | head fork | 751 mm2 needs support or a bridge: check it in the slicer |
| WARN | head yaw bracket | 517 mm2 needs support or a bridge: check it in the slicer |
| WARN | head frame | 5237 mm2 needs support or a bridge: check it in the slicer |
| WARN | hood | 3392 mm2 needs support or a bridge: check it in the slicer |
| WARN | jaw | 969 mm2 needs support or a bridge: check it in the slicer |

## SKIN

| status | item | detail |
|---|---|---|
| PASS | L thigh cover | 2 screws drill it: ['L thigh cover screw hip', 'L thigh cover screw knee'] |
| PASS | R thigh cover | 2 screws drill it: ['R thigh cover screw hip', 'R thigh cover screw knee'] |
| PASS | body shell | 2 screws drill it: ['body screw 0', 'body screw 1'] |
| PASS | hood | 3 screws drill it: ['R hinge screw', 'hood rear screw 0', 'hood rear screw 1'] |
| PASS | mouth roof | 0 screws drill it: [] |

## MATE

| status | item | detail |
|---|---|---|
| PASS | parts that share a link | 44 parts: 0 clashes |

## HEADS

| status | item | detail |
|---|---|---|
| PASS | Pi screw 0 |  |
| PASS | Pi screw 1 |  |
| PASS | Pi screw 2 |  |
| PASS | Pi screw 3 |  |
| PASS | body screw 0 |  |
| PASS | body screw 1 |  |
| PASS | L hip yaw cradle screw horn face 0 |  |
| PASS | L hip yaw cradle screw horn face 1 |  |
| PASS | L hip yaw cradle screw rear near ear 2 |  |
| PASS | L hip yaw cradle screw rear near ear 3 |  |
| PASS | R hip yaw cradle screw horn face 0 |  |
| PASS | R hip yaw cradle screw horn face 1 |  |
| PASS | R hip yaw cradle screw rear near ear 2 |  |
| PASS | R hip yaw cradle screw rear near ear 3 |  |
| PASS | neck pitch hub screw 0 |  |
| PASS | neck pitch hub screw 1 |  |
| PASS | neck pitch fork screw horn 0 |  |
| PASS | neck pitch fork screw horn 1 |  |
| PASS | neck pitch fork screw horn 2 |  |
| PASS | neck pitch fork screw horn 3 |  |
| PASS | L hip yaw fork screw horn 0 |  |
| PASS | L hip yaw fork screw horn 1 |  |
| PASS | L hip yaw fork screw horn 2 |  |
| PASS | L hip yaw fork screw horn 3 |  |
| PASS | L hip roll cradle screw horn face 0 |  |
| PASS | L hip roll cradle screw horn face 1 |  |
| PASS | L hip roll cradle screw rear near ear 2 |  |
| PASS | L hip roll cradle screw rear near ear 3 |  |
| PASS | R hip yaw fork screw horn 0 |  |
| PASS | R hip yaw fork screw horn 1 |  |
| PASS | R hip yaw fork screw horn 2 |  |
| PASS | R hip yaw fork screw horn 3 |  |
| PASS | R hip roll cradle screw horn face 0 |  |
| PASS | R hip roll cradle screw horn face 1 |  |
| PASS | R hip roll cradle screw rear near ear 2 |  |
| PASS | R hip roll cradle screw rear near ear 3 |  |
| PASS | L hip roll fork screw horn 0 |  |
| PASS | L hip roll fork screw horn 1 |  |
| PASS | L hip roll fork screw horn 2 |  |
| PASS | L hip roll fork screw horn 3 |  |
| PASS | L hip pitch fork screw horn 0 |  |
| PASS | L hip pitch fork screw horn 1 |  |
| PASS | L hip pitch fork screw horn 2 |  |
| PASS | L hip pitch fork screw horn 3 |  |
| PASS | R hip roll fork screw horn 0 |  |
| PASS | R hip roll fork screw horn 1 |  |
| PASS | R hip roll fork screw horn 2 |  |
| PASS | R hip roll fork screw horn 3 |  |
| PASS | R hip pitch fork screw horn 0 |  |
| PASS | R hip pitch fork screw horn 1 |  |
| PASS | R hip pitch fork screw horn 2 |  |
| PASS | R hip pitch fork screw horn 3 |  |
| PASS | L thigh cover screw hip |  |
| PASS | L thigh cover screw knee |  |
| PASS | L hip pitch cradle screw horn face 0 |  |
| PASS | L hip pitch cradle screw horn face 1 |  |
| PASS | L hip pitch cradle screw rear near ear 2 |  |
| PASS | L hip pitch cradle screw rear near ear 3 |  |
| PASS | L knee cradle screw horn face 0 |  |
| PASS | L knee cradle screw horn face 1 |  |
| PASS | L knee cradle screw rear near ear 2 |  |
| PASS | L knee cradle screw rear near ear 3 |  |
| PASS | R thigh cover screw hip |  |
| PASS | R thigh cover screw knee |  |
| PASS | R hip pitch cradle screw horn face 0 |  |
| PASS | R hip pitch cradle screw horn face 1 |  |
| PASS | R hip pitch cradle screw rear near ear 2 |  |
| PASS | R hip pitch cradle screw rear near ear 3 |  |
| PASS | R knee cradle screw horn face 0 |  |
| PASS | R knee cradle screw horn face 1 |  |
| PASS | R knee cradle screw rear near ear 2 |  |
| PASS | R knee cradle screw rear near ear 3 |  |
| PASS | L knee fork screw horn 0 |  |
| PASS | L knee fork screw horn 1 |  |
| PASS | L knee fork screw horn 2 |  |
| PASS | L knee fork screw horn 3 |  |
| PASS | L ankle pitch cradle screw rear far ear 0 |  |
| PASS | L ankle pitch cradle screw rear far ear 1 |  |
| PASS | L ankle pitch cradle screw rear near ear 2 |  |
| PASS | L ankle pitch cradle screw rear near ear 3 |  |
| PASS | R knee fork screw horn 0 |  |
| PASS | R knee fork screw horn 1 |  |
| PASS | R knee fork screw horn 2 |  |
| PASS | R knee fork screw horn 3 |  |
| PASS | R ankle pitch cradle screw rear far ear 0 |  |
| PASS | R ankle pitch cradle screw rear far ear 1 |  |
| PASS | R ankle pitch cradle screw rear near ear 2 |  |
| PASS | R ankle pitch cradle screw rear near ear 3 |  |
| PASS | L ankle ear screw 0 |  |
| PASS | L ankle ear screw 1 |  |
| PASS | L shoe bottom screw 0 |  |
| PASS | L shoe bottom screw 1 |  |
| PASS | L ankle pitch fork screw horn 0 |  |
| PASS | L ankle pitch fork screw horn 1 |  |
| PASS | L ankle pitch fork screw horn 2 |  |
| PASS | L ankle pitch fork screw horn 3 |  |
| PASS | R ankle ear screw 0 |  |
| PASS | R ankle ear screw 1 |  |
| PASS | R shoe bottom screw 0 |  |
| PASS | R shoe bottom screw 1 |  |
| PASS | R ankle pitch fork screw horn 0 |  |
| PASS | R ankle pitch fork screw horn 1 |  |
| PASS | R ankle pitch fork screw horn 2 |  |
| PASS | R ankle pitch fork screw horn 3 |  |
| PASS | neck pitch cradle screw horn face 0 |  |
| PASS | neck pitch cradle screw horn face 1 |  |
| PASS | neck pitch cradle screw rear near ear 2 |  |
| PASS | neck pitch cradle screw rear near ear 3 |  |
| PASS | head pitch cradle screw horn face 0 |  |
| PASS | head pitch cradle screw horn face 1 |  |
| PASS | head pitch cradle screw rear near ear 2 |  |
| PASS | head pitch cradle screw rear near ear 3 |  |
| PASS | head pitch hub screw 0 |  |
| PASS | head pitch hub screw 1 |  |
| PASS | head pitch fork screw horn 0 |  |
| PASS | head pitch fork screw horn 1 |  |
| PASS | head pitch fork screw horn 2 |  |
| PASS | head pitch fork screw horn 3 |  |
| PASS | head yaw cradle screw horn face 0 |  |
| PASS | head yaw cradle screw rear near ear 1 |  |
| PASS | head yaw cradle screw horn face 2 |  |
| PASS | head yaw fork screw horn 0 |  |
| PASS | head yaw fork screw horn 1 |  |
| PASS | head yaw fork screw horn 2 |  |
| PASS | head yaw fork screw horn 3 |  |
| PASS | head roll cradle screw horn face 0 |  |
| PASS | head roll cradle screw rear near ear 1 |  |
| PASS | head roll cradle screw horn face 2 |  |
| PASS | R hinge screw |  |
| PASS | hood rear screw 0 |  |
| PASS | hood rear screw 1 |  |
| PASS | head roll hub screw 0 |  |
| PASS | head roll hub screw 1 |  |
| PASS | head roll fork screw horn 0 |  |
| PASS | head roll fork screw horn 1 |  |
| PASS | head roll fork screw horn 2 |  |
| PASS | head roll fork screw horn 3 |  |
| PASS | beak cradle screw rear far ear 0 |  |
| PASS | beak cradle screw rear near ear 1 |  |
| PASS | beak fork screw horn 0 |  |
| PASS | beak fork screw horn 1 |  |
| PASS | beak fork screw horn 2 |  |
| PASS | beak fork screw horn 3 |  |
