meetsitaram/duck-droids/reports/feetech/prints_audit.md

# Physical checks

From tools/audit_prints.py: the STL files themselves.

252 checks: 252 pass, 0 warn, **0 fail**

## PIECES

| status | item | detail |
|---|---|---|
| PASS | L hip yaw lid |  |
| PASS | L yaw bracket |  |
| PASS | L hip roll lid |  |
| PASS | L roll bracket |  |
| PASS | L thigh frame |  |
| PASS | L hip pitch lid |  |
| PASS | L knee lid |  |
| PASS | L thigh cover |  |
| PASS | L shin |  |
| PASS | L shoe |  |
| PASS | L sole |  |
| PASS | L inner ear |  |
| PASS | R hip yaw lid |  |
| PASS | R yaw bracket |  |
| PASS | R hip roll lid |  |
| PASS | R roll bracket |  |
| PASS | R thigh frame |  |
| PASS | R hip pitch lid |  |
| PASS | R knee lid |  |
| PASS | R thigh cover |  |
| PASS | R shin |  |
| PASS | R shoe |  |
| PASS | R sole |  |
| PASS | R inner ear |  |
| PASS | chassis |  |
| PASS | body shell |  |
| PASS | neck column |  |
| PASS | neck lid |  |
| PASS | head pitch lid |  |
| PASS | head fork |  |
| PASS | head yaw sheet |  |
| PASS | head yaw bracket |  |
| PASS | head roll lid |  |
| PASS | head roll spacer |  |
| PASS | head frame |  |
| PASS | hood |  |
| PASS | jaw |  |
| PASS | jaw soft insert |  |
| PASS | mouth roof |  |
| PASS | face |  |
| PASS | eye ring |  |
| PASS | eye iris |  |

## CLOSED

| status | item | detail |
|---|---|---|
| PASS | L hip yaw lid |  |
| PASS | L yaw bracket |  |
| PASS | L hip roll lid |  |
| PASS | L roll bracket |  |
| PASS | L thigh frame |  |
| PASS | L hip pitch lid |  |
| PASS | L knee lid |  |
| PASS | L thigh cover |  |
| PASS | L shin |  |
| PASS | L shoe |  |
| PASS | L sole |  |
| PASS | L inner ear |  |
| PASS | R hip yaw lid |  |
| PASS | R yaw bracket |  |
| PASS | R hip roll lid |  |
| PASS | R roll bracket |  |
| PASS | R thigh frame |  |
| PASS | R hip pitch lid |  |
| PASS | R knee lid |  |
| PASS | R thigh cover |  |
| PASS | R shin |  |
| PASS | R shoe |  |
| PASS | R sole |  |
| PASS | R inner ear |  |
| PASS | chassis |  |
| PASS | body shell |  |
| PASS | neck column |  |
| PASS | neck lid |  |
| PASS | head pitch lid |  |
| PASS | head fork |  |
| PASS | head yaw sheet |  |
| PASS | head yaw bracket |  |
| PASS | head roll lid |  |
| PASS | head roll spacer |  |
| PASS | head frame |  |
| PASS | hood |  |
| PASS | jaw |  |
| PASS | jaw soft insert |  |
| PASS | mouth roof |  |
| PASS | face |  |
| PASS | eye ring |  |
| PASS | eye iris |  |

## VOLUME

| status | item | detail |
|---|---|---|
| PASS | L hip yaw lid | 2.9 cm3, designed 2.9: 0 % off |
| PASS | L yaw bracket | 16.3 cm3, designed 16.5: 1 % off |
| PASS | L hip roll lid | 2.5 cm3, designed 2.5: 0 % off |
| PASS | L roll bracket | 5.6 cm3, designed 5.7: 1 % off |
| PASS | L thigh frame | 18.1 cm3, designed 18.3: 1 % off |
| PASS | L hip pitch lid | 3.0 cm3, designed 3.0: 0 % off |
| PASS | L knee lid | 2.9 cm3, designed 2.9: 0 % off |
| PASS | L thigh cover | 24.4 cm3, designed 25.7: 5 % off |
| PASS | L shin | 12.7 cm3, designed 12.8: 1 % off |
| PASS | L shoe | 15.8 cm3, designed 15.7: 0 % off |
| PASS | L sole | 41.5 cm3, designed 40.8: 2 % off |
| PASS | L inner ear | 2.5 cm3, designed 2.5: 0 % off |
| PASS | R hip yaw lid | 2.9 cm3, designed 2.9: 0 % off |
| PASS | R yaw bracket | 16.3 cm3, designed 16.5: 1 % off |
| PASS | R hip roll lid | 2.5 cm3, designed 2.5: 0 % off |
| PASS | R roll bracket | 5.6 cm3, designed 5.7: 1 % off |
| PASS | R thigh frame | 18.2 cm3, designed 18.3: 1 % off |
| PASS | R hip pitch lid | 3.0 cm3, designed 3.0: 0 % off |
| PASS | R knee lid | 2.9 cm3, designed 2.9: 0 % off |
| PASS | R thigh cover | 24.4 cm3, designed 25.7: 5 % off |
| PASS | R shin | 12.7 cm3, designed 12.8: 1 % off |
| PASS | R shoe | 15.7 cm3, designed 15.7: 0 % off |
| PASS | R sole | 41.5 cm3, designed 40.8: 2 % off |
| PASS | R inner ear | 2.5 cm3, designed 2.5: 0 % off |
| PASS | chassis | 55.3 cm3, designed 55.5: 0 % off |
| PASS | body shell | 27.4 cm3, designed 28.2: 3 % off |
| PASS | neck column | 11.1 cm3, designed 11.3: 2 % off |
| PASS | neck lid | 0.7 cm3, designed 0.7: 0 % off |
| PASS | head pitch lid | 0.8 cm3, designed 0.8: 0 % off |
| PASS | head fork | 18.8 cm3, designed 18.8: 0 % off |
| PASS | head yaw sheet | 1.3 cm3, designed 1.3: 0 % off |
| PASS | head yaw bracket | 13.5 cm3, designed 13.7: 1 % off |
| PASS | head roll lid | 3.0 cm3, designed 3.0: 0 % off |
| PASS | head roll spacer | 0.7 cm3, designed 0.7: 0 % off |
| PASS | head frame | 84.7 cm3, designed 84.6: 0 % off |
| PASS | hood | 79.0 cm3, designed 79.4: 1 % off |
| PASS | jaw | 47.3 cm3, designed 47.3: 0 % off |
| PASS | jaw soft insert | 22.7 cm3, designed 22.7: 0 % off |
| PASS | mouth roof | 19.9 cm3, designed 19.9: 0 % off |
| PASS | face | 14.3 cm3, designed 14.3: 0 % off |
| PASS | eye ring | 6.6 cm3, designed 6.5: 0 % off |
| PASS | eye iris | 2.2 cm3, designed 2.2: 0 % off |

## BED

| status | item | detail |
|---|---|---|
| PASS | L hip yaw lid | 51 x 31 x 6 mm |
| PASS | L yaw bracket | 62 x 41 x 30 mm |
| PASS | L hip roll lid | 51 x 29 x 6 mm |
| PASS | L roll bracket | 38 x 36 x 22 mm |
| PASS | L thigh frame | 81 x 61 x 46 mm |
| PASS | L hip pitch lid | 51 x 31 x 6 mm |
| PASS | L knee lid | 51 x 31 x 6 mm |
| PASS | L thigh cover | 87 x 67 x 46 mm |
| PASS | L shin | 79 x 42 x 31 mm |
| PASS | L shoe | 69 x 53 x 29 mm |
| PASS | L sole | 70 x 53 x 15 mm |
| PASS | L inner ear | 48 x 29 x 4 mm |
| PASS | R hip yaw lid | 51 x 31 x 6 mm |
| PASS | R yaw bracket | 62 x 41 x 30 mm |
| PASS | R hip roll lid | 51 x 29 x 6 mm |
| PASS | R roll bracket | 38 x 36 x 22 mm |
| PASS | R thigh frame | 81 x 61 x 46 mm |
| PASS | R hip pitch lid | 51 x 31 x 6 mm |
| PASS | R knee lid | 51 x 31 x 6 mm |
| PASS | R thigh cover | 87 x 67 x 46 mm |
| PASS | R shin | 79 x 42 x 31 mm |
| PASS | R shoe | 69 x 53 x 29 mm |
| PASS | R sole | 70 x 53 x 15 mm |
| PASS | R inner ear | 48 x 29 x 4 mm |
| PASS | chassis | 101 x 65 x 52 mm |
| PASS | body shell | 94 x 80 x 49 mm |
| PASS | neck column | 49 x 46 x 31 mm |
| PASS | neck lid | 31 x 9 x 3 mm |
| PASS | head pitch lid | 31 x 9 x 3 mm |
| PASS | head fork | 73 x 54 x 48 mm |
| PASS | head yaw sheet | 51 x 31 x 4 mm |
| PASS | head yaw bracket | 48 x 41 x 38 mm |
| PASS | head roll lid | 51 x 31 x 6 mm |
| PASS | head roll spacer | 20 x 20 x 3 mm |
| PASS | head frame | 181 x 131 x 65 mm |
| PASS | hood | 192 x 135 x 73 mm |
| PASS | jaw | 135 x 108 x 48 mm |
| PASS | jaw soft insert | 131 x 35 x 5 mm |
| PASS | mouth roof | 131 x 49 x 3 mm |
| PASS | face | 129 x 65 x 4 mm |
| PASS | eye ring | 44 x 44 x 14 mm |
| PASS | eye iris | 25 x 25 x 6 mm |

## THIN

| status | item | detail |
|---|---|---|
| PASS | L hip yaw lid | 4 % of its surface is under 0.8 mm thick |
| PASS | L yaw bracket | 0 % of its surface is under 0.8 mm thick |
| PASS | L hip roll lid | 9 % of its surface is under 0.8 mm thick |
| PASS | L roll bracket | 1 % of its surface is under 0.8 mm thick |
| PASS | L thigh frame | 0 % of its surface is under 0.8 mm thick |
| PASS | L hip pitch lid | 4 % of its surface is under 0.8 mm thick |
| PASS | L knee lid | 5 % of its surface is under 0.8 mm thick |
| PASS | L thigh cover | 1 % of its surface is under 0.8 mm thick |
| PASS | L shin | 0 % of its surface is under 0.8 mm thick |
| PASS | L shoe | 9 % of its surface is under 0.8 mm thick |
| PASS | L sole | 4 % of its surface is under 0.8 mm thick |
| PASS | L inner ear | 0 % of its surface is under 0.8 mm thick |
| PASS | R hip yaw lid | 4 % of its surface is under 0.8 mm thick |
| PASS | R yaw bracket | 0 % of its surface is under 0.8 mm thick |
| PASS | R hip roll lid | 9 % of its surface is under 0.8 mm thick |
| PASS | R roll bracket | 1 % of its surface is under 0.8 mm thick |
| PASS | R thigh frame | 0 % of its surface is under 0.8 mm thick |
| PASS | R hip pitch lid | 5 % of its surface is under 0.8 mm thick |
| PASS | R knee lid | 5 % of its surface is under 0.8 mm thick |
| PASS | R thigh cover | 2 % of its surface is under 0.8 mm thick |
| PASS | R shin | 0 % of its surface is under 0.8 mm thick |
| PASS | R shoe | 7 % of its surface is under 0.8 mm thick |
| PASS | R sole | 4 % of its surface is under 0.8 mm thick |
| PASS | R inner ear | 0 % of its surface is under 0.8 mm thick |
| PASS | chassis | 0 % of its surface is under 0.8 mm thick |
| PASS | body shell | 4 % of its surface is under 0.8 mm thick |
| PASS | neck column | 0 % of its surface is under 0.8 mm thick |
| PASS | neck lid | 5 % of its surface is under 0.8 mm thick |
| PASS | head pitch lid | 0 % of its surface is under 0.8 mm thick |
| PASS | head fork | 0 % of its surface is under 0.8 mm thick |
| PASS | head yaw sheet | 5 % of its surface is under 0.8 mm thick |
| PASS | head yaw bracket | 1 % of its surface is under 0.8 mm thick |
| PASS | head roll lid | 5 % of its surface is under 0.8 mm thick |
| PASS | head roll spacer | 0 % of its surface is under 0.8 mm thick |
| PASS | head frame | 0 % of its surface is under 0.8 mm thick |
| PASS | hood | 1 % of its surface is under 0.8 mm thick |
| PASS | jaw | 0 % of its surface is under 0.8 mm thick |
| PASS | jaw soft insert | 0 % of its surface is under 0.8 mm thick |
| PASS | mouth roof | 0 % of its surface is under 0.8 mm thick |
| PASS | face | 1 % of its surface is under 0.8 mm thick |
| PASS | eye ring | 0 % of its surface is under 0.8 mm thick |
| PASS | eye iris | 0 % of its surface is under 0.8 mm thick |

## FILE

| status | item | detail |
|---|---|---|
| PASS | L_hip_pitch_lid.stl |  |
| PASS | L_hip_roll_lid.stl |  |
| PASS | L_hip_yaw_lid.stl |  |
| PASS | L_inner_ear.stl |  |
| PASS | L_knee_lid.stl |  |
| PASS | L_roll_bracket.stl |  |
| PASS | L_shin.stl |  |
| PASS | L_shoe.stl |  |
| PASS | L_sole.stl |  |
| PASS | L_thigh_cover.stl |  |
| PASS | L_thigh_frame.stl |  |
| PASS | L_yaw_bracket.stl |  |
| PASS | R_hip_pitch_lid.stl |  |
| PASS | R_hip_roll_lid.stl |  |
| PASS | R_hip_yaw_lid.stl |  |
| PASS | R_inner_ear.stl |  |
| PASS | R_knee_lid.stl |  |
| PASS | R_roll_bracket.stl |  |
| PASS | R_shin.stl |  |
| PASS | R_shoe.stl |  |
| PASS | R_sole.stl |  |
| PASS | R_thigh_cover.stl |  |
| PASS | R_thigh_frame.stl |  |
| PASS | R_yaw_bracket.stl |  |
| PASS | body_shell.stl |  |
| PASS | chassis.stl |  |
| PASS | eye_iris.stl |  |
| PASS | eye_ring.stl |  |
| PASS | face.stl |  |
| PASS | head_fork.stl |  |
| PASS | head_frame.stl |  |
| PASS | head_pitch_lid.stl |  |
| PASS | head_roll_lid.stl |  |
| PASS | head_roll_spacer.stl |  |
| PASS | head_yaw_bracket.stl |  |
| PASS | head_yaw_sheet.stl |  |
| PASS | hood.stl |  |
| PASS | jaw.stl |  |
| PASS | jaw_soft_insert.stl |  |
| PASS | mouth_roof.stl |  |
| PASS | neck_column.stl |  |
| PASS | neck_lid.stl |  |
