meetsitaram/duck-droids/reports/hd1910/prints_audit.md

# Physical checks

From tools/audit_prints.py: the STL files themselves.

258 checks: 258 pass, 0 warn, **0 fail**

## PIECES

| status | item | detail |
|---|---|---|
| PASS | L hip yaw lid |  |
| PASS | L yaw bracket |  |
| PASS | L hip roll lid |  |
| PASS | L roll bracket |  |
| PASS | L thigh frame |  |
| PASS | L hip pitch lid |  |
| PASS | L knee lid |  |
| PASS | L thigh cover |  |
| PASS | L shin |  |
| PASS | L shoe |  |
| PASS | L sole |  |
| PASS | L inner ear |  |
| PASS | R hip yaw lid |  |
| PASS | R yaw bracket |  |
| PASS | R hip roll lid |  |
| PASS | R roll bracket |  |
| PASS | R thigh frame |  |
| PASS | R hip pitch lid |  |
| PASS | R knee lid |  |
| PASS | R thigh cover |  |
| PASS | R shin |  |
| PASS | R shoe |  |
| PASS | R sole |  |
| PASS | R inner ear |  |
| PASS | chassis |  |
| PASS | body shell |  |
| PASS | neck column |  |
| PASS | neck lid |  |
| PASS | head pitch lid |  |
| PASS | head fork |  |
| PASS | head yaw sheet |  |
| PASS | head yaw bracket |  |
| PASS | head roll lid |  |
| PASS | head roll spacer |  |
| PASS | head roll rear spacer |  |
| PASS | head frame |  |
| PASS | hood |  |
| PASS | jaw |  |
| PASS | jaw soft insert |  |
| PASS | mouth roof |  |
| PASS | face |  |
| PASS | eye ring |  |
| PASS | eye iris |  |

## CLOSED

| status | item | detail |
|---|---|---|
| PASS | L hip yaw lid |  |
| PASS | L yaw bracket |  |
| PASS | L hip roll lid |  |
| PASS | L roll bracket |  |
| PASS | L thigh frame |  |
| PASS | L hip pitch lid |  |
| PASS | L knee lid |  |
| PASS | L thigh cover |  |
| PASS | L shin |  |
| PASS | L shoe |  |
| PASS | L sole |  |
| PASS | L inner ear |  |
| PASS | R hip yaw lid |  |
| PASS | R yaw bracket |  |
| PASS | R hip roll lid |  |
| PASS | R roll bracket |  |
| PASS | R thigh frame |  |
| PASS | R hip pitch lid |  |
| PASS | R knee lid |  |
| PASS | R thigh cover |  |
| PASS | R shin |  |
| PASS | R shoe |  |
| PASS | R sole |  |
| PASS | R inner ear |  |
| PASS | chassis |  |
| PASS | body shell |  |
| PASS | neck column |  |
| PASS | neck lid |  |
| PASS | head pitch lid |  |
| PASS | head fork |  |
| PASS | head yaw sheet |  |
| PASS | head yaw bracket |  |
| PASS | head roll lid |  |
| PASS | head roll spacer |  |
| PASS | head roll rear spacer |  |
| PASS | head frame |  |
| PASS | hood |  |
| PASS | jaw |  |
| PASS | jaw soft insert |  |
| PASS | mouth roof |  |
| PASS | face |  |
| PASS | eye ring |  |
| PASS | eye iris |  |

## VOLUME

| status | item | detail |
|---|---|---|
| PASS | L hip yaw lid | 1.5 cm3, designed 1.5: 0 % off |
| PASS | L yaw bracket | 8.0 cm3, designed 8.1: 2 % off |
| PASS | L hip roll lid | 1.2 cm3, designed 1.2: 0 % off |
| PASS | L roll bracket | 3.5 cm3, designed 3.5: 2 % off |
| PASS | L thigh frame | 10.5 cm3, designed 10.7: 2 % off |
| PASS | L hip pitch lid | 1.5 cm3, designed 1.5: 0 % off |
| PASS | L knee lid | 1.4 cm3, designed 1.4: 0 % off |
| PASS | L thigh cover | 14.9 cm3, designed 15.9: 7 % off |
| PASS | L shin | 6.4 cm3, designed 6.5: 1 % off |
| PASS | L shoe | 11.5 cm3, designed 11.5: 0 % off |
| PASS | L sole | 25.1 cm3, designed 24.8: 1 % off |
| PASS | L inner ear | 2.2 cm3, designed 2.2: 0 % off |
| PASS | R hip yaw lid | 1.5 cm3, designed 1.5: 0 % off |
| PASS | R yaw bracket | 8.0 cm3, designed 8.1: 2 % off |
| PASS | R hip roll lid | 1.2 cm3, designed 1.2: 0 % off |
| PASS | R roll bracket | 3.5 cm3, designed 3.5: 1 % off |
| PASS | R thigh frame | 10.5 cm3, designed 10.7: 2 % off |
| PASS | R hip pitch lid | 1.5 cm3, designed 1.5: 0 % off |
| PASS | R knee lid | 1.4 cm3, designed 1.4: 0 % off |
| PASS | R thigh cover | 14.8 cm3, designed 15.9: 7 % off |
| PASS | R shin | 6.4 cm3, designed 6.5: 1 % off |
| PASS | R shoe | 11.5 cm3, designed 11.5: 0 % off |
| PASS | R sole | 25.1 cm3, designed 24.8: 1 % off |
| PASS | R inner ear | 2.2 cm3, designed 2.2: 0 % off |
| PASS | chassis | 27.4 cm3, designed 27.5: 1 % off |
| PASS | body shell | 21.5 cm3, designed 22.1: 3 % off |
| PASS | neck column | 3.5 cm3, designed 3.6: 1 % off |
| PASS | neck lid | 0.2 cm3, designed 0.2: 0 % off |
| PASS | head pitch lid | 0.2 cm3, designed 0.2: 0 % off |
| PASS | head fork | 8.9 cm3, designed 9.0: 2 % off |
| PASS | head yaw sheet | 0.8 cm3, designed 0.8: 0 % off |
| PASS | head yaw bracket | 5.6 cm3, designed 5.7: 2 % off |
| PASS | head roll lid | 1.5 cm3, designed 1.5: 0 % off |
| PASS | head roll spacer | 0.3 cm3, designed 0.3: 0 % off |
| PASS | head roll rear spacer | 0.3 cm3, designed 0.3: 0 % off |
| PASS | head frame | 54.1 cm3, designed 54.1: 0 % off |
| PASS | hood | 48.3 cm3, designed 48.6: 1 % off |
| PASS | jaw | 29.6 cm3, designed 29.6: 0 % off |
| PASS | jaw soft insert | 13.3 cm3, designed 13.3: 0 % off |
| PASS | mouth roof | 12.6 cm3, designed 12.6: 0 % off |
| PASS | face | 8.3 cm3, designed 8.3: 0 % off |
| PASS | eye ring | 7.4 cm3, designed 7.4: 0 % off |
| PASS | eye iris | 1.9 cm3, designed 1.9: 0 % off |

## BED

| status | item | detail |
|---|---|---|
| PASS | L hip yaw lid | 37 x 26 x 3 mm |
| PASS | L yaw bracket | 48 x 29 x 26 mm |
| PASS | L hip roll lid | 37 x 24 x 3 mm |
| PASS | L roll bracket | 31 x 30 x 18 mm |
| PASS | L thigh frame | 66 x 51 x 34 mm |
| PASS | L hip pitch lid | 37 x 26 x 3 mm |
| PASS | L knee lid | 37 x 26 x 3 mm |
| PASS | L thigh cover | 70 x 55 x 34 mm |
| PASS | L shin | 66 x 32 x 21 mm |
| PASS | L shoe | 58 x 43 x 30 mm |
| PASS | L sole | 59 x 44 x 13 mm |
| PASS | L inner ear | 42 x 30 x 4 mm |
| PASS | R hip yaw lid | 37 x 26 x 3 mm |
| PASS | R yaw bracket | 48 x 29 x 26 mm |
| PASS | R hip roll lid | 37 x 24 x 3 mm |
| PASS | R roll bracket | 31 x 30 x 18 mm |
| PASS | R thigh frame | 66 x 51 x 34 mm |
| PASS | R hip pitch lid | 37 x 26 x 3 mm |
| PASS | R knee lid | 37 x 26 x 3 mm |
| PASS | R thigh cover | 70 x 55 x 34 mm |
| PASS | R shin | 66 x 32 x 21 mm |
| PASS | R shoe | 58 x 43 x 30 mm |
| PASS | R sole | 59 x 44 x 13 mm |
| PASS | R inner ear | 42 x 30 x 4 mm |
| PASS | chassis | 84 x 53 x 39 mm |
| PASS | body shell | 85 x 74 x 38 mm |
| PASS | neck column | 28 x 27 x 26 mm |
| PASS | neck lid | 26 x 4 x 2 mm |
| PASS | head pitch lid | 26 x 4 x 2 mm |
| PASS | head fork | 55 x 39 x 37 mm |
| PASS | head yaw sheet | 37 x 26 x 4 mm |
| PASS | head yaw bracket | 40 x 29 x 29 mm |
| PASS | head roll lid | 37 x 26 x 3 mm |
| PASS | head roll spacer | 16 x 16 x 2 mm |
| PASS | head roll rear spacer | 16 x 16 x 2 mm |
| PASS | head frame | 141 x 101 x 60 mm |
| PASS | hood | 150 x 106 x 58 mm |
| PASS | jaw | 106 x 88 x 43 mm |
| PASS | jaw soft insert | 101 x 27 x 5 mm |
| PASS | mouth roof | 101 x 40 x 3 mm |
| PASS | face | 99 x 50 x 4 mm |
| PASS | eye ring | 34 x 34 x 11 mm |
| PASS | eye iris | 20 x 20 x 9 mm |

## THIN

| status | item | detail |
|---|---|---|
| PASS | L hip yaw lid | 1 % of its surface is under 0.8 mm thick |
| PASS | L yaw bracket | 1 % of its surface is under 0.8 mm thick |
| PASS | L hip roll lid | 2 % of its surface is under 0.8 mm thick |
| PASS | L roll bracket | 2 % of its surface is under 0.8 mm thick |
| PASS | L thigh frame | 0 % of its surface is under 0.8 mm thick |
| PASS | L hip pitch lid | 0 % of its surface is under 0.8 mm thick |
| PASS | L knee lid | 1 % of its surface is under 0.8 mm thick |
| PASS | L thigh cover | 1 % of its surface is under 0.8 mm thick |
| PASS | L shin | 2 % of its surface is under 0.8 mm thick |
| PASS | L shoe | 5 % of its surface is under 0.8 mm thick |
| PASS | L sole | 4 % of its surface is under 0.8 mm thick |
| PASS | L inner ear | 0 % of its surface is under 0.8 mm thick |
| PASS | R hip yaw lid | 1 % of its surface is under 0.8 mm thick |
| PASS | R yaw bracket | 2 % of its surface is under 0.8 mm thick |
| PASS | R hip roll lid | 3 % of its surface is under 0.8 mm thick |
| PASS | R roll bracket | 4 % of its surface is under 0.8 mm thick |
| PASS | R thigh frame | 0 % of its surface is under 0.8 mm thick |
| PASS | R hip pitch lid | 1 % of its surface is under 0.8 mm thick |
| PASS | R knee lid | 1 % of its surface is under 0.8 mm thick |
| PASS | R thigh cover | 1 % of its surface is under 0.8 mm thick |
| PASS | R shin | 1 % of its surface is under 0.8 mm thick |
| PASS | R shoe | 6 % of its surface is under 0.8 mm thick |
| PASS | R sole | 4 % of its surface is under 0.8 mm thick |
| PASS | R inner ear | 0 % of its surface is under 0.8 mm thick |
| PASS | chassis | 0 % of its surface is under 0.8 mm thick |
| PASS | body shell | 2 % of its surface is under 0.8 mm thick |
| PASS | neck column | 3 % of its surface is under 0.8 mm thick |
| PASS | neck lid | 0 % of its surface is under 0.8 mm thick |
| PASS | head pitch lid | 0 % of its surface is under 0.8 mm thick |
| PASS | head fork | 0 % of its surface is under 0.8 mm thick |
| PASS | head yaw sheet | 0 % of its surface is under 0.8 mm thick |
| PASS | head yaw bracket | 1 % of its surface is under 0.8 mm thick |
| PASS | head roll lid | 0 % of its surface is under 0.8 mm thick |
| PASS | head roll spacer | 2 % of its surface is under 0.8 mm thick |
| PASS | head roll rear spacer | 1 % of its surface is under 0.8 mm thick |
| PASS | head frame | 0 % of its surface is under 0.8 mm thick |
| PASS | hood | 1 % of its surface is under 0.8 mm thick |
| PASS | jaw | 0 % of its surface is under 0.8 mm thick |
| PASS | jaw soft insert | 0 % of its surface is under 0.8 mm thick |
| PASS | mouth roof | 0 % of its surface is under 0.8 mm thick |
| PASS | face | 2 % of its surface is under 0.8 mm thick |
| PASS | eye ring | 0 % of its surface is under 0.8 mm thick |
| PASS | eye iris | 0 % of its surface is under 0.8 mm thick |

## FILE

| status | item | detail |
|---|---|---|
| PASS | L_hip_pitch_lid.stl |  |
| PASS | L_hip_roll_lid.stl |  |
| PASS | L_hip_yaw_lid.stl |  |
| PASS | L_inner_ear.stl |  |
| PASS | L_knee_lid.stl |  |
| PASS | L_roll_bracket.stl |  |
| PASS | L_shin.stl |  |
| PASS | L_shoe.stl |  |
| PASS | L_sole.stl |  |
| PASS | L_thigh_cover.stl |  |
| PASS | L_thigh_frame.stl |  |
| PASS | L_yaw_bracket.stl |  |
| PASS | R_hip_pitch_lid.stl |  |
| PASS | R_hip_roll_lid.stl |  |
| PASS | R_hip_yaw_lid.stl |  |
| PASS | R_inner_ear.stl |  |
| PASS | R_knee_lid.stl |  |
| PASS | R_roll_bracket.stl |  |
| PASS | R_shin.stl |  |
| PASS | R_shoe.stl |  |
| PASS | R_sole.stl |  |
| PASS | R_thigh_cover.stl |  |
| PASS | R_thigh_frame.stl |  |
| PASS | R_yaw_bracket.stl |  |
| PASS | body_shell.stl |  |
| PASS | chassis.stl |  |
| PASS | eye_iris.stl |  |
| PASS | eye_ring.stl |  |
| PASS | face.stl |  |
| PASS | head_fork.stl |  |
| PASS | head_frame.stl |  |
| PASS | head_pitch_lid.stl |  |
| PASS | head_roll_lid.stl |  |
| PASS | head_roll_rear_spacer.stl |  |
| PASS | head_roll_spacer.stl |  |
| PASS | head_yaw_bracket.stl |  |
| PASS | head_yaw_sheet.stl |  |
| PASS | hood.stl |  |
| PASS | jaw.stl |  |
| PASS | jaw_soft_insert.stl |  |
| PASS | mouth_roof.stl |  |
| PASS | neck_column.stl |  |
| PASS | neck_lid.stl |  |
