meetsitaram/duck-droids/docs/big/ASSEMBLY.md

# Big duck: how it goes together

**NOT SAFE TO BUILD.** This order is checked for fit: each part has a way in and each screw a straight path for its key (`tools/big_assembly.py`, `reports/big/assembly.md`). Nothing here says a joint is strong enough.

Generated by `tools/big_assembly.py` from its order and the spec: don't edit by hand. The right leg is the left's mirror, in the same order. A **bench** step builds a subassembly on the bench, which then goes on as one piece. Each step says the way the part moves as it goes on, in the robot's frame (X forward, Y left, Z up). Screws go in as soon as everything they join is there.

Printed panels and covers (body, hood, face, bill, shin, beak) aren't in it: their fixings aren't designed.

- **1** deck plate, along -z
- **2** L hip yaw housing, along +z: bolted to the deck from above, 10 M5
- **3** L_hip_yaw actuator (buy) RS04, along +z: up into the housing, its rear step through the deck; 10 M4 from above
- **4** R hip yaw housing, along +z: bolted to the deck from above, 10 M5
- **5** R_hip_yaw actuator (buy) RS04, along +z: up into the housing, its rear step through the deck; 10 M4 from above
- **6** body post 0, along -z: an M5 up through the deck
- **7** body post 1, along -z: an M5 up through the deck
- **8** body post 2, along -z: an M5 up through the deck
- **9** body post 3, along -z: an M5 up through the deck
- **10** neck tie, along -z: 2 M5 up through the deck
- **11** neck plate L, along -z
- **12** neck plate R, along -z: 2 M5 through each into the tie
- **13** neck cleat L, along -z
- **14** neck cleat R, along -z: 2 M5 up through the deck into each, 1 through it into its plate
- **15** neck_pitch actuator L (buy) RS04, along +y: 10 M4 from outside
- **16** neck_pitch actuator R (buy) RS04, along -y
- **17** computer standoff 0, along -z
- **18** computer standoff 1, along -z: 2 M3 up through the deck into each
- **19** computer and power boards, along -z
- **20** battery 13S, along -z
- **21** battery BMS, fuse and case, allowance, along -z: strapped
- **22** upper plate, along -z: an M5 down into each post
- **23** L hip yaw inner retainer, along +z: loose, up into the housing
- **24** L hip yaw bearing, along +z: 61824, into the housing to its shoulder; the inner retainer rests on it
- **25** L hip yaw retainer, along +z: 8 countersunk M4 into the housing's flange
- **26** L hip yaw flange, along +z: through the bearing onto the output's pins; 8 M4 up into the inner retainer, 9 M5 into the output
- **27** L hip yaw beam, along +z: 8 M5 into the flange
- **28** L hip roll cheek F, along +z
- **29** L hip roll cleat F, along -x: 3 M5 up into the beam, 2 through the cheek
- **30** L_hip_roll actuator F (buy) RS04, along +x: rear step through the cheek; 10 M4 from outside
- **31** L hip roll output F, along +x
- **32** L hip roll yoke, along +x: onto the front output's pins; 9 M5 through it from inside the hollow
- **33** L hip roll output B, along +x
- **34** L_hip_roll actuator B (buy) RS04, along +x: onto the back plate's pins
- **35** L hip roll cheek B, along +x: over the back stator's rear step; 10 M4, then 9 M5 into the output from inside the yoke
- **36** L hip roll cleat B, along +x
- **37** bench: L hip pitch inner upright, along -y: onto the yoke's ring; 5 M5 through the upright into it
  - **37.1** L hip pitch upright in, along -y
  - **37.2** L_hip_pitch actuator I (buy) RS04, along -y: 10 M4 from the ring side
- **38** L hip pitch output I, along -y: onto the output's pins; 9 M5, low heads
- **39** bench: L thigh, along -y: onto the inner output; 6 M5 from inside the thigh
  - **39.1** L thigh plate in, along +y
  - **39.2** L thigh spacer hip, along -y
  - **39.3** L thigh spacer mid, along -y
  - **39.4** L thigh plate out, along -y: 8 countersunk M5 into the spacers
  - **39.5** bench: L knee drive I, along +y: the ties onto the thigh plate; an M5 into each from inside the thigh
    - **39.5.1** L thigh rear plate in, along +y
    - **39.5.2** L_knee actuator I (buy) RS04, along -y: 10 M4
    - **39.5.3** L knee crank I, along -y: 9 M5 into the output
    - **39.5.4** L knee crank pin I, along -y: pressed in
    - **39.5.5** L knee rod I, L knee rod I bush A, L knee rod I bush B, along -y: on the pin
    - **39.5.6** L knee crank pin I clip (buy) DIN 6799 8, along -z: E-clip, from the side
    - **39.5.7** L thigh tie 0i, along -y
    - **39.5.8** L thigh tie 1i, along -y: an M5 into each from the rear plate
  - **39.6** bench: L knee drive O, along -y: the ties onto the thigh plate; an M5 into each from inside the thigh
    - **39.6.1** L thigh rear plate out, along -y
    - **39.6.2** L_knee actuator O (buy) RS04, along +y: 10 M4
    - **39.6.3** L knee crank O, along +y: 9 M5 into the output
    - **39.6.4** L knee crank pin O, along +y: pressed in
    - **39.6.5** L knee rod O, L knee rod O bush A, L knee rod O bush B, along +y: on the pin
    - **39.6.6** L knee crank pin O clip (buy) DIN 6799 8, along -z: E-clip, from the side
    - **39.6.7** L thigh tie 0o, along +y
    - **39.6.8** L thigh tie 1o, along +y: an M5 into each from the rear plate
- **40** bench: L hip pitch outer, along -y: onto the thigh's outer plate; 6 M5 from inside the thigh
  - **40.1** L hip pitch upright out, along -y
  - **40.2** L_hip_pitch actuator O (buy) RS04, along +y: 10 M4
  - **40.3** L hip pitch output O, along +y: 9 M5, low heads
- **41** L hip pitch bridge, along -z: 4 M4 through the uprights into its ends
- **42** bench: L shin, along +z: up between the thigh plates
  - **42.1** bench: L ankle stack, along -z: 2 M4 from inside the cap
    - **42.1.1** L ankle mount plate, along +y
    - **42.1.2** L_ankle_pitch actuator (buy) RS04, along -y: 10 M4
    - **42.1.3** L ankle spacer, along +y
    - **42.1.4** L ankle plate in, along +y: 5 M4 through it and the ring into the shoulder plate
    - **42.1.5** L ankle stub, along +y: 3 M4 in counterbores
  - **42.2** L shin cap, along +z: the stack hangs from it
  - **42.3** L shin cleat front, along -z
  - **42.4** L shin cleat back, along -z: 2 M4 up through the cap into each
  - **42.5** L shin tube, along -z: 2 M4 through each end wall into its cleat
  - **42.6** bench: L knee top, along -z: into the tube; 8 M4 through its walls
    - **42.6.1** L shin top, along -z
    - **42.6.2** L shin spacer, along -z: 2 M5 up through the top
    - **42.6.3** L shin hub in, along +y
    - **42.6.4** L shin hub out, along -y: 2 countersunk M4 through the first hub and the spacer into the second
- **43** L knee bearing, along +y: 6908, pressed into the thigh plate
- **44** L knee far bearing, along -y
- **45** L knee shaft, along +y: through both bearings and both hubs, keyed
- **46** bench: L knee lever I, along +y: onto the shaft's key, its pin through the rod's far bush; circlip
  - **46.1** L knee lever I, along +y
  - **46.2** L knee lever pin I, along +y: pressed in
- **47** L knee lever pin I clip (buy) DIN 6799 8, along -z: E-clip
- **48** bench: L knee lever O, along -y: onto the shaft's key, its pin through the rod's far bush; circlip
  - **48.1** L knee lever O, along -y
  - **48.2** L knee lever pin O, along -y: pressed in
- **49** L knee lever pin O clip (buy) DIN 6799 8, along -z: E-clip
- **50** L ankle bearing, along +y: 6206, onto the stub
- **51** L ankle output, along -y: onto the output's pins; 9 M5
- **52** L ankle bearing housing, along +y: onto the bearing
- **53** bench: L foot, along +z: the ears up beside the output plate and the housing: 6 M5 through the outer ear, 3 through the inner
  - **53.1** L foot plate, along -z
  - **53.2** L ankle ear in, along -z
  - **53.3** L ankle ear out, along -z: 3 M4 up through the plate into each
  - **53.4** L shoe rear, along -z
  - **53.5** L shoe front, along -z: 2 M4 up through the plate into inserts in each
  - **53.6** L sole rear, along +z
  - **53.7** L sole front, along +z: bonded
- **54** L thigh cover post out hip, along -y
- **55** L thigh cover post out rear, along -y
- **56** L thigh cover post out knee, along -y
- **57** L thigh cover out hip, along -y: an M4 through it and its post into the rear plate
- **58** L thigh cover out rear, along -y: an M4 through it and its post into the rear plate
- **59** L thigh cover out knee, along -y: an M4 through it and its post into the rear plate
- **60** R hip yaw inner retainer, along +z: loose, up into the housing
- **61** R hip yaw bearing, along +z: 61824, into the housing to its shoulder; the inner retainer rests on it
- **62** R hip yaw retainer, along +z: 8 countersunk M4 into the housing's flange
- **63** R hip yaw flange, along +z: through the bearing onto the output's pins; 8 M4 up into the inner retainer, 9 M5 into the output
- **64** R hip yaw beam, along +z: 8 M5 into the flange
- **65** R hip roll cheek F, along +z
- **66** R hip roll cleat F, along -x: 3 M5 up into the beam, 2 through the cheek
- **67** R_hip_roll actuator F (buy) RS04, along +x: rear step through the cheek; 10 M4 from outside
- **68** R hip roll output F, along +x
- **69** R hip roll yoke, along +x: onto the front output's pins; 9 M5 through it from inside the hollow
- **70** R hip roll output B, along +x
- **71** R_hip_roll actuator B (buy) RS04, along +x: onto the back plate's pins
- **72** R hip roll cheek B, along +x: over the back stator's rear step; 10 M4, then 9 M5 into the output from inside the yoke
- **73** R hip roll cleat B, along +x
- **74** bench: R hip pitch inner upright, along +y: onto the yoke's ring; 5 M5 through the upright into it
  - **74.1** R hip pitch upright in, along +y
  - **74.2** R_hip_pitch actuator I (buy) RS04, along +y: 10 M4 from the ring side
- **75** R hip pitch output I, along +y: onto the output's pins; 9 M5, low heads
- **76** bench: R thigh, along +y: onto the inner output; 6 M5 from inside the thigh
  - **76.1** R thigh plate in, along -y
  - **76.2** R thigh spacer hip, along +y
  - **76.3** R thigh spacer mid, along +y
  - **76.4** R thigh plate out, along +y: 8 countersunk M5 into the spacers
  - **76.5** bench: R knee drive I, along -y: the ties onto the thigh plate; an M5 into each from inside the thigh
    - **76.5.1** R thigh rear plate in, along -y
    - **76.5.2** R_knee actuator I (buy) RS04, along +y: 10 M4
    - **76.5.3** R knee crank I, along +y: 9 M5 into the output
    - **76.5.4** R knee crank pin I, along +y: pressed in
    - **76.5.5** R knee rod I, R knee rod I bush A, R knee rod I bush B, along +y: on the pin
    - **76.5.6** R knee crank pin I clip (buy) DIN 6799 8, along -z: E-clip, from the side
    - **76.5.7** R thigh tie 0i, along +y
    - **76.5.8** R thigh tie 1i, along +y: an M5 into each from the rear plate
  - **76.6** bench: R knee drive O, along +y: the ties onto the thigh plate; an M5 into each from inside the thigh
    - **76.6.1** R thigh rear plate out, along +y
    - **76.6.2** R_knee actuator O (buy) RS04, along -y: 10 M4
    - **76.6.3** R knee crank O, along -y: 9 M5 into the output
    - **76.6.4** R knee crank pin O, along -y: pressed in
    - **76.6.5** R knee rod O, R knee rod O bush A, R knee rod O bush B, along -y: on the pin
    - **76.6.6** R knee crank pin O clip (buy) DIN 6799 8, along -z: E-clip, from the side
    - **76.6.7** R thigh tie 0o, along -y
    - **76.6.8** R thigh tie 1o, along -y: an M5 into each from the rear plate
- **77** bench: R hip pitch outer, along +y: onto the thigh's outer plate; 6 M5 from inside the thigh
  - **77.1** R hip pitch upright out, along +y
  - **77.2** R_hip_pitch actuator O (buy) RS04, along -y: 10 M4
  - **77.3** R hip pitch output O, along -y: 9 M5, low heads
- **78** R hip pitch bridge, along -z: 4 M4 through the uprights into its ends
- **79** bench: R shin, along +z: up between the thigh plates
  - **79.1** bench: R ankle stack, along -z: 2 M4 from inside the cap
    - **79.1.1** R ankle mount plate, along -y
    - **79.1.2** R_ankle_pitch actuator (buy) RS04, along +y: 10 M4
    - **79.1.3** R ankle spacer, along -y
    - **79.1.4** R ankle plate in, along -y: 5 M4 through it and the ring into the shoulder plate
    - **79.1.5** R ankle stub, along -y: 3 M4 in counterbores
  - **79.2** R shin cap, along +z: the stack hangs from it
  - **79.3** R shin cleat front, along -z
  - **79.4** R shin cleat back, along -z: 2 M4 up through the cap into each
  - **79.5** R shin tube, along -z: 2 M4 through each end wall into its cleat
  - **79.6** bench: R knee top, along -z: into the tube; 8 M4 through its walls
    - **79.6.1** R shin top, along -z
    - **79.6.2** R shin spacer, along -z: 2 M5 up through the top
    - **79.6.3** R shin hub in, along -y
    - **79.6.4** R shin hub out, along +y: 2 countersunk M4 through the first hub and the spacer into the second
- **80** R knee bearing, along -y: 6908, pressed into the thigh plate
- **81** R knee far bearing, along +y
- **82** R knee shaft, along -y: through both bearings and both hubs, keyed
- **83** bench: R knee lever I, along -y: onto the shaft's key, its pin through the rod's far bush; circlip
  - **83.1** R knee lever I, along -y
  - **83.2** R knee lever pin I, along -y: pressed in
- **84** R knee lever pin I clip (buy) DIN 6799 8, along -z: E-clip
- **85** bench: R knee lever O, along +y: onto the shaft's key, its pin through the rod's far bush; circlip
  - **85.1** R knee lever O, along +y
  - **85.2** R knee lever pin O, along +y: pressed in
- **86** R knee lever pin O clip (buy) DIN 6799 8, along -z: E-clip
- **87** R ankle bearing, along -y: 6206, onto the stub
- **88** R ankle output, along +y: onto the output's pins; 9 M5
- **89** R ankle bearing housing, along -y: onto the bearing
- **90** bench: R foot, along +z: the ears up beside the output plate and the housing: 6 M5 through the outer ear, 3 through the inner
  - **90.1** R foot plate, along -z
  - **90.2** R ankle ear in, along -z
  - **90.3** R ankle ear out, along -z: 3 M4 up through the plate into each
  - **90.4** R shoe rear, along -z
  - **90.5** R shoe front, along -z: 2 M4 up through the plate into inserts in each
  - **90.6** R sole rear, along +z
  - **90.7** R sole front, along +z: bonded
- **91** R thigh cover post out hip, along +y
- **92** R thigh cover post out rear, along +y
- **93** R thigh cover post out knee, along +y
- **94** R thigh cover out hip, along +y: an M4 through it and its post into the rear plate
- **95** R thigh cover out rear, along +y: an M4 through it and its post into the rear plate
- **96** R thigh cover out knee, along +y: an M4 through it and its post into the rear plate
- **97** neck output L, along +y
- **98** neck output R, along -y
- **99** neck spine, along -z: 9 M5 through each boss from the window in the spine
- **100** bench: head pitch drive, along -y: beside the spine
  - **100.1** head pitch stator plate L, along +y
  - **100.2** head_pitch actuator L (buy) RS04, along +y: 10 M4
  - **100.3** head pitch drive sprocket L (buy) 13T #40, along +y: 9 M5
- **101** head pitch stator tie L, along -z: 3 M5 x 80 through the plate and the tie into the spine
- **102** head pitch L bearing, along -y
- **103** head pitch R bearing, along +y: 6908s, pressed into the spine
- **104** head pitch sprocket L (buy) 25T #40, along +x
- **105** head pitch yoke, along -z
- **106** head pitch yoke R, along -z
- **107** head pitch shaft, along -y: through the yokes, the sprocket and both bearings, keyed
- **108** head pitch chain L (buy) #40 a, head pitch chain L (buy) #40 b, along -z: the chain, wrapped on
- **109** head pitch bridge, along -z: 4 M4 down into the yokes
- **110** head_yaw actuator (buy) RS03, along -z: 4 M4 from under the bridge
- **111** head yaw front post 0, along -z
- **112** head yaw front post 1, along -z
- **113** head yaw front post 2, along -z
- **114** head yaw front post 3, along -z
- **115** head yaw front ring, along -z: 8 countersunk M4 into the RS03's front holes, 4 into the posts; an M5 up through the bridge into each post
- **116** head yaw output, along -z: 6 M4 into the output
- **117** head yaw plate, along -z: 6 M4 into the output plate
- **118** head roll cradle, along -z: 3 M4 up through the plate
- **119** head_roll actuator (buy) RS03, along -x: 4 M4 from behind the cradle
- **120** head roll front post 0, along -x
- **121** head roll front post 1, along -x
- **122** head roll front post 2, along -x
- **123** head roll front post 3, along -x
- **124** head roll front ring, along -x: 8 countersunk M4 into the RS03, 4 into the posts; an M5 through the cradle into each post
- **125** head roll output, along -x: 6 M4 into the output
- **126** bench: head frame, along -x: onto the roll output; 6 M4
  - **126.1** head main frame, along -x
  - **126.2** head rail L, along +x
  - **126.3** head rail R, along +x: through the main frame's notches; 2 M4 into it
  - **126.4** head rear frame, along +x
  - **126.5** head front frame, along -x: 2 M4 into each rail's end
  - **126.6** head beak lug L, along -y
  - **126.7** head beak lug R, along +y: 2 countersunk M4 into each rail
  - **126.8** head beak mount, along -z: 2 M4 through each rail
  - **126.9** beak actuator (buy) RS00, along -z: placeholder
  - **126.10** head boards and camera, along -z: placeholder
- **127** bench: beak, along +z: its hinge pins: not designed
  - **127.1** beak tray frame, along -z
  - **127.2** beak hinge L, along -y
  - **127.3** beak hinge R, along +y: 2 M4 into the tray's edge

## Screws

| Size (ISO 4762 unless countersunk, ISO 10642) | Count |
|---|---|
| M3 x 12 | 4 |
| M4 x 10 countersunk | 16 |
| M4 x 12 | 220 |
| M4 x 12 countersunk | 4 |
| M4 x 14 | 6 |
| M4 x 14 countersunk | 24 |
| M4 x 16 | 65 |
| M4 x 20 | 28 |
| M4 x 22 | 10 |
| M4 x 22 countersunk | 4 |
| M4 x 25 | 6 |
| M4 x 8 | 12 |
| M5 x 10 | 63 |
| M5 x 12 | 36 |
| M5 x 16 | 102 |
| M5 x 16 countersunk | 16 |
| M5 x 18 | 38 |
| M5 x 20 | 38 |
| M5 x 25 | 12 |
| M5 x 8 | 36 |
| M5 x 80 | 3 |

743 in all, and the joints that aren't screws: `HELD` in `spec/big_duck.py`.
