meetsitaram/duck-droids/reports/big/assembly.md

# Physical checks

spec: `spec/robot_big.json`, 2026-11-05 15:53, 78 s

1531 checks: 1357 pass, 174 warn, **0 fail**

## APART

| status | item | detail |
|---|---|---|
| WARN | deck plate / body panel FR | trunk: drawn into each other, 0.60 cm3 (a printed panel: not relieved for what it meets) |
| WARN | deck plate / body panel FL | trunk: drawn into each other, 0.61 cm3 (a printed panel: not relieved for what it meets) |
| WARN | head main frame / bill panel 10 | head: drawn into each other, 0.22 cm3 (a printed panel: not relieved for what it meets) |
| WARN | head main frame / bill panel 12 | head: drawn into each other, 0.22 cm3 (a printed panel: not relieved for what it meets) |
| WARN | head rail L / bill panel 02 | head: drawn into each other, 3.31 cm3 (a printed panel: not relieved for what it meets) |
| WARN | head rail L / bill panel 12 | head: drawn into each other, 5.17 cm3 (a printed panel: not relieved for what it meets) |
| WARN | head rail R / bill panel 00 | head: drawn into each other, 3.31 cm3 (a printed panel: not relieved for what it meets) |
| WARN | head rail R / bill panel 10 | head: drawn into each other, 5.17 cm3 (a printed panel: not relieved for what it meets) |
| WARN | head rear frame / bill panel 00 | head: drawn into each other, 2.41 cm3 (a printed panel: not relieved for what it meets) |
| WARN | head rear frame / bill panel 01 | head: drawn into each other, 7.27 cm3 (a printed panel: not relieved for what it meets) |
| WARN | head rear frame / bill panel 02 | head: drawn into each other, 2.41 cm3 (a printed panel: not relieved for what it meets) |
| WARN | face panel 1u / eye ring | head: drawn into each other, 69.16 cm3 (a printed panel: not relieved for what it meets) |
| WARN | face panel 1u / eye lens | head: drawn into each other, 11.29 cm3 (a printed panel: not relieved for what it meets) |
| WARN | face panel 1l / eye ring | head: drawn into each other, 69.16 cm3 (a printed panel: not relieved for what it meets) |
| WARN | face panel 1l / eye lens | head: drawn into each other, 11.29 cm3 (a printed panel: not relieved for what it meets) |
| WARN | bill panel 00 / head beak mount | head: drawn into each other, 0.23 cm3 (a printed panel: not relieved for what it meets) |
| WARN | bill panel 02 / head beak mount | head: drawn into each other, 0.23 cm3 (a printed panel: not relieved for what it meets) |
| WARN | eye ring / eye lens | head: drawn into each other, 112.92 cm3 (a printed panel: not relieved for what it meets) |

## JOINED

| status | item | detail |
|---|---|---|
| WARN | deck plate / body panel FR | trunk: they touch, and no screw or held joint joins them (a printed panel: its fixings aren't designed) |
| WARN | deck plate / body panel FL | trunk: they touch, and no screw or held joint joins them (a printed panel: its fixings aren't designed) |
| WARN | upper plate / body panel RL | trunk: they touch, and no screw or held joint joins them (a printed panel: its fixings aren't designed) |
| WARN | battery 13S / body panel RL | trunk: they touch, and no screw or held joint joins them (a printed panel: its fixings aren't designed) |
| WARN | body panel RR / body panel RL | trunk: they touch, and no screw or held joint joins them (a printed panel: its fixings aren't designed) |
| WARN | body panel RR / body panel MR | trunk: they touch, and no screw or held joint joins them (a printed panel: its fixings aren't designed) |
| WARN | body panel RL / body panel ML | trunk: they touch, and no screw or held joint joins them (a printed panel: its fixings aren't designed) |
| WARN | body panel MR / body panel ML | trunk: they touch, and no screw or held joint joins them (a printed panel: its fixings aren't designed) |
| WARN | body panel MR / body panel FR | trunk: they touch, and no screw or held joint joins them (a printed panel: its fixings aren't designed) |
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
| WARN | beak panel 4 / beak panel 5 | beak_link: they touch, and no screw or held joint joins them (a printed panel: its fixings aren't designed) |

## ONE

| status | item | detail |
|---|---|---|
| PASS | trunk | 26 parts |
| PASS | L_hip_yaw_link | 10 parts |
| PASS | R_hip_yaw_link | 10 parts |
| PASS | L_hip_roll_link | 8 parts |
| PASS | R_hip_roll_link | 8 parts |
| PASS | L_hip_pitch_link | 19 parts |
| PASS | L_knee_crank_I | 3 parts |
| PASS | L_knee_crank_O | 3 parts |
| PASS | L_knee_link | 23 parts |
| PASS | L_knee_rod_I | 3 parts |
| PASS | L_knee_rod_O | 3 parts |
| PASS | R_hip_pitch_link | 19 parts |
| PASS | R_knee_crank_I | 3 parts |
| PASS | R_knee_crank_O | 3 parts |
| PASS | R_knee_link | 23 parts |
| PASS | R_knee_rod_I | 3 parts |
| PASS | R_knee_rod_O | 3 parts |
| PASS | L_foot | 6 parts |
| PASS | R_foot | 6 parts |
| PASS | neck_link | 11 parts |
| PASS | head_pitch_link | 13 parts |
| PASS | head_yaw_link | 9 parts |
| PASS | head | 11 parts |
| PASS | beak_link | 3 parts |

## HOLD

| status | item | detail |
|---|---|---|
| WARN | body panel RR | 0 screw(s) and nothing else holds it: it turns about one |
| WARN | body panel RL | 0 screw(s) and nothing else holds it: it turns about one |
| WARN | body panel MR | 0 screw(s) and nothing else holds it: it turns about one |
| WARN | body panel ML | 0 screw(s) and nothing else holds it: it turns about one |
| WARN | body panel FR | 0 screw(s) and nothing else holds it: it turns about one |
| WARN | body panel FL | 0 screw(s) and nothing else holds it: it turns about one |
| WARN | L thigh cover out hip | 1 screw(s) and nothing else holds it: it turns about one |
| WARN | L thigh cover out rear | 1 screw(s) and nothing else holds it: it turns about one |
| WARN | L thigh cover out knee | 1 screw(s) and nothing else holds it: it turns about one |
| WARN | R thigh cover out hip | 1 screw(s) and nothing else holds it: it turns about one |
| WARN | R thigh cover out rear | 1 screw(s) and nothing else holds it: it turns about one |
| WARN | R thigh cover out knee | 1 screw(s) and nothing else holds it: it turns about one |
| WARN | L shin cover front | 0 screw(s) and nothing else holds it: it turns about one |
| WARN | L shin cover back | 0 screw(s) and nothing else holds it: it turns about one |
| WARN | R shin cover front | 0 screw(s) and nothing else holds it: it turns about one |
| WARN | R shin cover back | 0 screw(s) and nothing else holds it: it turns about one |
| WARN | hood panel 0Ru | 0 screw(s) and nothing else holds it: it turns about one |
| WARN | hood panel 0Rl | 0 screw(s) and nothing else holds it: it turns about one |
| WARN | hood panel 0c | 0 screw(s) and nothing else holds it: it turns about one |
| WARN | hood panel 0Lu | 0 screw(s) and nothing else holds it: it turns about one |
| WARN | hood panel 0Ll | 0 screw(s) and nothing else holds it: it turns about one |
| WARN | hood panel 1Ru | 0 screw(s) and nothing else holds it: it turns about one |
| WARN | hood panel 1Rl | 0 screw(s) and nothing else holds it: it turns about one |
| WARN | hood panel 1c | 0 screw(s) and nothing else holds it: it turns about one |
| WARN | hood panel 1Lu | 0 screw(s) and nothing else holds it: it turns about one |
| WARN | hood panel 1Ll | 0 screw(s) and nothing else holds it: it turns about one |
| WARN | hood panel 2Ru | 0 screw(s) and nothing else holds it: it turns about one |
| WARN | hood panel 2Rl | 0 screw(s) and nothing else holds it: it turns about one |
| WARN | hood panel 2c | 0 screw(s) and nothing else holds it: it turns about one |
| WARN | hood panel 2Lu | 0 screw(s) and nothing else holds it: it turns about one |
| WARN | hood panel 2Ll | 0 screw(s) and nothing else holds it: it turns about one |
| WARN | hood panel 3Ru | 0 screw(s) and nothing else holds it: it turns about one |
| WARN | hood panel 3Rl | 0 screw(s) and nothing else holds it: it turns about one |
| WARN | hood panel 3c | 0 screw(s) and nothing else holds it: it turns about one |
| WARN | hood panel 3Lu | 0 screw(s) and nothing else holds it: it turns about one |
| WARN | hood panel 3Ll | 0 screw(s) and nothing else holds it: it turns about one |
| WARN | face panel 0u | 0 screw(s) and nothing else holds it: it turns about one |
| WARN | face panel 0l | 0 screw(s) and nothing else holds it: it turns about one |
| WARN | face panel 1u | 0 screw(s) and nothing else holds it: it turns about one |
| WARN | face panel 1l | 0 screw(s) and nothing else holds it: it turns about one |
| WARN | face panel 2u | 0 screw(s) and nothing else holds it: it turns about one |
| WARN | face panel 2l | 0 screw(s) and nothing else holds it: it turns about one |
| WARN | bill panel 00 | 0 screw(s) and nothing else holds it: it turns about one |
| WARN | bill panel 01 | 0 screw(s) and nothing else holds it: it turns about one |
| WARN | bill panel 02 | 0 screw(s) and nothing else holds it: it turns about one |
| WARN | bill panel 10 | 0 screw(s) and nothing else holds it: it turns about one |
| WARN | bill panel 12 | 0 screw(s) and nothing else holds it: it turns about one |
| WARN | bill panel 20 | 0 screw(s) and nothing else holds it: it turns about one |
| WARN | bill panel 22 | 0 screw(s) and nothing else holds it: it turns about one |
| WARN | bill panel 30 | 0 screw(s) and nothing else holds it: it turns about one |
| WARN | bill panel 31 | 0 screw(s) and nothing else holds it: it turns about one |
| WARN | bill panel 32 | 0 screw(s) and nothing else holds it: it turns about one |
| WARN | eye ring | 0 screw(s) and nothing else holds it: it turns about one |
| WARN | eye lens | 0 screw(s) and nothing else holds it: it turns about one |
| WARN | beak panel 0 | 0 screw(s) and nothing else holds it: it turns about one |
| WARN | beak panel 1 | 0 screw(s) and nothing else holds it: it turns about one |
| WARN | beak panel 2 | 0 screw(s) and nothing else holds it: it turns about one |
| WARN | beak panel 3 | 0 screw(s) and nothing else holds it: it turns about one |
| WARN | beak panel 4 | 0 screw(s) and nothing else holds it: it turns about one |
| WARN | beak panel 5 | 0 screw(s) and nothing else holds it: it turns about one |

## BITE

| status | item | detail |
|---|---|---|
| PASS | body post 0 screw low 0 | 8.0 mm into body post 0, 1.60 x its diameter |
| PASS | body post 0 screw high 0 | 8.0 mm into body post 0, 1.60 x its diameter |
| PASS | body post 1 screw low 0 | 8.0 mm into body post 1, 1.60 x its diameter |
| PASS | body post 1 screw high 0 | 8.0 mm into body post 1, 1.60 x its diameter |
| PASS | body post 2 screw low 0 | 8.0 mm into body post 2, 1.60 x its diameter |
| PASS | body post 2 screw high 0 | 8.0 mm into body post 2, 1.60 x its diameter |
| PASS | body post 3 screw low 0 | 8.0 mm into body post 3, 1.60 x its diameter |
| PASS | body post 3 screw high 0 | 8.0 mm into body post 3, 1.60 x its diameter |
| PASS | neck tie deck screw 0 | 8.0 mm into neck tie, 1.60 x its diameter |
| PASS | neck tie deck screw 1 | 8.0 mm into neck tie, 1.60 x its diameter |
| PASS | neck tie screw L 0 | 8.0 mm into neck tie, 1.60 x its diameter |
| PASS | neck tie screw L 1 | 8.0 mm into neck tie, 1.60 x its diameter |
| PASS | neck cleat screw L 0 | 6.0 mm into neck plate L, 1.20 x its diameter |
| PASS | neck cleat deck screw L 0 | 8.0 mm into neck cleat L, 1.60 x its diameter |
| PASS | neck cleat deck screw L 1 | 8.0 mm into neck cleat L, 1.60 x its diameter |
| PASS | neck tie screw R 0 | 8.0 mm into neck tie, 1.60 x its diameter |
| PASS | neck tie screw R 1 | 8.0 mm into neck tie, 1.60 x its diameter |
| PASS | neck cleat screw R 0 | 6.0 mm into neck plate R, 1.20 x its diameter |
| PASS | neck cleat deck screw R 0 | 8.0 mm into neck cleat R, 1.60 x its diameter |
| PASS | neck cleat deck screw R 1 | 8.0 mm into neck cleat R, 1.60 x its diameter |
| PASS | computer standoff 0 screw 0 | 4.0 mm into computer standoff 0, 1.33 x its diameter |
| PASS | computer standoff 0 screw 1 | 4.0 mm into computer standoff 0, 1.33 x its diameter |
| PASS | computer standoff 1 screw 0 | 4.0 mm into computer standoff 1, 1.33 x its diameter |
| PASS | computer standoff 1 screw 1 | 4.0 mm into computer standoff 1, 1.33 x its diameter |
| PASS | L hip yaw retainer screw 0 | 7.0 mm into L hip yaw housing, 1.75 x its diameter |
| PASS | L hip yaw retainer screw 1 | 7.0 mm into L hip yaw housing, 1.75 x its diameter |
| PASS | L hip yaw retainer screw 2 | 7.0 mm into L hip yaw housing, 1.75 x its diameter |
| PASS | L hip yaw retainer screw 3 | 7.0 mm into L hip yaw housing, 1.75 x its diameter |
| PASS | L hip yaw retainer screw 4 | 7.0 mm into L hip yaw housing, 1.75 x its diameter |
| PASS | L hip yaw retainer screw 5 | 7.0 mm into L hip yaw housing, 1.75 x its diameter |
| PASS | L hip yaw retainer screw 6 | 7.0 mm into L hip yaw housing, 1.75 x its diameter |
| PASS | L hip yaw retainer screw 7 | 7.0 mm into L hip yaw housing, 1.75 x its diameter |
| PASS | L hip yaw housing screw 0 | 8.0 mm into L hip yaw housing, 1.60 x its diameter |
| PASS | L hip yaw housing screw 1 | 8.0 mm into L hip yaw housing, 1.60 x its diameter |
| PASS | L hip yaw housing screw 2 | 8.0 mm into L hip yaw housing, 1.60 x its diameter |
| PASS | L hip yaw housing screw 3 | 8.0 mm into L hip yaw housing, 1.60 x its diameter |
| PASS | L hip yaw housing screw 4 | 8.0 mm into L hip yaw housing, 1.60 x its diameter |
| PASS | L hip yaw housing screw 5 | 8.0 mm into L hip yaw housing, 1.60 x its diameter |
| PASS | L hip yaw housing screw 6 | 8.0 mm into L hip yaw housing, 1.60 x its diameter |
| PASS | L hip yaw housing screw 7 | 8.0 mm into L hip yaw housing, 1.60 x its diameter |
| PASS | L hip yaw housing screw 8 | 8.0 mm into L hip yaw housing, 1.60 x its diameter |
| PASS | L hip yaw housing screw 9 | 8.0 mm into L hip yaw housing, 1.60 x its diameter |
| PASS | R hip yaw retainer screw 0 | 7.0 mm into R hip yaw housing, 1.75 x its diameter |
| PASS | R hip yaw retainer screw 1 | 7.0 mm into R hip yaw housing, 1.75 x its diameter |
| PASS | R hip yaw retainer screw 2 | 7.0 mm into R hip yaw housing, 1.75 x its diameter |
| PASS | R hip yaw retainer screw 3 | 7.0 mm into R hip yaw housing, 1.75 x its diameter |
| PASS | R hip yaw retainer screw 4 | 7.0 mm into R hip yaw housing, 1.75 x its diameter |
| PASS | R hip yaw retainer screw 5 | 7.0 mm into R hip yaw housing, 1.75 x its diameter |
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
| PASS | L shin hub screw 1 | 5.0 mm into L shin hub out, 1.25 x its diameter |
| PASS | L shin spacer screw 0 | 12.0 mm into L shin spacer, 2.40 x its diameter |
| PASS | L shin spacer screw 1 | 12.0 mm into L shin spacer, 2.40 x its diameter |
| PASS | L shin top screw front 0 | 7.0 mm into L shin top, 1.75 x its diameter |
| PASS | L shin top screw front 1 | 7.0 mm into L shin top, 1.75 x its diameter |
| PASS | L shin cleat front wall screw 0 | 7.0 mm into L shin cleat front, 1.75 x its diameter |
| PASS | L shin cleat front wall screw 1 | 7.0 mm into L shin cleat front, 1.75 x its diameter |
| PASS | L shin cleat front cap screw 0 | 8.0 mm into L shin cleat front, 2.00 x its diameter |
| PASS | L shin top screw back 0 | 7.0 mm into L shin top, 1.75 x its diameter |
| PASS | L shin top screw back 1 | 7.0 mm into L shin top, 1.75 x its diameter |
| PASS | L shin cleat back wall screw 0 | 7.0 mm into L shin cleat back, 1.75 x its diameter |
| PASS | L shin cleat back wall screw 1 | 7.0 mm into L shin cleat back, 1.75 x its diameter |
| PASS | L shin cleat back cap screw 0 | 8.0 mm into L shin cleat back, 2.00 x its diameter |
| PASS | L shin top screw in 0 | 7.0 mm into L shin top, 1.75 x its diameter |
| PASS | L shin top screw in 1 | 7.0 mm into L shin top, 1.75 x its diameter |
| PASS | L shin top screw out 0 | 7.0 mm into L shin top, 1.75 x its diameter |
| PASS | L shin top screw out 1 | 7.0 mm into L shin top, 1.75 x its diameter |
| PASS | L ankle stack screw 0 | 5.5 mm into L ankle mount plate, 1.37 x its diameter |
| PASS | L ankle stack screw 1 | 5.5 mm into L ankle mount plate, 1.37 x its diameter |
| PASS | L ankle stack screw 2 | 5.5 mm into L ankle mount plate, 1.37 x its diameter |
| PASS | L ankle stack screw 3 | 5.5 mm into L ankle mount plate, 1.37 x its diameter |
| PASS | L ankle stack screw 4 | 5.5 mm into L ankle mount plate, 1.37 x its diameter |
| PASS | L ankle cap screw 0 | 8.0 mm into L ankle mount plate, 2.00 x its diameter |
| PASS | L ankle cap screw 1 | 8.0 mm into L ankle mount plate, 2.00 x its diameter |
| PASS | L ankle stub screw 0 | 6.0 mm into L ankle plate in, 1.50 x its diameter |
| PASS | L ankle stub screw 1 | 6.0 mm into L ankle plate in, 1.50 x its diameter |
| PASS | L ankle stub screw 2 | 6.0 mm into L ankle plate in, 1.50 x its diameter |
| PASS | R shin hub screw 0 | 5.0 mm into R shin hub out, 1.25 x its diameter |
| PASS | R shin hub screw 1 | 5.0 mm into R shin hub out, 1.25 x its diameter |
| PASS | R shin spacer screw 0 | 12.0 mm into R shin spacer, 2.40 x its diameter |
| PASS | R shin spacer screw 1 | 12.0 mm into R shin spacer, 2.40 x its diameter |
| PASS | R shin top screw front 0 | 7.0 mm into R shin top, 1.75 x its diameter |
| PASS | R shin top screw front 1 | 7.0 mm into R shin top, 1.75 x its diameter |
| PASS | R shin cleat front wall screw 0 | 7.0 mm into R shin cleat front, 1.75 x its diameter |
| PASS | R shin cleat front wall screw 1 | 7.0 mm into R shin cleat front, 1.75 x its diameter |
| PASS | R shin cleat front cap screw 0 | 8.0 mm into R shin cleat front, 2.00 x its diameter |
| PASS | R shin top screw back 0 | 7.0 mm into R shin top, 1.75 x its diameter |
| PASS | R shin top screw back 1 | 7.0 mm into R shin top, 1.75 x its diameter |
| PASS | R shin cleat back wall screw 0 | 7.0 mm into R shin cleat back, 1.75 x its diameter |
| PASS | R shin cleat back wall screw 1 | 7.0 mm into R shin cleat back, 1.75 x its diameter |
| PASS | R shin cleat back cap screw 0 | 8.0 mm into R shin cleat back, 2.00 x its diameter |
| PASS | R shin top screw in 0 | 7.0 mm into R shin top, 1.75 x its diameter |
| PASS | R shin top screw in 1 | 7.0 mm into R shin top, 1.75 x its diameter |
| PASS | R shin top screw out 0 | 7.0 mm into R shin top, 1.75 x its diameter |
| PASS | R shin top screw out 1 | 7.0 mm into R shin top, 1.75 x its diameter |
| PASS | R ankle stack screw 0 | 5.5 mm into R ankle mount plate, 1.37 x its diameter |
| PASS | R ankle stack screw 1 | 5.5 mm into R ankle mount plate, 1.37 x its diameter |
| PASS | R ankle stack screw 2 | 5.5 mm into R ankle mount plate, 1.37 x its diameter |
| PASS | R ankle stack screw 3 | 5.5 mm into R ankle mount plate, 1.37 x its diameter |
| PASS | R ankle stack screw 4 | 5.5 mm into R ankle mount plate, 1.37 x its diameter |
| PASS | R ankle cap screw 0 | 8.0 mm into R ankle mount plate, 2.00 x its diameter |
| PASS | R ankle cap screw 1 | 8.0 mm into R ankle mount plate, 2.00 x its diameter |
| PASS | R ankle stub screw 0 | 6.0 mm into R ankle plate in, 1.50 x its diameter |
| PASS | R ankle stub screw 1 | 6.0 mm into R ankle plate in, 1.50 x its diameter |
| PASS | R ankle stub screw 2 | 6.0 mm into R ankle plate in, 1.50 x its diameter |
| PASS | L ankle ear out foot screw 0 | 7.0 mm into L ankle ear out, 1.75 x its diameter |
| PASS | L ankle ear out foot screw 1 | 7.0 mm into L ankle ear out, 1.75 x its diameter |
| PASS | L ankle ear out foot screw 2 | 7.0 mm into L ankle ear out, 1.75 x its diameter |
| PASS | L ankle ear in foot screw 0 | 7.0 mm into L ankle ear in, 1.75 x its diameter |
| PASS | L ankle ear in foot screw 1 | 7.0 mm into L ankle ear in, 1.75 x its diameter |
| PASS | L ankle ear in foot screw 2 | 7.0 mm into L ankle ear in, 1.75 x its diameter |
| PASS | L ankle ear screw 0 | 8.0 mm into L ankle output, 1.60 x its diameter |
| PASS | L ankle ear screw 1 | 8.0 mm into L ankle output, 1.60 x its diameter |
| PASS | L ankle ear screw 2 | 8.0 mm into L ankle output, 1.60 x its diameter |
| PASS | L ankle ear screw 3 | 8.0 mm into L ankle output, 1.60 x its diameter |
| PASS | L ankle ear screw 4 | 8.0 mm into L ankle output, 1.60 x its diameter |
| PASS | L ankle ear screw 5 | 8.0 mm into L ankle output, 1.60 x its diameter |
| PASS | L ankle housing screw 0 | 8.0 mm into L ankle bearing housing, 1.60 x its diameter |
| PASS | L ankle housing screw 1 | 8.0 mm into L ankle bearing housing, 1.60 x its diameter |
| PASS | L ankle housing screw 2 | 8.0 mm into L ankle bearing housing, 1.60 x its diameter |
| PASS | L shoe rear screw 0 | 7.0 mm into L shoe rear, 1.75 x its diameter |
| PASS | L shoe rear screw 1 | 7.0 mm into L shoe rear, 1.75 x its diameter |
| PASS | L shoe front screw 0 | 7.0 mm into L shoe front, 1.75 x its diameter |
| PASS | L shoe front screw 1 | 7.0 mm into L shoe front, 1.75 x its diameter |
| PASS | R ankle ear out foot screw 0 | 7.0 mm into R ankle ear out, 1.75 x its diameter |
| PASS | R ankle ear out foot screw 1 | 7.0 mm into R ankle ear out, 1.75 x its diameter |
| PASS | R ankle ear out foot screw 2 | 7.0 mm into R ankle ear out, 1.75 x its diameter |
| PASS | R ankle ear in foot screw 0 | 7.0 mm into R ankle ear in, 1.75 x its diameter |
| PASS | R ankle ear in foot screw 1 | 7.0 mm into R ankle ear in, 1.75 x its diameter |
| PASS | R ankle ear in foot screw 2 | 7.0 mm into R ankle ear in, 1.75 x its diameter |
| PASS | R ankle ear screw 0 | 8.0 mm into R ankle output, 1.60 x its diameter |
| PASS | R ankle ear screw 1 | 8.0 mm into R ankle output, 1.60 x its diameter |
| PASS | R ankle ear screw 2 | 8.0 mm into R ankle output, 1.60 x its diameter |
| PASS | R ankle ear screw 3 | 8.0 mm into R ankle output, 1.60 x its diameter |
| PASS | R ankle ear screw 4 | 8.0 mm into R ankle output, 1.60 x its diameter |
| PASS | R ankle ear screw 5 | 8.0 mm into R ankle output, 1.60 x its diameter |
| PASS | R ankle housing screw 0 | 8.0 mm into R ankle bearing housing, 1.60 x its diameter |
| PASS | R ankle housing screw 1 | 8.0 mm into R ankle bearing housing, 1.60 x its diameter |
| PASS | R ankle housing screw 2 | 8.0 mm into R ankle bearing housing, 1.60 x its diameter |
| PASS | R shoe rear screw 0 | 7.0 mm into R shoe rear, 1.75 x its diameter |
| PASS | R shoe rear screw 1 | 7.0 mm into R shoe rear, 1.75 x its diameter |
| PASS | R shoe front screw 0 | 7.0 mm into R shoe front, 1.75 x its diameter |
| PASS | R shoe front screw 1 | 7.0 mm into R shoe front, 1.75 x its diameter |
| PASS | head pitch stator tie L screw 0 | 16.5 mm into neck spine, 3.29 x its diameter |
| PASS | head pitch stator tie L screw 1 | 16.5 mm into neck spine, 3.29 x its diameter |
| PASS | head pitch stator tie L screw 2 | 16.5 mm into neck spine, 3.29 x its diameter |
| PASS | head pitch yoke screw 0 | 8.0 mm into head pitch yoke, 2.00 x its diameter |
| PASS | head pitch yoke screw 1 | 8.0 mm into head pitch yoke, 2.00 x its diameter |
| PASS | head pitch yoke R screw 0 | 8.0 mm into head pitch yoke R, 2.00 x its diameter |
| PASS | head pitch yoke R screw 1 | 8.0 mm into head pitch yoke R, 2.00 x its diameter |
| PASS | head yaw front post 0 screw top 0 | 8.0 mm into head yaw front post 0, 2.00 x its diameter |
| PASS | head yaw front post 0 screw base 0 | 12.0 mm into head yaw front post 0, 2.40 x its diameter |
| PASS | head yaw front post 1 screw top 0 | 8.0 mm into head yaw front post 1, 2.00 x its diameter |
| PASS | head yaw front post 1 screw base 0 | 12.0 mm into head yaw front post 1, 2.40 x its diameter |
| PASS | head yaw front post 2 screw top 0 | 8.0 mm into head yaw front post 2, 2.00 x its diameter |
| PASS | head yaw front post 2 screw base 0 | 12.0 mm into head yaw front post 2, 2.40 x its diameter |
| PASS | head yaw front post 3 screw top 0 | 8.0 mm into head yaw front post 3, 2.00 x its diameter |
| PASS | head yaw front post 3 screw base 0 | 12.0 mm into head yaw front post 3, 2.40 x its diameter |
| PASS | head yaw plate screw 0 | 6.0 mm into head yaw output, 1.50 x its diameter |
| PASS | head yaw plate screw 1 | 6.0 mm into head yaw output, 1.50 x its diameter |
| PASS | head yaw plate screw 2 | 6.0 mm into head yaw output, 1.50 x its diameter |
| PASS | head yaw plate screw 3 | 6.0 mm into head yaw output, 1.50 x its diameter |
| PASS | head yaw plate screw 4 | 6.0 mm into head yaw output, 1.50 x its diameter |
| PASS | head yaw plate screw 5 | 6.0 mm into head yaw output, 1.50 x its diameter |
| PASS | head roll cradle screw 0 | 8.0 mm into head roll cradle, 2.00 x its diameter |
| PASS | head roll cradle screw 1 | 8.0 mm into head roll cradle, 2.00 x its diameter |
| PASS | head roll cradle screw 2 | 8.0 mm into head roll cradle, 2.00 x its diameter |
| PASS | head roll front post 0 screw top 0 | 8.0 mm into head roll front post 0, 2.00 x its diameter |
| PASS | head roll front post 0 screw base 0 | 12.0 mm into head roll front post 0, 2.40 x its diameter |
| PASS | head roll front post 1 screw top 0 | 8.0 mm into head roll front post 1, 2.00 x its diameter |
| PASS | head roll front post 1 screw base 0 | 12.0 mm into head roll front post 1, 2.40 x its diameter |
| PASS | head roll front post 2 screw top 0 | 8.0 mm into head roll front post 2, 2.00 x its diameter |
| PASS | head roll front post 2 screw base 0 | 12.0 mm into head roll front post 2, 2.40 x its diameter |
| PASS | head roll front post 3 screw top 0 | 8.0 mm into head roll front post 3, 2.00 x its diameter |
| PASS | head roll front post 3 screw base 0 | 12.0 mm into head roll front post 3, 2.40 x its diameter |
| PASS | head main frame screw 0 | 8.0 mm into head roll output, 2.00 x its diameter |
| PASS | head main frame screw 1 | 8.0 mm into head roll output, 2.00 x its diameter |
| PASS | head main frame screw 2 | 8.0 mm into head roll output, 2.00 x its diameter |
| PASS | head main frame screw 3 | 8.0 mm into head roll output, 2.00 x its diameter |
| PASS | head main frame screw 4 | 8.0 mm into head roll output, 2.00 x its diameter |
| PASS | head main frame screw 5 | 8.0 mm into head roll output, 2.00 x its diameter |
| PASS | head rail L screw main 0 | 8.0 mm into head main frame, 2.00 x its diameter |
| PASS | head rail L screw main 1 | 8.0 mm into head main frame, 2.00 x its diameter |
| PASS | head rail L screw rear 0 | 8.0 mm into head rail L, 2.00 x its diameter |
| PASS | head rail L screw rear 1 | 8.0 mm into head rail L, 2.00 x its diameter |
| PASS | head rail L screw front 0 | 8.0 mm into head rail L, 2.00 x its diameter |
| PASS | head rail L screw front 1 | 8.0 mm into head rail L, 2.00 x its diameter |
| PASS | head beak lug L screw 0 | 7.5 mm into head rail L, 1.87 x its diameter |
| PASS | head beak lug L screw 1 | 7.5 mm into head rail L, 1.87 x its diameter |
| PASS | head beak mount screw L 0 | 8.0 mm into head beak mount, 2.00 x its diameter |
| PASS | head beak mount screw L 1 | 8.0 mm into head beak mount, 2.00 x its diameter |
| PASS | head rail R screw main 0 | 8.0 mm into head main frame, 2.00 x its diameter |
| PASS | head rail R screw main 1 | 8.0 mm into head main frame, 2.00 x its diameter |
| PASS | head rail R screw rear 0 | 8.0 mm into head rail R, 2.00 x its diameter |
| PASS | head rail R screw rear 1 | 8.0 mm into head rail R, 2.00 x its diameter |
| PASS | head rail R screw front 0 | 8.0 mm into head rail R, 2.00 x its diameter |
| PASS | head rail R screw front 1 | 8.0 mm into head rail R, 2.00 x its diameter |
| PASS | head beak lug R screw 0 | 7.5 mm into head rail R, 1.87 x its diameter |
| PASS | head beak lug R screw 1 | 7.5 mm into head rail R, 1.87 x its diameter |
| PASS | head beak mount screw R 0 | 8.0 mm into head beak mount, 2.00 x its diameter |
| PASS | head beak mount screw R 1 | 8.0 mm into head beak mount, 2.00 x its diameter |
| PASS | beak hinge L screw 0 | 8.0 mm into beak tray frame, 2.00 x its diameter |
| PASS | beak hinge L screw 1 | 8.0 mm into beak tray frame, 2.00 x its diameter |
| PASS | beak hinge R screw 0 | 8.0 mm into beak tray frame, 2.00 x its diameter |
| PASS | beak hinge R screw 1 | 8.0 mm into beak tray frame, 2.00 x its diameter |
| PASS | RS03 front screws, into RobStride's threads | 16: 8.0 mm of a 11.0 mm thread, from the spec (not measured) |
| PASS | RS03 mount screws, into RobStride's threads | 8: 5.0 mm of a 11.0 mm thread, from the spec (not measured) |
| PASS | RS03 output screws, into RobStride's threads | 12: 4.0 mm of a 9.0 mm thread, from the spec (not measured) |
| PASS | RS04 mount screws, into RobStride's threads | 190: 4.0 mm of a 6.0 mm thread, from the spec (not measured) |
| PASS | RS04 output screws, into RobStride's threads | 171: 3.0 mm of a 3.5 mm thread, from the spec (not measured) |

## PATH

| status | item | detail |
|---|---|---|
| PASS | 1 deck plate |  |
| PASS | 2 L hip yaw housing |  |
| PASS | 3 L_hip_yaw actuator (buy) RS04 |  |
| PASS | 4 R hip yaw housing |  |
| PASS | 5 R_hip_yaw actuator (buy) RS04 |  |
| PASS | 6 body post 0 |  |
| PASS | 7 body post 1 |  |
| PASS | 8 body post 2 |  |
| PASS | 9 body post 3 |  |
| PASS | 10 neck tie |  |
| PASS | 11 neck plate L |  |
| PASS | 12 neck plate R |  |
| PASS | 13 neck cleat L |  |
| PASS | 14 neck cleat R |  |
| PASS | 15 neck_pitch actuator L (buy) RS04 |  |
| PASS | 16 neck_pitch actuator R (buy) RS04 |  |
| PASS | 17 computer standoff 0 |  |
| PASS | 18 computer standoff 1 |  |
| PASS | 19 computer and power boards |  |
| PASS | 20 battery 13S |  |
| PASS | 21 battery BMS, fuse and case, allowance |  |
| PASS | 22 upper plate |  |
| PASS | 23 L hip yaw inner retainer |  |
| PASS | 24 L hip yaw bearing |  |
| PASS | 25 L hip yaw retainer |  |
| PASS | 26 L hip yaw flange |  |
| PASS | 27 L hip yaw beam |  |
| PASS | 28 L hip roll cheek F |  |
| PASS | 29 L hip roll cleat F |  |
| PASS | 30 L_hip_roll actuator F (buy) RS04 |  |
| PASS | 31 L hip roll output F |  |
| PASS | 32 L hip roll yoke |  |
| PASS | 33 L hip roll output B |  |
| PASS | 34 L_hip_roll actuator B (buy) RS04 |  |
| PASS | 35 L hip roll cheek B |  |
| PASS | 36 L hip roll cleat B |  |
| PASS | 37.1 L hip pitch upright in |  |
| PASS | 37.2 L_hip_pitch actuator I (buy) RS04 |  |
| PASS | 37 L hip pitch inner upright |  |
| PASS | 38 L hip pitch output I |  |
| PASS | 39.1 L thigh plate in |  |
| PASS | 39.2 L thigh spacer hip |  |
| PASS | 39.3 L thigh spacer mid |  |
| PASS | 39.4 L thigh plate out |  |
| PASS | 39.5.1 L thigh rear plate in |  |
| PASS | 39.5.2 L_knee actuator I (buy) RS04 |  |
| PASS | 39.5.3 L knee crank I |  |
| PASS | 39.5.4 L knee crank pin I |  |
| PASS | 39.5.5 L knee rod I, L knee rod I bush A, L knee rod I bush B |  |
| PASS | 39.5.7 L thigh tie 0i |  |
| PASS | 39.5.8 L thigh tie 1i |  |
| PASS | 39.5 L knee drive I |  |
| PASS | 39.6.1 L thigh rear plate out |  |
| PASS | 39.6.2 L_knee actuator O (buy) RS04 |  |
| PASS | 39.6.3 L knee crank O |  |
| PASS | 39.6.4 L knee crank pin O |  |
| PASS | 39.6.5 L knee rod O, L knee rod O bush A, L knee rod O bush B |  |
| PASS | 39.6.7 L thigh tie 0o |  |
| PASS | 39.6.8 L thigh tie 1o |  |
| PASS | 39.6 L knee drive O |  |
| PASS | 39 L thigh |  |
| PASS | 40.1 L hip pitch upright out |  |
| PASS | 40.2 L_hip_pitch actuator O (buy) RS04 |  |
| PASS | 40.3 L hip pitch output O |  |
| PASS | 40 L hip pitch outer |  |
| PASS | 41 L hip pitch bridge |  |
| PASS | 42.1.1 L ankle mount plate |  |
| PASS | 42.1.2 L_ankle_pitch actuator (buy) RS04 |  |
| PASS | 42.1.3 L ankle spacer |  |
| PASS | 42.1.4 L ankle plate in |  |
| PASS | 42.1.5 L ankle stub |  |
| PASS | 42.1 L ankle stack |  |
| PASS | 42.3 L shin cleat front |  |
| PASS | 42.4 L shin cleat back |  |
| PASS | 42.5 L shin tube |  |
| PASS | 42.6.1 L shin top |  |
| PASS | 42.6.2 L shin spacer |  |
| PASS | 42.6.3 L shin hub in |  |
| PASS | 42.6.4 L shin hub out |  |
| PASS | 42.6 L knee top |  |
| PASS | 42 L shin |  |
| PASS | 43 L knee bearing |  |
| PASS | 44 L knee far bearing |  |
| PASS | 45 L knee shaft |  |
| PASS | 46.1 L knee lever I |  |
| PASS | 46.2 L knee lever pin I |  |
| PASS | 46 L knee lever I |  |
| PASS | 48.1 L knee lever O |  |
| PASS | 48.2 L knee lever pin O |  |
| PASS | 48 L knee lever O |  |
| PASS | 50 L ankle bearing |  |
| PASS | 51 L ankle output |  |
| PASS | 52 L ankle bearing housing |  |
| PASS | 53.1 L foot plate |  |
| PASS | 53.2 L ankle ear in |  |
| PASS | 53.3 L ankle ear out |  |
| PASS | 53.4 L shoe rear |  |
| PASS | 53.5 L shoe front |  |
| PASS | 53.6 L sole rear |  |
| PASS | 53.7 L sole front |  |
| PASS | 53 L foot |  |
| PASS | 54 L thigh cover post out hip |  |
| PASS | 55 L thigh cover post out rear |  |
| PASS | 56 L thigh cover post out knee |  |
| PASS | 57 L thigh cover out hip |  |
| PASS | 58 L thigh cover out rear |  |
| PASS | 59 L thigh cover out knee |  |
| PASS | 60 R hip yaw inner retainer |  |
| PASS | 61 R hip yaw bearing |  |
| PASS | 62 R hip yaw retainer |  |
| PASS | 63 R hip yaw flange |  |
| PASS | 64 R hip yaw beam |  |
| PASS | 65 R hip roll cheek F |  |
| PASS | 66 R hip roll cleat F |  |
| PASS | 67 R_hip_roll actuator F (buy) RS04 |  |
| PASS | 68 R hip roll output F |  |
| PASS | 69 R hip roll yoke |  |
| PASS | 70 R hip roll output B |  |
| PASS | 71 R_hip_roll actuator B (buy) RS04 |  |
| PASS | 72 R hip roll cheek B |  |
| PASS | 73 R hip roll cleat B |  |
| PASS | 74.1 R hip pitch upright in |  |
| PASS | 74.2 R_hip_pitch actuator I (buy) RS04 |  |
| PASS | 74 R hip pitch inner upright |  |
| PASS | 75 R hip pitch output I |  |
| PASS | 76.1 R thigh plate in |  |
| PASS | 76.2 R thigh spacer hip |  |
| PASS | 76.3 R thigh spacer mid |  |
| PASS | 76.4 R thigh plate out |  |
| PASS | 76.5.1 R thigh rear plate in |  |
| PASS | 76.5.2 R_knee actuator I (buy) RS04 |  |
| PASS | 76.5.3 R knee crank I |  |
| PASS | 76.5.4 R knee crank pin I |  |
| PASS | 76.5.5 R knee rod I, R knee rod I bush A, R knee rod I bush B |  |
| PASS | 76.5.7 R thigh tie 0i |  |
| PASS | 76.5.8 R thigh tie 1i |  |
| PASS | 76.5 R knee drive I |  |
| PASS | 76.6.1 R thigh rear plate out |  |
| PASS | 76.6.2 R_knee actuator O (buy) RS04 |  |
| PASS | 76.6.3 R knee crank O |  |
| PASS | 76.6.4 R knee crank pin O |  |
| PASS | 76.6.5 R knee rod O, R knee rod O bush A, R knee rod O bush B |  |
| PASS | 76.6.7 R thigh tie 0o |  |
| PASS | 76.6.8 R thigh tie 1o |  |
| PASS | 76.6 R knee drive O |  |
| PASS | 76 R thigh |  |
| PASS | 77.1 R hip pitch upright out |  |
| PASS | 77.2 R_hip_pitch actuator O (buy) RS04 |  |
| PASS | 77.3 R hip pitch output O |  |
| PASS | 77 R hip pitch outer |  |
| PASS | 78 R hip pitch bridge |  |
| PASS | 79.1.1 R ankle mount plate |  |
| PASS | 79.1.2 R_ankle_pitch actuator (buy) RS04 |  |
| PASS | 79.1.3 R ankle spacer |  |
| PASS | 79.1.4 R ankle plate in |  |
| PASS | 79.1.5 R ankle stub |  |
| PASS | 79.1 R ankle stack |  |
| PASS | 79.3 R shin cleat front |  |
| PASS | 79.4 R shin cleat back |  |
| PASS | 79.5 R shin tube |  |
| PASS | 79.6.1 R shin top |  |
| PASS | 79.6.2 R shin spacer |  |
| PASS | 79.6.3 R shin hub in |  |
| PASS | 79.6.4 R shin hub out |  |
| PASS | 79.6 R knee top |  |
| PASS | 79 R shin |  |
| PASS | 80 R knee bearing |  |
| PASS | 81 R knee far bearing |  |
| PASS | 82 R knee shaft |  |
| PASS | 83.1 R knee lever I |  |
| PASS | 83.2 R knee lever pin I |  |
| PASS | 83 R knee lever I |  |
| PASS | 85.1 R knee lever O |  |
| PASS | 85.2 R knee lever pin O |  |
| PASS | 85 R knee lever O |  |
| PASS | 87 R ankle bearing |  |
| PASS | 88 R ankle output |  |
| PASS | 89 R ankle bearing housing |  |
| PASS | 90.1 R foot plate |  |
| PASS | 90.2 R ankle ear in |  |
| PASS | 90.3 R ankle ear out |  |
| PASS | 90.4 R shoe rear |  |
| PASS | 90.5 R shoe front |  |
| PASS | 90.6 R sole rear |  |
| PASS | 90.7 R sole front |  |
| PASS | 90 R foot |  |
| PASS | 91 R thigh cover post out hip |  |
| PASS | 92 R thigh cover post out rear |  |
| PASS | 93 R thigh cover post out knee |  |
| PASS | 94 R thigh cover out hip |  |
| PASS | 95 R thigh cover out rear |  |
| PASS | 96 R thigh cover out knee |  |
| PASS | 97 neck output L |  |
| PASS | 98 neck output R |  |
| PASS | 99 neck spine |  |
| PASS | 100.1 head pitch stator plate L |  |
| PASS | 100.2 head_pitch actuator L (buy) RS04 |  |
| PASS | 100.3 head pitch drive sprocket L (buy) 13T #40 |  |
| PASS | 100 head pitch drive |  |
| PASS | 101 head pitch stator tie L |  |
| PASS | 102 head pitch L bearing |  |
| PASS | 103 head pitch R bearing |  |
| PASS | 104 head pitch sprocket L (buy) 25T #40 |  |
| PASS | 105 head pitch yoke |  |
| PASS | 106 head pitch yoke R |  |
| PASS | 107 head pitch shaft |  |
| PASS | 109 head pitch bridge |  |
| PASS | 110 head_yaw actuator (buy) RS03 |  |
| PASS | 111 head yaw front post 0 |  |
| PASS | 112 head yaw front post 1 |  |
| PASS | 113 head yaw front post 2 |  |
| PASS | 114 head yaw front post 3 |  |
| PASS | 115 head yaw front ring |  |
| PASS | 116 head yaw output |  |
| PASS | 117 head yaw plate |  |
| PASS | 118 head roll cradle |  |
| PASS | 119 head_roll actuator (buy) RS03 |  |
| PASS | 120 head roll front post 0 |  |
| PASS | 121 head roll front post 1 |  |
| PASS | 122 head roll front post 2 |  |
| PASS | 123 head roll front post 3 |  |
| PASS | 124 head roll front ring |  |
| PASS | 125 head roll output |  |
| PASS | 126.1 head main frame |  |
| PASS | 126.2 head rail L |  |
| PASS | 126.3 head rail R |  |
| PASS | 126.4 head rear frame |  |
| PASS | 126.5 head front frame |  |
| PASS | 126.6 head beak lug L |  |
| PASS | 126.7 head beak lug R |  |
| PASS | 126.8 head beak mount |  |
| PASS | 126.9 beak actuator (buy) RS00 |  |
| PASS | 126.10 head boards and camera |  |
| PASS | 126 head frame |  |
| PASS | 127.1 beak tray frame |  |
| PASS | 127.2 beak hinge L |  |
| PASS | 127.3 beak hinge R |  |
| PASS | 127 beak |  |

## KEY

| status | item | detail |
|---|---|---|
| PASS | L hip yaw housing screw 0 | step 2 |
| PASS | L hip yaw housing screw 1 | step 2 |
| PASS | L hip yaw housing screw 2 | step 2 |
| PASS | L hip yaw housing screw 3 | step 2 |
| PASS | L hip yaw housing screw 4 | step 2 |
| PASS | L hip yaw housing screw 5 | step 2 |
| PASS | L hip yaw housing screw 6 | step 2 |
| PASS | L hip yaw housing screw 7 | step 2 |
| PASS | L hip yaw housing screw 8 | step 2 |
| PASS | L hip yaw housing screw 9 | step 2 |
| PASS | L hip yaw mount screw 0 | step 3 |
| PASS | L hip yaw mount screw 1 | step 3 |
| PASS | L hip yaw mount screw 2 | step 3 |
| PASS | L hip yaw mount screw 3 | step 3 |
| PASS | L hip yaw mount screw 4 | step 3 |
| PASS | L hip yaw mount screw 5 | step 3 |
| PASS | L hip yaw mount screw 6 | step 3 |
| PASS | L hip yaw mount screw 7 | step 3 |
| PASS | L hip yaw mount screw 8 | step 3 |
| PASS | L hip yaw mount screw 9 | step 3 |
| PASS | R hip yaw housing screw 0 | step 4 |
| PASS | R hip yaw housing screw 1 | step 4 |
| PASS | R hip yaw housing screw 2 | step 4 |
| PASS | R hip yaw housing screw 3 | step 4 |
| PASS | R hip yaw housing screw 4 | step 4 |
| PASS | R hip yaw housing screw 5 | step 4 |
| PASS | R hip yaw housing screw 6 | step 4 |
| PASS | R hip yaw housing screw 7 | step 4 |
| PASS | R hip yaw housing screw 8 | step 4 |
| PASS | R hip yaw housing screw 9 | step 4 |
| PASS | R hip yaw mount screw 0 | step 5 |
| PASS | R hip yaw mount screw 1 | step 5 |
| PASS | R hip yaw mount screw 2 | step 5 |
| PASS | R hip yaw mount screw 3 | step 5 |
| PASS | R hip yaw mount screw 4 | step 5 |
| PASS | R hip yaw mount screw 5 | step 5 |
| PASS | R hip yaw mount screw 6 | step 5 |
| PASS | R hip yaw mount screw 7 | step 5 |
| PASS | R hip yaw mount screw 8 | step 5 |
| PASS | R hip yaw mount screw 9 | step 5 |
| PASS | body post 0 screw low 0 | step 6 |
| PASS | body post 1 screw low 0 | step 7 |
| PASS | body post 2 screw low 0 | step 8 |
| PASS | body post 3 screw low 0 | step 9 |
| PASS | neck tie deck screw 0 | step 10 |
| PASS | neck tie deck screw 1 | step 10 |
| PASS | neck tie screw L 0 | step 11 |
| PASS | neck tie screw L 1 | step 11 |
| PASS | neck tie screw R 0 | step 12 |
| PASS | neck tie screw R 1 | step 12 |
| PASS | neck cleat screw L 0 | step 13 |
| PASS | neck cleat deck screw L 0 | step 13 |
| PASS | neck cleat deck screw L 1 | step 13 |
| PASS | neck cleat screw R 0 | step 14 |
| PASS | neck cleat deck screw R 0 | step 14 |
| PASS | neck cleat deck screw R 1 | step 14 |
| PASS | neck L mount screw 0 | step 15 |
| PASS | neck L mount screw 1 | step 15 |
| PASS | neck L mount screw 2 | step 15 |
| PASS | neck L mount screw 3 | step 15 |
| PASS | neck L mount screw 4 | step 15 |
| PASS | neck L mount screw 5 | step 15 |
| PASS | neck L mount screw 6 | step 15 |
| PASS | neck L mount screw 7 | step 15 |
| PASS | neck L mount screw 8 | step 15 |
| PASS | neck L mount screw 9 | step 15 |
| PASS | neck R mount screw 0 | step 16 |
| PASS | neck R mount screw 1 | step 16 |
| PASS | neck R mount screw 2 | step 16 |
| PASS | neck R mount screw 3 | step 16 |
| PASS | neck R mount screw 4 | step 16 |
| PASS | neck R mount screw 5 | step 16 |
| PASS | neck R mount screw 6 | step 16 |
| PASS | neck R mount screw 7 | step 16 |
| PASS | neck R mount screw 8 | step 16 |
| PASS | neck R mount screw 9 | step 16 |
| PASS | computer standoff 0 screw 0 | step 17 |
| PASS | computer standoff 0 screw 1 | step 17 |
| PASS | computer standoff 1 screw 0 | step 18 |
| PASS | computer standoff 1 screw 1 | step 18 |
| PASS | body post 0 screw high 0 | step 22 |
| PASS | body post 1 screw high 0 | step 22 |
| PASS | body post 2 screw high 0 | step 22 |
| PASS | body post 3 screw high 0 | step 22 |
| PASS | L hip yaw retainer screw 0 | step 25 |
| PASS | L hip yaw retainer screw 1 | step 25 |
| PASS | L hip yaw retainer screw 2 | step 25 |
| PASS | L hip yaw retainer screw 3 | step 25 |
| PASS | L hip yaw retainer screw 4 | step 25 |
| PASS | L hip yaw retainer screw 5 | step 25 |
| PASS | L hip yaw retainer screw 6 | step 25 |
| PASS | L hip yaw retainer screw 7 | step 25 |
| PASS | L hip yaw inner retainer screw 0 | step 26 |
| PASS | L hip yaw inner retainer screw 1 | step 26 |
| PASS | L hip yaw inner retainer screw 2 | step 26 |
| PASS | L hip yaw inner retainer screw 3 | step 26 |
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
| PASS | L hip pitch O mount screw 3 | step 40.2 |
| PASS | L hip pitch O mount screw 4 | step 40.2 |
| PASS | L hip pitch O mount screw 5 | step 40.2 |
| PASS | L hip pitch O mount screw 6 | step 40.2 |
| PASS | L hip pitch O mount screw 7 | step 40.2 |
| PASS | L hip pitch O mount screw 8 | step 40.2 |
| PASS | L hip pitch O mount screw 9 | step 40.2 |
| PASS | L hip pitch O screw 0 | step 40.3 |
| PASS | L hip pitch O screw 1 | step 40.3 |
| PASS | L hip pitch O screw 2 | step 40.3 |
| PASS | L hip pitch O screw 3 | step 40.3 |
| PASS | L hip pitch O screw 4 | step 40.3 |
| PASS | L hip pitch O screw 5 | step 40.3 |
| PASS | L hip pitch O screw 6 | step 40.3 |
| PASS | L hip pitch O screw 7 | step 40.3 |
| PASS | L hip pitch O screw 8 | step 40.3 |
| PASS | L thigh screw O 0 | step 40 |
| PASS | L thigh screw O 1 | step 40 |
| PASS | L thigh screw O 2 | step 40 |
| PASS | L thigh screw O 3 | step 40 |
| PASS | L thigh screw O 4 | step 40 |
| PASS | L hip pitch bridge screw in 0 | step 41 |
| PASS | L hip pitch bridge screw in 1 | step 41 |
| PASS | L hip pitch bridge screw out 0 | step 41 |
| PASS | L hip pitch bridge screw out 1 | step 41 |
| PASS | L ankle mount screw 0 | step 42.1.2 |
| PASS | L ankle mount screw 1 | step 42.1.2 |
| PASS | L ankle mount screw 2 | step 42.1.2 |
| PASS | L ankle mount screw 3 | step 42.1.2 |
| PASS | L ankle mount screw 4 | step 42.1.2 |
| PASS | L ankle mount screw 5 | step 42.1.2 |
| PASS | L ankle mount screw 6 | step 42.1.2 |
| PASS | L ankle mount screw 7 | step 42.1.2 |
| PASS | L ankle mount screw 8 | step 42.1.2 |
| PASS | L ankle mount screw 9 | step 42.1.2 |
| PASS | L ankle stack screw 0 | step 42.1.4 |
| PASS | L ankle stack screw 1 | step 42.1.4 |
| PASS | L ankle stack screw 2 | step 42.1.4 |
| PASS | L ankle stack screw 3 | step 42.1.4 |
| PASS | L ankle stack screw 4 | step 42.1.4 |
| PASS | L ankle stub screw 0 | step 42.1.5 |
| PASS | L ankle stub screw 1 | step 42.1.5 |
| PASS | L ankle stub screw 2 | step 42.1.5 |
| PASS | L ankle cap screw 0 | step 42.2 |
| PASS | L ankle cap screw 1 | step 42.2 |
| PASS | L shin cleat front cap screw 0 | step 42.3 |
| PASS | L shin cleat back cap screw 0 | step 42.4 |
| PASS | L shin cleat front wall screw 0 | step 42.5 |
| PASS | L shin cleat front wall screw 1 | step 42.5 |
| PASS | L shin cleat back wall screw 0 | step 42.5 |
| PASS | L shin cleat back wall screw 1 | step 42.5 |
| PASS | L shin spacer screw 0 | step 42.6.2 |
| PASS | L shin spacer screw 1 | step 42.6.2 |
| PASS | L shin hub screw 0 | step 42.6.4 |
| PASS | L shin hub screw 1 | step 42.6.4 |
| PASS | L shin top screw front 0 | step 42.6 |
| PASS | L shin top screw front 1 | step 42.6 |
| PASS | L shin top screw back 0 | step 42.6 |
| PASS | L shin top screw back 1 | step 42.6 |
| PASS | L shin top screw in 0 | step 42.6 |
| PASS | L shin top screw in 1 | step 42.6 |
| PASS | L shin top screw out 0 | step 42.6 |
| PASS | L shin top screw out 1 | step 42.6 |
| PASS | L ankle screw 0 | step 51 |
| PASS | L ankle screw 1 | step 51 |
| PASS | L ankle screw 2 | step 51 |
| PASS | L ankle screw 3 | step 51 |
| PASS | L ankle screw 4 | step 51 |
| PASS | L ankle screw 5 | step 51 |
| PASS | L ankle screw 6 | step 51 |
| PASS | L ankle screw 7 | step 51 |
| PASS | L ankle screw 8 | step 51 |
| PASS | L ankle ear in foot screw 0 | step 53.2 |
| PASS | L ankle ear in foot screw 1 | step 53.2 |
| PASS | L ankle ear in foot screw 2 | step 53.2 |
| PASS | L ankle ear out foot screw 0 | step 53.3 |
| PASS | L ankle ear out foot screw 1 | step 53.3 |
| PASS | L ankle ear out foot screw 2 | step 53.3 |
| PASS | L shoe rear screw 0 | step 53.4 |
| PASS | L shoe rear screw 1 | step 53.4 |
| PASS | L shoe front screw 0 | step 53.5 |
| PASS | L shoe front screw 1 | step 53.5 |
| PASS | L ankle ear screw 0 | step 53 |
| PASS | L ankle ear screw 1 | step 53 |
| PASS | L ankle ear screw 2 | step 53 |
| PASS | L ankle ear screw 3 | step 53 |
| PASS | L ankle ear screw 4 | step 53 |
| PASS | L ankle ear screw 5 | step 53 |
| PASS | L ankle housing screw 0 | step 53 |
| PASS | L ankle housing screw 1 | step 53 |
| PASS | L ankle housing screw 2 | step 53 |
| PASS | L thigh cover screw hip 0 | step 57 |
| PASS | L thigh cover screw rear 0 | step 58 |
| PASS | L thigh cover screw knee 0 | step 59 |
| PASS | R hip yaw retainer screw 0 | step 62 |
| PASS | R hip yaw retainer screw 1 | step 62 |
| PASS | R hip yaw retainer screw 2 | step 62 |
| PASS | R hip yaw retainer screw 3 | step 62 |
| PASS | R hip yaw retainer screw 4 | step 62 |
| PASS | R hip yaw retainer screw 5 | step 62 |
| PASS | R hip yaw retainer screw 6 | step 62 |
| PASS | R hip yaw retainer screw 7 | step 62 |
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
| PASS | R thigh screw I 3 | step 76 |
| PASS | R thigh screw I 4 | step 76 |
| PASS | R thigh screw I 5 | step 76 |
| PASS | R hip pitch O mount screw 0 | step 77.2 |
| PASS | R hip pitch O mount screw 1 | step 77.2 |
| PASS | R hip pitch O mount screw 2 | step 77.2 |
| PASS | R hip pitch O mount screw 3 | step 77.2 |
| PASS | R hip pitch O mount screw 4 | step 77.2 |
| PASS | R hip pitch O mount screw 5 | step 77.2 |
| PASS | R hip pitch O mount screw 6 | step 77.2 |
| PASS | R hip pitch O mount screw 7 | step 77.2 |
| PASS | R hip pitch O mount screw 8 | step 77.2 |
| PASS | R hip pitch O mount screw 9 | step 77.2 |
| PASS | R hip pitch O screw 0 | step 77.3 |
| PASS | R hip pitch O screw 1 | step 77.3 |
| PASS | R hip pitch O screw 2 | step 77.3 |
| PASS | R hip pitch O screw 3 | step 77.3 |
| PASS | R hip pitch O screw 4 | step 77.3 |
| PASS | R hip pitch O screw 5 | step 77.3 |
| PASS | R hip pitch O screw 6 | step 77.3 |
| PASS | R hip pitch O screw 7 | step 77.3 |
| PASS | R hip pitch O screw 8 | step 77.3 |
| PASS | R thigh screw O 0 | step 77 |
| PASS | R thigh screw O 1 | step 77 |
| PASS | R thigh screw O 2 | step 77 |
| PASS | R thigh screw O 3 | step 77 |
| PASS | R thigh screw O 4 | step 77 |
| PASS | R hip pitch bridge screw in 0 | step 78 |
| PASS | R hip pitch bridge screw in 1 | step 78 |
| PASS | R hip pitch bridge screw out 0 | step 78 |
| PASS | R hip pitch bridge screw out 1 | step 78 |
| PASS | R ankle mount screw 0 | step 79.1.2 |
| PASS | R ankle mount screw 1 | step 79.1.2 |
| PASS | R ankle mount screw 2 | step 79.1.2 |
| PASS | R ankle mount screw 3 | step 79.1.2 |
| PASS | R ankle mount screw 4 | step 79.1.2 |
| PASS | R ankle mount screw 5 | step 79.1.2 |
| PASS | R ankle mount screw 6 | step 79.1.2 |
| PASS | R ankle mount screw 7 | step 79.1.2 |
| PASS | R ankle mount screw 8 | step 79.1.2 |
| PASS | R ankle mount screw 9 | step 79.1.2 |
| PASS | R ankle stack screw 0 | step 79.1.4 |
| PASS | R ankle stack screw 1 | step 79.1.4 |
| PASS | R ankle stack screw 2 | step 79.1.4 |
| PASS | R ankle stack screw 3 | step 79.1.4 |
| PASS | R ankle stack screw 4 | step 79.1.4 |
| PASS | R ankle stub screw 0 | step 79.1.5 |
| PASS | R ankle stub screw 1 | step 79.1.5 |
| PASS | R ankle stub screw 2 | step 79.1.5 |
| PASS | R ankle cap screw 0 | step 79.2 |
| PASS | R ankle cap screw 1 | step 79.2 |
| PASS | R shin cleat front cap screw 0 | step 79.3 |
| PASS | R shin cleat back cap screw 0 | step 79.4 |
| PASS | R shin cleat front wall screw 0 | step 79.5 |
| PASS | R shin cleat front wall screw 1 | step 79.5 |
| PASS | R shin cleat back wall screw 0 | step 79.5 |
| PASS | R shin cleat back wall screw 1 | step 79.5 |
| PASS | R shin spacer screw 0 | step 79.6.2 |
| PASS | R shin spacer screw 1 | step 79.6.2 |
| PASS | R shin hub screw 0 | step 79.6.4 |
| PASS | R shin hub screw 1 | step 79.6.4 |
| PASS | R shin top screw front 0 | step 79.6 |
| PASS | R shin top screw front 1 | step 79.6 |
| PASS | R shin top screw back 0 | step 79.6 |
| PASS | R shin top screw back 1 | step 79.6 |
| PASS | R shin top screw in 0 | step 79.6 |
| PASS | R shin top screw in 1 | step 79.6 |
| PASS | R shin top screw out 0 | step 79.6 |
| PASS | R shin top screw out 1 | step 79.6 |
| PASS | R ankle screw 0 | step 88 |
| PASS | R ankle screw 1 | step 88 |
| PASS | R ankle screw 2 | step 88 |
| PASS | R ankle screw 3 | step 88 |
| PASS | R ankle screw 4 | step 88 |
| PASS | R ankle screw 5 | step 88 |
| PASS | R ankle screw 6 | step 88 |
| PASS | R ankle screw 7 | step 88 |
| PASS | R ankle screw 8 | step 88 |
| PASS | R ankle ear in foot screw 0 | step 90.2 |
| PASS | R ankle ear in foot screw 1 | step 90.2 |
| PASS | R ankle ear in foot screw 2 | step 90.2 |
| PASS | R ankle ear out foot screw 0 | step 90.3 |
| PASS | R ankle ear out foot screw 1 | step 90.3 |
| PASS | R ankle ear out foot screw 2 | step 90.3 |
| PASS | R shoe rear screw 0 | step 90.4 |
| PASS | R shoe rear screw 1 | step 90.4 |
| PASS | R shoe front screw 0 | step 90.5 |
| PASS | R shoe front screw 1 | step 90.5 |
| PASS | R ankle ear screw 0 | step 90 |
| PASS | R ankle ear screw 1 | step 90 |
| PASS | R ankle ear screw 2 | step 90 |
| PASS | R ankle ear screw 3 | step 90 |
| PASS | R ankle ear screw 4 | step 90 |
| PASS | R ankle ear screw 5 | step 90 |
| PASS | R ankle housing screw 0 | step 90 |
| PASS | R ankle housing screw 1 | step 90 |
| PASS | R ankle housing screw 2 | step 90 |
| PASS | R thigh cover screw hip 0 | step 94 |
| PASS | R thigh cover screw rear 0 | step 95 |
| PASS | R thigh cover screw knee 0 | step 96 |
| PASS | neck L screw 0 | step 99 |
| PASS | neck L screw 1 | step 99 |
| PASS | neck L screw 2 | step 99 |
| PASS | neck L screw 3 | step 99 |
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
| PASS | head roll front ring screw 7 | step 124 |
| PASS | head roll front post 0 screw top 0 | step 124 |
| PASS | head roll front post 1 screw top 0 | step 124 |
| PASS | head roll front post 2 screw top 0 | step 124 |
| PASS | head roll front post 3 screw top 0 | step 124 |
| PASS | head roll screw 0 | step 125 |
| PASS | head roll screw 1 | step 125 |
| PASS | head roll screw 2 | step 125 |
| PASS | head roll screw 3 | step 125 |
| PASS | head roll screw 4 | step 125 |
| PASS | head roll screw 5 | step 125 |
| PASS | head rail L screw main 0 | step 126.2 |
| PASS | head rail L screw main 1 | step 126.2 |
| PASS | head rail R screw main 0 | step 126.3 |
| PASS | head rail R screw main 1 | step 126.3 |
| PASS | head rail L screw rear 0 | step 126.4 |
| PASS | head rail L screw rear 1 | step 126.4 |
| PASS | head rail R screw rear 0 | step 126.4 |
| PASS | head rail R screw rear 1 | step 126.4 |
| PASS | head rail L screw front 0 | step 126.5 |
| PASS | head rail L screw front 1 | step 126.5 |
| PASS | head rail R screw front 0 | step 126.5 |
| PASS | head rail R screw front 1 | step 126.5 |
| PASS | head beak lug L screw 0 | step 126.6 |
| PASS | head beak lug L screw 1 | step 126.6 |
| PASS | head beak lug R screw 0 | step 126.7 |
| PASS | head beak lug R screw 1 | step 126.7 |
| PASS | head beak mount screw L 0 | step 126.8 |
| PASS | head beak mount screw L 1 | step 126.8 |
| PASS | head beak mount screw R 0 | step 126.8 |
| PASS | head beak mount screw R 1 | step 126.8 |
| PASS | head main frame screw 0 | step 126 |
| PASS | head main frame screw 1 | step 126 |
| PASS | head main frame screw 2 | step 126 |
| PASS | head main frame screw 3 | step 126 |
| PASS | head main frame screw 4 | step 126 |
| PASS | head main frame screw 5 | step 126 |
| PASS | beak hinge L screw 0 | step 127.2 |
| PASS | beak hinge L screw 1 | step 127.2 |
| PASS | beak hinge R screw 0 | step 127.3 |
| PASS | beak hinge R screw 1 | step 127.3 |

## ALL

| status | item | detail |
|---|---|---|
| PASS | printed panels | 54 panels and covers aren't in the order: their fixings aren't designed |
