meetsitaram/duck-droids/reports/feetech/printable.md

# Physical checks

From tools/printable.py. Overhang from faces, not a slicer: none of this has been printed.

377 checks: 359 pass, 18 warn, **0 fail**

## ORIENT

| status | item | detail |
|---|---|---|
| PASS | L hip yaw lid | 113 mm2 overhang, 88 mm2 on the bed, 51 mm tall |
| PASS | L yaw bracket | 579 mm2 overhang, 1141 mm2 on the bed, 41 mm tall |
| PASS | L hip roll lid | 113 mm2 overhang, 75 mm2 on the bed, 51 mm tall |
| PASS | L roll bracket | 174 mm2 overhang, 572 mm2 on the bed, 37 mm tall |
| PASS | L thigh frame | 1375 mm2 overhang, 478 mm2 on the bed, 61 mm tall |
| PASS | L hip pitch lid | 167 mm2 overhang, 858 mm2 on the bed, 6 mm tall |
| PASS | L knee lid | 167 mm2 overhang, 833 mm2 on the bed, 6 mm tall |
| PASS | L thigh cover | 44 mm2 overhang, 4273 mm2 on the bed, 46 mm tall |
| PASS | L shin | 832 mm2 overhang, 347 mm2 on the bed, 31 mm tall |
| PASS | L shoe | 708 mm2 overhang, 84 mm2 on the bed, 69 mm tall |
| PASS | L sole | 478 mm2 overhang, 238 mm2 on the bed, 69 mm tall |
| PASS | L inner ear | 0 mm2 overhang, 779 mm2 on the bed, 4 mm tall |
| PASS | R hip yaw lid | 108 mm2 overhang, 88 mm2 on the bed, 51 mm tall |
| PASS | R yaw bracket | 579 mm2 overhang, 1141 mm2 on the bed, 41 mm tall |
| PASS | R hip roll lid | 113 mm2 overhang, 75 mm2 on the bed, 51 mm tall |
| PASS | R roll bracket | 174 mm2 overhang, 572 mm2 on the bed, 37 mm tall |
| PASS | R thigh frame | 1375 mm2 overhang, 478 mm2 on the bed, 61 mm tall |
| PASS | R hip pitch lid | 167 mm2 overhang, 858 mm2 on the bed, 6 mm tall |
| PASS | R knee lid | 167 mm2 overhang, 833 mm2 on the bed, 6 mm tall |
| PASS | R thigh cover | 44 mm2 overhang, 4273 mm2 on the bed, 46 mm tall |
| PASS | R shin | 832 mm2 overhang, 347 mm2 on the bed, 31 mm tall |
| PASS | R shoe | 708 mm2 overhang, 84 mm2 on the bed, 69 mm tall |
| PASS | R sole | 477 mm2 overhang, 238 mm2 on the bed, 69 mm tall |
| PASS | R inner ear | 0 mm2 overhang, 779 mm2 on the bed, 4 mm tall |
| PASS | chassis | 3314 mm2 overhang, 909 mm2 on the bed, 65 mm tall |
| PASS | body shell | 1203 mm2 overhang, 1803 mm2 on the bed, 94 mm tall |
| PASS | neck column | 422 mm2 overhang, 301 mm2 on the bed, 49 mm tall |
| PASS | neck lid | 0 mm2 overhang, 249 mm2 on the bed, 3 mm tall |
| PASS | head pitch lid | 0 mm2 overhang, 249 mm2 on the bed, 3 mm tall |
| PASS | head fork | 838 mm2 overhang, 676 mm2 on the bed, 48 mm tall |
| PASS | head yaw sheet | 167 mm2 overhang, 858 mm2 on the bed, 4 mm tall |
| PASS | head yaw bracket | 469 mm2 overhang, 749 mm2 on the bed, 48 mm tall |
| PASS | head roll lid | 167 mm2 overhang, 858 mm2 on the bed, 6 mm tall |
| PASS | head roll spacer | 0 mm2 overhang, 239 mm2 on the bed, 3 mm tall |
| PASS | head frame | 7206 mm2 overhang, 450 mm2 on the bed, 181 mm tall |
| PASS | hood | 5100 mm2 overhang, 69 mm2 on the bed, 192 mm tall |
| PASS | jaw | 1221 mm2 overhang, 1385 mm2 on the bed, 108 mm tall |
| PASS | jaw soft insert | 0 mm2 overhang, 4548 mm2 on the bed, 5 mm tall |
| PASS | mouth roof | 4 mm2 overhang, 6218 mm2 on the bed, 3 mm tall |
| PASS | face | 89 mm2 overhang, 7085 mm2 on the bed, 3 mm tall |
| PASS | eye ring | 0 mm2 overhang, 1010 mm2 on the bed, 14 mm tall |
| PASS | eye iris | 0 mm2 overhang, 400 mm2 on the bed, 6 mm tall |

## PIECES

| status | item | detail |
|---|---|---|
| PASS | L hip yaw lid |  |
| PASS | L yaw bracket |  |
| PASS | L hip roll lid |  |
| PASS | L roll bracket |  |
| PASS | L thigh frame |  |
| PASS | L hip pitch lid |  |
| PASS | L knee lid |  |
| PASS | L thigh cover |  |
| PASS | L shin |  |
| PASS | L shoe |  |
| PASS | L sole |  |
| PASS | L inner ear |  |
| PASS | R hip yaw lid |  |
| PASS | R yaw bracket |  |
| PASS | R hip roll lid |  |
| PASS | R roll bracket |  |
| PASS | R thigh frame |  |
| PASS | R hip pitch lid |  |
| PASS | R knee lid |  |
| PASS | R thigh cover |  |
| PASS | R shin |  |
| PASS | R shoe |  |
| PASS | R sole |  |
| PASS | R inner ear |  |
| PASS | chassis |  |
| PASS | body shell |  |
| PASS | neck column |  |
| PASS | neck lid |  |
| PASS | head pitch lid |  |
| PASS | head fork |  |
| PASS | head yaw sheet |  |
| PASS | head yaw bracket |  |
| PASS | head roll lid |  |
| PASS | head roll spacer |  |
| PASS | head frame |  |
| PASS | hood |  |
| PASS | jaw |  |
| PASS | jaw soft insert |  |
| PASS | mouth roof |  |
| PASS | face |  |
| PASS | eye ring |  |
| PASS | eye iris |  |

## BED

| status | item | detail |
|---|---|---|
| PASS | L hip yaw lid | 6 x 31 x 51 mm, 88 mm2 on the bed |
| PASS | L yaw bracket | 62 x 30 x 41 mm, 1141 mm2 on the bed |
| PASS | L hip roll lid | 6 x 29 x 51 mm, 75 mm2 on the bed |
| PASS | L roll bracket | 23 x 36 x 37 mm, 572 mm2 on the bed |
| PASS | L thigh frame | 81 x 46 x 61 mm, 478 mm2 on the bed |
| PASS | L hip pitch lid | 31 x 51 x 6 mm, 858 mm2 on the bed |
| PASS | L knee lid | 51 x 31 x 6 mm, 833 mm2 on the bed |
| PASS | L thigh cover | 67 x 87 x 46 mm, 4273 mm2 on the bed |
| PASS | L shin | 79 x 42 x 31 mm, 347 mm2 on the bed |
| PASS | L shoe | 29 x 53 x 69 mm, 84 mm2 on the bed |
| PASS | L sole | 15 x 53 x 69 mm, 238 mm2 on the bed |
| PASS | L inner ear | 29 x 48 x 4 mm, 779 mm2 on the bed |
| PASS | R hip yaw lid | 6 x 31 x 51 mm, 88 mm2 on the bed |
| PASS | R yaw bracket | 62 x 30 x 41 mm, 1141 mm2 on the bed |
| PASS | R hip roll lid | 6 x 29 x 51 mm, 75 mm2 on the bed |
| PASS | R roll bracket | 23 x 36 x 37 mm, 572 mm2 on the bed |
| PASS | R thigh frame | 81 x 46 x 61 mm, 478 mm2 on the bed |
| PASS | R hip pitch lid | 31 x 51 x 6 mm, 858 mm2 on the bed |
| PASS | R knee lid | 51 x 31 x 6 mm, 833 mm2 on the bed |
| PASS | R thigh cover | 67 x 87 x 46 mm, 4273 mm2 on the bed |
| PASS | R shin | 79 x 42 x 31 mm, 347 mm2 on the bed |
| PASS | R shoe | 29 x 53 x 69 mm, 84 mm2 on the bed |
| PASS | R sole | 15 x 53 x 69 mm, 238 mm2 on the bed |
| PASS | R inner ear | 29 x 48 x 4 mm, 779 mm2 on the bed |
| PASS | chassis | 52 x 101 x 65 mm, 909 mm2 on the bed |
| PASS | body shell | 49 x 80 x 94 mm, 1803 mm2 on the bed |
| PASS | neck column | 46 x 31 x 49 mm, 301 mm2 on the bed |
| PASS | neck lid | 9 x 31 x 3 mm, 249 mm2 on the bed |
| PASS | head pitch lid | 9 x 31 x 3 mm, 249 mm2 on the bed |
| PASS | head fork | 73 x 54 x 48 mm, 676 mm2 on the bed |
| PASS | head yaw sheet | 51 x 31 x 4 mm, 858 mm2 on the bed |
| PASS | head yaw bracket | 38 x 41 x 48 mm, 749 mm2 on the bed |
| PASS | head roll lid | 31 x 51 x 6 mm, 858 mm2 on the bed |
| PASS | head roll spacer | 20 x 20 x 3 mm, 239 mm2 on the bed |
| PASS | head frame | 65 x 131 x 181 mm, 450 mm2 on the bed |
| PASS | hood | 73 x 135 x 192 mm, 69 mm2 on the bed |
| PASS | jaw | 48 x 135 x 108 mm, 1385 mm2 on the bed |
| PASS | jaw soft insert | 35 x 131 x 5 mm, 4548 mm2 on the bed |
| PASS | mouth roof | 49 x 131 x 3 mm, 6218 mm2 on the bed |
| PASS | face | 65 x 129 x 3 mm, 7085 mm2 on the bed |
| PASS | eye ring | 44 x 44 x 14 mm, 1010 mm2 on the bed |
| PASS | eye iris | 25 x 25 x 6 mm, 400 mm2 on the bed |

## HOLES

| status | item | detail |
|---|---|---|
| PASS | L hip yaw lid |  |
| PASS | L yaw bracket |  |
| PASS | L hip roll lid |  |
| PASS | L roll bracket |  |
| PASS | L thigh frame |  |
| PASS | L hip pitch lid |  |
| PASS | L knee lid |  |
| PASS | L thigh cover |  |
| PASS | L shin |  |
| PASS | L shoe |  |
| PASS | L sole |  |
| PASS | L inner ear |  |
| PASS | R hip yaw lid |  |
| PASS | R yaw bracket |  |
| PASS | R hip roll lid |  |
| PASS | R roll bracket |  |
| PASS | R thigh frame |  |
| PASS | R hip pitch lid |  |
| PASS | R knee lid |  |
| PASS | R thigh cover |  |
| PASS | R shin |  |
| PASS | R shoe |  |
| PASS | R sole |  |
| PASS | R inner ear |  |
| PASS | chassis |  |
| PASS | body shell |  |
| PASS | neck column |  |
| PASS | neck lid |  |
| PASS | head pitch lid |  |
| PASS | head fork |  |
| PASS | head yaw sheet |  |
| PASS | head yaw bracket |  |
| PASS | head roll lid |  |
| PASS | head roll spacer |  |
| PASS | head frame |  |
| PASS | hood |  |
| PASS | jaw |  |
| PASS | jaw soft insert |  |
| PASS | mouth roof |  |
| PASS | face |  |
| PASS | eye ring |  |
| PASS | eye iris |  |

## SUPPORT

| status | item | detail |
|---|---|---|
| WARN | L yaw bracket | 579 mm2 needs support or a bridge: check it in the slicer |
| WARN | L thigh frame | 1375 mm2 needs support or a bridge: check it in the slicer |
| WARN | L shin | 832 mm2 needs support or a bridge: check it in the slicer |
| WARN | L shoe | 708 mm2 needs support or a bridge: check it in the slicer |
| WARN | L sole | 478 mm2 needs support or a bridge: check it in the slicer |
| WARN | R yaw bracket | 579 mm2 needs support or a bridge: check it in the slicer |
| WARN | R thigh frame | 1375 mm2 needs support or a bridge: check it in the slicer |
| WARN | R shin | 832 mm2 needs support or a bridge: check it in the slicer |
| WARN | R shoe | 708 mm2 needs support or a bridge: check it in the slicer |
| WARN | R sole | 477 mm2 needs support or a bridge: check it in the slicer |
| WARN | chassis | 3314 mm2 needs support or a bridge: check it in the slicer |
| WARN | body shell | 1203 mm2 needs support or a bridge: check it in the slicer |
| WARN | neck column | 422 mm2 needs support or a bridge: check it in the slicer |
| WARN | head fork | 838 mm2 needs support or a bridge: check it in the slicer |
| WARN | head yaw bracket | 469 mm2 needs support or a bridge: check it in the slicer |
| WARN | head frame | 7206 mm2 needs support or a bridge: check it in the slicer |
| WARN | hood | 5100 mm2 needs support or a bridge: check it in the slicer |
| WARN | jaw | 1221 mm2 needs support or a bridge: check it in the slicer |

## SKIN

| status | item | detail |
|---|---|---|
| PASS | L thigh cover | 2 screws drill it: ['L thigh cover screw hip', 'L thigh cover screw knee'] |
| PASS | R thigh cover | 2 screws drill it: ['R thigh cover screw hip', 'R thigh cover screw knee'] |
| PASS | body shell | 2 screws drill it: ['body screw 0', 'body screw 1'] |
| PASS | hood | 3 screws drill it: ['R hinge screw', 'hood rear screw 0', 'hood rear screw 1'] |
| PASS | mouth roof | 0 screws drill it: [] |

## MATE

| status | item | detail |
|---|---|---|
| PASS | parts that share a link | 42 parts: 0 clashes |

## HEADS

| status | item | detail |
|---|---|---|
| PASS | body screw 0 |  |
| PASS | body screw 1 |  |
| PASS | L hip yaw cradle screw near 0 |  |
| PASS | L hip yaw cradle screw near 1 |  |
| PASS | L hip yaw cradle screw horn face 0 |  |
| PASS | L hip yaw cradle screw horn face 1 |  |
| PASS | L hip yaw cradle screw rear face 0 |  |
| PASS | L hip yaw cradle screw rear face 1 |  |
| PASS | R hip yaw cradle screw near 0 |  |
| PASS | R hip yaw cradle screw near 1 |  |
| PASS | R hip yaw cradle screw horn face 0 |  |
| PASS | R hip yaw cradle screw horn face 1 |  |
| PASS | R hip yaw cradle screw rear face 0 |  |
| PASS | R hip yaw cradle screw rear face 1 |  |
| PASS | neck pitch fork screw horn 0 |  |
| PASS | neck pitch fork screw horn 1 |  |
| PASS | neck pitch fork screw horn 2 |  |
| PASS | neck pitch fork screw horn 3 |  |
| PASS | neck pitch fork screw rear 0 |  |
| PASS | neck pitch fork screw rear 1 |  |
| PASS | neck pitch fork screw rear 2 |  |
| PASS | neck pitch fork screw rear 3 |  |
| PASS | L hip yaw fork screw horn 0 |  |
| PASS | L hip yaw fork screw horn 1 |  |
| PASS | L hip yaw fork screw horn 2 |  |
| PASS | L hip yaw fork screw horn 3 |  |
| PASS | L hip roll cradle screw near 0 |  |
| PASS | L hip roll cradle screw near 1 |  |
| PASS | L hip roll cradle screw horn face 0 |  |
| PASS | L hip roll cradle screw horn face 1 |  |
| PASS | L hip roll cradle screw rear face 0 |  |
| PASS | L hip roll cradle screw rear face 1 |  |
| PASS | R hip yaw fork screw horn 0 |  |
| PASS | R hip yaw fork screw horn 1 |  |
| PASS | R hip yaw fork screw horn 2 |  |
| PASS | R hip yaw fork screw horn 3 |  |
| PASS | R hip roll cradle screw near 0 |  |
| PASS | R hip roll cradle screw near 1 |  |
| PASS | R hip roll cradle screw horn face 0 |  |
| PASS | R hip roll cradle screw horn face 1 |  |
| PASS | R hip roll cradle screw rear face 0 |  |
| PASS | R hip roll cradle screw rear face 1 |  |
| PASS | L hip roll fork screw horn 0 |  |
| PASS | L hip roll fork screw horn 1 |  |
| PASS | L hip roll fork screw horn 2 |  |
| PASS | L hip roll fork screw horn 3 |  |
| PASS | L hip pitch fork screw horn 0 |  |
| PASS | L hip pitch fork screw horn 1 |  |
| PASS | L hip pitch fork screw horn 2 |  |
| PASS | L hip pitch fork screw horn 3 |  |
| PASS | R hip roll fork screw horn 0 |  |
| PASS | R hip roll fork screw horn 1 |  |
| PASS | R hip roll fork screw horn 2 |  |
| PASS | R hip roll fork screw horn 3 |  |
| PASS | R hip pitch fork screw horn 0 |  |
| PASS | R hip pitch fork screw horn 1 |  |
| PASS | R hip pitch fork screw horn 2 |  |
| PASS | R hip pitch fork screw horn 3 |  |
| PASS | L thigh cover screw hip |  |
| PASS | L thigh cover screw knee |  |
| PASS | L hip pitch cradle screw near 0 |  |
| PASS | L hip pitch cradle screw near 1 |  |
| PASS | L hip pitch cradle screw horn face 0 |  |
| PASS | L hip pitch cradle screw horn face 1 |  |
| PASS | L hip pitch cradle screw rear face 0 |  |
| PASS | L hip pitch cradle screw rear face 1 |  |
| PASS | L knee cradle screw near 0 |  |
| PASS | L knee cradle screw near 1 |  |
| PASS | L knee cradle screw horn face 0 |  |
| PASS | L knee cradle screw horn face 1 |  |
| PASS | L knee cradle screw rear face 0 |  |
| PASS | L knee cradle screw rear face 1 |  |
| PASS | R thigh cover screw hip |  |
| PASS | R thigh cover screw knee |  |
| PASS | R hip pitch cradle screw near 0 |  |
| PASS | R hip pitch cradle screw near 1 |  |
| PASS | R hip pitch cradle screw horn face 0 |  |
| PASS | R hip pitch cradle screw horn face 1 |  |
| PASS | R hip pitch cradle screw rear face 0 |  |
| PASS | R hip pitch cradle screw rear face 1 |  |
| PASS | R knee cradle screw near 0 |  |
| PASS | R knee cradle screw near 1 |  |
| PASS | R knee cradle screw horn face 0 |  |
| PASS | R knee cradle screw horn face 1 |  |
| PASS | R knee cradle screw rear face 0 |  |
| PASS | R knee cradle screw rear face 1 |  |
| PASS | L ankle boss screw 0 |  |
| PASS | L ankle boss screw 1 |  |
| PASS | L ankle boss screw 2 |  |
| PASS | L ankle boss screw 3 |  |
| PASS | L knee fork screw horn 0 |  |
| PASS | L knee fork screw horn 1 |  |
| PASS | L knee fork screw horn 2 |  |
| PASS | L knee fork screw horn 3 |  |
| PASS | L ankle pitch cradle screw rear face 0 |  |
| PASS | L ankle pitch cradle screw rear face 1 |  |
| PASS | R ankle boss screw 0 |  |
| PASS | R ankle boss screw 1 |  |
| PASS | R ankle boss screw 2 |  |
| PASS | R ankle boss screw 3 |  |
| PASS | R knee fork screw horn 0 |  |
| PASS | R knee fork screw horn 1 |  |
| PASS | R knee fork screw horn 2 |  |
| PASS | R knee fork screw horn 3 |  |
| PASS | R ankle pitch cradle screw rear face 0 |  |
| PASS | R ankle pitch cradle screw rear face 1 |  |
| PASS | L ankle ear screw 0 |  |
| PASS | L ankle ear screw 1 |  |
| PASS | L shoe bottom screw 0 |  |
| PASS | L shoe bottom screw 1 |  |
| PASS | L ankle pitch fork screw horn 0 |  |
| PASS | L ankle pitch fork screw horn 1 |  |
| PASS | L ankle pitch fork screw horn 2 |  |
| PASS | L ankle pitch fork screw horn 3 |  |
| PASS | R ankle ear screw 0 |  |
| PASS | R ankle ear screw 1 |  |
| PASS | R shoe bottom screw 0 |  |
| PASS | R shoe bottom screw 1 |  |
| PASS | R ankle pitch fork screw horn 0 |  |
| PASS | R ankle pitch fork screw horn 1 |  |
| PASS | R ankle pitch fork screw horn 2 |  |
| PASS | R ankle pitch fork screw horn 3 |  |
| PASS | neck pitch cradle screw horn face 0 |  |
| PASS | neck pitch cradle screw horn face 1 |  |
| PASS | neck pitch cradle screw rear face 0 |  |
| PASS | neck pitch cradle screw rear face 1 |  |
| PASS | head pitch cradle screw horn face 0 |  |
| PASS | head pitch cradle screw horn face 1 |  |
| PASS | head pitch cradle screw rear face 0 |  |
| PASS | head pitch cradle screw rear face 1 |  |
| PASS | head pitch fork screw horn 0 |  |
| PASS | head pitch fork screw horn 1 |  |
| PASS | head pitch fork screw horn 2 |  |
| PASS | head pitch fork screw horn 3 |  |
| PASS | head pitch fork screw rear 0 |  |
| PASS | head pitch fork screw rear 1 |  |
| PASS | head pitch fork screw rear 2 |  |
| PASS | head pitch fork screw rear 3 |  |
| PASS | head yaw cradle screw near 0 |  |
| PASS | head yaw cradle screw near 1 |  |
| PASS | head yaw cradle screw horn face 0 |  |
| PASS | head yaw cradle screw horn face 1 |  |
| PASS | head yaw cradle screw rear face 0 |  |
| PASS | head yaw cradle screw rear face 1 |  |
| PASS | head yaw fork screw horn 0 |  |
| PASS | head yaw fork screw horn 1 |  |
| PASS | head yaw fork screw horn 2 |  |
| PASS | head yaw fork screw horn 3 |  |
| PASS | head roll cradle screw near 0 |  |
| PASS | head roll cradle screw near 1 |  |
| PASS | head roll cradle screw horn face 0 |  |
| PASS | head roll cradle screw horn face 1 |  |
| PASS | head roll cradle screw rear face 0 |  |
| PASS | head roll cradle screw rear face 1 |  |
| PASS | R hinge screw |  |
| PASS | Pi screw 0 |  |
| PASS | Pi screw 1 |  |
| PASS | Pi screw 2 |  |
| PASS | Pi screw 3 |  |
| PASS | bus board top screw 0 |  |
| PASS | bus board rear screw 0 |  |
| PASS | bus board top screw 1 |  |
| PASS | bus board rear screw 1 |  |
| PASS | bus board top screw 2 |  |
| PASS | bus board rear screw 2 |  |
| PASS | bus board top screw 3 |  |
| PASS | bus board rear screw 3 |  |
| PASS | hood rear screw 0 |  |
| PASS | hood rear screw 1 |  |
| PASS | head roll fork screw horn 0 |  |
| PASS | head roll fork screw horn 1 |  |
| PASS | head roll fork screw horn 2 |  |
| PASS | head roll fork screw horn 3 |  |
| PASS | head roll fork screw rear 0 |  |
| PASS | head roll fork screw rear 1 |  |
| PASS | head roll fork screw rear 2 |  |
| PASS | head roll fork screw rear 3 |  |
| PASS | beak cradle screw rear face 0 |  |
| PASS | beak cradle screw rear face 1 |  |
| PASS | beak cradle screw rear near 0 |  |
| PASS | beak cradle screw rear near 1 |  |
| PASS | beak fork screw horn 0 |  |
| PASS | beak fork screw horn 1 |  |
| PASS | beak fork screw horn 2 |  |
| PASS | beak fork screw horn 3 |  |
