meetsitaram/duck-droids/reports/hd1910/buildable.md

# Physical checks

From tools/buildable.py. LOAD is a beam estimate, not FEA: test prints decide.

84 checks: 84 pass, 0 warn, **0 fail**

## LOAD

| status | item | detail |
|---|---|---|
| PASS | shin, under the knee horn | 8.9 MPa (allowed 15): 29 N, section 126 mm2 |
| PASS | shin, at the cap | 4.4 MPa (allowed 15): 29 N, section 185 mm2 |
| PASS | thigh, hip to knee | 0.5 MPa (allowed 15): 29 N, section 484 mm2 |
| PASS | roll bracket, side arm | 8.7 MPa (allowed 15): 29 N, section 76 mm2 |
| PASS | roll bracket, front plate | 7.0 MPa (allowed 15): 29 N, section 50 mm2 |
| PASS | yaw bracket | 1.3 MPa (allowed 15): 29 N, section 553 mm2 |

## ONE

| status | item | detail |
|---|---|---|
| PASS | L hip yaw lid |  |
| PASS | L yaw bracket |  |
| PASS | L hip roll lid |  |
| PASS | L roll bracket |  |
| PASS | L thigh frame |  |
| PASS | L hip pitch lid |  |
| PASS | L knee lid |  |
| PASS | L shin |  |
| PASS | L shoe |  |
| PASS | L sole |  |
| PASS | L inner ear |  |
| PASS | chassis |  |
| PASS | neck column |  |
| PASS | neck lid |  |
| PASS | head pitch lid |  |
| PASS | head fork |  |
| PASS | head yaw bracket |  |
| PASS | head roll lid |  |
| PASS | head roll spacer |  |
| PASS | head roll rear spacer |  |
| PASS | head frame |  |
| PASS | jaw |  |
| PASS | jaw soft insert |  |
| PASS | face |  |
| PASS | eye ring |  |
| PASS | eye iris |  |

## WALL

| status | item | detail |
|---|---|---|
| PASS | L hip yaw lid |  |
| PASS | L yaw bracket |  |
| PASS | L hip roll lid |  |
| PASS | L roll bracket |  |
| PASS | L thigh frame |  |
| PASS | L hip pitch lid |  |
| PASS | L knee lid |  |
| PASS | L shin |  |
| PASS | L shoe |  |
| PASS | L sole |  |
| PASS | L inner ear |  |
| PASS | chassis |  |
| PASS | neck column |  |
| PASS | neck lid |  |
| PASS | head pitch lid |  |
| PASS | head fork |  |
| PASS | head yaw bracket |  |
| PASS | head roll lid |  |
| PASS | head roll spacer |  |
| PASS | head roll rear spacer |  |
| PASS | head frame |  |
| PASS | jaw |  |
| PASS | jaw soft insert |  |
| PASS | face |  |
| PASS | eye ring |  |
| PASS | eye iris |  |

## FIT

| status | item | detail |
|---|---|---|
| PASS | L hip yaw lid | 38 x 27 x 4 mm |
| PASS | L yaw bracket | 30 x 27 x 49 mm |
| PASS | L hip roll lid | 4 x 26 x 38 mm |
| PASS | L roll bracket | 31 x 32 x 20 mm |
| PASS | L thigh frame | 67 x 35 x 52 mm |
| PASS | L hip pitch lid | 38 x 4 x 27 mm |
| PASS | L knee lid | 27 x 4 x 38 mm |
| PASS | L shin | 22 x 34 x 67 mm |
| PASS | L shoe | 59 x 45 x 32 mm |
| PASS | L sole | 59 x 45 x 14 mm |
| PASS | L inner ear | 44 x 5 x 32 mm |
| PASS | chassis | 85 x 54 x 40 mm |
| PASS | neck column | 27 x 29 x 28 mm |
| PASS | neck lid | 27 x 4 x 6 mm |
| PASS | head pitch lid | 27 x 4 x 6 mm |
| PASS | head fork | 38 x 40 x 56 mm |
| PASS | head yaw bracket | 30 x 41 x 30 mm |
| PASS | head roll lid | 4 x 38 x 27 mm |
| PASS | head roll spacer | 3 x 17 x 17 mm |
| PASS | head roll rear spacer | 3 x 17 x 17 mm |
| PASS | head frame | 143 x 103 x 61 mm |
| PASS | jaw | 89 x 107 x 44 mm |
| PASS | jaw soft insert | 28 x 103 x 6 mm |
| PASS | face | 5 x 100 x 52 mm |
| PASS | eye ring | 12 x 35 x 35 mm |
| PASS | eye iris | 10 x 21 x 21 mm |
