meetsitaram/duck-droids/reports/hd1910/printable.md

# Physical checks

From tools/printable.py. Overhang from faces, not a slicer: none of this has been printed.

375 checks: 361 pass, 14 warn, **0 fail**

## ORIENT

| status | item | detail |
|---|---|---|
| PASS | L hip yaw lid | 0 mm2 overhang, 577 mm2 on the bed, 3 mm tall |
| PASS | L yaw bracket | 197 mm2 overhang, 949 mm2 on the bed, 29 mm tall |
| PASS | L hip roll lid | 0 mm2 overhang, 499 mm2 on the bed, 3 mm tall |
| PASS | L roll bracket | 108 mm2 overhang, 420 mm2 on the bed, 30 mm tall |
| PASS | L thigh frame | 2100 mm2 overhang, 123 mm2 on the bed, 34 mm tall |
| PASS | L hip pitch lid | 0 mm2 overhang, 577 mm2 on the bed, 3 mm tall |
| PASS | L knee lid | 0 mm2 overhang, 557 mm2 on the bed, 3 mm tall |
| PASS | L thigh cover | 0 mm2 overhang, 2900 mm2 on the bed, 34 mm tall |
| PASS | L shin | 310 mm2 overhang, 178 mm2 on the bed, 21 mm tall |
| PASS | L shoe | 395 mm2 overhang, 45 mm2 on the bed, 58 mm tall |
| PASS | L sole | 347 mm2 overhang, 145 mm2 on the bed, 58 mm tall |
| PASS | L inner ear | 0 mm2 overhang, 694 mm2 on the bed, 4 mm tall |
| PASS | R hip yaw lid | 0 mm2 overhang, 577 mm2 on the bed, 3 mm tall |
| PASS | R yaw bracket | 197 mm2 overhang, 949 mm2 on the bed, 29 mm tall |
| PASS | R hip roll lid | 0 mm2 overhang, 499 mm2 on the bed, 3 mm tall |
| PASS | R roll bracket | 108 mm2 overhang, 420 mm2 on the bed, 30 mm tall |
| PASS | R thigh frame | 2100 mm2 overhang, 123 mm2 on the bed, 34 mm tall |
| PASS | R hip pitch lid | 0 mm2 overhang, 577 mm2 on the bed, 3 mm tall |
| PASS | R knee lid | 0 mm2 overhang, 557 mm2 on the bed, 3 mm tall |
| PASS | R thigh cover | 0 mm2 overhang, 2900 mm2 on the bed, 34 mm tall |
| PASS | R shin | 310 mm2 overhang, 178 mm2 on the bed, 21 mm tall |
| PASS | R shoe | 395 mm2 overhang, 45 mm2 on the bed, 58 mm tall |
| PASS | R sole | 347 mm2 overhang, 145 mm2 on the bed, 58 mm tall |
| PASS | R inner ear | 0 mm2 overhang, 694 mm2 on the bed, 4 mm tall |
| PASS | chassis | 2156 mm2 overhang, 241 mm2 on the bed, 84 mm tall |
| PASS | body shell | 1516 mm2 overhang, 1132 mm2 on the bed, 85 mm tall |
| PASS | neck column | 198 mm2 overhang, 89 mm2 on the bed, 27 mm tall |
| PASS | neck lid | 0 mm2 overhang, 73 mm2 on the bed, 3 mm tall |
| PASS | head pitch lid | 1 mm2 overhang, 73 mm2 on the bed, 2 mm tall |
| PASS | head fork | 425 mm2 overhang, 389 mm2 on the bed, 37 mm tall |
| PASS | head yaw sheet | 0 mm2 overhang, 580 mm2 on the bed, 4 mm tall |
| PASS | head yaw bracket | 218 mm2 overhang, 451 mm2 on the bed, 40 mm tall |
| PASS | head roll lid | 0 mm2 overhang, 560 mm2 on the bed, 3 mm tall |
| PASS | head roll spacer | 0 mm2 overhang, 147 mm2 on the bed, 2 mm tall |
| PASS | head roll rear spacer | 23 mm2 overhang, 156 mm2 on the bed, 2 mm tall |
| PASS | head frame | 5486 mm2 overhang, 300 mm2 on the bed, 141 mm tall |
| PASS | hood | 2911 mm2 overhang, 276 mm2 on the bed, 150 mm tall |
| PASS | jaw | 925 mm2 overhang, 3037 mm2 on the bed, 42 mm tall |
| PASS | jaw soft insert | 0 mm2 overhang, 2661 mm2 on the bed, 5 mm tall |
| PASS | mouth roof | 15 mm2 overhang, 3935 mm2 on the bed, 3 mm tall |
| PASS | face | 40 mm2 overhang, 4167 mm2 on the bed, 3 mm tall |
| PASS | eye ring | 0 mm2 overhang, 822 mm2 on the bed, 11 mm tall |
| PASS | eye iris | 0 mm2 overhang, 207 mm2 on the bed, 9 mm tall |

## PIECES

| status | item | detail |
|---|---|---|
| PASS | L hip yaw lid |  |
| PASS | L yaw bracket |  |
| PASS | L hip roll lid |  |
| PASS | L roll bracket |  |
| PASS | L thigh frame |  |
| PASS | L hip pitch lid |  |
| PASS | L knee lid |  |
| PASS | L thigh cover |  |
| PASS | L shin |  |
| PASS | L shoe |  |
| PASS | L sole |  |
| PASS | L inner ear |  |
| PASS | R hip yaw lid |  |
| PASS | R yaw bracket |  |
| PASS | R hip roll lid |  |
| PASS | R roll bracket |  |
| PASS | R thigh frame |  |
| PASS | R hip pitch lid |  |
| PASS | R knee lid |  |
| PASS | R thigh cover |  |
| PASS | R shin |  |
| PASS | R shoe |  |
| PASS | R sole |  |
| PASS | R inner ear |  |
| PASS | chassis |  |
| PASS | body shell |  |
| PASS | neck column |  |
| PASS | neck lid |  |
| PASS | head pitch lid |  |
| PASS | head fork |  |
| PASS | head yaw sheet |  |
| PASS | head yaw bracket |  |
| PASS | head roll lid |  |
| PASS | head roll spacer |  |
| PASS | head roll rear spacer |  |
| PASS | head frame |  |
| PASS | hood |  |
| PASS | jaw |  |
| PASS | jaw soft insert |  |
| PASS | mouth roof |  |
| PASS | face |  |
| PASS | eye ring |  |
| PASS | eye iris |  |

## BED

| status | item | detail |
|---|---|---|
| PASS | L hip yaw lid | 37 x 26 x 3 mm, 577 mm2 on the bed |
| PASS | L yaw bracket | 48 x 25 x 29 mm, 949 mm2 on the bed |
| PASS | L hip roll lid | 37 x 24 x 3 mm, 499 mm2 on the bed |
| PASS | L roll bracket | 19 x 31 x 30 mm, 420 mm2 on the bed |
| PASS | L thigh frame | 51 x 66 x 34 mm, 123 mm2 on the bed |
| PASS | L hip pitch lid | 26 x 37 x 3 mm, 577 mm2 on the bed |
| PASS | L knee lid | 37 x 26 x 3 mm, 557 mm2 on the bed |
| PASS | L thigh cover | 55 x 70 x 34 mm, 2900 mm2 on the bed |
| PASS | L shin | 66 x 32 x 21 mm, 178 mm2 on the bed |
| PASS | L shoe | 30 x 43 x 58 mm, 45 mm2 on the bed |
| PASS | L sole | 13 x 44 x 58 mm, 145 mm2 on the bed |
| PASS | L inner ear | 30 x 42 x 4 mm, 694 mm2 on the bed |
| PASS | R hip yaw lid | 37 x 26 x 3 mm, 577 mm2 on the bed |
| PASS | R yaw bracket | 48 x 25 x 29 mm, 949 mm2 on the bed |
| PASS | R hip roll lid | 37 x 24 x 3 mm, 499 mm2 on the bed |
| PASS | R roll bracket | 19 x 31 x 30 mm, 420 mm2 on the bed |
| PASS | R thigh frame | 51 x 66 x 34 mm, 123 mm2 on the bed |
| PASS | R hip pitch lid | 26 x 37 x 3 mm, 577 mm2 on the bed |
| PASS | R knee lid | 37 x 26 x 3 mm, 557 mm2 on the bed |
| PASS | R thigh cover | 55 x 70 x 34 mm, 2900 mm2 on the bed |
| PASS | R shin | 66 x 32 x 21 mm, 178 mm2 on the bed |
| PASS | R shoe | 30 x 43 x 58 mm, 45 mm2 on the bed |
| PASS | R sole | 13 x 44 x 58 mm, 145 mm2 on the bed |
| PASS | R inner ear | 30 x 42 x 4 mm, 694 mm2 on the bed |
| PASS | chassis | 38 x 53 x 84 mm, 241 mm2 on the bed |
| PASS | body shell | 38 x 74 x 85 mm, 1132 mm2 on the bed |
| PASS | neck column | 26 x 28 x 27 mm, 89 mm2 on the bed |
| PASS | neck lid | 5 x 26 x 3 mm, 73 mm2 on the bed |
| PASS | head pitch lid | 5 x 26 x 2 mm, 73 mm2 on the bed |
| PASS | head fork | 55 x 39 x 37 mm, 389 mm2 on the bed |
| PASS | head yaw sheet | 37 x 26 x 4 mm, 580 mm2 on the bed |
| PASS | head yaw bracket | 28 x 29 x 40 mm, 451 mm2 on the bed |
| PASS | head roll lid | 26 x 37 x 3 mm, 560 mm2 on the bed |
| PASS | head roll spacer | 16 x 16 x 2 mm, 147 mm2 on the bed |
| PASS | head roll rear spacer | 16 x 16 x 2 mm, 156 mm2 on the bed |
| PASS | head frame | 59 x 101 x 141 mm, 300 mm2 on the bed |
| PASS | hood | 58 x 106 x 150 mm, 276 mm2 on the bed |
| PASS | jaw | 88 x 106 x 42 mm, 3037 mm2 on the bed |
| PASS | jaw soft insert | 27 x 101 x 5 mm, 2661 mm2 on the bed |
| PASS | mouth roof | 40 x 101 x 3 mm, 3935 mm2 on the bed |
| PASS | face | 50 x 99 x 3 mm, 4167 mm2 on the bed |
| PASS | eye ring | 34 x 34 x 11 mm, 822 mm2 on the bed |
| PASS | eye iris | 20 x 20 x 9 mm, 207 mm2 on the bed |

## HOLES

| status | item | detail |
|---|---|---|
| PASS | L hip yaw lid |  |
| PASS | L yaw bracket |  |
| PASS | L hip roll lid |  |
| PASS | L roll bracket |  |
| PASS | L thigh frame |  |
| PASS | L hip pitch lid |  |
| PASS | L knee lid |  |
| PASS | L thigh cover |  |
| PASS | L shin |  |
| PASS | L shoe |  |
| PASS | L sole |  |
| PASS | L inner ear |  |
| PASS | R hip yaw lid |  |
| PASS | R yaw bracket |  |
| PASS | R hip roll lid |  |
| PASS | R roll bracket |  |
| PASS | R thigh frame |  |
| PASS | R hip pitch lid |  |
| PASS | R knee lid |  |
| PASS | R thigh cover |  |
| PASS | R shin |  |
| PASS | R shoe |  |
| PASS | R sole |  |
| PASS | R inner ear |  |
| PASS | chassis |  |
| PASS | body shell |  |
| PASS | neck column |  |
| PASS | neck lid |  |
| PASS | head pitch lid |  |
| PASS | head fork |  |
| PASS | head yaw sheet |  |
| PASS | head yaw bracket |  |
| PASS | head roll lid |  |
| PASS | head roll spacer |  |
| PASS | head roll rear spacer |  |
| PASS | head frame |  |
| PASS | hood |  |
| PASS | jaw |  |
| PASS | jaw soft insert |  |
| PASS | mouth roof |  |
| PASS | face |  |
| PASS | eye ring |  |
| PASS | eye iris |  |

## SUPPORT

| status | item | detail |
|---|---|---|
| WARN | L thigh frame | 2100 mm2 needs support or a bridge: check it in the slicer |
| WARN | L shin | 310 mm2 needs support or a bridge: check it in the slicer |
| WARN | L shoe | 395 mm2 needs support or a bridge: check it in the slicer |
| WARN | L sole | 347 mm2 needs support or a bridge: check it in the slicer |
| WARN | R thigh frame | 2100 mm2 needs support or a bridge: check it in the slicer |
| WARN | R shin | 310 mm2 needs support or a bridge: check it in the slicer |
| WARN | R shoe | 395 mm2 needs support or a bridge: check it in the slicer |
| WARN | R sole | 347 mm2 needs support or a bridge: check it in the slicer |
| WARN | chassis | 2156 mm2 needs support or a bridge: check it in the slicer |
| WARN | body shell | 1516 mm2 needs support or a bridge: check it in the slicer |
| WARN | head fork | 425 mm2 needs support or a bridge: check it in the slicer |
| WARN | head frame | 5486 mm2 needs support or a bridge: check it in the slicer |
| WARN | hood | 2911 mm2 needs support or a bridge: check it in the slicer |
| WARN | jaw | 925 mm2 needs support or a bridge: check it in the slicer |

## SKIN

| status | item | detail |
|---|---|---|
| PASS | L thigh cover | 2 screws drill it: ['L thigh cover screw hip', 'L thigh cover screw knee'] |
| PASS | R thigh cover | 2 screws drill it: ['R thigh cover screw hip', 'R thigh cover screw knee'] |
| PASS | body shell | 2 screws drill it: ['body screw 0', 'body screw 1'] |
| PASS | hood | 3 screws drill it: ['R hinge screw', 'hood rear screw 0', 'hood rear screw 1'] |
| PASS | mouth roof | 0 screws drill it: [] |

## MATE

| status | item | detail |
|---|---|---|
| PASS | parts that share a link | 43 parts: 0 clashes |

## HEADS

| status | item | detail |
|---|---|---|
| PASS | body screw 0 |  |
| PASS | body screw 1 |  |
| PASS | L hip yaw cradle screw horn face 0 |  |
| PASS | L hip yaw cradle screw horn face 1 |  |
| PASS | L hip yaw cradle screw rear face 0 |  |
| PASS | L hip yaw cradle screw rear face 1 |  |
| PASS | L hip yaw cradle screw rear near 0 |  |
| PASS | L hip yaw cradle screw rear near 1 |  |
| PASS | R hip yaw cradle screw horn face 0 |  |
| PASS | R hip yaw cradle screw horn face 1 |  |
| PASS | R hip yaw cradle screw rear face 0 |  |
| PASS | R hip yaw cradle screw rear face 1 |  |
| PASS | R hip yaw cradle screw rear near 0 |  |
| PASS | R hip yaw cradle screw rear near 1 |  |
| PASS | neck pitch fork screw horn 0 |  |
| PASS | neck pitch fork screw horn 1 |  |
| PASS | neck pitch fork screw horn 2 |  |
| PASS | neck pitch fork screw horn 3 |  |
| PASS | neck pitch fork screw rear 0 |  |
| PASS | neck pitch fork screw rear 1 |  |
| PASS | neck pitch fork screw rear 2 |  |
| PASS | neck pitch fork screw rear 3 |  |
| PASS | L hip yaw fork screw horn 0 |  |
| PASS | L hip yaw fork screw horn 1 |  |
| PASS | L hip yaw fork screw horn 2 |  |
| PASS | L hip yaw fork screw horn 3 |  |
| PASS | L hip roll cradle screw horn face 0 |  |
| PASS | L hip roll cradle screw horn face 1 |  |
| PASS | L hip roll cradle screw rear face 0 |  |
| PASS | L hip roll cradle screw rear face 1 |  |
| PASS | L hip roll cradle screw rear near 0 |  |
| PASS | L hip roll cradle screw rear near 1 |  |
| PASS | R hip yaw fork screw horn 0 |  |
| PASS | R hip yaw fork screw horn 1 |  |
| PASS | R hip yaw fork screw horn 2 |  |
| PASS | R hip yaw fork screw horn 3 |  |
| PASS | R hip roll cradle screw horn face 0 |  |
| PASS | R hip roll cradle screw horn face 1 |  |
| PASS | R hip roll cradle screw rear face 0 |  |
| PASS | R hip roll cradle screw rear face 1 |  |
| PASS | R hip roll cradle screw rear near 0 |  |
| PASS | R hip roll cradle screw rear near 1 |  |
| PASS | L hip roll fork screw horn 0 |  |
| PASS | L hip roll fork screw horn 1 |  |
| PASS | L hip roll fork screw horn 2 |  |
| PASS | L hip roll fork screw horn 3 |  |
| PASS | L hip pitch fork screw horn 0 |  |
| PASS | L hip pitch fork screw horn 1 |  |
| PASS | L hip pitch fork screw horn 2 |  |
| PASS | L hip pitch fork screw horn 3 |  |
| PASS | R hip roll fork screw horn 0 |  |
| PASS | R hip roll fork screw horn 1 |  |
| PASS | R hip roll fork screw horn 2 |  |
| PASS | R hip roll fork screw horn 3 |  |
| PASS | R hip pitch fork screw horn 0 |  |
| PASS | R hip pitch fork screw horn 1 |  |
| PASS | R hip pitch fork screw horn 2 |  |
| PASS | R hip pitch fork screw horn 3 |  |
| PASS | L thigh cover screw hip |  |
| PASS | L thigh cover screw knee |  |
| PASS | L hip pitch cradle screw horn face 0 |  |
| PASS | L hip pitch cradle screw horn face 1 |  |
| PASS | L hip pitch cradle screw rear face 0 |  |
| PASS | L hip pitch cradle screw rear face 1 |  |
| PASS | L hip pitch cradle screw rear near 0 |  |
| PASS | L hip pitch cradle screw rear near 1 |  |
| PASS | L knee cradle screw horn face 0 |  |
| PASS | L knee cradle screw horn face 1 |  |
| PASS | L knee cradle screw rear face 0 |  |
| PASS | L knee cradle screw rear face 1 |  |
| PASS | L knee cradle screw rear near 0 |  |
| PASS | L knee cradle screw rear near 1 |  |
| PASS | R thigh cover screw hip |  |
| PASS | R thigh cover screw knee |  |
| PASS | R hip pitch cradle screw horn face 0 |  |
| PASS | R hip pitch cradle screw horn face 1 |  |
| PASS | R hip pitch cradle screw rear face 0 |  |
| PASS | R hip pitch cradle screw rear face 1 |  |
| PASS | R hip pitch cradle screw rear near 0 |  |
| PASS | R hip pitch cradle screw rear near 1 |  |
| PASS | R knee cradle screw horn face 0 |  |
| PASS | R knee cradle screw horn face 1 |  |
| PASS | R knee cradle screw rear face 0 |  |
| PASS | R knee cradle screw rear face 1 |  |
| PASS | R knee cradle screw rear near 0 |  |
| PASS | R knee cradle screw rear near 1 |  |
| PASS | L ankle boss screw 0 |  |
| PASS | L ankle boss screw 1 |  |
| PASS | L ankle boss screw 2 |  |
| PASS | L ankle boss screw 3 |  |
| PASS | L knee fork screw horn 0 |  |
| PASS | L knee fork screw horn 1 |  |
| PASS | L knee fork screw horn 2 |  |
| PASS | L knee fork screw horn 3 |  |
| PASS | L ankle pitch cradle screw rear face 0 |  |
| PASS | L ankle pitch cradle screw rear face 1 |  |
| PASS | R ankle boss screw 0 |  |
| PASS | R ankle boss screw 1 |  |
| PASS | R ankle boss screw 2 |  |
| PASS | R ankle boss screw 3 |  |
| PASS | R knee fork screw horn 0 |  |
| PASS | R knee fork screw horn 1 |  |
| PASS | R knee fork screw horn 2 |  |
| PASS | R knee fork screw horn 3 |  |
| PASS | R ankle pitch cradle screw rear face 0 |  |
| PASS | R ankle pitch cradle screw rear face 1 |  |
| PASS | L ankle ear screw 0 |  |
| PASS | L ankle ear screw 1 |  |
| PASS | L shoe bottom screw 0 |  |
| PASS | L shoe bottom screw 1 |  |
| PASS | L ankle pitch fork screw horn 0 |  |
| PASS | L ankle pitch fork screw horn 1 |  |
| PASS | L ankle pitch fork screw horn 2 |  |
| PASS | L ankle pitch fork screw horn 3 |  |
| PASS | R ankle ear screw 0 |  |
| PASS | R ankle ear screw 1 |  |
| PASS | R shoe bottom screw 0 |  |
| PASS | R shoe bottom screw 1 |  |
| PASS | R ankle pitch fork screw horn 0 |  |
| PASS | R ankle pitch fork screw horn 1 |  |
| PASS | R ankle pitch fork screw horn 2 |  |
| PASS | R ankle pitch fork screw horn 3 |  |
| PASS | neck pitch cradle screw horn face 0 |  |
| PASS | neck pitch cradle screw horn face 1 |  |
| PASS | neck pitch cradle screw rear face 0 |  |
| PASS | neck pitch cradle screw rear face 1 |  |
| PASS | head pitch cradle screw horn face 0 |  |
| PASS | head pitch cradle screw horn face 1 |  |
| PASS | head pitch cradle screw rear face 0 |  |
| PASS | head pitch cradle screw rear face 1 |  |
| PASS | head pitch fork screw horn 0 |  |
| PASS | head pitch fork screw horn 1 |  |
| PASS | head pitch fork screw horn 2 |  |
| PASS | head pitch fork screw horn 3 |  |
| PASS | head pitch fork screw rear 0 |  |
| PASS | head pitch fork screw rear 1 |  |
| PASS | head pitch fork screw rear 2 |  |
| PASS | head pitch fork screw rear 3 |  |
| PASS | head yaw cradle screw horn face 0 |  |
| PASS | head yaw cradle screw horn face 1 |  |
| PASS | head yaw cradle screw rear face 0 |  |
| PASS | head yaw cradle screw rear face 1 |  |
| PASS | head yaw cradle screw rear near 0 |  |
| PASS | head yaw cradle screw rear near 1 |  |
| PASS | head yaw fork screw horn 0 |  |
| PASS | head yaw fork screw horn 1 |  |
| PASS | head yaw fork screw horn 2 |  |
| PASS | head yaw fork screw horn 3 |  |
| PASS | head roll cradle screw horn face 0 |  |
| PASS | head roll cradle screw horn face 1 |  |
| PASS | head roll cradle screw rear face 0 |  |
| PASS | head roll cradle screw rear face 1 |  |
| PASS | R hinge screw |  |
| PASS | Pi screw 0 |  |
| PASS | Pi screw 1 |  |
| PASS | Pi screw 2 |  |
| PASS | Pi screw 3 |  |
| PASS | bus board top screw 0 |  |
| PASS | bus board rear screw 0 |  |
| PASS | bus board top screw 1 |  |
| PASS | bus board rear screw 1 |  |
| PASS | bus board top screw 2 |  |
| PASS | bus board rear screw 2 |  |
| PASS | bus board top screw 3 |  |
| PASS | bus board rear screw 3 |  |
| PASS | hood rear screw 0 |  |
| PASS | hood rear screw 1 |  |
| PASS | head roll fork screw horn 0 |  |
| PASS | head roll fork screw horn 1 |  |
| PASS | head roll fork screw horn 2 |  |
| PASS | head roll fork screw horn 3 |  |
| PASS | head roll fork screw rear 0 |  |
| PASS | head roll fork screw rear 1 |  |
| PASS | head roll fork screw rear 2 |  |
| PASS | head roll fork screw rear 3 |  |
| PASS | beak cradle screw rear face 0 |  |
| PASS | beak cradle screw rear face 1 |  |
| PASS | beak cradle screw rear near 0 |  |
| PASS | beak cradle screw rear near 1 |  |
| PASS | beak fork screw horn 0 |  |
| PASS | beak fork screw horn 1 |  |
| PASS | beak fork screw horn 2 |  |
| PASS | beak fork screw horn 3 |  |
