meetsitaram/duck-droids/reports/hd1910/assembly.md

# Physical checks

From tools/assembly.py

1174 checks: 1174 pass, 0 warn, **0 fail**

## PATH

| status | item | detail |
|---|---|---|
| PASS | thigh_L: L hip pitch servo |  |
| PASS | thigh_L: L knee servo |  |
| PASS | thigh_L: L hip pitch lid |  |
| PASS | thigh_L: L knee lid |  |
| PASS | thigh_L: L hip pitch bearing |  |
| PASS | thigh_L: L knee bearing |  |
| PASS | thigh_L: L hip pitch horn |  |
| PASS | thigh_L: L knee horn |  |
| PASS | thigh_L: L thigh cover |  |
| PASS | shin_L: L ankle servo |  |
| PASS | shin_L: L ankle bearing inner |  |
| PASS | shin_L: L ankle horn |  |
| PASS | shoe_L: L sole |  |
| PASS | leg_L: @shin_L |  |
| PASS | leg_L: @shoe_L |  |
| PASS | leg_L: L inner ear |  |
| PASS | leg_L: L roll bracket |  |
| PASS | thigh_R: R hip pitch servo |  |
| PASS | thigh_R: R knee servo |  |
| PASS | thigh_R: R hip pitch lid |  |
| PASS | thigh_R: R knee lid |  |
| PASS | thigh_R: R hip pitch bearing |  |
| PASS | thigh_R: R knee bearing |  |
| PASS | thigh_R: R hip pitch horn |  |
| PASS | thigh_R: R knee horn |  |
| PASS | thigh_R: R thigh cover |  |
| PASS | shin_R: R ankle servo |  |
| PASS | shin_R: R ankle bearing inner |  |
| PASS | shin_R: R ankle horn |  |
| PASS | shoe_R: R sole |  |
| PASS | leg_R: @shin_R |  |
| PASS | leg_R: @shoe_R |  |
| PASS | leg_R: R inner ear |  |
| PASS | leg_R: R roll bracket |  |
| PASS | body: L hip yaw servo |  |
| PASS | body: R hip yaw servo |  |
| PASS | body: L hip yaw lid |  |
| PASS | body: R hip yaw lid |  |
| PASS | body: L hip yaw bearing |  |
| PASS | body: R hip yaw bearing |  |
| PASS | body: L hip yaw horn |  |
| PASS | body: R hip yaw horn |  |
| PASS | body: L yaw bracket |  |
| PASS | body: R yaw bracket |  |
| PASS | body: L hip roll servo |  |
| PASS | body: R hip roll servo |  |
| PASS | body: L hip roll lid |  |
| PASS | body: R hip roll lid |  |
| PASS | body: L hip roll bearing |  |
| PASS | body: R hip roll bearing |  |
| PASS | body: L hip roll horn |  |
| PASS | body: R hip roll horn |  |
| PASS | legs: @leg_L |  |
| PASS | legs: @leg_R |  |
| PASS | column: neck servo |  |
| PASS | column: neck lid |  |
| PASS | column: head pitch servo |  |
| PASS | column: head pitch lid |  |
| PASS | torso: battery |  |
| PASS | torso: IMU |  |
| PASS | torso: @column |  |
| PASS | torso: body shell |  |
| PASS | headbench: head yaw servo |  |
| PASS | headbench: head yaw sheet |  |
| PASS | headbench: head yaw bearing |  |
| PASS | headbench: head yaw horn |  |
| PASS | headbench: head yaw bracket |  |
| PASS | headbench: head roll servo |  |
| PASS | headbench: head roll rear bearing |  |
| PASS | headbench: head roll rear horn |  |
| PASS | headbench: head roll rear spacer |  |
| PASS | headbench: head roll lid |  |
| PASS | headbench: head roll bearing |  |
| PASS | headbench: head roll horn |  |
| PASS | headbench: head roll spacer |  |
| PASS | framebench: bus board standoffs |  |
| PASS | framebench: beak servo |  |
| PASS | jawbench: jaw soft insert |  |
| PASS | head: @headbench |  |
| PASS | head: @framebench |  |
| PASS | head: Waveshare bus board |  |
| PASS | head: Pi Zero 2 W |  |
| PASS | head: head 5 V regulator |  |
| PASS | head: @jawbench |  |
| PASS | head: hood |  |
| PASS | head: mouth roof |  |
| PASS | head: camera |  |
| PASS | head: face |  |
| PASS | head: eye ring |  |
| PASS | head: eye iris |  |

## HELD

| status | item | detail |
|---|---|---|
| PASS | L hip pitch cradle screw rear face 0 |  |
| PASS | L hip pitch cradle screw rear face 1 |  |
| PASS | L hip pitch cradle screw rear near 0 |  |
| PASS | L hip pitch cradle screw rear near 1 |  |
| PASS | L knee cradle screw rear face 0 |  |
| PASS | L knee cradle screw rear face 1 |  |
| PASS | L knee cradle screw rear near 0 |  |
| PASS | L knee cradle screw rear near 1 |  |
| PASS | L hip pitch cradle screw horn face 0 |  |
| PASS | L hip pitch cradle screw horn face 1 |  |
| PASS | L knee cradle screw horn face 0 |  |
| PASS | L knee cradle screw horn face 1 |  |
| PASS | L thigh cover screw hip |  |
| PASS | L thigh cover screw knee |  |
| PASS | L ankle boss screw 0 |  |
| PASS | L ankle boss screw 1 |  |
| PASS | L ankle boss screw 2 |  |
| PASS | L ankle boss screw 3 |  |
| PASS | L ankle pitch cradle screw rear face 0 |  |
| PASS | L ankle pitch cradle screw rear face 1 |  |
| PASS | L shoe bottom screw 0 |  |
| PASS | L shoe bottom screw 1 |  |
| PASS | L knee fork screw horn 0 |  |
| PASS | L knee fork screw horn 1 |  |
| PASS | L knee fork screw horn 2 |  |
| PASS | L knee fork screw horn 3 |  |
| PASS | L ankle pitch fork screw horn 0 |  |
| PASS | L ankle pitch fork screw horn 1 |  |
| PASS | L ankle pitch fork screw horn 2 |  |
| PASS | L ankle pitch fork screw horn 3 |  |
| PASS | L ankle ear screw 0 |  |
| PASS | L ankle ear screw 1 |  |
| PASS | L hip pitch fork screw horn 0 |  |
| PASS | L hip pitch fork screw horn 1 |  |
| PASS | L hip pitch fork screw horn 2 |  |
| PASS | L hip pitch fork screw horn 3 |  |
| PASS | R hip pitch cradle screw rear face 0 |  |
| PASS | R hip pitch cradle screw rear face 1 |  |
| PASS | R hip pitch cradle screw rear near 0 |  |
| PASS | R hip pitch cradle screw rear near 1 |  |
| PASS | R knee cradle screw rear face 0 |  |
| PASS | R knee cradle screw rear face 1 |  |
| PASS | R knee cradle screw rear near 0 |  |
| PASS | R knee cradle screw rear near 1 |  |
| PASS | R hip pitch cradle screw horn face 0 |  |
| PASS | R hip pitch cradle screw horn face 1 |  |
| PASS | R knee cradle screw horn face 0 |  |
| PASS | R knee cradle screw horn face 1 |  |
| PASS | R thigh cover screw hip |  |
| PASS | R thigh cover screw knee |  |
| PASS | R ankle boss screw 0 |  |
| PASS | R ankle boss screw 1 |  |
| PASS | R ankle boss screw 2 |  |
| PASS | R ankle boss screw 3 |  |
| PASS | R ankle pitch cradle screw rear face 0 |  |
| PASS | R ankle pitch cradle screw rear face 1 |  |
| PASS | R shoe bottom screw 0 |  |
| PASS | R shoe bottom screw 1 |  |
| PASS | R knee fork screw horn 0 |  |
| PASS | R knee fork screw horn 1 |  |
| PASS | R knee fork screw horn 2 |  |
| PASS | R knee fork screw horn 3 |  |
| PASS | R ankle pitch fork screw horn 0 |  |
| PASS | R ankle pitch fork screw horn 1 |  |
| PASS | R ankle pitch fork screw horn 2 |  |
| PASS | R ankle pitch fork screw horn 3 |  |
| PASS | R ankle ear screw 0 |  |
| PASS | R ankle ear screw 1 |  |
| PASS | R hip pitch fork screw horn 0 |  |
| PASS | R hip pitch fork screw horn 1 |  |
| PASS | R hip pitch fork screw horn 2 |  |
| PASS | R hip pitch fork screw horn 3 |  |
| PASS | L hip yaw cradle screw rear face 0 |  |
| PASS | L hip yaw cradle screw rear face 1 |  |
| PASS | L hip yaw cradle screw rear near 0 |  |
| PASS | L hip yaw cradle screw rear near 1 |  |
| PASS | R hip yaw cradle screw rear face 0 |  |
| PASS | R hip yaw cradle screw rear face 1 |  |
| PASS | R hip yaw cradle screw rear near 0 |  |
| PASS | R hip yaw cradle screw rear near 1 |  |
| PASS | L hip yaw cradle screw horn face 0 |  |
| PASS | L hip yaw cradle screw horn face 1 |  |
| PASS | R hip yaw cradle screw horn face 0 |  |
| PASS | R hip yaw cradle screw horn face 1 |  |
| PASS | L hip yaw fork screw horn 0 |  |
| PASS | L hip yaw fork screw horn 1 |  |
| PASS | L hip yaw fork screw horn 2 |  |
| PASS | L hip yaw fork screw horn 3 |  |
| PASS | R hip yaw fork screw horn 0 |  |
| PASS | R hip yaw fork screw horn 1 |  |
| PASS | R hip yaw fork screw horn 2 |  |
| PASS | R hip yaw fork screw horn 3 |  |
| PASS | L hip roll cradle screw rear face 0 |  |
| PASS | L hip roll cradle screw rear face 1 |  |
| PASS | L hip roll cradle screw rear near 0 |  |
| PASS | L hip roll cradle screw rear near 1 |  |
| PASS | R hip roll cradle screw rear face 0 |  |
| PASS | R hip roll cradle screw rear face 1 |  |
| PASS | R hip roll cradle screw rear near 0 |  |
| PASS | R hip roll cradle screw rear near 1 |  |
| PASS | L hip roll cradle screw horn face 0 |  |
| PASS | L hip roll cradle screw horn face 1 |  |
| PASS | R hip roll cradle screw horn face 0 |  |
| PASS | R hip roll cradle screw horn face 1 |  |
| PASS | L hip roll fork screw horn 0 |  |
| PASS | L hip roll fork screw horn 1 |  |
| PASS | L hip roll fork screw horn 2 |  |
| PASS | L hip roll fork screw horn 3 |  |
| PASS | R hip roll fork screw horn 0 |  |
| PASS | R hip roll fork screw horn 1 |  |
| PASS | R hip roll fork screw horn 2 |  |
| PASS | R hip roll fork screw horn 3 |  |
| PASS | neck pitch cradle screw rear face 0 |  |
| PASS | neck pitch cradle screw rear face 1 |  |
| PASS | neck pitch cradle screw horn face 0 |  |
| PASS | neck pitch cradle screw horn face 1 |  |
| PASS | head pitch cradle screw rear face 0 |  |
| PASS | head pitch cradle screw rear face 1 |  |
| PASS | head pitch cradle screw horn face 0 |  |
| PASS | head pitch cradle screw horn face 1 |  |
| PASS | neck pitch fork screw horn 0 |  |
| PASS | neck pitch fork screw horn 1 |  |
| PASS | neck pitch fork screw horn 2 |  |
| PASS | neck pitch fork screw horn 3 |  |
| PASS | neck pitch fork screw rear 0 |  |
| PASS | neck pitch fork screw rear 1 |  |
| PASS | neck pitch fork screw rear 2 |  |
| PASS | neck pitch fork screw rear 3 |  |
| PASS | body screw 0 |  |
| PASS | body screw 1 |  |
| PASS | head yaw cradle screw rear face 0 |  |
| PASS | head yaw cradle screw rear face 1 |  |
| PASS | head yaw cradle screw rear near 0 |  |
| PASS | head yaw cradle screw rear near 1 |  |
| PASS | head yaw cradle screw horn face 0 |  |
| PASS | head yaw cradle screw horn face 1 |  |
| PASS | head yaw fork screw horn 0 |  |
| PASS | head yaw fork screw horn 1 |  |
| PASS | head yaw fork screw horn 2 |  |
| PASS | head yaw fork screw horn 3 |  |
| PASS | head roll cradle screw rear face 0 |  |
| PASS | head roll cradle screw rear face 1 |  |
| PASS | head roll cradle screw horn face 0 |  |
| PASS | head roll cradle screw horn face 1 |  |
| PASS | bus board rear screw 0 |  |
| PASS | bus board rear screw 1 |  |
| PASS | bus board rear screw 2 |  |
| PASS | bus board rear screw 3 |  |
| PASS | beak cradle screw rear face 0 |  |
| PASS | beak cradle screw rear face 1 |  |
| PASS | beak cradle screw rear near 0 |  |
| PASS | beak cradle screw rear near 1 |  |
| PASS | head pitch fork screw horn 0 |  |
| PASS | head pitch fork screw horn 1 |  |
| PASS | head pitch fork screw horn 2 |  |
| PASS | head pitch fork screw horn 3 |  |
| PASS | head pitch fork screw rear 0 |  |
| PASS | head pitch fork screw rear 1 |  |
| PASS | head pitch fork screw rear 2 |  |
| PASS | head pitch fork screw rear 3 |  |
| PASS | head roll fork screw horn 0 |  |
| PASS | head roll fork screw horn 1 |  |
| PASS | head roll fork screw horn 2 |  |
| PASS | head roll fork screw horn 3 |  |
| PASS | head roll fork screw rear 0 |  |
| PASS | head roll fork screw rear 1 |  |
| PASS | head roll fork screw rear 2 |  |
| PASS | head roll fork screw rear 3 |  |
| PASS | bus board top screw 0 |  |
| PASS | bus board top screw 1 |  |
| PASS | bus board top screw 2 |  |
| PASS | bus board top screw 3 |  |
| PASS | Pi screw 0 |  |
| PASS | Pi screw 1 |  |
| PASS | Pi screw 2 |  |
| PASS | Pi screw 3 |  |
| PASS | beak fork screw horn 0 |  |
| PASS | beak fork screw horn 1 |  |
| PASS | beak fork screw horn 2 |  |
| PASS | beak fork screw horn 3 |  |
| PASS | hood rear screw 0 |  |
| PASS | hood rear screw 1 |  |

## THREAD

| status | item | detail |
|---|---|---|
| PASS | L hip pitch cradle screw rear face 0 | M2 x 8: bites 4.0 mm |
| PASS | L hip pitch cradle screw rear face 1 | M2 x 8: bites 4.0 mm |
| PASS | L hip pitch cradle screw rear near 0 | M2 x 8: bites 4.0 mm |
| PASS | L hip pitch cradle screw rear near 1 | M2 x 8: bites 4.0 mm |
| PASS | L knee cradle screw rear face 0 | M2 x 8: bites 4.0 mm |
| PASS | L knee cradle screw rear face 1 | M2 x 8: bites 4.0 mm |
| PASS | L knee cradle screw rear near 0 | M2 x 8: bites 4.0 mm |
| PASS | L knee cradle screw rear near 1 | M2 x 8: bites 4.0 mm |
| PASS | L hip pitch cradle screw horn face 0 | M2 x 8: bites 4.0 mm |
| PASS | L hip pitch cradle screw horn face 1 | M2 x 8: bites 4.0 mm |
| PASS | L knee cradle screw horn face 0 | M2 x 8: bites 4.0 mm |
| PASS | L knee cradle screw horn face 1 | M2 x 8: bites 4.0 mm |
| PASS | L thigh cover screw hip | M2 x 6: bites 3.0 mm |
| PASS | L thigh cover screw knee | M2 x 6: bites 3.0 mm |
| PASS | L ankle boss screw 0 | M2 flat x 4: bites 1.9 mm |
| PASS | L ankle boss screw 1 | M2 flat x 4: bites 1.9 mm |
| PASS | L ankle boss screw 2 | M2 flat x 4: bites 1.9 mm |
| PASS | L ankle boss screw 3 | M2 flat x 4: bites 1.9 mm |
| PASS | L ankle pitch cradle screw rear face 0 | M2 x 8: bites 4.0 mm |
| PASS | L ankle pitch cradle screw rear face 1 | M2 x 8: bites 4.0 mm |
| PASS | L shoe bottom screw 0 | M3 x 12: bites 6.0 mm |
| PASS | L shoe bottom screw 1 | M3 x 12: bites 5.7 mm |
| PASS | L knee fork screw horn 0 | M2 x 8: bites 2.5 mm |
| PASS | L knee fork screw horn 1 | M2 x 8: bites 2.5 mm |
| PASS | L knee fork screw horn 2 | M2 x 8: bites 2.5 mm |
| PASS | L knee fork screw horn 3 | M2 x 8: bites 2.5 mm |
| PASS | L ankle pitch fork screw horn 0 | M2 x 6: bites 2.3 mm |
| PASS | L ankle pitch fork screw horn 1 | M2 x 6: bites 2.3 mm |
| PASS | L ankle pitch fork screw horn 2 | M2 x 6: bites 2.3 mm |
| PASS | L ankle pitch fork screw horn 3 | M2 x 6: bites 2.3 mm |
| PASS | L ankle ear screw 0 | M2 x 8: bites 3.8 mm |
| PASS | L ankle ear screw 1 | M2 x 8: bites 3.8 mm |
| PASS | L hip pitch fork screw horn 0 | M2 x 8: bites 2.5 mm |
| PASS | L hip pitch fork screw horn 1 | M2 x 8: bites 2.5 mm |
| PASS | L hip pitch fork screw horn 2 | M2 x 8: bites 2.5 mm |
| PASS | L hip pitch fork screw horn 3 | M2 x 8: bites 2.5 mm |
| PASS | R hip pitch cradle screw rear face 0 | M2 x 8: bites 4.0 mm |
| PASS | R hip pitch cradle screw rear face 1 | M2 x 8: bites 4.0 mm |
| PASS | R hip pitch cradle screw rear near 0 | M2 x 8: bites 4.0 mm |
| PASS | R hip pitch cradle screw rear near 1 | M2 x 8: bites 4.0 mm |
| PASS | R knee cradle screw rear face 0 | M2 x 8: bites 4.0 mm |
| PASS | R knee cradle screw rear face 1 | M2 x 8: bites 4.0 mm |
| PASS | R knee cradle screw rear near 0 | M2 x 8: bites 4.0 mm |
| PASS | R knee cradle screw rear near 1 | M2 x 8: bites 4.0 mm |
| PASS | R hip pitch cradle screw horn face 0 | M2 x 8: bites 4.0 mm |
| PASS | R hip pitch cradle screw horn face 1 | M2 x 8: bites 4.0 mm |
| PASS | R knee cradle screw horn face 0 | M2 x 8: bites 4.0 mm |
| PASS | R knee cradle screw horn face 1 | M2 x 8: bites 4.0 mm |
| PASS | R thigh cover screw hip | M2 x 6: bites 3.0 mm |
| PASS | R thigh cover screw knee | M2 x 6: bites 3.0 mm |
| PASS | R ankle boss screw 0 | M2 flat x 4: bites 1.9 mm |
| PASS | R ankle boss screw 1 | M2 flat x 4: bites 1.9 mm |
| PASS | R ankle boss screw 2 | M2 flat x 4: bites 1.9 mm |
| PASS | R ankle boss screw 3 | M2 flat x 4: bites 1.9 mm |
| PASS | R ankle pitch cradle screw rear face 0 | M2 x 8: bites 4.0 mm |
| PASS | R ankle pitch cradle screw rear face 1 | M2 x 8: bites 4.0 mm |
| PASS | R shoe bottom screw 0 | M3 x 12: bites 6.0 mm |
| PASS | R shoe bottom screw 1 | M3 x 12: bites 5.7 mm |
| PASS | R knee fork screw horn 0 | M2 x 8: bites 2.5 mm |
| PASS | R knee fork screw horn 1 | M2 x 8: bites 2.5 mm |
| PASS | R knee fork screw horn 2 | M2 x 8: bites 2.5 mm |
| PASS | R knee fork screw horn 3 | M2 x 8: bites 2.5 mm |
| PASS | R ankle pitch fork screw horn 0 | M2 x 6: bites 2.3 mm |
| PASS | R ankle pitch fork screw horn 1 | M2 x 6: bites 2.3 mm |
| PASS | R ankle pitch fork screw horn 2 | M2 x 6: bites 2.3 mm |
| PASS | R ankle pitch fork screw horn 3 | M2 x 6: bites 2.3 mm |
| PASS | R ankle ear screw 0 | M2 x 8: bites 3.8 mm |
| PASS | R ankle ear screw 1 | M2 x 8: bites 3.8 mm |
| PASS | R hip pitch fork screw horn 0 | M2 x 8: bites 2.5 mm |
| PASS | R hip pitch fork screw horn 1 | M2 x 8: bites 2.5 mm |
| PASS | R hip pitch fork screw horn 2 | M2 x 8: bites 2.5 mm |
| PASS | R hip pitch fork screw horn 3 | M2 x 8: bites 2.5 mm |
| PASS | L hip yaw cradle screw rear face 0 | M2 x 8: bites 4.0 mm |
| PASS | L hip yaw cradle screw rear face 1 | M2 x 8: bites 4.0 mm |
| PASS | L hip yaw cradle screw rear near 0 | M2 x 8: bites 4.0 mm |
| PASS | L hip yaw cradle screw rear near 1 | M2 x 8: bites 4.0 mm |
| PASS | R hip yaw cradle screw rear face 0 | M2 x 8: bites 4.0 mm |
| PASS | R hip yaw cradle screw rear face 1 | M2 x 8: bites 4.0 mm |
| PASS | R hip yaw cradle screw rear near 0 | M2 x 8: bites 4.0 mm |
| PASS | R hip yaw cradle screw rear near 1 | M2 x 8: bites 4.0 mm |
| PASS | L hip yaw cradle screw horn face 0 | M2 x 8: bites 4.0 mm |
| PASS | L hip yaw cradle screw horn face 1 | M2 x 8: bites 4.0 mm |
| PASS | R hip yaw cradle screw horn face 0 | M2 x 8: bites 4.0 mm |
| PASS | R hip yaw cradle screw horn face 1 | M2 x 8: bites 4.0 mm |
| PASS | L hip yaw fork screw horn 0 | M2 x 8: bites 2.5 mm |
| PASS | L hip yaw fork screw horn 1 | M2 x 8: bites 2.5 mm |
| PASS | L hip yaw fork screw horn 2 | M2 x 8: bites 2.5 mm |
| PASS | L hip yaw fork screw horn 3 | M2 x 8: bites 2.5 mm |
| PASS | R hip yaw fork screw horn 0 | M2 x 8: bites 2.5 mm |
| PASS | R hip yaw fork screw horn 1 | M2 x 8: bites 2.5 mm |
| PASS | R hip yaw fork screw horn 2 | M2 x 8: bites 2.5 mm |
| PASS | R hip yaw fork screw horn 3 | M2 x 8: bites 2.5 mm |
| PASS | L hip roll cradle screw rear face 0 | M2 x 8: bites 4.0 mm |
| PASS | L hip roll cradle screw rear face 1 | M2 x 8: bites 4.0 mm |
| PASS | L hip roll cradle screw rear near 0 | M2 x 8: bites 4.0 mm |
| PASS | L hip roll cradle screw rear near 1 | M2 x 8: bites 4.0 mm |
| PASS | R hip roll cradle screw rear face 0 | M2 x 8: bites 4.0 mm |
| PASS | R hip roll cradle screw rear face 1 | M2 x 8: bites 4.0 mm |
| PASS | R hip roll cradle screw rear near 0 | M2 x 8: bites 4.0 mm |
| PASS | R hip roll cradle screw rear near 1 | M2 x 8: bites 4.0 mm |
| PASS | L hip roll cradle screw horn face 0 | M2 x 8: bites 4.0 mm |
| PASS | L hip roll cradle screw horn face 1 | M2 x 8: bites 4.0 mm |
| PASS | R hip roll cradle screw horn face 0 | M2 x 8: bites 4.0 mm |
| PASS | R hip roll cradle screw horn face 1 | M2 x 8: bites 4.0 mm |
| PASS | L hip roll fork screw horn 0 | M2 x 8: bites 2.3 mm |
| PASS | L hip roll fork screw horn 1 | M2 x 8: bites 2.3 mm |
| PASS | L hip roll fork screw horn 2 | M2 x 8: bites 2.3 mm |
| PASS | L hip roll fork screw horn 3 | M2 x 8: bites 2.3 mm |
| PASS | R hip roll fork screw horn 0 | M2 x 8: bites 2.3 mm |
| PASS | R hip roll fork screw horn 1 | M2 x 8: bites 2.3 mm |
| PASS | R hip roll fork screw horn 2 | M2 x 8: bites 2.3 mm |
| PASS | R hip roll fork screw horn 3 | M2 x 8: bites 2.3 mm |
| PASS | neck pitch cradle screw rear face 0 | M2 x 8: bites 4.0 mm |
| PASS | neck pitch cradle screw rear face 1 | M2 x 8: bites 4.0 mm |
| PASS | neck pitch cradle screw horn face 0 | M2 x 8: bites 4.0 mm |
| PASS | neck pitch cradle screw horn face 1 | M2 x 8: bites 4.0 mm |
| PASS | head pitch cradle screw rear face 0 | M2 x 8: bites 4.0 mm |
| PASS | head pitch cradle screw rear face 1 | M2 x 8: bites 4.0 mm |
| PASS | head pitch cradle screw horn face 0 | M2 x 8: bites 4.0 mm |
| PASS | head pitch cradle screw horn face 1 | M2 x 8: bites 4.0 mm |
| PASS | neck pitch fork screw horn 0 | M2 x 5: bites 1.9 mm |
| PASS | neck pitch fork screw horn 1 | M2 x 5: bites 1.9 mm |
| PASS | neck pitch fork screw horn 2 | M2 x 5: bites 1.9 mm |
| PASS | neck pitch fork screw horn 3 | M2 x 5: bites 1.9 mm |
| PASS | neck pitch fork screw rear 0 | M2 x 5: bites 2.5 mm |
| PASS | neck pitch fork screw rear 1 | M2 x 5: bites 2.5 mm |
| PASS | neck pitch fork screw rear 2 | M2 x 5: bites 2.5 mm |
| PASS | neck pitch fork screw rear 3 | M2 x 5: bites 2.5 mm |
| PASS | body screw 0 | M2 x 6: bites 3.0 mm |
| PASS | body screw 1 | M2 x 6: bites 3.0 mm |
| PASS | head yaw cradle screw rear face 0 | M2 x 8: bites 4.0 mm |
| PASS | head yaw cradle screw rear face 1 | M2 x 8: bites 4.0 mm |
| PASS | head yaw cradle screw rear near 0 | M2 x 8: bites 4.0 mm |
| PASS | head yaw cradle screw rear near 1 | M2 x 8: bites 4.0 mm |
| PASS | head yaw cradle screw horn face 0 | M2 x 8: bites 4.0 mm |
| PASS | head yaw cradle screw horn face 1 | M2 x 8: bites 4.0 mm |
| PASS | head yaw fork screw horn 0 | M2 x 6: bites 2.0 mm |
| PASS | head yaw fork screw horn 1 | M2 x 6: bites 2.0 mm |
| PASS | head yaw fork screw horn 2 | M2 x 6: bites 2.0 mm |
| PASS | head yaw fork screw horn 3 | M2 x 6: bites 2.0 mm |
| PASS | head roll cradle screw rear face 0 | M2 x 8: bites 4.0 mm |
| PASS | head roll cradle screw rear face 1 | M2 x 8: bites 4.0 mm |
| PASS | head roll cradle screw horn face 0 | M2 x 8: bites 4.0 mm |
| PASS | head roll cradle screw horn face 1 | M2 x 8: bites 4.0 mm |
| PASS | bus board rear screw 0 | M2.5 x 5: bites 2.5 mm |
| PASS | bus board rear screw 1 | M2.5 x 5: bites 2.5 mm |
| PASS | bus board rear screw 2 | M2.5 x 5: bites 2.5 mm |
| PASS | bus board rear screw 3 | M2.5 x 5: bites 2.5 mm |
| PASS | beak cradle screw rear face 0 | M2 x 8: bites 4.0 mm |
| PASS | beak cradle screw rear face 1 | M2 x 8: bites 4.0 mm |
| PASS | beak cradle screw rear near 0 | M2 x 8: bites 4.0 mm |
| PASS | beak cradle screw rear near 1 | M2 x 8: bites 4.0 mm |
| PASS | head pitch fork screw horn 0 | M2 x 5: bites 2.0 mm |
| PASS | head pitch fork screw horn 1 | M2 x 5: bites 2.0 mm |
| PASS | head pitch fork screw horn 2 | M2 x 5: bites 2.0 mm |
| PASS | head pitch fork screw horn 3 | M2 x 5: bites 2.0 mm |
| PASS | head pitch fork screw rear 0 | M2 x 5: bites 2.5 mm |
| PASS | head pitch fork screw rear 1 | M2 x 5: bites 2.5 mm |
| PASS | head pitch fork screw rear 2 | M2 x 5: bites 2.5 mm |
| PASS | head pitch fork screw rear 3 | M2 x 5: bites 2.5 mm |
| PASS | head roll fork screw horn 0 | M2 x 8: bites 3.8 mm |
| PASS | head roll fork screw horn 1 | M2 x 8: bites 3.8 mm |
| PASS | head roll fork screw horn 2 | M2 x 8: bites 3.8 mm |
| PASS | head roll fork screw horn 3 | M2 x 8: bites 3.8 mm |
| PASS | head roll fork screw rear 0 | M2 x 6: bites 3.0 mm |
| PASS | head roll fork screw rear 1 | M2 x 6: bites 3.0 mm |
| PASS | head roll fork screw rear 2 | M2 x 6: bites 3.0 mm |
| PASS | head roll fork screw rear 3 | M2 x 6: bites 3.0 mm |
| PASS | bus board top screw 0 | M2.5 x 5: bites 2.5 mm |
| PASS | bus board top screw 1 | M2.5 x 5: bites 2.5 mm |
| PASS | bus board top screw 2 | M2.5 x 5: bites 2.5 mm |
| PASS | bus board top screw 3 | M2.5 x 5: bites 2.5 mm |
| PASS | Pi screw 0 | M2 x 6: bites 3.0 mm |
| PASS | Pi screw 1 | M2 x 6: bites 3.0 mm |
| PASS | Pi screw 2 | M2 x 6: bites 3.0 mm |
| PASS | Pi screw 3 | M2 x 6: bites 3.0 mm |
| PASS | beak fork screw horn 0 | M2 x 5: bites 1.9 mm |
| PASS | beak fork screw horn 1 | M2 x 5: bites 1.9 mm |
| PASS | beak fork screw horn 2 | M2 x 5: bites 1.9 mm |
| PASS | beak fork screw horn 3 | M2 x 5: bites 1.9 mm |
| PASS | hood rear screw 0 | M2 x 8: bites 4.0 mm |
| PASS | hood rear screw 1 | M2 x 8: bites 4.0 mm |
| PASS | R hinge screw | M3 x 10: bites 4.3 mm |
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
