meetsitaram/duck-droids/reports/feetech/assembly.md

# Physical checks

From tools/assembly.py

1083 checks: 1083 pass, 0 warn, **0 fail**

## PATH

| status | item | detail |
|---|---|---|
| PASS | thigh_L: L hip pitch servo |  |
| PASS | thigh_L: L knee servo |  |
| PASS | thigh_L: L hip pitch lid |  |
| PASS | thigh_L: L knee lid |  |
| PASS | thigh_L: L hip pitch bearing |  |
| PASS | thigh_L: L knee bearing |  |
| PASS | thigh_L: L hip pitch horn |  |
| PASS | thigh_L: L knee horn |  |
| PASS | thigh_L: L thigh cover |  |
| PASS | shin_L: L ankle servo |  |
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
