meetsitaram/duck-droids/docs/images/assembly/big/clips/body.gif

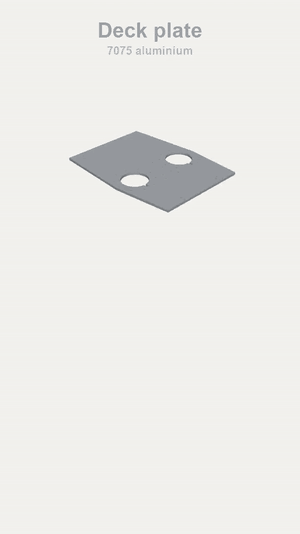
docs/images/assembly/big/clips/body.gif
