meetsitaram/duck-droids/docs/images/assembly/big/clips/finished.gif

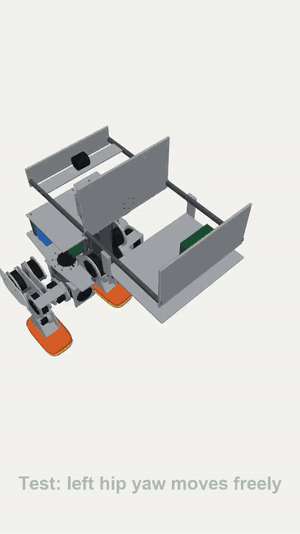
docs/images/assembly/big/clips/finished.gif
