meetsitaram/duck-droids/docs/images/assembly/big/clips/head.gif

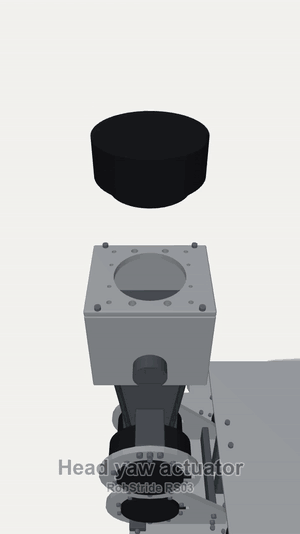
docs/images/assembly/big/clips/head.gif
