meetsitaram/duck-droids/docs/images/assembly/big/clips/leg_L.gif

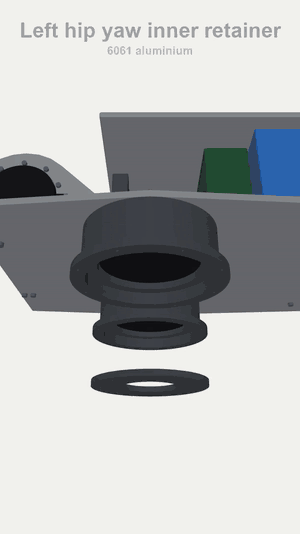
docs/images/assembly/big/clips/leg_L.gif
