meetsitaram/duck-droids/docs/images/assembly/big/clips/neck.gif

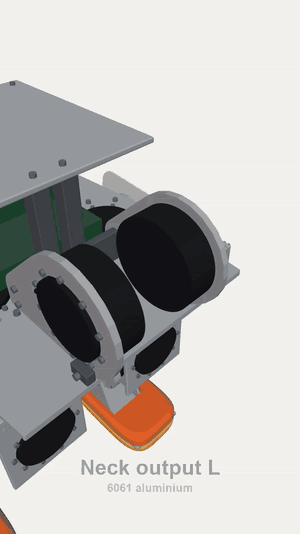
docs/images/assembly/big/clips/neck.gif
