meetsitaram/duck-droids/docs/images/assembly/big/reveal.gif

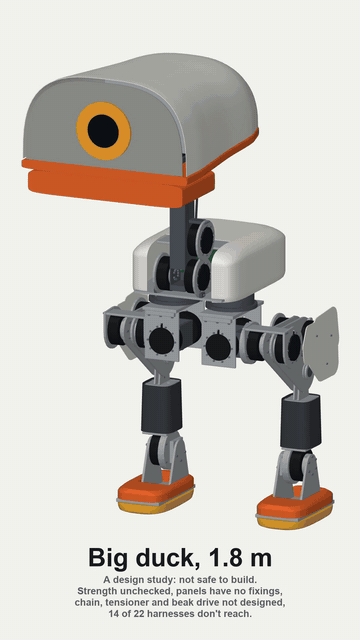
docs/images/assembly/big/reveal.gif
