meetsitaram/duck-droids/docs/images/assembly/feetech/reveal.gif

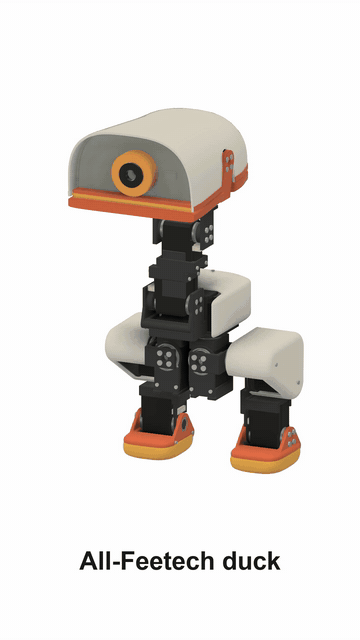
docs/images/assembly/feetech/reveal.gif
