meetsitaram/duck-droids/docs/images/assembly/hd1910/reveal.gif

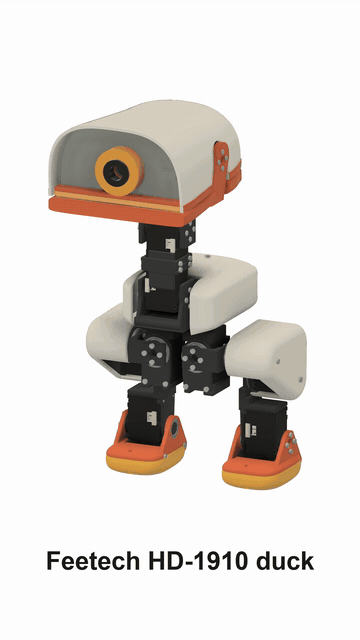
docs/images/assembly/hd1910/reveal.gif
