meetsitaram/duck-droids/docs/images/assembly/hobby/leg_R.gif

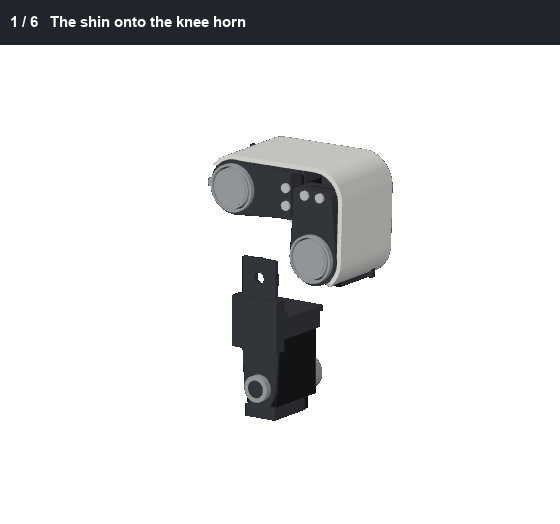
docs/images/assembly/hobby/leg_R.gif
