meetsitaram/duck-droids/docs/images/assembly/hobby/shoe_R.gif

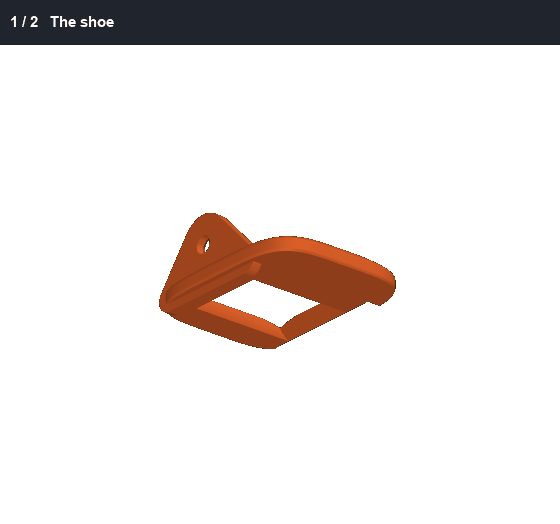
docs/images/assembly/hobby/shoe_R.gif
