meetsitaram/duck-droids/docs/images/assembly/hobby/thigh_R.gif

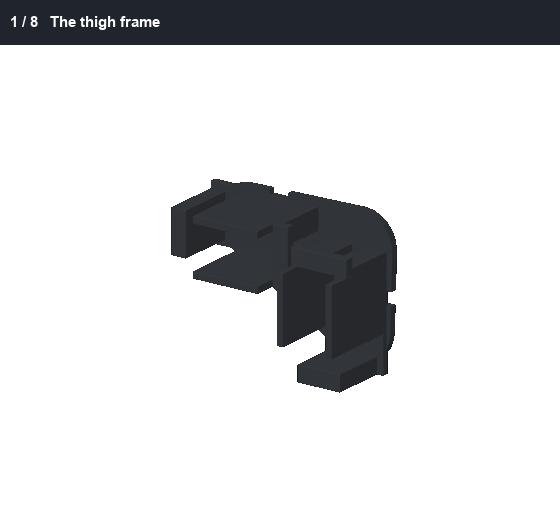
docs/images/assembly/hobby/thigh_R.gif
