meetsitaram/duck-droids/docs/images/assembly/hybrid/reveal.gif

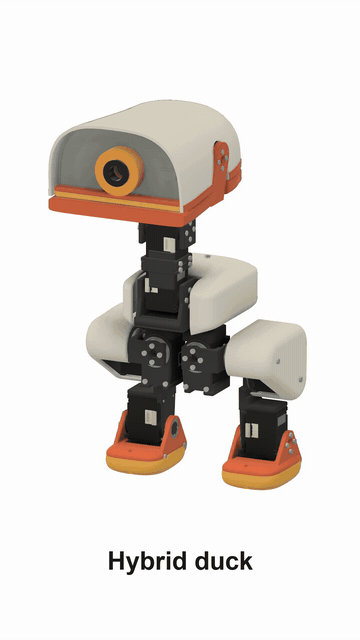
docs/images/assembly/hybrid/reveal.gif
