meetsitaram/duck-droids/docs/images/assembly/milli_build.gif

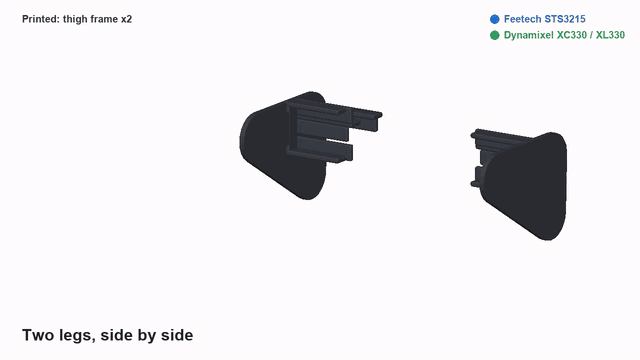
docs/images/assembly/milli_build.gif
