meetsitaram/duck-droids/docs/images/wiring/sts3215.png

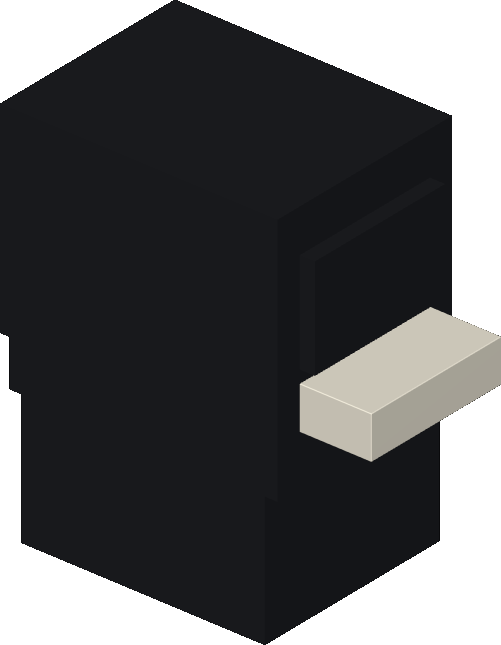
docs/images/wiring/sts3215.png
