meetsitaram/duck-droids/reports/dynamixel/prints_sheet.png

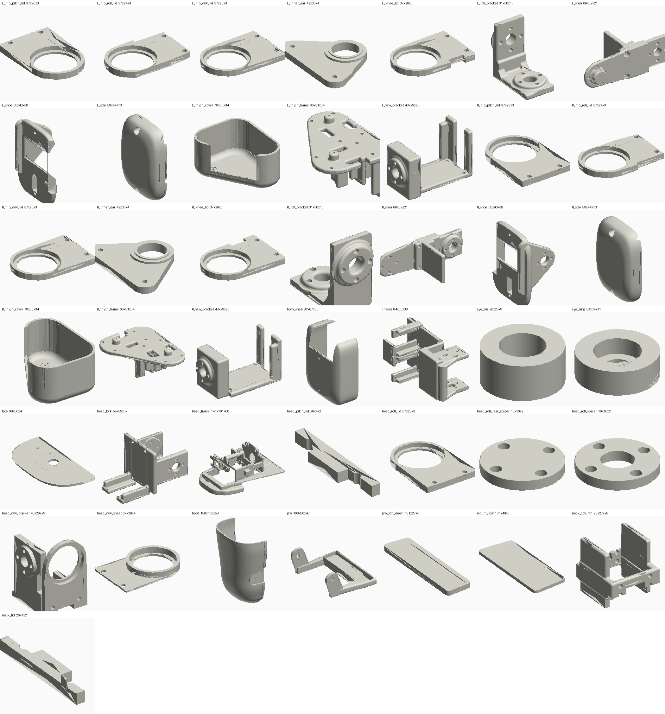
reports/dynamixel/prints_sheet.png
