meetsitaram/duck-droids/reports/fusion_verify.md

# Physical checks

From tools/verify_fusion.py: the Fusion bodies against the exported STL solids.

43 checks: 43 pass, 0 warn, **0 fail**

## POINTS

| status | item | detail |
|---|---|---|
| PASS | L hip yaw lid | 0.2 % of 1500 points disagree; solid in 508 offline, 505 in Fusion |
| PASS | L yaw bracket | 0.3 % of 1500 points disagree; solid in 335 offline, 331 in Fusion |
| PASS | L hip roll lid | 0.0 % of 1500 points disagree; solid in 458 offline, 458 in Fusion |
| PASS | L roll bracket | 0.5 % of 1500 points disagree; solid in 283 offline, 278 in Fusion |
| PASS | L thigh frame | 0.0 % of 1500 points disagree; solid in 117 offline, 117 in Fusion |
| PASS | L hip pitch lid | 0.2 % of 1500 points disagree; solid in 490 offline, 491 in Fusion |
| PASS | L knee lid | 0.0 % of 1500 points disagree; solid in 509 offline, 509 in Fusion |
| PASS | L thigh cover | 1.2 % of 1500 points disagree; solid in 138 offline, 130 in Fusion |
| PASS | L shin | 0.1 % of 1500 points disagree; solid in 182 offline, 184 in Fusion |
| PASS | L shoe | 0.1 % of 1500 points disagree; solid in 209 offline, 209 in Fusion |
| PASS | L sole | 1.2 % of 1500 points disagree; solid in 1052 offline, 1070 in Fusion |
| PASS | L inner ear | 0.1 % of 1500 points disagree; solid in 682 offline, 684 in Fusion |
| PASS | R hip yaw lid | 0.0 % of 1500 points disagree; solid in 483 offline, 483 in Fusion |
| PASS | R yaw bracket | 0.7 % of 1500 points disagree; solid in 306 offline, 301 in Fusion |
| PASS | R hip roll lid | 0.0 % of 1500 points disagree; solid in 459 offline, 459 in Fusion |
| PASS | R roll bracket | 0.3 % of 1500 points disagree; solid in 298 offline, 297 in Fusion |
| PASS | R thigh frame | 0.1 % of 1500 points disagree; solid in 134 offline, 134 in Fusion |
| PASS | R hip pitch lid | 0.0 % of 1500 points disagree; solid in 518 offline, 518 in Fusion |
| PASS | R knee lid | 0.1 % of 1500 points disagree; solid in 476 offline, 474 in Fusion |
| PASS | R thigh cover | 1.8 % of 1500 points disagree; solid in 155 offline, 146 in Fusion |
| PASS | R shin | 0.0 % of 1500 points disagree; solid in 189 offline, 189 in Fusion |
| PASS | R shoe | 0.1 % of 1500 points disagree; solid in 231 offline, 232 in Fusion |
| PASS | R sole | 1.1 % of 1500 points disagree; solid in 1095 offline, 1107 in Fusion |
| PASS | R inner ear | 0.0 % of 1500 points disagree; solid in 669 offline, 669 in Fusion |
| PASS | chassis | 0.0 % of 1500 points disagree; solid in 164 offline, 164 in Fusion |
| PASS | body shell | 0.5 % of 1500 points disagree; solid in 120 offline, 120 in Fusion |
| PASS | neck column | 0.5 % of 1500 points disagree; solid in 296 offline, 288 in Fusion |
| PASS | neck lid | 0.2 % of 1500 points disagree; solid in 1241 offline, 1242 in Fusion |
| PASS | head pitch lid | 0.2 % of 1500 points disagree; solid in 1244 offline, 1243 in Fusion |
| PASS | head fork | 0.2 % of 1500 points disagree; solid in 193 offline, 190 in Fusion |
| PASS | head yaw sheet | 0.2 % of 1500 points disagree; solid in 333 offline, 332 in Fusion |
| PASS | head yaw bracket | 0.6 % of 1500 points disagree; solid in 267 offline, 260 in Fusion |
| PASS | head roll lid | 0.0 % of 1500 points disagree; solid in 750 offline, 750 in Fusion |
| PASS | head roll spacer | 0.1 % of 1500 points disagree; solid in 898 offline, 899 in Fusion |
| PASS | head roll rear spacer | 0.1 % of 1500 points disagree; solid in 1079 offline, 1080 in Fusion |
| PASS | head frame | 0.0 % of 1500 points disagree; solid in 98 offline, 98 in Fusion |
| PASS | hood | 0.5 % of 1500 points disagree; solid in 82 offline, 82 in Fusion |
| PASS | jaw | 0.0 % of 1500 points disagree; solid in 106 offline, 106 in Fusion |
| PASS | jaw soft insert | 0.1 % of 1500 points disagree; solid in 1473 offline, 1474 in Fusion |
| PASS | mouth roof | 0.1 % of 1500 points disagree; solid in 1450 offline, 1451 in Fusion |
| PASS | face | 0.1 % of 1500 points disagree; solid in 714 offline, 715 in Fusion |
| PASS | eye ring | 0.1 % of 1500 points disagree; solid in 898 offline, 899 in Fusion |
| PASS | eye iris | 0.1 % of 1500 points disagree; solid in 863 offline, 862 in Fusion |
