meetsitaram/duck-droids/reports/dynamixel/fusion_verify.md

# Physical checks

From tools/verify_fusion.py: the Fusion bodies against the exported STL solids.

39 checks: 39 pass, 0 warn, **0 fail**

## POINTS

| status | item | detail |
|---|---|---|
| PASS | L hip yaw lid | 0.1 % of 1500 points disagree; solid in 776 offline, 775 in Fusion |
| PASS | L yaw bracket | 0.3 % of 1500 points disagree; solid in 837 offline, 834 in Fusion |
| PASS | L roll bracket | 0.4 % of 1500 points disagree; solid in 352 offline, 346 in Fusion |
| PASS | L thigh frame | 0.1 % of 1500 points disagree; solid in 139 offline, 138 in Fusion |
| PASS | L hip pitch lid | 0.1 % of 1500 points disagree; solid in 763 offline, 762 in Fusion |
| PASS | L knee lid | 0.1 % of 1500 points disagree; solid in 712 offline, 711 in Fusion |
| PASS | L thigh cover | 2.1 % of 1500 points disagree; solid in 160 offline, 155 in Fusion |
| PASS | L shin | 0.3 % of 1500 points disagree; solid in 341 offline, 341 in Fusion |
| PASS | L shoe | 0.1 % of 1500 points disagree; solid in 283 offline, 283 in Fusion |
| PASS | L sole | 0.5 % of 1500 points disagree; solid in 1267 offline, 1272 in Fusion |
| PASS | R hip yaw lid | 0.1 % of 1500 points disagree; solid in 757 offline, 758 in Fusion |
| PASS | R yaw bracket | 1.3 % of 1500 points disagree; solid in 830 offline, 810 in Fusion |
| PASS | R roll bracket | 0.7 % of 1500 points disagree; solid in 387 offline, 380 in Fusion |
| PASS | R thigh frame | 0.1 % of 1500 points disagree; solid in 130 offline, 130 in Fusion |
| PASS | R hip pitch lid | 0.1 % of 1500 points disagree; solid in 758 offline, 756 in Fusion |
| PASS | R knee lid | 0.1 % of 1500 points disagree; solid in 704 offline, 703 in Fusion |
| PASS | R thigh cover | 1.7 % of 1500 points disagree; solid in 182 offline, 168 in Fusion |
| PASS | R shin | 0.7 % of 1500 points disagree; solid in 359 offline, 355 in Fusion |
| PASS | R shoe | 0.2 % of 1500 points disagree; solid in 305 offline, 302 in Fusion |
| PASS | R sole | 0.6 % of 1500 points disagree; solid in 1261 offline, 1266 in Fusion |
| PASS | chassis | 0.3 % of 1500 points disagree; solid in 121 offline, 121 in Fusion |
| PASS | body shell | 0.5 % of 1500 points disagree; solid in 127 offline, 126 in Fusion |
| PASS | neck column | 0.3 % of 1500 points disagree; solid in 249 offline, 245 in Fusion |
| PASS | neck lid | 0.1 % of 1500 points disagree; solid in 877 offline, 878 in Fusion |
| PASS | head pitch lid | 0.2 % of 1500 points disagree; solid in 913 offline, 916 in Fusion |
| PASS | head fork | 0.1 % of 1500 points disagree; solid in 150 offline, 149 in Fusion |
| PASS | head yaw sheet | 0.1 % of 1500 points disagree; solid in 264 offline, 264 in Fusion |
| PASS | head yaw bracket | 0.9 % of 1500 points disagree; solid in 263 offline, 252 in Fusion |
| PASS | head roll lid | 0.0 % of 1500 points disagree; solid in 719 offline, 719 in Fusion |
| PASS | head roll spacer | 0.2 % of 1500 points disagree; solid in 909 offline, 908 in Fusion |
| PASS | head roll rear spacer | 0.4 % of 1500 points disagree; solid in 1079 offline, 1081 in Fusion |
| PASS | head frame | 0.0 % of 1500 points disagree; solid in 65 offline, 65 in Fusion |
| PASS | hood | 0.5 % of 1500 points disagree; solid in 88 offline, 85 in Fusion |
| PASS | jaw | 0.1 % of 1500 points disagree; solid in 108 offline, 107 in Fusion |
| PASS | jaw soft insert | 0.1 % of 1500 points disagree; solid in 1469 offline, 1471 in Fusion |
| PASS | mouth roof | 0.0 % of 1500 points disagree; solid in 1443 offline, 1443 in Fusion |
| PASS | face | 0.1 % of 1500 points disagree; solid in 720 offline, 721 in Fusion |
| PASS | eye ring | 0.1 % of 1500 points disagree; solid in 891 offline, 892 in Fusion |
| PASS | eye iris | 0.1 % of 1500 points disagree; solid in 780 offline, 781 in Fusion |
