meetsitaram/duck-droids/reports/feetech/fusion_verify.md

# Physical checks

From tools/verify_fusion.py: the Fusion bodies against the exported STL solids.

42 checks: 42 pass, 0 warn, **0 fail**

## POINTS

| status | item | detail |
|---|---|---|
| PASS | L hip yaw lid | 0.2 % of 1500 points disagree; solid in 504 offline, 501 in Fusion |
| PASS | L yaw bracket | 0.3 % of 1500 points disagree; solid in 335 offline, 331 in Fusion |
| PASS | L hip roll lid | 0.0 % of 1500 points disagree; solid in 458 offline, 458 in Fusion |
| PASS | L roll bracket | 0.5 % of 1500 points disagree; solid in 283 offline, 278 in Fusion |
| PASS | L thigh frame | 0.0 % of 1500 points disagree; solid in 117 offline, 117 in Fusion |
| PASS | L hip pitch lid | 0.2 % of 1500 points disagree; solid in 490 offline, 491 in Fusion |
| PASS | L knee lid | 0.0 % of 1500 points disagree; solid in 509 offline, 509 in Fusion |
| PASS | L thigh cover | 1.2 % of 1500 points disagree; solid in 138 offline, 130 in Fusion |
| PASS | L shin | 0.3 % of 1500 points disagree; solid in 186 offline, 186 in Fusion |
| PASS | L shoe | 0.1 % of 1500 points disagree; solid in 209 offline, 209 in Fusion |
| PASS | L sole | 1.3 % of 1500 points disagree; solid in 1051 offline, 1070 in Fusion |
| PASS | L inner ear | 0.1 % of 1500 points disagree; solid in 682 offline, 684 in Fusion |
| PASS | R hip yaw lid | 0.0 % of 1500 points disagree; solid in 482 offline, 482 in Fusion |
| PASS | R yaw bracket | 0.6 % of 1500 points disagree; solid in 307 offline, 300 in Fusion |
| PASS | R hip roll lid | 0.0 % of 1500 points disagree; solid in 459 offline, 459 in Fusion |
| PASS | R roll bracket | 0.3 % of 1500 points disagree; solid in 298 offline, 297 in Fusion |
| PASS | R thigh frame | 0.2 % of 1500 points disagree; solid in 134 offline, 133 in Fusion |
| PASS | R hip pitch lid | 0.0 % of 1500 points disagree; solid in 518 offline, 518 in Fusion |
| PASS | R knee lid | 0.1 % of 1500 points disagree; solid in 476 offline, 474 in Fusion |
| PASS | R thigh cover | 1.8 % of 1500 points disagree; solid in 155 offline, 146 in Fusion |
| PASS | R shin | 0.0 % of 1500 points disagree; solid in 192 offline, 192 in Fusion |
| PASS | R shoe | 0.2 % of 1500 points disagree; solid in 231 offline, 230 in Fusion |
| PASS | R sole | 1.5 % of 1500 points disagree; solid in 1089 offline, 1107 in Fusion |
| PASS | R inner ear | 0.0 % of 1500 points disagree; solid in 669 offline, 669 in Fusion |
| PASS | chassis | 0.1 % of 1500 points disagree; solid in 259 offline, 258 in Fusion |
| PASS | body shell | 0.6 % of 1500 points disagree; solid in 105 offline, 106 in Fusion |
| PASS | neck column | 0.5 % of 1500 points disagree; solid in 245 offline, 238 in Fusion |
| PASS | neck lid | 0.1 % of 1500 points disagree; solid in 1338 offline, 1340 in Fusion |
| PASS | head pitch lid | 0.1 % of 1500 points disagree; solid in 1429 offline, 1431 in Fusion |
| PASS | head fork | 0.0 % of 1500 points disagree; solid in 156 offline, 156 in Fusion |
| PASS | head yaw sheet | 0.1 % of 1500 points disagree; solid in 325 offline, 326 in Fusion |
| PASS | head yaw bracket | 0.1 % of 1500 points disagree; solid in 279 offline, 277 in Fusion |
| PASS | head roll lid | 0.2 % of 1500 points disagree; solid in 510 offline, 507 in Fusion |
| PASS | head roll spacer | 0.1 % of 1500 points disagree; solid in 946 offline, 947 in Fusion |
| PASS | head frame | 0.0 % of 1500 points disagree; solid in 78 offline, 78 in Fusion |
| PASS | hood | 0.3 % of 1500 points disagree; solid in 63 offline, 65 in Fusion |
| PASS | jaw | 0.0 % of 1500 points disagree; solid in 73 offline, 73 in Fusion |
| PASS | jaw soft insert | 0.0 % of 1500 points disagree; solid in 1482 offline, 1482 in Fusion |
| PASS | mouth roof | 0.0 % of 1500 points disagree; solid in 1459 offline, 1459 in Fusion |
| PASS | face | 0.1 % of 1500 points disagree; solid in 747 offline, 749 in Fusion |
| PASS | eye ring | 0.2 % of 1500 points disagree; solid in 382 offline, 381 in Fusion |
| PASS | eye iris | 0.1 % of 1500 points disagree; solid in 960 offline, 960 in Fusion |
