meetsitaram/duck-droids/reports/hd1910/fusion_verify.md

# Physical checks

From tools/verify_fusion.py: the Fusion bodies against the exported STL solids.

43 checks: 43 pass, 0 warn, **0 fail**

## POINTS

| status | item | detail |
|---|---|---|
| PASS | L hip yaw lid | 0.2 % of 1500 points disagree; solid in 792 offline, 791 in Fusion |
| PASS | L yaw bracket | 0.2 % of 1500 points disagree; solid in 342 offline, 339 in Fusion |
| PASS | L hip roll lid | 0.3 % of 1500 points disagree; solid in 690 offline, 686 in Fusion |
| PASS | L roll bracket | 0.6 % of 1500 points disagree; solid in 319 offline, 314 in Fusion |
| PASS | L thigh frame | 0.1 % of 1500 points disagree; solid in 157 offline, 155 in Fusion |
| PASS | L hip pitch lid | 0.1 % of 1500 points disagree; solid in 785 offline, 783 in Fusion |
| PASS | L knee lid | 0.0 % of 1500 points disagree; solid in 749 offline, 749 in Fusion |
| PASS | L thigh cover | 2.4 % of 1500 points disagree; solid in 162 offline, 152 in Fusion |
| PASS | L shin | 0.1 % of 1500 points disagree; solid in 226 offline, 225 in Fusion |
| PASS | L shoe | 0.1 % of 1500 points disagree; solid in 204 offline, 205 in Fusion |
| PASS | L sole | 1.4 % of 1500 points disagree; solid in 1102 offline, 1117 in Fusion |
| PASS | L inner ear | 0.0 % of 1500 points disagree; solid in 640 offline, 640 in Fusion |
| PASS | R hip yaw lid | 0.1 % of 1500 points disagree; solid in 730 offline, 728 in Fusion |
| PASS | R yaw bracket | 0.3 % of 1500 points disagree; solid in 312 offline, 307 in Fusion |
| PASS | R hip roll lid | 0.1 % of 1500 points disagree; solid in 718 offline, 717 in Fusion |
| PASS | R roll bracket | 0.6 % of 1500 points disagree; solid in 322 offline, 321 in Fusion |
| PASS | R thigh frame | 0.1 % of 1500 points disagree; solid in 144 offline, 143 in Fusion |
| PASS | R hip pitch lid | 0.0 % of 1500 points disagree; solid in 757 offline, 757 in Fusion |
| PASS | R knee lid | 0.1 % of 1500 points disagree; solid in 716 offline, 715 in Fusion |
| PASS | R thigh cover | 2.7 % of 1500 points disagree; solid in 186 offline, 173 in Fusion |
| PASS | R shin | 0.5 % of 1500 points disagree; solid in 241 offline, 238 in Fusion |
| PASS | R shoe | 0.1 % of 1500 points disagree; solid in 227 offline, 228 in Fusion |
| PASS | R sole | 0.4 % of 1500 points disagree; solid in 1163 offline, 1167 in Fusion |
| PASS | R inner ear | 0.1 % of 1500 points disagree; solid in 624 offline, 623 in Fusion |
| PASS | chassis | 0.1 % of 1500 points disagree; solid in 249 offline, 248 in Fusion |
| PASS | body shell | 0.3 % of 1500 points disagree; solid in 129 offline, 130 in Fusion |
| PASS | neck column | 0.3 % of 1500 points disagree; solid in 268 offline, 265 in Fusion |
| PASS | neck lid | 0.1 % of 1500 points disagree; solid in 906 offline, 906 in Fusion |
| PASS | head pitch lid | 0.1 % of 1500 points disagree; solid in 921 offline, 920 in Fusion |
| PASS | head fork | 0.2 % of 1500 points disagree; solid in 187 offline, 184 in Fusion |
| PASS | head yaw sheet | 0.1 % of 1500 points disagree; solid in 332 offline, 332 in Fusion |
| PASS | head yaw bracket | 0.6 % of 1500 points disagree; solid in 267 offline, 260 in Fusion |
| PASS | head roll lid | 0.0 % of 1500 points disagree; solid in 750 offline, 750 in Fusion |
| PASS | head roll spacer | 0.1 % of 1500 points disagree; solid in 899 offline, 899 in Fusion |
| PASS | head roll rear spacer | 0.1 % of 1500 points disagree; solid in 1035 offline, 1036 in Fusion |
| PASS | head frame | 0.0 % of 1500 points disagree; solid in 83 offline, 83 in Fusion |
| PASS | hood | 0.5 % of 1500 points disagree; solid in 85 offline, 85 in Fusion |
| PASS | jaw | 0.0 % of 1500 points disagree; solid in 104 offline, 104 in Fusion |
| PASS | jaw soft insert | 0.1 % of 1500 points disagree; solid in 1472 offline, 1473 in Fusion |
| PASS | mouth roof | 0.1 % of 1500 points disagree; solid in 1451 offline, 1452 in Fusion |
| PASS | face | 0.1 % of 1500 points disagree; solid in 711 offline, 712 in Fusion |
| PASS | eye ring | 0.1 % of 1500 points disagree; solid in 896 offline, 897 in Fusion |
| PASS | eye iris | 0.0 % of 1500 points disagree; solid in 837 offline, 837 in Fusion |
