meetsitaram/duck-droids/LESSONS.md

# Lessons learned: echo (a Figure 03 replica)

Builds on CDX-3R's `cad/fusion/LESSONS.md` and `docs/PIPELINE-PLAYBOOK.md` (C:\Users\PC\projects\cdx-3r): read those
first. Below: what went wrong in this project, and the rule or test that now prevents it. If you are building your
own humanoid this way, start with the `droid-from-spec` skill (the method) and keep this file open beside it
(the traps).

## Process

| Issue | Do instead |
|---|---|
| Packaging a 61 kg humanoid by hand in Fusion would have meant many slow rebuilds | Lay out and check offline first (`tools/checks.py`, ~90 s for 296 checks), build in Fusion once the spec passes (CDX-3R lesson 75, applied to a whole robot) |
| A check passed a design it should have failed: deleting the hip bracket was not caught, because the cosmetic hip lobe "connected" the parts | Run every new check on a deliberately broken design first (`checks.py --bad <case>`). Covers carry no load: connectivity is checked on rigid parts alone, and covers separately must be mounted |
| The skin check let a 5 mm actuator corner through the calf (0.3 % of its volume) because the limit was 5 %; it showed as dark marks in Fusion | Limit 0.5 %; look at the Fusion render after every build (numbers hide ugly geometry) |
| The first proportions came from a low-resolution frame: head 4 cm too tall, arm 4-8 cm too low | Measure on the largest frames available (enlarge the video in the page, pause on exact times), same method on both pictures, and draw the targets as lines across both (`tools/compare.py`) |
| An automatic black-part detector on the photos and renders merged elbow, hand and pelvis into one blob | Measure the replica from its own geometry; use detection only for the reference |
| Every proportion change meant editing dozens of absolute coordinates | Anchor heights at the top of `spec/robot.py` (hip, knee, ankle, shoulder, elbow, wrist, hem, neck, chin); every part placed relative to them. Re-proportioning then passed all checks first time |
| All landmarks were in tolerance, yet the user saw a boxy "butt", a busy arm and a head that read as a bean | Shape is not landmarks: compare silhouettes in close-up crops at the same scale (`compare.py` detail_*), and render shaded without edge lines (every body edge drawn black made the model look like a kit of parts) |
| The head was modelled solid black for three iterations; Figure's is a grey knit hood with a black visor, visible only in a close-up of the side view | Zoom into each region of the reference before modelling it; the lowest-resolution look decides nothing |
| Pieces met with notches (pod above a straight thigh, a neck post under a round head) | Shape neighbours as one silhouette: the thigh's back continues the hip's back line, the neck's top section sits inside the hood so the nape is one curve |
| Our 3/4 render was at 40 degrees, Figure's 3/4 frame at about 60: every width read 10 cm too wide and the legs heavy | Fit the reference camera before comparing: project the model at several angles and pick the one whose silhouette widths match the frame (60 deg, rms 3 cm) |
| "The upper body looks skinnier than the lower": the chest measured right; the side frame showed arms 0.096 deep vs Figure's 0.11 and calves 0.135 vs 0.105, and the torso did not taper to the waist | Measure each section in the view it is seen in (arm depth from the side, width from the front) before changing anything; fix proportions, not only the part pointed at |
| The front frame (shot from above) put Figure's shoulders ~4 cm higher than the side and 3/4 frames do | Take heights from level views only; a raised camera lifts every top surface |
| Feet: a flat plate under a slipper, then a tall block with a flat top ("so off") | Zoom on the reference's feet first: Figure's is a low sneaker (outsole with toe spring, white upper rising from the toe, a stripe to the heel over a white window, angled collar). Model the parts the ankle moves on the shank (sock-shoe), the rest on the foot |
| A toe spring lifts the sole's front off the floor | The contact box (balance check, URDF, MuJoCo) covers only the flat part that stands on the floor |
| Figure's neck looked slimmer than ours by eye (0.07 m deep); the side frame measured 0.117 at its narrowest | Measure the frame (`compare.robot_box` and a row scan of the silhouette) before resizing a part |
| The link masses were hand budgets that summed to 61 kg exactly with the battery as the balance, and each budget was spread over the covers as if they were solid | Masses bottom-up from materials (`tools/mass_model.py`): cover walls, frame fill factors, catalogue actuators, explicit masses for the battery, compute and hands. Report the gap to the target (56.3 vs 61 kg) instead of padding the model to it |
| A per-link rule (frame at least 15 % of the actuators' mass) failed a 2 cm neck post that carries a 0.3 kg actuator easily | A check needs a physical reason: a mass ratio says nothing about strength |
| A `--bad` run of the mass check rewrote `reports/mass.md` with the broken design | Checks write only `reports/checks.md`; each tool writes its own report |
| A measured target read the wrong shape: the black-hip height took the hip lobe before its cuts, and its lowest point anywhere (the domed seam drops at the back) | Measure the replica where the photo was measured (the lobe's underside in its front half, as seen in the front and side frames) and on the finished shape (with its cuts) |
| A redesign done blind: the first hip fix gave the lobe a fin, a slot and a see-through seam, all visible only in pictures | After every geometry change: the checks, then close-up renders from the front, side, back and the angle the user looked from, before and after side by side; then the walk replay |
| The user looked at the hip from below in the web viewer, an angle none of our standard views had | Render the angle the user reports from (a low front view here) and keep it in the before/after set |
| Pictures and numbers in the repo drifted from the design: early renders of an old robot sat in `reports/`, and the README and the viewer quoted last round's mass | Before each commit, re-render every committed picture from the current spec (`render_pose.py`, `preview.py`, the README video) and copy the quoted numbers from the reports (`reports/mass.md`, `reports/checks.md`) |

## Mechanical design

| Issue | Do instead |
|---|---|
| A roll/pitch waist (A3, H2) cannot hide under a one-piece fabric torso: 20 degrees of tilt needs ~5 cm of hem clearance | Yaw-only waist (Asimov 1); keep Figure's look with a black waist column that turns inside the pelvis block |
| A closed black skirt over the hips: the hip roll brackets swing through ~16 cm radius as the thigh flexes | Covers that ride on the moving link (hip lobes first on the hip pitch link, since iteration 21 on the hip roll link: see below); a pelvis block narrow and high enough for 97 degrees of hip flexion (its underside is Figure's arch between the legs) |
| Hip roll bracket ran through the hip pitch actuator | Roll actuator behind the pitch actuator driving backwards; bracket wraps behind and under |
| ...which left a bracket corner behind and below the roll actuator, so the hip cover had to be a box | Drive the roll FORWARD: its output plate runs down the 9 mm gap between the two actuators (it turns in its own plane, so never meets the pitch actuator); the pitch-side bracket goes over the top (the output plate only swings below the axis). Nothing behind the roll actuator, so the cover is a round pod |
| The elbow's output plate showed as a black rectangle on the outside of the arm | Put outputs on the inner face where the outside should read clean (elbow) |
| Knee flexion stopped at 92 degrees: a thigh frame behind the knee met the calf's ankle actuators | Put thigh structure in front, beside the knee pushrod |
| Shoe collar met the ankle fork at 0.67 rad | Low-cut collar below the ankle axis; the black ankle shows above the shoe, as on Figure |
| ...but a rigid shoe cannot rise in front of the ankle: at 0.9 rad of dorsiflexion the shin sweeps down to 8 cm there | Sock-shoe: the shoe's collar line drops from the heel (0.122) to the front of the ankle (0.09); the white upper above it and the angled black collar ride on the shank. Dorsiflexion 0.8 rad (the 90 degree squat uses 0.77). The sock flares toward the heel and sides, where the range leaves room |
| The round shoulder cap and round arms read as a drum on a stick | Arms oval like Figure's (0.11 deep, 0.09 wide); the cap as deep as the arm, starting at full radius inside the torso's side (no waist), the arm flaring up under it |
| Deeper forearms met the upper arm at 135 degrees of elbow flexion | Elbow limit 129 degrees |
| Every actuator's output needs a part of the child link on it | Auto-generated flange on the child's side of each actuator (0.6 x its radius: 0.75 poked out at the shoulder) |
| Static torque in two-foot stance was overstated at the ankle roll (one leg was made to hold the whole upper body's sideways moment) | Closed chain: each leg takes half the upper body as a force at its hip plus half the moment |
| 20 kg in the hands continuously needs 40 N m per elbow (RS03 rated 20) | RS04 elbows first; then (user's choice) RS06 elbows and shoulder rolls, 88 mm, to look like Figure's arms: 10 kg short carry, 3 kg continuous (4 kg needed 109 % of the RS06 rating). The smaller roll flange moved the roll bracket up to stay connected |
| Single-joint sweeps flagged a hanging arm meeting the hip as the waist turns | Collisions between links more than 3 joints apart depend on the pose: warn, do not fail; task poses check combined motion |
| Balancing a pose leaned its ankles past the joint limit (deep squat: 0.86 rad against 0.8) and only a collision gave it away | Poses check every joint against its limits after balancing. The deep squat now leans the torso 21 degrees, as a person does (less knee torque too) |
| Covers cut apart along one plane only touched: the solid union fell into 156 slivers ('covers mounted' failed) | Overlap cut pieces by 2 mm, hidden inside the bigger one; count only pieces over 0.01 cm3 (a mirrored foot left a zero-volume sliver) |
| A thin wall slipped between the sweep's 0.03 rad steps and showed only in a pose | Where covers pass close (the ankle), scan the joint every 0.01 rad per part pair |
| No Figure logo (trademark) | Our own mark: inverted triangles on the visor and chest |
| The covers either side of a joint were allowed to overlap (treated as fabric), so 13 joints could not actually move | Sweep every joint min to max with the covers across it too (only the actuator / flange contact exempt); give each joint room where Figure shows black: openings (torso for shoulder caps and neck, pelvis for the waist column), seams at the arm yaw joints, elbow and knee zones the covers stop short of, round about the joint axis wherever something turns in it |
| Folding joints (elbow, knee) with the axis in the middle of a thick limb fold only until the covers meet | Covers end short of the axis, on a slant at the knee (deeper behind); set the limit from the sweep (elbow 109, knee 123 deg) |
| Marking a joint 'exposed' to let its flange show in a seam also exempted its actuator from the skin check: the 'poke' calibration stopped being caught | `exposed='flange'` exposes the flange only; rerun every calibration after touching a check |
| Windows cut right through the shoe showed the ankle clevis plates as bars | Cut a pocket each side ('cut' geoms with targets, applied in Fusion as a combine and offline as a manifold difference); what a cut uncovers counts as showing in the skin check (calibration 'window') |
| Smaller ankle motors no longer touched the shank plates: the motors floated | The connect check caught it; clamp them between the plates |
| Push rods drawn as part of the shank would collide with the foot in the sweep | Role 'linkage': drawn, kept out of the collision checks (they move with the linkage, not with either link) |
| Shoulder roll: the arm's top sat inside the cap (round about the pitch axis), and the roll bracket left the cap through its wall; rolling the arm 160 deg swept both through the cap | Where two axes cross, give the cover a hemisphere about the crossing and cut the next link's cover as a socket round it (4 mm); take the output out ON the axis (a round hole in the cap's back never sweeps) and down behind the cap. A bracket through the cap's side needs a slot round half of it. Range from the sweep: 150 deg (past it the arm's outer top swept the cap's top) |
| Neck pitch at the jaw: the hood's underside crossed the pitch actuator and the neck at every angle, and nodding swung the chin into the neck | Pitch at the neck's base, on the yaw axis: the neck tilts with the head (one piece with the hood, as Figure's knit neck bends), its base a sphere zone about the axes' crossing; compute the torso's opening from the swept neck. The tilt range sets the collar ring: 34 deg needed 1.2-1.9 cm, 26 deg 9 mm |
| Knee covers that stopped short of the axis on slants showed a black block in a gap ("real knees with actuators won't look like this") | A hinge: a drum round about the axis on one link, between fork cheeks of the other; each cover ends in a concave socket 4 mm clear of the drum, a narrow seam on the outside of the fold (6 deg in front of the knee), an open notch on the inside (behind: 123 deg of flexion) |
| A clip plane at the knee axis never cut the thigh: its loft stopped 3 cm above the axis, and the knee showed a 3.7 cm black band in front | A clip only trims: run a part's sections past every plane meant to shape it, then look at the front view |
| Rigid covers at a fold (elbow, 109 deg): the forearm's front face sweeps 7 cm up the upper arm, and any frame above the elbow is in its way | Cups: both covers run on round the actuator, hollow round it, side walls kept. The child ends on a line through the axis; the parent closes the outside of the fold down to 6 deg from where flexion turns that line, and in front is cut to the child's front face at full flexion (4 mm clear). Carry the stator from the sector the child never reaches |
| The thigh hung under the hip lobe on a 12 mm plate and the yaw actuator's rim, 2.5 cm down ("that connection looks so weak for such a big robot"): the lobe rode on the pitch link, so the thigh rolled and yawed against it | Put the cover on the link before the last joint (the hip roll link): only that joint (yaw) moves the next cover against it, and a seam square to its axis never sweeps (3 mm). The cover then moves against the pelvis (roll): hollow it round the swept parts (convex hulls through the range, as prisms) and bevel it where the roll tips it toward the pelvis |
| Reordering the hip joints (yaw first, as Unitree H1) looked like the way to let the thigh cup the hip motor, as the knee does | Check where the new first actuator goes before reordering: yaw first puts a motor above each hip, where the torso's hem turns, and Figure's black hip band (0.86-1.0 m) has no room for one either. Kept pitch, roll, yaw (Asimov 1, G1, H2) and moved the cover to another link instead: same ranges, same kinematics, the recorded walk still valid |
| Widening the rolling lobe to clear the parts that turn inside it made it touch the hanging wrist, and its swept-volume cut broke through its outer surface in places | Move the actuator along its own axis (6 mm inboard: no kinematic change) before widening a cover; cut the swept volume in slices along the axis, each only as tall as the actuator is there (a cylinder is lower away from its centre line); find holes by sampling the uncut outer surface and testing the points against every cut |
| Domed, the thigh's top wall crossed the rim of the yaw actuator inside it (the 'covers' check caught it) | A clearance opening must clear the actuator at every height the curved wall passes: the opening through the domed top runs 1 cm deeper |
| White lines in the side view: the flat 3 mm hip seam lined up with the other hip's and showed the background through both, and the roll motor's 3 mm clearance cut through the lobe's slim back | Any flat seam is see-through seen level: curve it round the joint's axis (the thigh's top inside a sphere, `keep`; the lobe 3 mm outside it), and cap what a clearance cut reaches. Test with a green background: green inside the outline is light through a gap |
| A bevel plane along the whole lobe left a fin, seen from the front | Cut only over the length of what it must clear (the pelvis block); the full back keeps the round outline |
| Single-joint sweeps cannot see combined motions (a hip pitching, rolling and yawing at once) | Replay the recorded walk through the collision test (`tools/motion_collisions.py`, every 5th frame) before and after a change at a joint |
| An oval pad standing off a rounded arm read as a disc on a post (3/4 view) | Set the disc into a flat side (the section squarer there, n 4), the child's side wall wrapping it 3 mm clear |
| Knee pads inside the leg's width needed recesses that narrowed the shank's top | Pads outside both covers, domed, on mounts that turn in a small round hole on the axis |
| A small domed pad's sections were closer together than the wall is thick, so the skin's cavity (each end moved in by the wall) put sections out of order and the interpolation failed ('x must be strictly increasing') | When moving a loft's ends in for the cavity, drop the middle sections the moved ends pass (`geom.inner_of`) |
| A hip lobe's flat cut faces went through the hip motors and no check saw it: the sweep and skin checks take covers as 3 mm walls, open where they are cut | Check 'covers': each cover's skin closed on its flat cut faces (as Fusion draws them) against the motors of its own and the neighbouring links. Where a motor passes a cover's face, a round opening 3 mm clear of it, centred on the motor's axis |

## Motion (MuJoCo)

| Issue | Do instead |
|---|---|
| Adding bodies to an `MjSpec` that had been compiled once put the right toe on the ankle pitch link: the right ankle roll had a zero Jacobian column and never moved | Add to a fresh spec and compile once; assert each added body's parent |
| Kinematic playback with `mj_kinematics` alone left the directional light with a zero direction (a dark floor), and the MJCF's own spotlight sat over the origin | Call `mj_camlight` after `mj_kinematics`; light the viewing model on its own |
| Retargeted stance feet slid 9 cm/s and sank up to 3 cm into the floor: PICO's feet drift with no contact sensing | Lock planted feet in the IK targets (a second pass over the take) and ground the lowest sole every frame: 2 cm/s, no sinking |
| Motion from a video (2026-11-01): NLF's person detector missed the robot whenever it bent over, which is every pick-up (80 % of frames found) | The camera is fixed: find the robot by its difference from the empty room (the median of 60 frames) and pass that box to NLF as an extra detection: 99.6 % found, the bends included |
| A floor fitted to the planted feet came out tilted a degree or two; from a camera 1.3 m up, looking almost level, that put the back wall 10.6 m away on one side and 14 m on the other, and the robot grew taller with distance | Solve the horizon and the camera's height from the robot itself: in each upright frame its foot and head are at known heights, and the ratio of their distances below the horizon holds at any depth or focal length. The robot then measures 1.60-1.62 m (head joint) from 4 to 9 m |
| The camera's up vector had the wrong sign (tilting it up, not down): the robot came out 2.1 m tall | Derive it from the rule, not by eye: every ray on the horizon row is square to up, so u_z = (v_hz - c_y) when u_y = -f |
| The feet slid with the video's depth jitter: each frame NLF puts the whole body a little nearer or farther | Scale each frame about the camera (the picture is unchanged) until the lowest foot is on the floor, then pin planted feet by moving the root (`--pin`): 5 cm/s to 1 cm/s |
| The head and wrists took odd angles: a video cannot show a robot's visor direction or its wrist twist | Hold them straight (`--hold head,wrists`) and say so |
| The hips stop at 97 deg of flexion, so echo bends 65-77 deg where Figure folds over at every pick-up | Open: a hip redesign (more flexion, a slimmer rear lobe) |

## Scenes (MuJoCo)

| Issue | Do instead |
|---|---|
| A room laid out by eye put walls through the walking robot and the coffee table under its feet | Measure the room from the same video: floor points marked on the empty-room frame, traced to the floor through the calibrated camera, so the room and the motion share one frame. Then check the whole take for overlaps with `mj_geomDistance` |
| MuJoCo read no JPEG texture ("unsupported content type") | Keep sources as JPEG; write PNGs MuJoCo reads to an ignored build folder |
| A 2D texture on a box geom stretched one image over each face | Build textured boxes as meshes with texture coordinates in metres (`_box_mesh`), and rounded upholstery as superellipsoid meshes |
| Poly Haven's velvet is red and its linen blue; its walnut veneer is nearly grey | Keep the photo's detail (luminance about its mean) and recolour it to the room's colours |
| Poly Haven's API refused Python's default user agent (403) | Send a user agent (curl -A) |

## Fusion API (new here)

| Issue | Do instead |
|---|---|
| `rootComponent.name = ...` raises "root component name cannot be changed" | The root takes the document's name on save |
| Every loft showed a seam line down the front (face, torso, legs) | Start the closed splines' points at the back (t = pi) |
| Decals placed on a straight-line estimate of the face sat 2-3 mm deep | Place them on the loft surface interpolated the way the loft is (PCHIP), 0.6 mm proud; then measure in Fusion (TemporaryBRepManager difference) |
| Orthographic `camera.viewExtents` | Equals the visible height in cm (800 x 600 picture) |
| STL export units | millimetres; `make_robot_files.py` detects the scale against the spec |
| As-built joints from a sketch point | Joint axes line up with the world X/Y/Z; Fusion poses matched the offline kinematics within 1 mm |
| Rebuild time grows with the timeline (0.6 s per link in a new document, 10-15 s at ~650 features) | Rebuild into a fresh document when most links change |
| A visor cut from a head: removing bodies while iterating `splitBodyFeature.bodies` raised "Bad index" | Copy the collection to a list first; keep the piece whose centre of mass is in front of the plane. Offline the same cut is `Manifold.trim_by_plane` |
| `viewport.visualStyle` | `ShadedVisualStyle` for review renders (no edge lines) |
| A loft cut by several planes (shoe collar, a band between two lines) | `clip` takes a list of planes, applied in turn; a plane that misses the body makes `splitBodyFeatures.add` raise: keep the body |
| MCP calls time out (~60 s) while Fusion carries on: both feet in one call, all 29 joints in one call | One link per call when it has cut lofts (~45 s each); rebuild only the joints of the links rebuilt (`joints([...])`, 5 s); after a timeout, read `status()` before retrying |
| Past ~1,000 timeline features (repeated link rebuilds) every single-link call timed out, though the work still finished | Rebuild into a fresh document before the timeline passes ~900 |
| A full build alone is now ~1,800 features, and one hip lobe with 17 prism cuts took 5-10 minutes to rebuild (each cut is a sketch, an extrusion and a combine) | One link per call, then poll `status()` with read-only calls (they time out too while Fusion works; keep asking); do the offline work (renders, video, docs) meanwhile; keep cuts few and convex |
| `viewport.saveAsImageFile` returned True and wrote nothing: first while a moved joint's position was uncaptured, then for every save, even at rest (the MCP screenshot failed too) | `build.render` now reports whether the file was written; render poses offline from the spec's shapes (`tools/render_pose.py`, MuJoCo's renderer, same framing within 2 px) |
| ...and `build.render` said "written" because an older picture of the same name was there | Delete the target before saving, then check that the file exists |
| Renaming the document's appearances in one pass over `design.appearances` skipped some (renaming re-sorts the collection), so the STEP export still carried the old name | Collect the matching names first, rename, and repeat until none are left; then grep the export for the old name |
| `app.data.activeProject` raised 'InternalValidationError : group' with no project selected in the data panel | Find the project by name in `app.data.activeHub.dataProjects`; `document.saveAs(name, folder, description, tag)` into a folder made with `rootFolder.dataFolders.add`; check `doc.isSaved` and `dataFile.versionNumber` |
| The STEP's top-level product was named '(Unsaved)' while the document had never been saved | Save the document first (the root component takes its name), then export STEP and `.f3d` (`createFusionArchiveExportOptions`) |
| Fusion held about 10 GB with six full builds open, and the user needed the memory for training runs | Do the Fusion steps first (rebuild, save, export) and say when Fusion can be closed; build in one document, not a new one each round; if asked to terminate it, check the document is saved (`isModified` false) and stop the process |

## Environment (Windows)

| Issue | Do instead |
|---|---|
| `git clone` failed: "Current working directory has a path longer than allowed" (the session scratchpad path) | Clone into a short path (`C:\Users\PC\AppData\Local\Temp\figrefs`) |
| Python could not open files in the session scratchpad (the full path is over 260 characters) | Keep working files in a short path (`%TEMP%\echo`), not the scratchpad |
| Python's `zipfile` could not test the `.f3d` ('compression method not supported') | That is normal for Fusion archives: list the entries (`infolist`) to check the export, or open it in Fusion |
| `import mujoco` fails under `python -I` (it lives in the user site-packages, which `-I` skips) | `-I` for anything that reads downloaded files; plain `python` for our own sim on our own files |
| MuJoCo stand test rocked heel to toe, then leaned 5.5 degrees | Servo gains: kv = kp/6 (kp/25 was far under critical damping), kp = 8 x peak torque (servo give without gravity feed-forward). Both runs held the robot with no torque saturation |

## Repository and publishing

| Issue | Do instead |
|---|---|
| A video of someone else's robot is theirs: its frames and clips cannot be published, and X's terms forbid downloading outside its own features | Keep the clip local and ignored (`reports/video/`), fetch only the minutes needed (an HTTP range read, ffmpeg -ss over the URL), publish only echo's motion and our own renders, and say where the motion came from with no affiliation implied |
| The first push was rejected (GH007): the commits carried the owner's private e-mail | Author commits with the GitHub no-reply address (`<id>+<login>@users.noreply.github.com`); push with `GIT_TERMINAL_PROMPT=0 GCM_INTERACTIVE=never` so a missing credential fails instead of hanging |
| A public repo next to material we may not publish: the reference robot's video frames, comparison panels made from them, the operator's raw motion capture | Ignore them by pattern from the first commit (`reports/compare/figure_*`, `compare_*.png`, `detail_*.png`, `reports/motion/`, `reports/web/`); no reference logo (trademark): our own mark |
| A 20 MB Fusion archive was committed under the old name and renamed in the next commit, so every clone downloaded it twice | Settle names before committing large binaries. To remove one: rebuild the commits without it (`git commit-tree` on the same final tree, verify the trees identical and the file unreachable), keep a backup branch, and force-push with a lease (`--force-with-lease=main:<old>`) only with the owner's go-ahead (the permission system blocks it otherwise) |
| Renaming the robot and the repo (guna to echo) | Rename every file and mention in one commit (`git mv`, then a text replace over tracked files, then regenerate what bakes the name in: URDF, MJCF, STEP, videos), rename the repo through the GitHub API with the credential git already uses (never printed), then `git remote set-url`; GitHub redirects the old URL |
| We built on other people's work (the reference robot's specs and frames, open robots' layouts and URDFs, retargeting code from another project) without a running list of sources and licences, and had to trace each one back at the end | Keep a sources list from day one (`droid-from-spec skill, references/sources.md`). Reading a design is not copying it: Asimov's, Unitree's and AgiBot's licences bind only if their files are copied. Adapted code keeps its notice (`THIRD_PARTY_NOTICES.md`, GMR's MIT notice) and names its source in the file. The project needs its own licence for others to reuse it: echo is Apache-2.0 (`LICENSE`) so anyone can |
| The user wanted to see changes before they went public | Publish the review page (the viewer with the new model, movies and renders), commit locally, and push only after the go-ahead |

## milli (microduck look on STS3215 legs, 2026-11-02)

| Issue | Do instead |
|---|---|
| A 25 cm duck on STS3215s: five 45 x 25 x 35 mm servos per leg stacked under each other gave long, spindly black legs (0.40 m tall) | Put the knee servo BESIDE the hip pitch servo (outboard), as microduck does: they never meet, the thigh can be short, and the white thigh cover wraps the knee servo. 0.34 m |
| The look was drawn by eye from renders and photos: a round-fronted dome head with a flat face panel, "nowhere near close" (user) | Measure the reference's own meshes on a grid (5 mm slices: side profile, front arch, plan width, face depth, eye, bands), scale by the height ratio, and build from the numbers; compare head close-ups on a 10 mm grid (`tools/compare.py` writes `head_*.png`) |
| A head that is wider at the front than the back cannot be a stack of horizontal superellipses | Loft front-view arches along x (`loft(..., along='x')`): a superellipse standing on the lower edge, cut flat below, the front cut by a leaning plane |
| Pollen's gallery shows no open mouth | Their launch video does (chatting 1:07-1:23, floor pick 0:45-0:52): find the motion in video, frames kept local |
| The jaw hinged at the back of the head dropped 5 cm at 0.4 rad, and its rear swung into the fixed band behind it | Hinge at mid-head (microduck's side tab), start the jaw at the hinge, leave the gap under the tab |
| Static single-leg balance is impossible with no ankle roll (microduck has none) | Single-support poses check torque and collisions; balance is reported as a warning: the gait is dynamic |
| A cut through a mirrored shell was not mirrored: the right thigh cover failed where the left passed | `mirror_geom` renames a cut's targets too |
| The thigh covers were blobs on a human (knee-forward) leg: microduck's leg is a bird's, thigh sloping 58 deg back to a knee behind the hip, shin upright | Stand milli as microduck's model stands (hip +1.02, knee -1.02 rad), give it microduck's thigh length (55 mm at 1.34x), and measure the targets in that stance |
| A side cover drawn by eye came out "off angled" | Take its outline from the reference mesh: unrotate it from the reference's stance into the thigh's frame, divide by the thigh length; microduck's is the hull of three circles of 0.29 L (hip, knee, and (-0.47 L, -0.73 L)). A `plate` (side-view polygon extruded in y) carries it |
| An L-shaped neck: the head yaw servo 14 mm ahead of the column | One straight column, the head yaw and roll servos up inside the head; the head's frame passes the roll servo on rails outside its 27 mm reach. Head pitch range rose from 0.78 to 1.2 rad |
| The neck servo stood bare in front of the body | Wrap the body round it, the neck plate out through a slot in the top (the slot ends in front of the hip yaw servos, so neck pitch back is 0.35 rad) |
| The jaw's hinge followed its servo to the back of the head | Pivot the jaw on side tabs at mid-head over the neck, and drive it from a servo behind through a rod, as microduck's linkage does (`joint(..., remote_at=...)`) |
| One-sided neck joints (a horn plate on one face of each servo only) | U-brackets, microduck's way: the horn on one face, an idler on the other, joined across; the neck pitch servo rides in the neck (`joint(..., case_in='child')`) and the neck is two cases bolted end to end |
| The neck could not fold to tuck the head in (Pollen's desk photo) | Notch the body's front for the folding neck: neck pitch 1.6 rad forward, head pitch +/-1.6; a 'head tucked in' pose in the checks |
| 64 mm of bare servo stack between the body and the thighs: the hip roll servo above the hip pitch servo, which needed room to roll under it | Microduck's roll and pitch axes share a height: stand the roll servo in front of the hip pitch servo, its horn on a bracket on the pitch case's front face, and sit the yaw servo on it. 41 mm, the robot 2.4 cm shorter |
| A U-bracket's bridge has to pass the servo it wraps: under the hip pitch servo, its 37 mm long end sweeps through | Map where the case's long end sweeps over the joint's range (here 144-285 deg round the axis for -0.3..1.45 rad) and put the bridge in the free sector (front-below, 310 deg, 25 mm) |
| One-sided ankle | The shoe's two ears either side of the ankle servo (horn and hub with screws outside, idler inside); the shin grips the servo from its top so its inner face is free |
| Leg joints placed by reasoning from the look kept going wrong (a roll servo jutting out in front, a gap under the body) | Read the reference's joints off its model first (positions, axes, ranges, which body each servo case rides in) and copy the layout: microduck's roll servo stands under the yaw servo, horn forward; the roll and pitch axes share a height; the thigh carries both its servos, the pitch servo lying flat, horn in |
| A straight-leg zero pose forced servo cases that sit at an angle in the stance | Make the zero pose the reference's stance (microduck's model stands at its zero pose): every case is square to the axes there |
| Making the head proportional after the robot shrank left parts with negative size (a bracket's ends crossed) and a band opening wider than the head's back | Tie such dimensions to the hood's own size, and give `box` corners that cannot cross; check the head again whenever HK changes |
| A long body box: the Pi Zero stood behind the battery, and the body reached past the neck servo | Look in the reference's parts list for where it keeps its boards: microduck's Pi Zero is in the head, upright behind the face. The body then holds the yaw servos, battery and a bus board, its front flush with the neck: 98 mm (microduck 96 at scale) |
| Flat slab feet with pointed ears ("legs are not that cute") | microduck's shoe from its meshes: a thick rounded yellow sole, the orange upper rising at the toe and heel, rounded ears; low in the middle where the ankle servo swings |
| Feet stacked from slabs (sole, upper, toe, heel) read as layers next to microduck's one rounded shoe | One outline for sole and upper (the same superellipse, the upper rounding over only on top), the sole curling up underneath, the ankle servo in a pocket cut between the ears; compare feet close up, side by side |
| Servo mounts (2026-11-02): a generic U-bracket with its bridge at the case's short end hit the neck servo, the hip roll plate and the top plate (35 failures), because it ignored each joint's range | Mount as the LeRobot SO-101 does (a cradle on the case's link with 2 screws per face at the far pilot holes, a fork on both horns), and place the fork's post by sweeping the case and cradle over the joint's range: the post goes where they never go (`fork_post` in the spec). The user dropped SO-101's sleeve ("SO-101 was just ref for assembly") |
| The overlap check skipped parts of one link, so a fork's post could run through the next servo down unseen; it also hid a head post through the beak servo | `checks.py` static: a printed part must not overlap a servo of its own link (proved with `--bad through`) |
| Joints whose range or neighbours leave no room for a fork's post: hip yaw (the post hits the body wall at +0.09 rad), head yaw (+-2.5 rad); the hip pitch post sits 12 mm in front of the thigh cover | Driven horn only where SO-101 also does it (its wrist roll), and ask the user before trading the look (a bigger cover) for a second support |
| Joints held by a fork needed a post 24 mm out, showing as bars in front of the hips, and we had "the same look" as a robot with none (the user: "find out why the range is limited") | The range was not the limit: a post has to clear the case's corners whatever the range. Slice the reference through each joint's axis before designing a mount: microduck has a thin bearing round the horn, its bore the horn's size, the outer race on a floor over the case's face; round about the axis, so nothing sweeps. 6704ZZ on the STS3215's 20 mm horn |
| A bearing wider than its case: the two hip roll bearings would meet as a leg yaws in | Hip roll 2.5 mm outboard of the yaw axis, no seat wall on the inner side. One leg clears the full 0.45 rad; both legs toes-in together only to 0.27 rad: a limit for the gait |
| "0 failing" with real collisions: the 'touching' limit, 0.3 cm3, came from echo at 1.7 m. On milli that is a fifth of a bearing, and it hid a shoe in the ankle's cradle, a fork's post in the thigh plate, the jaw's back in the bill | Scale any volume limit with the robot: 0.02 cm3 now (parts seated in a servo of their own link keep 0.3). List what a limit hides before trusting it (every overlap above 0.01 cm3 by part) |
| Tracing the build order found what the finished-robot checks could not: a one-piece shoe cannot go on (two fixed ears either side of a servo with a stub), a tray closed on both faces cannot take a servo, and the yaw bracket's screws sit under the roll servo | `tools/assembly.py` holds the order as data: PATH (each part slides in along its path), THREAD, HELD, ACCESS (a key reaches every head, given what is on by then), ALL, with `--bad` cases. The inner ear became its own part; every servo goes into a tray with a separate lid; brackets go on before the servo that covers their screws |
| Writing the screws down found parts held by nothing (sole, thigh cover, body shell, hood) | Every screw is in the spec with its size, length and direction. The hood's only 2 screws are the jaw hinges: enough to model, worth revisiting with the electronics |
| The user asked about a contact switch in the shoe | Slice the reference first: microduck's shoe is two pieces (a TPU cup over a printed upper) with no switch modelled, and its contact forces go to the critic in training; Open Duck Mini has a TPU bottom screwed on from below and press-fit switches on GPIO. milli: a microswitch in the shoe's underside and a TPU sole with 2 screws; its travel in this TPU needs a real test |
| The thigh plate, a rectangle, stuck out of the rounded cover, and no check saw it: it was flagged 'exposed', which excuses a part from the skin check | Flag only what is meant to show. A part inside a cover takes the cover's outline, inset, and stays under the check. It took the user's eye on a video frame: look at each section from more than one side |
| The jaw was a hollow ring where microduck's mouth is a filled tray; the closed view hid it, and only opening the beak showed it | Compare moving parts open as well as shut, against the reference's own footage. microduck's jaw: a tray with two thin arms to the hinge, a soft insert under the rim, and a soft roof |
| Swapping the XC330 ankle for an STS3215: the first try made the shoe 7 mm wider, drawn from the box model | Read the real servo first: its rear horn sits in the case's step, 0.5 mm proud, and its driven horn needs 3.5 mm when no bearing sits there. That took the shoe to 52 mm wide. The gap under the thigh takes the longer case for 4 mm of height, and the case's corners sink into a cup in the TPU sole |
| "0 failing" read as "buildable" when no check looked at strength, wall thickness or the servo's real shape; the user spotted a 3 mm shin plate no one could trust | Say what a check does not cover. Fit is not strength: estimate the load through every printed part, and check walls, before calling a design ready |
| Aligning the ankle and knee servos looked tidy, cost 0.27 rad of knee range, and microduck has the same offset | Check the reference before "fixing" what looks wrong |

## Buildable, not only fitting (milli, 2026-11-03)

Each row is something the user had to find by eye, or nearly did. The checks now find them.

| Issue | Do instead |
|---|---|
| A flat 3 mm printed plate carried the whole robot's weight, bent across its thin side; collision checks passed it | `tools/buildable.py` LOAD: the stress through each section on the load path, in a 3 g landing, against the material across its layers. Each section has a `--bad` case |
| A servo's tray and a neck mount were joined to their links only through the servo case: the "one solid" check counted the case as structure | Check connectivity per PRINTED PART, not per link (ONE): every part must be one piece without the bought parts |
| Plates that looked fine but had slivers under 1 mm either side of a bore | WALL: a voxel opening on each part, at the smallest wall the printer holds. Name the thin parts that are thin on purpose |
| A servo drawn as its bounding box hid a 2.5 mm step round the horn and a lump on its back, so a seat floor was 0.45 mm thick in the model and meaningless on the real part | Model bought parts from sections of the maker's mesh; never design a seat against a bounding box |
| A rectangular plate's corner poked out of a rounded cover, as the part had a flag excusing it from the skin check | Excuse only what is meant to show; give a part under a cover the cover's outline, inset |
| Screws were decorations, with no length or direction, so parts were held by nothing and no hole was ever defined | Every screw in the spec with size, length, position and direction. They drive the assembly checks, the BOM and the holes in the exported parts |
| A plate that looks right needs a material, a section and a load before it is a design; the model let us skip that | Before calling anything ready: which way does the load go, through which section, on which printed layer direction? Then print one joint before buying the rest |
| Covers exported solid, 500 g of plastic | Export what will really print: the wall, with its holes. Look at the exported volumes |
| An interrupted command had already run, and I reported that nothing had changed | After any interrupted step, read the state (`git status`, the file) before saying what is in it |
| Reviewed for hours in offline renders, the user assumed they were looking at CAD, and asked late on "were you building the whole thing without Fusion?" | State at the start of each review what the pictures are (offline primitives, or CAD), and what that can't show. Say early when CAD comes, and what it would add |
| A build video's parts were left out of place at the end, because a moved group didn't include what it was built on; small contact sheets hid it and the user found it | Assert in the renderer that every part ends at its final pose. Look at full-size frames of the finished result from several sides |
| A moving part was only ever compared shut; open, it was a hollow ring against the reference's filled one | Compare moving parts through their range, against the reference's own footage |
| Tools forked from a larger robot failed on the new one, and their names and assumptions were still the old robot's | Try each inherited tool early, and list which ones really work. Don't report a tool as available until it has run on this robot |
| A first torque analysis looked plausible but was meaningless: the floor carried nothing and the root held all the weight. A fall detector read a height that was never the robot's height | Sanity-check physics results against something known before reporting: does the floor carry the weight? does the first frame pass? Report a test as invalid rather than rounding it into a result |
| Collision on the feet only: a falling robot sank through the floor | Give the whole robot simple collision shapes before judging any fall or motion, and look at the video |
| A motion scaled by theory asked for 2.4 times the actuator's no-load speed, with a joint at its limit half the time | After retargeting, report each joint's peak speed against its no-load speed and its time at a limit, before trying physics |
| A physics number is only as good as its inputs: friction, stiffness and infill were guesses, reported beside measured ones | Keep a table of each sim parameter's source: measured, scaled, copied or guessed. Randomize the guesses in training, and replace them from a test rig |
| A background agent ended with no result and no notice, and was reported as still running | Before saying a background job is running, check that it and its output exist |
| Stale docs: the public README described the previous robot after a fork, and the default branch's page lagged the design | Before any push, read the page a stranger lands on. Say which version it shows |
| A trainer built for another robot ran happily on ours while dropping it from 12 cm at every reset: a height in the recipe was tuned to that robot's frame. Another setting silently did nothing, as it only acts through that robot's actuator model | Reused recipes hold absolute numbers and hidden assumptions. Before a long run: print every event and term of the loaded config and question each one; then reset, hold still with zero actions, and read the numbers (feet on the floor, none fall in 2 s). A clean smoke test only proves the code runs |
| "Is it training our robot?" could only be answered by checking | Print from the running config: the model's source, mass, joints, each joint's actuator values against the parts catalogue. Add it to the pre-run check |
| An audit of a recipe reused from another robot found: command ranges past our joint limits, gait lengths and times tuned to its size, mass randomization narrower than our uncertainty, and, once its actuator model was left out, no torque-speed curve or delay at all | Keep an audit script that prints every term of the loaded config. For each number, decide: scale it (say by what), replace it from our parts, or keep it (say why), and write that down beside the config. Removing a piece of a recipe also removes what it did: list those too |
| Actuator numbers were scaled from a sibling model by gear ratio, on the assumption of the same motor, and trained on for hours; a five-minute search showed torque 2.5 x off, as the sibling has a different motor | Before using any actuator number: search the maker's page first, then several retailers, then independent tests. Record the source of each number and whether sources disagree. Never derive a spec that can be looked up. Independent tests also give what specs don't: overload cut-outs, backlash, usable torque in motion |
| Electronics were placeholder boxes until the parts list was checked against real listings. Then: the 5 V regulator was far below the servos' summed stall current, no board fitted its box, a full battery was above the servos' rated voltage, the actuators had months of lead time, and one seller's torque disagreed with the number trained on | Size the electronics as a design step, not at purchase: sum stall currents per voltage rail against the regulator; take each board's and battery's real size from a listing before modelling its box; compare the battery's full-charge voltage with the actuator's range; check lead times early. At purchase, read each listing itself: stock against the quantity needed, what is in the box, and whether the page shows the product named, as one link led to a different product. Buy one joint's parts first, to measure what listings disagree on |
| A walking test reported speed in the body's frame, averaged over all robots, and called the walk good; the first proper video showed a robot told to go straight turning 310 deg in 10 s. Body-frame speed counts a circle as speed, and left and right turners cancel in an average | Test each robot on its own and in the world's frame: start-to-end distance over time against the command, and each robot's absolute turn rate, not the mean. Look at a video of the walk before reporting that it walks: from a following camera, measure heading too, as the camera's own motion hides turning |
| A floor task copied from another robot used its tucked pose: on ours the feet went through the head, and the simulation has no self-collision to stop it, so training would have learned a move the real robot can't make. Its knee pose was past our joint limit too | Before training a skill from another robot, put its poses through our limits and our parts' collision check. Then replay the learned motion through the same check before believing it, as a policy trained without self-collision can pass through itself |
| A render went dark after a small speed-up: a kinematics-only update leaves lights where they were, so the main light was effectively gone. The user noticed the picture was dark before the cause was looked for | When a picture changes in a way nobody asked for, find the cause rather than adjusting colours around it. Compare with a minimal scene to isolate it |
| A policy stayed up, tracked forward speed and lowered its servo load, yet could neither turn nor stand still: it pivoted on both hip yaws at 1.8 Hz. Time-averaged yaw hid this. The reused reward, an exponential of squared error, gives no gradient at a large error, so nothing taught it to stop. The first guess at the cause was wrong too, and only a measurement showed that | Print each reward term's score against its maximum: a term stuck near 0 is teaching nothing. Measure rates per step as well as averages. Test zero actions to split a bad policy from an unstable model. Pair an exponential tracking reward with a term that has a gradient far from the target. Measure before believing a diagnosis |
| Fixing a walk's twist with a new penalty scored well: straight, 100 % up. It had pressed both hip yaws on their stops at full stall torque, all the time, as the stops are perfectly stiff in sim. A real servo would burn. Only the per-joint torque table showed it | A new penalty moves the exploit: after each reward change, read every joint's position, torque and speed, not just tracking. Penalise holding near stall and resting on stops from the start |
| Stand-up scored 100 % in 0.2 s. The test's reset put the robot in the air and overlapping nothing it would really lie on, so it swung its legs under itself mid-fall. Settled on the floor first it still scored 98-100 %, but the replay through the real parts showed feet through feet (9.5 cm3) and hips through the trunk (7 cm3): the sim had no self-collision | A result that looks too good gets its start state and its motion checked before it is reported. Skills start from rest, servos holding until the robot lies still, in training and in the test. Train floor skills with self-collision on, measure the height each reset pose clears the floor, and replay the winner through the real solids |
| A test labelled servo stall by joint order, while torques come in actuator order: every at-stall figure named the wrong joint | Index by the names of the array being read; never assume two lists of the same joints share an order |
| Four GPU trainings ran beside six CPU searches of 14 workers each, on a 32-thread machine: the display driver reset (nvlddmkm 153) and every run died with an unknown CUDA error, after an hour's work and with most progress unsaved. The shell's exit code 0 hid it, as the last command in the line was a grep | Count workers against the machine before starting another job, and add load one job at a time, reading iteration speed. An all-at-once exit means check the system log first. End a run's command with its own exit status, not a log filter's |
| Static torque numbers ignored momentum, and the user asked whether a leg-driven throw could carry a roll. A scripted keyframe search answered in minutes what a training run takes hours to hint at | To tell a weak robot from a weak policy, search a simple open-loop motion under the real servo limits and step the strength up: it gives a threshold. It can show a move is possible, never that it is impossible |
| Compared the neck with microduck's using the XL330's 5 V datasheet stall (0.52 N m). Microduck's own trainer models its XL330s on a 2S pack, 6.5-8.2 V, at 0.96 N m: its neck margin was about double what was reported, past the maker's 6 V limit | A reference robot's own files say how it runs its parts: read its actuator config before quoting a datasheet for it. Note where it runs a part outside the maker's ratings, as that is a choice with a cost |
| With several versions of a design in one repo, a motion from one was replayed against the default version's parts, and reported false collisions | Anything recorded from one version should be checked against that version: set the version explicitly for every tool, and save it with the recording when that can be done |
| The stall penalty went into the walk only, so the next skill trained found the same exploit on a different joint: its neck pressed on a stop at stall over 90 % of the time, and the success figure looked fine | A protection found in one task belongs in every task on that robot, from the start. Test checkpoints early and read each joint's load, not just the success rate |
| A tool that fits a robot to a height hit the number, with the design failing its proportion and ankle checks, as it stretched only the legs and body. Its table still showed the right height | Report what a generator reached and what broke as one result, and test it at several sizes before calling it general. A scale factor isn't a design |
| Scaling a design past its build method: the first picture of a 1.8 m robot had a one-piece 0.85 m hood no printer could make, until the user said so. A check that every part can be made didn't exist | Check how each part gets made, not only that it fits: a part's size against the machine that makes it is a check, proven on a broken design. Split it, or change the material |
| Told the user a design would have bolts and bearings 'as the earlier robot', from memory. That robot's spec had none: its actuators were plain cylinders | Read the earlier work before citing it as the standard, and say which details it actually has |
| Chose roller chain for a large robot's knee from a neat calculation, without looking for anyone who had used it at that size. The user asked; a search found chain only on small robots | Before picking a mechanism, look for proven examples at that size and load. If none turn up, say so when proposing it |
| Notes were written only when the user asked | Add the lesson in the same step as the fix, in this repo and in any parent method repo, without being asked |
| Scratchy white lines across the hood underside in a video, on every servo recipe. The hood and the bill were cut at one height, so their faces shared a plane and the renderer picked either, triangle by triangle. No check looks at this, and earlier views never showed the underside | Coincident faces show as lines or hatching that crawl with the camera: test by rendering with shadows off (no change means not shadows), then search for faces of two parts in one plane. Leave a real gap or step between parts, and look at a model from below, not only from the usual views |
| Started a long training on a design the user had already asked to change. The chain-or-crank choice was left as an open question and the spec still had the chain; the user had to ask | Before a long run, list the open design choices and say which one the run assumes, in the same message that starts it |
| Proposed phased cranks without working them out. Two cranks phased to pass each other's dead centre must rotate fully, which needs 1:1, too weak for that knee. A crank that only rocks has its weakest ratio mid stroke and gains leverage toward the ends, so it never needed phasing | Calculate a mechanism before offering it as an option. First measure the range the motion really uses: the walk needed 73 deg, not the 143 the chain had been given |
| Scaled a small robot's training recipe to a robot 7 times the height, every number correct by the physics, and it learned to stand: 0.001 m/s told 0.4, with survival looking perfect. Its first air-time reward needed a foot up for 0.33 s, which never happens by chance, and standing already scored most of the tracking reward | Correct scaling doesn't keep a reward discoverable. Compare a new robot's reward terms at iteration 250-750 with a robot that learned: a term at zero means no path to it. Episode length alone says nothing: test speed too, early |
| Guessed that weak ankles or missing ankle roll stopped a big robot stepping, when the numbers could be read. The user pointed it out. Measured: the same robot stepped once given a clock, no ankle roll was no worse than on the small robot that walks, and the real limits were the ankle and the crank knee, not what stopped it stepping | Before naming a possible cause, measure it: joint torque, speed and range against limits, on the failing robot and on one that works, with one script. A pose left free in that script gave 320 N m where a constrained one gave 221: pin every free variable, and check against a known number |
| Called a big robot 9 times weaker at the ankle after comparing it with one small robot that happens to be over-strong, and normalised by total height on a robot that is mostly head and neck. Against real humanoids, by weight x leg length, the same ankle is above Unitree's | Compare with the robots of the same class, read from their own models, and normalise by the length that carries the load |
| Read joint torque and speed tables for a new robot and not joint angles. Its walk sat on the knee stop 83-92 % of the time, pressing past it, for three runs. It explained why less mass didn't lower the knee torque. Sized the crank's window from a smaller robot's walk, which used a different part of the range | Test time at each limit, in stance and in swing, from the first checkpoint that moves: a torque that won't drop with load is a joint pressing on something. Size a limited-range mechanism from the robot's own motion, and put a stop penalty on every joint from the start |
| Let a knee run 38 % over its rated torque, because the recipe only penalised near-stall, from 70 % of peak. With 3:1 peak to rated, a joint can sit at twice its rating and pay nothing. On small servos the rating had been treated as rarely reachable | Penalise sustained load above the rated torque, over a few seconds, on any robot whose joints have a continuous rating. Compare RMS with rated at every checkpoint |
| Pushed a regenerated trainer patch before testing it. It had picked up generated meshes and did not apply, and the test straight after caught it | Test a patch on a clean checkout of its base before pushing it. Take its file list from the last good one, and read what is new |

## The first Fusion build (milli, 2026-11-03)

The spec passed every check, 950 of them, with 0 failing. Building it for real, and reading each part against the real thing, found all of this. Each row now has a check, proved on a broken design.

| Issue | Do instead |
|---|---|
| The STS3215's cable sockets are in its rear face, where a plate sat on them on 5 of 10 servos: hips, knees, ankles. No cable could be plugged in. The spec had a "cable window" in the end wall, on no evidence, and the guide said to plug them in first | Look at every side of a bought part's real mesh before designing round it: depth views from 6 directions take a minute. Model what plugs into it as a solid (`cable plugs`), with its wires' room. Then the checks test it like any part |
| The beak servo drove nothing: no horn, crank or rod. "Open" in the README, and the joint still passed every check, as a joint with a servo looks driven | A DRIVE check: each servo has a horn on its child, or a linkage. A linkage moves on its own, so solve it through its range and sweep it (`tools/beak_linkage.py`): it isn't one link's solid |
| The hood hung on 2 hinge screws on one axis, so it could tip about them. HELD passed: each screw clamped something | HOLD: every printed part has screws not all on one axis, or is named as glued or as a pivot |
| A printed bar ran through the Pi's circuit board; a battery strap through the battery. Checks skip parts of one link, as they were written to find moving parts hitting each other | APART: bought parts against everything on their link. Read a check's skip list as a list of what it can't find |
| Every interior screw drilled a hole through the shell above it: the body shell, the thigh covers and the hood were perforated, in the exported STLs too. A shell was tested as solid, so a screw inside it was "in" it. That also counted air as thread | A shell is its wall, wherever a point is tested. SKIN: a cover's holes are its own screws' only. Only the first CAD picture showed it: nobody had looked at the exported shapes |
| Printed parts were drawn overlapping so that "one solid" passed: a sole 1 mm into its shoe, an eye ring through its face, lids in their trays' end walls | A drawing convention is a promise someone has to keep. Fusion's interference check found 143 clashes. Decide who gives way (`rank` in `tools/export_prints.py`), cut the pocket, and check the exported parts against each other (MATE) |
| Pockets were drawn at the bought part's exact size, in a process that prints bores small | 0.3 mm over a servo, 0.1 mm over a bearing seat, 0.1 mm under a printed peg, as export parameters. A real print still decides |
| Screw heads stood inside the next servo: the head yaw horn's under the roll servo, the roll's rear horn's under the beak servo. Screws were checked for reach and bite, not for the room their heads take | HEADS: each fitted head against every servo and board. Sink them into the plate where something sits against it |
| The jaw had no holes for its own hinge: the hole code only looked in the screw's own link, and a pivot crosses two | A pivot's screw cuts the parts of both links |
| A corner of a box cut through a curved cover: a 30 mm slit along the top of each thigh. Volume checks can't see that, nor can a report | Look at the CAD from every side, including the top and underneath, and go after every odd line |
| The Fusion build module had never run on this robot: no servo shape, the old robot's name, one solid per primitive so nothing could be printed from it. It was listed as available | Run an inherited tool before planning on it. And a CAD model isn't print-ready because it looks right: one body per printed part, hollow, with its holes and pockets, compared with what exports |
| 1,800 timeline features made Fusion crawl on echo | Build with no timeline (Direct), then turn it on for the joints: 17 timeline items, the whole robot in 5 minutes. With no timeline, `features.add()` returns None, so nothing can be named from it. Joints refuse a Direct design |
| Volume comparisons said a shell was right while its wall was in the wrong place: more volume and fewer points inside | Compare CAD and export point by point (`tools/verify_fusion.py`). Then give a smooth loft more sections: through few it bows away from the offline shape |
| The BOM was checked once, at writing. A day later the U2D2, XC330, XL330 were all sold out at the maker's US shop, and the page said the XL330's horn isn't included: 5 horns were missing from the parts list | Re-read each shop's page when you build the list for real: stock, and "what's in the box". Amazon's pages refuse AI agents: don't work round that; say which entries you couldn't re-read |
| A battery chosen by size came on a small JST plug, for 10 servos that can pull 27 A between them | Check connectors against current too, not only the pack against the slot |
| A $12 board was fine for its size until its page said 9-12.6 V input. A "servo hat with both buses" in the notes was no real product | Name a real part, with a link, before writing its box. A placeholder hides an open design question |
| Head roll past 0.2 rad with head yaw past 0.5 rad puts the head into the yaw servo. Single-joint sweeps can't see it, and no pose used it | Sweep pairs of joints in a chain where parts pass close, and write the limit down for what commands them |
| Assumed the repo's Fusion MCP had to be built, and wrote a 500-line bridge. It was a checkbox in Fusion's preferences. The skill said "an MCP server", no more; the user had it open | Before building something, look for the product's own feature. A doc that assumes a setup should name it |
| Left six unsaved builds of one robot open in Fusion, as each rebuild opened a new document; the user pointed out that this is what makes Fusion crawl | Save each finished model into the hub, then close it, before starting the next, and close every scratch document as you go. One document open at a time |
| Straight after a first save, a STEP export wrote 600 bytes with no solids and reported success. Opened afresh from the hub, the same call wrote all 315 | Check an export's contents, not its success: count the solids in it |

## The second variant: all Dynamixel (2026-11-04)

The same process on a second servo. The first round's fixes carried over and its checks found this one's problems, at the first run. What was new:

| Issue | Do instead |
|---|---|
| The XL330's datasheet 26 mm includes its 3 mm horn. The spec drew a 26 mm case with a horn on top, so all 5 of the hybrid's XL/XC joints were 3 mm off, in a model pushed an hour earlier. No mesh we had showed it: Microduck's is simplified, and an older variant's "shorter case" was the same servo's true size | Get the maker's own CAD before designing round a part, not a robot's simplified copy. It was in the user's own Fusion hub all along: ask, and look there first. A note that two near-identical parts differ by an odd amount is a question, not a fact |
| Sockets again: the same 3-pin sockets are in a different place on this servo, on the rear face in notches at its edges. The first round's lesson, "look at every side", was right; assuming the last servo's layout would have been wrong | A connector check per servo model, from its own CAD |
| Fixes from round one held hybrid's numbers: board positions, tab positions, a battery slot. On a smaller body one crossed itself into a negative-size box, and sampling points inside it hung the checks for half an hour with no message | Put a variant's choices in its recipe, and fail on a box with a negative size. A check that hangs is a failure: run long jobs with a timeout and read how far they got |
| Every variant's reports, prints and part lists wrote over the first one's: reports/mass.md and reports/checks.md read wrong for a while | One set of outputs per variant before running a second one (`G.out_path`) |
| Grooves for wires in a small thigh cover came right through its 2 mm wall, and its servo corners came through too. The picture showed it, again | A cover drawn in proportion is too small once its servos are not to scale: size it from what's inside. Send wires where there is room (out the back) |
| Fusion had a sibling document left open with a saved copy: a failed script left behind whatever it opened | `try`/close around anything a script opens. Check `documents` at the start and the end |
| The motors at hand decide what can be built this week, and that isn't the count the design needs: 4 M288s from a Koch pair, against 15 | Ask what's on the shelf before planning a build around it |

## Real parts in the model (2026-11-04)

The user looked at the picture and asked what held a servo on one side. Each of these passed every check.

- **A horn drawn tall enough to reach its plate passed THREAD and FIT for two builds.** The real horn stopped 2.5 mm short, and the 4 screws spanned air. A stand-in must be drawn at the real part's size, even when that makes something else look broken: that is the finding. Now a printed boss, and SEAT, proven with `--bad seat`.
- **A servo held at one end of its case.** Each screw had a reason and no check counts ends. ENDS names the joints that are one-ended and why, `--bad ends`.
- **Put the maker's CAD in the model, not boxes.** The first interference run against real parts found round pocket corners on a square case (no servo would have seated), raised bands on the STS3215's faces under lids and frames, and a rear horn in the STEP file that the servo doesn't come with. Read what a STEP file includes before trusting it. A maker's model overlaps itself: filter that out of the report.
- **Instances of one component in nested occurrences composed their transforms** and landed in the wrong place: copy the bodies instead.
- **A low-rank part can lose a wall it needs.** The rule "a lid gives way to a shell" cut a slot through a bearing seat's wall, the race showing through, with the cover hidden nothing looked wrong in the checks. Who gives way depends on what the part does.
- **A printed spacer can't be part of something that drops into place.** The boss on the head frame stood in a bearing's bore. PATH caught it: make it loose.

**Fillets, and how a look went unchecked:**

- A fillet that "worked" was deleted every time: Direct mode returns a feature whose health reads as a failure. 3,235 sharp edges of 3 mm or more, across two builds and every check. Nothing measured it, so nothing could fail. `build.look_check()` counts them now.
- **Round the finished part, not its pieces.** Each box rounded by itself left a V-groove at every join: a notch to crack from, in the prints too, that looked like many small pieces.
- **Order: join, round, then cut pockets and holes.** What a servo or a bearing fits against stays crisp. Round outside edges and straight inside corners; a round inside corner is a boss on a plate, where a race sits.
- **Reject a fillet that loses over 3 %.** Fusion called it a success when an inner ear went from 2.4 cm3 to nothing. `verify` found it, not the fillet.
- **Size the radius to the part, against the reference.** 1 mm on a 60 mm cover is invisible. A shell's rim needs its inside curved too, by the radius less the wall.
- **If the look is in Fusion, the prints must come from Fusion** (`tools/prints_from_fusion.py`), or the model isn't what gets printed.

**Weight and parts:** 190 screws were a PLA disc each, in a flat 6 % allowance that also double-counted the bearings: every screw has its steel mass now, and the allowance is cables only. Count printed parts and screws per joint in the design review: a beam estimate says nothing about how many pieces it takes. Beam estimates also have no corners in them: a sharp inside corner multiplies the stress 2-3 x.

**Read the maker's drawing before asking the user to measure:** Waveshare's page had every hole and connector.

**The user's review of that build, each from a close-up, each past every check:**

- A hole 0.4 mm from a plate's edge, on a near-end screw added that day: new parts get the old checks only. EDGE measures the plastic round every clearance hole now; a fix isn't finished until something looks at what it added.
- A 0.2 cm3 lid strip beside its own bracket read as a mistake, and wasn't needed: the rear idler already held that end. Ask of each small part whether it does anything.
- A horn's centre screw under solid plastic: 4 screws out to reach 1. No check saw it, as the screw that comes with a servo wasn't a screw in the spec, and ACCESS only asks whether a screw can be reached while it's being fitted. Reaching it later is a different question.
- A hinge tab 5 mm off the hood, with a hub on it: a clearance number (GAP, for things that move against each other) used where 1 mm would do. Measure the reference's: its tab runs on from the jaw's skin.
- A reference's parts list is in its model: open it first. Microduck's shows a two-part body, left and right, a speaker at the back of the head and a battery hanging behind the body, all there all along.

**The jaw, from the same review:**

- **We wrote down that a design was the reference's without opening its model.** A crank and rod were "as microduck's" for weeks, in these notes and in what I told the user. Its model has neither: its beak servo's shaft is on the jaw's hinge, and the tab screws to the horn. The user asked why the servo sat so far back. Check a claim like that against the file before repeating it.
- **Two servos in the wrong places looked fine in every check:** ask of each joint why its servo is where it is. Ours was there from an early layout decision that no one looked at again. Fixing it took out a crank, a rod, a lever, a lid, a tray wall and their screws.
- **A clearance swept wider than the real motion** made a big triangular recess. Sweep the range a joint has, the way it goes.
- **A hole in the hood** came from a small tray wall above the servo, not the servo I first blamed: the shell gives way to what's inside it. PIERCE checks that now, proven on that wall. Measure before fixing: I'd moved the hinge for the wrong reason first.
- **A check that passed on the broken design wasn't checking:** the first PIERCE passed on it too, and only trying it on the real fault showed that.

- **A fit check can pass because the part fits itself.** The ankle bearing's outer race was listed in the printed inner ear, so the ear exported with a 12.5 mm hole for a 15 mm bearing, and every check passed. It turned up only when a colour audit found a steel-grey solid in a printed part. BOUGHT in `tools/assembly.py` now fails any steel solid listed in a printed part. Measure the exported STL's holes against the real part, not the model against itself.
- **One printed part, one colour, unless the docs say how.** The head frame was one STL in two colours, and only the hood's two colours were in the print notes. The user spotted it in a video and chose all orange. COLOUR in `tools/assembly.py` now fails a part with two colours and no print note.

- **A hang blamed on the wrong thing cost 5 hours (2026-11-05).** Fusion froze on the big duck's assembly, its size was blamed, and everything waited for a restart. Then it froze on the hybrid at the same step. Fusion's log showed `close_all` retrying one close forever: an untested loop of mine. The fix is in `cad/fusion/linked_build.py`. Read the tool's log first, and suspect your latest change.

## The big duck's real actuators (2026-11-05)

- **A linkage that never moves can't fail.** The knee's rods sat in the model as 'decal', drawn at knee 0, for 2 builds. Given their real motion, the four-bar couldn't reach its own range below -0.74: it had been swept for an older hip height. Move every mechanism through its range offline, and test the test: flip an angle and see it fail.
- **A test that can't fail is worse than none.** A posed clash check in Fusion read 0 clashes at 5 knee angles, and looked like the proof. With the rod's angle flipped it still read 0. API-set joints moved occurrences' boxes after `computeAll`, but not `analyzeInterference` or saved pictures. So "all joints moved to 98 %" only ever meant the numbers read back. Run a negative case before believing a pass.
- **Read the maker's file, then doubt the manual.** The RS04's output holes are 3.5 deep in its STEP, 6.5 in its manual, and 6.5 is the file's floor to pin tip. The RS03's rear has 4 free screw sites, not 8: RobStride's own cap screws fill the rest, and only a clash found it. Neither shows in a figure.
- **A stand-in hides what's load-bearing.** A plain cylinder gave every plate a flat rear face to lie on, and the hip yaw's bearing a case to sit on. Neither exists in the real part's terms: one needed a shoulder, the other a housing that keeps the leg's moment off the actuator.
- **Draw screws at their core, not their head.** A shank at core diameter lies in a tap hole and clashes if it's long, misplaced or meets something: that found 12 of the first build's flaws. Heads alone hid them all.
- **Mirrored legs and real parts.** A real actuator can't be mirrored. Choose its clock so its hole patterns are symmetric about the mirror plane, then the mirrored spec and a part turned 180 deg agree.
- **Look at the file's splits.** The first boolean to cut the rotor failed on faces nearly coincident with the cutter (ASM_INCONS_FACE). Move the cutter's faces into air: every other try worked.
- **A long comment can go stale in the same file.** `ZP`'s said 0.634 for a value of 0.674. Print it.

## Small fixes: STEP, videos, plugs (2026-11-05)

- **A script that names its duck exports the wrong one.** `export_step.py` said `RECIPE = 'hybrid'`: run for another duck by hand it would rewrite the hybrid's STEP. Every Fusion script takes `--recipe` through `fusion_call.py`; `pipeline.sh step` runs it in a turn of its own and counts the STEP's solids (`MANIFOLD_SOLID_BREP`), as a file can be written with none.
- **Empty frames come from moves that run past the picture, and from a camera aimed at an offset.** The build film set finished work aside by easing it all the way to a parking spot 1-1.5 m off while the camera stayed on the mat, and brought parked work back the same way with the camera chasing it: half a second to 1.5 s of empty bench at each section's end, about 10 s in all. A new section's first part was framed on `target`, an offset, not a point, so the neck column and the head fork started out of frame. Move work only to the picture's edge (`off_edge`), and aim at where the part will be. Measure it: the share of each frame that isn't bench, in runs.
- **A 'decal' that is a real thing isn't built in Fusion.** `build.link` skips decals with no screw, as pictures; the battery's XT30 and balance plugs were decals, to keep them out of the offline sweeps, so Fusion's body shell had an empty port with the pack's blue behind it. The spec marks them `in_cad`; `build.drawn_only` builds them. Then Fusion's clash list found the plugs 0.2 mm into the shell's inner corner past the port cut: the cut now starts 0.4 mm lower. Moving the plugs off the pack instead failed `trunk covers mounted` (3 pieces): offline, that 0.2 mm is what holds them, so the pack/plug overlap is in `OK_CLASH`.

## The big duck's frame joints (2026-11-05)

- **A 0.5 mm overlap is a joint nobody designed.** The checks read touching parts as one piece only if they overlapped, so every frame joint was drawn 0.5 mm deep and none had a screw. Manifold's union merges parts that only share a face, so exact faces keep `connect` passing, and a separate check (`tools/big_assembly.py` JOINED) asks what holds each touching pair.
- **Let each screw say what it joins.** `bolt()` records `clamp` and `tap` (or `tap_hub`, an actuator's own thread) on the screw. Then one tool can test contact, thread engagement, edge distance, the screw's way in and its key's reach, without a hand-kept list of parts per joint.
- **Check the order, not only the finished robot.** The first run found an inner retainer that could only go in after the stator that hid its screws, a yaw housing's outer screws 11 mm off the deck's edge (true since the first build), housing screws under the neck tie's heads and the computer's box, two pairs of screws meeting head to head across a 24 mm thigh, and cleat screws under the ankle stator. The static checks and Fusion's clash list had shown none of them.
- **Two engagements that need opposite motions can't both be fixed parts.** The hip roll's back stator must move toward the yoke onto its pins while its rear step goes the other way into its cheek: so the cheek is bolted to the beam last, through a cleat, after the stator and cheek go on together.
- **A path check backs a screw out only until its tip leaves its hole.** Further, and a 16 mm screw in a 24 mm gap reads as blocked when it isn't.
- **Mirror every name a part carries.** The trunk's right yaw bearing was mirrored by hand, outside `build()`, and kept the left's `unit` name: the checker joined the left bearing to the right housing.

## The big duck's videos and training hand-off (2026-11-05)

- **Render a big robot offline.** Its films come from the spec's shapes in MuJoCo (`tools/render_big_video.py`), so they need no Fusion turn and no third-party CAD. The cost: the actuators are outlines, not the maker's models.
- **Frame by the robot, per angle.** One zoom for a 1.8 m robot's whole turn left it filling half the picture; close-ups at a part's own size filled the picture with a plate. Fit each angle to every part's points, and stand back to about 3 times a part's size.
- **Fusion and renders share one machine's memory.** A render beside a Fusion build on 16 GB paged Fusion for 2 hours, and Fusion didn't recover when the render ended: it had grown to 15.7 GB over 14 hours. Restart it between long runs.
- **What another machine needs must be in the repo, or fetchable.** The big duck's trainer models were never kept: `tools/big_trainer.py` now makes them and the `trainer.json` that registers its tasks, and `docs/big/REPRODUCE.md` says where each outside file comes from.
- **Two motors on one joint is published practice, with one controller.** A joint controller gives one torque, split between them in torque mode, with a small opposing bias against backlash (Robertz et al., ICRA 2010). The knee's two separate rods are the weak part: see `docs/big/PAIRED_ACTUATORS.md`.

## The hobby-servo duck (2026-11-06)

| Issue | Do instead |
|---|---|
| A hobby servo has no screw holes in its faces and no rear shaft: every cradle in the spec screwed into a case's faces, and every fork onto a rear horn | A third mount, `flange_cradle`: a tray with a rim under each pair of ears, the lid's foot down onto the far ears, the screws through the ears into the rims; the fork's far side on a printed hub through its plate, in a bearing in the tray's floor (`rear_hub`). A pin printed on the fork's plate couldn't pass the bearing as the servo slides in between the plates |
| The ears reach 7 mm past each end of the case: the formulas that placed the knee, the hips' spacer, the neck wall and the ankle's cap from the case's length put parts in the ears | `NEAR` and `FAR` in spec/robot.py: a servo's reach from its shaft, its ears' if it has them. Side walls out to the ears' ends swept 2 mm wider than a post under the near rim, no wider than the case: the neck's fold forward needed that 2 mm |
| The neck's layout used the head's servo's size (`XLW`, `XLL`): true until a recipe had a standard-size neck and micro head servos | `NKL`, `NKW`, `NKH`, `NKX`: the neck's own servo |
| Two standard-size servos end to end, their far ears facing, make a 77 mm neck: the duck stands 37 cm, past the 30-35 asked | Said, not hidden: `target_tol` 0.15, as the all-Feetech duck's. A shorter neck needs the two servos side by side, or a smaller head pitch servo than its torque allows |
| `0.0165 * Q` rewritten as `NECK_MD + 0.0005`: right on the hybrid (Q = 1), 0.1 mm off on the all-Feetech duck | Regenerate every recipe after a shared edit and diff its links against HEAD: only the catalogue may change |
| Absolute coordinates copied from another recipe (the charge port, the hood's rear screws) sat in air once the body rose 20 mm | Derive them from the plate or the head (`port_up`, `hood_rear_x`), or the checks find the plugs and screws one by one |
| PWM servos can't be chained, and the user wanted the Pi, its board, the BECs and the IMU in the body | A star of leads from a PCA9685 bonnet on the Pi; each lead's length measured along its chain with a 30 mm loop a joint, its mass counted on the links it lies on (`leads`); a 6 V / GND bus a side, so no leg's stall current goes through the board's copper |
| A neck column as wide as the body: the shell, lowered last, passed through the head pitch servo | The shell before the neck column on this duck, and the battery's plugs, on their leads, pulled out through the port after it |

## The nano duck: SG90s, PWM (2026-11-06)

| Issue | Do instead |
|---|---|
| Asked for 12-15 cm on SG90s with 5-joint legs, the duck came to 20.6 cm at its smallest. Each joint's U must pass 13 mm from its axis (the ear's tip is 12.2), the sole under the ankle so, the ankle case stands 22 mm above the ankle, and the hip yaw's 31.5 mm stacks over the roll | Find the smallest size the servo's module allows, from the spec, before sizing by torque. Fewer joints (no hip yaw), no rear bushings or a smaller servo are what would go smaller |
| The torque rule alone (the largest under 50 % of stall) pointed at about 27 cm: the hip roll's lever is the legs' spacing, which height doesn't change | Read what the rule is for. A palm-sized duck is the smallest that keeps the margins; show the user where the rule alone would put it |
| The body's heights were absolute numbers, so a stretched duck's legs grew under a body that stayed put, and the sweep's heights barely moved | Write every height relative to what carries it (here the yaw servo's hub) |
| Boxes that only touch read as separate pieces to the connectivity check: a servo on its floor, a gear tower on its case | Seat them 0.05-0.3 mm into each other; tools/export_prints.py cuts the real pocket with its clearance |
| A bracket through the body shell's wall: no way to lower the shell onto it (tools/assembly.py PATH) | Route the bracket under the shell's open rim |
| The head can't slide sideways onto its spline with a hood round the neck plate | Fit the hood after the head is on its servo |
| A yaw horn screw's head sat 0.15 mm into the roll servo under it: only printable.py's HEADS saw it | Leave a screw head's height and a clearance under every hub |
| A closed box shell exports as a sealed void; a 1.2 mm lip and 1.2 mm walls read as thin to buildable.py's 0.25 mm voxels | Hollow a block from one open side; 1.5 mm for anything that must pass WALL |
| render_pose's segmentation pass read an id past the scene's geoms on the nano duck (330 geoms), and stopped compare.py | Fall back to the depth buffer for the background when segmentation fails |
