meetsitaram/duck-droids/docs/images/fusion/dynamixel/fix_ankle.png

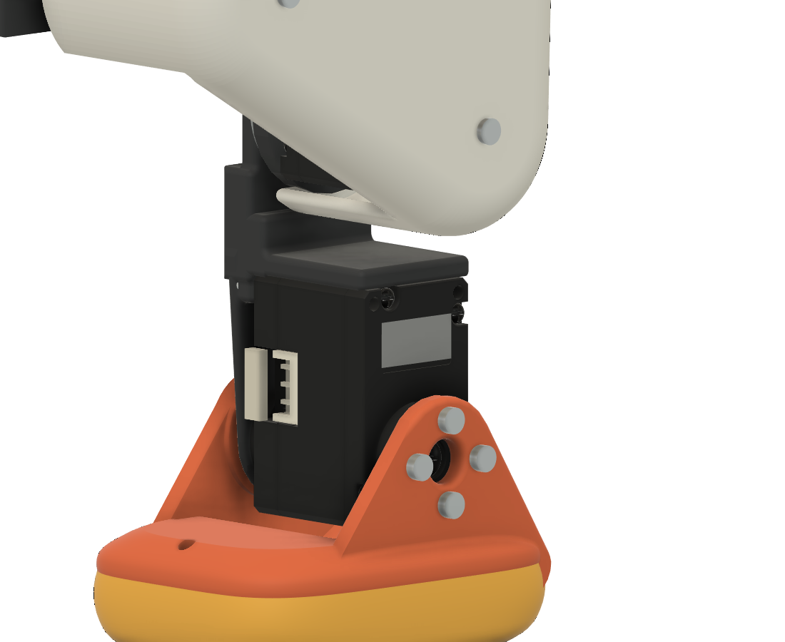
docs/images/fusion/dynamixel/fix_ankle.png
