meetsitaram/duck-droids/docs/images/fusion/dynamixel/fix_beak_drive.png

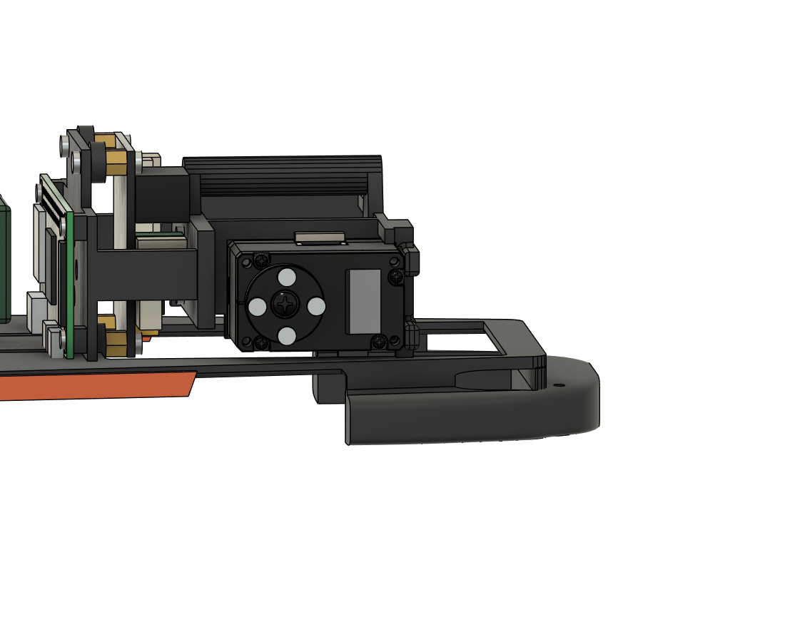
docs/images/fusion/dynamixel/fix_beak_drive.png
