meetsitaram/duck-droids/docs/images/fusion/dynamixel/fix_beak_drive_top.png

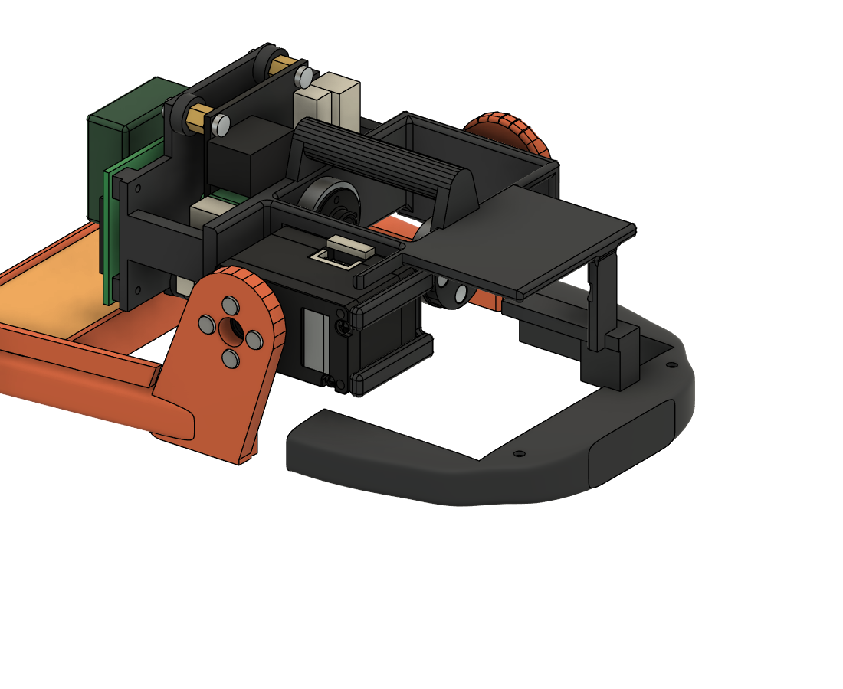
docs/images/fusion/dynamixel/fix_beak_drive_top.png
