meetsitaram/duck-droids/docs/images/fusion/dynamixel/fix_head_base.png

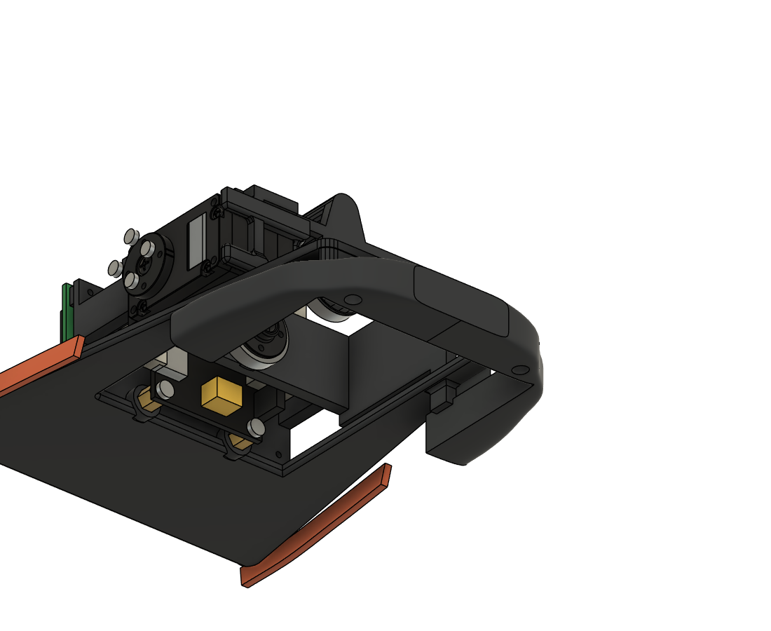
docs/images/fusion/dynamixel/fix_head_base.png
