meetsitaram/duck-droids/docs/images/fusion/dynamixel/fix_head_base_back.png

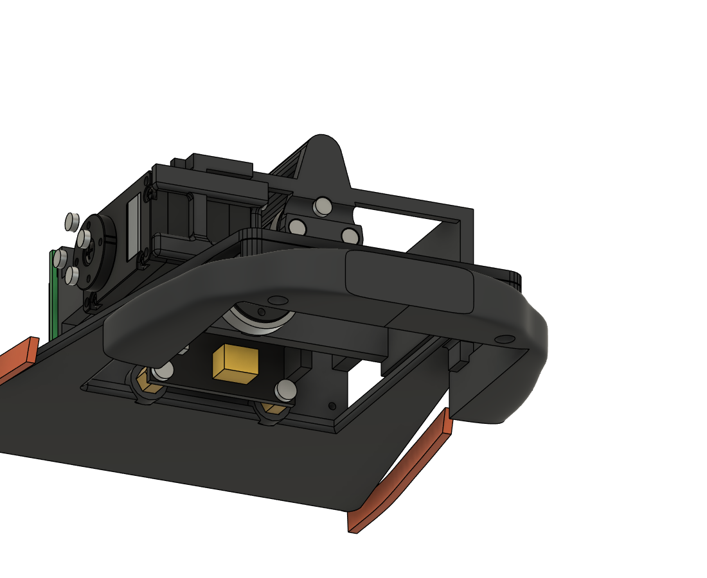
docs/images/fusion/dynamixel/fix_head_base_back.png
