meetsitaram/duck-droids/docs/images/fusion/dynamixel/fix_head_base_side.png

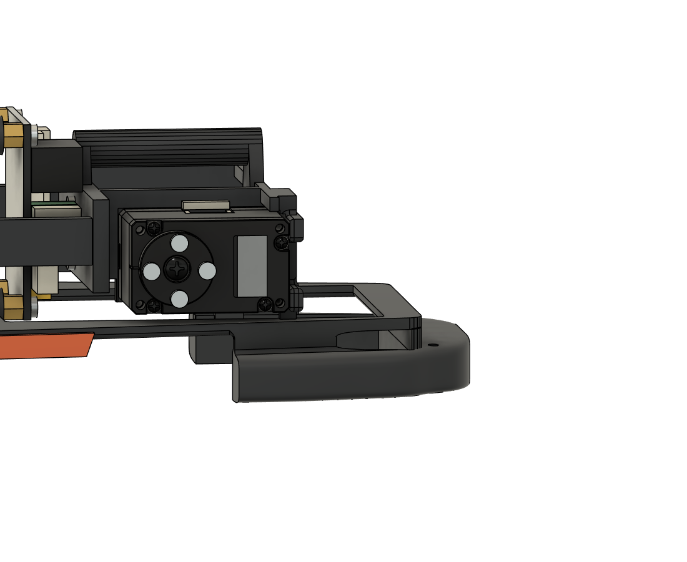
docs/images/fusion/dynamixel/fix_head_base_side.png
