meetsitaram/duck-droids/docs/images/fusion/dynamixel/fix_hip_centre_hole.png

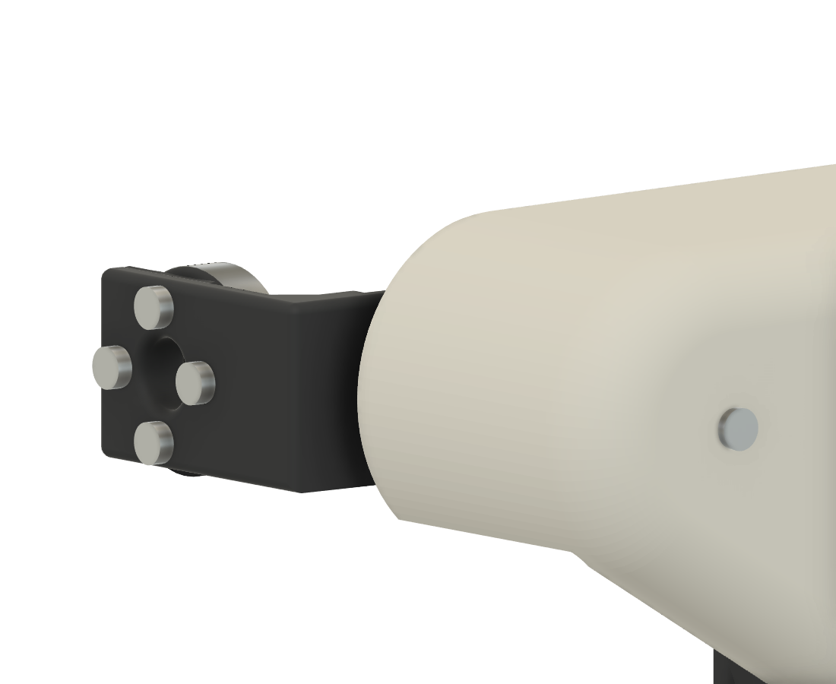
docs/images/fusion/dynamixel/fix_hip_centre_hole.png
