meetsitaram/duck-droids/docs/images/fusion/dynamixel/fix_jaw_back.png

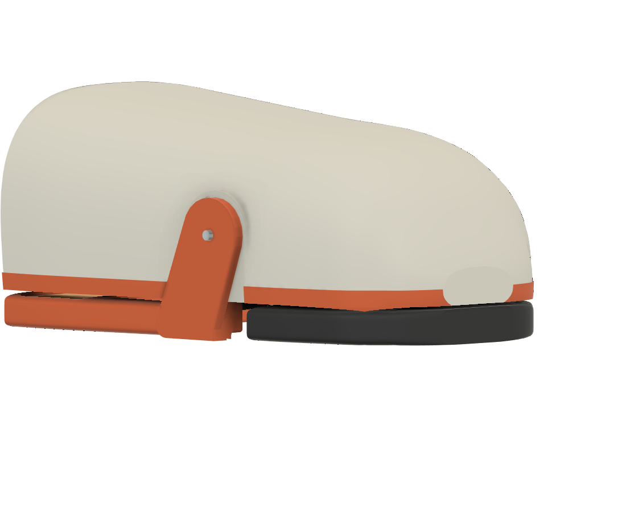
docs/images/fusion/dynamixel/fix_jaw_back.png
