meetsitaram/duck-droids/docs/images/fusion/dynamixel/fix_jaw_foot.png

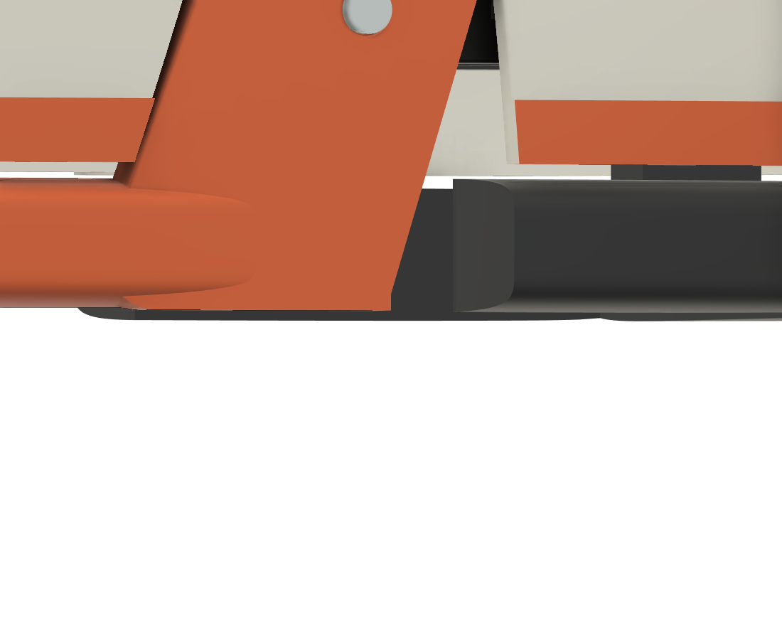
docs/images/fusion/dynamixel/fix_jaw_foot.png
