meetsitaram/duck-droids/docs/images/fusion/dynamixel/fix_jaw_front.png

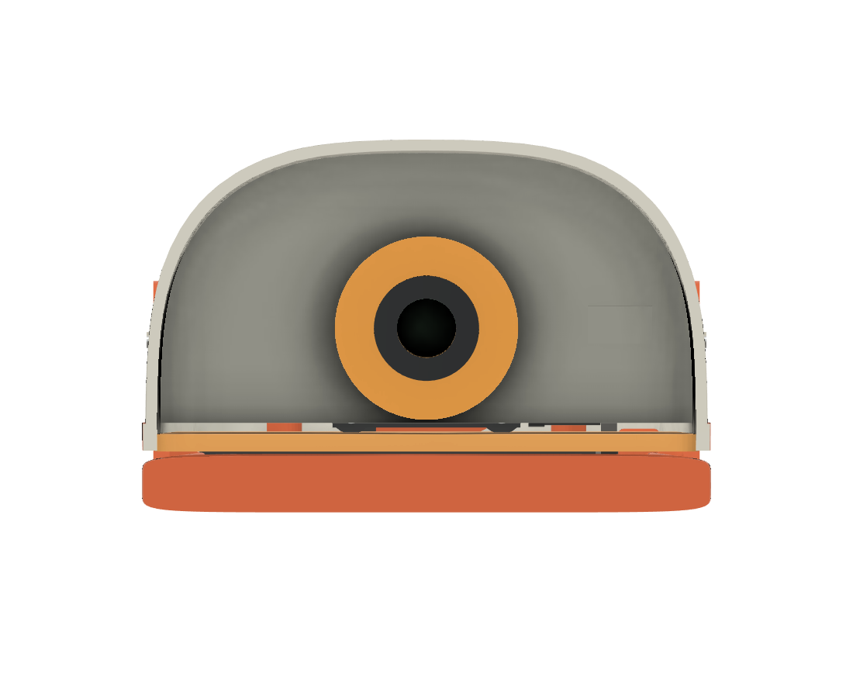
docs/images/fusion/dynamixel/fix_jaw_front.png
