meetsitaram/duck-droids/docs/images/fusion/dynamixel/fix_jaw_step.png

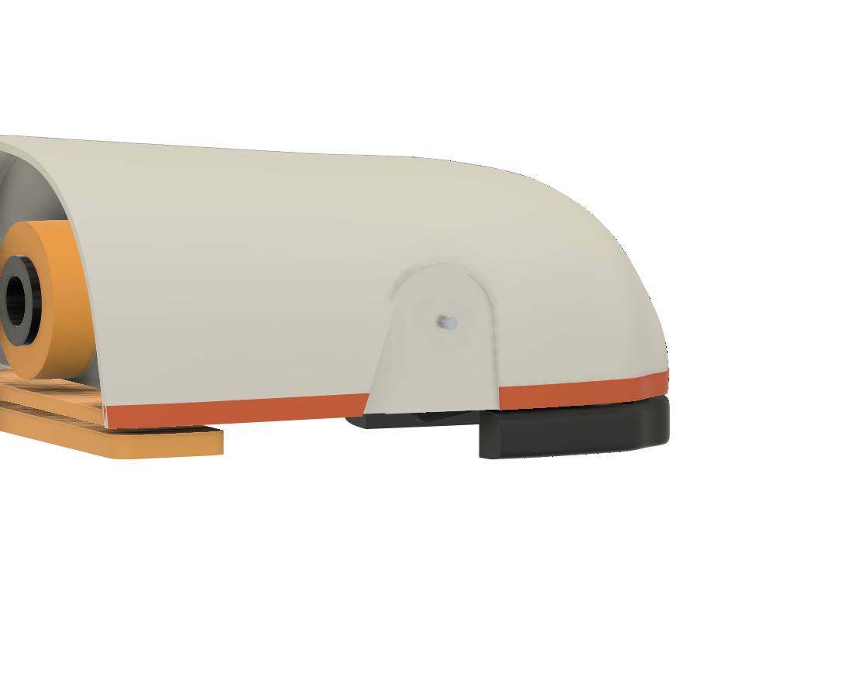
docs/images/fusion/dynamixel/fix_jaw_step.png
