meetsitaram/duck-droids/docs/images/fusion/dynamixel/fix_jaw_tab.png

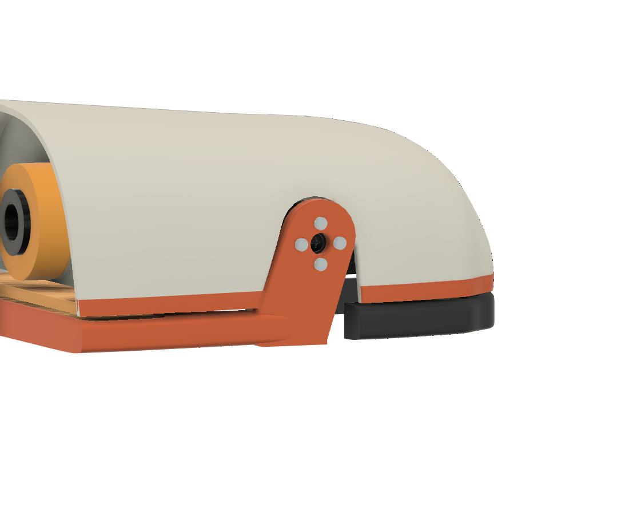
docs/images/fusion/dynamixel/fix_jaw_tab.png
