meetsitaram/duck-droids/docs/images/fusion/dynamixel/fix_jaw_under.png

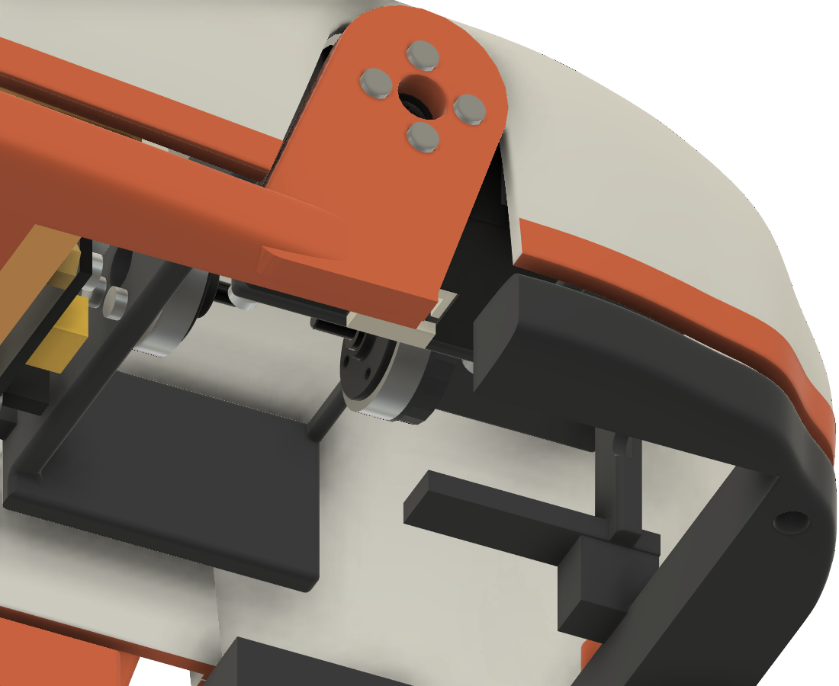
docs/images/fusion/dynamixel/fix_jaw_under.png
