meetsitaram/duck-droids/docs/images/fusion/dynamixel/fix_thigh_inner.png

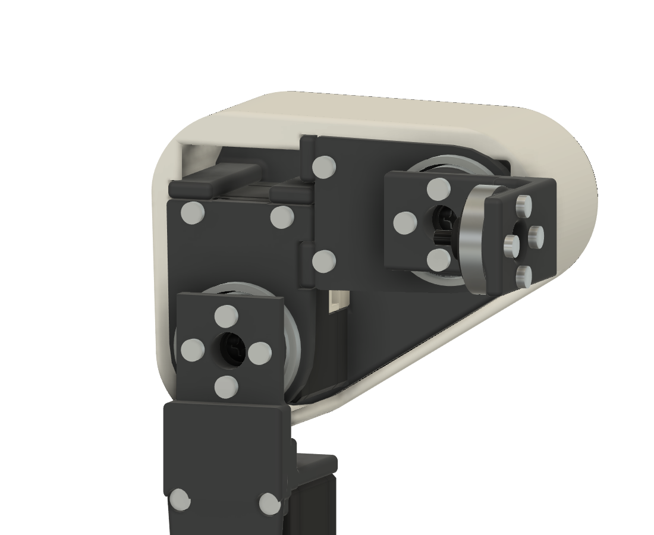
docs/images/fusion/dynamixel/fix_thigh_inner.png
