meetsitaram/duck-droids/tools/beak_linkage.py

"""The beak's drive: solves its four bars over the jaw's whole range, and sweeps the crank and rod against everything they pass.
The spec draws them at the jaw's shut pose only, as one link, so the other checks never see them move.

  python -I tools/beak_linkage.py             the checks; report in reports/beak_linkage.md, exit 1 on any FAIL
  python -I tools/beak_linkage.py --bad CASE  break it on purpose and show the check FAIL (rod hood lock)

  DRIVE   every servo drives its joint: a horn on the child, or for a remote servo, a crank and a rod
  SOLVE   the rod's length closes the loop at every jaw angle, and the crank stays inside the servo's range
  ANGLE   the rod never lies within 30 degrees of the crank or the lever: near that, the servo pushes on a dead centre
  CLEAR   crank and rod, at every jaw angle, clear the rest of the head, and what turns inside it, at every head yaw and roll
"""
import argparse
import math
import os
import sys

import numpy as np

sys.path.insert(0, os.path.dirname(os.path.abspath(__file__)))
import checks as C  # noqa: E402
import geom as G  # noqa: E402

SERVO_RANGE = math.radians(150)
MIN_ANGLE = math.radians(30)
STEPS = 9


def rot_y(p, c, q):
    """p (x, z) turned by q about +y through c: +q takes +z toward +x."""
    x, z = p[0] - c[0], p[1] - c[1]
    return (c[0] + x * math.cos(q) + z * math.sin(q), c[1] - x * math.sin(q) + z * math.cos(q))


def solve(crank_c, r, pin0, jaw_c, jaw_pin0, q):
    """The crank pin's place for jaw angle q: on a circle round the servo's shaft, one rod length from the jaw's pin."""
    L = math.dist(pin0, jaw_pin0)
    jp = rot_y(jaw_pin0, jaw_c, q)
    d = math.dist(crank_c, jp)
    if d > r + L or d < abs(r - L):
        return None, jp
    a = (r * r - L * L + d * d) / (2 * d)
    h = math.sqrt(max(r * r - a * a, 0))
    ex, ez = (jp[0] - crank_c[0]) / d, (jp[1] - crank_c[1]) / d
    m = (crank_c[0] + a * ex, crank_c[1] + a * ez)
    cands = [(m[0] + h * ez, m[1] - h * ex), (m[0] - h * ez, m[1] + h * ex)]
    return min(cands, key=lambda c: math.dist(c, pin0)), jp
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
