meetsitaram/duck-droids/(commit log)

2026-11-03 milli: a microduck look-alike on STS3215 and Dynamixel servos
    The spec, its physical checks and the build order, with the tools forked
    from echo. Horn-side bearings as microduck's, foot switches, a BOM and an
    assembly guide generated from the spec, and the assembly animations.
2026-11-03 A filled mouth, as microduck's: a jaw tray with a soft insert and roof
    The jaw was a hollow ring. The XC330 ankle version of milli, kept here.
2026-11-03 STS3215 ankles, with the shoe reshaped round them
    The longer case takes up the gap under the thigh, 4 mm taller. The shoe is
    52 x 68 mm, with a round cup into the sole for the case's corners. Ankle
    range +-1.3 rad. Geometry only: strength and printing are not checked yet.
2026-11-03 Make the STS3215 version buildable: real servo shape, strength and wall checks
    The checks only proved that parts fit. Models the STS3215's real stepped case,
    redesigns the shin (6 mm rib, gusset, collar round the servo) and thickens the
    hip arm. Joins a tray and the neck mount that hung only from servo cases. Adds
    tools/buildable.py (one piece, walls, a beam estimate of load at 3 g) and
    tools/export_prints.py (STLs with screw holes). Not test printed.
    [L_ankle_lid.stl, L_hip_pitch_lid.stl, L_hip_roll_lid.stl, L_hip_yaw_lid.stl, L_inner_ear.stl, L_knee_lid.stl, L_roll_bracket.stl, L_shin.stl]
2026-11-03 Docs: the two versions, what is printable, what is not proven yet
2026-11-03 A MuJoCo model of milli from the spec, and a stand test
2026-11-03 Retarget walking clips to milli, and a physics replay
    Legs by foot paths and milli's own IK, arms averaged to the head, torso to the
    neck. The replay reports the torque each joint needs with the floor carrying the
    load, and how long the open-loop motion stays up. Clips stay off the repo.
2026-11-03 Lessons: review honesty, sim sanity checks, inherited tools, keeping notes current
2026-11-03 Training setup: milli as a robot for the microduck_rl trainer
2026-11-03 Lessons and training notes: reset height, servo randomization, the pre-run check
2026-11-03 Training: each servo type's own numbers, and what's kept from the recipe and why
2026-11-03 Servo specs from the makers and listings, with sources
    The C044's torque was scaled from the C001 and 2.5 x too low; it has a different
    motor. Retailer figures, unconfirmed by Feetech. The running training predates this.
2026-11-03 BOM: purchase list with links, prices and stock; the salvage plan
    Amazon and ROBOTIS listings read 2026-11-02. Most of the servos can come from dismantling an SO-101 pair and a Koch pair. Also records what checking real parts found: the 5 V supply, board sizes and battery voltage.
2026-11-03 Simulation: how to train, the trainer patch, and the walk in MuJoCo
    docs/TRAINING.md takes a new user from a clean trainer clone to a tested checkpoint. trainer/milli_trainer.patch adds milli to microduck_rl, tested on a clean copy. The README shows the walk so far, which stays up but does not go straight. Links use the repo's new name.
2026-11-03 A short share video's renderer, separate from the repo's videos
    tools/render_share_video.py makes a video under 30 s for posts: the build and mouth marked as animation, a fade to MuJoCo's classic scene, then the trained walk. The video itself stays out of the repo; the README keeps the walk and the assembly as separate videos. The patch gains milli_eval's --straightest.
    [render_assembly.py, render_share_video.py]
2026-11-03 Three servo recipes: all Dynamixel, hybrid, all Feetech
    One spec, picked with MILLI_RECIPE; hybrid stays the default and its geometry
    is unchanged. Each new recipe passes the spec checks, all Feetech on looser
    limits that the spec declares. The README shows all three side by side. The
    trainer patch adds the floor skills, self-collision and the recipes' tasks.
    No simulation results yet, and the assembly check, parts list and CAD still
    cover the hybrid only.
    [check_motion.py, checks.py, geom.py, make_rl_model.py, render_recipes.py, render_share_video.py, robot.py]
2026-11-03 A fourth recipe: the Feetech HD-1910
    The micro's layout on the servo most community builds use, drawn from the
    maker's drawing. Passes the spec checks. Its electrical numbers are a seller's
    sheet, and its motor friction, inertia and gain are estimates. No simulation
    results yet. The floor skills get the walk's stall penalties.
    [make_rl_model.py, render_recipes.py, robot.py]
2026-11-03 A skill for a duck at any size, with its tools
    duck-at-size runs the whole design in rounds: servo choice, checks, pictures,
    review, fast tests, training, and the cheats to look for. tools/new_duck.py
    fits a recipe to a height and sets up the trainer; tools/flip_search.py tests a
    roll in minutes. Not yet proven on a real size.
    [flip_search.py, new_duck.py, robot.py]
2026-11-03 A big duck: 1.8 m on RobStride actuators, with a crank knee and a first walk in simulation
    A full design from its own spec: metal frames, bearings, screws, printed panels under a 256 mm bed, 99.5 kg estimated. Results and what's unproven are in the README. The skill, training notes and lessons carry what scaling up taught.
2026-11-04 Add the generated URDF link meshes
    One STL per link, from tools/make_robot_files.py, committed to carry them
    to another PC. Generated on 2026-11-02, so they predate the 2026-11-03 spec
    changes; rerun the tool to refresh them.
    [L_foot.stl, L_hip_pitch_link.stl, L_hip_roll_link.stl, L_hip_yaw_link.stl, L_knee_link.stl, R_foot.stl, R_hip_pitch_link.stl, R_hip_roll_link.stl]
2026-11-04 The first Fusion model, and what building it found
    The hybrid duck, built in Fusion from the spec: one body per printed part with
    its holes and pockets, 15 joints, in cad/ and saved in the hub. Each part matches
    its STL point by point. Nothing has been printed.
    Building it found what 950 passing checks had not:
    - cable sockets on the STS3215's rear face, under plates on 5 of its 10 servos
    - a beak servo driving nothing: now a crank and a rod, solved over the range
    - a hood free to tip on 2 hinge screws on one axis
    - covers drilled through by every screw under them, in the STLs too
    - printed parts drawn inside each other, a bar through the Pi, screw heads in servos
    - no holes in the jaw for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
    [L_ankle_lid.stl, L_hip_pitch_lid.stl, L_hip_roll_lid.stl, L_hip_yaw_lid.stl, L_inner_ear.stl, L_knee_lid.stl, L_roll_bracket.stl, L_shin.stl]
2026-11-04 The all-Dynamixel duck in Fusion, and the real XL330 for both variants
    ROBOTIS's own XL330 model shows its 26 mm includes the 3 mm horn, and the sockets
    in notches at the rear face's edges. The spec had a 26 mm case with a horn on top,
    so every XL/XC joint was 3 mm off. Hybrid is corrected, its head roll limited to
    0.38 rad as a result, and rebuilt.
    All Dynamixel: its own real parts (one bus, a 450 mAh pack, one regulator), wires
    out the back of the thigh, a bigger thigh cover, head roll 0.35 rad. Saved in the
    hub and in cad/ as duck-droids-dynamixel, each part matching its STL point by point.
    0.93 kg, 0.295 m. Nothing has been printed, and the walks need retraining.
    Each variant now has i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
    [L_ankle_lid.stl, L_hip_pitch_lid.stl, L_hip_roll_lid.stl, L_hip_yaw_lid.stl, L_inner_ear.stl, L_knee_lid.stl, L_roll_bracket.stl, L_shin.stl]
2026-11-04 The all-Dynamixel duck: real parts, a checked build, assembly videos
    The model now has the real XL330, Pi Zero and Waveshare shapes, rounded
    outer edges, a direct-drive jaw and a one-piece head base, all rebuilt in
    Fusion. 43 parts match the spec, and the prints are exported from Fusion.
    Found while filming the build:
    - The inner ears exported with a 12.5 mm hole for a 15 mm bearing, as the
    bearing's outer race was listed in the printed part. Now 15.1 mm, with
    a new check, BOUGHT.
    - The head frame was one STL in two colours. It's now all orange, with a
    new check, COLOUR.
    - The head base wall was about 1 mm thick for a short stretch: thickened.
    Also adds the 30-second reveal and the 5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
    [L_ankle_lid.stl, L_hip_pitch_lid.stl, L_hip_roll_lid.stl, L_hip_yaw_lid.stl, L_inner_ear.stl, L_knee_lid.stl, L_roll_bracket.stl, L_shin.stl]
2026-11-05 All-Dynamixel duck: Amazon battery, rear port, stronger head frame, wiring from config
    Battery and power:
    - OVONIC 2S 450 mAh across the back of the body, with the leads and plugs
    at a port in the rear. The body grows about 7 mm wider and 3 mm longer.
    - A 5 V USB converter on the head base beside the Pi, fed from the bus
    board's green terminals, so only one power pair goes up the neck.
    - One-board wiring first: socket 1 runs the head servos then the left leg,
    socket 2 the right leg. Not yet measured for current.
    Head frame, from a voxel stress estimate of the actual part:
    - A plain end wall on the beak cradle, a taller strip and a thicker riser.
    Peak stresses in the modelled fall an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
    [L_hip_yaw_lid.stl, L_roll_bracket.stl, L_shin.stl, L_shoe.stl, L_thigh_cover.stl, R_hip_yaw_lid.stl, R_roll_bracket.stl, R_shin.stl]
2026-11-05 All-Dynamixel duck: a manufacturing BOM, and videos from the real bodies
    BOM: every purchased line with maker, specification, order unit and price,
    every printed part with its file, nice-to-haves marked Optional, open items
    under one heading. Adds the signal wire, camera ribbon and solder lines it
    was missing.
    Videos and guide clips now draw Fusion's own bodies, so they show the
    rounding. The plugs travel with the battery instead of floating, the closing
    shot ends on the front, the status lines are gone, and the face's sensor pad
    is no longer drawn twice, which made it flicker.
    [assembly.py, make_docs.py, render_assembly.py, render_pov_video.py, reveal_video.py, video_floaters.py]
2026-11-05 All-Dynamixel BOM: mark optional parts at the start of the line
    The marker was in a Status column at the far right of a wide table, where it
    was easy to miss. Optional lines now start with OPTIONAL and show their
    quantities in brackets.
2026-11-05 All-Dynamixel duck: no foot switches, the Pi's ports up and plugged, Pi code and a simulated Pi
    The foot switches go: too much wire through the legs, and microduck's actor doesn't use them. The Pi's USB edge faces up with its plugs modelled, its Fusion detail was mirrored, and the regulator moved 3 mm out for the camera ribbon. New renders from Fusion's bodies, and the README cut to a front page, with the rest in docs/DETAILS.md.
    pi/: the onboard code, tested only against pi/sim, which speaks real Dynamixel bytes to MuJoCo. No trained policy for this design yet: trainer/train_dynamixel.sh is ready for a bigger machine.
    BOM: Amazon and search links on every line. tools/pipeline.sh: the whol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
    [L_roll_bracket.stl, L_shoe.stl, L_sole.stl, R_roll_bracket.stl, R_shoe.stl, R_sole.stl, R_thigh_frame.stl, ankle_left.stl]
2026-11-05 Fusion as linked documents: one per link, rebuilding only what changed
    The one-document build takes 11 min. This takes 9 min the first time, 31 s with nothing changed, and about 2 min for one changed link, joints, clashes and pictures included. A changed link becomes a new version, so the assembly's joints stay. The archive of an assembly is only references, so the repo's .f3d still comes from the one-document build: pipeline.sh fusion iterates, pipeline.sh final is for milestones.
2026-11-05 HD-1910 duck: the all-Dynamixel's flags, and the servo's facts from Feetech's own sheet and STEP
2026-11-05 Hybrid duck WIP: no foot switches, Pi ports up, two Waveshare boards, one UBEC
2026-11-05 All-Feetech duck: one board, real pack, plugs on the neck and head servos (work in progress)
2026-11-05 Big duck: a BOM, wiring with every connector, holes and voltage from RobStride's manuals
    Not safe to build: both documents say so, and the open list holds what stops it.
    Battery renamed 13S from 24S: 24S is about 100 V, over the actuators' 60 V maximum.
    RS04 output screws on 36 not 35.86, RS03 output 6 not 8, from the manuals' figures.
2026-11-05 All-Feetech duck: checks and assembly at 0 failing; near screws on the beak, hood tabs in the band's solid back
    [assembly.py, robot.py]
2026-11-05 HD-1910 duck: gates at 0 failing, real rear tube, horn screw lengths, BOM, wiring, and Feetech's STEP for Fusion
    [L_hip_pitch_lid.stl, L_hip_roll_lid.stl, L_hip_yaw_lid.stl, L_inner_ear.stl, L_knee_lid.stl, L_roll_bracket.stl, L_shin.stl, L_shoe.stl]
2026-11-05 Hybrid duck: manufacturer BOM, two Waveshare boards, wiring diagram and wire routes; gates at 0 failing
    [L_ankle_lid.stl, L_hip_roll_lid.stl, L_hip_yaw_lid.stl, L_inner_ear.stl, L_roll_bracket.stl, L_shin.stl, L_shoe.stl, L_sole.stl]
2026-11-05 All-Feetech duck: all gates at 0 failing, its own BOM, wiring and assembly guide
    Leg power from the battery through a soldered hub in the body, not the board. The neck slot opens to the shell's lower edge: the shell couldn't come down over the neck mount. Slivers removed from the yaw bracket, the head yaw bracket and the head's base wall.
    [L_hip_pitch_lid.stl, L_hip_roll_lid.stl, L_hip_yaw_lid.stl, L_inner_ear.stl, L_knee_lid.stl, L_roll_bracket.stl, L_shin.stl, L_shoe.stl]
2026-11-05 Big duck in Fusion: built in 281 s as linked documents, 379 clashes read, 2 real flaws fixed in the spec
    The first full build then hung holding Fusion: see docs/big/FUSION.md.
    Fixes not yet rebuilt. Still not safe to build.
    [big_duck.py, linked_build.py]
2026-11-05 Big duck: what the hang lost, and no assembly step without asking
2026-11-05 All-Feetech duck: videos read by recipe, the wires' way past the head frame
2026-11-05 Hybrid duck: regulator clear of the camera ribbon, with its plug; prints_from_fusion finds hybrid's bodies; tighter charge port
    [hood.stl]
2026-11-05 All-Feetech duck: assembly animations from the spec, docs regenerated
2026-11-05 HD-1910 duck: real_fit and look_real against Feetech's model, offline; recesses and holes for its rear horn screw and tube
    [L_shin.stl, L_thigh_cover.stl, L_thigh_frame.stl, L_yaw_bracket.stl, R_shin.stl, R_thigh_cover.stl, R_thigh_frame.stl, R_yaw_bracket.stl]
2026-11-05 HD-1910 duck: thigh posts wide enough to floor the rear tube's pocket
    [L_thigh_cover.stl, L_thigh_frame.stl, R_thigh_cover.stl, R_thigh_frame.stl]
2026-11-05 Hybrid duck: guide without older pictures until its video exists; pipeline refuses to film without Fusion's bodies
    [body_shell.stl]
2026-11-05 HD-1910 wiring: a label clear of its wire
2026-11-05 Regulator turned round: its USB socket had 0.5 mm to the face, so no plug fitted
    Found by the hybrid's worker, walking the same head. A right-angle plug still needs 14 mm past the socket, and sliding the module back hits the hinge tab and the hood. On the all-Dynamixel and HD-1910 ducks. No printed part changes; their Fusion models and videos need rebuilding to show it.
    Also: a note in the BOM about servo horns, and pipeline.sh says when gates have overwritten prints/ with the spec's shapes.
2026-11-05 Regulator plug clear of the hood: its step's inner rib stops short
    My earlier move of the regulator was pushed without the printable gate, which found 74 mm3 of the plug in the hood. All gates pass on both ducks now; the Fusion model and prints are rebuilt next.
    [robot.py]
2026-11-05 HD-1910 duck: offline pictures and real-servo fit redone on the turned regulator
2026-11-05 Big duck: inner thigh covers gone, as a sweep found them hitting the body; a stage log and link pictures for the next Fusion turn
    Not rebuilt yet: Fusion is on hold. Still not safe to build.
2026-11-05 All-Feetech duck: the hood's back cap scales with the head, as Fusion refused its loft; a failed loft's error names it
    Not yet confirmed in Fusion: the run after this change ended in close_all, before the head link.
    [figlib.py, robot.py]
2026-11-05 Linked build's close always ends: the loop that froze Fusion for 5 hours, on two ducks
    close_all retried a link that refused to close, forever, on Fusion's main thread. Fusion's log shows it; it wasn't the big duck's size. Tested in Fusion on the saved hybrid assembly: 17 documents closed in under 2 s.
2026-11-05 Hybrid duck: prints from Fusion's bodies, first clash report; rear horn on its shaft, the Feetech board in its real look
    [L_hip_pitch_lid.stl, L_hip_roll_lid.stl, L_hip_yaw_lid.stl, L_inner_ear.stl, L_knee_lid.stl, L_roll_bracket.stl, L_shin.stl, L_shoe.stl]
2026-11-05 STS3215 rear horn on the shaft in Fusion: it stood 12.5 mm off, which only the bought-part model showed
    Found by the hybrid's clash report and measured from the STEP by the all-Feetech worker. Next clash report confirms it. The spec was right, so offline checks don't change.
2026-11-05 Hybrid duck: rebuilt in Fusion; ankle rear horn clash gone, 193 clashes
    [L_shin.stl, R_roll_bracket.stl]
2026-11-05 HD-1910 duck: first Fusion build, with Feetech's servos: 43 prints from Fusion, 15 joints, 179 clashes read
    [L_hip_pitch_lid.stl, L_hip_roll_lid.stl, L_hip_yaw_lid.stl, L_inner_ear.stl, L_knee_lid.stl, L_roll_bracket.stl, L_shin.stl, L_shoe.stl]
2026-11-05 Every Fusion turn ends saved and closed, also after a failed build, or Fusion goes on hold
    A failed build left its documents open for the next duck, and final and reveal never closed their model. Tested in Fusion: a changed document saved, one never saved dropped, a 17-document assembly closed, 0 open.
    [turn_end.py]
2026-11-05 All-Feetech duck: first full linked build in Fusion, 42 prints from its bodies; clashes not yet explained
    [L_hip_pitch_lid.stl, L_hip_roll_lid.stl, L_hip_yaw_lid.stl, L_inner_ear.stl, L_knee_lid.stl, L_roll_bracket.stl, L_shin.stl, L_shoe.stl]
2026-11-05 Linked build waits longer to insert a link the hub is still taking
    HD-1910 and all-Feetech each timed out at 240 s on a different link, and each worked on a rerun.
2026-11-05 All-Dynamixel duck rebuilt with the regulator turned round: model, prints, reveal, build video, clips
    Fusion: 307 clashes against 309, none new, and none on the regulator or its plug. Prints audit 258 and verify 43, 0 failing.
    [L_roll_bracket.stl, L_shoe.stl, L_thigh_cover.stl, R_roll_bracket.stl, R_thigh_frame.stl, duck-droids-dynamixel.f3d, hood.stl]
2026-11-05 Big duck: battery options compared, Dan-Tech 13S5P a candidate to bench-test, with its box in the spec
    Candidate only, nothing bought, and it has no BMS. Still not safe to build.
2026-11-05 All-Feetech duck: 3 flaws Fusion's real bodies found: the shoe over the ankle horn, the yaw plate on the outer race, the beak case's rear strip
    [L_shoe.stl, L_sole.stl, R_shoe.stl, R_sole.stl, head_frame.stl, head_yaw_bracket.stl]
2026-11-05 HD-1910 duck: one-document model, prints from it, and the 30-second reveal
    [L_roll_bracket.stl, L_shin.stl, R_roll_bracket.stl, R_shin.stl, R_thigh_frame.stl, chassis.stl, duck-droids-hd1910.f3d, head_fork.stl]
2026-11-05 Hybrid duck: one-document Fusion build, its prints, and the 30-second reveal; the shoe clears the ankle horn
    [L_shin.stl, L_shoe.stl, L_thigh_frame.stl, R_shin.stl, R_shoe.stl, R_thigh_frame.stl, duck-droids-hybrid.f3d, head_frame.stl]
2026-11-05 HD-1910 duck: STEP and close-ups from the saved model
    [duck-droids-hd1910.step]
2026-11-05 Parts layout: every part flat on one sheet, beside the wiring diagram, its counts checked against the BOM
    All-Dynamixel's is in. The pipeline's video stage makes the others'. Dry-runs on HD-1910, all-Feetech and hybrid: 0 different.
2026-11-05 Hybrid duck: STEP from the saved Fusion model
    [duck-droids-hybrid.step]
2026-11-05 Big duck: links rebuilt with their pictures; assembly refreshed 9 of 16, to be finished
2026-11-05 Big duck: assembly complete in Fusion, 15 joints, 342 clashes read, 6 across a joint
    Still not safe to build, and on stand-in actuators.
2026-11-05 Big duck: 96.3 kg in the README, BOM regenerated after the merge
2026-11-05 All-Feetech duck: lids seat on the case's raised top, the beak's unused socket clears its plate; Fusion's clash boxes reported
    [L_hip_pitch_lid.stl, L_hip_roll_lid.stl, L_hip_yaw_lid.stl, L_knee_lid.stl, R_hip_pitch_lid.stl, R_hip_roll_lid.stl, R_hip_yaw_lid.stl, R_knee_lid.stl]
2026-11-05 Fusion turns: the lease is renewed while a call is open, a failed script stops the chain, cleanup only while the turn is ours, links stay owed until assembled
    An expired lease let the next duck's script run inside an open call, and the turn-end step then closed that duck's document. Found on all-Feetech's build.
    [linked_build.py]
2026-11-05 All-Dynamixel's linked build refreshed: with the turned regulator, on the fixed turn handling
2026-11-05 All-Feetech duck: one-document build, its .f3d, and the 30-second reveal framed for its height
    [L_shin.stl, L_thigh_frame.stl, duck-droids-feetech.f3d, jaw.stl, neck_column.stl]
2026-11-05 All-Feetech duck: 5-minute build and the guide's clips, framed for its height
2026-11-05 All-Feetech: its parts layout in the wiring page, and the README says what each duck has
2026-11-05 Hybrid: the lids clear the case's raised top, rebuilt in Fusion; head stays on 5 V, with a TODO to compare 2S
    8 clashes of 4.92 mm3 are gone: 192 to 183 in the one-document build. New .f3d, .step, prints, reveal, 5-minute build and parts layout.
    [L_hip_pitch_lid.stl, L_hip_roll_lid.stl, L_hip_yaw_lid.stl, L_knee_lid.stl, L_roll_bracket.stl, L_shin.stl, L_shoe.stl, L_sole.stl]
2026-11-05 Big duck: RobStride's real actuators, measured, in the spec and in Fusion, and what they showed
    Read RS04, RS03, RS00, power board and CAN hub from their STEP files (local only: no licence). Stators hang by their shoulders through bored plates with cable windows. New hip yaw: a housing on the deck takes the leg's moment. Flanges with pin holes and screws sized to the thread, which is 3.5 deep in the file, 6.5 in the manual. RS03 has 4 free rear sites, not 8.
    The knee's four-bar didn't close below -0.74: re-swept, with a 148 mm rod. Cranks and rods are moving parts in Fusion, with bushes; the loop stays open there.
    Fit only. No strength checked: still NOT SAFE TO BUILD.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
    [big_crops.py, big_docs.py, big_duck.py, big_sweep.py, fetch_servo_cad.py, linked_build.py]
2026-11-05 README: the big duck is 97.1 kg with its real actuators
2026-11-05 BOMs: real sources for the all-Dynamixel's long servo cables (JST pre-crimped leads, Digi-Key) and the bus board screws (Zoro)
2026-11-05 STEP export takes a recipe: pipeline.sh step, and the feetech duck's STEP
    export_step.py named the hybrid; it now takes --recipe and the checkout's path
    through fusion_call.py, and fails clearly when the hub has no such document.
    pipeline.sh step runs it in a Fusion turn of its own, after final or reveal,
    and stops if the STEP has no solids. cad/duck-droids-feetech.step: from the hub's
    duck-droids feetech (v2), 19 MB, 380 solids.
    [duck-droids-feetech.step]
2026-11-05 Open questions in one place: the RS04's thread taken as 3.5 mm until measured, the hybrid's head on 5 V, and what's still waiting
2026-11-05 Fusion builds the battery's XT30 and balance plugs; the hybrid rebuilt with them
    The plugs were 'decal' (kept out of the offline sweeps) and build.link skips
    decals without a screw, so the body shell's charge port was empty in Fusion.
    The spec marks them in_cad; build.drawn_only builds them, and show() counts
    them with the internals. The hybrid's port cut starts 0.4 mm lower: Fusion
    found the XT30 0.2 mm into the shell's inner corner. Their 0.2 mm rest on the
    pack's side is what mounts them offline, so it's in OK_CLASH.
    Hybrid linked build: 16 links rebuilt, then trunk; clashes to explain only
    R shoe / R sole (as before). prints/ from Fusion, audit and compare 0 failing.
    build.py changed: e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
    [L_roll_bracket.stl, L_shin.stl, L_thigh_frame.stl, R_roll_bracket.stl, R_thigh_frame.stl, body_shell.stl, chassis.stl, head_frame.stl]
2026-11-05 Big duck: frame joints with screws, an assembly order that checks, rods held by E-clips, RS03 front rings
    Every pair of touching metal parts in a link now shares a screw, or a named fit, key or strap
    (HELD); the 0.5 mm overlaps are gone. tools/big_assembly.py checks contact, thread engagement,
    edge distance, each part's way in, each screw's path and key: 0 failing, panels as warnings.
    Stator lanes moved 2.5 mm for the rods' E-clips; big_sweep 0 clashes. Each RS03 uses its 8 front
    holes through a ring and 4 posts. Cable routes listed in docs/big/CABLES.md. Fit, not strength:
    still NOT SAFE TO BUILD.
    [big_assembly.py, big_cables.py, big_docs.py, big_duck.py]
2026-11-05 Build films: no empty bench between sections; the all-Dynamixel film re-rendered
    Measured on the all-Dynamixel 5-minute film (share of each frame that isn't
    bench): 17 runs of an empty or near-empty bench, 0.2-1.5 s each, about 10 s in
    all, at section ends. Causes in render_pov_video.py: 'Set it aside' eased work
    all the way to a parking spot 1-1.5 m off with the camera on the mat; 'Bring the
    work to the mat' and parts 'built earlier' came back from there with the camera
    chasing them; and a new section's first part was framed on bring()'s target,
    an offset, not a point (the neck column and head fork started out of frame).
    Now work leaves and comes back at the picture's edge (off_edge), the c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
2026-11-05 All-Dynamixel duck rebuilt in Fusion with the battery's plugs; in_cad in every duck's spec
    robot_dynamixel/hd1910/feetech.json regenerated: the plugs carry in_cad.
    Gates 0 failing for all three. All-Dynamixel linked build: 16 links rebuilt
    (build.py changed), XT30 and balance plug in the charge port, no clash with
    the pack, the shell or its port; clashes to explain only the shoe / sole pairs.
    prints/dynamixel from Fusion, audit and compare 0 failing.
    [L_roll_bracket.stl, L_shin.stl, L_shoe.stl, R_roll_bracket.stl, R_shin.stl, R_shoe.stl, R_thigh_cover.stl, head_frame.stl]
2026-11-05 Big duck in Fusion with its frame joints: 41 clashes, all panels and the drawn chain
    Linked build of every link: 23 joints, none refused; clashes 266 -> 41, with none metal on
    metal, none a screw in metal, none against a real actuator. Countersunk screws' shanks no longer
    drawn through their heads; pockets in the soles for the foot plate's screw heads. 96 crops,
    the right leg's included. FUSION.md: the frame joints, the clash table, the user's decision on
    the RS04 output screws. Fit, not strength: still NOT SAFE TO BUILD.
    [big_crops.py, big_duck.py]
2026-11-05 Open questions: the big duck's frame joint choices and harness reach; RS03 mounting settled
2026-11-06 Big duck videos, offline in MuJoCo: 30-second reveal and 5-minute build
    tools/render_big_video.py renders both from the spec's shapes and big_assembly's
    checked order, with no Fusion time. Build: parts arrive along their checked PATH
    (way and travel), the line back from it tested clear on the same solids; screws
    along their axes; subassemblies on the bench; joints tested as they can first move,
    the knee through its four-bar (posed from spec mech, rod ends within 0.2 mm of
    the lever pins). Reveal: motors, skeleton, electronics, covers on a slow turn,
    zoom per angle so nothing leaves the frame. End cards say it is not safe to build.
    pipeline.sh reveal and video have a big branch.
    Co-Authored-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
2026-11-06 All-Feetech and HD-1910 rebuilt in Fusion with the battery's plugs: new reveals, build films without the empty bench, STEPs
    All-Feetech: 108 clashes, the new ones the Pi's plugs in their ports; STEP 382 solids. HD-1910: 178 clashes, plugs and the shoe/sole sliver; STEP 539 solids.
    [duck-droids-feetech.f3d, duck-droids-feetech.step, duck-droids-hd1910.f3d, duck-droids-hd1910.step]
2026-11-06 Big duck: how to rebuild it in Fusion, render its two videos, train and evaluate its walk; its trainer models made by script; paired-actuator control
    docs/big/REPRODUCE.md: every step, and where each outside file comes from (nothing third-party committed). tools/big_trainer.py writes the trainer's big models and trainer.json; Mjlab-Velocity-Flat-Milli-Big checked to load. requirements.txt for the design tools. docs/big/PAIRED_ACTUATORS.md and two open questions: the pair's control and the knee's two rods.
2026-11-06 Hybrid and all-Dynamixel rebuilt in Fusion with the battery's plugs: new reveals, build films, STEPs
    Hybrid: 186 clashes, as before, the new plug pairs drawn in their sockets; STEP 472 solids. All-Dynamixel: 307 clashes (308 before); STEP 574 solids. Each duck's checks 0 failing.
    [duck-droids-dynamixel.f3d, duck-droids-dynamixel.step, duck-droids-hybrid.f3d, duck-droids-hybrid.step]
2026-11-06 Hobby recipe: the duck on MG996R, DS3218 and MG90S PWM servos, a PCA9685 bonnet, all electronics in the body
    A fifth servo recipe (MILLI_RECIPE=hobby), spec only. Hobby servos hang by their 4 ears: a new tray with rims under the ears and a lid foot on the far
    ears (flange_cradle), and a printed hub in a bearing for a fork's far side, as there is no rear shaft (rear_hub). DS3218 at the knees and neck pitch,
    where the MG996R's torque falls short; MG90S at the head's yaw, roll and beak. The Pi, its PWM bonnet, the IMU, the pack and two 6 V BECs are in the
    body; each servo's lead is a star to the bonnet, its length and mass counted along its chain (leads), power on a 6 V / GND bus a side.
    0.373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
    [L_hip_pitch_lid.stl, L_hip_roll_lid.stl, L_hip_yaw_lid.stl, L_inner_ear.stl, L_knee_lid.stl, L_roll_bracket.stl, L_shin.stl, L_shoe.stl]
2026-11-06 nano: a 20.6 cm duck on SG90 and MG90S servos, PWM from a Pi Zero 2 W
    A new recipe, MILLI_RECIPE=nano, from its own spec (spec/nano_duck.py): 13 joints,
    9 SG90 and 4 MG90S (knees, hip roll), each held by its ears under a printed clamp,
    a printed hub on its 21T spline, and on the 10 leg joints a U to a printed bushing
    opposite the output shaft. 370 g from every part's material.
    - spec/actuators.json: SG90 and MG90S added (additive), with their sources.
    - Size: 20.6 cm is the smallest these modules allow; 12-18 cm can't be built in
    this layout. tools/nano_sweep.py: knees in a crouch 32 % of stall, hip roll in
    single-leg stance x 1.5 45 %, neck 8 % (reports/nano/size_sweep.md).
    - Electroni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
    [L_ankle_pitch_bushing.stl, L_ankle_pitch_ear_clamp.stl, L_ankle_pitch_rear_arm.stl, L_foot.stl, L_hip_pitch_bushing.stl, L_hip_pitch_ear_clamp.stl, L_hip_pitch_rear_arm.stl, L_hip_roll_bushing.stl]
2026-11-06 BOMs: prices for the microSD card, bus board and IMU, as listed on Amazon on 2026-11-06
    $22.49, $12.47 and $20.49, on every small duck where they had none. The Pi stays
    unpriced: the listing offered was a Pi Zero W, not the Zero 2 W the ducks need.
2026-11-06 All-Dynamixel BOM: 6703ZZ horn bearings, and no right-angle USB cables
    The 16 x 22 x 4 mm MR2216ZZ isn't on Amazon until the end of the month: the uxcell 6703ZZ
    (17 x 23 x 4 mm, 5 for $6.29) replaces it. The Pi is powered by leads soldered to its 5 V pins,
    and talks to the bus board over its UART on three jumper wires, in place of the two
    right-angle USB cables, which are hard to find.
    The BOM only: the spec, print files, wiring drawings and Fusion model still show the old
    parts. docs/OPEN_QUESTIONS.md lists the design changes to make. Don't print the bearing
    seats until they're redrawn.
    [make_docs.py]
2026-11-06 All-Dynamixel duck: 6703ZZ bearings, Pi on UART, a power switch, a PC port
    From the BOM changes in PR 6, and what came after:
    - Horn bearings MR2216ZZ to 6703ZZ (17 x 23 x 4 mm, 6.4 g), this duck only.
    Seats 0.5 mm wider. The head yaw seat's wall is 1.1 mm, to clear the beak
    cradle at the head roll's end. The boss shoulder keeps its 9.25 mm radius.
    Bearings now 75.6 g in all; the duck is 1.00 kg.
    - No right-angle USB leads. The regulator's 5 V goes to the Pi's pins 2 and 6.
    The bus board is on the Pi's UART (pins 8, 10, 14 to RX, TX, GND), jumpers
    at A. The Pi code uses /dev/serial0, and setup_pi.sh enables the full UART.
    The IMU code tries 0x4A, then 0x4B, for the GY-BNO08X.
    - A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
    [L_hip_pitch_lid.stl, L_hip_roll_lid.stl, L_hip_yaw_lid.stl, L_knee_lid.stl, L_roll_bracket.stl, L_shin.stl, L_yaw_bracket.stl, R_hip_pitch_lid.stl]
2026-11-06 All-Dynamixel duck: a KCD1 rocker switch in a 13 mm longer back; Bluetooth kept on
    - The power switch is now a standard KCD1 mini rocker, SPST, pre-wired
    (DaierTek, Amazon B07S2QJKTX), in place of Pololu's board. It needs 22 mm
    behind its bezel. The back had 8-10 mm, the floor opens onto the left hip
    yaw, and the top meets the neck slot. So the body is 13 mm longer at the back
    (same section) and the rocker sits in the back wall, right of centre. The
    charge port's plugs move back with the wall. Fitted after the shell, its
    leads spliced into the battery's red lead first.
    - The body shell print is re-exported (offline shape). The hood's PC hole is a
    rounded slot.
    - setup_pi.sh kee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
    [body_shell.stl]
2026-11-06 Each duck in its own folders, a banner on every BOM, and a README by duck
    - The hybrid's STLs move from the top of prints/ into prints/hybrid/, and its
    BOM.md (repo root), ASSEMBLY, WIRING, wiring.png and parts_layout.png into
    docs/hybrid/, like every other duck. geom.out_path gives the hybrid its own
    prints and docs folders; its reports stay where they were.
    - Every BOM and print README opens with which duck it is for and links to the
    others (tools/variant_banner.py, run by make_docs.py and export_prints.py).
    - Fixed: the all-Dynamixel assembly guide's "print one joint first" linked to
    the hybrid's print README.
    - README: the all-Dynamixel duck first as the one to build, then a se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
    [L_hip_pitch_lid.stl, L_hip_roll_lid.stl, L_hip_yaw_lid.stl, L_inner_ear.stl, L_knee_lid.stl, L_roll_bracket.stl, L_shin.stl, L_shoe.stl]
2026-11-07 The family to scale: a lineup film and still
    docs/images/family_lineup.mp4 (61.6 s, 1920 x 1080) and family_lineup.png: all seven ducks
    standing to scale in a row, nano to the big duck, in a quiet room with a wooden floor and a sofa
    beside the big duck. The camera pans and zooms so each duck in turn fills the frame; in focus it
    nods, opens and shuts its beak once and turns 60 degrees on the spot, with a tag of its servos,
    height, width and weight and lines marking its height and width.
    tools/lineup_video.py makes both (plain python, MuJoCo). The room uses echo-render's CC0 textures
    and room helpers (ECHO_RENDER, ../echo-render by default). Motion is scripted, not a trained policy.
    Weights a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
2026-11-09 All-Dynamixel duck rebuilt in Fusion: 6703ZZ seats, rocker switch, PC port
    The Fusion model and STEP were from 5 November, before the 6703ZZ bearings
    (17 x 23 x 4 mm), the KCD1 rocker in the 13 mm longer back and the hood's PC
    port. Rebuilt from the spec, with the Fusion document saved in the hub.
    - cad: new .f3d and STEP; the STEP's seats are 23 and 23.1 mm, none at 22.
    - prints: all 43 STLs from Fusion's bodies. The 21 offline, unrounded files
    from the bearing change are gone.
    - The model's five views, and the check reports.
    checks 193, assembly 1096, buildable 84, printable 375, beak linkage 15,
    print audit 258, Fusion against the spec 43 parts: 0 failing.
    New in Fusion's clash repor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
    [L_hip_pitch_lid.stl, L_hip_roll_lid.stl, L_hip_yaw_lid.stl, L_knee_lid.stl, L_roll_bracket.stl, L_shin.stl, L_shoe.stl, L_thigh_cover.stl]
2026-11-10 All-Dynamixel duck: new ankle, hip roll fork, sharp bearing seats, neck over the hips
    From printing and fitting the first parts:
    - Ankle: the shoe is one piece bolted straight to the ankle servo's idler (no stub,
    second bearing or inner ear); the shin cups the servo's far end on all 4 sides,
    as the Koch arm's bracket; shoe and sole meet on flat faces and print flat.
    - Hip roll: the roll bracket forks onto the roll servo's horn and idler (no roll
    bearing); the yaw bracket holds the servo by its top end with 4 screws, and it
    slides up into it with its horn on. Hip pitch back limit 0.95 rad.
    - Screws: 2.4 mm clearance holes on the horns, horn hole depth 2.9 mm (ROBOTIS STEP),
    BOM kit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
    [L_hip_roll_lid.stl, L_inner_ear.stl, L_roll_bracket.stl, L_shin.stl, L_shoe.stl, L_sole.stl, L_yaw_bracket.stl, R_hip_roll_lid.stl]
